kobachajchir/ProyectoRobotica2/AutoFinalRobo2-Atmega/README.md

> **AFR2-20261108-01:** librería [`lib/afr2_usart`](lib/afr2_usart/README.md) (USART0..3 por handle, eventos diferidos) y log de depuración por USART0/D1 a 115200 hacia el USB del Mega (`make AFR2_DEBUG_LOG=0|1|2`, por defecto 1). Registra arranques del AVR y del ESP con causa, el volcado de excepción del ESP, el enlace, la red, la captura OLED, el encoder y la pila mínima. Enlace ESP en USART1 sin cambios. [Ficha](../AutoFinalRobo2-Contracts/changes/2026-11-08-01-usart-library-debug-log.md). Fuente sin compilar ni cargar.

> **AFR2-20261106-04:** SRAM AVR 5614 bytes, libres antes de pila 2578; QR finish 29 bytes. Se conservan ambos buffers OLED. Builds y paridad C/Web 2104/2104 PASS; sin carga ni prueba física. [Evidencia](../AutoFinalRobo2-Contracts/documentation/builds/2026-11-06-04/README.md).

> **AFR2-20261106-02:** regeneración y builds AVR/ESP/Web/Loader comprobados; paridad host OLED 1680/1680. **Carga bloqueada por presupuesto SRAM/pila AVR**; sin COM, flasheo ni prueba física. [Evidencia](../AutoFinalRobo2-Contracts/documentation/builds/2026-11-06-02/README.md).

> **AFR2-20261106-01 / fuente:** correcciones coordinadas EX01v13, IR digital/EEPROMv9 y Wi-Fi persistente/paginado. [Ficha y estado por modulo](../AutoFinalRobo2-Contracts/changes/2026-11-06-01-coordinated-corrections.md). Sin nuevas compilaciones, generadores, pruebas ni cargas; no acredita el firmware instalado.

> **AFR2-20261030-03:** IR1..IR5 ADC10 (0..1023), A4..A0; perfil predeterminado2 y journal6 migrando modos previos en RAM, sin escritura automática. ADC compartido con bateríaA5. [Contrato](../AutoFinalRobo2-Contracts/contracts/EEPROM_IR_ADC_6.md). Fuente sin compilar/probar/cargar; consumidores ESP/Web/OLED ya soportan kind2. Causa física de los ceros no confirmada.

> **AFR2-20261030-02:** cabecera dashboard con SSID e IP STA/AP y scroll independiente de ida/vuelta, recortado entre icono y batería fijos. Solo bandas de texto en redibujo parcial. Fuentes AVR/Web vinculadas, sin compilar ni cargar. Ficha en Contracts/changes/2026-10-30-02-dashboard-network-scroll.md.

> **AFR2-20261030-01:** dashboard010001 adaptado de AutoMicro con iconos Wi-Fi/AP/encoder, batería por bandas de voltaje y accesos corto Menú/largo Rápidas al soltar. AVR y copia raster Web vinculados, sin nuevo wire. Fuente sin compilar, probar ni cargar. Ver ../AutoFinalRobo2-Contracts/changes/2026-10-30-01-dashboard-automicro-icons.md.

> **AFR2-20261029-27 — fuente vigente:** ATmega/ESP0.11.0 y Web0.4.0; carrusel de controles, largo al soltar con retorno contextual, radar4/2/1/0.5m/rastro/editor compartido, IR compactos, PWM manual independiente de odometría/HC y atención prioritaria de sesión WS. EEPROMv5 / EX01v9, preservando batería26. Sin compilar, validadores, flasheos, pruebas físicas ni promoción Web. Recursos OLED copiados solamente; memoria y aceptación pendientes. [Contrato y límites](../AutoFinalRobo2-Contracts/contracts/QUICK_RADAR_ACTUATORS_9.md).

> **AFR2-20261029-26:** batería A5/divisor10k/10k/104, Sistema → Batería y copia Web, puente EX01v9, pill con icono por voltaje y confirmación antes de reiniciar ESP/ATmega desde Web. [Contrato y estados](../AutoFinalRobo2-Contracts/contracts/BATTERY_MEASUREMENT_9.md). Solo fuente: sin compilar, generar catálogo OLED, probar, promover paquete ni cargar. Memoria/calibración/paridad físicas pendientes; ambas placas y Web requieren despliegue conjunto autorizado.

> **AFR2-20261029-19 compilado y ATmega cargado:** pedido humano29/10/2026. ATmega/ESP/Web esp y LittleFS completados; promoción local Web a ESP/data/dist. Carga COM8 final13:32:50,80066bytes escritos/verificados, avrdude exit0. ESP/LittleFS sin cargar. SRAM estática7085bytes; sin prueba física/dinámica. Evidencia en AutoFinalRobo2-Contracts/documentation/builds/2026-10-29-19/README.md. Estados inferiores sin build/carga son históricos.

> **AFR2-20261029-20 compilado SIN cargar:** producto/comunicación/biblioteca Loader exit0 sin errores/advertencias, final29/10/2026 13:00:16. Flash80066bytes; SRAM7085bytes, margen1107bytes, main276 y Ui_Render133bytes según .su individuales; no certifica máximo dinámico de pila/ISR. [Evidencia](../AutoFinalRobo2-Contracts/documentation/builds/2026-10-29-20/README.md). Sin tests/validadores ni ensayo físico, Web fuente vinculada sin build/promoción; placa conserva15 y el pedido de no flashear sigue vigente. Estado pendiente de compilación inferior histórico.

> **Fuente AFR2-20261029-20:** Hall una vuelta con selección de rueda, conteo manual y clic para terminar; largo cancela con aviso. Drafts por4ruedas, estado CPR con asterisco, guardado asíncrono y diálogo genérico Si/No al salir sin guardar. OLED/Web vinculados en fuente; Web sin build/promoción, recursos generados pendientes del build autorizado. [Ficha](../AutoFinalRobo2-Contracts/changes/2026-10-29-20-hall-wizard-save-confirm.md). Compilación AVR pendiente al redactar; no flashear, placa conserva15.

> **AFR2-20261029-18 compilado SIN cargar:** diagnóstico BuildOnly exit0 y producto/comunicación/biblioteca Loader exit0, sin errores/advertencias. Diagnóstico flash13800/SRAM3180bytes; producto flash75600/SRAM6934bytes, margen1258bytes sin certificación dinámica de pila. Producto final12:34:40 del29/10/2026. Placa conserva15; no se abrió COM ni se ejecutó ensayo físico. Web solo fuente. Evidencia en Contracts/documentation/builds/2026-10-29-18/README.md; pendientes inferiores históricos. La prohibición de flashear sigue vigente.

> **Fuente AFR2-20261029-18:** IR1..IR5 OSOYOO digital (A4..A0), perfil predeterminado habilitado y EEPROMv4 migra solo tipos antiguos deshabilitados; calibración/seguimiento siguen pendientes. Diagnóstico servo/encoder agrega lectura RAW directa y cambios por OLED/serie, sin EEPROM. Vistas IR/Web distinguen deshabilitado/pendiente/cero válido. [Ficha](../AutoFinalRobo2-Contracts/changes/2026-10-29-18-ir-input-acquisition.md). Compilaciones pendientes al registrar la fuente; no cargar por instrucción vigente. Placa conserva15; Web sin build/promoción.

> **Diagnóstico17 compilado, sin cargar:** usuario confirma puente S1–D13 instalado además de GND/5V/S1 del servo. BuildOnly exit0, sin errores/advertencias, sin COM/avrdude. Flash13424bytes; SRAM3169bytes, margen5023bytes, sin certificación de pila. HEX afr2-i2c-diagnostic.hex SHA256 03cf3a3760f3b6bc5b9b8a7ce128a56388a5bd51b69209a2ea39e895283ca573. Causa del servo inmóvil aún sin medición/prueba física. Producto16 no cargado; placa conserva15. Las notas de compilación/puente pendientes inferiores son históricas.

> **Diagnóstico AFR2-20261029-17:** encoder controla servo D13/OC1C en pasos5grados; PWM inicialmente OFF, C=centrar, S=apagar PWM. OLED y serie muestran orden/contador/botón; I2C cada10s. S1 ModelY necesita puente adicional aD13 según manual. Script agrega -BuildOnly (sin COM/flash). [Ficha](../AutoFinalRobo2-Contracts/changes/2026-10-29-17-diagnostic-encoder-servo.md). Fuente lista, compilación de prueba pedida; no se autoriza carga. Producto16 sigue sin cargar; placa conserva15.

> **AFR2-20261029-16 compilado, NO cargado por indicación del usuario:** producto/comunicación/biblioteca exit0, sin errores/advertencias, final29/10/2026 12:15:28. Flash75518bytes; SRAM6918bytes, margen1274bytes; main259 y renderer73bytes según .su individuales, sin certificación dinámica de pila. COM8 conserva15 (cargada12:02:57). [Evidencia](../AutoFinalRobo2-Contracts/documentation/builds/2026-10-29-16/README.md). El usuario pidió continuar con otros cambios y posponer la carga; no se solicitará flasheo hasta nueva instrucción.

> **Fuente AFR2-20261029-16:** OLED sin esperas artificiales entre etapas, radar con grilla punteada, cono visual nominal15grados por PWM aplicado y discos rellenos por eco válido. Copia Web vinculada; sin build Web/promoción ESP. [Ficha](../AutoFinalRobo2-Contracts/changes/2026-10-29-16-oled-latency-radar-cone.md). Build/carga AVR COM8 autorizados, pendientes al registrar esta nota. Se conserva corrección del watchdog y migración Hall de15, ya cargada y verificada enCOM8 a12:02:57.

> **Fuente AFR2-20261029-15:** corregido bucle Bresenham del radar que bloqueaba main y podía disparar watchdog al girar desde HC-SR04; productos trigonométricos AVR en32bits y contraparte Web vinculada. Hall conectado por montaje confirmado, migración local EEPROMv3 preserva calibraciones y habilitación de control. [Ficha](../AutoFinalRobo2-Contracts/changes/2026-10-29-15-radar-watchdog-hall-wiring.md). Build/carga AVR COM8 autorizados, pendientes al registrar esta nota; sin prueba física del cambio.

> **AFR2-20261029-14 compilado y cargado:** 29/10/2026 11:37:12, COM8, Loader1.1.2,74516bytes escritos y verificados, exit0. Producto/comunicación/biblioteca compilados sin errores/advertencias. SRAM estática6889bytes, margen1303bytes; main259bytes según .su individual, sin certificación de máximo dinámico. [Evidencia](../AutoFinalRobo2-Contracts/documentation/builds/2026-10-29-14/README.md). La entrega sin compilar indicada debajo es histórica; sin ensayo físico posterior de UI.

> **Fuente AFR2-20261029-14:** recuperación OLED sin apagar ante error aislado, conserva páginas confirmadas y acota la postergación por trabajo pendiente. Reconfiguración sin0xAE tras fallos persistentes. Sin nueva compilación, tests, validadores, carga ni prueba física; COM8 conserva11. SRAM/pila y causa del negro permanente pendientes. [Investigación y cambios](../AutoFinalRobo2-Contracts/changes/2026-10-29-14-oled-fault-recovery.md).

> **Loader AFR2-20261028-05:** servicio de puente integrado en fuente0.9 del Loader, backup opcional antes de instalarlo y menú de firmware/último backup. [Plan A/B](../AutoFinalRobo2-Contracts/hardware/PLAN_PRUEBA_FLASHER_MEGA.md). Sin nuevo firmware AVR ni compilación/carga por05; las notas de integración pendiente inferiores son históricas.

> **Servicio AFR2-20261028-02:** [puente USB↔USART1↔ESP](service/README.md), fuente C/avr-libc aislada y objetivo `esp-bridge-firmware BRIDGE_BAUD=115200`. RESET libre, D18/D19, baud fijo y restauración posterior del producto. Sin compilar/cargar/probar; no integrado al arranque del auto ni al asistente del Loader. [Investigación](../AutoFinalRobo2-Contracts/hardware/MEGA_ESP_PUENTE_SOFTWARE.md).

> **Build AFR2-20261027-10:** Hall habilitado por pedido humano (AFR2_HALL_CONNECTED=1), nuevo mapa agrupado de07. Producto/comunicación/biblioteca compilados; flash73306/SRAM estática5930bytes del producto. [Evidencia](../AutoFinalRobo2-Contracts/documentation/builds/2026-10-27-10/README.md), [carga por USB](../AutoFinalRobo2-Contracts/hardware/CARGA_USB_COM16.md). Preferencia Hall conectado y calibraciones EEPROM conservadas; sin flasheo ni pruebas físicas. Gates0/Hall deshabilitado inferiores históricos.

> **Fuente AFR2-20261027-07:** Hall agrupados A8-A11=A y A12-A15=B, ambos en orden FR/FL/RR/RL; máscara0x0F, contadores lógicos FL/FR/RL/RR conservados. [Pinout completo/PDF](../AutoFinalRobo2-Contracts/hardware/PINOUT.md). AFR2_HALL_CONNECTED=0; sin compilar, probar ni flashear esta modificación. Los builds inferiores no contienen este mapa.

> **Compilación AFR2-20261025-14 autorizada y completada:** firmware ATmega (producto/comunicación/biblioteca), ESP y Web full compilan sin errores ni advertencias finales. Firmware0.10.0/EX01v8, Web0.3.0. [Evidencia](../AutoFinalRobo2-Contracts/documentation/builds/2026-10-25-14/README.md). Sin tests, navegador ni flasheos; paquete Web local full generado, **ESP/data/dist conserva el paquete anterior**. La SRAM estática no certifica pila/ISR ni hardware. Estados previos inferiores históricos.

> **Sensores EX01v8 AFR2-20261025-14:** [radar autónomo, servo/IR, pantallas hermanas y red](../AutoFinalRobo2-Contracts/contracts/SENSORS_RADAR_8.md). Firmware nominal0.10.0/EX01v8 y Web0.3.0: fuente integrada y recursos OLED copiados, **sin compilar, probar, renderizar ni flashear**. Paquete ESP anterior; estados inferiores históricos. Modelo3D conserva pose; otras escenas siguen PWM aplicado.

> **Vigente AFR2-20261025-01:** [control Web directo](../AutoFinalRobo2-Contracts/contracts/DIRECT_CONTROL_7.md), sin permiso previo ni habilitación desde OLED. Firmware0.9.0/EX01v7 y Web0.2.0,30comandos/59ScreenCodes, compilados juntos. STOP/caducidad/watchdog y requisitos físicos conservados; sin flash/tests/placas. Estados inferiores históricos.

> **Vigente AFR2-20261024-15:** [Matriz del maestro](../AutoFinalRobo2-Contracts/docs/ALINEACION_MAESTRO.md):33comandos y59identidades OLED con fuentes complementarias. Calibración Web adquiere control al escribir; ESP/Web informan FS/paquete. Web/ESP compilados15; AVR sin nueva fuente, build12/EX01v6/firmware0.8.0/gates0. Sin brecha software definida identificada tras lectura; aceptación física, memoria dinámica, flash/SPI y planos CAD pendientes. Solo documentación en CAD, sin diseño nuevo. Estados inferiores históricos.

> **Vigente AFR2-20261024-12:** mapa/comando actual juntos y coordenadas laterales; Hardware/Reinicio anidados, editor de pistas reversible y distancia por rueda EX01v6. Firmware0.8.0 y Web compilados; activos promovidos localmente. Build AVR incluye fuente IRQ11 con gates0; sin navegador, Hall habilitado, hardware, flasheo ni CAD. [Ficha12](../AutoFinalRobo2-Contracts/changes/2026-10-24-12-control-hardware-distance.md). Los estados inferiores son históricos.

> **Fuente vigente AFR2-20261024-11:** encoder CLK/DT en D2/D3 por INT4/INT5, SW D42; cola y acciones en main. Hall PCINT2 A8–A15 con preferencia de captura por software, macro0. **Esta adaptación no está compilada ni probada**; build08 corresponde a la fuente anterior. ESP/Web conservan su estado10. [Ficha11](../AutoFinalRobo2-Contracts/changes/2026-10-24-11-encoder-hall-interrupts.md). Los estados previos inferiores son históricos.

> **Vigente AFR2-20261024-08:** IP/AP en OLED,11tipos de aviso de red,14iconos F4 en flash y scroll de opción seleccionada. Sistema → Reinicio → Reiniciar ATMEGA/Reiniciar ESP/Volver. ATmega/ESP/Web compilados con EX01v5; sin placas, tests ni flasheos. Clave AP solo en OLED local; STA oculta. [Estado por módulo](../AutoFinalRobo2-Contracts/docs/ESTADO_IMPLEMENTACION.md) · [Contrato v5](../AutoFinalRobo2-Contracts/contracts/EX01_NETWORK_UI_5.md). Estados inferiores históricos.

> **Vigente AFR2-20261024-07:** firmware/communication/library compilados con EX01v4, pantalla de secuencias0x03002c (barra, icono, nombre PROGMEM y tiempo), info de compilación, BT01 y reinicio diferido por watchdog. Flash53634bytes y SRAM estática4295/8192bytes, sin certificación de pila. Memoria de secuencias y Hall mantienen macro0. [Estado ATmega](../AutoFinalRobo2-Contracts/docs/ESTADO_IMPLEMENTACION.md#atmega) · [Formato v4](../AutoFinalRobo2-Contracts/contracts/EX01_SYSTEM_SEQUENCE_4.md). Sin prueba física ni flasheo. Estados inferiores históricos.

> Estado vigente **AFR2-20261024-02**, 24/10/2026: integración ROBO2/perfil2 + EX01v3 compilada en Atmega/ESP/Web; GOTO completo, configuración por catálogo compartido y jobs Wi-Fi OLED conectados. Paquete Web actualizado en ESP/data/dist. Sin pruebas de navegador/hardware ni flasheo; secuencias físicas mantienen bloqueo de memoria. Ver [matriz vigente](../AutoFinalRobo2-Contracts/contracts/EX01_ALIGNMENT_3.md) y [evidencia](../AutoFinalRobo2-Contracts/changes/2026-10-24-02-project-alignment.md). Los estados previos que siguen son históricos.

> **AFR2-20261028-19:** servicio de diagnóstico I2C D20/D21 por USART0 D0/D1
> a115200 8N1. Fuente preparada, sin compilar/cargar/probar; dirección del
> producto conservada. [Guía](../AutoFinalRobo2-Contracts/hardware/OLED_I2C_DIAGNOSTICO.md).

> **AFR2-20261028-20:** diagnóstico19 ampliado con encoder D2/D3 y pulsador
> D42 por USART0: sentidos opuestos, corto/largo y captura. Solo fuente, sin
> compilar/cargar/probar. [Ficha](../AutoFinalRobo2-Contracts/changes/2026-10-28-20-encoder-uart0-diagnostic.md).

# AutoFinalRobo2-atmega

> **AFR2-20261029-11 compilado y cargado:** producto en COM8,74200bytes de
> flash verificados, exit0, 29/10/2026. SRAM estática6885bytes, margen1307bytes;
> pila máxima/UI física integrada pendientes. [Evidencia](../AutoFinalRobo2-Contracts/documentation/builds/2026-10-29-11/README.md).

> **Fuente AFR2-20261029-11:** OLED diferencial exacto, tramos de hasta16columnas
> y envío cooperativo de baja prioridad; sin refresco completo periódico.
> Sin nueva compilación/carga: HEX10 anterior. Imagen confirmada aumenta SRAM;
> memoria/pila pendientes. [Detalle](../AutoFinalRobo2-Contracts/changes/2026-10-29-11-oled-delta-cooperative.md).

> **Build producto10 autorizado, 29/10/2026:** `make -B firmware` exit0 sin
> errores/advertencias; nuevo `build/afr2.hex`, flash73484/SRAM estática5931bytes.
> Sin COM/flasheo/tests ni prueba física integrada. [Evidencia](../AutoFinalRobo2-Contracts/changes/2026-10-29-10-product-oled-encoder-verified-setup.md).

> **Producto AFR2-20261029-10:** aplica configuración del diagnóstico09 que
> el usuario confirmó funcional: pulls I2C, espera500ms, OLED180, encoder
> invertido y refresco1s. Migra solo UI EEPROMv1→v2 conservando calibraciones.
> Fuente sin compilar/cargar/probar en producto. [Ficha](../AutoFinalRobo2-Contracts/changes/2026-10-29-10-product-oled-encoder-verified-setup.md).

> **Diagnóstico AFR2-20261029-07:** OLED0x3C activo con barras móviles y
> encoder, pulls como Wire en el servicio separado. Solo fuente, sin compilar
> ni cargar. [Ficha](../AutoFinalRobo2-Contracts/changes/2026-10-29-07-diagnostic-active-oled.md).

Estado de producto **AFR2-20261023-19**, continuación24/10/2026: fuente integrada,
sin compilar ni ejecutar. [Guía vigente](docs/PRODUCTO_ATMEGA.md),
[matriz del maestro](../AutoFinalRobo2-Contracts/docs/PLAN_ATMEGA.md) y
[contrato EX01](../AutoFinalRobo2-Contracts/contracts/ROBO2_PRODUCT_EXTENSION.md).
44 nodos/UI, Sistema, Wi-Fi/teclado/avisos, potencia/sensores, Hall/PID/odometría/
línea/GOTO condicionados, EEPROM y watchdog. Hall sin conectar, macro0 y CPR0.
STOP apaga salidas; no mide rueda detenida. Fuente escrita no acredita SRAM,
compilación ni funcionamiento físico. El texto previo queda como historia.

Estado vigente AFR2-20261023-15: ROBO2/perfil 2 y composición AVR UI/TWI escritos, sin compilar/probar. Sustituye menciones anteriores a UNER/perfil 1 y backend TWI pendiente. Ver actualización al final.

Leer [informe de adaptación](INFORME_ADAPTACION.md) y [maestro](../INFORME_MAESTRO.md).

Se copió todo Core propio F4 como referencia autocontenida de librerías y composición; HAL/CMSIS/USB middleware y build STM32 no se migran. MPU, balance, AT y botón menú permanecen solo para localizar acoplamientos históricos. La base src/ contiene una adaptación parcial nueva, no el firmware del vehículo.

Código nuevo: services/afr2_i2c_manager.c, display/afr2_oled.c y font7x10.c, input/afr2_encoder_ui.c y ui/afr2_screens.c. API pública en include/. El Manager está reducido a un OLED, con start/poll/abort y callbacks en main. Wrappers usan snapshots. Fuente 7x10 con PROGMEM. Encoder largo/corto excluyentes y Volver por ítem. AFR2-20261023-11 agrega endpoint ESP, USART1 por IRQ y composición opcional de comunicaciones con reloj de 1 ms. AFR2-20261023-15 agrega backend TWI y composición local UART/OLED/encoder; faltan composición completa de producto, sensores/motores/odometría/GOTO.

Makefile conserva ayuda por defecto y library; firmware integra UART/TWI/OLED/encoder y communication-firmware mantiene opción UART sola, ambas con potencia inactiva. No se ejecutó make ni se generó ELF/HEX/mapa, y no hay upload. [Composición](docs/COMPOSICION.md).

[Contrato compartido](../AutoFinalRobo2-Contracts/README.md). No se han ejecutado compilaciones, tests, validaciones ni flasheos.

Organización AFR2-20261023-04: este módulo pertenece al único Git de D:/ProyectoRobotica2. [CAD/KiCad, pieza nueva y auto completo](../AutoFinalRobo2-CAD/README.md) · [Git e historial](../AutoFinalRobo2-Contracts/docs/ESTRUCTURA_Y_GIT.md). No se modificó código de este módulo al reorganizar el proyecto.

## Comunicación con ESP — AFR2-20261023-11

[Guía de integración](docs/COMUNICACION_ESP.md) y [perfil UART compartido](../AutoFinalRobo2-Contracts/contracts/UART_PROFILE_1.md). Fuente nueva sin compilar ni probar. El endpoint informa unknown/invalid antes de integrar productores y no confirma STOP sin callback autoritativo; la composición opcional anuncia solo UART. No habilita motores ni lease al conectar una Web. El renderer OLED/UI se conserva; su composición física se integra en AFR2-20261023-15. [Registro y procedencia](../AutoFinalRobo2-Contracts/changes/2026-10-23-11-esp-server-and-mega-link.md).

## Integración ROBO2 y UI — AFR2-20261023-15

Estado vigente: `src/main.c` integra USART1, Timer0 1 ms, backend TWI por IRQ,
I2C Manager, OLED y encoder físico. C/avr-libc sin Arduino ni DMA. Cuatro vistas
locales existentes, sin alterar renderers. Sensores inválidos mientras no haya
productores; STOP autoritativo, motores, lease, Hall y GOTO pendientes.

Framing **ROBO2**, dos tokens, versión 1/perfil 2, ruta con emisor alto y receptor
bajo. Comparte parser y constantes con ESP. No compatible con UNER/perfil 1.
[Composición](docs/COMPOSICION.md), [enlace Mega](docs/COMUNICACION_ESP.md) y
[contrato vigente](../AutoFinalRobo2-Contracts/contracts/UART_PROFILE_2.md).
`make firmware` queda preparado, sin ejecutar; no se produjo ELF/HEX/mapa.
OLED 0x3C/SSD1306, tensión, pull-ups, pasos/sentido del encoder y tiempos son
candidatos sin comprobar en hardware. No se ejecutaron tests, compilaciones,
validadores, flasheos ni pruebas físicas. No se habilita movimiento.

## Integración vigente — AFR2-20261024-01

Revisadas fichas19/20/21. La Web21 ya contiene los cambios visuales/editor/simulador;
Wi-Fi20 se conserva. La integración de firmware pendiente se adapta en fuente:
ROBO2/perfil2 + EX01 v2, estado/pose, control supervisado, framebuffer OLED y
secuencias0x40..0x45 sin colisión con comandos de producto19.
Sin nuevo build, validador, tests, flasheo o promoción LittleFS. Secuencias físicas
permanecen bloqueadas por defecto hasta aprobar SRAM/pila y calibración real.
Contrato en AutoFinalRobo2-Contracts/contracts/EX01_WEB_INTEGRATION.md y ficha
AutoFinalRobo2-Contracts/changes/2026-10-24-01-firmware-web-integration.md.

## AFR2-20261029-19 — OLED táctil y visor bajo demanda

Fuente adaptada con Web/ATmega/ESP: overlay scrim+blur en modales, Volver por ítem del menú, ScreenCode0x030035 con aviso/bitmap/chevrones y suscripción explícita a capturas/metadatos. Contrato en AutoFinalRobo2-Contracts/contracts/TOUCH_OLED_19.md; procedencia por archivo en provenance/touch-oled-20261029-19.json de Contracts. El rumbo es solicitado, no medido, y no agrega giro físico. Sin tests, compilación, validadores, navegador, ejecución del generador OLED, promoción ESP ni flasheo de esta entrega. Memoria/paridad/latencia físicas pendientes.
