kobachajchir/ProyectoRobotica2/CADS/README.md

# Insumos CAD trasladados

Los nueve archivos de mecanum-robot-car-chassis-motors-and-wheels están ahora en [AutoFinalRobo2-CAD/reference/supplied/mecanum-robot-car-chassis-motors-and-wheels](../AutoFinalRobo2-CAD/reference/supplied/mecanum-robot-car-chassis-motors-and-wheels).

Se conservó su contenido, sin adaptación. [Inventario por archivo](../AutoFinalRobo2-CAD/reference/insumos-locales.json). El diseño nuevo de piezas, el modelo completo del auto y KiCad se trabajan en [AutoFinalRobo2-CAD](../AutoFinalRobo2-CAD/README.md), dentro del único Git de D:/ProyectoRobotica2.

Esta carpeta queda como puntero a la ubicación nueva. No duplicar aquí las fuentes CAD.
