kobachajchir/ProyectoRobotica2/AutoFinalRobo2-CAD/reference/README.md

# Referencias CAD

supplied/mecanum-robot-car-chassis-motors-and-wheels conserva los nueve archivos existentes que estaban en D:/ProyectoRobotica2/CADS: un FCStd y ocho STEP. Se trasladaron sin cambios de contenido para reunir el trabajo CAD en este módulo.

[Inventario](insumos-locales.json): ruta anterior y actual, tamaño, SHA-256 y estado por archivo. Procedencia inmediata: archivos locales aportados/existentes; autor, licencia, versión y URL remotos no identificados. Sus nombres no demuestran medidas o compatibilidad con el vehículo.

No modificar estos originales al crear adaptaciones; colocar fuentes derivadas en mecanica/ y registrar su procedencia. No se ha abierto el ensamblaje ni deducido dimensiones desde los STEP. Consultar [dependencias](DEPENDENCIAS.md) para futuras descargas reproducibles.

Los documentos originales siguen en ../../Documentacion y la evidencia de hardware en ../../AutoFinalRobo2-Contracts/hardware.
