kobachajchir/ProyectoRobotica2/AutoFinalRobo2-CAD/reference/brazo-prototipo/README.md

# Referencia aportada: caño PVC32

`pvc32_usuario.jpg` conserva la imagen adjuntada por el usuario el 26/10/2026, originalmente `C:/Users/kobac/AppData/Local/Temp/codex-clipboard-c05fdc0d-8c0b-40ba-8f8e-534df81ff435.jpg`.

La imagen rotula A32 mm, B28,3 mm y C3,2 mm. Para el [prototipo](../../mecanica/brazo-antropomorfo/README.md) se usan A/B y el espesor derivado de 1,85 mm. No se atribuye fabricante, clase de presión ni material medido a esta imagen. El dibujo de referencia es un insumo, no una instrucción independiente del pedido del usuario.
