kobachajchir/ProyectoRobotica2/INFORME_MAESTRO.md

> **AFR2-20261109-11 / 1.12.0:** [Armado: Play/Pausa de20s, títulos y secciones](AutoFinalRobo2-Contracts/changes/2026-11-09-11-assembly-playback-intro.md). Web fuente; ATmega/ESP solo versión. Sin tests, compilación, validaciones o flasheos.

> **AFR2-20261109-10 / 1.11.0:** [Nuestros agregados en Armado](AutoFinalRobo2-Contracts/changes/2026-11-09-10-assembly-additions-battery-circuit.md): nueva etapa7, modelos reutilizados del auto, divisor de batería y cables compactos desde Blender (GLB11.692 B / gzip7.969 B), zoom desde mitad de etapa12. CAD/Web en fuente; ATmega/ESP solo versión. Sin tests, compilaciones, validadores, renders ni flasheos.

> **AFR2-20261109-09 / 1.10.5:** [Optimización de RAM ESP](AutoFinalRobo2-Contracts/changes/2026-11-09-09-esp-memory-optimization.md): latidos/estados livianos, cola compacta, textos en flash, liberación Wi-Fi y descargas grandes serializadas. ESP compilado: **51172→46644 B RAM estática (−4528 B)**; Web tipos/protocolo comprobados; ATmega solo versión. Sin carga ni medición dinámica en placa.

> **AFR2-20261109-08 / 1.10.4:** [OOM al conectar WS](AutoFinalRobo2-Contracts/changes/2026-11-09-08-esp-ws-oom.md): ESP serializa directamente a buffers compartidos, evita acumulación de estados y protege por heap/bloque libre. Memoria visible en diagnóstico HTTP. Fuente corregida; ATmega/Web solo versión en esta ficha. Sin tests, compilaciones, validaciones ni cargas; reserva exacta del fallo sin identificar por pila recortada.

> **AFR2-20261109-07 / 1.10.3:** [Banner de producto para Armado](AutoFinalRobo2-Contracts/changes/2026-11-09-07-cinematic-assembly-banner.md): escena transparente sin suelo/cuadrícula, reflejos y fade de piezas por scroll. Fuente Web; ATmega/ESP solo versión. Sin tests, compilaciones, validadores, navegador, renders ni cargas.

> **AFR2-20261109-06 / 1.10.2:** [Wi-Fi: retorno fijo por padre en submenús sin loops por avisos, STA sin AP fallback, teclado directo en clave con autoconexión e ingreso en Web](AutoFinalRobo2-Contracts/changes/2026-11-09-06-wifi-navegacion-fija-sta-sin-fallback-y-credenciales-directas.md). Fuentes ATmega/ESP/Web sincronizadas; sin compilar ni cargar en este paso.

> **AFR2-20261109-05 / 1.10.1:** [Tarjeta de estados del dashboard](AutoFinalRobo2-Contracts/changes/2026-11-09-05-dashboard-status-card-spacing.md) ampliada hacia la izquierda y abajo:72×22px, icono18px y texto centrados. Fuente ATmega/Web; ESP solo versión. Sin tests, compilaciones, validadores, generadores ni cargas.

> **AFR2-20261109-04 / 1.10.0:** [Armado del robot en Explorar](AutoFinalRobo2-Contracts/changes/2026-11-09-04-scroll-robot-assembly.md), `#/armado`: ensamblaje reversible por scroll del auto y brazo V17, textos por etapas, cámara y agarre ilustrativo del cubo. Fuente Web implementada; sin tests, compilaciones, validadores, navegador ni promoción ESP. atmega/esp solo versión; CAD/Loader sin cambios.

> **AFR2-20261108-01:** librería `afr2_usart` y log de depuración del ATmega por USART0 (USB del Mega, 115200): reinicios del ESP con causa y volcado de excepción, enlace, red, captura OLED y pila. [Ficha](AutoFinalRobo2-Contracts/changes/2026-11-08-01-usart-library-debug-log.md). Solo fuente ATmega; sin compilar, cargar ni probar.

> **AFR2-20261106-04:** SRAM AVR 5614 bytes, libres antes de pila 2578; QR finish 29 bytes. Se conservan ambos buffers OLED. Builds y paridad C/Web 2104/2104 PASS; sin carga ni prueba física. [Evidencia](AutoFinalRobo2-Contracts/documentation/builds/2026-11-06-04/README.md).

> **AFR2-20261106-02:** regeneración y builds AVR/ESP/Web/Loader comprobados; paridad host OLED 1680/1680. **Carga bloqueada por presupuesto SRAM/pila AVR**; sin COM, flasheo ni prueba física. [Evidencia](AutoFinalRobo2-Contracts/documentation/builds/2026-11-06-02/README.md).

> **AFR2-20261106-01:** [correccion coordinada en fuente](AutoFinalRobo2-Contracts/changes/2026-11-06-01-coordinated-corrections.md), EX01v13/EEPROMv9/Wi-Fi v2. ATmega/ESP/Web modificados; Loader visual previo conservado y CAD sin cambios. Sin compilar, generar, probar ni cargar esta entrega.

> **AFR2-20261102-14:** dashboard OLED con modo y tarjeta de estados reales, espera3s/ciclo4s, pausa al mantener encoder y fallo prioritario; familia de pantallas vinculada AVR/Web. [Contrato](AutoFinalRobo2-Contracts/contracts/OLED_DASHBOARD_STATUS_20261102.md). Solo fuente, sin tests, build, validaciones, navegador ni carga.

> **AFR2-20261102-11:** dashboard OLED original, cabecera invertida, visor blanco y flecha grande + Volver en submenús. [Ficha](AutoFinalRobo2-Contracts/changes/2026-11-02-11-oled-original-dashboard-white-back.md). Fuente AVR/Web; sin tests, compilaciones, validaciones, navegador ni cargas.

> **AFR2-20261102-05:** UI OLED128-5 en fuentes ATmega/Web y simulación en Ayuda; QR 030045/030046 del AP/Web con estado vigente del ESP. [Alcance y presupuesto](AutoFinalRobo2-Contracts/contracts/OLED_RUNTIME_QR_20261102.md). Fuente y recursos copiados; sin tests, build, validación, navegador ni carga al equipo.

> **AFR2-20261029-03, entrega 3D:** [brazo V7 con codo remoto v17](AutoFinalRobo2-CAD/mecanica/brazo-antropomorfo/revision_v17/README.md). Montajes J1/J4/J5 integrados, PVC25/20, ejes70/60, tensor y pinzaV7 conservados. Ensambles nativos y limites registrados; eje auxiliar J3 sin tope adicional al codo. Por pedido del usuario, nuevos calculos, comprobaciones globales y aligerado diferidos. No aprobacion de resistencia ni fabricacion. atmega/esp/web/Loader sin cambios.

> **AFR2-20261029-02, banco mecanico v15:** [eslabones de aluminio, pinza y transmisiones](AutoFinalRobo2-CAD/mecanica/brazo-antropomorfo/revision_v15/README.md). Fusion independiente del maestro v09; masas desde geometria y revision CAD local muestreada de pinza. J2 modulo0.8 requiere otra iteracion para PLA. Sin brazo completo integrado ni capacidad fisica aprobada; 1.17kg de01 no es peso final actualizado.

> **AFR2-20261029-01, brazo compacto:** [masa, actuadores y eslabones menores](AutoFinalRobo2-CAD/mecanica/brazo-antropomorfo/busqueda_actuadores_v14/README.md). Presupuesto55/50mm:1.17kg sin carga con reserva25%, alcance215mm; margen externo2.65. Solo ruedas, sin pies ni voladizo; estabilidad condicionada a contactos hipoteticos, resistencia y CAD nuevos pendientes. Fusion v09 conservado. Sustituye la direccion con pies de09.

> **AFR2-20261028-09, objetivo activo:** [prediseno liviano con aluminio y PVC menor](AutoFinalRobo2-CAD/mecanica/brazo-antropomorfo/busqueda_actuadores_v13/README.md). Candidato90/75mm:1.63kg sin carga incluyendo pies propuestos, alcance373mm; margen preliminar de par2.36 con200g/30grados/s/50ms. Falla vuelco sobre ejes inferidos; requiere estudiar apoyos desplegables. Sin nuevo CAD ni aprobacion fisica; v09 conservada.

> **AFR2-20261028-08, antecedente:** [30grados/s, inercia y apoyo dinamico](AutoFinalRobo2-CAD/mecanica/brazo-antropomorfo/busqueda_actuadores_v12/README.md). STS3250 no alcanza x2 con este presupuesto; RS01+STS pasa solo el filtro de par pero pesa5.45-5.82kg y aumenta exigencias de cuna/apoyo. Masa y contactos reales del auto pendientes; sin nuevo CAD ni aprobacion fisica.

> **AFR2-20261030-19:** por aclaración del usuario, táctil espera carga/preparación y vista del modelo3D; después usa las condiciones de motores de Mecanum. [Ficha](AutoFinalRobo2-Contracts/changes/2026-10-30-19-touch-model-ready.md). Fuente Web, sin build/pruebas/cargas; conserva reintento tras error.

> **AFR2-20261030-18:** revisadas condiciones de motores; fuentes Web corrigen bloqueo adicional del táctil por error persistente y modelo3D, con mismo permiso PWM que Mecanum. [Detalle](AutoFinalRobo2-Contracts/changes/2026-10-30-18-manual-touch-permissions.md). Firmware sin cambios; sin build/pruebas/cargas.

> **Movimiento AFR2-20261030-13:** avance/retroceso y yaw corregidos en fuente AVR/Web; efectos en diagonales, curvas, línea, GOTO, odometría y secuencias, con controles Girar CW/CCW. [Ficha](AutoFinalRobo2-Contracts/changes/2026-10-30-13-motion-reference.md). ESP/EEPROM/wire sin cambios; sin generación, compilación, validadores, pruebas ni cargas.

> **Wi-Fi AFR2-20261030-09:** fuentes AVR/ESP/Web coordinadas EX01v11; Estado de red, búsqueda/credenciales, seguridad y desconexión observada. [Ficha y límites](AutoFinalRobo2-Contracts/changes/2026-10-30-09-wifi-state-flows.md). Sin generación, compilación, validadores, pruebas, promoción ni cargas.

> **AFR2-20261028-08, objetivo de actuadores activo:** [30grados/s, inercia y apoyo dinamico](AutoFinalRobo2-CAD/mecanica/brazo-antropomorfo/busqueda_actuadores_v12/README.md). STS3250 no alcanza x2 con este presupuesto; RS01+STS pasa solo el filtro de par pero pesa5.45-5.82kg y aumenta exigencias de cuna/apoyo. Masa y contactos reales del auto pendientes; sin nuevo CAD ni aprobacion fisica.

> **AFR2-20261028-07, busqueda de actuadores activa:** [par, masa y esfuerzos del brazo](AutoFinalRobo2-CAD/mecanica/brazo-antropomorfo/busqueda_actuadores_v11/README.md). DS51150 pasa el filtro a30grados/s pero falla desde velocidad de catalogo. STS3215 con reducciones pasa un filtro nominal condicionado (minimo2.11;3919g), con variante, reductores, PLA y estabilidad pendientes. Sin nuevo CAD ni aprobacion fisica.

> **Vigente Loader AFR2-20261028-05 / 0.9.0:** backup de flash opcional antes del flasher, aviso suprimible y preferencias locales; botón de firmware ATmega con desplegable de último backup leído. [Ficha](AutoFinalRobo2-Contracts/changes/2026-10-28-05-loader-mega-backups.md) · [Plan A/B](AutoFinalRobo2-Contracts/hardware/PLAN_PRUEBA_FLASHER_MEGA.md). Solo fuente/documentación. Sin compilación, ejecución GUI/MCP, tests, validaciones, COM o cargas; atmega/esp/web conservan su estado previo. Sustituye recuperación por copia HEX de03 en Loader.

> **Loader AFR2-20261028-03 / 0.8.0:** cargar/restaurar flasher temporal en Mega y desplegable de método ESP con cableado/checklists. [Plan A/B](AutoFinalRobo2-Contracts/hardware/PLAN_PRUEBA_FLASHER_MEGA.md), [ficha](AutoFinalRobo2-Contracts/changes/2026-10-28-03-loader-mega-flasher.md). Solo fuente/documentación; sin compilar/ejecutar/validar, COM ni flasheos. Firmware producto atmega/esp/web sin cambios por esta ficha.

> **Servicio AFR2-20261028-02:** [puente de software Mega→ESP](AutoFinalRobo2-Contracts/hardware/MEGA_ESP_PUENTE_SOFTWARE.md), RESET libre/D18/D19, 115200 candidato, fuente AVR y build de servicio separados. Sin compilar/cargar/probar; producto ESP/Web sin cambios e integración al Loader pendiente en02, incorporada en fuente03. [Ficha](AutoFinalRobo2-Contracts/changes/2026-10-28-02-mega-esp-software-bridge.md).

> **Loader AFR2-20261027-19 / 0.3.0:** [monitor serie, eventos y diagnóstico](AutoFinalRobo2-Loader/MANUAL.html#monitor), baudios, apertura/cierre, texto y bytes RX, modos ESP y fallos detallados. Cierre previo a carga y consulta MCP de captura. [Ficha](AutoFinalRobo2-Contracts/changes/2026-10-27-19-loader-serial-monitor.md). Solo fuente/documentación; sin compilar/ejecutar/probar, abrir COM ni flashear.

> **Loader AFR2-20261027-16 / 0.2.0:** [servidor MCP y guía Codex](AutoFinalRobo2-Loader/MCP.md), revisión de solicitudes en GUI, historial y refuerzos de interfaz/errores. [Ficha](AutoFinalRobo2-Contracts/changes/2026-10-27-16-loader-mcp-ui.md). Solo fuente/documentación, sin compilación, ejecución, registro global, pruebas MCP/COM ni flasheo.

> **Organización AFR2-20261027-14:** [AutoFinalRobo2-Loader](AutoFinalRobo2-Loader/README.md) integrado como sexto módulo en la raíz. Código, lanzadores y manual propios; único Git global y registros compartidos en Contracts. Solo traslado/documentación; sin compilación, ejecución, tests ni flasheo.

> **Herramienta AFR2-20261027-13:** [AFR2 Loader para Windows](AutoFinalRobo2-Loader/README.md), aplicación de compilación/carga con rutas y perfiles portables, diagnóstico UART y verificación posterior. [Manual](AutoFinalRobo2-Loader/MANUAL.html). Fuente/lanzador entregados, sin compilar, ejecutar, validar ni flashear en esta ficha; firmware/Web/CAD sin intervención.

> **Build/carga AFR2-20261027-10:** [ATmega/ESP/Web compilados y LittleFS creado](AutoFinalRobo2-Contracts/documentation/builds/2026-10-27-10/README.md). Hall activo en build por pedido humano, mapa07, hall_wired/EEPROM conservados. Web esp promovida,8activos/1571104bytes gzip; littlefs.bin3121152bytes. [Guía USB-B/COM16](AutoFinalRobo2-Contracts/hardware/CARGA_USB_COM16.md). Sin apertura serie ni flasheo; montaje de jumpers/flash física sin identificar. Estados inferiores históricos.

> **Pinout AFR2-20261027-07:** [hoja completa y PDF](AutoFinalRobo2-Contracts/hardware/PINOUT.md), Hecho por Koba Chajchir. Hall agrupados A8-A11=A y A12-A15=B, orden DEL DER / DEL IZQ / TRAS DER / TRAS IZQ en ambos; fuente ATmega/máscara0x0F actualizadas. Panel OLED/encoder a 5 V reportado; CAD +3V3 sin editar. Hall deshabilitado, sin compilación/flasheo/tests/validaciones de esta revisión. [Ficha](AutoFinalRobo2-Contracts/changes/2026-10-27-07-complete-pinout-grouped-hall.md).

> **Radar Web AFR2-20261026-02:** composición/escena rehechas con manual0.1.9 y VIS-038. [Ficha](AutoFinalRobo2-Contracts/changes/2026-10-26-02-radar-composition.md). Fuente implementada; **sin compilación, tests, validadores, navegador ni promoción ESP**. Firmware/OLED/CAD y Modelo3D sin intervención en esta revisión. Presentación16 sustituida, controles conservados.

> **Modelo3D AFR2-20261026-01:** botón Mostrar/Ocultar referencias, cierre de fichas al ocultar y una única rueda representativa (ocho referencias en total). [Ficha](AutoFinalRobo2-Contracts/changes/2026-10-26-01-model-reference-visibility.md). Solo fuente Web/documentación, sin tests/build/validaciones ni promoción ESP. Sustituye la cantidad de once referencias del hito15.

> **Interfaz Web AFR2-20261025-16:** radar volumétrico con sector de escaneo editable, barras y entradas numéricas vinculadas. [Ficha](AutoFinalRobo2-Contracts/changes/2026-10-25-16-radar-volume-scan-controls.md). Fuente implementada; **sin tests/builds/validadores/navegador/promoción ESP**. Compilación14 anterior a estos cambios; ATmega/ESP/OLED/CAD sin intervención en esta revisión.

> **Fuente Web AFR2-20261025-15:** once puntos interactivos de componentes en Modelo3D, ficha fija local y accesos a las tareas/ruedas. Sin tests, compilación, validaciones, navegador ni promoción ESP; firmware/CAD sin cambios. [Ficha](AutoFinalRobo2-Contracts/changes/2026-10-25-15-model-component-hotspots.md). El build14 inferior no incluye este cambio.

> **Compilación AFR2-20261025-14 autorizada y completada:** firmware ATmega (producto/comunicación/biblioteca), ESP y Web full compilan sin errores ni advertencias finales. Firmware0.10.0/EX01v8, Web0.3.0. [Evidencia](AutoFinalRobo2-Contracts/documentation/builds/2026-10-25-14/README.md). Sin tests, navegador ni flasheos; paquete Web local full generado, **ESP/data/dist conserva el paquete anterior**. La SRAM estática no certifica pila/ISR ni hardware. Estados previos inferiores históricos.

> **Sensores y radar autónomo AFR2-20261025-14:** [radar autónomo, servo/IR, pantallas hermanas y red](AutoFinalRobo2-Contracts/contracts/SENSORS_RADAR_8.md). Firmware nominal0.10.0/EX01v8 y Web0.3.0: fuente integrada y recursos OLED copiados, **sin compilar, probar, renderizar ni flashear**. Paquete ESP anterior; estados inferiores históricos. Modelo3D conserva pose; otras escenas siguen PWM aplicado.

> **Vigente AFR2-20261025-01:** [control directo7](AutoFinalRobo2-Contracts/contracts/DIRECT_CONTROL_7.md), sin permiso ni opciones de adquisición. Los tres módulos compilan con firmware0.9.0/Web0.2.0. Estado anterior inferior histórico.

> **Interfaz AFR2-20261027-05:** ancho util global ampliado; simulaciones en una tarjeta con matematica lateral plegable y controles inferiores. Inputs compactos, modos en pills y Control agrupado en Movimiento / Pruebas y calibracion / GOTO. Funciones fisicas y tactiles conservadas. [Ficha](AutoFinalRobo2-Contracts/changes/2026-10-27-05-wide-workspaces-control-cards.md). Sin tests/build/validaciones/navegador/promocion ESP; modelo final del brazo y burbuja de referencia pendientes.

> **Interfaz AFR2-20261027-06:** calibracion con ayuda contextual derecha e interpretacion del valor; matematica destacada y uniforme en Auto/Brazo/Conjunto; pad de movimiento, boton mantenido y numero/barra compartidos con Control. [Ficha](AutoFinalRobo2-Contracts/changes/2026-10-27-06-calibration-live-math-shared-controls.md). Solo fuente; sin tests/build/validaciones/navegador/promocion ESP. Adaptadores fisico y simulado separados.

# AutoFinalRobo2 — informe maestro vigente

> **Infraestructura AFR2-20261102-04:** nuevo destino Explorar con recorrido visual de React/Vite y Fusion/Blender/Draco hasta gzip, LittleFS, flash, HTTP y navegador; pesos y reporte de archivos con procedencia local/ESP. [Ficha](AutoFinalRobo2-Contracts/changes/2026-11-02-04-infrastructure-explorer.md). atmega sin cambios; esp/web fuente modificada. Sin tests, compilación, validaciones, navegador, promoción de paquete ni flasheos.

> **Fuente AFR2-20261031-01:** [Simulador UI en Desarrollador](AutoFinalRobo2-Contracts/changes/2026-10-31-01-developer-ui-simulator.md).
> Navegacion OLED adaptada del ATmega, tres controles compartidos del visor en
> vivo, guia contextual, edicion/teclado y ejemplos de servicios locales.
> Datos ficticios identificados; sin envio al equipo. Solo fuente Web y
> documentos, sin tests, compilacion, validaciones ni promocion ESP.

> **Brazo AFR2-20261028-01:** [J1 y sus uniones: comprobación resistente](AutoFinalRobo2-CAD/mecanica/brazo-antropomorfo/analisis_J1_uniones/README.md). 35 secciones y 7.075 estados, equilibrio de apoyos, eje, acople D, bastidor y anclajes. J1 no queda aprobado; material/perfil sin definir. Propuesta de eje Ø10, brida y apoyos 16 mm conservando altura, con estudio parcial de espacio temporal. V08 sin editar; sin FEA de sólidos/contactos, builds, flasheo ni ensayo físico. Atmega/ESP/Web/Loader sin cambios.

> **Brazo AFR2-20261027-21:** [v08 con housing GX3270BLS ventilado](AutoFinalRobo2-CAD/mecanica/brazo-antropomorfo/revision_v08/README.md), reservas de montaje corregidas y maestros editables. Revisión autorizada: 3.141 configuraciones CAD sin penetraciones reportables, seis ejes/doce rodamientos completos, pinza 50/60,01 mm y pan libre. Masa recalculada 2,277 kg con carga de 200 g. J1, apoyos, alimentación y aceptación física permanecen abiertos; sin FEA, compilación ni flasheo. Atmega/ESP/Web/Loader sin cambios.

> **Brazo AFR2-20261027-20:** [v07 implementada con GX3270BLS en J3](AutoFinalRobo2-CAD/mecanica/brazo-antropomorfo/revision_v07/README.md), housing integrado, solapes27 mm y nervios locales sin elevar base. [Cargas actualizadas e interpretación](AutoFinalRobo2-CAD/mecanica/brazo-antropomorfo/analisis_cargas_200g/07_implementacion_y_cargas_v07.md): 2,267 kg con200 g, codo15,83 kgf·cm estáticos, frenadas finitas ilustrativas y resultantes completas de base/primer eslabón. J1, apoyos, alimentación y aceptación bajo carga siguen abiertos. Sin tests, compilaciones, barridos CAD, FEA ni ensayos físicos; Atmega/ESP/Web/Loader sin cambios. Sustituye el estado «v07 en planificación» de18.

> **Brazo AFR2-20261027-18:** [informe integrado de esfuerzos e iteración](AutoFinalRobo2-CAD/mecanica/brazo-antropomorfo/analisis_cargas_200g/INFORME_ITERACION_DISENO.md). Historial v01–v06, resultados estáticos con 200 g y plan v07: selección por eje, frenada finita, cargas combinadas y prioridades base/primer eslabón. Solo documentación; nuevos motores, dinámica, refuerzos, FEA y capacidad física siguen pendientes.

> **Fuente Web AFR2-20261027-11:** [puntos y trayectorias independientes del modelo](AutoFinalRobo2-Contracts/contracts/WEB_ARM_POINTS.md).
> Posicion/orientacion respecto del montaje conservadas al cambiar dimensiones;
> biblioteca local compartida, IK en Worker, vista previa y reproduccion cancelable.
> Perfil nominal v03, sin modificar CAD v04. Esta entrega no ejecuta tests/builds,
> validadores, navegador ni promocion ESP; el paquete de10 no acredita la fuente
> final de11. Envolvente definitiva y laminas del pendiente08 sin ejecutar.

**Modelo final AFR2-20261025-13:** [PCB/soporte del usuario y conjunto Web/ESP](AutoFinalRobo2-CAD/docs/MODELO_FINAL_WEB_20261025.md). KiCad, Fusion y Blender guardados; GLB **871.756 bytes**, idéntico al descomprimido de ESP. Web compilada y siete activos promovidos, paquete 1.505.042 bytes gzip. Comprobación CAD/Draco y render Blender; sin ERC/DRC, firmware nuevo ni flasheo. Sustituye el estado CAD pendiente inferior.

**CAD AFR2-20261025-12:** [Panel OLED/encoder](AutoFinalRobo2-CAD/docs/PANEL_UI_20261025.md): fuentes KiCad 20×35 mm ruteadas en B.Cu, modelos STEP de Fusion y soporte con bisel/torretas M3×15 creados. Sin cambio de firmware/ESP/Web, ERC/DRC, interferencias ni montaje físico; JST comercial, niveles I2C y ranura M3 pendientes. Reemplaza únicamente el estado histórico de PCB/soporte pendientes.

24/10/2026, AFR2-20261024-15. Un único Git en D:/ProyectoRobotica2 con cinco
módulos. Proyecto independiente; D:/AutoProyecto es referencia de solo lectura.

La [matriz del plan maestro](AutoFinalRobo2-Contracts/docs/ALINEACION_MAESTRO.md)
concentra implementación, productores/consumidores y pendientes reales. Se
revisaron los33comandos Web/ESP/AVR y las59identidades OLED. Se completaron
diagnóstico de LittleFS/paquete en Web y adquisición de control en Calibración.
Código presente y compilación no acreditan funcionamiento físico.

| Módulo | Alcance vigente |
| --- | --- |
| [Atmega](AutoFinalRobo2-Atmega/README.md) | C/avr-libc sin Arduino/DMA; servicios de robot y autoridad de salidas. Fuente12/build12, firmware0.8.0; Hall/memoria0 |
| [ESP](AutoFinalRobo2-ESP/README.md) | Arduino ESP8266 propio, sin AT; Wi-Fi/HTTP/WS/LittleFS y broker; diagnóstico ampliado15 |
| [Web](AutoFinalRobo2-Web/README.md) | React/Vite; control, simuladores, sensores/red, OLED, desarrollador y guía; calibración alineada15 |
| [Contracts](AutoFinalRobo2-Contracts/README.md) | Contratos, hardware, evidencias, planes y cambios compartidos |
| [CAD](AutoFinalRobo2-CAD/README.md) | Auto base Fusionv16/Blender y GLB final; PCB/pieza nueva diferidas |

Navegador → JSON afr2-ws-1 /ws del mismo origen → ESP → UART ROBO2/perfil2,
EX01v6 → USART1 Mega D18/D19. ESP UART directo y selector E_RX/E_TX son
conexiones distintas. La programación temporal por puente USB usa D0/D1 según
[FLASHING](AutoFinalRobo2-Contracts/hardware/FLASHING.md), sin trasladar mapa UNO.

OLED único dispositivo I2C por Manager. Encoder UI CLK D2/DT D3 por IRQ, SW D42
según cambio11; largo800ms abre principal, corto confirma, atrás solo Volver.
Hall de ruedas separado, A8–A15, pendiente de montaje/calibración.

No quedan brechas de implementación identificadas en el alcance software
definido tras esta revisión por fuente. **El proyecto global no está cerrado:**
Hall/CPR/signos/geometría, pila/tiempos, flash/SPI y puesta en marcha requieren
datos/pruebas; no se habilitan macros por compilar. PCB/soporte/cubierta esperan
planos y componentes. J1 cinco señales y J2 VCC/GND común,2,54mm, conservados.

[Roadmap](AutoFinalRobo2-Contracts/docs/ROADMAP.md),
[cambio15](AutoFinalRobo2-Contracts/changes/2026-10-24-15-master-alignment.md),
[evidencia15](AutoFinalRobo2-Contracts/documentation/builds/2026-10-24-15/README.md).
Pruebas, validadores independientes, navegador, flasheo y CAD no se ejecutan
por esta revisión. [Informe anterior conservado](AutoFinalRobo2-Contracts/docs/history/alignment15/INFORME_MAESTRO.md).
