kobachajchir/ProyectoRobotica2/AutoFinalRobo2-Contracts/hardware/INFORME_PINOUT_ROBOT_20261107.html

# Pinout AutoFinalRobo2

OSOYOO Mecanum 4WD con Arduino Mega 2560 y shield Wi-Fi ESP-12S. Conexiones del kit, agregados del proyecto (sensor de batería, AutoKEY y AutoRESET) y conexiones de servicio, cotejados con board_pinmap.h y las fuentes vigentes.

07/11/2026AFR2-20261107-44Actualiza AFR2-20261106-15Lado y sentido: mirando el auto desde atrás, en el sentido de avance

Base · kit OSOYOO Agregado propio Servicio · carga y diagnóstico

## Cabeceras del Mega

Tocá o pasá sobre un pin para ver su función

Pines en gris: sin uso identificado en este mapa. Eso no certifica que estén libres bajo el shield.

## Sensor de batería

Agregado propio · A5

### Divisor 10 k / 10 k con filtro

A5 recibe la mitad de la tensión de batería. El capacitor va del nodo A5 a masa, en paralelo con R2, nunca en serie. La batería no se conecta directo a A5.

### Lecturas esperadas

Batería | En A5 | Raw ADC
6,0 V | 3,00 V | 614
7,4 V | 3,70 V | 758
8,0 V | 4,00 V | 819
8,4 V | 4,20 V | 860
≈ 10 V | 5,00 V | 1023 · fuera de rango

Firmware: mV = (raw × 10000 + 512) / 1024, referencia AVCC nominal de 5 V y promedio de 8 muestras. La medición se activa a pedido y no está calibrada. Consumo del divisor: unos 0,4 mA a 8 V.

## AutoKEY y AutoRESET del ESP

Agregado propio · servicio · D32 / D33

### Una etapa NPN por línea

El 10 kΩ va de base a masa del lado del transistor: si se sacan los cables de D32/D33 o el Mega no tiene firmware, el transistor queda apagado. El pulsador del shield se conserva y sigue andando a mano.

### Funcionamiento

Función | Pin Mega | Cable | Destino
AutoKEY | D32 · PC5 | sin anotar | Colector a KEY / GPIO0 del ESP
AutoRESET | D33 · PC4 | naranja | Colector a RST del ESP

- D32 o D33 en alto hacen conducir el NPN, como si se apretara el pulsador.
- En reposo el flasher deja ambos pines como entradas sin pull-up. El firmware de producto nunca los acciona.
- Solo se usan en una carga del ESP en modo automático, que el Loader activa por perfil. El modo manual es el predeterminado.
- Abrir el puerto o reiniciar el Mega no reinicia el ESP.

Con el circuito armado, no reutilizar D32 ni D33. Para usarlos en otra cosa, desconectar los dos cables de control.

## Sensores del kit

Base

### Barra de línea IR, 5 canales ACTUALIZADO

← izquierdaderecha →

IR1A4

IR2A3

IR3A2

IR4A1

IR5A0

Salidas digitales TTL del OSOYOO (inversor Schmitt 74HC14): LOW sobre negro, HIGH sobre blanco. Se lee PF4…PF0 cada 5 ms, sin pull-ups. Alimentación de 3,3 a 5 V. Alcance de 0 a 3 cm, que se ajusta con el potenciómetro.

IR1 (A4) queda a la izquierda, confirmado por el usuario. Desde AFR2-20261107-43 la línea es válida sin calibrar, y el seguimiento gira hacia el lado del sensor activo.

### Ultrasonido y servo de radar

Señal | Pin | Uso
HC-SR04 TRIG | D30 · PC7 | Salida
HC-SR04 ECHO | D31 · PC6 | Entrada, medida con Timer3
Servo S | D13 · PB7 | Pulsos de 1000 a 2000 µs por Timer5

D13 está ocupado por el servo: no usarlo como LED. El HC-SR04 se conserva para el radar, pero no detiene el movimiento (AFR2-20261106-13).

## Tracción y encoders Hall

Base

### Motores · dos drivers Model Y

Rueda | IN1 | IN2 | PWM
FR delantera der. | D22 · PA0 | D24 · PA2 | D9 · PH6
FL delantera izq. | D26 · PA4 | D28 · PA6 | D10 · PB4
RR trasera der. | D5 · PE3 | D6 · PH3 | D11 · PB5
RL trasera izq. | D7 · PH4 | D8 · PH5 | D12 · PB6

FR y FL van a M_B (BK1…BK4); RR y RL a M_A (AK1…AK4). M+ y M− son potencia: no van a GPIO ni son masa lógica. El sentido del chasis se corrige en la mezcla (signos de avance, giro y lateral −1), no en el cableado.

### Hall por rueda · puerto K

Rueda | A · S1 naranja | B · S2 verde
FR | A8 · PK0 | A12 · PK4
FL | A9 · PK1 | A13 · PK5
RR | A10 · PK2 | A14 · PK6
RL | A11 · PK3 | A15 · PK7

Pull-ups internos y captura por PCINT2: cuenta x1, flanco de subida de A y sentido leído en B. El CPR se calibra por rueda y se guarda en EEPROM. VCC del Hall a +5 V regulados, nunca directo de la batería.

## Panel OLED y encoder de menú

Agregado propio

### Conector J1 · señales 1×5

Pin J1 | Señal | Mega
1 | Encoder CLK | D2 · PE4 · INT4
2 | Encoder DT | D3 · PE5 · INT5
3 | Encoder SW | D42 · PL7
4 | OLED SDA | D20 · PD1
5 | OLED SCL | D21 · PD0

J2 alimentación 1×2: VCC (5 V comunicados) y GND común. Identificar el pin 1 en la placa antes de cablear.

### Detalles

OLED de 0,96" por I2C, único dispositivo del bus y manejado por I2C Manager. SDA y SCL se toman de la cabecera del shield. El encoder KY-040 sin breakout usa pull-ups internos y lleva los comunes a GND. SW es activo bajo.

Navegación: pulsación corta desde el dashboard abre el menú completo. La larga (desde 800 ms, al soltar) abre los controles rápidos; en el resto de las pantallas vuelve atrás.

El CAD del panel conserva la red +3V3 y el informe anterior menciona un JST de 2,00 mm para J2. Confirmar en la placa real antes de usar el CAD como plano de cableado.

## Wi-Fi y alimentación

Base · enlace adaptado

### UART del shield ESP-12S

Conexión | Pin
Mega transmite → E_RX del selector | D18 · PD3 · TX1
E_TX del selector → Mega recibe | D19 · PD2 · RX1
USB del Mega · servicio y puente de carga del ESP | D0 / D1 · USART0

La carga del ESP usa el puente por software USART0↔USART1 con el RESET del Mega libre. El método D0/D1 con RESET a GND está retirado. La cabecera ESP UART del shield es de lógica 3,3 V y es otra conexión.

### Alimentación

Origen | Destino
Portabaterías + / − | VIN+ / VIN− de Model Y (con llave)
VOUT+ / VOUT− de Model Y | POWER del shield
Voltímetro VCC / VT / GND | Cabecera homónima del Model Y
BAT+ tras la llave | Divisor de batería → A5 propio
+5 V regulados / GND | Hall, IR, HC-SR04, servo y panel

## Índice por pin

A0–A15 y D54–D69 son el mismo pin

Pin | Puerto | Función | Origen

Estado. Cotejo documental y de fuentes. No identifica el firmware instalado ni comprueba continuidad, niveles ni funcionamiento físico. AutoKEY/AutoRESET y el divisor de batería están implementados en fuente, con montaje y medición pendientes. No hay MPU ni balance de dos ruedas en el producto, y no se asignan pines al brazo futuro.

Fuentes:

- AutoFinalRobo2-Atmega/include/board_pinmap.h: motores, Hall, IR, panel, UART y reserva D32/D33.
- src/platform/afr2_sensors.c: IR digitales, ADC5 de batería, HC-SR04 y servo.
- service/esp_uart_bridge.c: control de AutoKEY (PC5) y AutoRESET (PC4).
- Contracts/hardware/INFORME_PINOUT_ROBOT_20261106.md, MEDICION_BATERIA.md, PLAN_KEY_RST_AUTOMATICO.md y contracts/BATTERY_MEASUREMENT_9.md.
- Hoja OSOYOO 5-Channel IR Tracker Sensor: polaridad y alimentación de la barra de línea.

Proyecto de Koba Chajchir. Las atribuciones del manual OSOYOO y de la referencia BioLog se conservan en sus documentos.
