kobachajchir/ProyectoRobotica2/AutoFinalRobo2-CAD/mecanica/brazo-antropomorfo/revision_v17/laminas_20261102/AFR2_Fichas_Brazo_y_Robot_A3.pdf

## AFR2-A000 / BRAZO COMPLETO Y SUS SUBCONJUNTOS

Brazo v17 / captura nativa 02-11-2026 | Cotas de geometria; no de imagen.

SUBCONJUNTOS DEL BRAZO

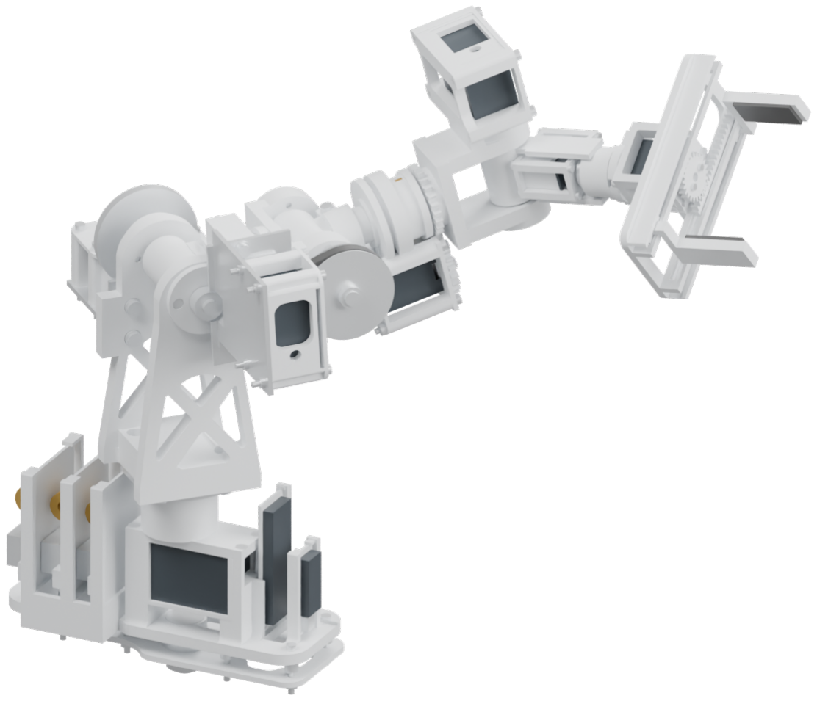
[picture p85: figure]

AFR2-A100

Montura y control fijo

AFR2-A200

Giro J1, torre y entrada J2

AFR2-A300

Eslabon y accionamiento remoto J3

AFR2-A400

Antebrazo y giro de muneca J4

AFR2-A500

Inclinacion J5 y soporte J6

AFR2-A600

Herramienta y pinza V7

VISTA 3D / BRAZO COMPLETO

NOTAS / ALCANCE

Ficha visual del brazo con sus seis subconjuntos funcionales.
Los grupos incluyen todas las425 instancias de solidos de la captura; no son piezas comerciales contadas. Esta ficha no sustituye los planos individuales; solo seis piezas tienen hoja preliminar en esta tanda.
AutoFinalRobo2 - Robotica II | Koba Chajchir

## Brazo completo y sus subconjuntos

AFR2-A000 | REV C | 02/11/2026

MATERIAL / PROCESO

Conjunto mixto

ESTADO: DOCUMENTACION PRELIMINAR

Unidades: mm | Proyeccion: primer diedro

Escala vistas: --

Isometrica: sin escala

Formato A3 | Hoja 1 / 2
AutoFinalRobo2 | Sin firma de aprobacion

## AFR2-R000 / ROBOT INTEGRADO Y CONJUNTOS DEL AUTO

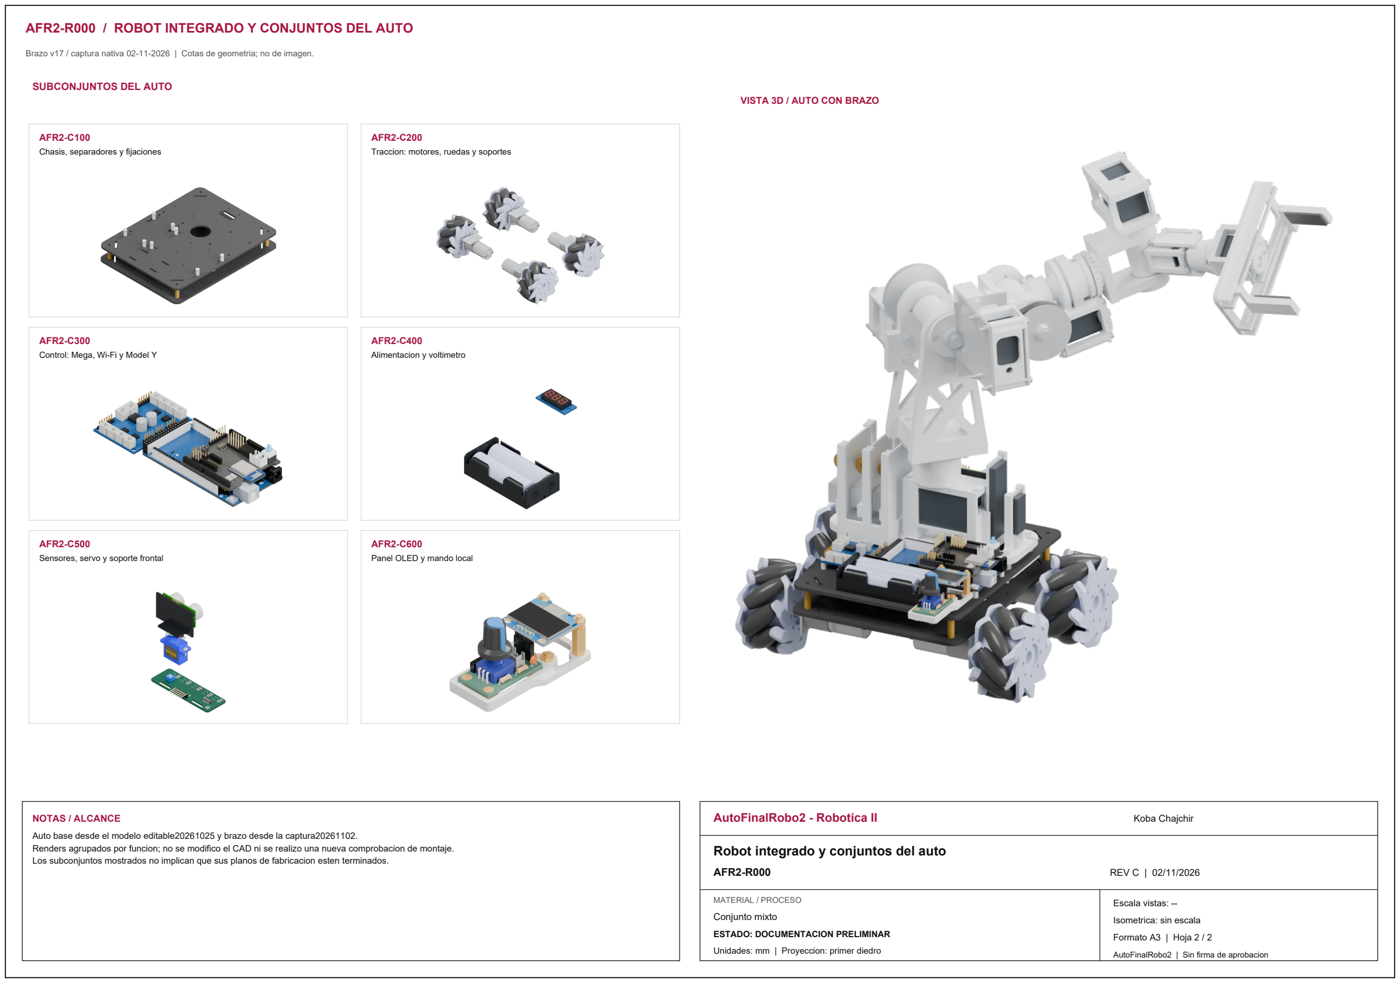
[picture p86: page 2]

Brazo v17 / captura nativa 02-11-2026 | Cotas de geometria; no de imagen.

SUBCONJUNTOS DEL AUTO

AFR2-C100

Chasis, separadores y fijaciones

AFR2-C200

Traccion: motores, ruedas y soportes

AFR2-C300

Control: Mega, Wi-Fi y Model Y

AFR2-C400

Alimentacion y voltimetro

AFR2-C500

Sensores, servo y soporte frontal

AFR2-C600

Panel OLED y mando local

VISTA 3D / AUTO CON BRAZO

NOTAS / ALCANCE

Auto base desde el modelo editable20261025 y brazo desde la captura20261102.
Renders agrupados por funcion; no se modifico el CAD ni se realizo una nueva comprobacion de montaje. Los subconjuntos mostrados no implican que sus planos de fabricacion esten terminados.
AutoFinalRobo2 - Robotica II | Koba Chajchir

## Robot integrado y conjuntos del auto

AFR2-R000 | REV C | 02/11/2026

MATERIAL / PROCESO

Conjunto mixto

ESTADO: DOCUMENTACION PRELIMINAR

Unidades: mm | Proyeccion: primer diedro

Escala vistas: --

Isometrica: sin escala

Formato A3 | Hoja 2 / 2
AutoFinalRobo2 | Sin firma de aprobacion
