kobachajchir/ProyectoRobotica2/Documentacion/Pinout_OSOYOO_Mecanum.csv

Subsistema | Señal origen | Destino | Función | Fuente PDF | Estado
Model Y M_A | ENA | D11 | PWM | p15 | Documentado
Model Y M_A | IN1 | D5 | digital | p15 | Documentado
Model Y M_A | IN2 | D6 | digital | p15 | Documentado
Model Y M_A | IN3 | D7 | digital | p15 | Documentado
Model Y M_A | IN4 | D8 | digital | p15 | Documentado
Model Y M_A | ENB | D12 | PWM | p15 | Documentado
Model Y M_B | ENA | D9 | PWM | p15 | Documentado
Model Y M_B | IN1 | D22 | digital | p15 | Documentado
Model Y M_B | IN2 | D24 | digital | p15 | Documentado
Model Y M_B | IN3 | D26 | digital | p15 | Documentado
Model Y M_B | IN4 | D28 | digital | p15 | Documentado
Model Y M_B | ENB | D10 | PWM | p15 | Documentado
Servo | S | D13 | servo signal | p26 | Documentado
Ultrasonido | TRIG | D30 | digital | p27 | Documentado
Ultrasonido | ECHO | D31 | digital | p27 | Documentado
Sensor IR | IR1 | A4 | signal | p33-34 | Documentado
Sensor IR | IR2 | A3 | signal | p33-34 | Documentado
Sensor IR | IR3 | A2 | signal | p33-34 | Documentado
Sensor IR | IR4 | A1 | signal | p33-34 | Documentado
Sensor IR | IR5 | A0 | signal | p33-34 | Documentado
Bluetooth | B_TX | D19/RX1 | serial input | p38 | Documentado
Bluetooth | B_RX | D18/TX1 | serial output | p38 | Documentado
ESP8266 | E_TX | D19/RX1 | serial input | p43 | Documentado
ESP8266 | E_RX | D18/TX1 | serial output | p43 | Documentado
Motor FR | M+/M- | BK1/BK2 | motor power | p14 | Polaridad individual por verificar
Motor FL | M+/M- | BK3/BK4 | motor power | p14 | Polaridad individual por verificar
Motor RR | M+/M- | AK1/AK2 | motor power | p14 | Polaridad individual por verificar
Motor RL | M+/M- | AK3/AK4 | motor power | p14 | Polaridad individual por verificar
Motor Hall | S1/S2 | Sin conexion en manual | encoder | p5, p14 | Pendiente
Potencia | VIN+/- | Portabaterias 18650 | power | p17 | Polaridad verificar
Potencia | VOUT+/- | WiFi Shield 2p XH2.54 | power | p17 | Tension verificar
