kobachajchir/ProyectoRobotica2/Revision/README.md

# Revisión del informe y documentación del robot

Carpeta común para revisar juntos el informe, los planos y el pinout hasta preparar el informe final.

**Revisión activa: [R01 · 10/11/2026](R01_20261110/README.md).**

| Revisión | Fecha | Estado | Entrega |
|---|---|---|---|
| R01 | 10/11/2026 | En revisión | [Informe D1, planos v17 y pinout](R01_20261110/README.md) |

## Cómo continuar

1. Anotar lo que se quiere corregir en `OBSERVACIONES.md` de la revisión activa, indicando documento, página/hoja y cambio esperado.
2. Al preparar una entrega nueva, crear `R02_AAAAMMDD`, luego `R03_AAAAMMDD`, etc., conservando las anteriores. Cada entrega reúne informe, planos y pinout aunque solo haya cambiado uno.
3. Registrar qué cambió y qué observaciones quedaron resueltas en el historial de la nueva revisión. Actualizar aquí el enlace activo.
4. Mantener el estado «borrador/en revisión» hasta que el usuario indique el cierre del informe final. La numeración del paquete R01/R02 es independiente de la versión del documento y de la versión del software.

Esta carpeta contiene copias de entrega. Los originales y generadores permanecen en Contracts y CAD; `ORIGENES.json` identifica cada archivo de R01. Las regeneraciones se hacen desde las fuentes de sus módulos, no ejecutando metadatos o rutas de captura como scripts dentro del paquete.

No se han modificado contenidos técnicos, rehecho cálculos, renderizado documentos ni ejecutado tests, compilaciones, validaciones o flasheos para esta organización. `Documentacion/` se conserva.
