kobachajchir/ProyectoRobotica2/AutoFinalRobo2-ESP/README.md

> **AFR2-20261029-27 — fuente vigente:** ATmega/ESP0.11.0 y Web0.4.0; carrusel de controles, largo al soltar con retorno contextual, radar4/2/1/0.5m/rastro/editor compartido, IR compactos, PWM manual independiente de odometría/HC y atención prioritaria de sesión WS. EEPROMv5 / EX01v9, preservando batería26. Sin compilar, validadores, flasheos, pruebas físicas ni promoción Web. Recursos OLED copiados solamente; memoria y
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
