kobachajchir/ProyectoRobotica2/AutoFinalRobo2-CAD/mecanica/brazo-antropomorfo/analisis_cargas_200g/pose_horizontal_cad.png

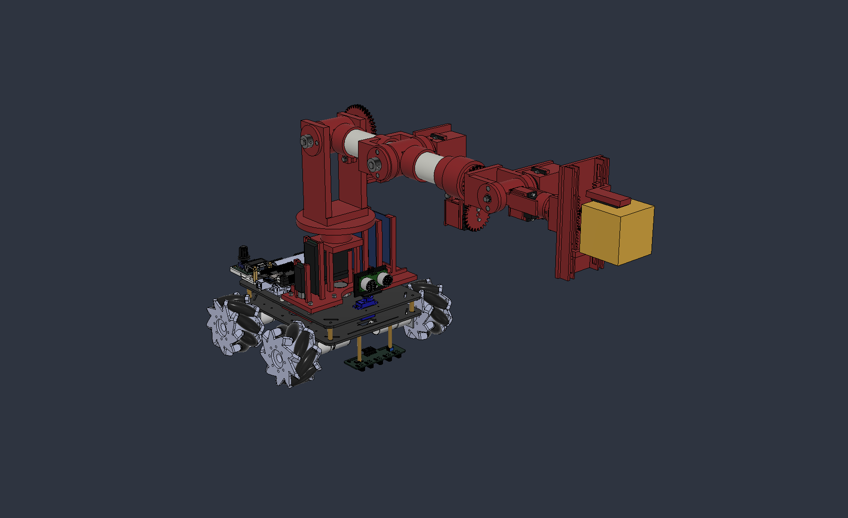
AutoFinalRobo2-CAD/mecanica/brazo-antropomorfo/analisis_cargas_200g/pose_horizontal_cad.png
