kobachajchir/ProyectoRobotica2/AutoFinalRobo2-CAD/mecanica/brazo-antropomorfo/revision_v17/analisis_conjunto_20261101/estabilidad_planta.png

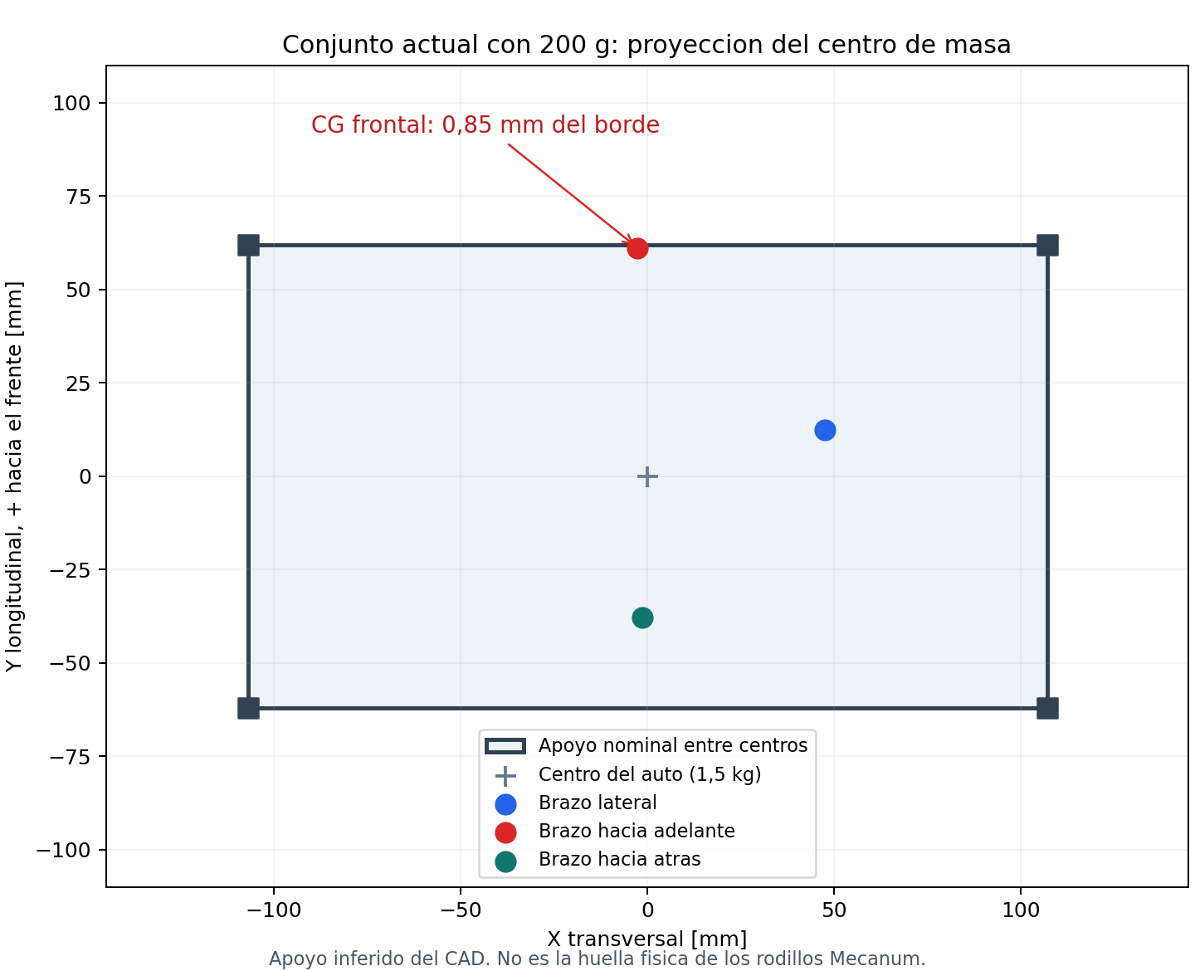
AutoFinalRobo2-CAD/mecanica/brazo-antropomorfo/revision_v17/analisis_conjunto_20261101/estabilidad_planta.png
