kobachajchir/ProyectoRobotica2/AutoFinalRobo2-CAD/mecanica/brazo-antropomorfo/revision_v17/laminas_20261102/previews/DespieceLocal-07.png

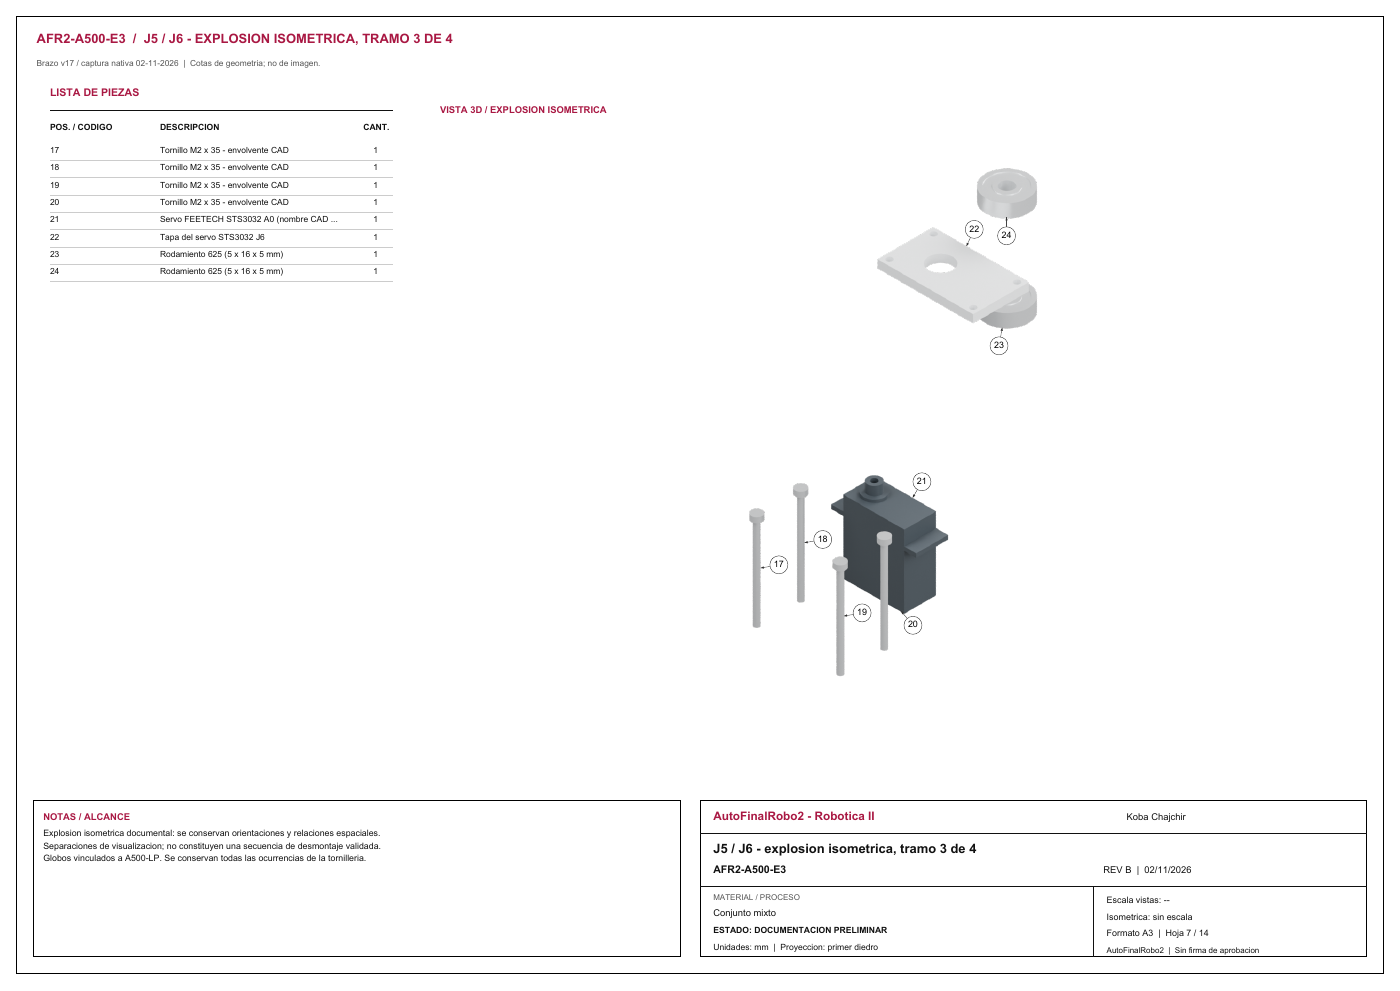
AutoFinalRobo2-CAD/mecanica/brazo-antropomorfo/revision_v17/laminas_20261102/previews/DespieceLocal-07.png
