kobachajchir/ProyectoRobotica2/AutoFinalRobo2-CAD/mecanica/brazo-antropomorfo/revision_v17/laminas_20261102/previews/Explodido2.png

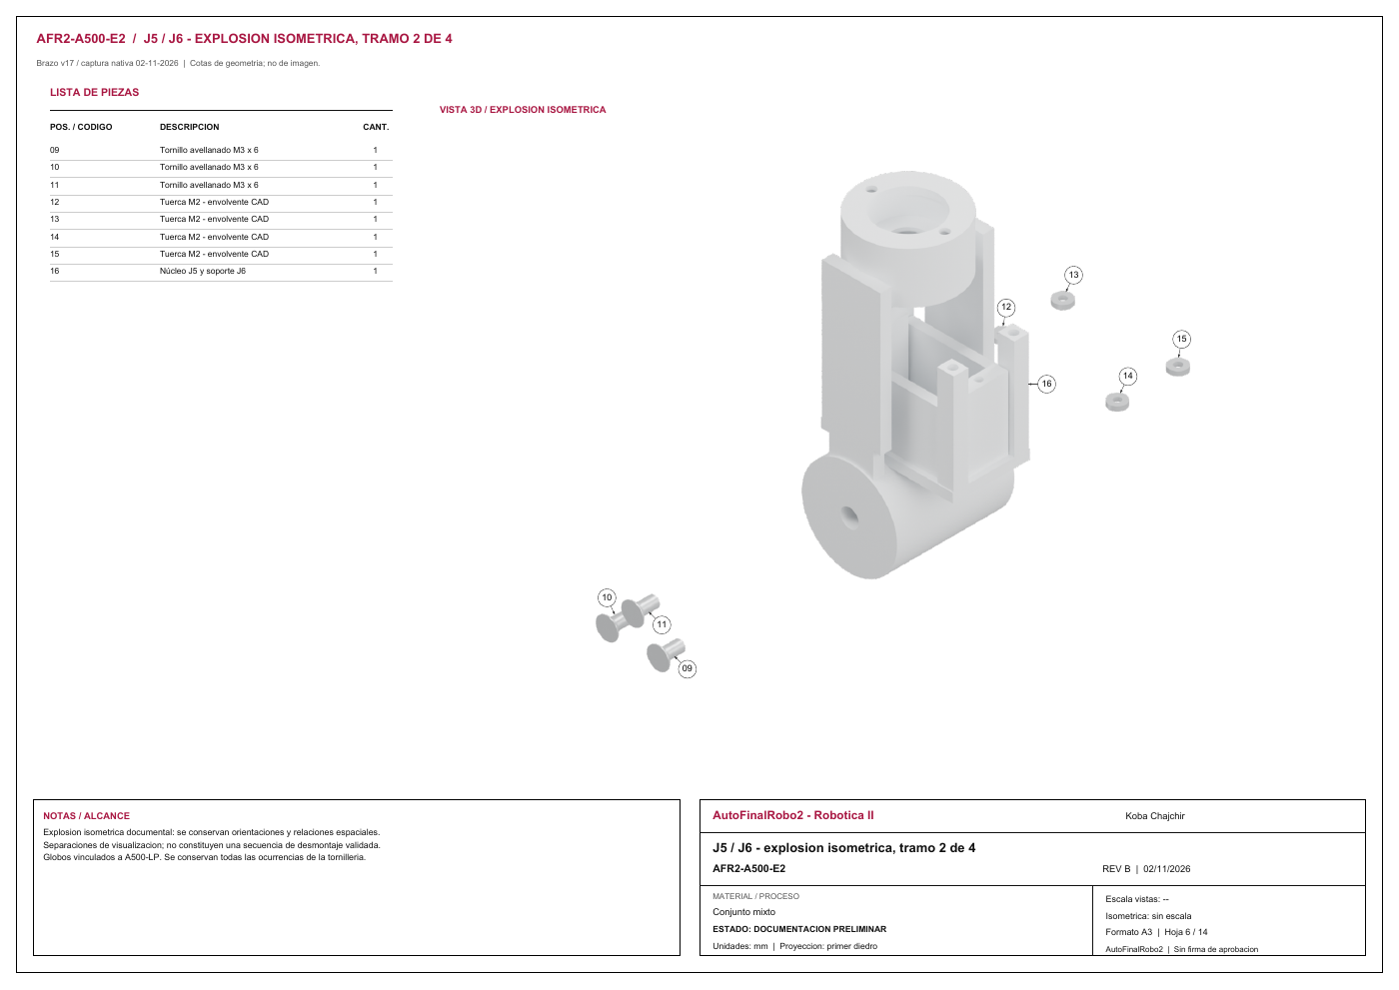
AutoFinalRobo2-CAD/mecanica/brazo-antropomorfo/revision_v17/laminas_20261102/previews/Explodido2.png
