kobachajchir/ProyectoRobotica2/AutoFinalRobo2-CAD/mecanica/sensor-bateria/referencias/esquema_divisor.png

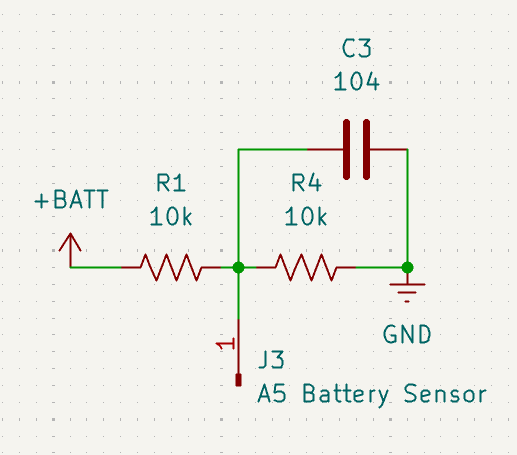
AutoFinalRobo2-CAD/mecanica/sensor-bateria/referencias/esquema_divisor.png
