kobachajchir/ProyectoRobotica2/AutoFinalRobo2-CAD/reference/brazo-prototipo/auto_superior_usuario_20261027.png

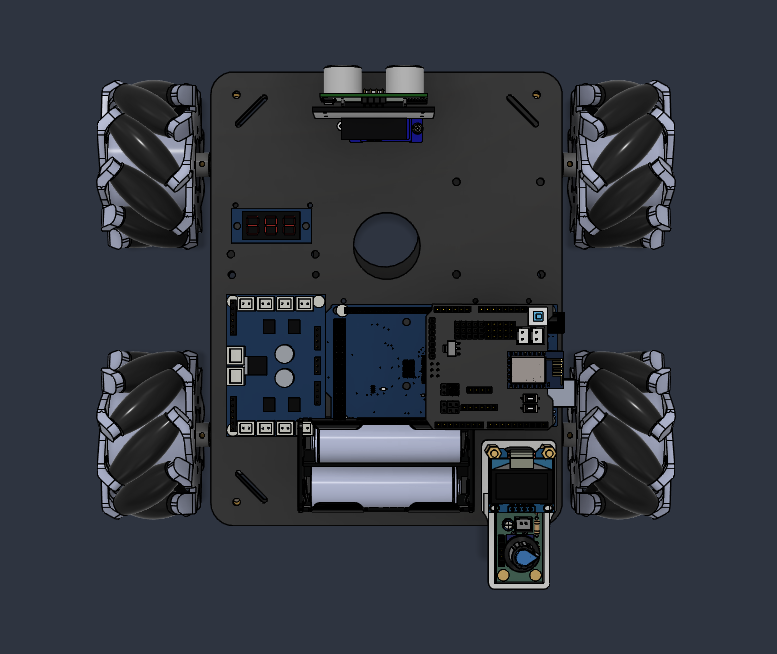
AutoFinalRobo2-CAD/reference/brazo-prototipo/auto_superior_usuario_20261027.png
