kobachajchir/ProyectoRobotica2/AutoFinalRobo2-CAD/reference/brazo-prototipo/pvc32_usuario.jpg

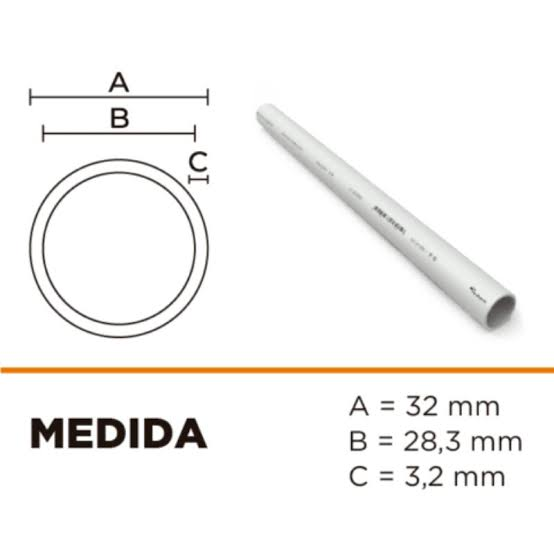
AutoFinalRobo2-CAD/reference/brazo-prototipo/pvc32_usuario.jpg
