kobachajchir/ProyectoRobotica2/AutoFinalRobo2-CAD/reference/supplied/oled-encoder-20261025/oled-dimensiones.png

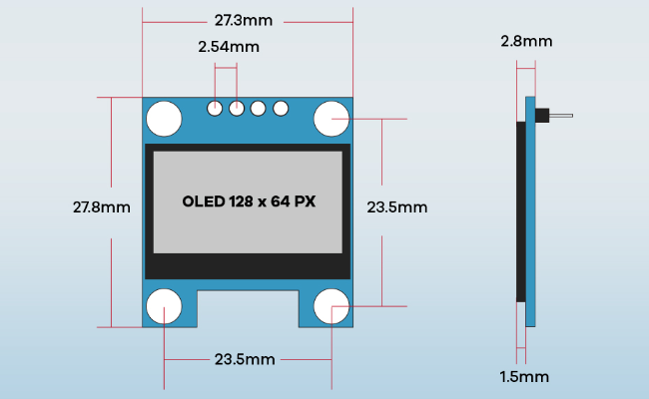
AutoFinalRobo2-CAD/reference/supplied/oled-encoder-20261025/oled-dimensiones.png
