kobachajchir/ProyectoRobotica2/AutoFinalRobo2-CAD/renders/2026-10-24/blender-final-atras.png

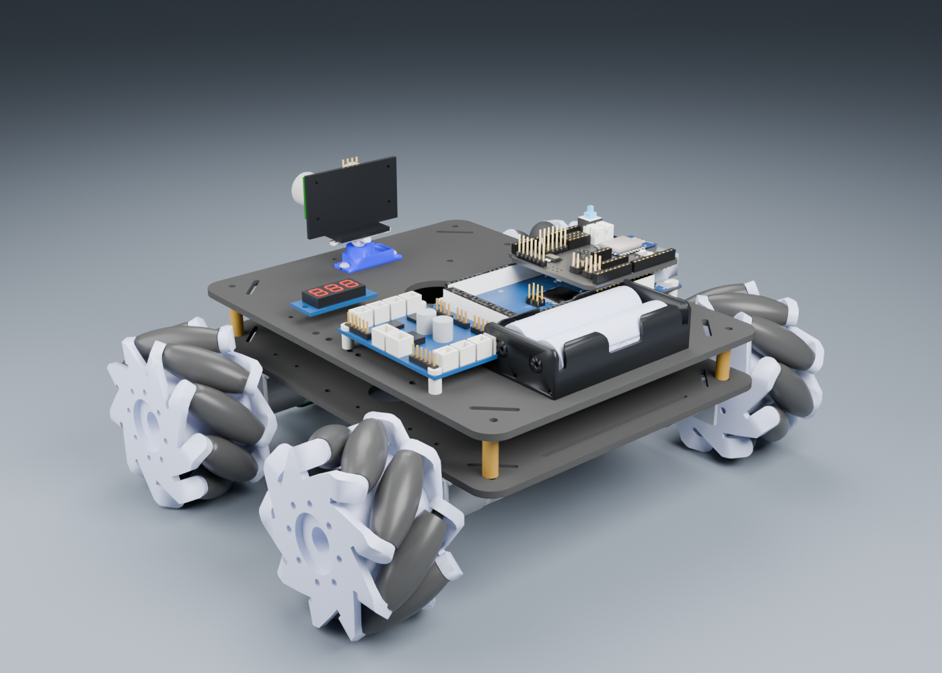
AutoFinalRobo2-CAD/renders/2026-10-24/blender-final-atras.png
