kobachajchir/ProyectoRobotica2/AutoFinalRobo2-CAD/renders/2026-10-24/fusion-lado-izquierdo.png

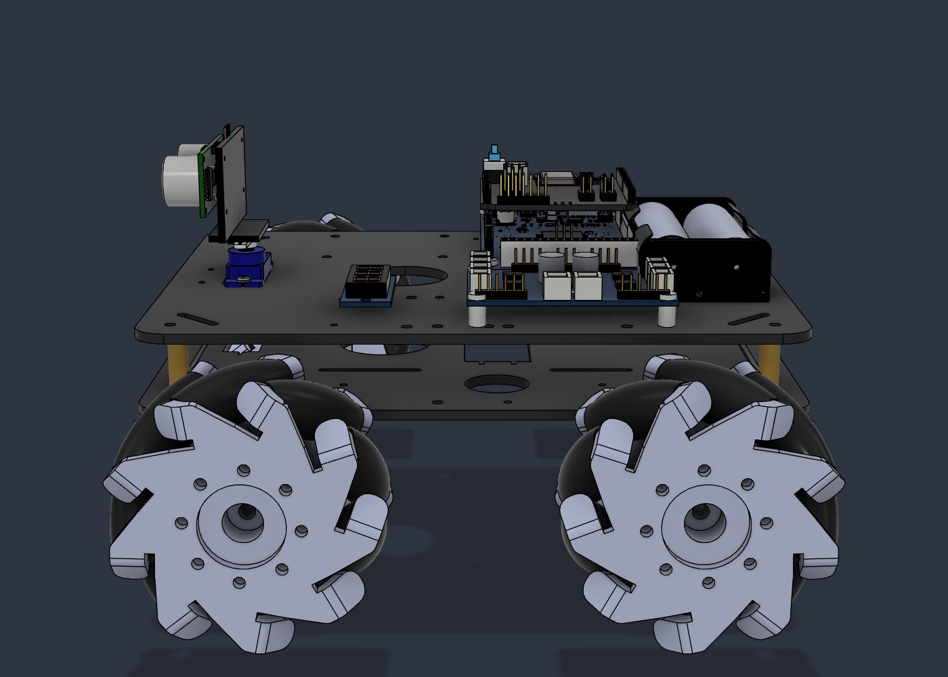
AutoFinalRobo2-CAD/renders/2026-10-24/fusion-lado-izquierdo.png
