kobachajchir/ProyectoRobotica2/AutoFinalRobo2-Contracts/.agents/skills/oled128-ui-design/assets/dashboard-proposal.png

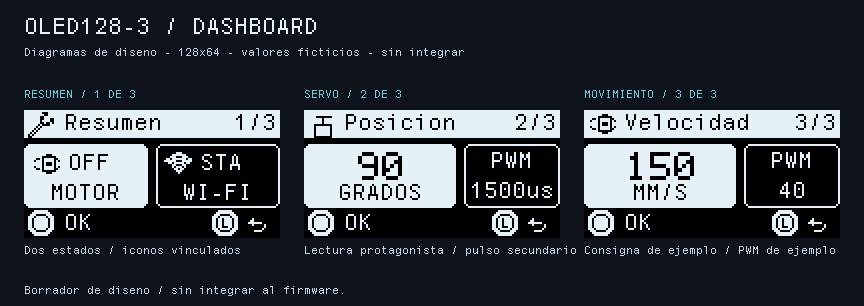
AutoFinalRobo2-Contracts/.agents/skills/oled128-ui-design/assets/dashboard-proposal.png
