kobachajchir/ProyectoRobotica2/AutoFinalRobo2-Contracts/.agents/skills/oled128-ui-design/assets/encoder-gestures-proposal.png

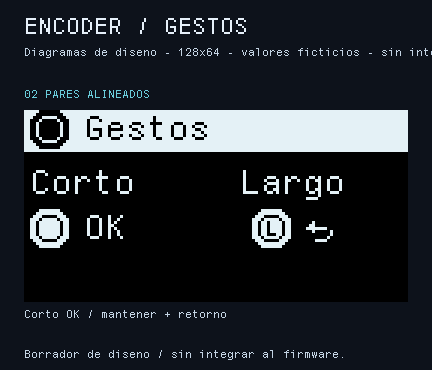
AutoFinalRobo2-Contracts/.agents/skills/oled128-ui-design/assets/encoder-gestures-proposal.png
