kobachajchir/ProyectoRobotica2/AutoFinalRobo2-Contracts/.agents/skills/oled128-ui-design/assets/inspiration/dashboard-monitor.png

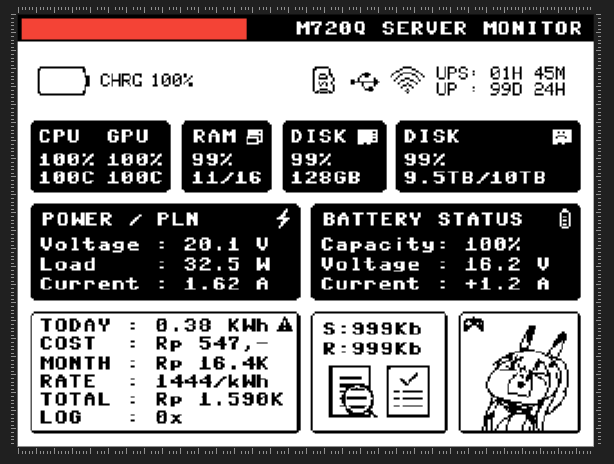
AutoFinalRobo2-Contracts/.agents/skills/oled128-ui-design/assets/inspiration/dashboard-monitor.png
