kobachajchir/ProyectoRobotica2/AutoFinalRobo2-Contracts/.agents/skills/oled128-ui-design/assets/inspiration/quick-actions-list.png

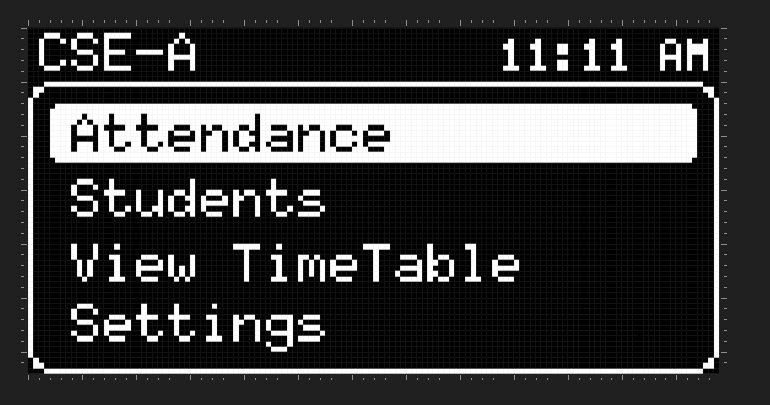
AutoFinalRobo2-Contracts/.agents/skills/oled128-ui-design/assets/inspiration/quick-actions-list.png
