kobachajchir/ProyectoRobotica2/AutoFinalRobo2-Contracts/.agents/skills/oled128-ui-design/assets/qr-examples/demo/screen-preview.png

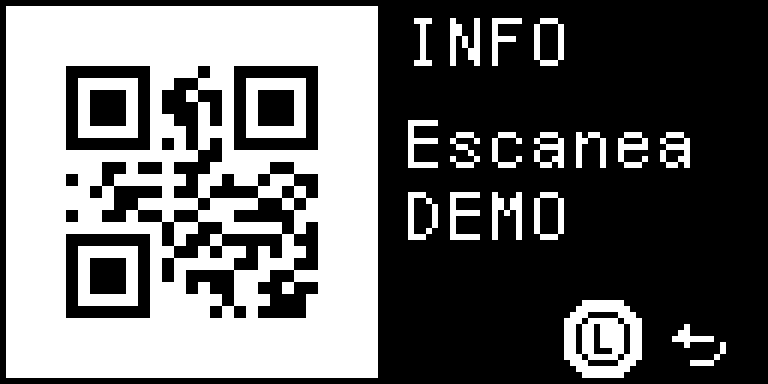
AutoFinalRobo2-Contracts/.agents/skills/oled128-ui-design/assets/qr-examples/demo/screen-preview.png
