kobachajchir/ProyectoRobotica2/AutoFinalRobo2-Contracts/.agents/skills/oled128-ui-design/assets/quick-actions-proposal.png

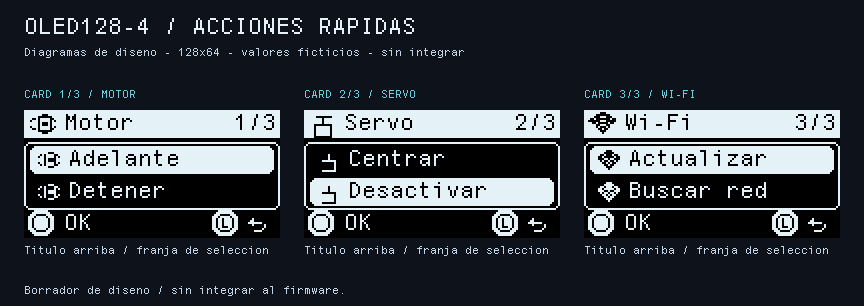
AutoFinalRobo2-Contracts/.agents/skills/oled128-ui-design/assets/quick-actions-proposal.png
