kobachajchir/ProyectoRobotica2/AutoFinalRobo2-Contracts/.codex-attachments/0dedfd2b-6900-47f5-a162-16e60b245802/67d147fc-4b1e-4e37-8735-2bfbe849fd55/1000917116.png

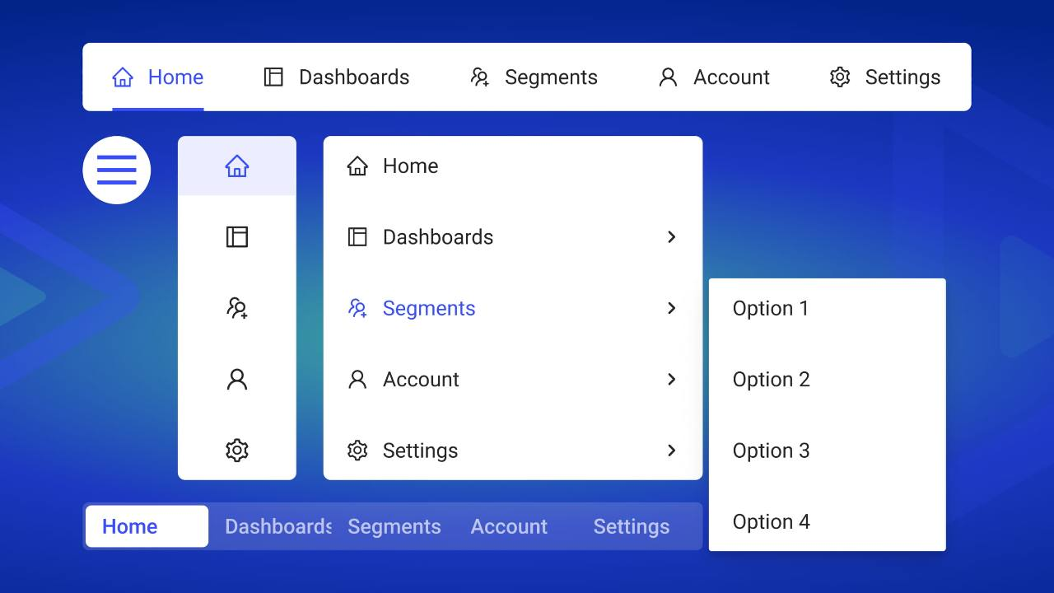
AutoFinalRobo2-Contracts/.codex-attachments/0dedfd2b-6900-47f5-a162-16e60b245802/67d147fc-4b1e-4e37-8735-2bfbe849fd55/1000917116.png
