kobachajchir/ProyectoRobotica2/AutoFinalRobo2-Contracts/.codex-attachments/0dedfd2b-6900-47f5-a162-16e60b245802/269d2f03-7140-43ae-a546-120ada1c6807/1000917115.jpg

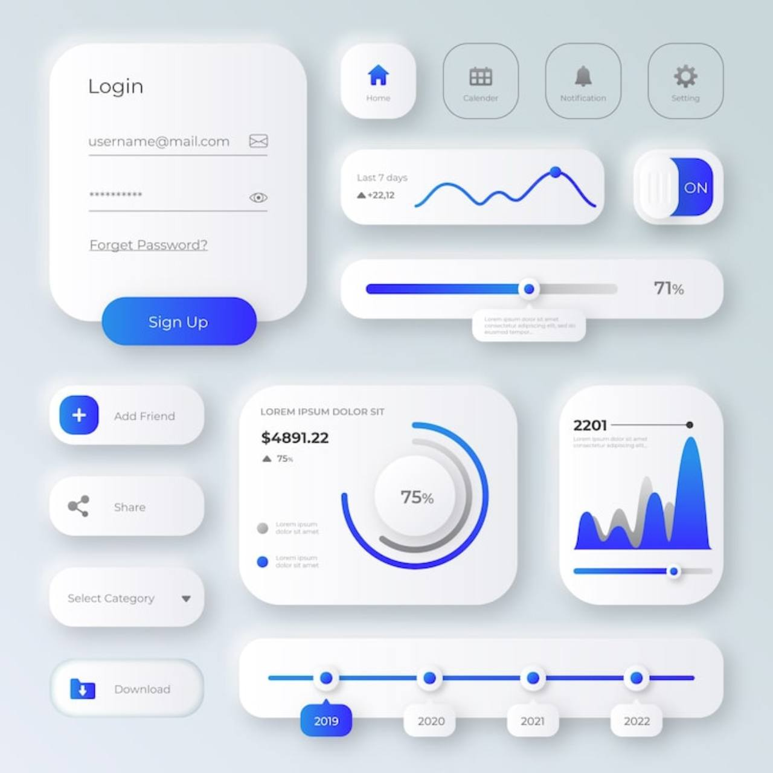
AutoFinalRobo2-Contracts/.codex-attachments/0dedfd2b-6900-47f5-a162-16e60b245802/269d2f03-7140-43ae-a546-120ada1c6807/1000917115.jpg
