kobachajchir/ProyectoRobotica2/AutoFinalRobo2-Contracts/docs/pendientes/espacio-trabajo-brazo/referencia-01-envolvente-lateral-superior.png

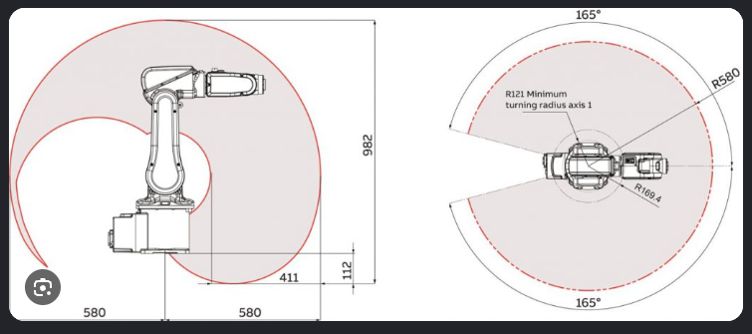
AutoFinalRobo2-Contracts/docs/pendientes/espacio-trabajo-brazo/referencia-01-envolvente-lateral-superior.png
