kobachajchir/ProyectoRobotica2/AutoFinalRobo2-Contracts/docs/pendientes/espacio-trabajo-brazo/referencia-02-envolvente-lateral-cotada.png

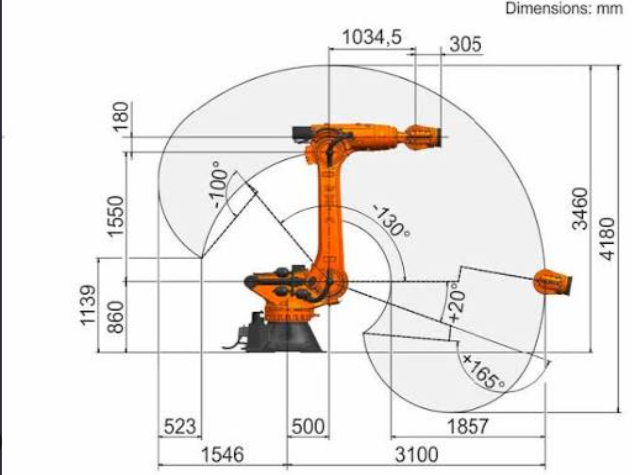
AutoFinalRobo2-Contracts/docs/pendientes/espacio-trabajo-brazo/referencia-02-envolvente-lateral-cotada.png
