kobachajchir/ProyectoRobotica2/AutoFinalRobo2-Contracts/reference/supplied/uno-esp01-programacion-referencia.jpg

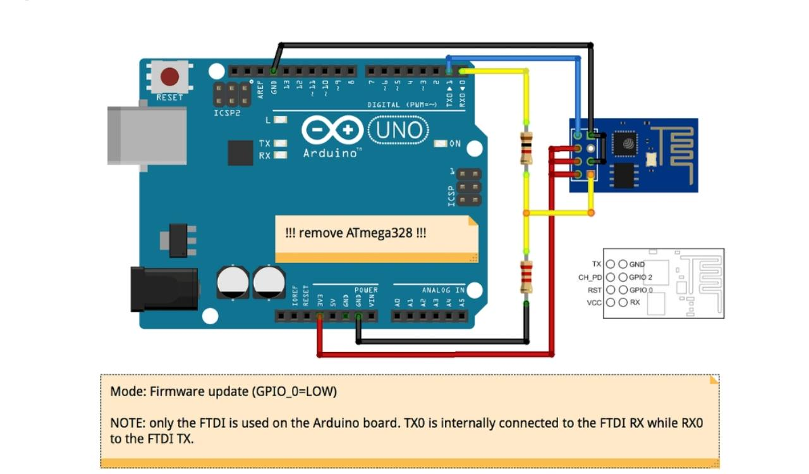
AutoFinalRobo2-Contracts/reference/supplied/uno-esp01-programacion-referencia.jpg
