kobachajchir/ProyectoRobotica2/AutoFinalRobo2-Loader/ux-audit-2026-11-06-loader/assets/despues-mcp.png

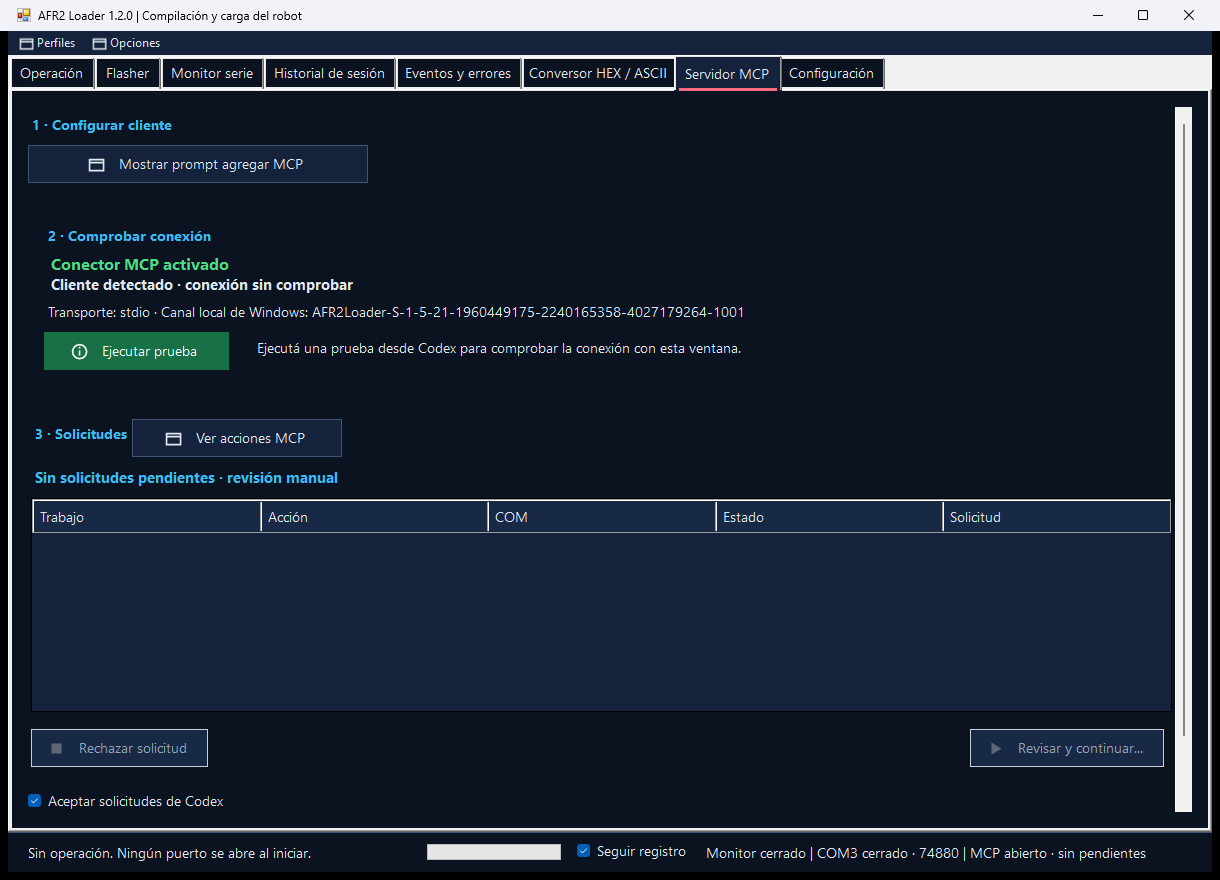
AutoFinalRobo2-Loader/ux-audit-2026-11-06-loader/assets/despues-mcp.png
