kobachajchir/ProyectoRobotica2/AutoFinalRobo2-Web/docs/plan-visual-20261101/assets/home-hero-mobile-720.webp

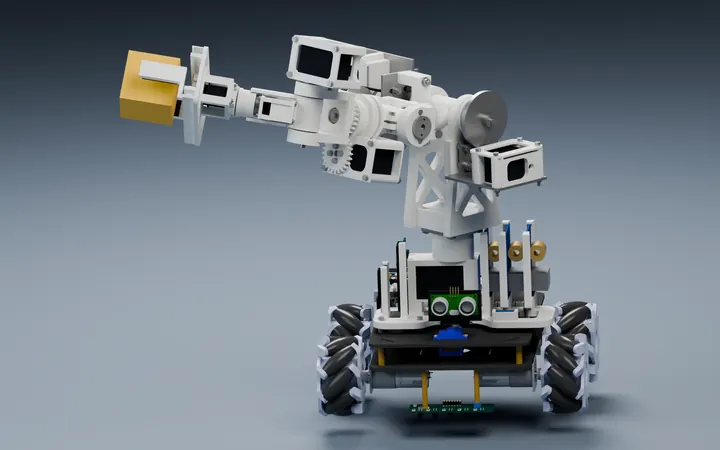
AutoFinalRobo2-Web/docs/plan-visual-20261101/assets/home-hero-mobile-720.webp
