kobachajchir/ProyectoRobotica2/AutoFinalRobo2-Web/docs/plan-visual-20261101/mockup/estructura-navegacion.png

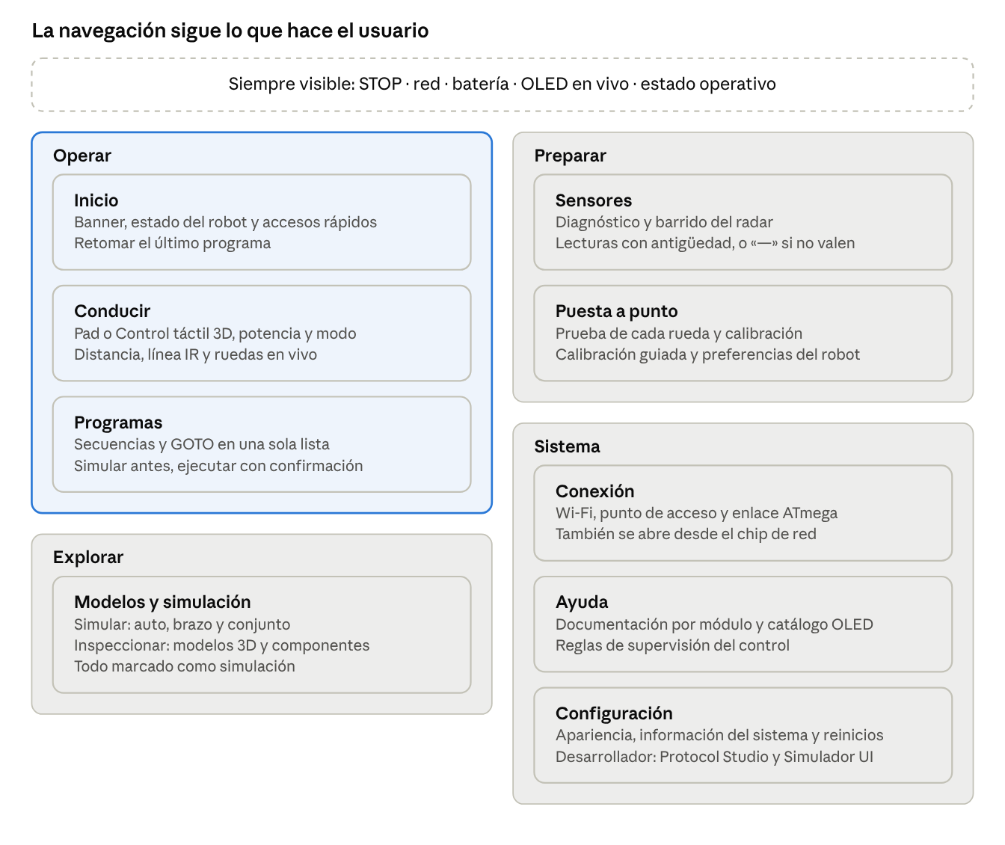
AutoFinalRobo2-Web/docs/plan-visual-20261101/mockup/estructura-navegacion.png
