kobachajchir/ProyectoRobotica2/CADS/5IRTracker/5 Channel IR Tracker.jpg

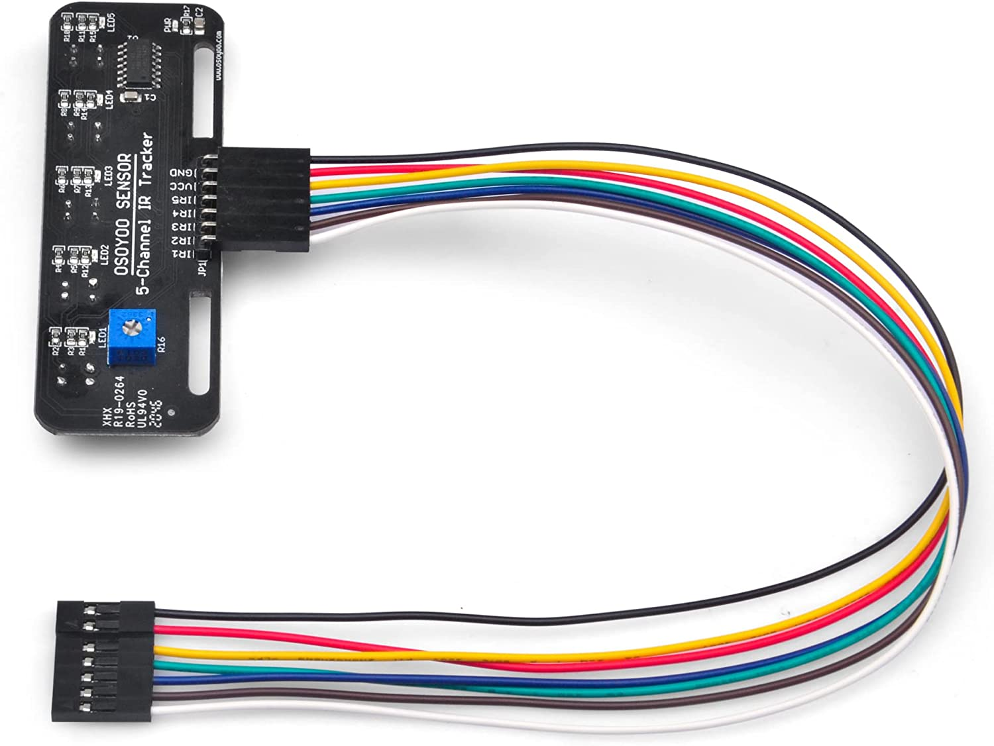
CADS/5IRTracker/5 Channel IR Tracker.jpg
