kobachajchir/ProyectoRobotica2/CADS/5IRTracker/5 Channel IR Tracker.png

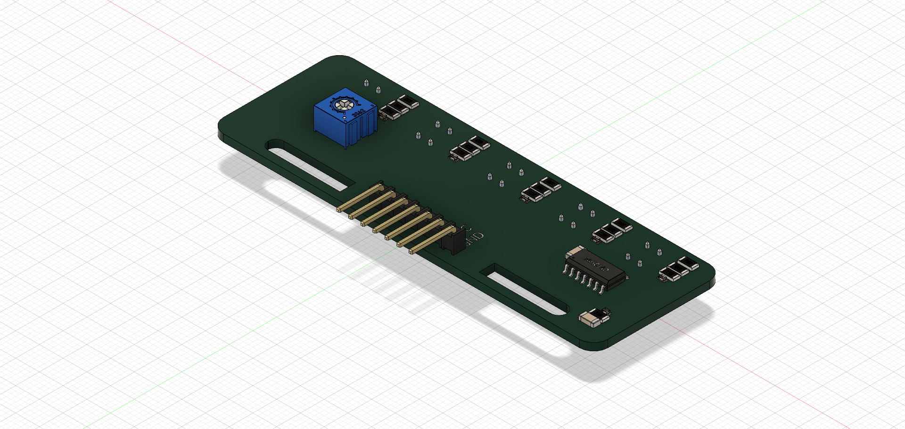
CADS/5IRTracker/5 Channel IR Tracker.png
