kobachajchir/ProyectoRobotica2/CADS/Chassis/mecanum wheel.26.jpg

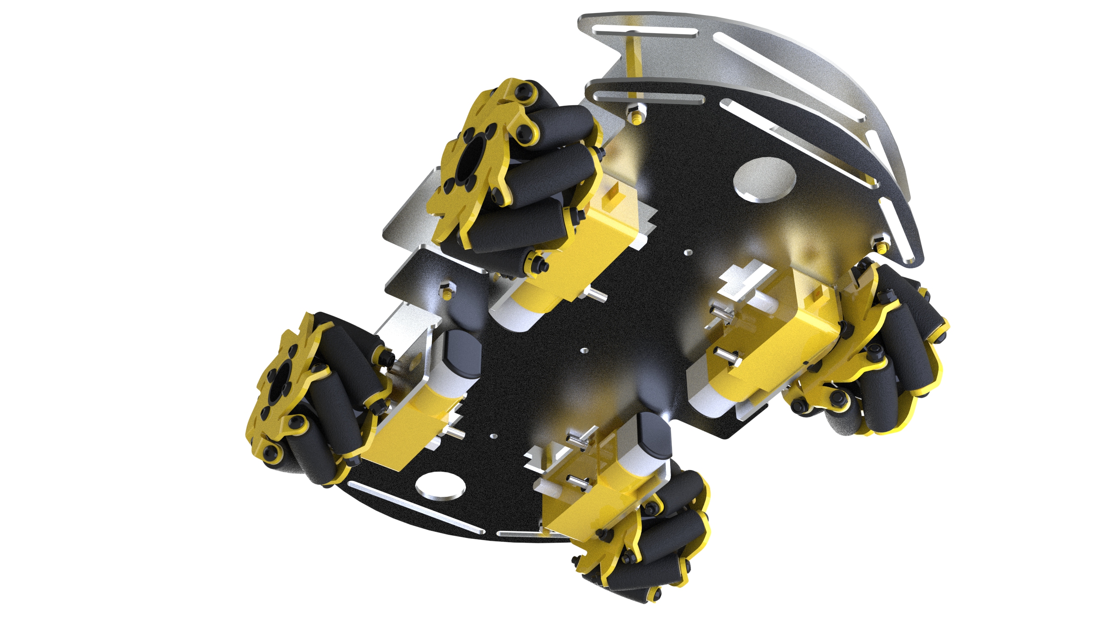
CADS/Chassis/mecanum wheel.26.jpg
