kobachajchir/ProyectoRobotica2/CADS/Chassis/mecanum wheel.30.jpg

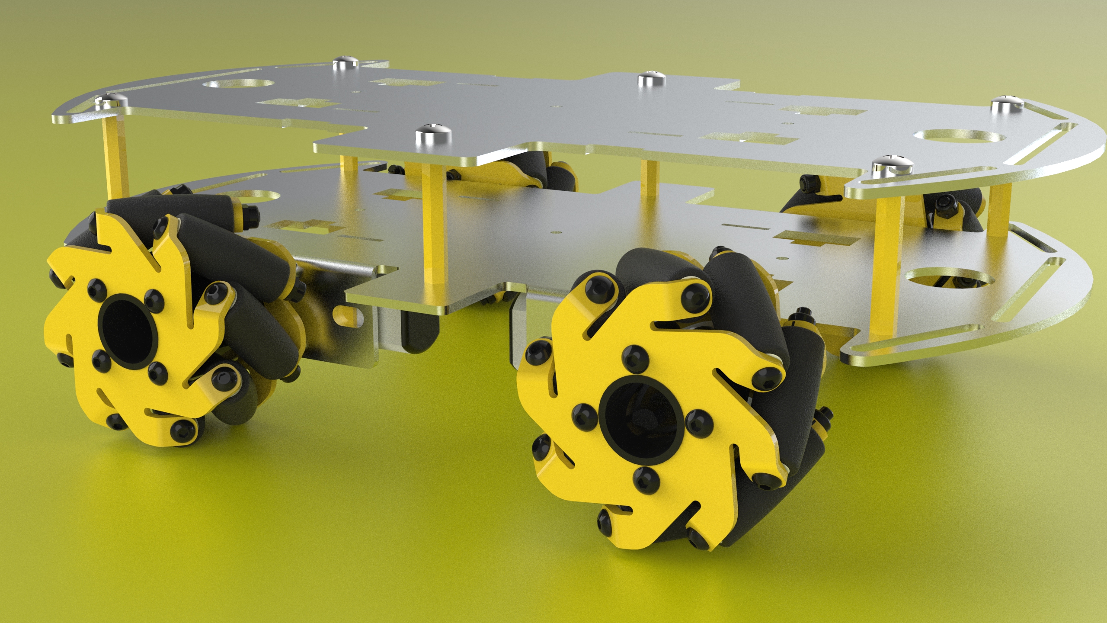
CADS/Chassis/mecanum wheel.30.jpg
