kobachajchir/ProyectoRobotica2/CADS/Chassis/mecanum wheel.32.jpg

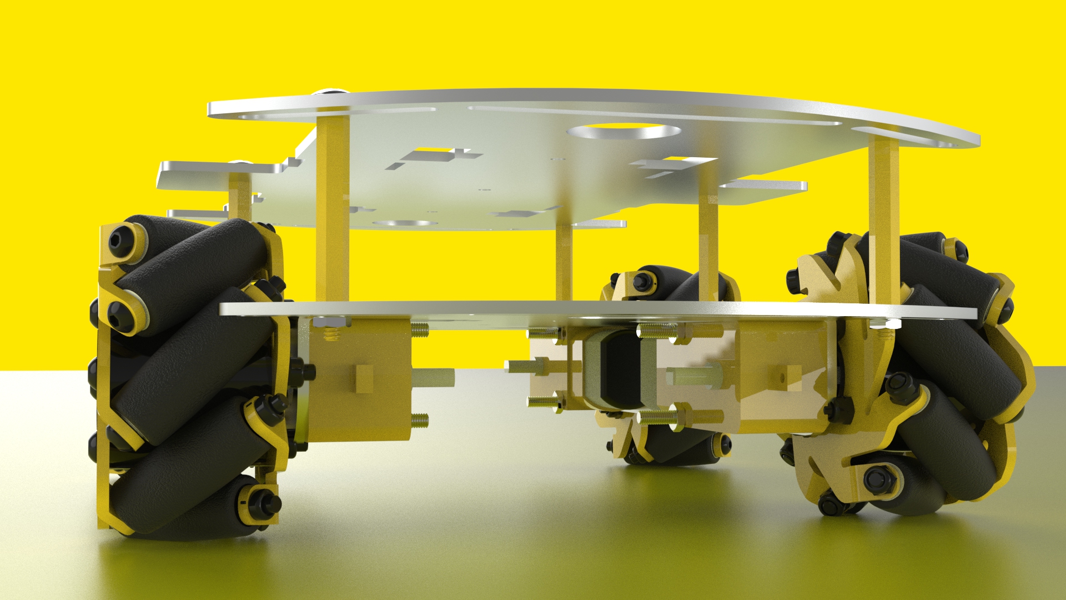
CADS/Chassis/mecanum wheel.32.jpg
