kobachajchir/ProyectoRobotica2/CADS/Chassis/mecanum wheel.34.jpg

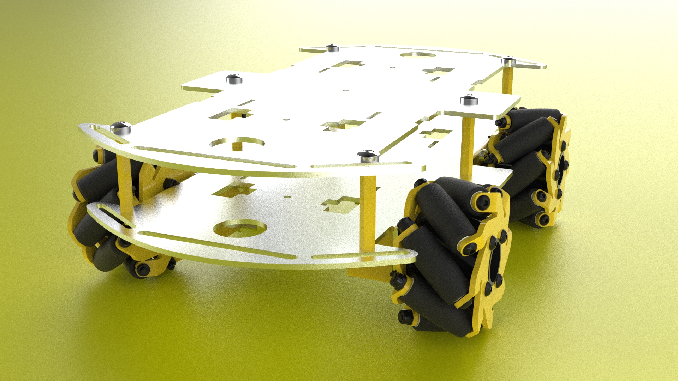
CADS/Chassis/mecanum wheel.34.jpg
