kobachajchir/ProyectoRobotica2/CADS/MEGA2560/renders/arduinoMegaGif.gif

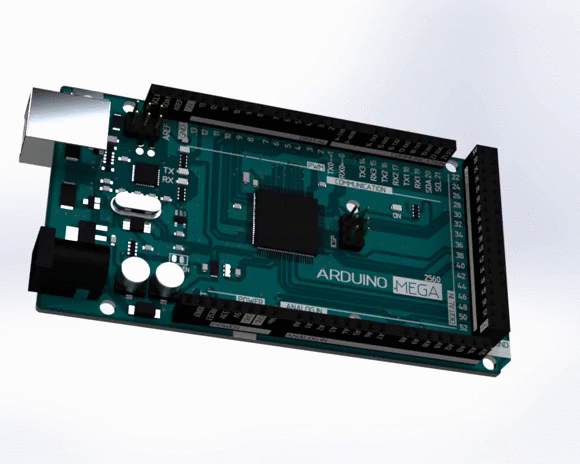
CADS/MEGA2560/renders/arduinoMegaGif.gif
