kobachajchir/ProyectoRobotica2/CADS/MotorDriver/Driver.png

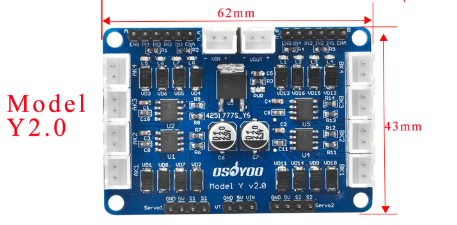
CADS/MotorDriver/Driver.png
