kobachajchir/ProyectoRobotica2/CADS/MotorDriver/DriverDimensions.png

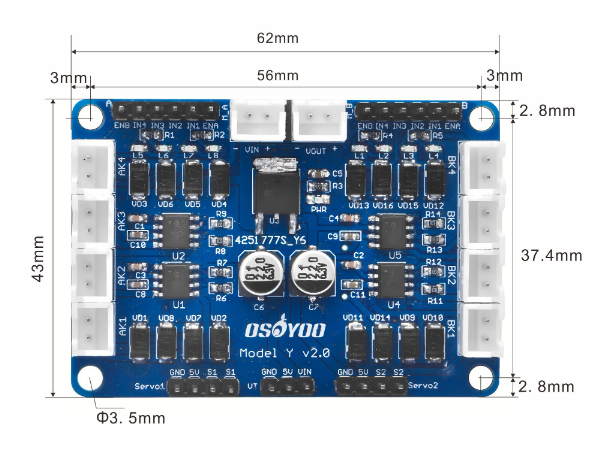
CADS/MotorDriver/DriverDimensions.png
