kobachajchir/ProyectoRobotica2/CADS/Wheels/Image20.png

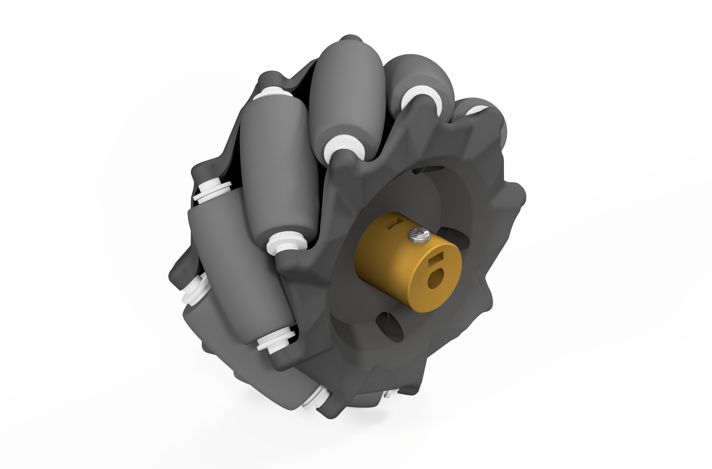
CADS/Wheels/Image20.png
