kobachajchir/ProyectoRobotica2/CADS/Wheels/Image21.png

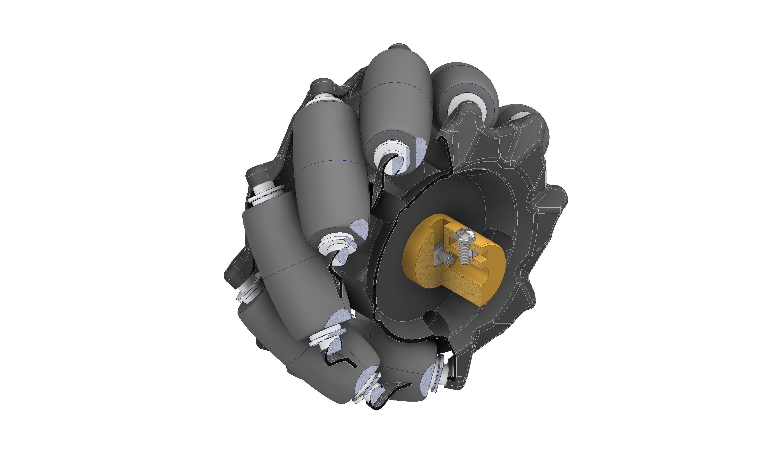
CADS/Wheels/Image21.png
