kobachajchir/ProyectoRobotica2/CADS/Wheels/Image24.png

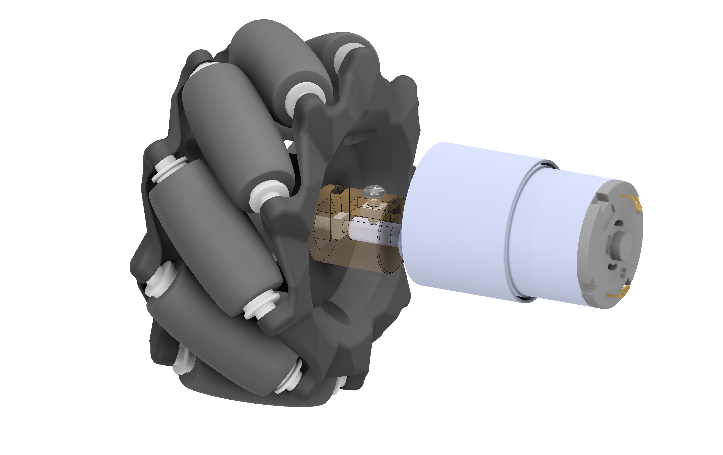
CADS/Wheels/Image24.png
