kobachajchir/ProyectoRobotica2/Documentacion/ATMEGA2560.png

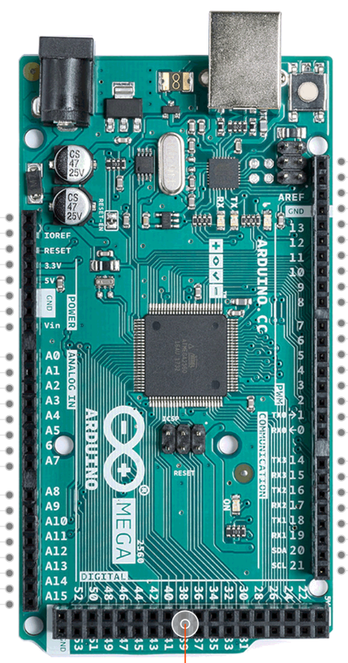
Documentacion/ATMEGA2560.png
