kobachajchir/ProyectoRobotica2/Documentacion/Dimensiones.png

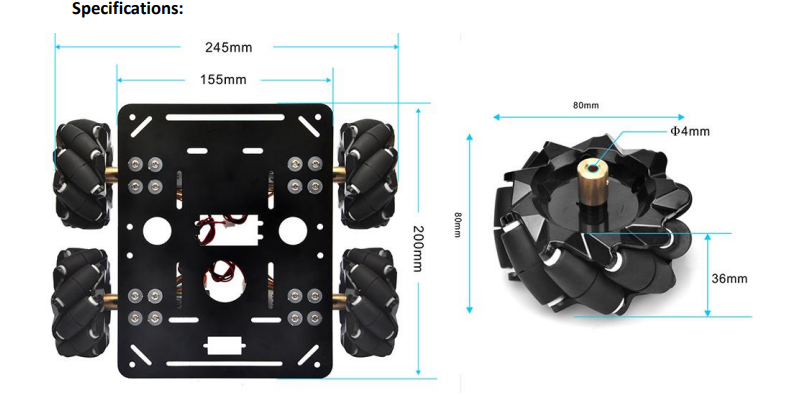
Documentacion/Dimensiones.png
