kobachajchir/ProyectoRobotica2/Documentacion/DimensionesATMega2560.png

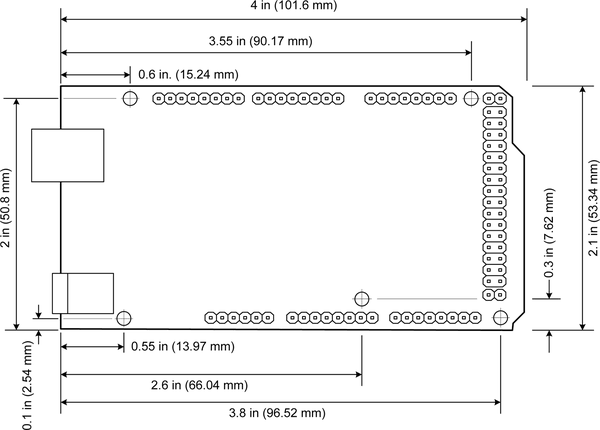
Documentacion/DimensionesATMega2560.png
