kobachajchir/ProyectoRobotica2/Documentacion/WifiShieldDocs/OSOYOO-Wifi-V1.3-pinout.jpg

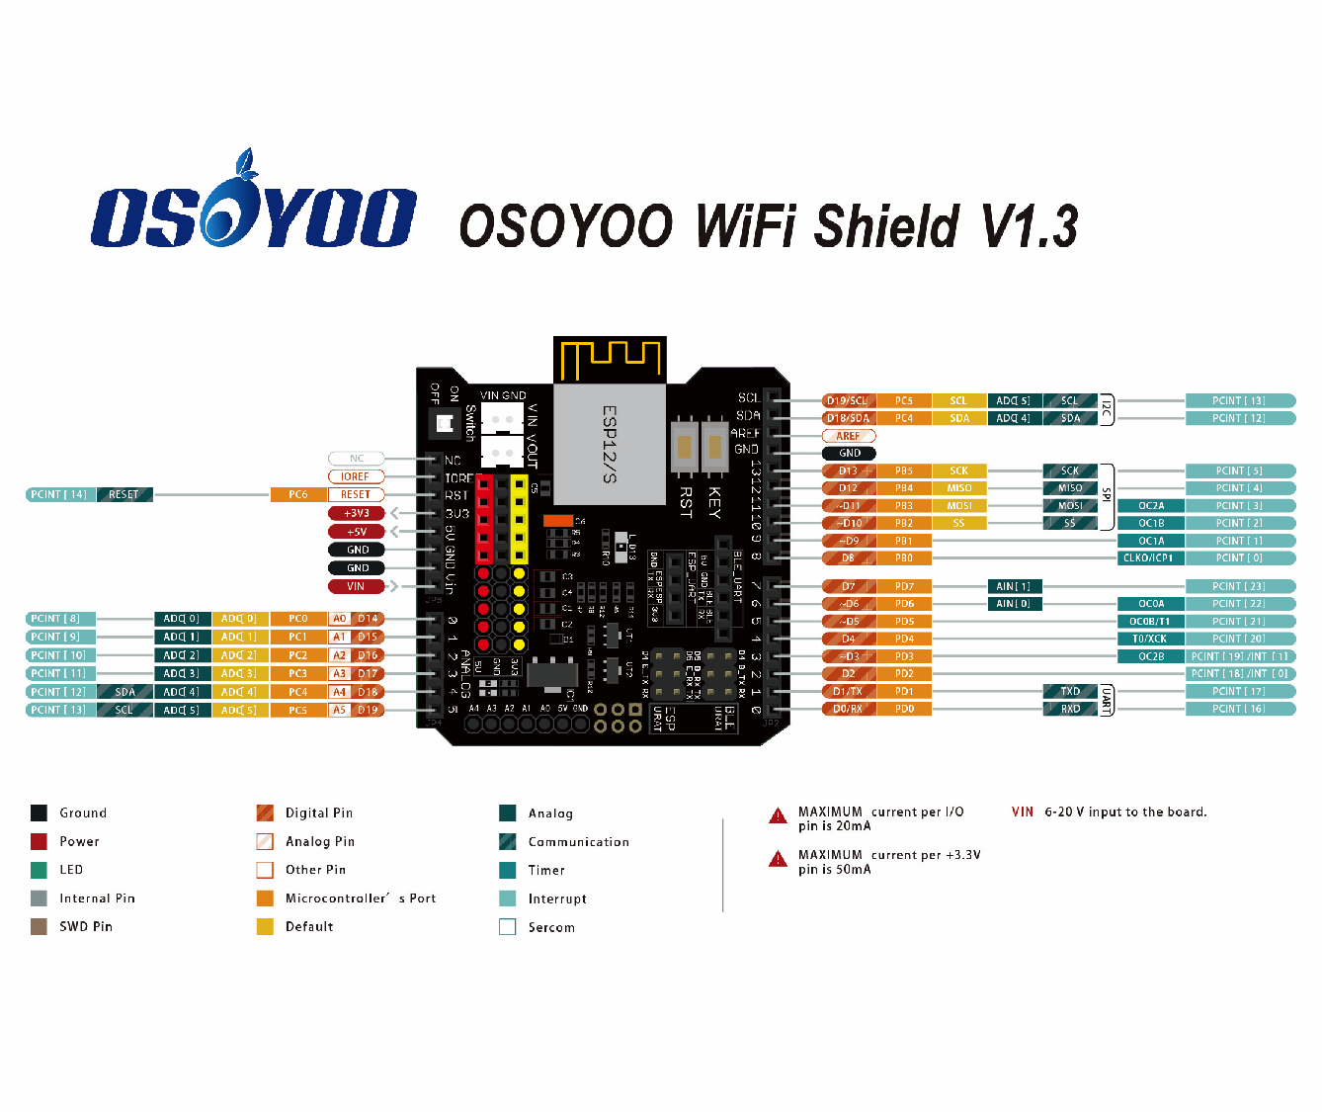
Documentacion/WifiShieldDocs/OSOYOO-Wifi-V1.3-pinout.jpg
