kobachajchir/ProyectoRobotica2/Documentacion/WifiShieldDocs/wifi-pin-map.png

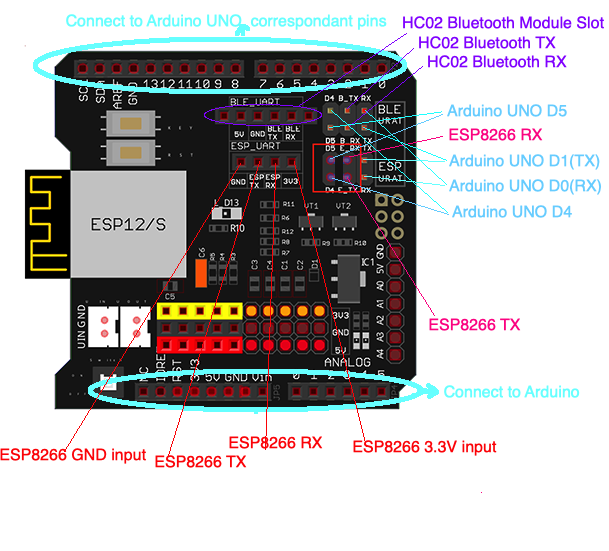
Documentacion/WifiShieldDocs/wifi-pin-map.png
