kobachajchir/ProyectoRobotica2/hardware/evidence/motor-p1.png

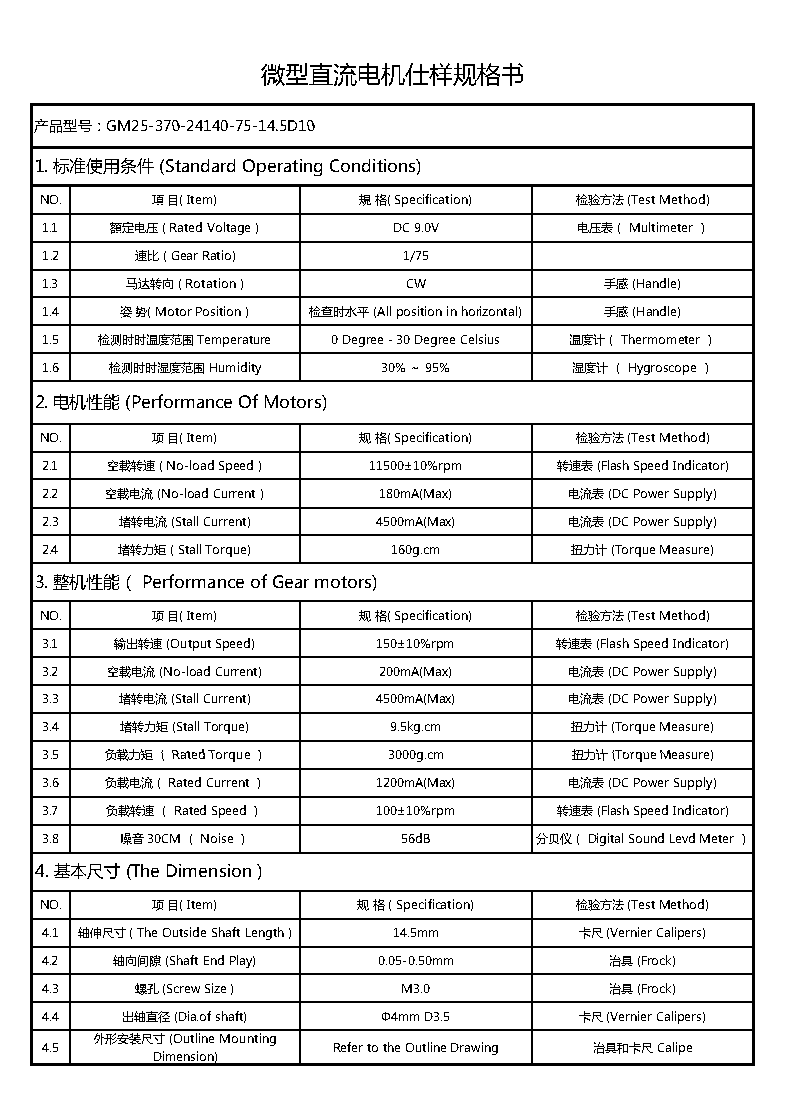
hardware/evidence/motor-p1.png
