kobachajchir/ProyectoRobotica2/AutoFinalRobo2-CAD/mecanica/brazo-antropomorfo/revision_v17/laminas_20261102/BOM_A500.csv

posicion | codigo_pieza | descripcion | cantidad | componente_CAD | ruta_CAD
1 | COMERCIAL/REFERENCIA | Tornillo avellanado M3 x 6 | 1 | V17_M3x6_ISO10642_horn_J5_3 | 05_Inclinacion_muneca:1+V17_M3x6_ISO10642_horn_J5_3:1
2 | COMERCIAL/REFERENCIA | Horn de salida STS3250 | 1 | V17_Horn_STS3250_J3 | 05_Inclinacion_muneca:1+V17_Horn_STS3250_J3:3
3 | COMERCIAL/REFERENCIA | Arandela trasera J5 | 1 | V03_Arandela_trasera_J5 | 05_Inclinacion_muneca:1+V03_Arandela_trasera_J5:1
4 | AFR2-P506 | Separador trasero de J5 | 1 | V03_Separador_trasero_J5 | 05_Inclinacion_muneca:1+V03_Separador_trasero_J5:1
5 | COMERCIAL/REFERENCIA | Tornillo axial trasero J5 | 1 | V03_Tornillo_axial_trasero_J5 | 05_Inclinacion_muneca:1+V03_Tornillo_axial_trasero_J5:1
6 | AFR2-P504 | Eje y brida de J5 | 1 | V02_E04_Eje_y_brida_J5 | 05_Inclinacion_muneca:1+V02_E04_Eje_y_brida_J5:1
7 | AFR2-P505 | Separador axial de J5 | 1 | V03_Separador_axial_J5 | 05_Inclinacion_muneca:1+V03_Separador_axial_J5:1
8 | COMERCIAL/REFERENCIA | Tornillo original horn V02 M05 MG946 J5 | 1 | V03_Tornillo_original_horn_V02_M05_MG946_J5 | 05_Inclinacion_muneca:1+V03_Tornillo_original_horn_V02_M05_MG946_J5:1
9 | COMERCIAL/REFERENCIA | Tornillo avellanado M3 x 6 | 1 | V17_M3x6_ISO10642_horn_J5_0 | 05_Inclinacion_muneca:1+V17_M3x6_ISO10642_horn_J5_0:1
10 | COMERCIAL/REFERENCIA | Tornillo avellanado M3 x 6 | 1 | V17_M3x6_ISO10642_horn_J5_1 | 05_Inclinacion_muneca:1+V17_M3x6_ISO10642_horn_J5_1:1
11 | COMERCIAL/REFERENCIA | Tornillo avellanado M3 x 6 | 1 | V17_M3x6_ISO10642_horn_J5_2 | 05_Inclinacion_muneca:1+V17_M3x6_ISO10642_horn_J5_2:1
12 | COMERCIAL/REFERENCIA | Tuerca M2 - envolvente CAD | 1 | V17_Tuerca_M2_J6_0 | 05_Inclinacion_muneca:1+V17_Tuerca_M2_J6_0:1
13 | COMERCIAL/REFERENCIA | Tuerca M2 - envolvente CAD | 1 | V17_Tuerca_M2_J6_1 | 05_Inclinacion_muneca:1+V17_Tuerca_M2_J6_1:1
14 | COMERCIAL/REFERENCIA | Tuerca M2 - envolvente CAD | 1 | V17_Tuerca_M2_J6_2 | 05_Inclinacion_muneca:1+V17_Tuerca_M2_J6_2:1
15 | COMERCIAL/REFERENCIA | Tuerca M2 - envolvente CAD | 1 | V17_Tuerca_M2_J6_3 | 05_Inclinacion_muneca:1+V17_Tuerca_M2_J6_3:1
16 | AFR2-P501 | Núcleo J5 y soporte J6 | 1 | V02_A18_Nucleo_J5_y_columna_J6 | 05_Inclinacion_muneca:1+V02_A18_Nucleo_J5_y_columna_J6:1
17 | COMERCIAL/REFERENCIA | Tornillo M2 x 35 - envolvente CAD | 1 | V17_M2x35_cilindrico_J6_0 | 05_Inclinacion_muneca:1+V17_M2x35_cilindrico_J6_0:1
18 | COMERCIAL/REFERENCIA | Tornillo M2 x 35 - envolvente CAD | 1 | V17_M2x35_cilindrico_J6_1 | 05_Inclinacion_muneca:1+V17_M2x35_cilindrico_J6_1:1
19 | COMERCIAL/REFERENCIA | Tornillo M2 x 35 - envolvente CAD | 1 | V17_M2x35_cilindrico_J6_2 | 05_Inclinacion_muneca:1+V17_M2x35_cilindrico_J6_2:1
20 | COMERCIAL/REFERENCIA | Tornillo M2 x 35 - envolvente CAD | 1 | V17_M2x35_cilindrico_J6_3 | 05_Inclinacion_muneca:1+V17_M2x35_cilindrico_J6_3:1
21 | COMERCIAL/REFERENCIA | Servo FEETECH STS3032 A0 (nombre CAD heredado) | 1 | V02_M06_MG90S_J6 | 05_Inclinacion_muneca:1+V02_M06_MG90S_J6:1
22 | AFR2-P503 | Tapa del servo STS3032 J6 | 1 | V17_Tapa_STS3032_J6 | 05_Inclinacion_muneca:1+V17_Tapa_STS3032_J6:1
23 | COMERCIAL/REFERENCIA | Rodamiento 625 (5 x 16 x 5 mm) | 1 | V03_R06_625_J6_inferior | 05_Inclinacion_muneca:1+V03_R06_625_J6_inferior:1
24 | COMERCIAL/REFERENCIA | Rodamiento 625 (5 x 16 x 5 mm) | 1 | V02_R06_625_J6 | 05_Inclinacion_muneca:1+V02_R06_625_J6:1
25 | COMERCIAL/REFERENCIA | Inserto M2 - referencia | 1 | V03_Inserto_M2_J6_-1 | 05_Inclinacion_muneca:1+V03_Inserto_M2_J6_-1:1
26 | COMERCIAL/REFERENCIA | Inserto M2 - referencia | 1 | V03_Inserto_M2_J6_1 | 05_Inclinacion_muneca:1+V03_Inserto_M2_J6_1:1
27 | COMERCIAL/REFERENCIA | Tornillo de tapa J6 | 1 | V03_Tornillo_tapa_J6_-1 | 05_Inclinacion_muneca:1+V03_Tornillo_tapa_J6_-1:1
28 | COMERCIAL/REFERENCIA | Tornillo de tapa J6 | 1 | V03_Tornillo_tapa_J6_1 | 05_Inclinacion_muneca:1+V03_Tornillo_tapa_J6_1:1
29 | AFR2-P502 | Tapa de retención 625 de J6 | 1 | V03_Tapa_625_J6 | 05_Inclinacion_muneca:1+V03_Tapa_625_J6:1
