kobachajchir/ProyectoRobotica2/AutoFinalRobo2-CAD/docs/DESCARGAS_CANDIDATAS_3D.csv

name | path | source_url | download_url | revision | license | author | bytes | sha256 | state | adaptation
Mega2560 | vendor/revision-2026-10-23/arduino-mega.step |  | https://raw.githubusercontent.com/FreeCAD/FreeCAD-library/f5ca01cdcaa2f69b9295a6382719c2d90628780c/Computing/SingleBoardComputers/Arduino/arduino-mega.step | f5ca01cdcaa2f69b9295a6382719c2d90628780c | CC-BY-3.0 | Autores de cada pieza en historial upstream; ver REVISION_CANDIDATOS_3D.md | 7106676 | c25241c77c9d102d3ea482e04c910c9a645426979af843b0375261e1ebd70053 | pendiente de aprobacion | ninguna
Mega2560 | vendor/revision-2026-10-23/arduino-mega.fcstd |  | https://raw.githubusercontent.com/FreeCAD/FreeCAD-library/f5ca01cdcaa2f69b9295a6382719c2d90628780c/Computing/SingleBoardComputers/Arduino/arduino-mega.fcstd | f5ca01cdcaa2f69b9295a6382719c2d90628780c | CC-BY-3.0 | Autores de cada pieza en historial upstream; ver REVISION_CANDIDATOS_3D.md | 742985 | 555c1f58ec7c12b63b709999d13b302b4a81964d661967278a68e9c85a00b289 | pendiente de aprobacion | ninguna
SG90 | vendor/revision-2026-10-23/Servo-sg90.step |  | https://raw.githubusercontent.com/FreeCAD/FreeCAD-library/f5ca01cdcaa2f69b9295a6382719c2d90628780c/Electrical%20Parts/Servos/SG-90/Servo-sg90.step | f5ca01cdcaa2f69b9295a6382719c2d90628780c | CC-BY-3.0 | Autores de cada pieza en historial upstream; ver REVISION_CANDIDATOS_3D.md | 1503392 | 9ad7b12887580bf68135e7bf544f0fc231ab9af988508184c097b1d1c3e7d734 | pendiente de aprobacion | ninguna
Brazo SG90 | vendor/revision-2026-10-23/SG90-1-arm-horn.step |  | https://raw.githubusercontent.com/FreeCAD/FreeCAD-library/f5ca01cdcaa2f69b9295a6382719c2d90628780c/Electrical%20Parts/Servos/SG-90/SG90-1-arm-horn.step | f5ca01cdcaa2f69b9295a6382719c2d90628780c | CC-BY-3.0 | Autores de cada pieza en historial upstream; ver REVISION_CANDIDATOS_3D.md | 85272 | d74e1e0e056ecc071f24daba43380b887b819eb55c300a41f2429d455180b0df | pendiente de aprobacion | ninguna
HC-SR04 | vendor/revision-2026-10-23/HC-SR04.step |  | https://raw.githubusercontent.com/FreeCAD/FreeCAD-library/f5ca01cdcaa2f69b9295a6382719c2d90628780c/Sensors/Ultrasonic%20Sensors/HC-SR04.step | f5ca01cdcaa2f69b9295a6382719c2d90628780c | CC-BY-3.0 | Autores de cada pieza en historial upstream; ver REVISION_CANDIDATOS_3D.md | 3130919 | 707e770fe1b10bee6b6e58e62a47ae2f4dee7e28580ab0d0e20f815473aa0ef5 | pendiente de aprobacion | ninguna
18650-cell | vendor/revision-2026-10-23/18650-cell.step | https://www.innerscene.com/tools/library/3d-parts/18650-cell-maximum-envelope-a6729085 | https://www.innerscene.com/api/library/18650-cell-maximum-envelope-a6729085/download | descarga 2026-10-23; sin version inmutable publicada | CC0 | Innerscene | 30393 | 483b0052ea70e6304c75eb378a96eca6e821f2e225e5144958691107daca6c19 | alternativa generica pendiente de aprobacion | ninguna
holder-2x18650 | vendor/revision-2026-10-23/holder-2x18650.step | https://www.innerscene.com/tools/library/3d-parts/2-cell-18650-holder-97a0080c | https://www.innerscene.com/api/library/2-cell-18650-holder-97a0080c/download | descarga 2026-10-23; sin version inmutable publicada | CC0 | Innerscene | 384799 | 04a94dc082fd057ca356628a6d49a316cca16ed3e684dae701f5f412b2a7067b | alternativa generica pendiente de aprobacion | ninguna
