kobachajchir/ProyectoRobotica2/AutoFinalRobo2-CAD/mecanica/componentes/README.md

# Componentes editables

Fuentes de componentes propios o adaptados que utilizará el ensamblaje. Registrar por archivo origen, autoría/licencia conocida, cambios, parámetros y estado. Mantener intactos los insumos de ../../reference/supplied y crear aquí los derivados cuando se autorice.

Estado: todavía no se adaptaron componentes ni se comprobaron dimensiones.
