kobachajchir/ProyectoRobotica2/AutoFinalRobo2-CAD/mecanica/brazo-antropomorfo/revision_v17/laminas_20261109/BOM_CONJUNTOS.csv

conjunto | posicion | codigo | componente | ruta_CAD | cantidad
AFR2-A100 | 1 | COMERCIAL/REFERENCIA | V03_Bornera_y_alimentacion_REF | 00_Base_control:1+V03_Bornera_y_alimentacion_REF:1 | 1
AFR2-A100 | 2 | COMERCIAL/REFERENCIA | V03_Casquillo_central_compresion | 00_Base_control:1+V03_Casquillo_central_compresion:1 | 1
AFR2-A100 | 3 | COMERCIAL/REFERENCIA | V03_Nano_vertical | 00_Base_control:1+V03_Nano_vertical:1 | 1
AFR2-A100 | 4 | COMERCIAL/REFERENCIA | V03_PCA9685_vertical | 00_Base_control:1+V03_PCA9685_vertical:1 | 1
AFR2-A100 | 5 | AFR2-P101 | V03_Separador_M3_A | 00_Base_control:1+V03_Separador_M3_A:1 | 1
AFR2-A100 | 6 | AFR2-P102 | V03_Separador_M3_B | 00_Base_control:1+V03_Separador_M3_B:1 | 1
AFR2-A100 | 7 | AFR2-P103 | V03_Separador_M3_C | 00_Base_control:1+V03_Separador_M3_C:1 | 1
AFR2-A100 | 8 | AFR2-P104 | V03_Separador_M3_D | 00_Base_control:1+V03_Separador_M3_D:1 | 1
AFR2-A100 | 9 | AFR2-P105 | V03_Tapa_rodamientos_J1 | 00_Base_control:1+V03_Tapa_rodamientos_J1:1 | 1
AFR2-A100 | 10 | COMERCIAL/REFERENCIA | V03_Tuerca_arandela_M10 | 00_Base_control:1+V03_Tuerca_arandela_M10:1 | 1
AFR2-A100 | 11 | COMERCIAL/REFERENCIA | V03_Tuerca_arandela_M3_A | 00_Base_control:1+V03_Tuerca_arandela_M3_A:1 | 1
AFR2-A100 | 12 | COMERCIAL/REFERENCIA | V03_Tuerca_arandela_M3_B | 00_Base_control:1+V03_Tuerca_arandela_M3_B:1 | 1
AFR2-A100 | 13 | COMERCIAL/REFERENCIA | V03_Tuerca_arandela_M3_C | 00_Base_control:1+V03_Tuerca_arandela_M3_C:1 | 1
AFR2-A100 | 14 | COMERCIAL/REFERENCIA | V03_Tuerca_arandela_M3_D | 00_Base_control:1+V03_Tuerca_arandela_M3_D:1 | 1
AFR2-A100 | 15 | COMERCIAL/REFERENCIA | V03_XL4016_vertical_1 | 00_Base_control:1+V03_XL4016_vertical_1:1 | 1
AFR2-A100 | 16 | COMERCIAL/REFERENCIA | V03_XL4016_vertical_2 | 00_Base_control:1+V03_XL4016_vertical_2:1 | 1
AFR2-A100 | 17 | COMERCIAL/REFERENCIA | V03_XL4016_vertical_3 | 00_Base_control:1+V03_XL4016_vertical_3:1 | 1
AFR2-A100 | 18 | AFR2-P106 | V04_Separador_M3_E | 00_Base_control:1+V04_Separador_M3_E:1 | 1
AFR2-A100 | 19 | AFR2-P107 | V04_Separador_M3_F | 00_Base_control:1+V04_Separador_M3_F:1 | 1
AFR2-A100 | 20 | COMERCIAL/REFERENCIA | V04_Tuerca_arandela_M3_E | 00_Base_control:1+V04_Tuerca_arandela_M3_E:1 | 1
AFR2-A100 | 21 | COMERCIAL/REFERENCIA | V04_Tuerca_arandela_M3_F | 00_Base_control:1+V04_Tuerca_arandela_M3_F:1 | 1
AFR2-A100 | 22 | COMERCIAL/REFERENCIA | V05_Anclaje_M3x25_A | 00_Base_control:1+V05_Anclaje_M3x25_A:1 | 1
AFR2-A100 | 23 | COMERCIAL/REFERENCIA | V05_Anclaje_M3x25_B | 00_Base_control:1+V05_Anclaje_M3x25_B:1 | 1
AFR2-A100 | 24 | COMERCIAL/REFERENCIA | V05_Anclaje_M3x25_C | 00_Base_control:1+V05_Anclaje_M3x25_C:1 | 1
AFR2-A100 | 25 | COMERCIAL/REFERENCIA | V05_Anclaje_M3x25_D | 00_Base_control:1+V05_Anclaje_M3x25_D:1 | 1
AFR2-A100 | 26 | COMERCIAL/REFERENCIA | V05_Anclaje_M3x25_E | 00_Base_control:1+V05_Anclaje_M3x25_E:1 | 1
AFR2-A100 | 27 | COMERCIAL/REFERENCIA | V05_Anclaje_M3x25_F | 00_Base_control:1+V05_Anclaje_M3x25_F:1 | 1
AFR2-A100 | 28 | COMERCIAL/REFERENCIA | V05_M10x30_DIN7991_REF | 00_Base_control:1+V05_M10x30_DIN7991_REF:1 | 1
AFR2-A100 | 29 | AFR2-P108 | V05_Montura_baja_PETG | 00_Base_control:1+V05_Montura_baja_PETG:1 | 1
AFR2-A100 | 30 | AFR2-P109 | V06_Contraplaca_inferior_unica_PETG | 00_Base_control:1+V06_Contraplaca_inferior_unica_PETG:1 | 1
AFR2-A100 | 31 | COMERCIAL/REFERENCIA | V09_Arandela_tirante_0 | 00_Base_control:1+V09_Arandela_tirante_0:1 | 1
AFR2-A100 | 32 | COMERCIAL/REFERENCIA | V09_Arandela_tirante_1 | 00_Base_control:1+V09_Arandela_tirante_1:1 | 1
AFR2-A100 | 33 | COMERCIAL/REFERENCIA | V09_Arandela_tirante_2 | 00_Base_control:1+V09_Arandela_tirante_2:1 | 1
AFR2-A100 | 34 | COMERCIAL/REFERENCIA | V09_Arandela_tirante_3 | 00_Base_control:1+V09_Arandela_tirante_3:1 | 1
AFR2-A100 | 35 | AFR2-P110 | V09_Cartucho6000_desmontable_PETG | 00_Base_control:1+V09_Cartucho6000_desmontable_PETG:1 | 1
AFR2-A100 | 36 | COMERCIAL/REFERENCIA | V09_Inserto_tapa_-1 | 00_Base_control:1+V09_Inserto_tapa_-1:1 | 1
AFR2-A100 | 37 | COMERCIAL/REFERENCIA | V09_Inserto_tapa_1 | 00_Base_control:1+V09_Inserto_tapa_1:1 | 1
AFR2-A100 | 38 | COMERCIAL/REFERENCIA | V09_Perno_tapa_-1 | 00_Base_control:1+V09_Perno_tapa_-1:1 | 1
AFR2-A100 | 39 | COMERCIAL/REFERENCIA | V09_Perno_tapa_1 | 00_Base_control:1+V09_Perno_tapa_1:1 | 1
AFR2-A100 | 40 | COMERCIAL/REFERENCIA | V09_R01_6000_J1_inferior | 00_Base_control:1+V09_R01_6000_J1_inferior:1 | 1
AFR2-A100 | 41 | COMERCIAL/REFERENCIA | V09_R01_6000_J1_superior | 00_Base_control:1+V09_R01_6000_J1_superior:1 | 1
AFR2-A100 | 42 | COMERCIAL/REFERENCIA | V09_Tirante_M3x60_0 | 00_Base_control:1+V09_Tirante_M3x60_0:1 | 1
AFR2-A100 | 43 | COMERCIAL/REFERENCIA | V09_Tirante_M3x60_1 | 00_Base_control:1+V09_Tirante_M3x60_1:1 | 1
AFR2-A100 | 44 | COMERCIAL/REFERENCIA | V09_Tirante_M3x60_2 | 00_Base_control:1+V09_Tirante_M3x60_2:1 | 1
AFR2-A100 | 45 | COMERCIAL/REFERENCIA | V09_Tirante_M3x60_3 | 00_Base_control:1+V09_Tirante_M3x60_3:1 | 1
AFR2-A100 | 46 | COMERCIAL/REFERENCIA | V09_Tuerca_tirante_0 | 00_Base_control:1+V09_Tuerca_tirante_0:1 | 1
AFR2-A100 | 47 | COMERCIAL/REFERENCIA | V09_Tuerca_tirante_1 | 00_Base_control:1+V09_Tuerca_tirante_1:1 | 1
AFR2-A100 | 48 | COMERCIAL/REFERENCIA | V09_Tuerca_tirante_2 | 00_Base_control:1+V09_Tuerca_tirante_2:1 | 1
AFR2-A100 | 49 | COMERCIAL/REFERENCIA | V09_Tuerca_tirante_3 | 00_Base_control:1+V09_Tuerca_tirante_3:1 | 1
AFR2-A100 | 50 | COMERCIAL/REFERENCIA | V17_M03_STS3250_remoto | 00_Base_control:1+V17_M03_STS3250_remoto:5 | 1
AFR2-A200 | 1 | AFR2-P201 | A01_Plataforma_giratoria_PETG | 01_Giro_base:1+A01_Plataforma_giratoria_PETG:1 | 1
AFR2-A200 | 2 | COMERCIAL/REFERENCIA | R02_608ZZ_Hombro_-1 | 01_Giro_base:1+R02_608ZZ_Hombro_-1:1 | 1
AFR2-A200 | 3 | COMERCIAL/REFERENCIA | R02_608ZZ_Hombro_1 | 01_Giro_base:1+R02_608ZZ_Hombro_1:1 | 1
AFR2-A200 | 4 | COMERCIAL/REFERENCIA | V03_E00_Husillo_base_completo | 01_Giro_base:1+V03_E00_Husillo_base_completo:1 | 1
AFR2-A200 | 5 | COMERCIAL/REFERENCIA | V03_Inserto_M3_A01_Plataforma_giratoria_PETG-1-1 | 01_Giro_base:1+V03_Inserto_M3_A01_Plataforma_giratoria_PETG-1-1:1 | 1
AFR2-A200 | 6 | COMERCIAL/REFERENCIA | V03_Inserto_M3_A01_Plataforma_giratoria_PETG-11 | 01_Giro_base:1+V03_Inserto_M3_A01_Plataforma_giratoria_PETG-11:1 | 1
AFR2-A200 | 7 | COMERCIAL/REFERENCIA | V03_Inserto_M3_A01_Plataforma_giratoria_PETG1-1 | 01_Giro_base:1+V03_Inserto_M3_A01_Plataforma_giratoria_PETG1-1:1 | 1
AFR2-A200 | 8 | COMERCIAL/REFERENCIA | V03_Inserto_M3_A01_Plataforma_giratoria_PETG11 | 01_Giro_base:1+V03_Inserto_M3_A01_Plataforma_giratoria_PETG11:1 | 1
AFR2-A200 | 9 | AFR2-P202 | V03_Tapa_608_A01_Plataforma_giratoria_PETG_-1 | 01_Giro_base:1+V03_Tapa_608_A01_Plataforma_giratoria_PETG_-1:1 | 1
AFR2-A200 | 10 | AFR2-P203 | V03_Tapa_608_A01_Plataforma_giratoria_PETG_1 | 01_Giro_base:1+V03_Tapa_608_A01_Plataforma_giratoria_PETG_1:1 | 1
AFR2-A200 | 11 | COMERCIAL/REFERENCIA | V03_Tornillo_tapa_A01_Plataforma_giratoria_PETG-1-1 | 01_Giro_base:1+V03_Tornillo_tapa_A01_Plataforma_giratoria_PETG-1-1:1 | 1
AFR2-A200 | 12 | COMERCIAL/REFERENCIA | V03_Tornillo_tapa_A01_Plataforma_giratoria_PETG-11 | 01_Giro_base:1+V03_Tornillo_tapa_A01_Plataforma_giratoria_PETG-11:1 | 1
AFR2-A200 | 13 | COMERCIAL/REFERENCIA | V03_Tornillo_tapa_A01_Plataforma_giratoria_PETG1-1 | 01_Giro_base:1+V03_Tornillo_tapa_A01_Plataforma_giratoria_PETG1-1:1 | 1
AFR2-A200 | 14 | COMERCIAL/REFERENCIA | V03_Tornillo_tapa_A01_Plataforma_giratoria_PETG11 | 01_Giro_base:1+V03_Tornillo_tapa_A01_Plataforma_giratoria_PETG11:1 | 1
AFR2-A200 | 15 | COMERCIAL/REFERENCIA | V09_Adaptador_dobleD_acero | 01_Giro_base:1+V09_Adaptador_dobleD_acero:1 | 1
AFR2-A200 | 16 | COMERCIAL/REFERENCIA | V09_Arandela_axial10_REF | 01_Giro_base:1+V09_Arandela_axial10_REF:1 | 1
AFR2-A200 | 17 | COMERCIAL/REFERENCIA | V09_Arandela_brida_0 | 01_Giro_base:1+V09_Arandela_brida_0:1 | 1
AFR2-A200 | 18 | COMERCIAL/REFERENCIA | V09_Arandela_brida_1 | 01_Giro_base:1+V09_Arandela_brida_1:1 | 1
AFR2-A200 | 19 | COMERCIAL/REFERENCIA | V09_Arandela_brida_2 | 01_Giro_base:1+V09_Arandela_brida_2:1 | 1
AFR2-A200 | 20 | COMERCIAL/REFERENCIA | V09_Arandela_brida_3 | 01_Giro_base:1+V09_Arandela_brida_3:1 | 1
AFR2-A200 | 21 | COMERCIAL/REFERENCIA | V09_Casquillo_compresion_M4_0 | 01_Giro_base:1+V09_Casquillo_compresion_M4_0:1 | 1
AFR2-A200 | 22 | COMERCIAL/REFERENCIA | V09_Casquillo_compresion_M4_1 | 01_Giro_base:1+V09_Casquillo_compresion_M4_1:1 | 1
AFR2-A200 | 23 | COMERCIAL/REFERENCIA | V09_Casquillo_compresion_M4_2 | 01_Giro_base:1+V09_Casquillo_compresion_M4_2:1 | 1
AFR2-A200 | 24 | COMERCIAL/REFERENCIA | V09_Casquillo_compresion_M4_3 | 01_Giro_base:1+V09_Casquillo_compresion_M4_3:1 | 1
AFR2-A200 | 25 | COMERCIAL/REFERENCIA | V09_Circlip_DIN471_10_REF | 01_Giro_base:1+V09_Circlip_DIN471_10_REF:1 | 1
AFR2-A200 | 26 | COMERCIAL/REFERENCIA | V09_M4_brida_0 | 01_Giro_base:1+V09_M4_brida_0:1 | 1
AFR2-A200 | 27 | COMERCIAL/REFERENCIA | V09_M4_brida_1 | 01_Giro_base:1+V09_M4_brida_1:1 | 1
AFR2-A200 | 28 | COMERCIAL/REFERENCIA | V09_M4_brida_2 | 01_Giro_base:1+V09_M4_brida_2:1 | 1
AFR2-A200 | 29 | COMERCIAL/REFERENCIA | V09_M4_brida_3 | 01_Giro_base:1+V09_M4_brida_3:1 | 1
AFR2-A200 | 30 | COMERCIAL/REFERENCIA | V09_Tuerca_brida_0 | 01_Giro_base:1+V09_Tuerca_brida_0:1 | 1
AFR2-A200 | 31 | COMERCIAL/REFERENCIA | V09_Tuerca_brida_1 | 01_Giro_base:1+V09_Tuerca_brida_1:1 | 1
AFR2-A200 | 32 | COMERCIAL/REFERENCIA | V09_Tuerca_brida_2 | 01_Giro_base:1+V09_Tuerca_brida_2:1 | 1
AFR2-A200 | 33 | COMERCIAL/REFERENCIA | V09_Tuerca_brida_3 | 01_Giro_base:1+V09_Tuerca_brida_3:1 | 1
AFR2-A200 | 34 | COMERCIAL/REFERENCIA | V17_625_entrada_J3_delantero | 01_Giro_base:1+V17_625_entrada_J3_delantero:2 | 1
AFR2-A200 | 35 | COMERCIAL/REFERENCIA | V17_625_entrada_J3_trasero | 01_Giro_base:1+V17_625_entrada_J3_trasero:2 | 1
AFR2-A200 | 36 | COMERCIAL/REFERENCIA | V17_Arandela_M4_J2_dorso_0 | 01_Giro_base:1+V17_Arandela_M4_J2_dorso_0:1 | 1
AFR2-A200 | 37 | COMERCIAL/REFERENCIA | V17_Arandela_M4_J2_dorso_0 | 01_Giro_base:1+V17_Arandela_M4_J2_dorso_0:5 | 1
AFR2-A200 | 38 | COMERCIAL/REFERENCIA | V17_Arandela_M4_J2_dorso_0 | 01_Giro_base:1+V17_Arandela_M4_J2_dorso_0:6 | 1
AFR2-A200 | 39 | COMERCIAL/REFERENCIA | V17_Arandela_M4_J2_dorso_0 | 01_Giro_base:1+V17_Arandela_M4_J2_dorso_0:7 | 1
AFR2-A200 | 40 | COMERCIAL/REFERENCIA | V17_Arandela_M4_J2_dorso_1 | 01_Giro_base:1+V17_Arandela_M4_J2_dorso_1:1 | 1
AFR2-A200 | 41 | COMERCIAL/REFERENCIA | V17_Arandela_M4_J2_dorso_1 | 01_Giro_base:1+V17_Arandela_M4_J2_dorso_1:5 | 1
AFR2-A200 | 42 | COMERCIAL/REFERENCIA | V17_Arandela_M4_J2_dorso_1 | 01_Giro_base:1+V17_Arandela_M4_J2_dorso_1:6 | 1
AFR2-A200 | 43 | COMERCIAL/REFERENCIA | V17_Arandela_M4_J2_dorso_1 | 01_Giro_base:1+V17_Arandela_M4_J2_dorso_1:7 | 1
AFR2-A200 | 44 | COMERCIAL/REFERENCIA | V17_Arandela_M4_J2_dorso_2 | 01_Giro_base:1+V17_Arandela_M4_J2_dorso_2:1 | 1
AFR2-A200 | 45 | COMERCIAL/REFERENCIA | V17_Arandela_M4_J2_dorso_2 | 01_Giro_base:1+V17_Arandela_M4_J2_dorso_2:5 | 1
AFR2-A200 | 46 | COMERCIAL/REFERENCIA | V17_Arandela_M4_J2_dorso_2 | 01_Giro_base:1+V17_Arandela_M4_J2_dorso_2:6 | 1
AFR2-A200 | 47 | COMERCIAL/REFERENCIA | V17_Arandela_M4_J2_dorso_2 | 01_Giro_base:1+V17_Arandela_M4_J2_dorso_2:7 | 1
AFR2-A200 | 48 | COMERCIAL/REFERENCIA | V17_Arandela_M4_J2_frente | 01_Giro_base:1+V17_Arandela_M4_J2_frente:1 | 1
AFR2-A200 | 49 | COMERCIAL/REFERENCIA | V17_Arandela_M4_J2_frente | 01_Giro_base:1+V17_Arandela_M4_J2_frente:5 | 1
AFR2-A200 | 50 | COMERCIAL/REFERENCIA | V17_Arandela_M4_J2_frente | 01_Giro_base:1+V17_Arandela_M4_J2_frente:6 | 1
AFR2-A200 | 51 | COMERCIAL/REFERENCIA | V17_Arandela_M4_J2_frente | 01_Giro_base:1+V17_Arandela_M4_J2_frente:7 | 1
AFR2-A200 | 52 | AFR2-P205 | V17_Carro_motor_apoyo_Al | 01_Giro_base:1+V17_Carro_motor_apoyo_Al:2 | 1
AFR2-A200 | 53 | AFR2-P225 | V17_Horn_STS3250_J1_adaptado | 01_Giro_base:1+V17_Horn_STS3250_J1_adaptado:1 | 1
AFR2-A200 | 54 | AFR2-P204 | V17_Housing_STS3250_y_apoyo625 | 01_Giro_base:1+V17_Housing_STS3250_y_apoyo625:2 | 1
AFR2-A200 | 55 | COMERCIAL/REFERENCIA | V17_M03_STS3250_remoto | 01_Giro_base:1+V17_M03_STS3250_remoto:2 | 1
AFR2-A200 | 56 | COMERCIAL/REFERENCIA | V17_M2_tapa625_-14 | 01_Giro_base:1+V17_M2_tapa625_-14:2 | 1
AFR2-A200 | 57 | COMERCIAL/REFERENCIA | V17_M2_tapa625_14 | 01_Giro_base:1+V17_M2_tapa625_14:2 | 1
AFR2-A200 | 58 | COMERCIAL/REFERENCIA | V17_M3_tapa_-37 mm_-105 mm | 01_Giro_base:1+V17_M3_tapa_-37 mm_-105 mm:2 | 1
AFR2-A200 | 59 | COMERCIAL/REFERENCIA | V17_M3_tapa_-37 mm_-80 mm | 01_Giro_base:1+V17_M3_tapa_-37 mm_-80 mm:2 | 1
AFR2-A200 | 60 | COMERCIAL/REFERENCIA | V17_M3_tapa_17 mm_-105 mm | 01_Giro_base:1+V17_M3_tapa_17 mm_-105 mm:2 | 1
AFR2-A200 | 61 | COMERCIAL/REFERENCIA | V17_M3_tapa_17 mm_-80 mm | 01_Giro_base:1+V17_M3_tapa_17 mm_-80 mm:2 | 1
AFR2-A200 | 62 | COMERCIAL/REFERENCIA | V17_M3x5_horn_J1_-1 | 01_Giro_base:1+V17_M3x5_horn_J1_-1:1 | 1
AFR2-A200 | 63 | COMERCIAL/REFERENCIA | V17_M3x5_horn_J1_-1 | 01_Giro_base:1+V17_M3x5_horn_J1_-1:2 | 1
AFR2-A200 | 64 | COMERCIAL/REFERENCIA | V17_M3x6_central_J1 | 01_Giro_base:1+V17_M3x6_central_J1:1 | 1
AFR2-A200 | 65 | COMERCIAL/REFERENCIA | V17_M4x25_J2_ISO7380 | 01_Giro_base:1+V17_M4x25_J2_ISO7380:1 | 1
AFR2-A200 | 66 | COMERCIAL/REFERENCIA | V17_M4x25_J2_ISO7380 | 01_Giro_base:1+V17_M4x25_J2_ISO7380:5 | 1
AFR2-A200 | 67 | COMERCIAL/REFERENCIA | V17_M4x25_J2_ISO7380 | 01_Giro_base:1+V17_M4x25_J2_ISO7380:6 | 1
AFR2-A200 | 68 | COMERCIAL/REFERENCIA | V17_M4x25_J2_ISO7380 | 01_Giro_base:1+V17_M4x25_J2_ISO7380:7 | 1
AFR2-A200 | 69 | AFR2-P218 | V17_Separador7_J2_Al | 01_Giro_base:1+V17_Separador7_J2_Al:1 | 1
AFR2-A200 | 70 | AFR2-P218 | V17_Separador7_J2_Al | 01_Giro_base:1+V17_Separador7_J2_Al:5 | 1
AFR2-A200 | 71 | AFR2-P218 | V17_Separador7_J2_Al | 01_Giro_base:1+V17_Separador7_J2_Al:6 | 1
AFR2-A200 | 72 | AFR2-P218 | V17_Separador7_J2_Al | 01_Giro_base:1+V17_Separador7_J2_Al:7 | 1
AFR2-A200 | 73 | AFR2-P207 | V17_Tapa625_entrada_trasera | 01_Giro_base:1+V17_Tapa625_entrada_trasera:2 | 1
AFR2-A200 | 74 | AFR2-P206 | V17_Tapa_housing_STS3250 | 01_Giro_base:1+V17_Tapa_housing_STS3250:2 | 1
AFR2-A200 | 75 | COMERCIAL/REFERENCIA | V17_Tuerca_M4_J2 | 01_Giro_base:1+V17_Tuerca_M4_J2:1 | 1
AFR2-A200 | 76 | COMERCIAL/REFERENCIA | V17_Tuerca_M4_J2 | 01_Giro_base:1+V17_Tuerca_M4_J2:5 | 1
AFR2-A200 | 77 | COMERCIAL/REFERENCIA | V17_Tuerca_M4_J2 | 01_Giro_base:1+V17_Tuerca_M4_J2:6 | 1
AFR2-A200 | 78 | COMERCIAL/REFERENCIA | V17_Tuerca_M4_J2 | 01_Giro_base:1+V17_Tuerca_M4_J2:7 | 1
AFR2-A200 | 79 | COMERCIAL/REFERENCIA | V17_Tuerca_tapa_-37 mm_-105 mm | 01_Giro_base:1+V17_Tuerca_tapa_-37 mm_-105 mm:2 | 1
AFR2-A200 | 80 | COMERCIAL/REFERENCIA | V17_Tuerca_tapa_-37 mm_-80 mm | 01_Giro_base:1+V17_Tuerca_tapa_-37 mm_-80 mm:2 | 1
AFR2-A200 | 81 | COMERCIAL/REFERENCIA | V17_Tuerca_tapa_17 mm_-105 mm | 01_Giro_base:1+V17_Tuerca_tapa_17 mm_-105 mm:2 | 1
AFR2-A200 | 82 | COMERCIAL/REFERENCIA | V17_Tuerca_tapa_17 mm_-80 mm | 01_Giro_base:1+V17_Tuerca_tapa_17 mm_-80 mm:2 | 1
AFR2-A200 | 83 | COMERCIAL/REFERENCIA | V17_Chaveta_entrada_2x2x9 | 09_Pinion_hombro:1+V17_Chaveta_entrada_2x2x9:2 | 1
AFR2-A200 | 84 | COMERCIAL/REFERENCIA | V17_Collar_entrada5 | 09_Pinion_hombro:1+V17_Collar_entrada5:2 | 1
AFR2-A200 | 85 | AFR2-P339 | V17_Eje_entrada_5mm | 09_Pinion_hombro:1+V17_Eje_entrada_5mm:2 | 1
AFR2-A200 | 86 | AFR2-P340 | V17_Horn_STS3250_J3 | 09_Pinion_hombro:1+V17_Horn_STS3250_J3:2 | 1
AFR2-A200 | 87 | COMERCIAL/REFERENCIA | V17_M3x6_horn_J3_0 | 09_Pinion_hombro:1+V17_M3x6_horn_J3_0:2 | 1
AFR2-A200 | 88 | COMERCIAL/REFERENCIA | V17_M3x6_horn_J3_1 | 09_Pinion_hombro:1+V17_M3x6_horn_J3_1:2 | 1
AFR2-A200 | 89 | COMERCIAL/REFERENCIA | V17_M3x6_horn_J3_2 | 09_Pinion_hombro:1+V17_M3x6_horn_J3_2:2 | 1
AFR2-A200 | 90 | COMERCIAL/REFERENCIA | V17_M3x6_horn_J3_3 | 09_Pinion_hombro:1+V17_M3x6_horn_J3_3:2 | 1
AFR2-A200 | 91 | COMERCIAL/REFERENCIA | V17_Pinon18_J2_Al2024 | 09_Pinion_hombro:1+V17_Pinon18_J2_Al2024:1 | 1
AFR2-A200 | 92 | COMERCIAL/REFERENCIA | V17_Prisionero_M2_J2 | 09_Pinion_hombro:1+V17_Prisionero_M2_J2:1 | 1
AFR2-A200 | 93 | COMERCIAL/REFERENCIA | V17_Prisionero_collar_entrada5 | 09_Pinion_hombro:1+V17_Prisionero_collar_entrada5:2 | 1
AFR2-A200 | 94 | AFR2-P350 | V17_Separador_J2_entrada_dorso | 09_Pinion_hombro:1+V17_Separador_J2_entrada_dorso:1 | 1
AFR2-A200 | 95 | AFR2-P349 | V17_Separador_J2_entrada_frente | 09_Pinion_hombro:1+V17_Separador_J2_entrada_frente:1 | 1
AFR2-A200 | 96 | COMERCIAL/REFERENCIA | V17_Tornillo_central_servo_J3 | 09_Pinion_hombro:1+V17_Tornillo_central_servo_J3:2 | 1
AFR2-A300 | 1 | AFR2-P333 | A05_Encastre_proximal_brazo_PETG | 02_Brazo_PVC:1+A05_Encastre_proximal_brazo_PETG:1 | 1
AFR2-A300 | 2 | COMERCIAL/REFERENCIA | A05_Encastre_proximal_brazo_PETG_Perno_M3_REF | 02_Brazo_PVC:1+A05_Encastre_proximal_brazo_PETG_Perno_M3_REF:1 | 1
AFR2-A300 | 3 | AFR2-P334 | A06_Encastre_distal_brazo_PETG | 02_Brazo_PVC:1+A06_Encastre_distal_brazo_PETG:1 | 1
AFR2-A300 | 4 | COMERCIAL/REFERENCIA | A06_Encastre_distal_brazo_PETG_Perno_M3_REF | 02_Brazo_PVC:1+A06_Encastre_distal_brazo_PETG_Perno_M3_REF:1 | 1
AFR2-A300 | 5 | AFR2-P301 | E01_Eje_hombro_8mm | 02_Brazo_PVC:1+E01_Eje_hombro_8mm:1 | 1
AFR2-A300 | 6 | AFR2-P302 | L01_PVC32_Corte_1 | 02_Brazo_PVC:1+L01_PVC32_Corte_1:1 | 1
AFR2-A300 | 7 | COMERCIAL/REFERENCIA | R03_608ZZ_Codo_-1 | 02_Brazo_PVC:1+R03_608ZZ_Codo_-1:1 | 1
AFR2-A300 | 8 | COMERCIAL/REFERENCIA | R03_608ZZ_Codo_1 | 02_Brazo_PVC:1+R03_608ZZ_Codo_1:1 | 1
AFR2-A300 | 9 | COMERCIAL/REFERENCIA | V03_Arandelas_y_tuerca_A05_Encastre_proximal_brazo_PETG | 02_Brazo_PVC:1+V03_Arandelas_y_tuerca_A05_Encastre_proximal_brazo_PETG:1 | 1
AFR2-A300 | 10 | COMERCIAL/REFERENCIA | V03_Arandelas_y_tuerca_A06_Encastre_distal_brazo_PETG | 02_Brazo_PVC:1+V03_Arandelas_y_tuerca_A06_Encastre_distal_brazo_PETG:1 | 1
AFR2-A300 | 11 | COMERCIAL/REFERENCIA | V03_Collar_8mm_retencion | 02_Brazo_PVC:1+V03_Collar_8mm_retencion:1 | 1
AFR2-A300 | 12 | COMERCIAL/REFERENCIA | V03_Inserto_M3_A06_Encastre_distal_brazo_PETG-1-1 | 02_Brazo_PVC:1+V03_Inserto_M3_A06_Encastre_distal_brazo_PETG-1-1:1 | 1
AFR2-A300 | 13 | COMERCIAL/REFERENCIA | V03_Inserto_M3_A06_Encastre_distal_brazo_PETG-11 | 02_Brazo_PVC:1+V03_Inserto_M3_A06_Encastre_distal_brazo_PETG-11:1 | 1
AFR2-A300 | 14 | COMERCIAL/REFERENCIA | V03_Inserto_M3_A06_Encastre_distal_brazo_PETG1-1 | 02_Brazo_PVC:1+V03_Inserto_M3_A06_Encastre_distal_brazo_PETG1-1:1 | 1
AFR2-A300 | 15 | COMERCIAL/REFERENCIA | V03_Inserto_M3_A06_Encastre_distal_brazo_PETG11 | 02_Brazo_PVC:1+V03_Inserto_M3_A06_Encastre_distal_brazo_PETG11:1 | 1
AFR2-A300 | 16 | COMERCIAL/REFERENCIA | V03_Prisionero_M3x5_collar | 02_Brazo_PVC:1+V03_Prisionero_M3x5_collar:1 | 1
AFR2-A300 | 17 | AFR2-P305 | V03_Separador_8mm_trasero | 02_Brazo_PVC:1+V03_Separador_8mm_trasero:1 | 1
AFR2-A300 | 18 | AFR2-P303 | V03_Tapa_608_A06_Encastre_distal_brazo_PETG_-1 | 02_Brazo_PVC:1+V03_Tapa_608_A06_Encastre_distal_brazo_PETG_-1:1 | 1
AFR2-A300 | 19 | AFR2-P304 | V03_Tapa_608_A06_Encastre_distal_brazo_PETG_1 | 02_Brazo_PVC:1+V03_Tapa_608_A06_Encastre_distal_brazo_PETG_1:1 | 1
AFR2-A300 | 20 | COMERCIAL/REFERENCIA | V03_Tornillo_tapa_A06_Encastre_distal_brazo_PETG-1-1 | 02_Brazo_PVC:1+V03_Tornillo_tapa_A06_Encastre_distal_brazo_PETG-1-1:1 | 1
AFR2-A300 | 21 | COMERCIAL/REFERENCIA | V03_Tornillo_tapa_A06_Encastre_distal_brazo_PETG-11 | 02_Brazo_PVC:1+V03_Tornillo_tapa_A06_Encastre_distal_brazo_PETG-11:1 | 1
AFR2-A300 | 22 | COMERCIAL/REFERENCIA | V03_Tornillo_tapa_A06_Encastre_distal_brazo_PETG1-1 | 02_Brazo_PVC:1+V03_Tornillo_tapa_A06_Encastre_distal_brazo_PETG1-1:1 | 1
AFR2-A300 | 23 | COMERCIAL/REFERENCIA | V03_Tornillo_tapa_A06_Encastre_distal_brazo_PETG11 | 02_Brazo_PVC:1+V03_Tornillo_tapa_A06_Encastre_distal_brazo_PETG11:1 | 1
AFR2-A300 | 24 | COMERCIAL/REFERENCIA | V17_625_entrada_J3_delantero | 02_Brazo_PVC:1+V17_625_entrada_J3_delantero:1 | 1
AFR2-A300 | 25 | COMERCIAL/REFERENCIA | V17_625_entrada_J3_trasero | 02_Brazo_PVC:1+V17_625_entrada_J3_trasero:1 | 1
AFR2-A300 | 26 | COMERCIAL/REFERENCIA | V17_Arandela_M3_J2_salida | 02_Brazo_PVC:1+V17_Arandela_M3_J2_salida:1 | 1
AFR2-A300 | 27 | COMERCIAL/REFERENCIA | V17_Arandela_anclaje_fijo_-29_externa | 02_Brazo_PVC:1+V17_Arandela_anclaje_fijo_-29_externa:1 | 1
AFR2-A300 | 28 | COMERCIAL/REFERENCIA | V17_Arandela_anclaje_fijo_-29_interna | 02_Brazo_PVC:1+V17_Arandela_anclaje_fijo_-29_interna:1 | 1
AFR2-A300 | 29 | COMERCIAL/REFERENCIA | V17_Arandela_anclaje_fijo_29_externa | 02_Brazo_PVC:1+V17_Arandela_anclaje_fijo_29_externa:1 | 1
AFR2-A300 | 30 | COMERCIAL/REFERENCIA | V17_Arandela_anclaje_fijo_29_interna | 02_Brazo_PVC:1+V17_Arandela_anclaje_fijo_29_interna:1 | 1
AFR2-A300 | 31 | COMERCIAL/REFERENCIA | V17_Arandela_carro_-17_-10_Exterior | 02_Brazo_PVC:1+V17_Arandela_carro_-17_-10_Exterior:1 | 1
AFR2-A300 | 32 | COMERCIAL/REFERENCIA | V17_Arandela_carro_-17_-10_Interior | 02_Brazo_PVC:1+V17_Arandela_carro_-17_-10_Interior:1 | 1
AFR2-A300 | 33 | COMERCIAL/REFERENCIA | V17_Arandela_carro_-17_10_Exterior | 02_Brazo_PVC:1+V17_Arandela_carro_-17_10_Exterior:1 | 1
AFR2-A300 | 34 | COMERCIAL/REFERENCIA | V17_Arandela_carro_-17_10_Interior | 02_Brazo_PVC:1+V17_Arandela_carro_-17_10_Interior:1 | 1
AFR2-A300 | 35 | COMERCIAL/REFERENCIA | V17_Arandela_carro_17_-10_Exterior | 02_Brazo_PVC:1+V17_Arandela_carro_17_-10_Exterior:1 | 1
AFR2-A300 | 36 | COMERCIAL/REFERENCIA | V17_Arandela_carro_17_-10_Interior | 02_Brazo_PVC:1+V17_Arandela_carro_17_-10_Interior:1 | 1
AFR2-A300 | 37 | COMERCIAL/REFERENCIA | V17_Arandela_carro_17_10_Exterior | 02_Brazo_PVC:1+V17_Arandela_carro_17_10_Exterior:1 | 1
AFR2-A300 | 38 | COMERCIAL/REFERENCIA | V17_Arandela_carro_17_10_Interior | 02_Brazo_PVC:1+V17_Arandela_carro_17_10_Interior:1 | 1
AFR2-A300 | 39 | AFR2-P205 | V17_Carro_motor_apoyo_Al | 02_Brazo_PVC:1+V17_Carro_motor_apoyo_Al:1 | 1
AFR2-A300 | 40 | COMERCIAL/REFERENCIA | V17_Chaveta_hombro_2x2x12 | 02_Brazo_PVC:1+V17_Chaveta_hombro_2x2x12:1 | 1
AFR2-A300 | 41 | COMERCIAL/REFERENCIA | V17_Correa_OMEGA_HP_3M_6 | 02_Brazo_PVC:1+V17_Correa_OMEGA_HP_3M_6:1 | 1
AFR2-A300 | 42 | AFR2-P204 | V17_Housing_STS3250_y_apoyo625 | 02_Brazo_PVC:1+V17_Housing_STS3250_y_apoyo625:1 | 1
AFR2-A300 | 43 | COMERCIAL/REFERENCIA | V17_M03_STS3250_remoto | 02_Brazo_PVC:1+V17_M03_STS3250_remoto:1 | 1
AFR2-A300 | 44 | COMERCIAL/REFERENCIA | V17_M2_tapa625_-14 | 02_Brazo_PVC:1+V17_M2_tapa625_-14:1 | 1
AFR2-A300 | 45 | COMERCIAL/REFERENCIA | V17_M2_tapa625_14 | 02_Brazo_PVC:1+V17_M2_tapa625_14:1 | 1
AFR2-A300 | 46 | COMERCIAL/REFERENCIA | V17_M3_tapa_-37 mm_-105 mm | 02_Brazo_PVC:1+V17_M3_tapa_-37 mm_-105 mm:1 | 1
AFR2-A300 | 47 | COMERCIAL/REFERENCIA | V17_M3_tapa_-37 mm_-80 mm | 02_Brazo_PVC:1+V17_M3_tapa_-37 mm_-80 mm:1 | 1
AFR2-A300 | 48 | COMERCIAL/REFERENCIA | V17_M3_tapa_17 mm_-105 mm | 02_Brazo_PVC:1+V17_M3_tapa_17 mm_-105 mm:1 | 1
AFR2-A300 | 49 | COMERCIAL/REFERENCIA | V17_M3_tapa_17 mm_-80 mm | 02_Brazo_PVC:1+V17_M3_tapa_17 mm_-80 mm:1 | 1
AFR2-A300 | 50 | COMERCIAL/REFERENCIA | V17_M3x6_J2_salida | 02_Brazo_PVC:1+V17_M3x6_J2_salida:1 | 1
AFR2-A300 | 51 | COMERCIAL/REFERENCIA | V17_M4_anclaje_fijo_-29 | 02_Brazo_PVC:1+V17_M4_anclaje_fijo_-29:1 | 1
AFR2-A300 | 52 | COMERCIAL/REFERENCIA | V17_M4_anclaje_fijo_29 | 02_Brazo_PVC:1+V17_M4_anclaje_fijo_29:1 | 1
AFR2-A300 | 53 | COMERCIAL/REFERENCIA | V17_M4_carro_-17_-10 | 02_Brazo_PVC:1+V17_M4_carro_-17_-10:1 | 1
AFR2-A300 | 54 | COMERCIAL/REFERENCIA | V17_M4_carro_-17_10 | 02_Brazo_PVC:1+V17_M4_carro_-17_10:1 | 1
AFR2-A300 | 55 | COMERCIAL/REFERENCIA | V17_M4_carro_17_-10 | 02_Brazo_PVC:1+V17_M4_carro_17_-10:1 | 1
AFR2-A300 | 56 | COMERCIAL/REFERENCIA | V17_M4_carro_17_10 | 02_Brazo_PVC:1+V17_M4_carro_17_10:1 | 1
AFR2-A300 | 57 | AFR2-P306 | V17_Placa_fija_tensor_Al | 02_Brazo_PVC:1+V17_Placa_fija_tensor_Al:1 | 1
AFR2-A300 | 58 | COMERCIAL/REFERENCIA | V17_Rueda72_J2_Al2024 | 02_Brazo_PVC:1+V17_Rueda72_J2_Al2024:1 | 1
AFR2-A300 | 59 | AFR2-P336 | V17_Separador8_J2_salida | 02_Brazo_PVC:1+V17_Separador8_J2_salida:1 | 1
AFR2-A300 | 60 | AFR2-P207 | V17_Tapa625_entrada_trasera | 02_Brazo_PVC:1+V17_Tapa625_entrada_trasera:1 | 1
AFR2-A300 | 61 | AFR2-P206 | V17_Tapa_housing_STS3250 | 02_Brazo_PVC:1+V17_Tapa_housing_STS3250:1 | 1
AFR2-A300 | 62 | COMERCIAL/REFERENCIA | V17_Tornillo_ajuste_M3x20 | 02_Brazo_PVC:1+V17_Tornillo_ajuste_M3x20:1 | 1
AFR2-A300 | 63 | COMERCIAL/REFERENCIA | V17_Tuerca_anclaje_fijo_-29 | 02_Brazo_PVC:1+V17_Tuerca_anclaje_fijo_-29:1 | 1
AFR2-A300 | 64 | COMERCIAL/REFERENCIA | V17_Tuerca_anclaje_fijo_29 | 02_Brazo_PVC:1+V17_Tuerca_anclaje_fijo_29:1 | 1
AFR2-A300 | 65 | COMERCIAL/REFERENCIA | V17_Tuerca_carro_-17_-10 | 02_Brazo_PVC:1+V17_Tuerca_carro_-17_-10:1 | 1
AFR2-A300 | 66 | COMERCIAL/REFERENCIA | V17_Tuerca_carro_-17_10 | 02_Brazo_PVC:1+V17_Tuerca_carro_-17_10:1 | 1
AFR2-A300 | 67 | COMERCIAL/REFERENCIA | V17_Tuerca_carro_17_-10 | 02_Brazo_PVC:1+V17_Tuerca_carro_17_-10:1 | 1
AFR2-A300 | 68 | COMERCIAL/REFERENCIA | V17_Tuerca_carro_17_10 | 02_Brazo_PVC:1+V17_Tuerca_carro_17_10:1 | 1
AFR2-A300 | 69 | COMERCIAL/REFERENCIA | V17_Tuerca_tapa_-37 mm_-105 mm | 02_Brazo_PVC:1+V17_Tuerca_tapa_-37 mm_-105 mm:1 | 1
AFR2-A300 | 70 | COMERCIAL/REFERENCIA | V17_Tuerca_tapa_-37 mm_-80 mm | 02_Brazo_PVC:1+V17_Tuerca_tapa_-37 mm_-80 mm:1 | 1
AFR2-A300 | 71 | COMERCIAL/REFERENCIA | V17_Tuerca_tapa_17 mm_-105 mm | 02_Brazo_PVC:1+V17_Tuerca_tapa_17 mm_-105 mm:1 | 1
AFR2-A300 | 72 | COMERCIAL/REFERENCIA | V17_Tuerca_tapa_17 mm_-80 mm | 02_Brazo_PVC:1+V17_Tuerca_tapa_17 mm_-80 mm:1 | 1
AFR2-A300 | 73 | COMERCIAL/REFERENCIA | V17_Tuerca_tensor_M3 | 02_Brazo_PVC:1+V17_Tuerca_tensor_M3:1 | 1
AFR2-A300 | 74 | COMERCIAL/REFERENCIA | V17_Chaveta_entrada_2x2x9 | 12_Polea_entrada_J3:1+V17_Chaveta_entrada_2x2x9:1 | 1
AFR2-A300 | 75 | COMERCIAL/REFERENCIA | V17_Collar_entrada5 | 12_Polea_entrada_J3:1+V17_Collar_entrada5:1 | 1
AFR2-A300 | 76 | AFR2-P339 | V17_Eje_entrada_5mm | 12_Polea_entrada_J3:1+V17_Eje_entrada_5mm:1 | 1
AFR2-A300 | 77 | AFR2-P340 | V17_Horn_STS3250_J3 | 12_Polea_entrada_J3:1+V17_Horn_STS3250_J3:1 | 1
AFR2-A300 | 78 | COMERCIAL/REFERENCIA | V17_M3x6_horn_J3_0 | 12_Polea_entrada_J3:1+V17_M3x6_horn_J3_0:1 | 1
AFR2-A300 | 79 | COMERCIAL/REFERENCIA | V17_M3x6_horn_J3_1 | 12_Polea_entrada_J3:1+V17_M3x6_horn_J3_1:1 | 1
AFR2-A300 | 80 | COMERCIAL/REFERENCIA | V17_M3x6_horn_J3_2 | 12_Polea_entrada_J3:1+V17_M3x6_horn_J3_2:1 | 1
AFR2-A300 | 81 | COMERCIAL/REFERENCIA | V17_M3x6_horn_J3_3 | 12_Polea_entrada_J3:1+V17_M3x6_horn_J3_3:1 | 1
AFR2-A300 | 82 | COMERCIAL/REFERENCIA | V17_Polea_20T_J3 | 12_Polea_entrada_J3:1+V17_Polea_20T_J3:1 | 1
AFR2-A300 | 83 | COMERCIAL/REFERENCIA | V17_Prisionero_collar_entrada5 | 12_Polea_entrada_J3:1+V17_Prisionero_collar_entrada5:1 | 1
AFR2-A300 | 84 | AFR2-P353 | V17_Separador_entrada_delantero | 12_Polea_entrada_J3:1+V17_Separador_entrada_delantero:1 | 1
AFR2-A300 | 85 | AFR2-P352 | V17_Separador_entrada_trasero | 12_Polea_entrada_J3:1+V17_Separador_entrada_trasero:1 | 1
AFR2-A300 | 86 | COMERCIAL/REFERENCIA | V17_Tornillo_central_servo_J3 | 12_Polea_entrada_J3:1+V17_Tornillo_central_servo_J3:1 | 1
AFR2-A400 | 1 | AFR2-P430 | A11_Encastre_proximal_antebrazo_PETG | 03_Antebrazo_PVC:1+A11_Encastre_proximal_antebrazo_PETG:1 | 1
AFR2-A400 | 2 | COMERCIAL/REFERENCIA | A11_Encastre_proximal_antebrazo_PETG_Perno_M3_REF | 03_Antebrazo_PVC:1+A11_Encastre_proximal_antebrazo_PETG_Perno_M3_REF:1 | 1
AFR2-A400 | 3 | AFR2-P422 | A12_Encastre_distal_antebrazo_PETG | 03_Antebrazo_PVC:1+A12_Encastre_distal_antebrazo_PETG:1 | 1
AFR2-A400 | 4 | COMERCIAL/REFERENCIA | A12_Encastre_distal_antebrazo_PETG_Perno_M3_REF | 03_Antebrazo_PVC:1+A12_Encastre_distal_antebrazo_PETG_Perno_M3_REF:1 | 1
AFR2-A400 | 5 | AFR2-P421 | L02_PVC32_Corte_2 | 03_Antebrazo_PVC:1+L02_PVC32_Corte_2:1 | 1
AFR2-A400 | 6 | AFR2-P423 | V02_E02_Eje_y_brida_codo | 03_Antebrazo_PVC:1+V02_E02_Eje_y_brida_codo:1 | 1
AFR2-A400 | 7 | COMERCIAL/REFERENCIA | V02_R04_608_J4 | 03_Antebrazo_PVC:1+V02_R04_608_J4:1 | 1
AFR2-A400 | 8 | COMERCIAL/REFERENCIA | V03_Arandelas_y_tuerca_A11_Encastre_proximal_antebrazo_PETG | 03_Antebrazo_PVC:1+V03_Arandelas_y_tuerca_A11_Encastre_proximal_antebrazo_PETG:1 | 1
AFR2-A400 | 9 | COMERCIAL/REFERENCIA | V03_Arandelas_y_tuerca_A12_Encastre_distal_antebrazo_PETG | 03_Antebrazo_PVC:1+V03_Arandelas_y_tuerca_A12_Encastre_distal_antebrazo_PETG:1 | 1
AFR2-A400 | 10 | COMERCIAL/REFERENCIA | V03_Inserto_M3_J4_-1 | 03_Antebrazo_PVC:1+V03_Inserto_M3_J4_-1:1 | 1
AFR2-A400 | 11 | COMERCIAL/REFERENCIA | V03_Inserto_M3_J4_1 | 03_Antebrazo_PVC:1+V03_Inserto_M3_J4_1:1 | 1
AFR2-A400 | 12 | COMERCIAL/REFERENCIA | V03_R04_608_J4_inferior | 03_Antebrazo_PVC:1+V03_R04_608_J4_inferior:1 | 1
AFR2-A400 | 13 | AFR2-P425 | V03_Separador_8mm_delantero (1) | 03_Antebrazo_PVC:1+V03_Separador_8mm_delantero (1):1 | 1
AFR2-A400 | 14 | AFR2-P424 | V03_Tapa_608_J4 | 03_Antebrazo_PVC:1+V03_Tapa_608_J4:1 | 1
AFR2-A400 | 15 | COMERCIAL/REFERENCIA | V03_Tornillo_tapa_J4_-1 | 03_Antebrazo_PVC:1+V03_Tornillo_tapa_J4_-1:1 | 1
AFR2-A400 | 16 | COMERCIAL/REFERENCIA | V03_Tornillo_tapa_J4_1 | 03_Antebrazo_PVC:1+V03_Tornillo_tapa_J4_1:1 | 1
AFR2-A400 | 17 | COMERCIAL/REFERENCIA | V17_Arandela_M3_J4_0 | 03_Antebrazo_PVC:1+V17_Arandela_M3_J4_0:1 | 1
AFR2-A400 | 18 | COMERCIAL/REFERENCIA | V17_Arandela_M3_J4_0 | 03_Antebrazo_PVC:1+V17_Arandela_M3_J4_0:2 | 1
AFR2-A400 | 19 | COMERCIAL/REFERENCIA | V17_Arandela_M3_J4_0 | 03_Antebrazo_PVC:1+V17_Arandela_M3_J4_0:3 | 1
AFR2-A400 | 20 | COMERCIAL/REFERENCIA | V17_Arandela_M3_J4_0 | 03_Antebrazo_PVC:1+V17_Arandela_M3_J4_0:4 | 1
AFR2-A400 | 21 | COMERCIAL/REFERENCIA | V17_Chaveta_2x2x15 | 03_Antebrazo_PVC:1+V17_Chaveta_2x2x15:1 | 1
AFR2-A400 | 22 | COMERCIAL/REFERENCIA | V17_Collar_retencion_codo | 03_Antebrazo_PVC:1+V17_Collar_retencion_codo:1 | 1
AFR2-A400 | 23 | COMERCIAL/REFERENCIA | V17_M03_STS3250_remoto | 03_Antebrazo_PVC:1+V17_M03_STS3250_remoto:4 | 1
AFR2-A400 | 24 | COMERCIAL/REFERENCIA | V17_M3x45_tapa_J4_0 | 03_Antebrazo_PVC:1+V17_M3x45_tapa_J4_0:1 | 1
AFR2-A400 | 25 | COMERCIAL/REFERENCIA | V17_M3x45_tapa_J4_0 | 03_Antebrazo_PVC:1+V17_M3x45_tapa_J4_0:2 | 1
AFR2-A400 | 26 | COMERCIAL/REFERENCIA | V17_M3x45_tapa_J4_0 | 03_Antebrazo_PVC:1+V17_M3x45_tapa_J4_0:3 | 1
AFR2-A400 | 27 | COMERCIAL/REFERENCIA | V17_M3x45_tapa_J4_0 | 03_Antebrazo_PVC:1+V17_M3x45_tapa_J4_0:4 | 1
AFR2-A400 | 28 | COMERCIAL/REFERENCIA | V17_Polea_50T_J3 | 03_Antebrazo_PVC:1+V17_Polea_50T_J3:1 | 1
AFR2-A400 | 29 | COMERCIAL/REFERENCIA | V17_Prisionero_collar_codo | 03_Antebrazo_PVC:1+V17_Prisionero_collar_codo:1 | 1
AFR2-A400 | 30 | AFR2-P427 | V17_Separador_codo_trasero | 03_Antebrazo_PVC:1+V17_Separador_codo_trasero:1 | 1
AFR2-A400 | 31 | AFR2-P431 | V17_Tapa_STS3250_J4 | 03_Antebrazo_PVC:1+V17_Tapa_STS3250_J4:1 | 1
AFR2-A400 | 32 | COMERCIAL/REFERENCIA | V17_Tuerca_M3_J4_0 | 03_Antebrazo_PVC:1+V17_Tuerca_M3_J4_0:1 | 1
AFR2-A400 | 33 | COMERCIAL/REFERENCIA | V17_Tuerca_M3_J4_0 | 03_Antebrazo_PVC:1+V17_Tuerca_M3_J4_0:2 | 1
AFR2-A400 | 34 | COMERCIAL/REFERENCIA | V17_Tuerca_M3_J4_0 | 03_Antebrazo_PVC:1+V17_Tuerca_M3_J4_0:3 | 1
AFR2-A400 | 35 | COMERCIAL/REFERENCIA | V17_Tuerca_M3_J4_0 | 03_Antebrazo_PVC:1+V17_Tuerca_M3_J4_0:4 | 1
AFR2-A400 | 36 | AFR2-P435 | V02_A15_Horquilla_J5_PETG | 04_Giro_muneca:1+V02_A15_Horquilla_J5_PETG:1 | 1
AFR2-A400 | 37 | AFR2-P436 | V02_E03_Eje_J4 | 04_Giro_muneca:1+V02_E03_Eje_J4:1 | 1
AFR2-A400 | 38 | COMERCIAL/REFERENCIA | V02_R05_625_-1 | 04_Giro_muneca:1+V02_R05_625_-1:1 | 1
AFR2-A400 | 39 | COMERCIAL/REFERENCIA | V02_R05_625_1 | 04_Giro_muneca:1+V02_R05_625_1:1 | 1
AFR2-A400 | 40 | COMERCIAL/REFERENCIA | V03_E03_Retencion_superior_J4 | 04_Giro_muneca:1+V03_E03_Retencion_superior_J4:1 | 1
AFR2-A400 | 41 | COMERCIAL/REFERENCIA | V03_Inserto_M3_V02_A15_Horquilla_J5_PETG-1-1 | 04_Giro_muneca:1+V03_Inserto_M3_V02_A15_Horquilla_J5_PETG-1-1:1 | 1
AFR2-A400 | 42 | COMERCIAL/REFERENCIA | V03_Inserto_M3_V02_A15_Horquilla_J5_PETG-11 | 04_Giro_muneca:1+V03_Inserto_M3_V02_A15_Horquilla_J5_PETG-11:1 | 1
AFR2-A400 | 43 | COMERCIAL/REFERENCIA | V03_Inserto_M3_V02_A15_Horquilla_J5_PETG1-1 | 04_Giro_muneca:1+V03_Inserto_M3_V02_A15_Horquilla_J5_PETG1-1:1 | 1
AFR2-A400 | 44 | COMERCIAL/REFERENCIA | V03_Inserto_M3_V02_A15_Horquilla_J5_PETG11 | 04_Giro_muneca:1+V03_Inserto_M3_V02_A15_Horquilla_J5_PETG11:1 | 1
AFR2-A400 | 45 | AFR2-P439 | V03_Separador_axial_J4 | 04_Giro_muneca:1+V03_Separador_axial_J4:1 | 1
AFR2-A400 | 46 | AFR2-P437 | V03_Tapa_625_V02_A15_Horquilla_J5_PETG_-1 | 04_Giro_muneca:1+V03_Tapa_625_V02_A15_Horquilla_J5_PETG_-1:1 | 1
AFR2-A400 | 47 | AFR2-P438 | V03_Tapa_625_V02_A15_Horquilla_J5_PETG_1 | 04_Giro_muneca:1+V03_Tapa_625_V02_A15_Horquilla_J5_PETG_1:1 | 1
AFR2-A400 | 48 | COMERCIAL/REFERENCIA | V03_Tornillo_axial_J4 | 04_Giro_muneca:1+V03_Tornillo_axial_J4:1 | 1
AFR2-A400 | 49 | COMERCIAL/REFERENCIA | V03_Tornillo_tapa_V02_A15_Horquilla_J5_PETG-1-1 | 04_Giro_muneca:1+V03_Tornillo_tapa_V02_A15_Horquilla_J5_PETG-1-1:1 | 1
AFR2-A400 | 50 | COMERCIAL/REFERENCIA | V03_Tornillo_tapa_V02_A15_Horquilla_J5_PETG-11 | 04_Giro_muneca:1+V03_Tornillo_tapa_V02_A15_Horquilla_J5_PETG-11:1 | 1
AFR2-A400 | 51 | COMERCIAL/REFERENCIA | V03_Tornillo_tapa_V02_A15_Horquilla_J5_PETG1-1 | 04_Giro_muneca:1+V03_Tornillo_tapa_V02_A15_Horquilla_J5_PETG1-1:1 | 1
AFR2-A400 | 52 | COMERCIAL/REFERENCIA | V03_Tornillo_tapa_V02_A15_Horquilla_J5_PETG11 | 04_Giro_muneca:1+V03_Tornillo_tapa_V02_A15_Horquilla_J5_PETG11:1 | 1
AFR2-A400 | 53 | COMERCIAL/REFERENCIA | V17_Arandela_M3_J5_0 | 04_Giro_muneca:1+V17_Arandela_M3_J5_0:1 | 1
AFR2-A400 | 54 | COMERCIAL/REFERENCIA | V17_Arandela_M3_J5_1 | 04_Giro_muneca:1+V17_Arandela_M3_J5_1:1 | 1
AFR2-A400 | 55 | COMERCIAL/REFERENCIA | V17_Arandela_M3_J5_2 | 04_Giro_muneca:1+V17_Arandela_M3_J5_2:1 | 1
AFR2-A400 | 56 | COMERCIAL/REFERENCIA | V17_Arandela_M3_J5_3 | 04_Giro_muneca:1+V17_Arandela_M3_J5_3:1 | 1
AFR2-A400 | 57 | COMERCIAL/REFERENCIA | V17_M03_STS3250_remoto | 04_Giro_muneca:1+V17_M03_STS3250_remoto:3 | 1
AFR2-A400 | 58 | COMERCIAL/REFERENCIA | V17_M3x35_tapa_J5_0 | 04_Giro_muneca:1+V17_M3x35_tapa_J5_0:1 | 1
AFR2-A400 | 59 | COMERCIAL/REFERENCIA | V17_M3x35_tapa_J5_1 | 04_Giro_muneca:1+V17_M3x35_tapa_J5_1:1 | 1
AFR2-A400 | 60 | COMERCIAL/REFERENCIA | V17_M3x35_tapa_J5_2 | 04_Giro_muneca:1+V17_M3x35_tapa_J5_2:1 | 1
AFR2-A400 | 61 | COMERCIAL/REFERENCIA | V17_M3x35_tapa_J5_3 | 04_Giro_muneca:1+V17_M3x35_tapa_J5_3:1 | 1
AFR2-A400 | 62 | AFR2-P440 | V17_Tapa_STS3250_J5 | 04_Giro_muneca:1+V17_Tapa_STS3250_J5:1 | 1
AFR2-A400 | 63 | COMERCIAL/REFERENCIA | V17_Tuerca_M3_J5_0 | 04_Giro_muneca:1+V17_Tuerca_M3_J5_0:1 | 1
AFR2-A400 | 64 | COMERCIAL/REFERENCIA | V17_Tuerca_M3_J5_1 | 04_Giro_muneca:1+V17_Tuerca_M3_J5_1:1 | 1
AFR2-A400 | 65 | COMERCIAL/REFERENCIA | V17_Tuerca_M3_J5_2 | 04_Giro_muneca:1+V17_Tuerca_M3_J5_2:1 | 1
AFR2-A400 | 66 | COMERCIAL/REFERENCIA | V17_Tuerca_M3_J5_3 | 04_Giro_muneca:1+V17_Tuerca_M3_J5_3:1 | 1
AFR2-A400 | 67 | AFR2-P453 | V02_Pinon24_J4 | 11_Pinion_J4:1+V02_Pinon24_J4:1 | 1
AFR2-A400 | 68 | AFR2-P340 | V17_Horn_STS3250_J3 | 11_Pinion_J4:1+V17_Horn_STS3250_J3:4 | 1
AFR2-A400 | 69 | COMERCIAL/REFERENCIA | V17_M3x6_central_J4 | 11_Pinion_J4:1+V17_M3x6_central_J4:1 | 1
AFR2-A400 | 70 | COMERCIAL/REFERENCIA | V17_M3x8_horn_J4_0 | 11_Pinion_J4:1+V17_M3x8_horn_J4_0:1 | 1
AFR2-A400 | 71 | COMERCIAL/REFERENCIA | V17_M3x8_horn_J4_0 | 11_Pinion_J4:1+V17_M3x8_horn_J4_0:2 | 1
AFR2-A400 | 72 | COMERCIAL/REFERENCIA | V17_M3x8_horn_J4_0 | 11_Pinion_J4:1+V17_M3x8_horn_J4_0:3 | 1
AFR2-A400 | 73 | COMERCIAL/REFERENCIA | V17_M3x8_horn_J4_0 | 11_Pinion_J4:1+V17_M3x8_horn_J4_0:4 | 1
AFR2-A400 | 74 | AFR2-P454 | V17_Separador_horn_J4 | 11_Pinion_J4:1+V17_Separador_horn_J4:1 | 1
AFR2-A500 | 1 | AFR2-P501 | V02_A18_Nucleo_J5_y_columna_J6 | 05_Inclinacion_muneca:1+V02_A18_Nucleo_J5_y_columna_J6:1 | 1
AFR2-A500 | 2 | AFR2-P504 | V02_E04_Eje_y_brida_J5 | 05_Inclinacion_muneca:1+V02_E04_Eje_y_brida_J5:1 | 1
AFR2-A500 | 3 | COMERCIAL/REFERENCIA | V02_M06_MG90S_J6 | 05_Inclinacion_muneca:1+V02_M06_MG90S_J6:1 | 1
AFR2-A500 | 4 | COMERCIAL/REFERENCIA | V02_R06_625_J6 | 05_Inclinacion_muneca:1+V02_R06_625_J6:1 | 1
AFR2-A500 | 5 | COMERCIAL/REFERENCIA | V03_Arandela_trasera_J5 | 05_Inclinacion_muneca:1+V03_Arandela_trasera_J5:1 | 1
AFR2-A500 | 6 | COMERCIAL/REFERENCIA | V03_Inserto_M2_J6_-1 | 05_Inclinacion_muneca:1+V03_Inserto_M2_J6_-1:1 | 1
AFR2-A500 | 7 | COMERCIAL/REFERENCIA | V03_Inserto_M2_J6_1 | 05_Inclinacion_muneca:1+V03_Inserto_M2_J6_1:1 | 1
AFR2-A500 | 8 | COMERCIAL/REFERENCIA | V03_R06_625_J6_inferior | 05_Inclinacion_muneca:1+V03_R06_625_J6_inferior:1 | 1
AFR2-A500 | 9 | AFR2-P505 | V03_Separador_axial_J5 | 05_Inclinacion_muneca:1+V03_Separador_axial_J5:1 | 1
AFR2-A500 | 10 | AFR2-P506 | V03_Separador_trasero_J5 | 05_Inclinacion_muneca:1+V03_Separador_trasero_J5:1 | 1
AFR2-A500 | 11 | AFR2-P502 | V03_Tapa_625_J6 | 05_Inclinacion_muneca:1+V03_Tapa_625_J6:1 | 1
AFR2-A500 | 12 | COMERCIAL/REFERENCIA | V03_Tornillo_axial_trasero_J5 | 05_Inclinacion_muneca:1+V03_Tornillo_axial_trasero_J5:1 | 1
AFR2-A500 | 13 | COMERCIAL/REFERENCIA | V03_Tornillo_original_horn_V02_M05_MG946_J5 | 05_Inclinacion_muneca:1+V03_Tornillo_original_horn_V02_M05_MG946_J5:1 | 1
AFR2-A500 | 14 | COMERCIAL/REFERENCIA | V03_Tornillo_tapa_J6_-1 | 05_Inclinacion_muneca:1+V03_Tornillo_tapa_J6_-1:1 | 1
AFR2-A500 | 15 | COMERCIAL/REFERENCIA | V03_Tornillo_tapa_J6_1 | 05_Inclinacion_muneca:1+V03_Tornillo_tapa_J6_1:1 | 1
AFR2-A500 | 16 | AFR2-P340 | V17_Horn_STS3250_J3 | 05_Inclinacion_muneca:1+V17_Horn_STS3250_J3:3 | 1
AFR2-A500 | 17 | COMERCIAL/REFERENCIA | V17_M2x35_cilindrico_J6_0 | 05_Inclinacion_muneca:1+V17_M2x35_cilindrico_J6_0:1 | 1
AFR2-A500 | 18 | COMERCIAL/REFERENCIA | V17_M2x35_cilindrico_J6_1 | 05_Inclinacion_muneca:1+V17_M2x35_cilindrico_J6_1:1 | 1
AFR2-A500 | 19 | COMERCIAL/REFERENCIA | V17_M2x35_cilindrico_J6_2 | 05_Inclinacion_muneca:1+V17_M2x35_cilindrico_J6_2:1 | 1
AFR2-A500 | 20 | COMERCIAL/REFERENCIA | V17_M2x35_cilindrico_J6_3 | 05_Inclinacion_muneca:1+V17_M2x35_cilindrico_J6_3:1 | 1
AFR2-A500 | 21 | COMERCIAL/REFERENCIA | V17_M3x6_ISO10642_horn_J5_0 | 05_Inclinacion_muneca:1+V17_M3x6_ISO10642_horn_J5_0:1 | 1
AFR2-A500 | 22 | COMERCIAL/REFERENCIA | V17_M3x6_ISO10642_horn_J5_1 | 05_Inclinacion_muneca:1+V17_M3x6_ISO10642_horn_J5_1:1 | 1
AFR2-A500 | 23 | COMERCIAL/REFERENCIA | V17_M3x6_ISO10642_horn_J5_2 | 05_Inclinacion_muneca:1+V17_M3x6_ISO10642_horn_J5_2:1 | 1
AFR2-A500 | 24 | COMERCIAL/REFERENCIA | V17_M3x6_ISO10642_horn_J5_3 | 05_Inclinacion_muneca:1+V17_M3x6_ISO10642_horn_J5_3:1 | 1
AFR2-A500 | 25 | AFR2-P503 | V17_Tapa_STS3032_J6 | 05_Inclinacion_muneca:1+V17_Tapa_STS3032_J6:1 | 1
AFR2-A500 | 26 | COMERCIAL/REFERENCIA | V17_Tuerca_M2_J6_0 | 05_Inclinacion_muneca:1+V17_Tuerca_M2_J6_0:1 | 1
AFR2-A500 | 27 | COMERCIAL/REFERENCIA | V17_Tuerca_M2_J6_1 | 05_Inclinacion_muneca:1+V17_Tuerca_M2_J6_1:1 | 1
AFR2-A500 | 28 | COMERCIAL/REFERENCIA | V17_Tuerca_M2_J6_2 | 05_Inclinacion_muneca:1+V17_Tuerca_M2_J6_2:1 | 1
AFR2-A500 | 29 | COMERCIAL/REFERENCIA | V17_Tuerca_M2_J6_3 | 05_Inclinacion_muneca:1+V17_Tuerca_M2_J6_3:1 | 1
AFR2-A600 | 1 | AFR2-P602 | V02_A20_Bastidor_pinza | 06_Herramienta:1+V02_A20_Bastidor_pinza:1 | 1
AFR2-A600 | 2 | AFR2-P601 | V02_E05_Acople_J6 | 06_Herramienta:1+V02_E05_Acople_J6:1 | 1
AFR2-A600 | 3 | COMERCIAL/REFERENCIA | V02_M07_MG90S_Pinza | 06_Herramienta:1+V02_M07_MG90S_Pinza:1 | 1
AFR2-A600 | 4 | COMERCIAL/REFERENCIA | V03_Prisionero_J6_M2_5x12_REF | 06_Herramienta:1+V03_Prisionero_J6_M2_5x12_REF:1 | 1
AFR2-A600 | 5 | AFR2-P604 | V03_Separador_axial_J6 | 06_Herramienta:1+V03_Separador_axial_J6:1 | 1
AFR2-A600 | 6 | AFR2-P603 | V03_Separador_medio_J6 | 06_Herramienta:1+V03_Separador_medio_J6:1 | 1
AFR2-A600 | 7 | AFR2-P606 | V17_Horn_STS3032_J6 | 06_Herramienta:1+V17_Horn_STS3032_J6:1 | 1
AFR2-A600 | 8 | COMERCIAL/REFERENCIA | V17_M2x35_cilindrico_J7_0 | 06_Herramienta:1+V17_M2x35_cilindrico_J7_0:1 | 1
AFR2-A600 | 9 | COMERCIAL/REFERENCIA | V17_M2x35_cilindrico_J7_1 | 06_Herramienta:1+V17_M2x35_cilindrico_J7_1:1 | 1
AFR2-A600 | 10 | COMERCIAL/REFERENCIA | V17_M2x35_cilindrico_J7_2 | 06_Herramienta:1+V17_M2x35_cilindrico_J7_2:1 | 1
AFR2-A600 | 11 | COMERCIAL/REFERENCIA | V17_M2x35_cilindrico_J7_3 | 06_Herramienta:1+V17_M2x35_cilindrico_J7_3:1 | 1
AFR2-A600 | 12 | COMERCIAL/REFERENCIA | V17_M2x4_avellanado_horn_J6_0 | 06_Herramienta:1+V17_M2x4_avellanado_horn_J6_0:1 | 1
AFR2-A600 | 13 | COMERCIAL/REFERENCIA | V17_M2x4_avellanado_horn_J6_1 | 06_Herramienta:1+V17_M2x4_avellanado_horn_J6_1:1 | 1
AFR2-A600 | 14 | AFR2-P605 | V17_Tapa_STS3032_J7 | 06_Herramienta:1+V17_Tapa_STS3032_J7:1 | 1
AFR2-A600 | 15 | COMERCIAL/REFERENCIA | V17_Tornillo_original_M2_3_J6 | 06_Herramienta:1+V17_Tornillo_original_M2_3_J6:1 | 1
AFR2-A600 | 16 | COMERCIAL/REFERENCIA | V17_Tuerca_M2_J7_0 | 06_Herramienta:1+V17_Tuerca_M2_J7_0:1 | 1
AFR2-A600 | 17 | COMERCIAL/REFERENCIA | V17_Tuerca_M2_J7_1 | 06_Herramienta:1+V17_Tuerca_M2_J7_1:1 | 1
AFR2-A600 | 18 | COMERCIAL/REFERENCIA | V17_Tuerca_M2_J7_2 | 06_Herramienta:1+V17_Tuerca_M2_J7_2:1 | 1
AFR2-A600 | 19 | COMERCIAL/REFERENCIA | V17_Tuerca_M2_J7_3 | 06_Herramienta:1+V17_Tuerca_M2_J7_3:1 | 1
AFR2-A600 | 20 | COMERCIAL/REFERENCIA | V02_Almohadilla_-1 | 07_Mandibula_izquierda:1+V02_Almohadilla_-1:1 | 1
AFR2-A600 | 21 | AFR2-P618 | V02_Mandibula_-1 | 07_Mandibula_izquierda:1+V02_Mandibula_-1:1 | 1
AFR2-A600 | 22 | COMERCIAL/REFERENCIA | V02_Almohadilla_1 | 08_Mandibula_derecha:1+V02_Almohadilla_1:1 | 1
AFR2-A600 | 23 | AFR2-P619 | V02_Mandibula_1 | 08_Mandibula_derecha:1+V02_Mandibula_1:1 | 1
AFR2-A600 | 24 | AFR2-P620 | V02_Pinon24_Pinza | 10_Pinion_pinza:1+V02_Pinon24_Pinza:1 | 1
AFR2-A600 | 25 | AFR2-P621 | V17_Horn_STS3032_J7 | 10_Pinion_pinza:1+V17_Horn_STS3032_J7:1 | 1
AFR2-A600 | 26 | COMERCIAL/REFERENCIA | V17_Tornillo_M2x6_union_horn_J7-1 | 10_Pinion_pinza:1+V17_Tornillo_M2x6_union_horn_J7-1:1 | 1
AFR2-A600 | 27 | COMERCIAL/REFERENCIA | V17_Tornillo_M2x6_union_horn_J71 | 10_Pinion_pinza:1+V17_Tornillo_M2x6_union_horn_J71:1 | 1
AFR2-A600 | 28 | COMERCIAL/REFERENCIA | V17_Tornillo_original_M2_3_J7 | 10_Pinion_pinza:1+V17_Tornillo_original_M2_3_J7:1 | 1
