kobachajchir/ProyectoRobotica2/AutoFinalRobo2-CAD/mecanica/sensor-bateria/referencias/referencia_componentes.png

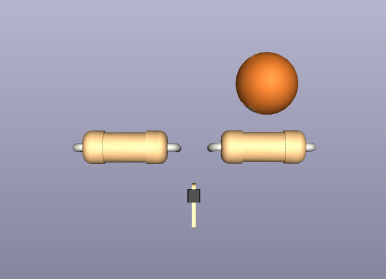
AutoFinalRobo2-CAD/mecanica/sensor-bateria/referencias/referencia_componentes.png
