kobachajchir/ProyectoRobotica2/AutoFinalRobo2-Contracts/.agents/skills/oled128-ui-design/assets/component-atlas.png

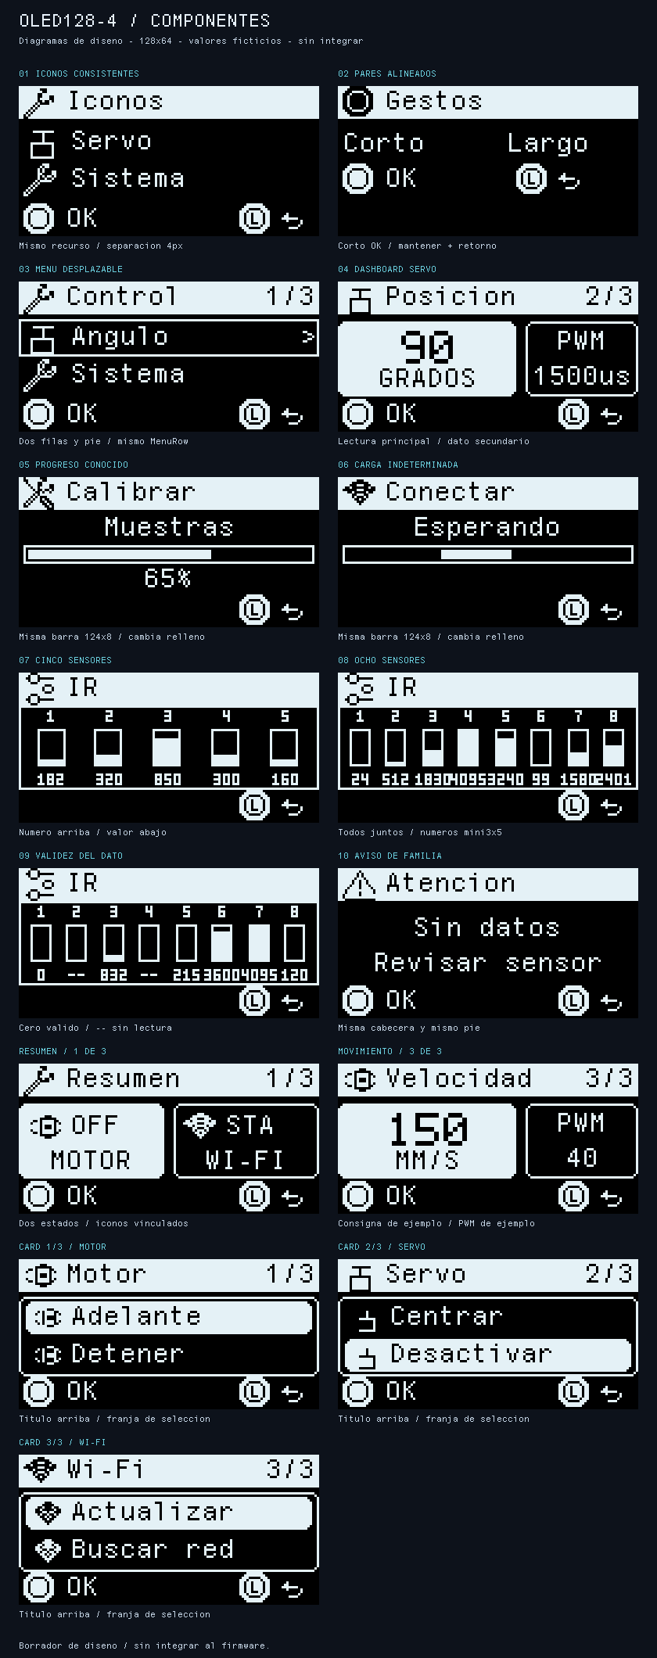
AutoFinalRobo2-Contracts/.agents/skills/oled128-ui-design/assets/component-atlas.png
