kobachajchir/ProyectoRobotica2/CADS/Chassis/right mecanum wheel.SLDASM

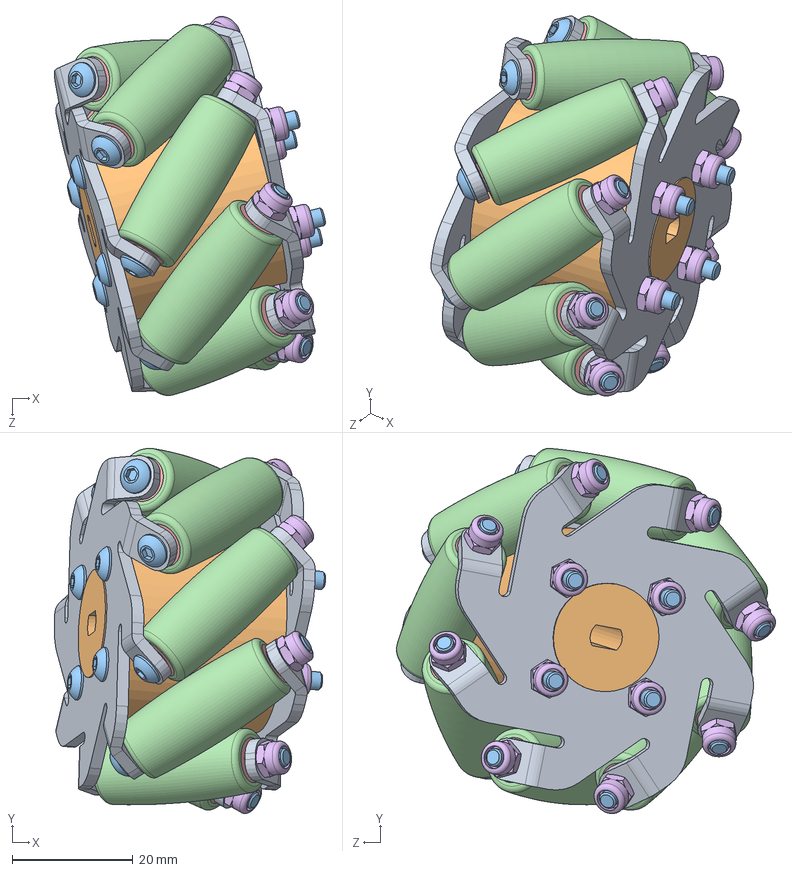
[picture p169: CAD file, 2026-10-26]
CADS/Chassis/right mecanum wheel.SLDASM
44.9 x 60.5 x 62.8 mm
mecanum wheels - Copy x 2
shaft
bolt x 12
Roller x 8
roller bracket x 16
torque nut 08_iso x 12
