kobachajchir/ProyectoRobotica2/CADS/Chassis/assembly of robot.SLDASM

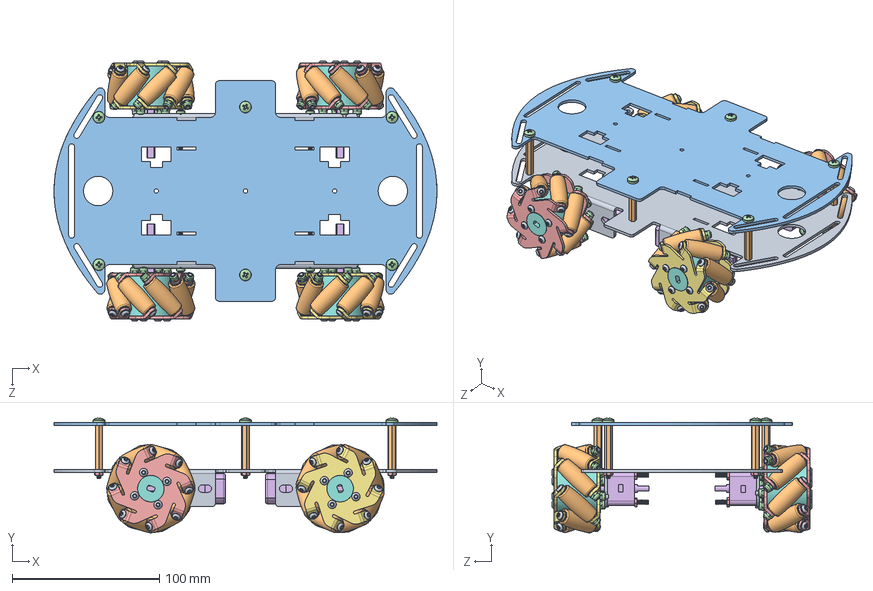
[picture p170: CAD file, 2026-10-26]
CADS/Chassis/assembly of robot.SLDASM
260.0 x 77.9 x 176.8 mm
bottom chassis
supporting hexagon pillar x 6
top chasis
pan head cross recess screw_iso x 14
hexagon thin nut (ch)_is x 14
Motor x 4
mecanum wheels x 4
shaft x 4
bolt x 48
Roller x 32
roller bracket x 50
torque nut 08_iso x 48
mecanum wheels - Copy x 4
