kobachajchir/ProyectoRobotica2/CADS/Chassis/left mecanum wheel.SLDASM

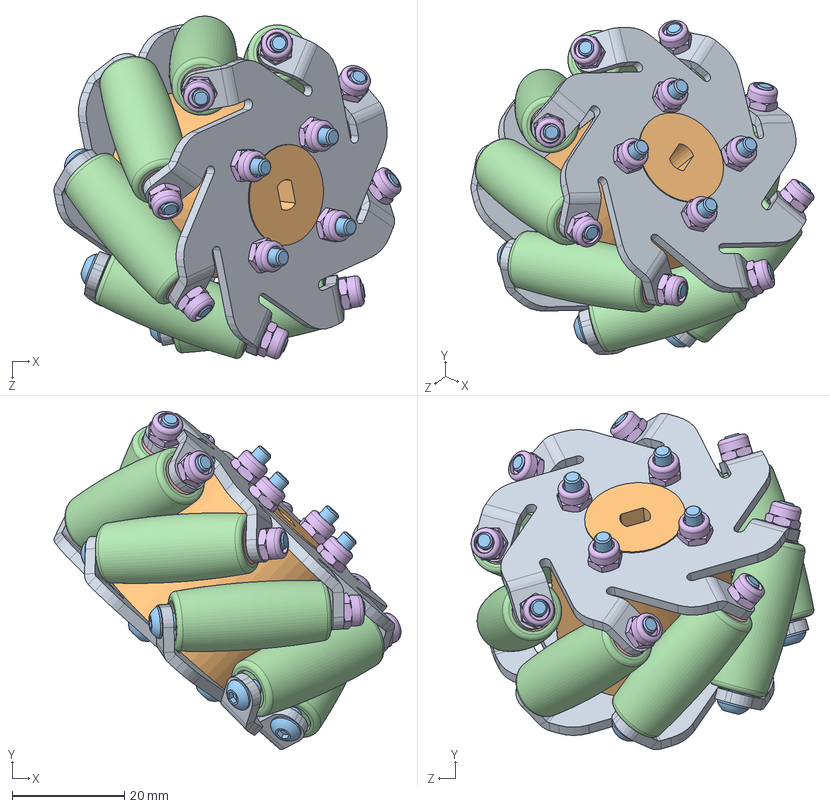
[picture p171: CAD file, 2026-10-26]
CADS/Chassis/left mecanum wheel.SLDASM
61.7 x 60.2 x 61.0 mm
mecanum wheels x 2
shaft
bolt x 12
Roller x 8
roller bracket x 9
torque nut 08_iso x 12
