kobachajchir/ProyectoRobotica2/AutoFinalRobo2-CAD/exports/2026-10-24/parts/CapaInferior.obj

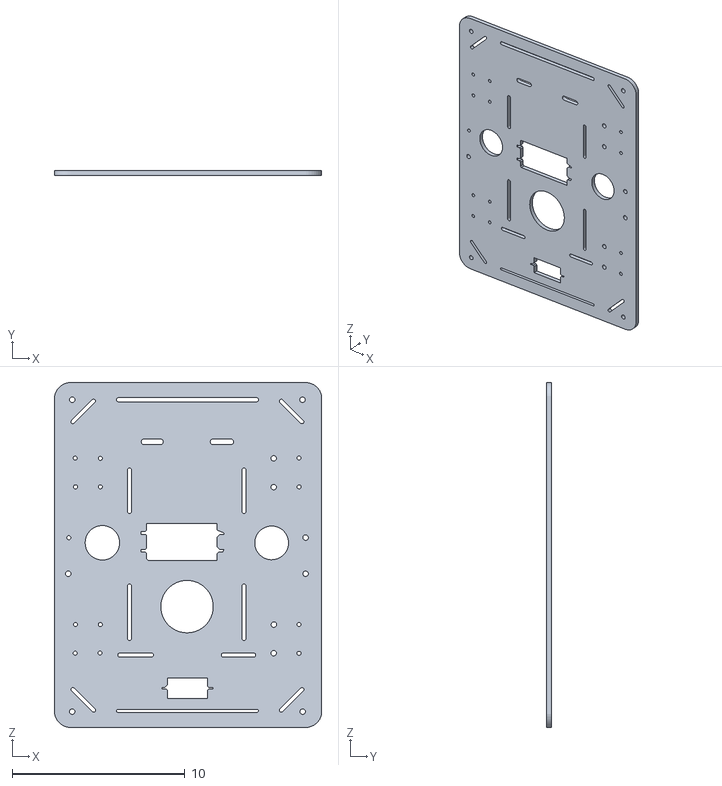
[picture p172: CAD file, 2026-10-24]
AutoFinalRobo2-CAD/exports/2026-10-24/parts/CapaInferior.obj
15.5 x 0.3 x 20.0
