kobachajchir/ProyectoRobotica2/AutoFinalRobo2-CAD/reference/supplied/mecanum-robot-car-chassis-motors-and-wheels/Mecanum Car Chassis.step

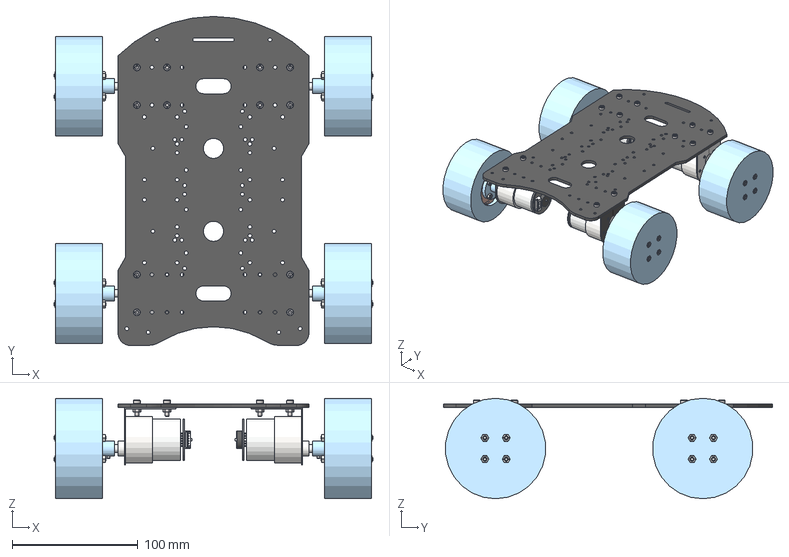
[picture p173: CAD file, 2026-10-23]
AutoFinalRobo2-CAD/reference/supplied/mecanum-robot-car-chassis-motors-and-wheels/Mecanum Car Chassis.step
254.0 x 262.1 x 80.0 mm
Motor Bracket_001
Motor Bracket_002
Motor Bracket_003
Motor Bracket_004
DC Gear Motor 37mm_001
DC Gear Motor 37mm_002
DC Gear Motor 37mm_003
DC Gear Motor 37mm_004
Rad Adapter_001
mecanum wheel_001
M3x41.5-ThreadedRod006
M3x41.5-ThreadedRod005
M3x41.5-ThreadedRod004
M3-Nut008
M3-Nut007
M3-Nut006
M3-Nut005
M3-Nut
M3-Nut003
M3-Nut002
M3-Nut001
M3x41.5-ThreadedRod
M2.5x6-Screw
Rad Beispiel 80mm_001
Rad Adapter_002
M3x41.5-ThreadedRod009
M3x41.5-ThreadedRod010
M3x41.5-ThreadedRod007
M3-Nut009
M3-Nut013
M3-Nut010
M3-Nut012
M3-Nut016
M3-Nut015
M3-Nut011
M3-Nut014
M3x41.5-ThreadedRod008
M2.5x6-Screw001
mecanum wheel_002 (Mirror #1)
Rad Beispiel 80mm_002
Rad Adapter_003
mecanum wheel_003
M3x41.5-ThreadedRod016
M3x41.5-ThreadedRod018
M3x41.5-ThreadedRod014
M3-Nut028
M3-Nut029
M3-Nut027
M3-Nut032
M3-Nut024
M3-Nut025
M3-Nut026
M3-Nut030
M3x41.5-ThreadedRod015
M2.5x6-Screw003
Rad Beispiel 80mm_003
Rad Adapter_004
M3x41.5-ThreadedRod012
M3x41.5-ThreadedRod013
M3x41.5-ThreadedRod017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
