kobachajchir/ProyectoRobotica2/AutoFinalRobo2-CAD/reference/supplied/mecanum-robot-car-chassis-motors-and-wheels/Step/DC Gearmotor 37mm.step

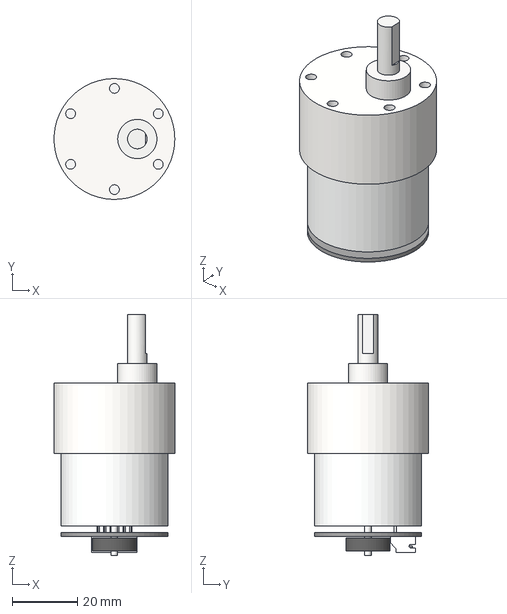
[picture p174: CAD file, 2026-10-23]
AutoFinalRobo2-CAD/reference/supplied/mecanum-robot-car-chassis-motors-and-wheels/Step/DC Gearmotor 37mm.step
37.0 x 37.0 x 73.8 mm
