kobachajchir/ProyectoRobotica2/CADS/5IRTracker/5 Channel IR Tracker.step

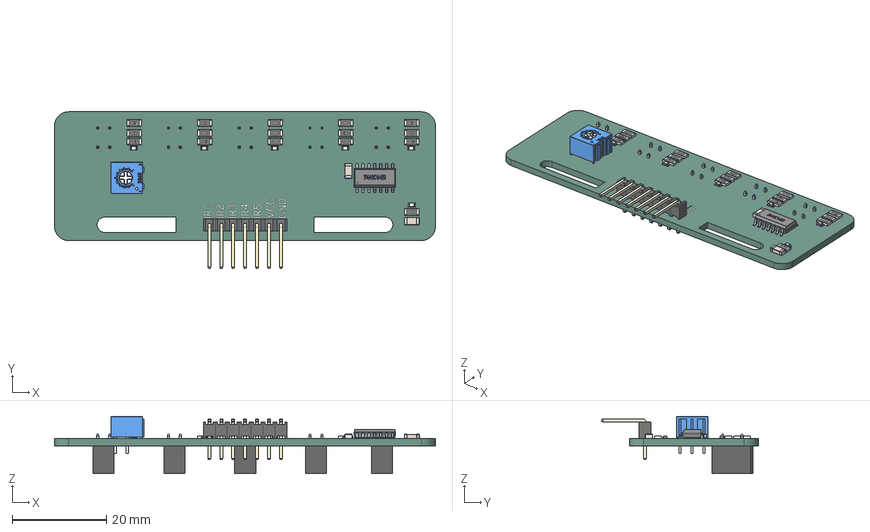
[picture p175: CAD file, 2026-10-26]
CADS/5IRTracker/5 Channel IR Tracker.step
81.0 x 33.3 x 12.2 mm
PCB
Plastic Base x 7
Metal Pin x 7
Phototransistor x 5
Infrared LED x 5
10K, BOURNS 3362P-103LF
74HC14D SMD
Pin1 x 2
Pin2 x 2
CeramicBody x 2
Light x 6
Anode Bottom x 6
Cathode Bottom x 6
Anode x 6
Cathode x 6
Base x 6
