kobachajchir/ProyectoRobotica2/CADS/Chassis/supporting hexagon pillar.SLDPRT

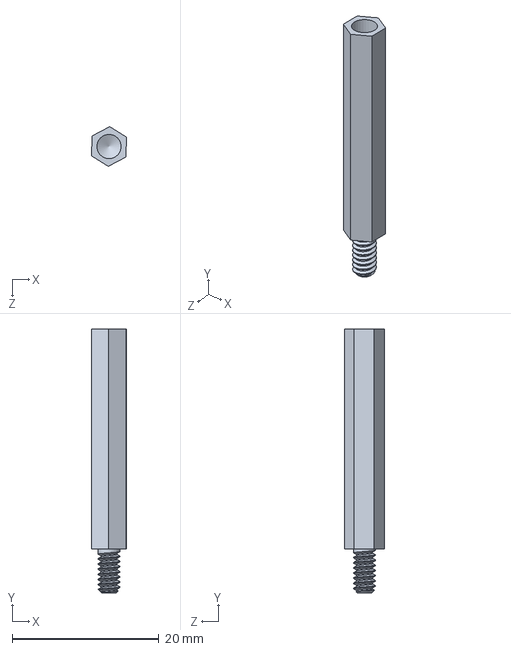
[picture p176: CAD file, 2026-10-26]
CADS/Chassis/supporting hexagon pillar.SLDPRT
4.80 x 36.0 x 5.42 mm
