kobachajchir/ProyectoRobotica2/CADS/MEGA2560/arduinoMegaDetailed.STEP

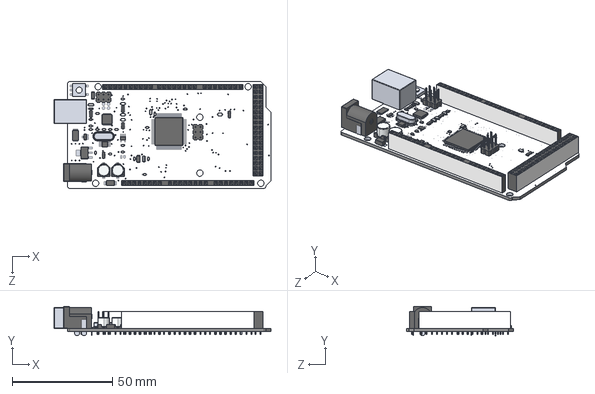
[picture p177: CAD file, 2026-10-26]
CADS/MEGA2560/arduinoMegaDetailed.STEP
108.3 x 14.5 x 53.3 mm
