kobachajchir/ProyectoRobotica2/CADS/Wheels/Assieme_ruota_mozzo.stp

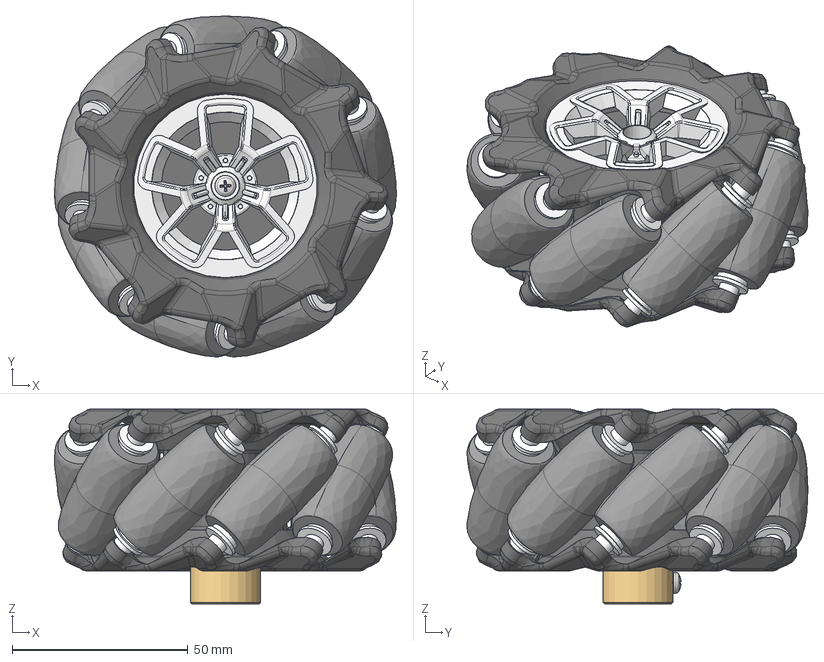
[picture p178: CAD file, 2026-10-26]
CADS/Wheels/Assieme_ruota_mozzo.stp
97.3 x 97.0 x 55.4 mm
Mecanum wheel - left
albero_ottonre_12x6
dado_quadro_M3 x 2
AS 1427 - M3 x 8
AS 1427 - M3 x 30
