kobachajchir/ProyectoRobotica2/CADS/WifiShield/ESP_12_E.STEP

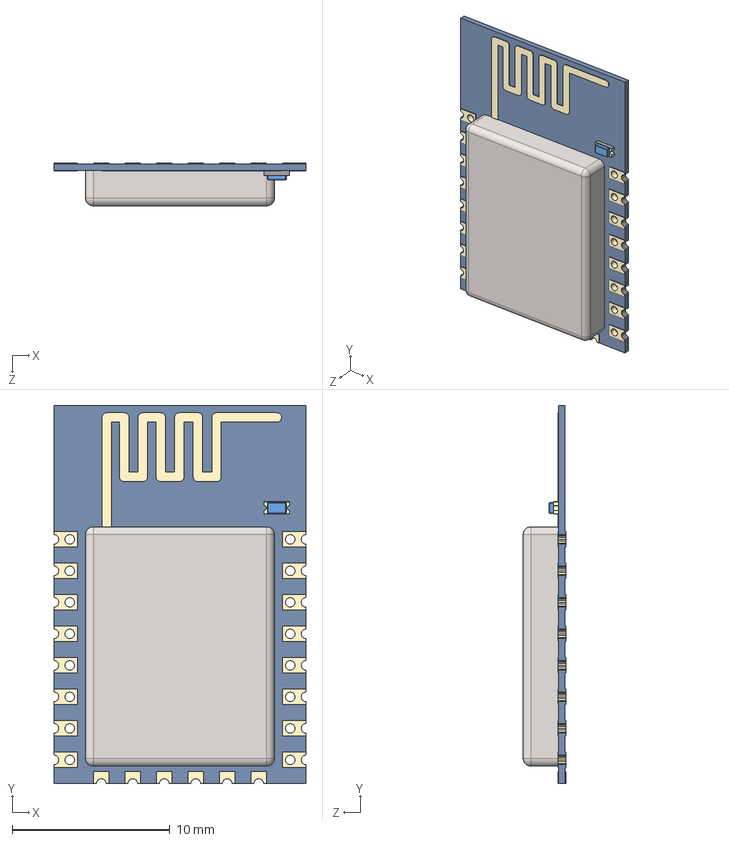
[picture p179: CAD file, 2026-10-26]
CADS/WifiShield/ESP_12_E.STEP
16.0 x 24.0 x 2.71 mm
Board
User_Library-0402(1005M)_Res x 4
User_Library-0603(1608M)_LED
User_Library-0402(1005M)_Cap x 7
User_Library-Osc_KC2520_Imported_4
User_Library-Osc_KC2520_Imported_5
User_Library-SO8-Wide-5mmx5mm
User_Library-QFN-32-5x5mm-WithPad
錨璃4^ESP_12_CORE
錨璃5^ESP_12_CORE
