kobachajchir/ProyectoRobotica2/AutoFinalRobo2-CAD/exports/2026-10-24/parts/CapaSuperior.obj

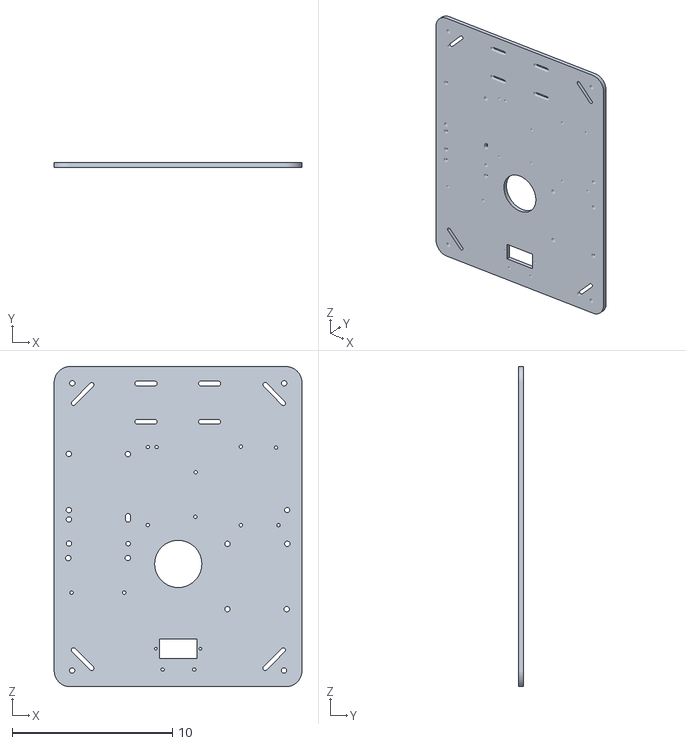
[picture p180: CAD file, 2026-10-24]
AutoFinalRobo2-CAD/exports/2026-10-24/parts/CapaSuperior.obj
15.5 x 0.3 x 20.0
