kobachajchir/ProyectoRobotica2/AutoFinalRobo2-CAD/reference/supplied/mecanum-robot-car-chassis-motors-and-wheels/Step/Mecanum Wheel example 80mm.step

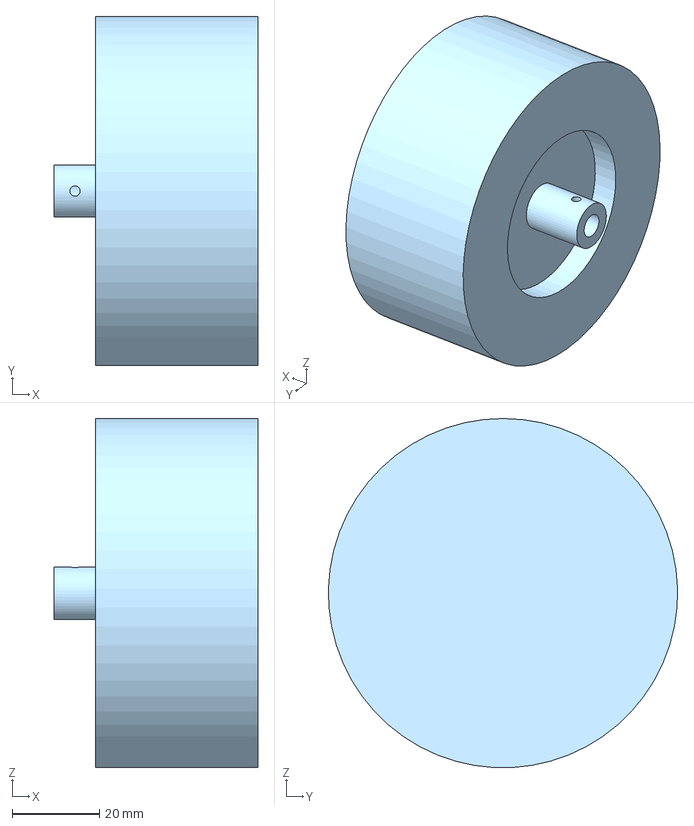
[picture p181: CAD file, 2026-10-23]
AutoFinalRobo2-CAD/reference/supplied/mecanum-robot-car-chassis-motors-and-wheels/Step/Mecanum Wheel example 80mm.step
46.7 x 80.0 x 79.9 mm
