kobachajchir/ProyectoRobotica2/CADS/MEGA2560/arduinoMega.SLDPRT

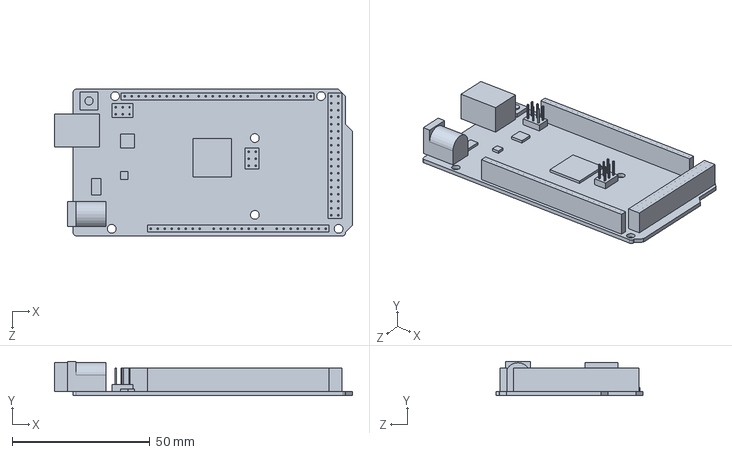
[picture p182: CAD file, 2026-10-26]
CADS/MEGA2560/arduinoMega.SLDPRT
108.3 x 12.5 x 53.3 mm
