kobachajchir/ProyectoRobotica2/CADS/Wheels/albero_ottonre_12x6.stp

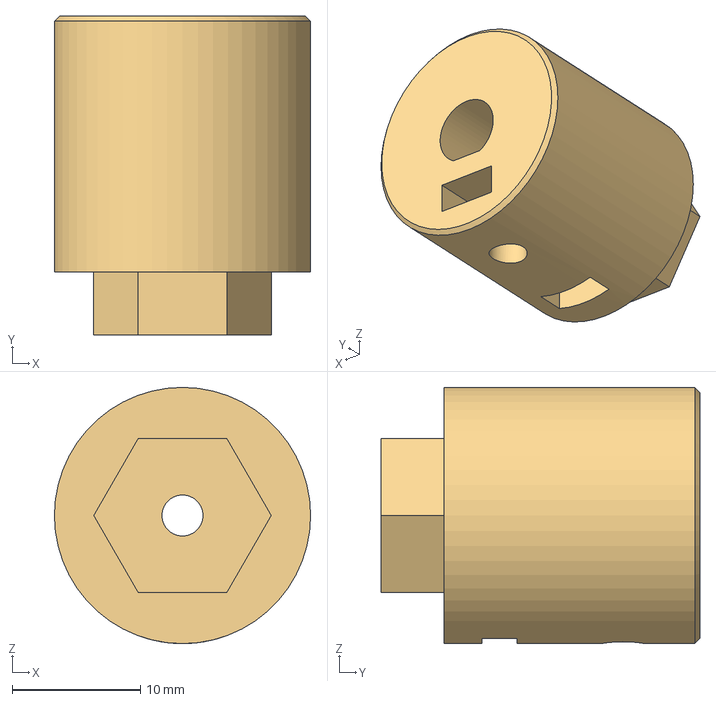
[picture p183: CAD file, 2026-10-26]
CADS/Wheels/albero_ottonre_12x6.stp
20.0 x 24.9 x 20.0 mm
