kobachajchir/ProyectoRobotica2/AutoFinalRobo2-CAD/reference/supplied/mecanum-robot-car-chassis-motors-and-wheels/Step/Mecanum Wheel_right 60mm.step

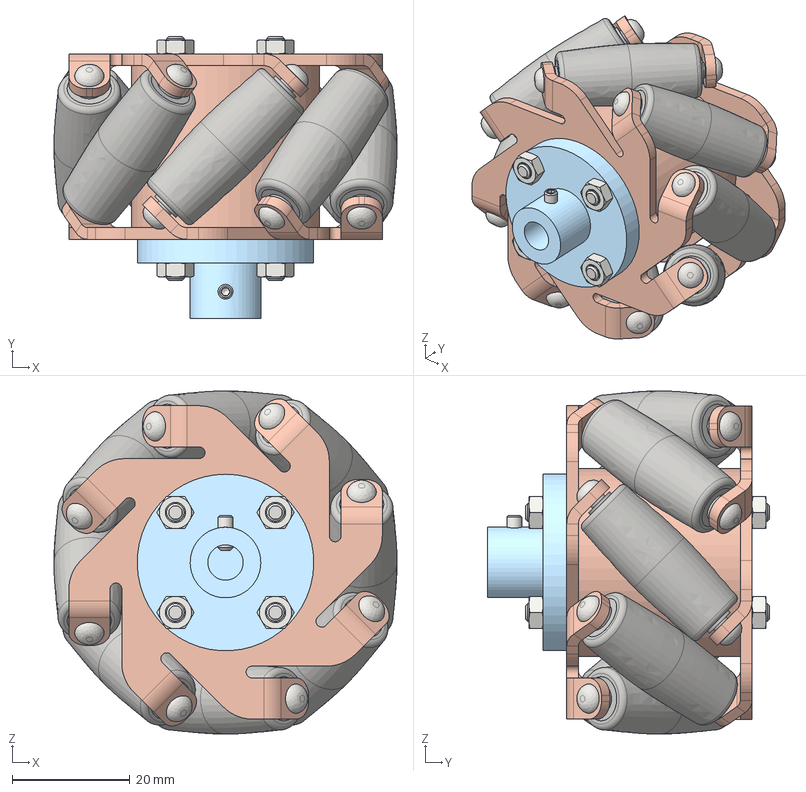
[picture p184: CAD file, 2026-10-23]
AutoFinalRobo2-CAD/reference/supplied/mecanum-robot-car-chassis-motors-and-wheels/Step/Mecanum Wheel_right 60mm.step
58.3 x 48.0 x 58.3 mm
Rad Adapter_001
mecanum wheel_001
M3x41.5-ThreadedRod006
M3x41.5-ThreadedRod005
M3x41.5-ThreadedRod004
M3-Nut008
M3-Nut007
M3-Nut006
M3-Nut005
M3-Nut
M3-Nut003
M3-Nut002
M3-Nut001
M3x41.5-ThreadedRod
M2.5x6-Screw
