kobachajchir/ProyectoRobotica2/AutoFinalRobo2-CAD/reference/supplied/mecanum-robot-car-chassis-motors-and-wheels/Step/Motor Bracket.step

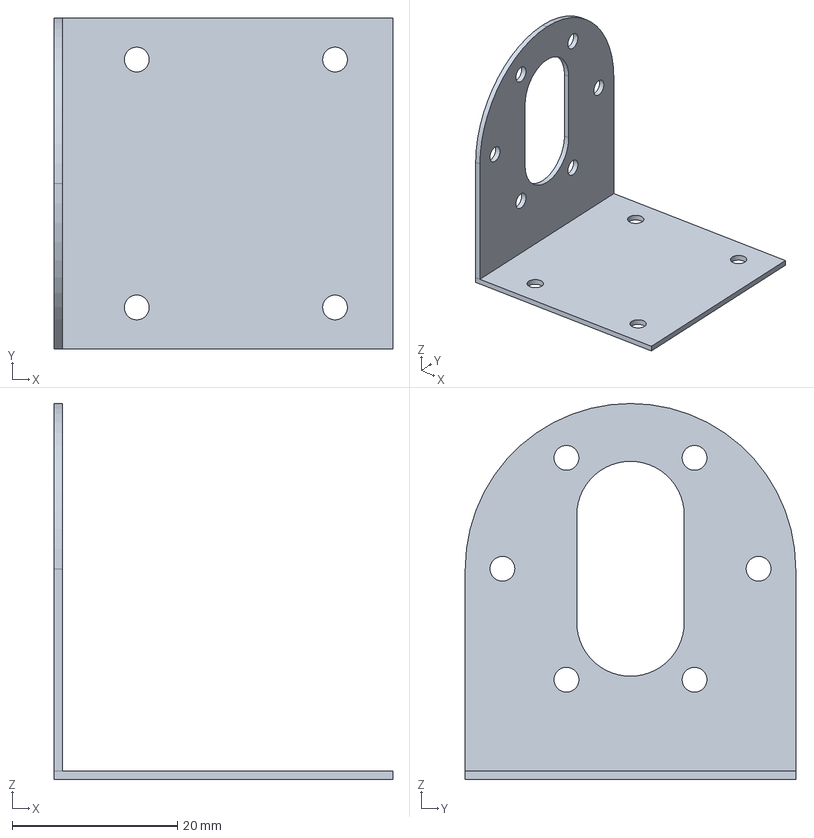
[picture p185: CAD file, 2026-10-23]
AutoFinalRobo2-CAD/reference/supplied/mecanum-robot-car-chassis-motors-and-wheels/Step/Motor Bracket.step
41.0 x 40.0 x 45.5 mm
