kobachajchir/ProyectoRobotica2/(list of files, cad)

Other CAD files:
AutoFinalRobo2-CAD/reference/supplied/mecanum-robot-car-chassis-motors-and-wheels/Step/Mecanum Wheel_left 60mm.step
AutoFinalRobo2-CAD/mecanica/auto-completo/AutoFinalRobo2-20261024-ruedas.f3d
AutoFinalRobo2-CAD/mecanica/auto-completo/AutoFinalRobo2-20261024.blend
AutoFinalRobo2-CAD/mecanica/auto-completo/AutoFinalRobo2-Final-20261025.blend
AutoFinalRobo2-CAD/mecanica/auto-completo/AutoFinalRobo2-Final-20261025.f3d
AutoFinalRobo2-CAD/mecanica/auto-completo/AutoFinalRobo2-UI-A.f3d
AutoFinalRobo2-CAD/mecanica/auto-completo/AutoFinalRobo2-UI-B.f3d
AutoFinalRobo2-CAD/mecanica/auto-completo/AutoFinalRobo2-Usuario-20261025.f3d
AutoFinalRobo2-CAD/mecanica/auto-completo/AutoFinalRobo2.f3d
AutoFinalRobo2-CAD/mecanica/brazo-antropomorfo/AFR2_Brazo_PVC32_AGV_v03.f3d
AutoFinalRobo2-CAD/mecanica/brazo-antropomorfo/AFR2_Brazo_PVC32_AGV_v04.f3d
AutoFinalRobo2-CAD/mecanica/brazo-antropomorfo/AFR2_Brazo_PVC32_AGV_v05.f3d
AutoFinalRobo2-CAD/mecanica/brazo-antropomorfo/AFR2_Brazo_PVC32_AGV_v06.f3d
AutoFinalRobo2-CAD/mecanica/brazo-antropomorfo/AFR2_Brazo_PVC32_AGV_v07_GX3270BLS.f3d
AutoFinalRobo2-CAD/mecanica/brazo-antropomorfo/AFR2_Brazo_PVC32_AGV_v08_Housing.f3d
AutoFinalRobo2-CAD/mecanica/brazo-antropomorfo/AFR2_Brazo_PVC32_AGV_v09_J1_GX3270BLS.f3d
AutoFinalRobo2-CAD/mecanica/brazo-antropomorfo/AFR2_Brazo_PVC32_Prototipo_v01.f3d
AutoFinalRobo2-CAD/mecanica/brazo-antropomorfo/AFR2_Brazo_PVC32_Prototipo_v02.f3d
AutoFinalRobo2-CAD/mecanica/brazo-antropomorfo/analisis_cargas_200g/AFR2_Brazo_PVC32_Estatica_200g_v06.f3d
AutoFinalRobo2-CAD/mecanica/brazo-antropomorfo/revision_v07/GX3270BLS_Referencia_Parametrica.f3d
AutoFinalRobo2-CAD/mecanica/brazo-antropomorfo/revision_v08/GX3270BLS_Referencia_v08.f3d
AutoFinalRobo2-CAD/mecanica/brazo-antropomorfo/revision_v08/Housing_GX3270BLS_Parametrico.f3d
AutoFinalRobo2-CAD/mecanica/brazo-antropomorfo/revision_v09/Adaptador_dobleD_J1_v09.f3d
AutoFinalRobo2-CAD/mecanica/brazo-antropomorfo/revision_v09/Cartucho6000_J1_v09.f3d
AutoFinalRobo2-CAD/mecanica/brazo-antropomorfo/revision_v09/Eje_brida_J1_v09.f3d
AutoFinalRobo2-CAD/mecanica/brazo-antropomorfo/revision_v09/GX3270BLS_Base_REF_v09.f3d
AutoFinalRobo2-CAD/mecanica/brazo-antropomorfo/revision_v09/Housing_J1_GX3270BLS_v09.f3d
AutoFinalRobo2-CAD/mecanica/brazo-antropomorfo/revision_v15/AFR2_Compacto_v15_Modulos_mecanicos.f3d
AutoFinalRobo2-CAD/mecanica/brazo-antropomorfo/revision_v16/AFR2_Brazo_Compacto_v16_Correas.f3d
AutoFinalRobo2-CAD/mecanica/brazo-antropomorfo/revision_v17/AFR2_Brazo_v17_Base_V7_J3_Remoto.f3d
AutoFinalRobo2-CAD/mecanica/brazo-antropomorfo/revision_v17/laminas_20261102/AFR2_Fuente_Laminas_20261102.f3d
AutoFinalRobo2-CAD/mecanica/brazo-antropomorfo/revision_v17/web_blanco/AFR2_Brazo_v17_Piezas_y_Web.blend
AutoFinalRobo2-CAD/mecanica/componentes/OSOYOOMotorDriver_ModelY_V2.f3d
AutoFinalRobo2-CAD/mecanica/componentes/OSOYOOWifiShield.f3d
AutoFinalRobo2-CAD/mecanica/modelos-auxiliares/cubo-50mm/AFR2_Cubo_50mm.blend
AutoFinalRobo2-CAD/mecanica/pieza-nueva/Soporte_UI_A.f3d
AutoFinalRobo2-CAD/mecanica/pieza-nueva/Soporte_UI_B_Fondo.f3d
AutoFinalRobo2-CAD/mecanica/pieza-nueva/Soporte_UI_Final_20261025.f3d
AutoFinalRobo2-CAD/mecanica/sensor-bateria/AFR2_Sensor_Bateria_Cableado_20261109_v2.blend
AutoFinalRobo2-CAD/reference/supplied/mecanum-robot-car-chassis-motors-and-wheels/Mecanum Car Chassis.FCStd
AutoFinalRobo2-CAD/reference/supplied/mecanum-robot-car-chassis-motors-and-wheels/Step/Screw and Nut M3x10.step
CADS/18650/18650 Battery.STEP
CADS/18650BatteryHolder/18650 Battery Holder 2x.stl
CADS/5IRTracker/5 Channel IR Tracker.f3d
