kobachajchir/ProyectoRobotica2/AutoFinalRobo2-Web/reference/supplied/assembly-audio/README.md

# Grabaciones históricas de Armado

10/11/2026 · AFR2-20261110-09.

`armado-narracion.opus` y `armado-narracion.m4a` eran insumos de `AutoFinalRobo2-Web/public/audio/`. Se trasladaron aquí para conservar los originales únicos sin exponerlos como recursos públicos ni enviarlos en paquetes Web/LittleFS. No se convierten ni se regeneran.

El recorrido vigente usa `assemblyPlaybackTimeline.ts` y el reloj de cuadro del navegador. No depende de estas grabaciones ni de un reproductor de audio. Los tiempos históricos de las etapas se conservan para mantener la coreografía.
