kobachajchir/ProyectoRobotica2/AutoFinalRobo2-Contracts/documentation/builds/2026-10-29-19/README.md

# AFR2-20261029-19 — Compilación conjunta y carga ATmega

Pedido humano expreso: «Compila todo, y subi a atmega». Loader1.1.2, misma sesión con autoaceptación y confirmaciones manuales ya autorizadas por el usuario. No se alteraron esas opciones.

## Resultado

- build_all `08e8d3e16fb34719b001a102814b9e0f`, completado29/10/2026 13:31:50 (Buenos Aires). ATmega producto/comunicación/biblioteca, ESP esp12s_candidate, Web TypeScript/Vite perfil esp, promoción local a ESP/data/dist e imagen LittleFS: salidas0, sin errores/advertencias de compilador en el registro final.
- flash_mega `9a88a537e6d447bab70704cc85054981`, COM8, final13:32:50. Firma esperada ATmega2560,80066bytes escritos y verificados por avrdude, exit0. HEX SHA256 d5780d1d3989e939614530c62c7a97adb4b612d08c3ea444fee9c37844c0e494. EEPROM/fuses sin escrituras solicitadas.
- ATmega ELF text78806,data1260,bss5825: flash80066, SRAM estática7085/8192, margen1107bytes; no certifica pila/ISR ni funcionamiento físico.
- ESP firmware:436643bytes de flash de programa,47224bytes de RAM según PlatformIO; BIN440800bytes. Firmware ESP compilado, sin carga al ESP.
- Web:56nodos AVR,16iconos; TypeScript y Vite esp correctos,193módulos. Paquete7activos/1594894bytes gzip, estimaciónFS1687552bytes. Promoción local a ESP/data/dist completada. LittleFS3121152bytes generado; sin carga a ESP.

## Incidencias resueltas

Primer build_all compiló AVR/ESP pero el script FileSystem del perfil apuntaba a una carpeta instalada inexistente. Se corrigió FsScript en el perfil visible a D:/ProyectoRobotica2/AutoFinalRobo2-Loader/scripts/Prepare-Web.ps1 mediante solicitud autoaceptada. Primer build_web_fs compiló/promovió Web y creó LittleFS, pero la regeneración de biblioteca OLED cambió el fingerprint fuente: preparación rechazada. Se repitió build_all con fuentes estabilizadas, completado antes de cargar. No se omitieron gates de preparación ni verificación.

## Límites

La carga acreditada es únicamente ATmega; ESP y LittleFS requieren una carga posterior para desplegar el broker/Web actualizados. El firmware nuevo anuncia feature0x20000, y los extremos ESP antiguos con máscara estricta pueden rechazar esa extensión hasta actualizarse. No se ejecutaron tests, navegador ni ensayos físicos de OLED, motores, sensores, Hall o persistencia. Incluye cambios conjuntos19/20; los informes anteriores sin compilación/carga se conservan como historia.

[Build conjunto](build-all.txt) · [Carga y verificación](flash-atmega-COM8.txt) · [Artefactos](artifacts.json).

## Carga posterior del flasher por pedido humano

29/10/2026 13:36:03: install_mega_flasher a1781679bfe04d5fa01e62f9bb24bbe2 completado en COM8, puente115200 escrito y verificado. Backup previo de flash/hfuse por dos lecturas coincidentes conservado en Loader/backups/mega-20261029-133454-2f402619. El ATmega ahora ejecuta el flasher temporal, sustituyendo al producto cargado13:32:50. ESP sin cargar/detectar por esta operación. [Registro](install-flasher-COM8.txt).
