kobachajchir/ProyectoRobotica2/AutoFinalRobo2-Contracts/documentation/builds/2026-10-30-14/README.md

# AFR2-20261030-14 — compilación completa con Loader1.1.4

Pedido expreso: compilar todo mediante Loader y corregir fallos. Trabajo final753781ad0c6f4d3381bf90e8f676618e, build_all, automático habilitado por usuario; completado30/10/2026 a13:06:02 -03:00. Logs01..04 conservados. Ninguno de estos trabajos abrió COM ni escribió firmware (writingStarted=false). Las operaciones que el usuario haya realizado después son independientes.

Resultado final: ATmega producto/comunicación/biblioteca exit0; ESP esp12s_candidate exit0; Web perfil esp (generador OLED, TypeScript y Vite) exit0; paquete local promovido a ESP/data/dist; imagen LittleFS3121152bytes exit0. Sin errores ni advertencias de compilador en la pasada final. Los avisos NOTE de vite:singlefile sobre activos externos no son errores; esos activos se incluyen en el paquete.

Fallos corregidos: import QUICK_MODES_NODE sin uso y acceso a current posiblemente undefined en FirmwareLibraryPreview; tres advertencias misleading-indentation por if sin llaves en pantallas/servicio; inicializador step omitido en Volver de rápidas. Se preservó comportamiento y se actualizaron hashes de renderer tras revisión. No se omitieron verificadores ni guardas. Primer intento y pasada03 se detuvieron en el control de fuentes cambiadas; tras estabilizar los recursos generados, pasada04 cerró completa. BuildPreparation incluye salidas como .su/recursos generados entre entradas: puede exigir repetir tras una regeneración. Esa implementación del Loader no fue modificada.

Medidas observadas: AVR .text103592 + .data1502 =105094bytes de flash; .data1502 + .bss5908 + .noinit9 =7419bytes de RAM estática,773bytes restantes de8192 antes de pila. avr-size -A fue consultado sobre el ELF de la pasada corregida. .su individual main288 y Afr2Ui_Render145bytes, sin análisis de máximo simultáneo/ISR; no acredita margen dinámico suficiente. ESP RAM48804/81920, flash445895/1044464. Paquete7activos,1607542bytes gzip, estimación FS1695744bytes (no ocupación física medida).

SHA256 LittleFS registrado por el trabajo final:3b55c5832eeb13f83c36d99840a2e44759d6e95bce5df9096c81216c70f95ee7. Los artefactos de build son regenerables y pudieron sobrescribirse por trabajos posteriores: los hashes y horas atribuibles a esta entrega son los del log04. No se copia ni documenta ninguna credencial Wi-Fi en estos informes.

Sin tests, navegador, comprobación física de movimientos/red, ni aceptación de pila. No confirma el contenido actualmente cargado en ESP o ATmega. Ficha:../../../changes/2026-10-30-14-loader-build-all.md.
