kobachajchir/ProyectoRobotica2/AutoFinalRobo2-Contracts/documentation/builds/2026-10-24-06/README.md

# Modelo a escala y suelo — AFR2-20261024-06

`npm run build:esp`: TypeScript + Vite + paquete + promoción, exit0.
**1.450.617 bytes gzip / 7 activos**; estimación FS1.540.096 bytes.

- [Log](web-build.log), [manifiesto](manifest.json), [resumen y hashes](summary.json).
- Modelo fuente idéntico: no se editó el GLB ni se publicó una segunda copia.
- Estado fuente: escala1, cuadrícula0,5m, base del modelo en Y=0,
  pose mm→m por1000, Superior ortográfica / Perspectiva / Seguir auto con GLB.

Solo compilación e inspección de fuente/artefactos. Sin navegador, suite de
tests, validador independiente, imagen FS, flasheo ni hardware.
