kobachajchir/ProyectoRobotica2/AutoFinalRobo2-Contracts/documentation/builds/2026-10-25-08/README.md

# Compilación — cintas suaves y punta aguda

25/10/2026, AFR2-20261025-08. Web build:esp exit0: TypeScript/Vite,
minificación, gzip y copia local. Pedido previo de compilar/corregir vigente.
[Log](web-build.txt) de fuente final, sin errores.

| Resultado | Valor |
| --- | --- |
| Web / firmware conservado / EX01 |0.2.0 /0.9.0 /7 |
| Activos / gzip |7 /1482334 bytes |
| Diferencia gzip respecto07 |+256bytes |
| Raw |3043896 bytes |
| LittleFS estimado / presupuesto |1572864 /2867200 bytes |
| GLB final conservado |827232bytes |

[Manifest](manifest.json)/[resumen](summary.json): hashes coincidentes de los
siete activos y manifest entre paquete/ESP data. Firmware ESP/AVR conserva
[build01](../2026-10-25-01/README.md), sin recompilar ni cambiar gates0.

Nuevo componente visual y adaptación de Overlay/CSS: gradientes por brazo,
color suave, unión aguda y proporción conservada. Sin filtros, dependencia,
recurso externo, cambios de input/cámara07/modo local04 o físico.
Ángulo y campos leídos en fuente; no comparación raster o visual. Sin tests,
validadores independientes, navegador/teléfono, serie, imagen FS, flasheos
o pruebas físicas. Build no acredita aceptación estética. Layout3MiB físico
y flash/SPI pendientes de identificar.
