kobachajchir/ProyectoRobotica2/AutoFinalRobo2-Contracts/documentation/builds/2026-10-25-09/README.md

# Compilación — diseño anterior con color suave

25/10/2026, AFR2-20261025-09. Web build:esp exit0, sin errores en
[log](web-build.txt). Compilación/corrección autorizada por pedido previo.

| Resultado | Valor |
| --- | --- |
| Web / firmware conservado / EX01 |0.2.0 /0.9.0 /7 |
| Activos / gzip |7 /1482081 bytes |
| Diferencia gzip respecto07 |+3bytes |
| Raw |3043190 bytes |
| LittleFS estimado / presupuesto |1572864 /2867200 bytes |

[Manifest](manifest.json)/[resumen](summary.json): siete activos y manifest
coinciden en paquete y ESP/data. Firmware ESP/AVR conserva build01/gates0.
Overlay idéntico al hash de07; CSS idéntico salvo opacidadSVG0,58 y comentario.
Componente08 retirado tras comprobar su fuente propia intacta, copia local
.tmp/revert09. Fuente07/cámara/layout/animación y controles conservados.
Sin nuevas dependencias/activos, navegador/teléfono, tests/validadores
independientes, flasheos, pruebas físicas o CAD. No aceptación visual nueva.
