kobachajchir/ProyectoRobotica2/AutoFinalRobo2-CAD/reference/supplied/oled-encoder-20261025/ranura-montaje-auto.png

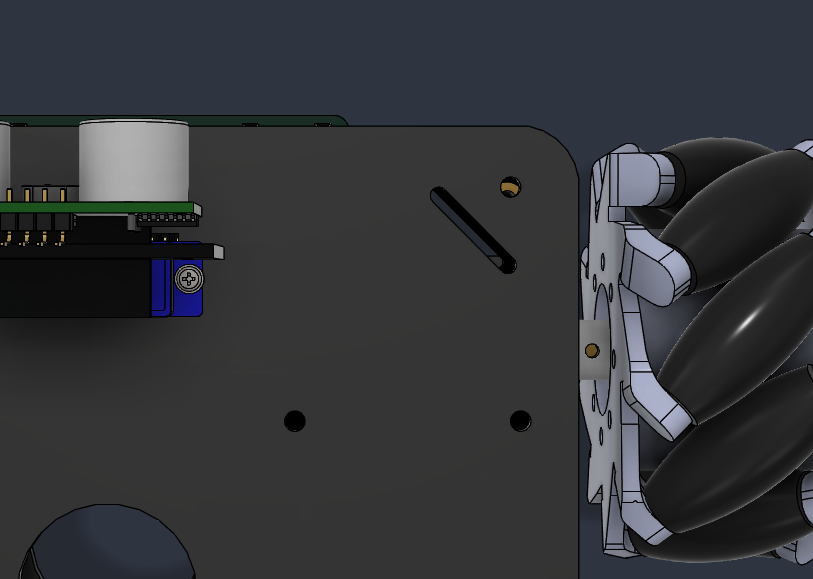
AutoFinalRobo2-CAD/reference/supplied/oled-encoder-20261025/ranura-montaje-auto.png
