kobachajchir/ProyectoRobotica2/AutoFinalRobo2-Contracts/hardware/evidence/manual-p43.png

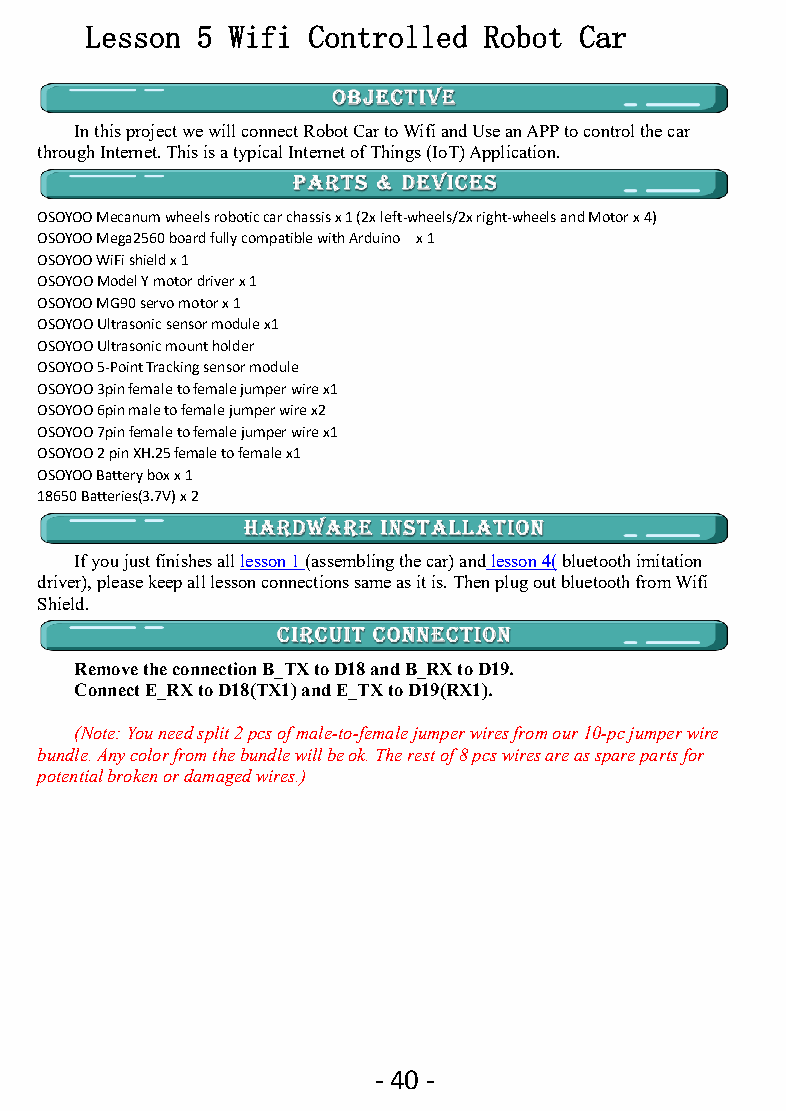
AutoFinalRobo2-Contracts/hardware/evidence/manual-p43.png
