kobachajchir/ProyectoRobotica2/hardware/evidence/manual-p15.png

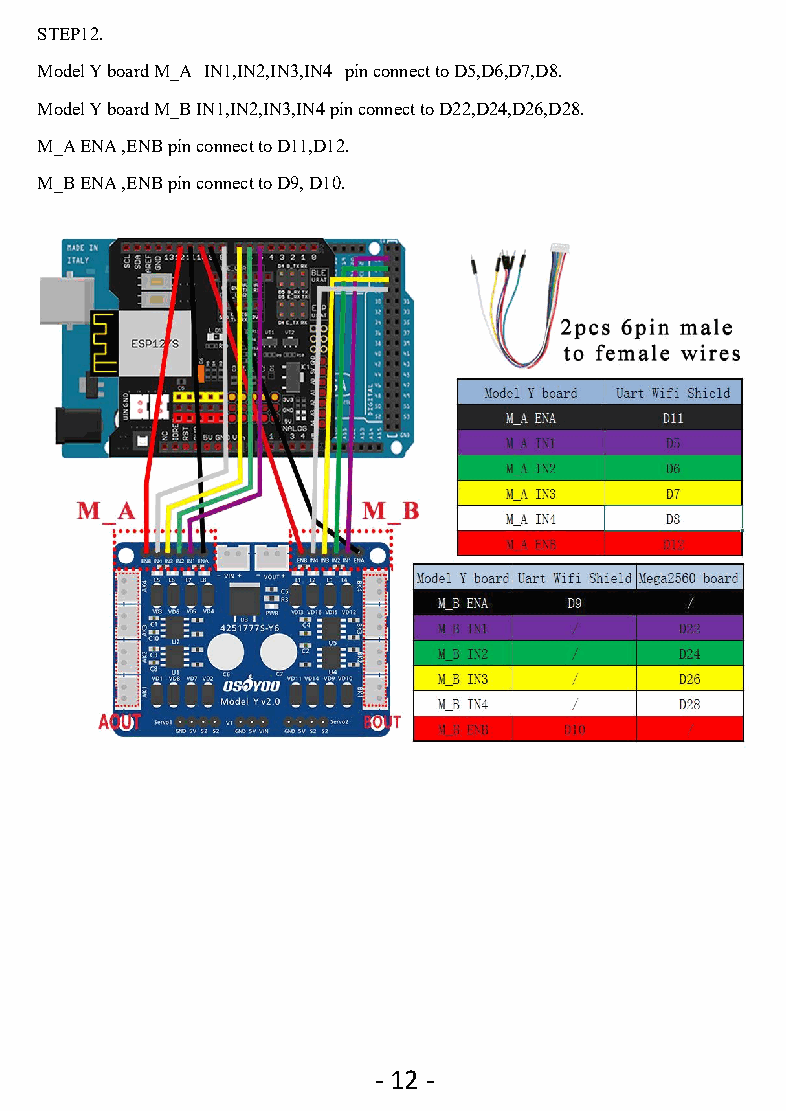
hardware/evidence/manual-p15.png
