kobachajchir/ProyectoRobotica2/hardware/evidence/manual-p27.png

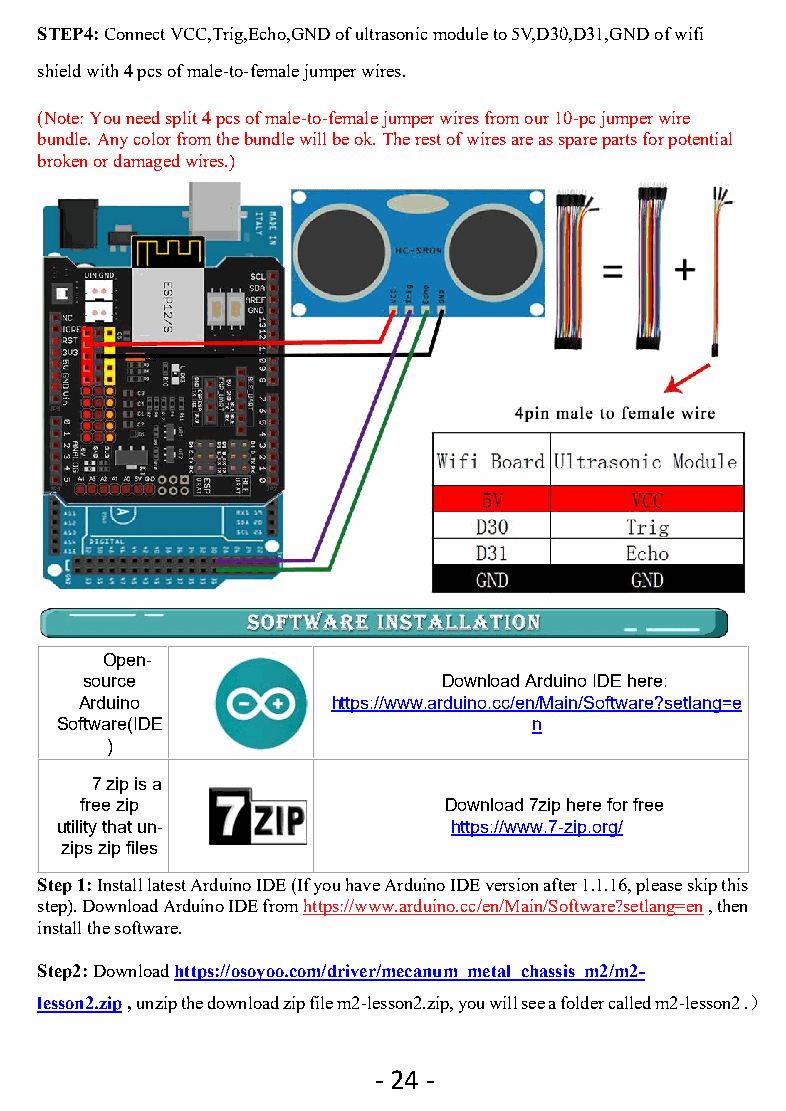
hardware/evidence/manual-p27.png
