kobachajchir/ProyectoRobotica2/hardware/evidence/manual-p34.png

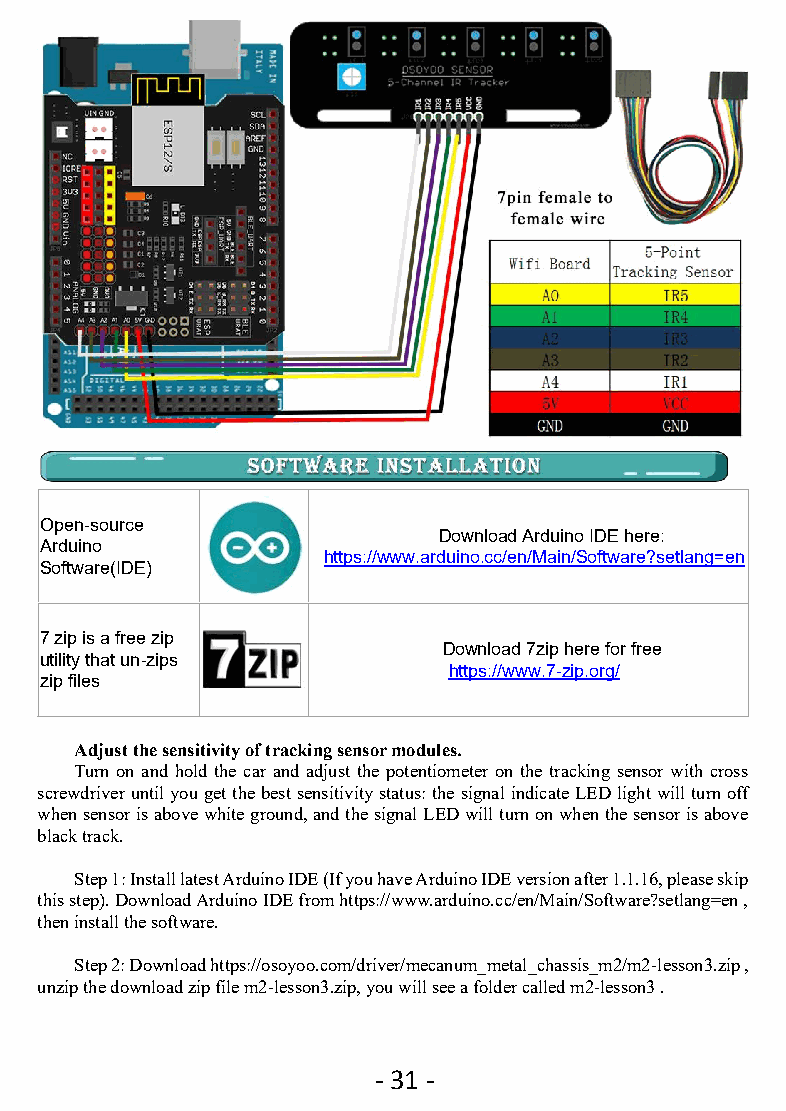
hardware/evidence/manual-p34.png
