kobachajchir/ProyectoRobotica2/CHANGELOG.md

# Registro AutoFinalRobo2

Independiente del AMI AutoMicro.

| Fecha | ID | Cambio | Atmega | ESP | Web | Detalle |
| --- | --- | --- | --- | --- | --- | --- |
| 2026-10-23 | AFR2-20261023-03 | Shield UART V1.3: evidencia, niveles, cruce USB, I2C Mega y prompt | pendiente; código sin cambio | pendiente; código sin cambio | pendiente; código sin cambio | [Ficha](changes/2026-10-23-03-wifi-shield-evidence.md) |
| 2026-10-23 | AFR2-20261023-02 | Cabeceras I2C, conectores PCB y árbol de menús objetivo | pendiente; fuente sin cambio | pendiente; sin cambio | pendiente; sin cambio | [Ficha](changes/2026-10-23-02-navigation-and-interface-board.md) |
| 2026-10-23 | AFR2-20261023-01 | Base, hardware/UI y contrato candidato | OLED/UI fuente parcial; resto pendiente | port pendiente | port pendiente | [Ficha](changes/2026-10-23-01-bootstrap.md) |
