kobachajchir/ProyectoRobotica2/AutoFinalRobo2-Contracts/changes/2026-11-01-03-oled128-dashboard.md

# AFR2-20261101-03 - Dashboard OLED128-3

01/11/2026. Pedido humano: quitar el texto innecesario `Sin porcentaje` y
mejorar el dashboard con inspiración en la imagen de monitor adjunta. Se
adapta jerarquía de bloques, iconos y contraste; no su densidad ni funciones.

## Cambio concreto

PerfilOLED128-3 de skill con cabecera invertida común y dos componentes nuevos:
panel de estado y panel de métrica. Contorno1px con esquinas recortadas2px;
variante paired-status con dos paneles62px y variante hero-metric76+48px,
separados4px. Conserva pie/gestos y sensores simultáneos del perfil2.
El énfasis invertido indica jerarquía, no selección ni salida activa.

Numerales5×7 registrados, escalados2× para lectura principal10×14; fuente de
texto7×10 y mini3×5 conservadas. Nuevo recurso de diseño en JSON, no una fuente
implementada en el firmware. No se extrajeron glifos de la foto.

Tres páginas con datos ficticios: resumen motorOFF/Wi-FiSTA, servo90grados con
PWM1500us, movimiento con consigna150mm/s yPWM40. No representan sensores del
equipo. Ángulo de servo por pulso no implica realimentación física; consigna
no equivale a velocidad medida.

La carga indeterminada omite la cifra y deja el área libre; no imprime una
explicación de que falta el porcentaje. Barra124×8 compartida con progreso
conocido. Se registra esta regla para posteriores diseños.

## Recursos y evidencia real

Imagen del usuario preservada como inspiración en
`.agents/skills/oled128-ui-design/assets/inspiration/dashboard-monitor.png`;
autoría original no identificada. Se usa como referencia visual, no instrucciones.

Se generaron atlas completo y lámina de tres dashboards mediante el generador
documental actualizado. Esto genera entregables de diseño; no valida código,
layout en navegador, legibilidad física, paridad o hardware. No se ejecutaron
tests, compilaciones, validadores, navegador, puertos o flasheos. Sin commit/push.

- shared/Contracts: skill, tokens/recursos, guía de dashboard y artefactos.
- atmega/esp/web: sin cambios de código ni recursos activos por esta ficha.
- CAD/Loader: sin cambios.
- Skill personal sincronizada; fuente versionable en Contracts.

[Composición](../.agents/skills/oled128-ui-design/references/dashboard.md) ·
[Propuesta](../.agents/skills/oled128-ui-design/assets/dashboard-proposal.png) ·
[Atlas](../.agents/skills/oled128-ui-design/assets/component-atlas.png).
