kobachajchir/ProyectoRobotica2/AutoFinalRobo2-Contracts/changes/2026-10-30-04-pwm-limit-255.md

# AFR2-20261030-04 — Límite PWM predeterminado255

30/10/2026. Pedido explícito del usuario tras diagnóstico de rechazo en Motor individual. El default80 limitaba la magnitud aceptada aunque el editor admitiese hasta255. Se cambia el default a255 y el journal a v7 para migrar en RAM el80 de registros anteriores. Otros límites y calibraciones se conservan; guardar EEPROM sigue siendo explícito.

Contrato: [EEPROM_PWM_LIMIT_7.md](../contracts/EEPROM_PWM_LIMIT_7.md). PWM330 continúa siendo inválido;550ms es válido. El límite compartido también afecta el techo PWM manual/PID. Sin cambios de wire, pantallas ni navegación. ESP/Web ya consumen el límite publicado y conservan sus restricciones propias.

ATmega: cambios en defaults, versión y migración, sin compilar ni cargar. ESP/Web: sin cambios, build ni promoción. Solo edición y lectura manual; sin tests, validadores, generadores, COM ni ensayo físico. No se cambió el auto conectado. Autorías previas preservadas; adaptaciones por archivo en provenance/pwm-limit-20261030-04.json.
