kobachajchir/ProyectoRobotica2/AutoFinalRobo2-Contracts/changes/2026-10-30-07-ui-integral.md

# AFR2-20261030-07 — reforma integral OLED, Web y diagnóstico ESP

## Resultado y alcance

Implementación en fuentes dentro de D:/ProyectoRobotica2, sobre05/06 y cambios existentes. AVR C/avr-libc, ESP Arduino8266 y copia raster Web coordinados. EX01v10 / EEPROMv8. Sin compilar, validar, probar, generar recursos, abrir navegador/puertos, promover ESP, cargar ni ensayar hardware. No se afirma paridad visual o memoria suficiente.

## Matriz del pedido

| Sección | Implementación fuente |
|---|---|
|1 Navegación|Principal reiniciado desde dashboard; orden y retorno preservados; L centrada; Volver sin chevron redundante; Sí/No con rectángulo; páginas acotadas; filas de Inicio/Detener dinámicas; Descartar solo dirty; recuento dinámico capturado para Web|
|2 Dashboard|Reposo sin motores bloqueados, fallos conservados, margen y scroll de red; RSSI preparado con validez. Evaluación de iconos de señal registrada; icono fijo por falta de presupuesto enlazado|
|3 Modos|Tarjeta7 ->03003d Reposo/Manual; confirmación de servicio y notificación, rechazo real, físico únicamente, sin crear operaciones equivalentes|
|4 Sistema|Versiones/Preferencias/Batería/Reinicio/Diagnóstico/Capacidades/Pantalla/Volver; encoder e inversión servo en Preferencias; largo800..3000/100; seis páginas de capacidades con datos preparados|
|5 Estado y pruebas|OLED, encoder y enlace en Estado; prueba física encoder03003e independiente; diagnóstico ESP03003f correlacionado, timeout configurable, sin Internet o cliente Web|
|6 Servo/radar|Servo conserva Angulo/Centrar/Desactivar/Volver; opciones radar sin acceso servo duplicado; inversión trasladada; Inicio/Detener único; reemplazo por casilla angular aun con error; no doble punto latest/rastro; selección radar restaurada|
|7 Calibración/odometría|Editores geométricos y Hall conectado retirados, nominal CAD fijo80/170, EEPROM anterior no lo sobrescribe; conserva CPR/signos/requisitos reales y Ver odometría; Guardar EEPROM solo Preferencias; dirty por campos|
|8 Wi-Fi|Ver estado, mismo servicio y retorno|
|9 Potencia|Componente compartido030040: porcentaje, representación round(255*p/100), barra y porcentaje; edición porcentual local, táctil solo presentación confirmada1200ms sin cola; mm/s y límite PWM conservan unidades|
|10 Giro encoder|Bitmap propio32bytes PROGMEM y contraparte Web, usado en potencia, páginas y prueba; atribución previa conservada|
|11 Trabajo previo|Compensaciones Web explícitas para catálogo/recursos no regenerados; sincronizador preparado para reform[]; contratos, pantallas, conexiones, módulos y procedencia actualizados|

## Archivos principales

ATmega: include/afr2_{product,app,screens,encoder_ui,icons,menu_catalog}.h; src/ui/afr2_{menu_catalog,screens,sensor_screens,icons}.c; src/services/afr2_{app,app_wire,product,sensor_commands}.c; src/platform/afr2_{preferences,sensors}.c; src/input/afr2_encoder_ui.c y main.c.
ESP: broker.h, broker.cpp, broker_product.cpp, mega_link.cpp. Conserva un único productor de solicitudes UART, prioridad STOP y supervisión.
Web: firmwareRenderer.ts, firmwareSensorRenderer.ts, FirmwareLibraryPreview.tsx, EncoderControl.tsx, LiveOledViewer.tsx, remoteSnapshot.ts; reformCatalogue.ts/reformResources.ts; ManualDriveOverlay.tsx, ControlPage.tsx, CalibrationPanel.tsx, calibrationGuide.ts, SystemPanel.tsx, SensorsPage.tsx, sequenceTypes.ts, robotState.ts y estilos manuales. sync-oled-library.mjs preparado, sin ejecutar. Recursos generated/ conservan entrega anterior.
Contracts: UI_REFORM_10.md, afr2_geometry.h, geometry.json, ATMEGA_CONFIG_ACTIONS.json, commands.json, screens.json, conexiones, navegación, sistema de pantallas, estado e informes.

## Límites concretos

- Icono Wi-Fi por intensidad evaluado y no activado: faltan mapa enlazado y aceptación de memoria/pila. Se conserva distinción STA/AP/desconectado/desconocido. Ver presupuesto en contrato.
- Geometría nominal derivada de envolventes de rodillos del CAD exportado, documentada como inferencia. No acredita dimensiones exactas de eje, radio de rodadura o precisión física. No se habilita Hall por compilación ni se fabrican CPR.
- Catálogo/recursos generados, compilaciones y paquete ESP pendientes de autorización. Fuentes Web contienen sus contrapartes explícitas; no se presenta el paquete anterior como actualizado.
- Encoder/diagnóstico/movimientos no fueron ejecutados. Raster, cambios de ángulo, tiempos, compatibilidad y memoria requieren comprobaciones posteriores.

## Revisión realizada y comprobaciones futuras

Solo lectura de instrucciones, referencias y fuentes, inspección de diffs, extracción de metadatos CAD/GLB y edición de fuentes/documentación. Revisión manual de productor/consumidor y longitudes: STATE19bytes, UI_META14bytes, TOUCH_UI4bytes request/1response, DIAG poll0/9 y result8/0, fuera del envelope9bytes. No se ejecutó ninguna comprobación automatizada o validador.

Cuando se autorice: regenerar biblioteca; compilar juntos AVR/ESP/Web; revisar flash/SRAM/pila; comprobar migración1..7->8, gestos800/3000 y límite exacto, Sí/No, dirty y recuento dinámico, pruebas de encoder, correlación/timeout/late replies, radar por casilla válida/inválida, potencia0/50/100 y ACK distinto, STOP durante presentación y fidelidad AVR/Web con mismo snapshot/reloj. Promoción, carga y hardware son etapas distintas con autorización y evidencia propias.

Contrato: ../contracts/UI_REFORM_10.md. Geometría: ../hardware/GEOMETRIA_FIJA_CAD.md. Procedencia por archivo: ../provenance/ui-integral-20261030-07.json.
