kobachajchir/ProyectoRobotica2/AutoFinalRobo2-Contracts/changes/2026-10-28-04-brazo-j1-v09-pla.md

# AFR2-20261028-04 — J1 GX3270BLS, housing bajo y PLA PrintaLot

28/10/2026. Iteración CAD y cálculos expresamente solicitados. El usuario selecciona PLA PrintaLot; perfil de impresión y resistencia por orientación todavía pendientes.

## Implementación

Se conserva v08 y se entrega el [maestro editable v09](../../AutoFinalRobo2-CAD/mecanica/brazo-antropomorfo/AFR2_Brazo_PVC32_AGV_v09_J1_GX3270BLS.f3d), con177 parámetros,377 componentes,14 articulaciones y cuatro vínculos de movimiento. Componentes F3D independientes, parámetros y fuentes en el [índice de revisión](../../AutoFinalRobo2-CAD/mecanica/brazo-antropomorfo/revision_v09/README.md).

- Sustitución J1 MG946R por GX3270BLS270°, referencia comercial local≥63 kgf·cm a7,4 V y90 g. Interfaces comerciales parcialmente inferidas; unidad no comprada/relevada.
- Cuna reforzada, cartucho desmontable para dos6000-2Z10×26×8 separados13 mm, ejeØ10/bridaØ60 metálicos y adaptador inferior dobleD. El objetivo anterior16 mm se ajustó a13 por espacio de montaje. Se proponen SAE4140 bonificado y certificado Rp0,2≥600 MPa.
- CuatroM4 en PCD50, casquillos metálicos y arandelas; cuatro tirantesM3 del cartucho con tuercas inferiores. Se conserva montura6 mm/plato96 mm, sin elevación general.
- Se corrigen bornera contra montura/tirante, membrana residual en el paso del horn y giro de tuercas de brida contra un regulador. Se adapta el rack lateral sin elevar el brazo.
-26 cuerpos impresos con PLA PrintaLot nativo, densidad1240 kg/m³. E1500 MPa/ν0,38 son hipótesis; no resistencia FDM asignada. La TDS enlazada oficialmente no se interpreta como caracterización entre capas.

## Evidencia y límites

La [revisión geométrica](../../AutoFinalRobo2-CAD/mecanica/brazo-antropomorfo/revision_v09/informe_movimiento_v09.json) termina con3.087 configuraciones sin penetraciones reportables sobre0,001 mm³. Montajes internos y postura nativa sin penetraciones reportables;26 impresos, seis ejes y12 rodamientos auditados, sin pendientes de su alcance. Los18 extremos nativos tienen error máximo≈2,85e-14°; pinza50 mm en109,8°. Sin errores/advertencias de línea de tiempo. Es muestreo CAD, sin cobertura continua ni demostración física.

El [informe de cargas](../../AutoFinalRobo2-CAD/mecanica/brazo-antropomorfo/revision_v09/RESISTENCIA_Y_CARGAS.md) integra49 secciones y79.651 estados,211 casos con64 combinaciones de sentido de seis ejes. Hipótesis30°/s, paradas200/100/50 ms,200 g y final horizontal. Masa estimada2.400,43 g sin auto; PLA macizo1.014,88 g. J1 máximo16,30 kgf·cm; eje62,45 MPa equivalentes de referencia, cuna3,15 MPa normales nominales; exigencia efectiva FDM12,58 MPa con n2/Kt2 supuestos. Los modelos no resuelven FEA/contactos/ortotropía, fatiga, creep, apriete ni montaje real.

**No queda aprobado el brazo completo a200 g:** J2/J3/J5 pierden el objetivo preliminar de margen×2 en frenada conjunta50 ms, con demandas34,47/34,13/10,58 kgf·cm frente a anuncios40/63/13. Faltan curvas de actuadores, estabilidad/masa real del auto, frenada del AGV, caracterización FDM y alimentación. La sensibilidad a velocidad de catálogo sin carga no se adopta como prestación nominal bajo carga. No existe una frenada instantánea finita certificable con este modelo.

## Estados de módulos

| Módulo | Estado de esta ficha |
| --- | --- |
| atmega | Sin cambios de producto por esta revisión |
| esp | Sin cambios |
| web | Sin cambios ni promoción de assets |
| CAD | Modelado/exportado y comprobaciones geométricas/cálculos solicitados; sin FEA ni fabricación/ensayo físico |
| Loader | Sin cambios por esta revisión |
| Contracts | Registro y enlaces de evidencia |

Los cambios concurrentes de Loader/servicio AVR de las fichas02/03 son independientes. No se ejecutaron compilaciones, tests de software, COM, flasheos o ensayos físicos en esta iteración. Despieces/planos siguen pendientes de la indicación del usuario.
