kobachajchir/ProyectoRobotica2/AutoFinalRobo2-Contracts/changes/2026-10-27-08-workspace-envelope-pending-prompts.md

# AFR2-20261027-08 — Prompts y referencias de envolventes pendientes

27/10/2026. Pedido humano: guardar cinco prompts y dos imágenes para después del aviso de diseño listo. Alcance documental, no ejecución de las instrucciones del adjunto.

## Antes/después

Los prompts estaban en un adjunto de conversación y las imágenes en archivos temporales. Se conservan copias en [pendientes/espacio-trabajo-brazo](../docs/pendientes/espacio-trabajo-brazo/README.md), con los cinco pasos sin iniciar y condición de reanudación explícita. Las imágenes ya fueron recibidas; el trabajo definitivo espera diseño listo y aviso del usuario.

## Productores/consumidores/wire

Material de referencia para futuro trabajo CAD, cálculo, Web y documentación. Sin cambios en contratos operativos, comandos, versiones wire, firmware o capacidades.

## Secuencia

Pendiente: 1 datos geométricos → 2 vistas técnicas → 3 cálculo de envolvente → 4 representación Web → 5 láminas. No iniciar automáticamente. Las autorizaciones incluidas en el texto guardado solo se consideran al recibir el pedido futuro de ejecución.

## Estado por módulo

| Módulo | Estado de esta ficha |
|---|---|
| atmega | Sin cambios |
| esp | Sin cambios |
| web | Sin cambios; integración futura pendiente |
| cad | Sin cambios; diseño final y ejecución futura pendientes |
| shared | Prompts originales y dos imágenes preservados; checklist de cinco etapas y enlace en roadmap |

Sin tests, builds, validadores, cálculos cinemáticos, renderizado de vistas nuevas, flasheos ni hardware. Informe y Documentacion/ sin cambios. Sin commit ni publicación Git.
