kobachajchir/ProyectoRobotica2/AutoFinalRobo2-Contracts/changes/2026-10-23-06-cad-candidates.md

# AFR2-20261023-06 — Adquisición de candidatos CAD

Fecha: 23/10/2026.

Solicitud: listar componentes, buscar modelos correspondientes en Internet y guardarlos para revisión del usuario antes de modelar. Corrección posterior: el chasis se modelará a mano y deja de buscarse.

CAD: primer lote de candidatos externos guardado en vendor/, con procedencia, recuperación y hashes versionados. [Lista y diferencias](../../AutoFinalRobo2-CAD/docs/REVISION_CANDIDATOS_3D.md). No hay aprobación de modelos, geometría creada, adaptaciones ni ensamble. Sensor OSOYOO localizado pero descarga requiere inicio de sesión; otros faltantes documentados.

Atmega: fuente parcial, sin cambio. ESP: esqueleto, sin cambio. Web: esqueleto, sin cambio. CAD: candidatos descargados, pendientes de revisión. No se modifica el contrato eléctrico ni el protocolo.

Sin tests, builds, validadores, flasheos ni pruebas físicas. Sin commit/push solicitado en esta etapa.
