kobachajchir/ProyectoRobotica2/AutoFinalRobo2-Contracts/changes/2026-10-24-01-wheels-blender.md

# AFR2-20261024-01 — Ruedas y Blender

Pedido: colocar/clonar rueda importada con apriete en la muesca, guardar fotos y llevar el ensamble a Blender para render y archivo menor de 900 KB. Usuario autorizó casquillos de referencia Ø6→Ø4.

CAD: Fusion AutoFinalRobo2 v16 guardado con descripción, manos opuestas en diagonales, prisioneros y cuatro casquillos de referencia. Capas conservadas. F3D/Blender editables, piezas exportadas y vistas guardadas. GLB **827.232 bytes**, materiales PBR, Draco; detallado conservado. Sin mapas de imagen independientes en CAD exportado.

Atmega: fuente parcial sin cambios. ESP: esqueleto sin cambios. Web: esqueleto sin cambios, sin integración del GLB. Sin tests/builds ni compatibilidad física comprobada. Inferencias/casquillos sin tolerancias de fabricación. Sin commit/push solicitado.

[Proceso, archivos y límites](../../AutoFinalRobo2-CAD/docs/RUEDAS_Y_BLENDER_20261024.md).
