kobachajchir/ProyectoRobotica2/AutoFinalRobo2-Contracts/changes/2026-10-23-05-fusion-plan-and-origin.md

# AFR2-20261023-05 - Plan Fusion y origin privado

Fecha: 2026-10-23. Pedido explícito del usuario: guardar el plan acordado, crear el repositorio privado kobachajchir/ProyectoRobotica2, commit y push para continuar desde otra PC.

[Plan completo](../../AutoFinalRobo2-CAD/docs/PLAN_MODELO_3D_FUSION.md). Ensamble futuro del auto base mediante el MCP de Fusion existente; inventario del manual/informe, CAD de mejor correspondencia y calidad, descargas Web e inferencias justificadas/editables. Sin cables/mazos/jumpers; conectores físicos sí.

Pieza nueva, soporte, PCB y modificación de cubierta siguen pendientes. Reservar espacio y preparar modelos del OLED 0,96 pulgadas, encoder mecánico KY-040 sin su placa breakout y perilla. Las búsquedas de la planificación solo identifican candidatos; no se descargaron ni adaptaron modelos.

Se enlaza el plan desde la raíz, CAD y Contracts y se aclaran las reglas/contexto para distinguir ensamble base de la pieza pendiente. Ningún código de consumidor, wire, capability, manifest histórico o insumo CAD cambia.

| Área | Estado |
| --- | --- |
| atmega | Fuente parcial; código sin cambio; backend/control pendientes |
| esp | Esqueleto; código sin cambio; bridge/configuración pendientes |
| web | Esqueleto; código sin cambio; port funcional pendiente |
| cad | Plan registrado; búsqueda/descarga y ensamble pendientes de ejecución en otra PC |
| shared | Documentación/contexto; origin privado creado/vinculado para el Git global |

Git: conservar historiales y cuatro etiquetas archive/pre-monorepo/*. Publicar main sin reescribir historial, sin subir .git/legacy-repositories, dependencias instaladas ni exportaciones regenerables. Estado de entrega/remoto en docs/ESTRUCTURA_Y_GIT.md y provenance/ENTREGA.md.

No se ejecutaron tests, compilaciones, validadores, ERC/DRC, simulaciones, flasheos ni pruebas físicas. No se abrió Fusion ni se creó geometría.
