kobachajchir/ProyectoRobotica2/AutoFinalRobo2-Contracts/changes/2026-10-23-01-bootstrap.md

# AFR2-20261023-01 - base independiente

Fecha 2026-10-23; origen pedido del usuario; diseño/fuente parcial, sin despliegue.

Antes: referencias AutoMicro F4/ESP/Web. Después: cuatro repos AutoFinalRobo2; AVR C, ESP12S Arduino/LittleFS, React/Vite. Sin MPU/AT/DMA. Propuesta UI CLK D40, DT D41, SW D42, SDA D20/SCL D21.

Navegación acordada: giro, corto confirma, largo abre menú, atrás por opción de submenú; sin botón menú. Debounce20/largo800 ms son ajustes iniciales, no valores pedidos por el usuario. IDs locales UI no son IDs wire.

UNER v2 candidato, IDs/payloads propios pendientes; no compatibilidad declarada. Ver contracts/PROTOCOL.md. Atmega tiene biblioteca OLED/Manager/UI parcial; falta TWI/UART/sensores/control/GOTO. ESP/Web tienen referencia y esqueletos. Contracts queda preparado.

Sin tests/build/validadores/flash/hardware. Estado Git en provenance/ENTREGA.md. Sin cambios ni fichas en AutoMicro.
