kobachajchir/ProyectoRobotica2/AutoFinalRobo2-Contracts/docs/history/alignment15/README.md

# Planes anteriores a AFR2-20261024-15

Copias íntegras anteriores a la reconciliación del maestro. Se preservan como
evidencia histórica, no como instrucciones ni lista actual de pendientes.
Los enlaces relativos de cada copia conservan el contexto de su ubicación
original y pueden no resolver desde este archivo. Origen/hash en manifest.json.

Estado actual: [alineación del maestro](../../ALINEACION_MAESTRO.md).
