kobachajchir/ProyectoRobotica2/AutoFinalRobo2-Contracts/changes/2026-11-09-08-esp-ws-oom.md

# AFR2-20261109-08 — OOM del ESP al conectar WebSocket

Fecha: 09/11/2026. Origen: log aportado por el usuario con firmware 1.10.2.

Versión: 1.10.4 (subversión mínima).

## Evidencia y alcance del diagnóstico

A las 16:27:05.616 el log registra `Unhandled C++ exception: OOM`, seguido de
`ctx: cont` y un nuevo arranque ESP con `rst=4 soft-restart`. La excepción por
falta de memoria es evidencia directa; el reinicio es su consecuencia. El ruido
de ROM detectado por el ATmega es un indicio del arranque posterior.
`stack>=453B` pertenece al ATmega, no al heap del ESP.

La inspección de fuente identifica un pico evitable: `system.hello`,
`system.alive` y `system.status` construían el estado completo con capacidades,
lo serializaban en un `String` y llamaban a `text(String)`. En la dependencia
instalada ESPAsyncWebServer 3.10.3, esa sobrecarga crea otro vector con copia del
mensaje mediante `std::make_shared`. El árbol JSON y el String seguían vivos.
Además, se construían estados opcionales antes de comprobar la cola y podían
acumularse hasta dos en esa ruta, además de las respuestas.

El core ESP8266 instalado (`cores/esp8266/abi.cpp`) aborta con `OOM` cuando falla
un `new` ordinario sin excepciones habilitadas. La ruta encontrada es compatible
con el síntoma, pero el log recorta diez filas de pila: no se identificó la
reserva exacta que falló ni se reprodujo el fallo.

## Cambio por archivo

- `ESP/src/broker.h`: respuestas diferidas y resultado de búsqueda conservan
  `AsyncWebSocketSharedBuffer`; salida opcional solo con cola de datos vacía.
- `ESP/src/broker.cpp`: `makeFrame` mide el JSON y serializa directamente al
  vector compartido que consume WS. Libera el documento antes de iniciar TCP;
  elimina el String y la copia posterior del mensaje. Rechaza documentos con
  `overflowed()` y escrituras incompletas. Conserva el máximo de 8192 bytes.
  Antes de reservar exige heap libre de longitud+4096 y bloque contiguo de
  longitud+256. Respuesta obligatoria sin memoria cierra WS con 1013; eventos
  opcionales sin memoria se omiten. Los umbrales son conservadores, no medidos
  ni garantía de ausencia de OOM bajo toda carga HTTP/Wi-Fi.
- `ESP/src/broker.cpp`: una respuesta puede quedar diferida mientras sale la
  anterior; espera cola vacía sin volver a copiar. Desconectar libera los
  buffers pendientes de esa sesión. Broadcast omite eventos sin receptor y
  libera su payload temporal tras copiarlo al sobre.
- `ESP/src/broker_product.cpp`: comprueba contrapresión antes de construir el
  catálogo de estado y usa el mismo buffer compartido.
- `ESP/src/broker_sensors.cpp`: evento `robot.screen.changed` sin String y sin
  documento intermedio adicional; comprueba contrapresión antes de construirlo.
- `ESP/src/main.cpp`: `/diagnostico` y `/api/health` agregan `freeHeapBytes` y
  `maxFreeBlockBytes`, accesibles sin conectar WS. `connectionDiagnostics` del
  estado WS agrega ambos valores y `wsMemoryDrops` (contador de descartes o
  respuestas no construidas por límite de memoria/tamaño/integridad JSON).
- `Contracts/contracts/afr2_build_info.h`, `Web/package.json` y las dos versiones
  raíz de `Web/package-lock.json`: versión de producto compartida 1.10.4.

## Productores, consumidores y secuencia

Se conservan `afr2-ws-1`, comandos, payloads de capacidades, requestId,
correlación, STOP prioritario y límite de una sesión. Los diagnósticos nuevos
son campos adicionales. No cambia ningún CMD ESP↔ATmega, EEPROM ni EX01.

La pérdida de sesión conserva la revocación de operaciones Web. Los estados
periódicos son descartables bajo contrapresión; las respuestas se difieren
hasta 2 s y luego cierran con 1013. No se envía un JSON parcial como éxito.

## Estado real

- esp: fuente corregida; sin compilar, cargar ni comprobar en hardware.
- atmega/web: solo versión compartida en esta ficha; cambios ajenos conservados.
- CAD/Loader: sin intervención en esta ficha.
- Tests, builds, validadores, navegador, puertos y flasheos: no ejecutados.
- Sin commit ni publicación realizados por esta tarea.

Pendiente de pedido expreso: compilar/cargar y comprobar conexión, reconexión y
concurrencia con descargas HTTP. Si reaparece el OOM, conservar la pila completa
y los valores de heap/bloque libre para ubicar la reserva concreta.

Referencia de memoria JSON: [ArduinoJson 7 / JsonDocument](https://arduinojson.org/v7/api/jsondocument/).
