kobachajchir/ProyectoRobotica2/AutoFinalRobo2-Contracts/changes/2026-11-04-32-esp-24-assets.md

# AFR2-20261104-32 — El ESP admite 24 activos Web y 12 KiB de manifiesto

04/11/2026. Pedido humano: ampliar a 24 la tabla de activos Web, porque el paquete tiene 17 archivos y el firmware admitía 16.

Continúa AFR2-20261103-31.

## Cambios
| Módulo | Archivo | Antes | Ahora |
| --- | --- | --- | --- |
| esp | `src/storage.h` | `assets_[16]` | `kMaxAssets = 24` y `assets_[kMaxAssets]` |
| esp | `src/storage.cpp` | manifiesto ≤ 8192 B y `list.size() > 16` | manifiesto ≤ 12288 B y `list.size() > kMaxAssets` |
| web | `tools/package-web.mjs` | error si hay más de 16 archivos | error si hay más de 24, y si el manifiesto supera 12288 B |
| contracts | `contracts/PROTOCOL.md` | hasta 16 activos / 8192 B | hasta 24 activos / 12288 B |

## Costo estimado en RAM (no medido)
- 8 entradas más de `WebAsset` (cuatro `String` y un tamaño): unos 400 B fijos.
- Cada archivo usado agrega unos 300 B de heap por sus textos.
- El manifiesto se lee entero con ArduinoJson al arrancar: el pico temporal sube con el límite de 12288 B.
- Flash y LittleFS no cambian.

## Paquete generado (`npm run build:esp`, Web 0.4.0, perfil esp)
- 17 archivos; 4.656.048 B → 2.484.938 B con gzip.
- Estimación LittleFS: 2.629.632 B de 2.867.200 B (91,7 %). Es contabilidad conservadora, no una medición de la placa.
- `manifest.json`: 5.953 B, dentro del límite anterior de 8 KiB y del nuevo de 12 KiB.
- Promovido a `AutoFinalRobo2-ESP/data/dist` (ignorado por Git). Infraestructura lee este manifiesto.
- El firmware con la tabla de 24 aún no está compilado ni cargado: hasta entonces la placa rechaza el paquete de 17 archivos.

## Estado por repo
- **esp:** fuente modificada. Sin compilar ni flashear; hay que medir el heap libre en la placa antes de darlo por bueno.
- **web:** empaquetador modificado. Paquete ESP regenerado (17 archivos); Infraestructura lee el manifiesto nuevo.
- **atmega / loader:** sin cambios.
- Sin commit.
