kobachajchir/ProyectoRobotica2/AutoFinalRobo2-Contracts/changes/2026-11-03-28-wifi-no-data.md

# AFR2-20261103-28 — Estado de red sin datos

03/11/2026. Pedido humano: en Conexión → Estado de red, cuando no hay datos el panel entero debe decir «Sin datos» con un ícono abajo.

## Cambio en Web/src
- `features/wifi/WifiPage.tsx`: sin datos vigentes (sin enlace o sin lectura de menos de 5 s), el panel muestra «Sin datos», un ícono de Wi-Fi y el botón «Actualizar estado»; ya no aparecen las listas de guiones. Con datos, el panel no cambia y el título solo dice Conectado o Desconectado.
- `styles/workspace.css`: bloque `.afr2-wifi-empty`.

## Estado por repo
- **atmega / esp / loader:** sin cambios.
- **web:** fuente modificada. Verificado en el navegador local sin robot (estado vacío). No verificado: el panel con datos reales ni compilación TypeScript.
- Sin commit.

## Ajuste posterior (mismo ID)
- Sin datos: el ícono de Wi-Fi va arriba, sin círculo ni fondo, con «Sin datos» debajo; el botón «Actualizar estado» queda más separado hacia abajo.
- `features/oled/EncoderControl.tsx`: `console.log` temporal por cada tecla que reconoce el captor de Pantalla en vivo (Espacio abajo/arriba/mantenido, ← y → abajo/arriba/repetida, Enter). Era solo para probar: se quitó en AFR2-20261103-27 (ajuste «todo al soltar»).

## Escape con animación (mismo ID)
- `components/ui/FloatingModal.tsx`: Escape (evento `cancel` del diálogo) cierra con la animación de reducción del botón de cierre (`close(false)`), en lugar del cierre instantáneo. Vale para todos los diálogos flotantes. Con movimiento reducido sigue siendo el cierre corto. Verificado en el navegador local con un evento `cancel`: pasa por `closing/animated` y cierra; no probado con la tecla real.
