kobachajchir/ProyectoRobotica2/AutoFinalRobo2-Contracts/changes/2026-11-02-24-help-descriptors-loader-page.md

# AFR2-20261102-24 — Descriptores técnicos en Ayuda y página del Loader en Explorar

02/11/2026. Pedido humano:
- hacer más lindo y más técnico el texto descriptor de cada sección de Ayuda;
- agregar en Explorar información sobre el Loader (función, qué hace, por qué es útil), técnica y con el mismo estilo visual que las demás secciones.

Continúa AFR2-20261102-23.

## Ayuda: tarjeta de cada módulo

El párrafo suelto se reemplaza por una tarjeta con la familia clara/oscura `--infra-hero-*` de las cabeceras. Tiene:
- ícono de zona;
- rol: Controlador de tiempo real, Pasarela Wi-Fi y servidor, Consola en el navegador o Interfaz local del auto;
- nombre del componente;
- descripción técnica reescrita;
- cuatro celdas de especificaciones.

| Módulo | Especificaciones |
| --- | --- |
| ATmega2560 | AVR 8 bits a 16 MHz · 256 KiB flash, 8 KiB SRAM, 4 KiB EEPROM · C gnu11 + avr-libc · ROBO2 por USART1 a 115200 |
| ESP8266 · ESP-12S | Xtensa L106 a 80 MHz · 4 MiB de flash con 3 MiB de LittleFS · C++17 con PlatformIO · HTTP y WebSocket /ws |
| Web | 0.4.0 · React 19, TypeScript 5.9 y Vite 7 · Three 0.180, R3F 9 y Draco · afr2-ws-1 |
| OLED + encoder | SSD1306 128×64 por I2C · TWI 100 kHz · KY-040 en INT4/INT5 + D42 · largo ≥ 800 ms al soltar |

En celular el ícono pasa arriba y las celdas quedan en dos columnas. Con transparencia reducida o contraste alto se quitan la grilla y el desenfoque.

## Explorar → Loader (`/loader`)

Nuevo destino en el grupo Explorar, con ícono `arrow-down`; aparece en la barra lateral, en la hoja «Más» y en Inicio.

La página reutiliza el lenguaje de Infraestructura. Las primitivas Reveal, Wire, FlowNode y Stat se movieron sin cambios a `features/infrastructure/infraPrimitives.tsx`.
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
