kobachajchir/ProyectoRobotica2/AutoFinalRobo2-Contracts/changes/2026-11-02-08-fichas-brazo-robot-conjuntos.md

# AFR2-20261102-08 — Fichas del brazo y robot con renders de subconjuntos

Pedido humano: informar si estan todos los planos y producir ficha del brazo completo con renders de los conjuntos al costado, en la zona que ocupaban las vistas acotadas.

Respuesta de alcance: no estan completos. La tanda tiene seis hojas individuales preliminares, de las cuales tres son impresos de los30 identificados; faltan27 impresos y otros fabricados, ademas del acotado funcional.
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
