kobachajchir/ProyectoRobotica2/AutoFinalRobo2-Contracts/changes/2026-11-02-09-despieces-llamadas-locales.md

# AFR2-20261102-09 — Referencias locales en las hojas de despiece

Pedido humano: modificar solo el despiece para que las flechas no atraviesen el dibujo; numeros junto a las piezas y lista lateral de referencias.

Se reemplazaron exclusivamente las paginas5-8 del [PDF de14 laminas](../../AutoFinalRobo2-CAD/mecanica/brazo-antropomorfo/revision_v17/laminas_20261102/AFR2_Laminas_Iniciales_A3.pdf). Las29 referencias se colocan cerca del contorno, con
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
