kobachajchir/ProyectoRobotica2/Revision/R01_20261110/02_Planos/tomos/AFR2_Tomo_1_Montura_y_control_A3.pdf

AFR2-A100 | Montura y control fijo
Fuente F3D 02/11/2026 | Revision V17 | Extraccion BRep 09/11/2026 | No Drawing asociativo

NOTAS Y ALCANCE

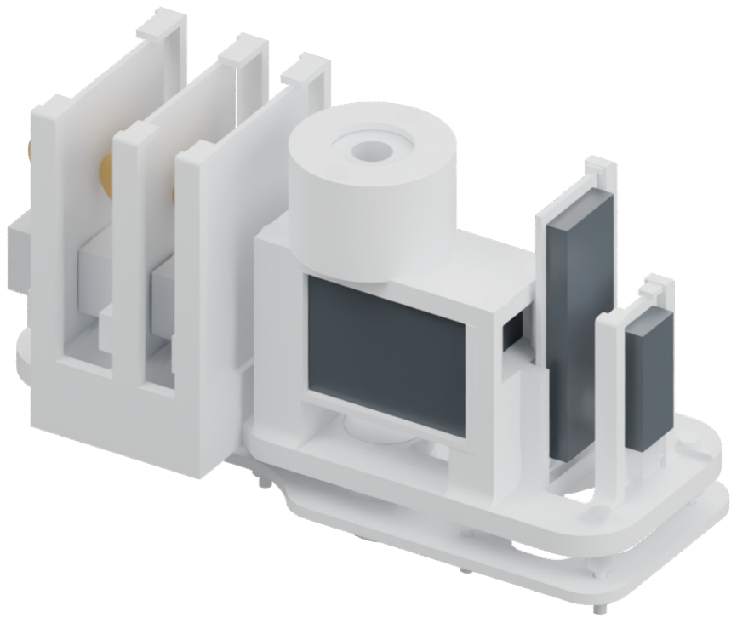
[picture p242: figure]

Conjunto armado desde la captura nativa, con sus orientaciones y ubicaciones guardadas. Lista de ocurrencias en hojas -LP y despieces por tramos -E.
No se modifica la geometria ni se afirma secuencia de montaje/desmontaje comprobada.

### AutoFinalRobo2 | Documentacion mecanica

### Montura y control fijo

AFR2-A100 | REV D | 09/11/2026
Conjunto mixto Koba Chajchir | Cotas nominales CAD Ajustes / proceso pendientes de cierre; sin aprobacion | A3 | mm | Hoja 1/224
| Vistas -- | 3D sin escala
| Proyeccion: primer diedro

AFR2-A100-LP01 | Lista de ocurrencias | Montura y control fijo
001 COMERCIAL/REFERENCIA | V03 Bornera y alimentacion REF
002 COMERCIAL/REFERENCIA | V03 Casquillo central compresion
003 COMERCIAL/REFERENCIA | V03 Nano vertical
004 COMERCIAL/REFERENCIA | V03 PCA9685 vertical
005 AFR2-P101 | V03 Separador M3 A
006 AFR2-P102 | V03 Separador M3 B
007 AFR2-P103 | V03 Separador M3 C
008 AFR2-P104 | V03 Separador M3 D
009 AFR2-P105 | V03 Tapa rodamientos J1
010 COMERCIAL/REFERENCIA | V03 Tuerca arandela M10
011 COMERCIAL/REFERENCIA | V03 Tuerca arandela M3 A
012 COMERCIAL/REFERENCIA | V03 Tuerca arandela M3 B
013 COMERCIAL/REFERENCIA | V03 Tuerca arandela M3 C
014 COMERCIAL/REFERENCIA | V03 Tuerca arandela M3 D
015 COMERCIAL/REFERENCIA | V03 XL4016 vertical 1
016 COMERCIAL/REFERENCIA | V03 XL4016 vertical 2
017 COMERCIAL/REFERENCIA | V03 XL4016 vertical 3
018 AFR2-P106 | V04 Separador M3 E

NOTAS Y ALCANCE

Cada posicion identifica una ocurrencia; los solidos de un mismo comercial se mantienen agrupados. Las placas con hijos Nano/PCA9685/XL4016 se agrupan como unidades comerciales.
Codigo COMERCIAL/REFERENCIA no implica plano de fabricacion propio. Rutas completas en CSV.

### AutoFinalRobo2 | Documentacion mecanica

### Lista de ocurrencias | Montura y control fijo

AFR2-A100-LP01 | REV D | 09/11/2026

Conjunto mixto

| Vistas -- | 3D sin escala

AFR2-A100-LP02 | Lista de ocurrencias | Montura y control fijo
019 AFR2-P107 | V04 Separador M3 F
020 COMERCIAL/REFERENCIA | V04 Tuerca arandela M3 E
021 COMERCIAL/REFERENCIA | V04 Tuerca arandela M3 F
022 COMERCIAL/REFERENCIA | V05 Anclaje M3x25 A
023 COMERCIAL/REFERENCIA | V05 Anclaje M3x25 B
024 COMERCIAL/REFERENCIA | V05 Anclaje M3x25 C
025 COMERCIAL/REFERENCIA | V05 Anclaje M3x25 D
026 COMERCIAL/REFERENCIA | V05 Anclaje M3x25 E
027 COMERCIAL/REFERENCIA | V05 Anclaje M3x25 F
028 COMERCIAL/REFERENCIA | V05 M10x30 DIN7991 REF
029 AFR2-P108 | V05 Montura baja PETG
030 AFR2-P109 | V06 Contraplaca inferior unica PETG
031 COMERCIAL/REFERENCIA | V09 Arandela tirante 0
032 COMERCIAL/REFERENCIA | V09 Arandela tirante 1
033 COMERCIAL/REFERENCIA | V09 Arandela tirante 2
034 COMERCIAL/REFERENCIA | V09 Arandela tirante 3
035 AFR2-P110 | V09 Cartucho6000 desmontable PETG
036 COMERCIAL/REFERENCIA | V09 Inserto tapa -1

NOTAS Y ALCANCE

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

### AutoFinalRobo2 | Documentacion mecanica

### Lista de ocurrencias | Montura y control fijo

AFR2-A100-LP02 | REV D | 09/11/2026

Conjunto mixto

| Vistas -- | 3D sin escala

AFR2-A100-LP03 | Lista de ocurrencias | Montura y control fijo

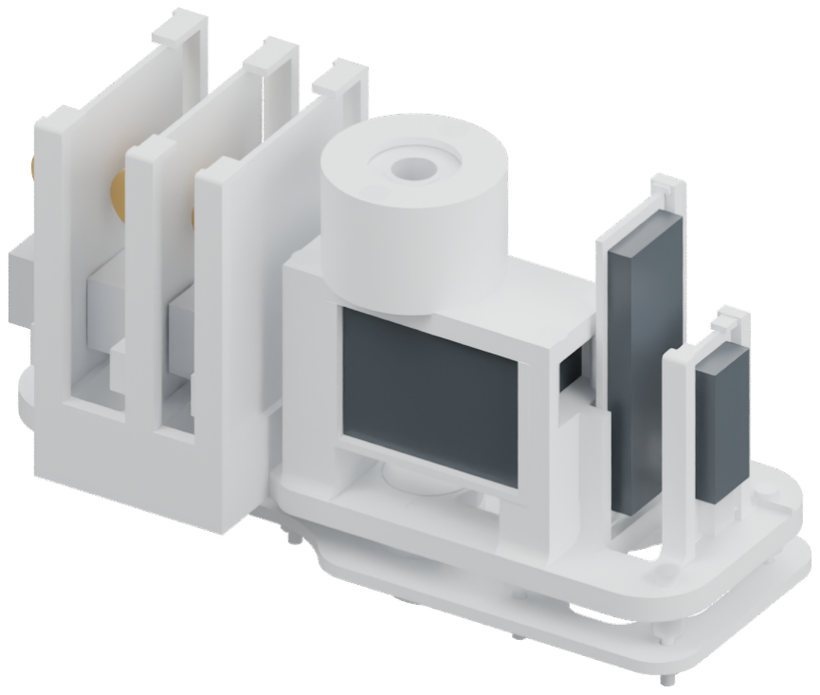
[picture p243: figure]

037 COMERCIAL/REFERENCIA | V09 Inserto tapa 1
038 COMERCIAL/REFERENCIA | V09 Perno tapa -1
039 COMERCIAL/REFERENCIA | V09 Perno tapa 1
040 COMERCIAL/REFERENCIA | V09 R01 6000 J1 inferior
041 COMERCIAL/REFERENCIA | V09 R01 6000 J1 superior
042 COMERCIAL/REFERENCIA | V09 Tirante M3x60 0
043 COMERCIAL/REFERENCIA | V09 Tirante M3x60 1
044 COMERCIAL/REFERENCIA | V09 Tirante M3x60 2
045 COMERCIAL/REFERENCIA | V09 Tirante M3x60 3
046 COMERCIAL/REFERENCIA | V09 Tuerca tirante 0
047 COMERCIAL/REFERENCIA | V09 Tuerca tirante 1
048 COMERCIAL/REFERENCIA | V09 Tuerca tirante 2
049 COMERCIAL/REFERENCIA | V09 Tuerca tirante 3
050 COMERCIAL/REFERENCIA | V17 M03 STS3250 remoto

NOTAS Y ALCANCE

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

### AutoFinalRobo2 | Documentacion mecanica

### Lista de ocurrencias | Montura y control fijo

AFR2-A100-LP03 | REV D | 09/11/2026

Conjunto mixto

| Vistas -- | 3D sin escala

AFR2-A100-E1 | Despiece isometrico | Montura y control fijo

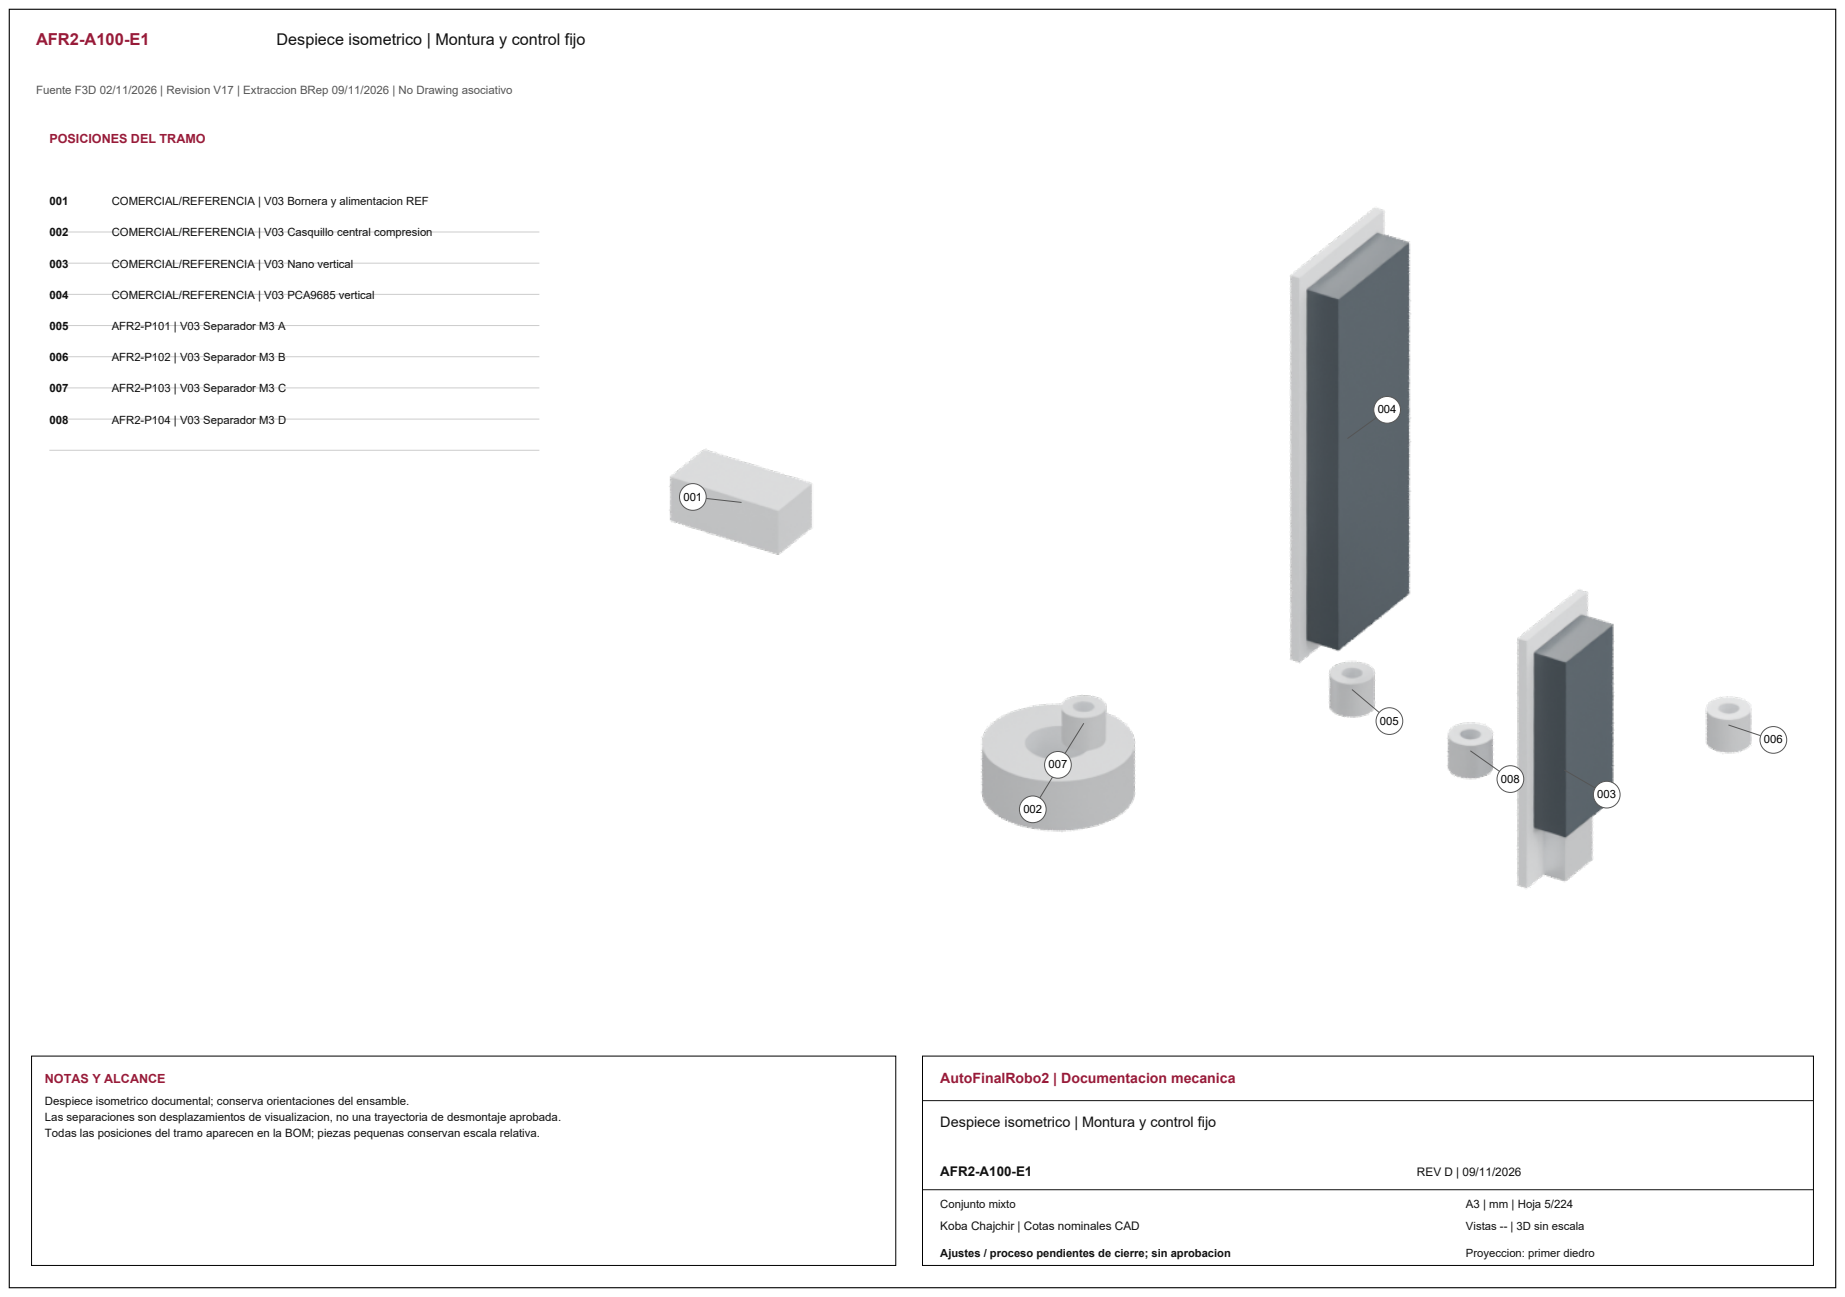
[picture p244: page 5]
005 AFR2-P101 | V03 Separador M3 A; 006 AFR2-P102 | V03 Separador M3 B; 007 AFR2-P103 | V03 Separador M3 C; 008 AFR2-P104 | V03 Separador M3 D; NOTAS Y ALCANCE; AutoFinalRobo2 | Documentacion mecanica; AFR2-A100-E1; REV D | 09/11/2026; Conjunto mixto

POSICIONES DEL TRAMO

001 COMERCIAL/REFERENCIA | V03 Bornera y alimentacion REF

002 COMERCIAL/REFERENCIA | V03 Casquillo central compresion

003 COMERCIAL/REFERENCIA | V03 Nano vertical

004 COMERCIAL/REFERENCIA | V03 PCA9685 vertical

Despiece isometrico documental; conserva orientaciones del ensamble.
Las separaciones son desplazamientos de visualizacion, no una trayectoria de desmontaje aprobada.
Todas las posiciones del tramo aparecen en la BOM; piezas pequenas conservan escala relativa.

Despiece isometrico | Montura y control fijo

Vistas -- | 3D sin escala

AFR2-A100-E2 | Despiece isometrico | Montura y control fijo

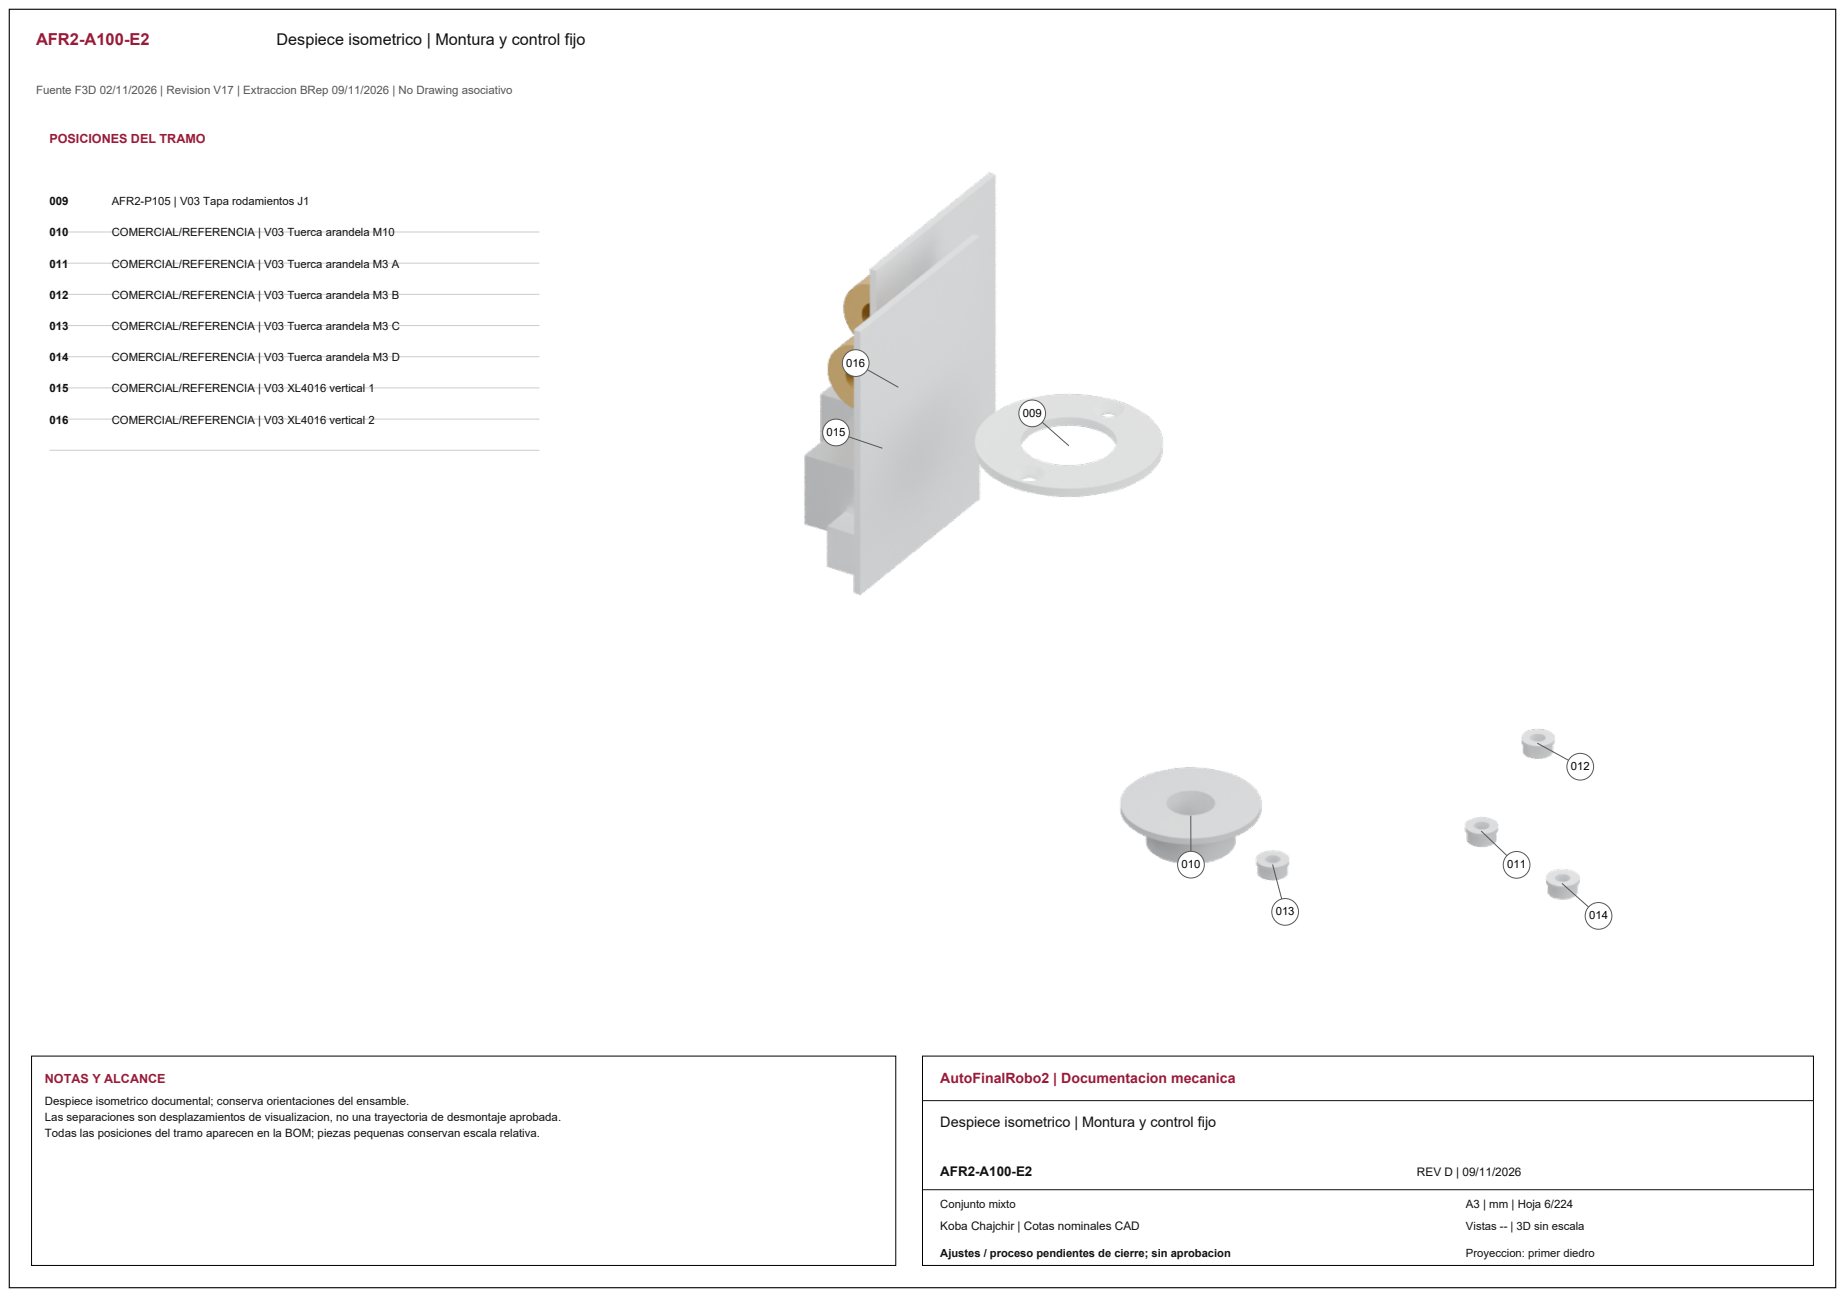
[picture p245: page 6]
009 AFR2-P105 | V03 Tapa rodamientos J1; COMERCIAL/REFERENCIA | V03 XL4016 vertical 2; NOTAS Y ALCANCE; AutoFinalRobo2 | Documentacion mecanica; AFR2-A100-E2; REV D | 09/11/2026; Conjunto mixto

POSICIONES DEL TRAMO

010 COMERCIAL/REFERENCIA | V03 Tuerca arandela M10

011 COMERCIAL/REFERENCIA | V03 Tuerca arandela M3 A

012 COMERCIAL/REFERENCIA | V03 Tuerca arandela M3 B

013 COMERCIAL/REFERENCIA | V03 Tuerca arandela M3 C

014 COMERCIAL/REFERENCIA | V03 Tuerca arandela M3 D

015 COMERCIAL/REFERENCIA | V03 XL4016 vertical 1

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

Despiece isometrico | Montura y control fijo

Vistas -- | 3D sin escala

AFR2-A100-E3 | Despiece isometrico | Montura y control fijo

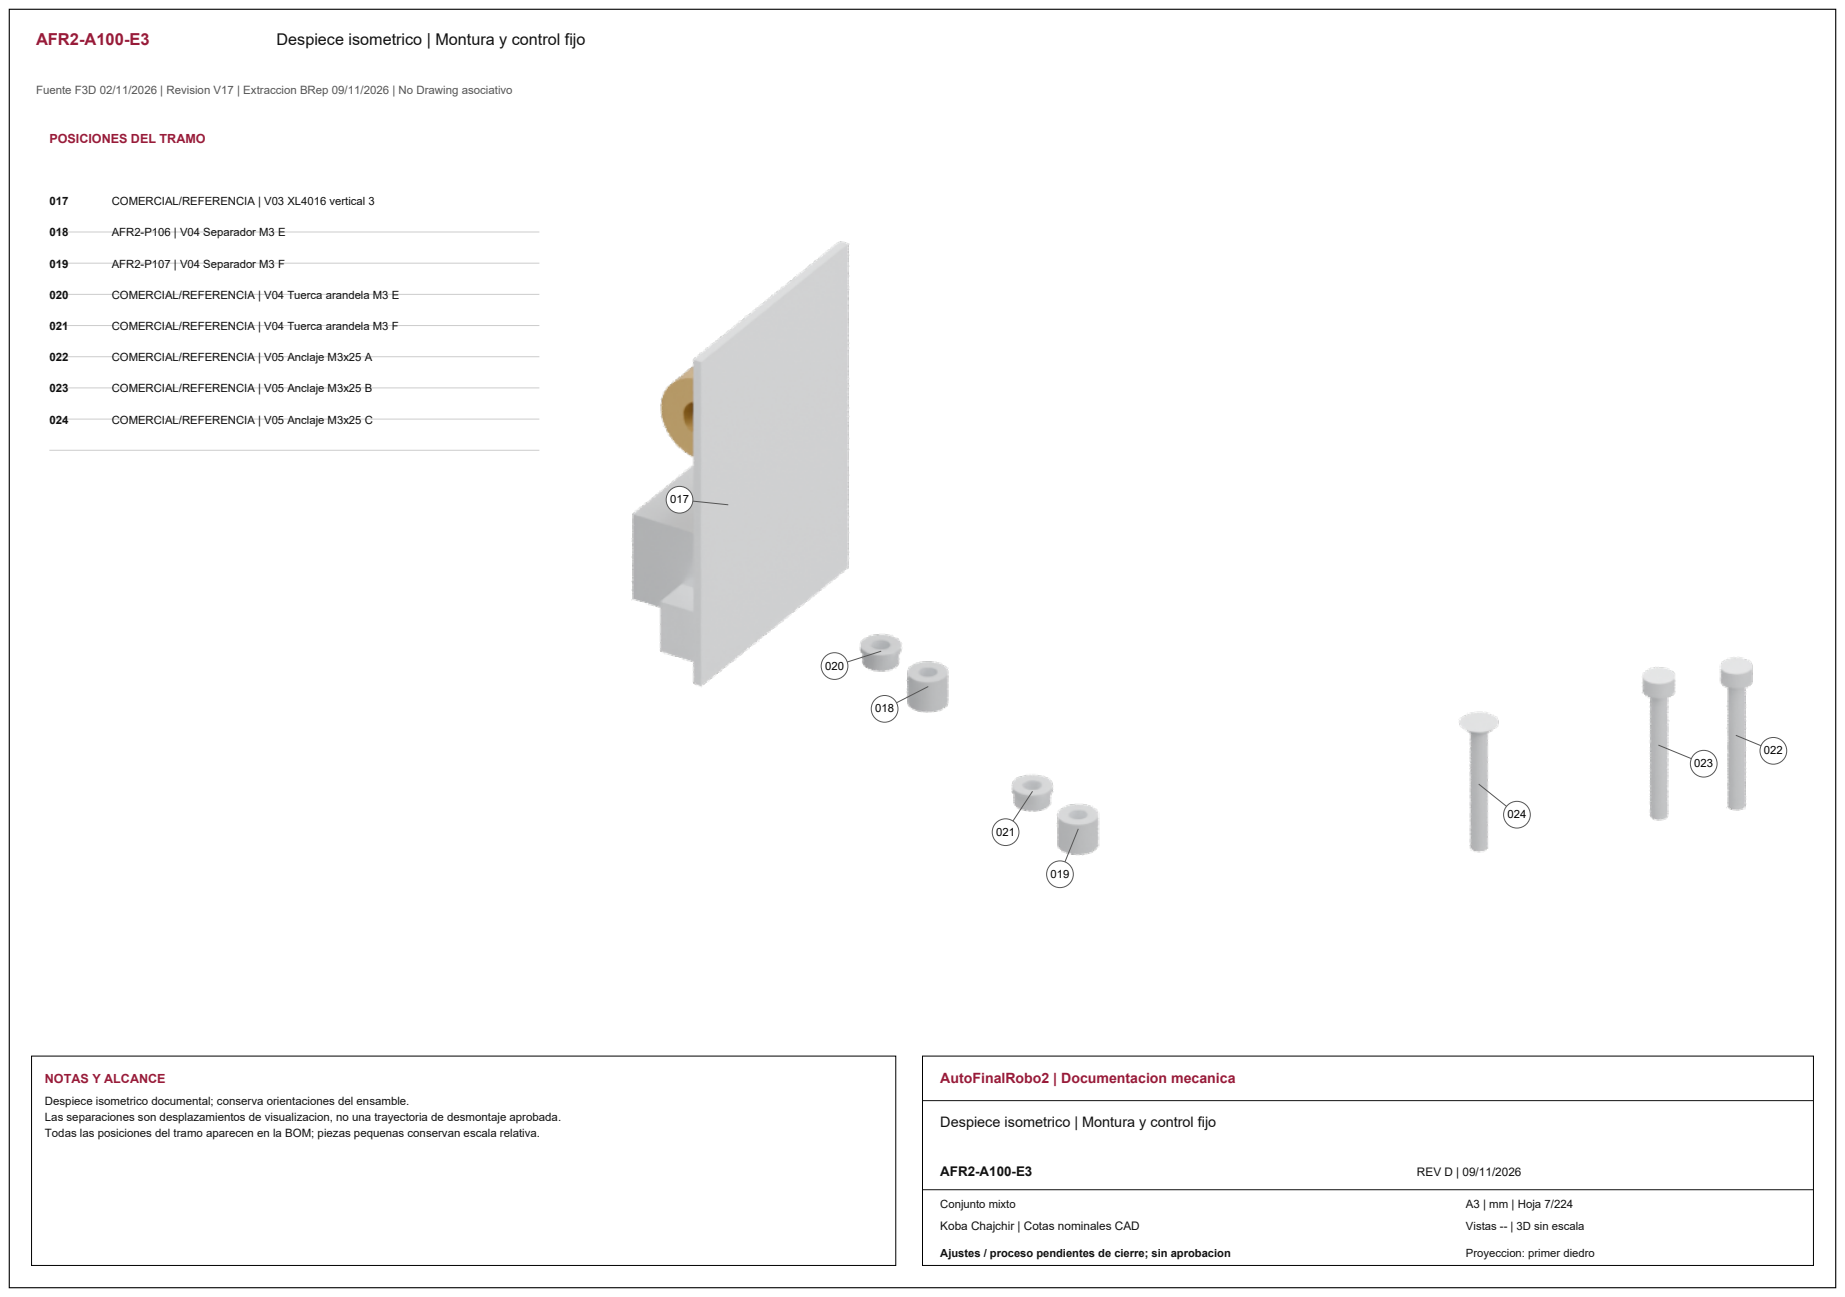
[picture p246: page 7]
018 AFR2-P106 | V04 Separador M3 E; 019 AFR2-P107 | V04 Separador M3 F; NOTAS Y ALCANCE; AutoFinalRobo2 | Documentacion mecanica; AFR2-A100-E3; REV D | 09/11/2026; Conjunto mixto

POSICIONES DEL TRAMO

017 COMERCIAL/REFERENCIA | V03 XL4016 vertical 3

020 COMERCIAL/REFERENCIA | V04 Tuerca arandela M3 E

021 COMERCIAL/REFERENCIA | V04 Tuerca arandela M3 F

022 COMERCIAL/REFERENCIA | V05 Anclaje M3x25 A

023 COMERCIAL/REFERENCIA | V05 Anclaje M3x25 B

024 COMERCIAL/REFERENCIA | V05 Anclaje M3x25 C

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

Despiece isometrico | Montura y control fijo

Vistas -- | 3D sin escala

AFR2-A100-E4 | Despiece isometrico | Montura y control fijo

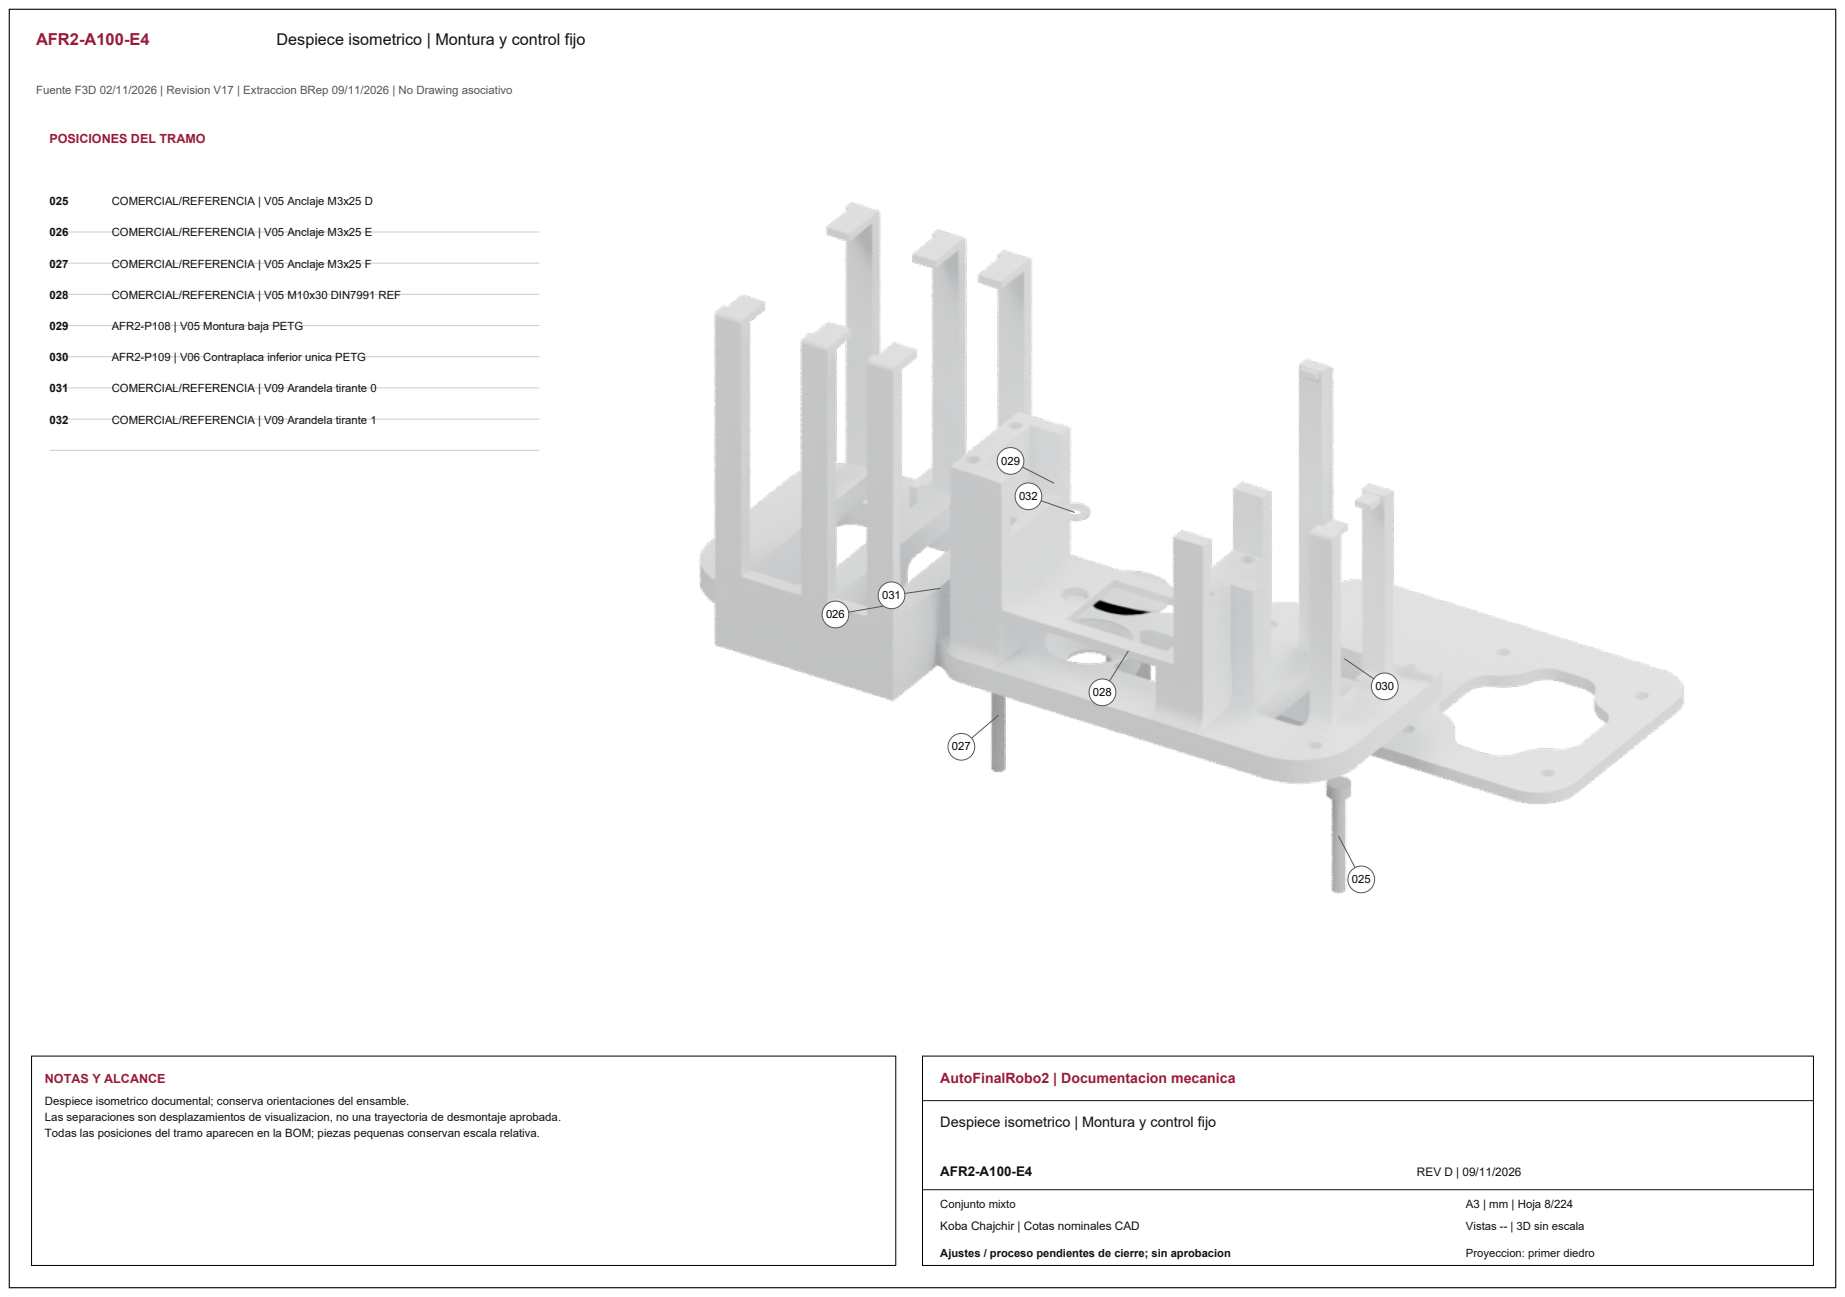
[picture p247: page 8]
NOTAS Y ALCANCE; AutoFinalRobo2 | Documentacion mecanica; AFR2-A100-E4; REV D | 09/11/2026; Conjunto mixto

POSICIONES DEL TRAMO

025 COMERCIAL/REFERENCIA | V05 Anclaje M3x25 D

026 COMERCIAL/REFERENCIA | V05 Anclaje M3x25 E

027 COMERCIAL/REFERENCIA | V05 Anclaje M3x25 F

028 COMERCIAL/REFERENCIA | V05 M10x30 DIN7991 REF

029 AFR2-P108 | V05 Montura baja PETG

030 AFR2-P109 | V06 Contraplaca inferior unica PETG

031 COMERCIAL/REFERENCIA | V09 Arandela tirante 0

032 COMERCIAL/REFERENCIA | V09 Arandela tirante 1

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

Despiece isometrico | Montura y control fijo

Vistas -- | 3D sin escala

AFR2-A100-E5 | Despiece isometrico | Montura y control fijo

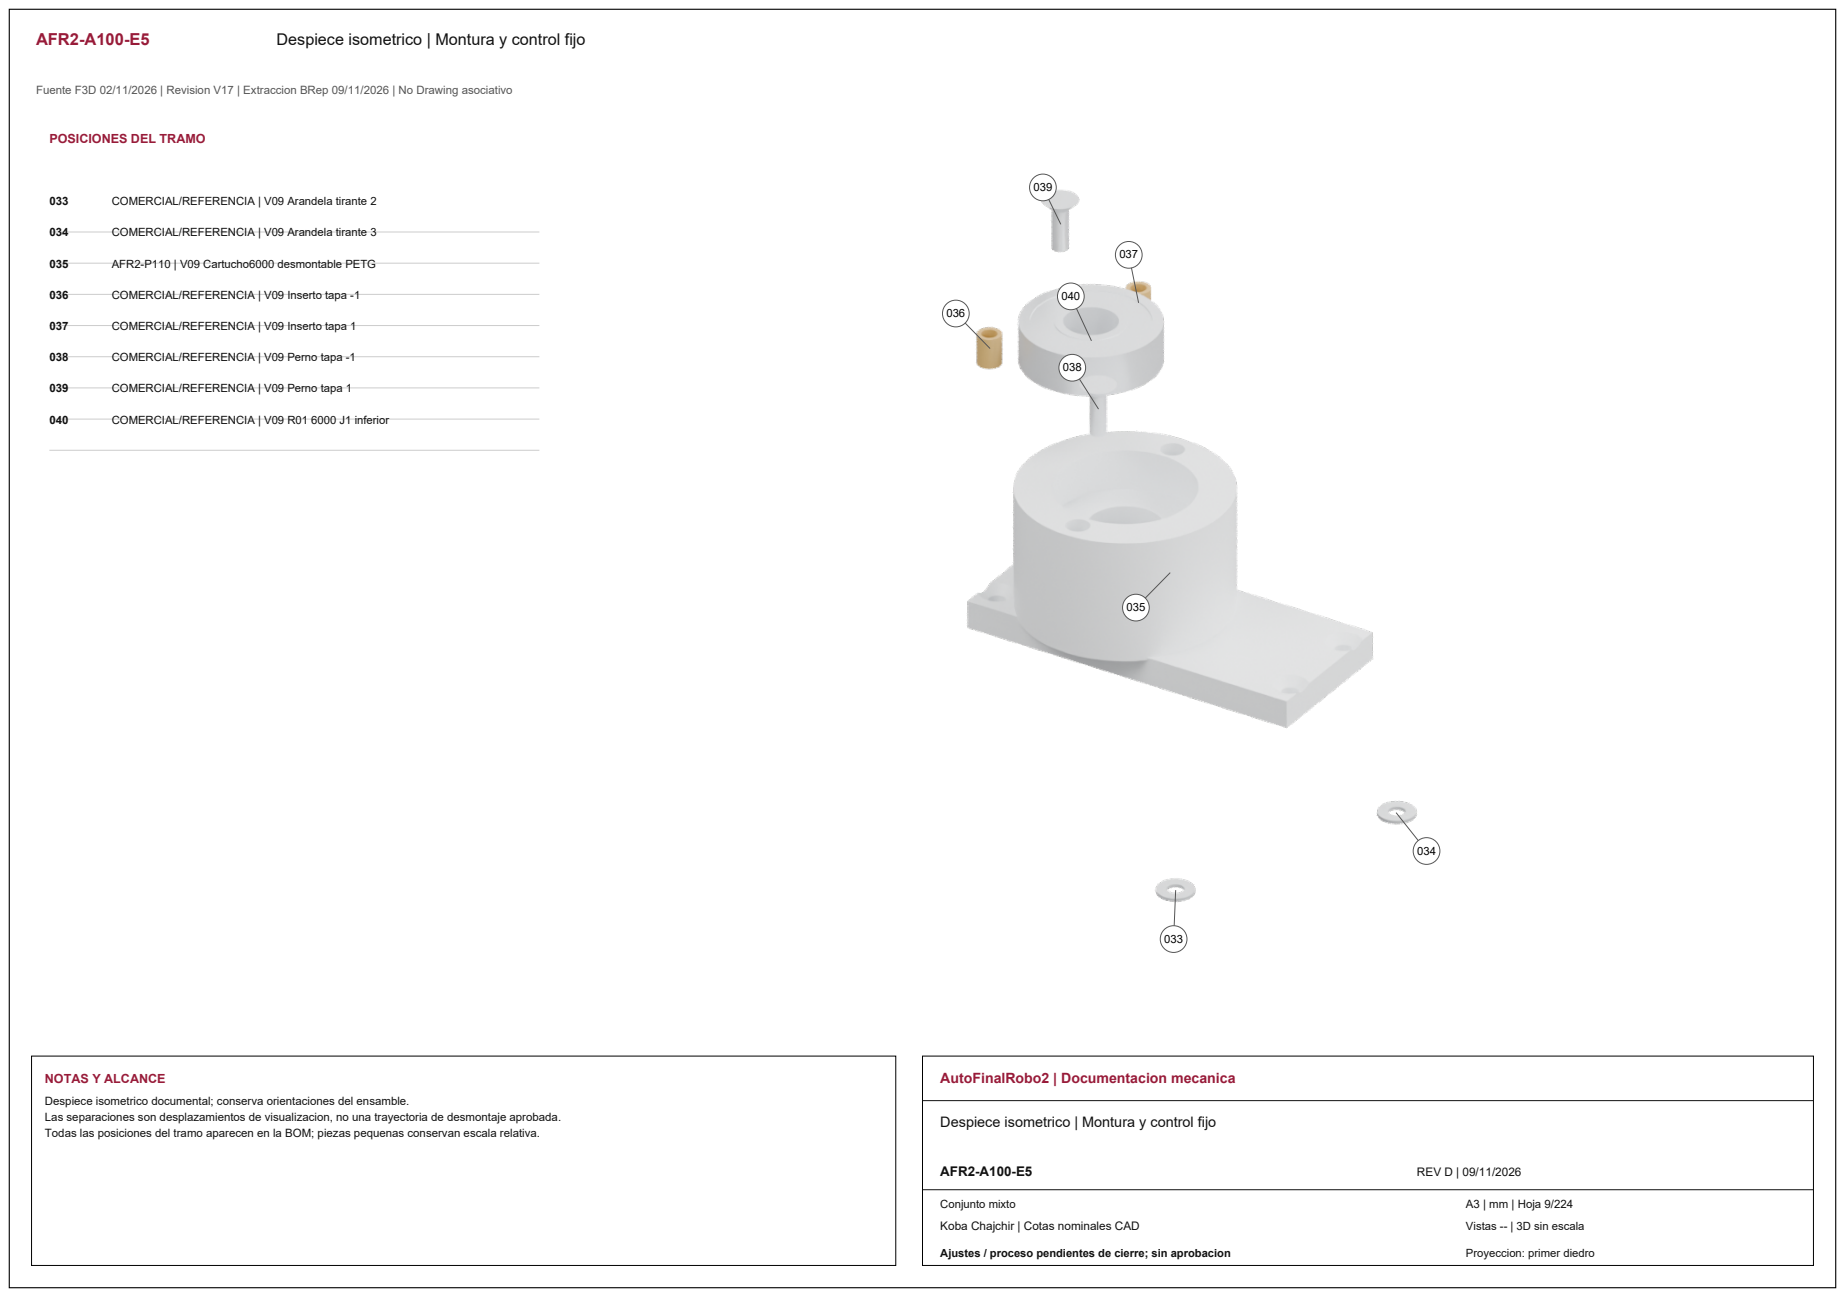
[picture p248: page 9]
035 AFR2-P110 | V09 Cartucho6000 desmontable PETG; NOTAS Y ALCANCE; AutoFinalRobo2 | Documentacion mecanica; AFR2-A100-E5; REV D | 09/11/2026; Conjunto mixto

POSICIONES DEL TRAMO

033 COMERCIAL/REFERENCIA | V09 Arandela tirante 2

034 COMERCIAL/REFERENCIA | V09 Arandela tirante 3

036 COMERCIAL/REFERENCIA | V09 Inserto tapa -1

037 COMERCIAL/REFERENCIA | V09 Inserto tapa 1

038 COMERCIAL/REFERENCIA | V09 Perno tapa -1

039 COMERCIAL/REFERENCIA | V09 Perno tapa 1

040 COMERCIAL/REFERENCIA | V09 R01 6000 J1 inferior

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

Despiece isometrico | Montura y control fijo

Vistas -- | 3D sin escala

AFR2-A100-E6 | Despiece isometrico | Montura y control fijo

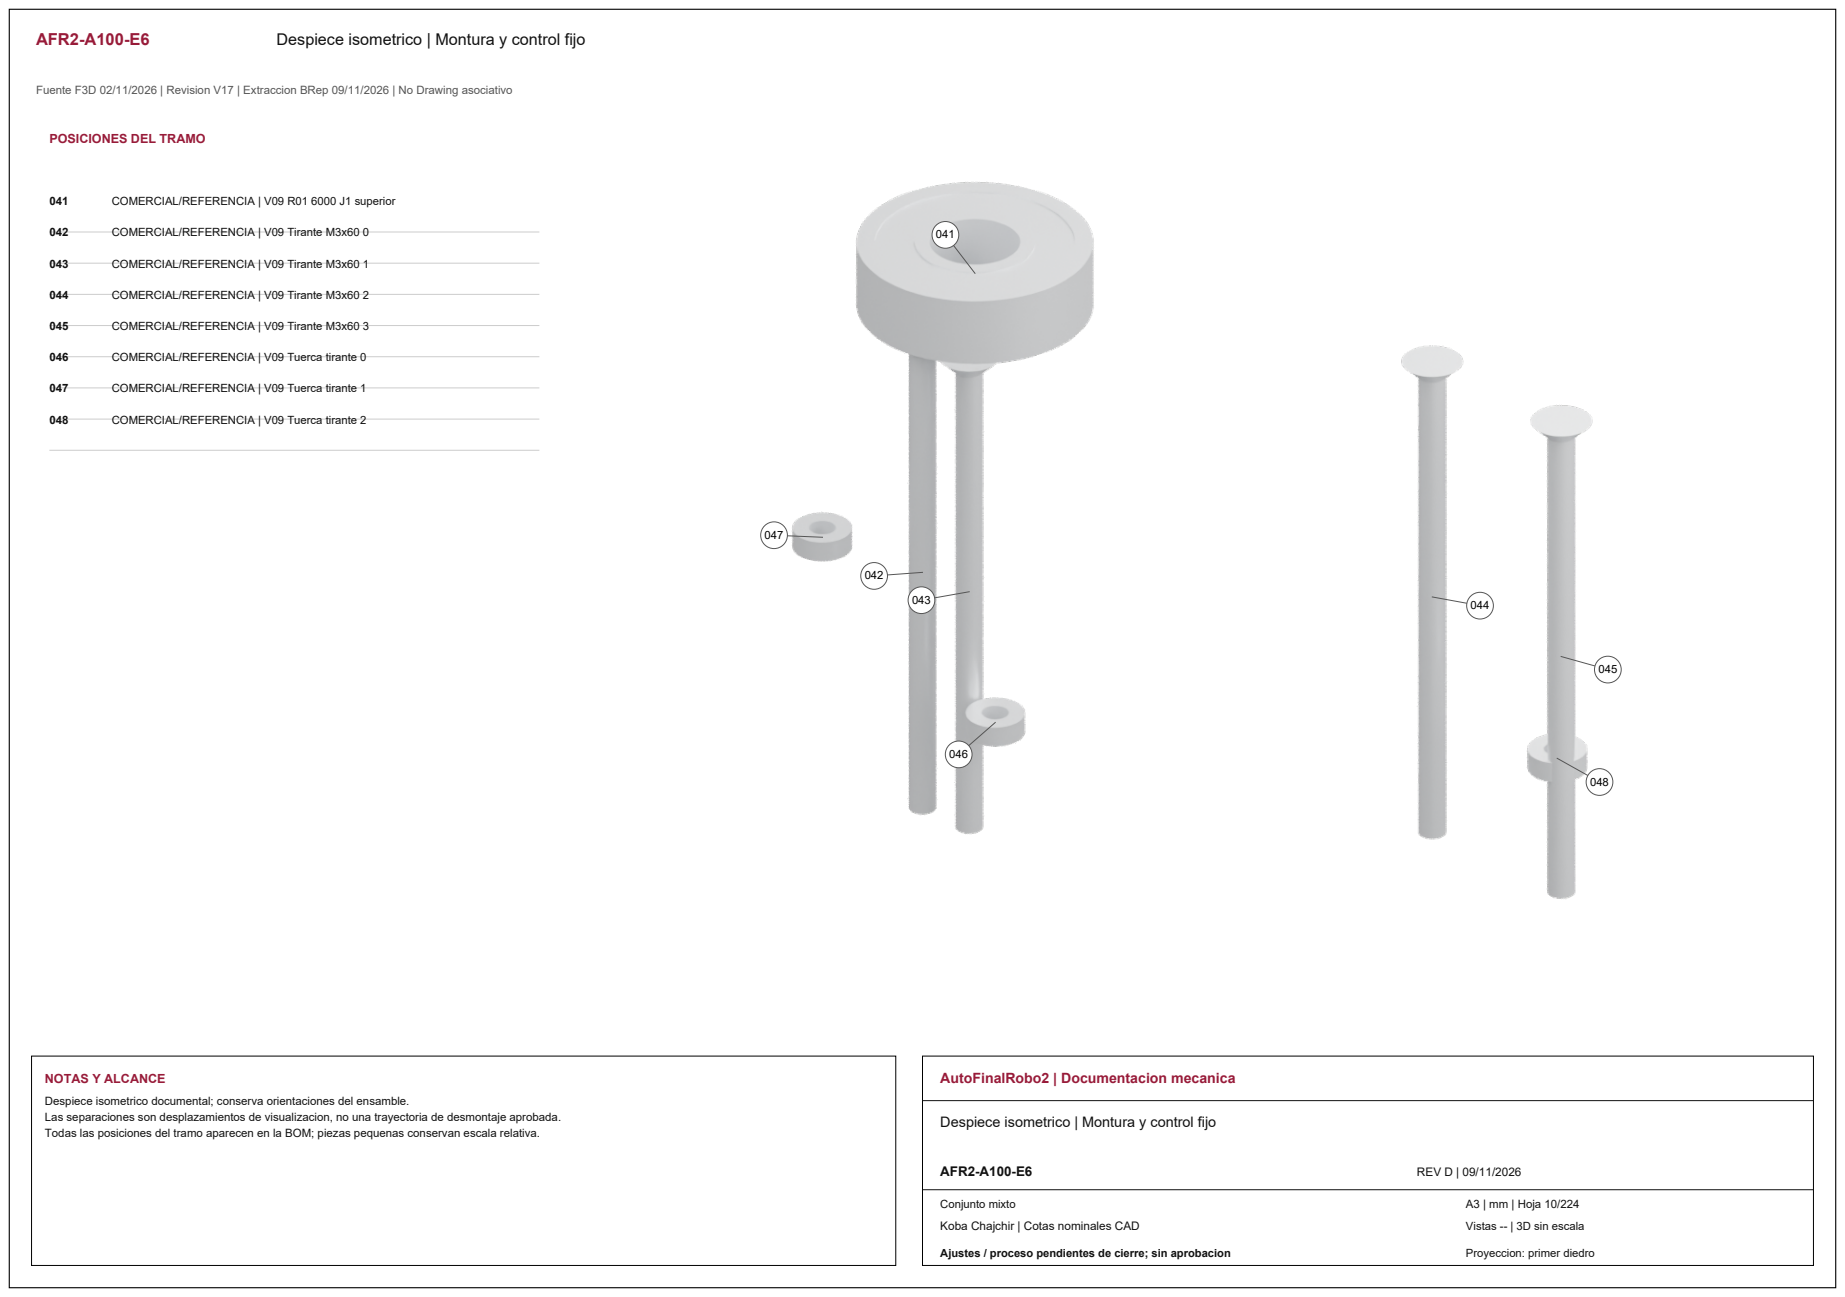
[picture p249: page 10]
NOTAS Y ALCANCE; AutoFinalRobo2 | Documentacion mecanica; AFR2-A100-E6; REV D | 09/11/2026; Conjunto mixto

POSICIONES DEL TRAMO

041 COMERCIAL/REFERENCIA | V09 R01 6000 J1 superior

042 COMERCIAL/REFERENCIA | V09 Tirante M3x60 0

043 COMERCIAL/REFERENCIA | V09 Tirante M3x60 1

044 COMERCIAL/REFERENCIA | V09 Tirante M3x60 2

045 COMERCIAL/REFERENCIA | V09 Tirante M3x60 3

046 COMERCIAL/REFERENCIA | V09 Tuerca tirante 0

047 COMERCIAL/REFERENCIA | V09 Tuerca tirante 1

048 COMERCIAL/REFERENCIA | V09 Tuerca tirante 2

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

Despiece isometrico | Montura y control fijo

Vistas -- | 3D sin escala

AFR2-A100-E7 | Despiece isometrico | Montura y control fijo

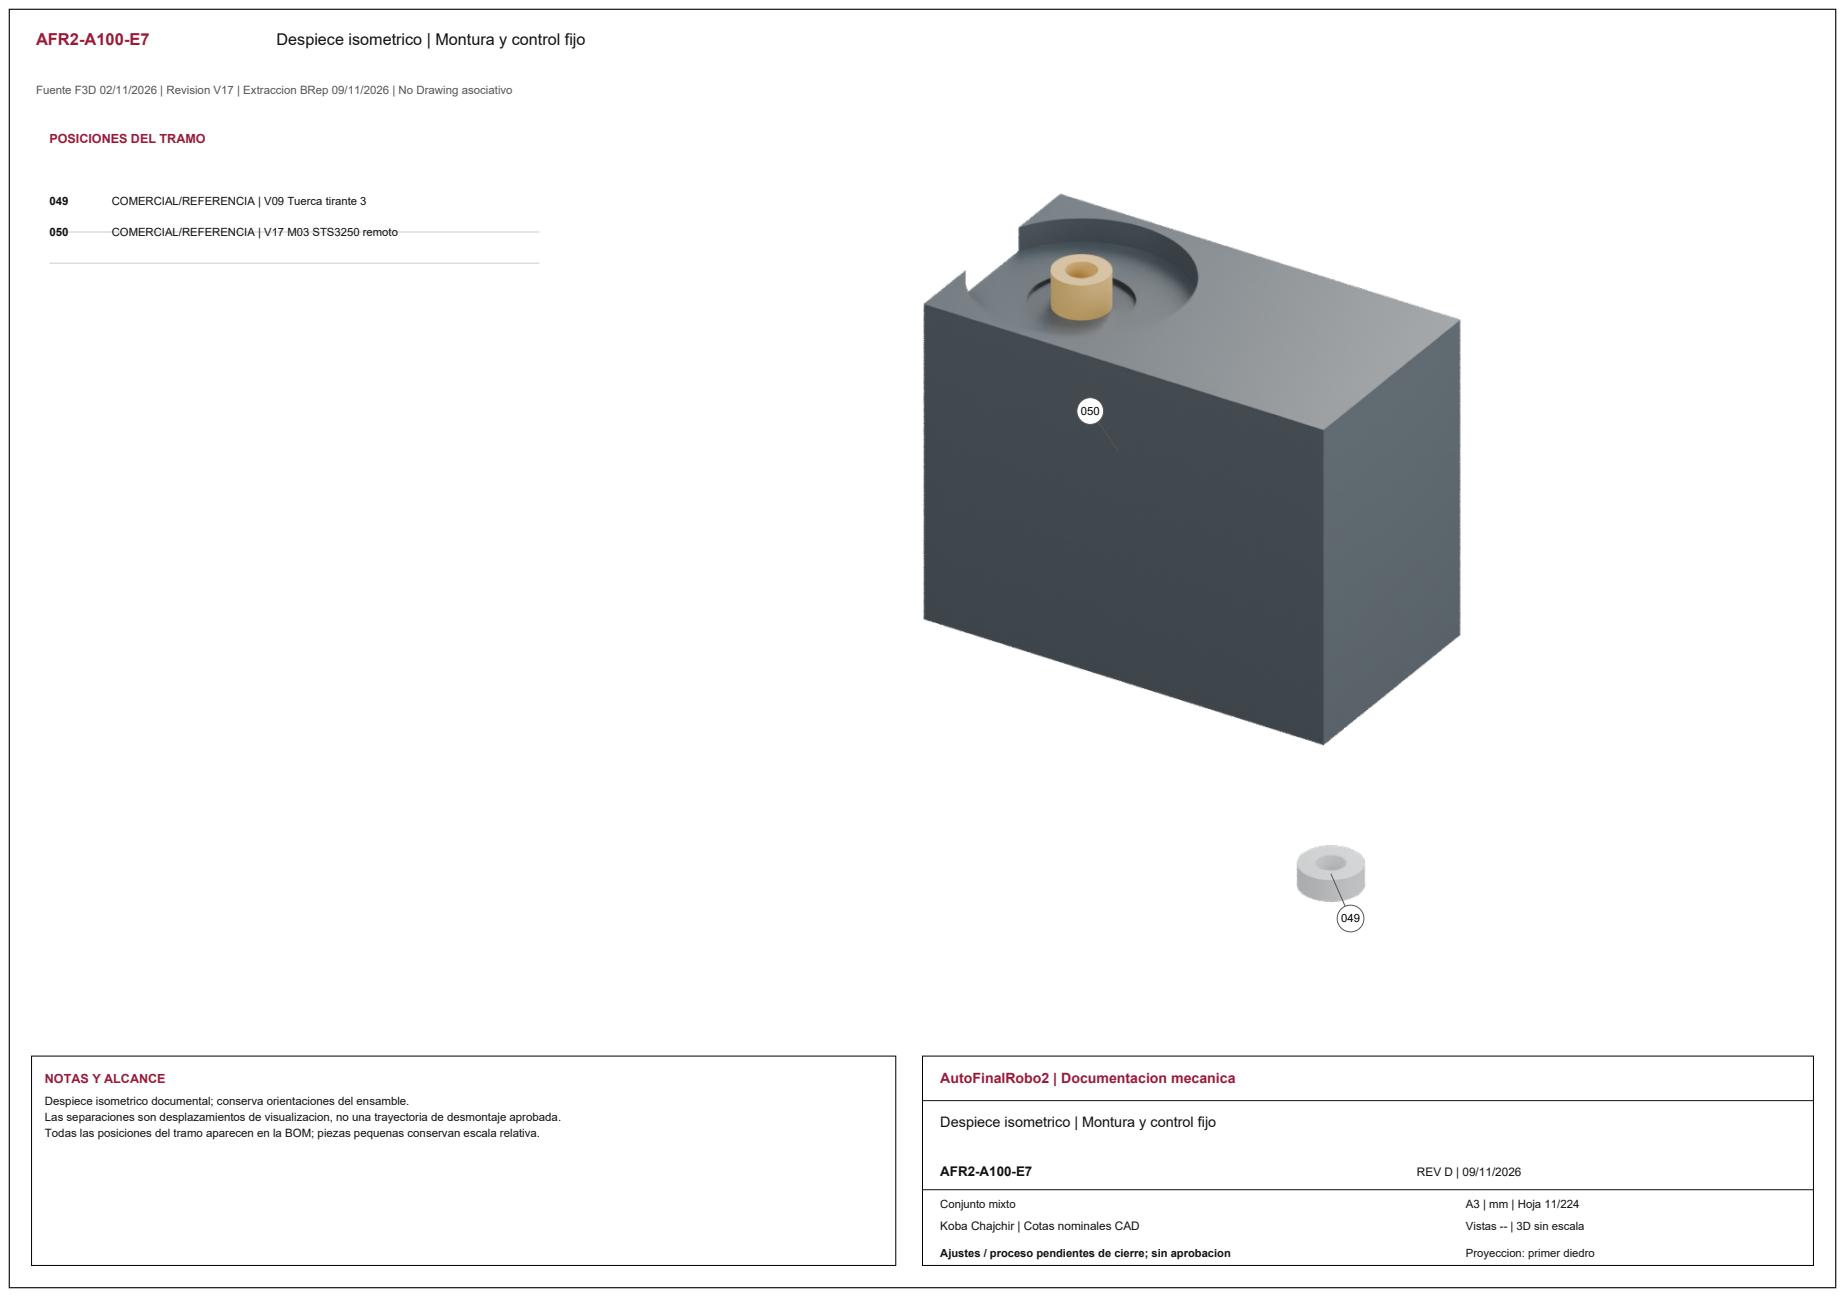
[picture p250: page 11]
NOTAS Y ALCANCE; AutoFinalRobo2 | Documentacion mecanica; AFR2-A100-E7; REV D | 09/11/2026; Conjunto mixto

POSICIONES DEL TRAMO

049 COMERCIAL/REFERENCIA | V09 Tuerca tirante 3

050 COMERCIAL/REFERENCIA | V17 M03 STS3250 remoto

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

Despiece isometrico | Montura y control fijo

Vistas -- | 3D sin escala

AFR2-P101 | Separador M3 A

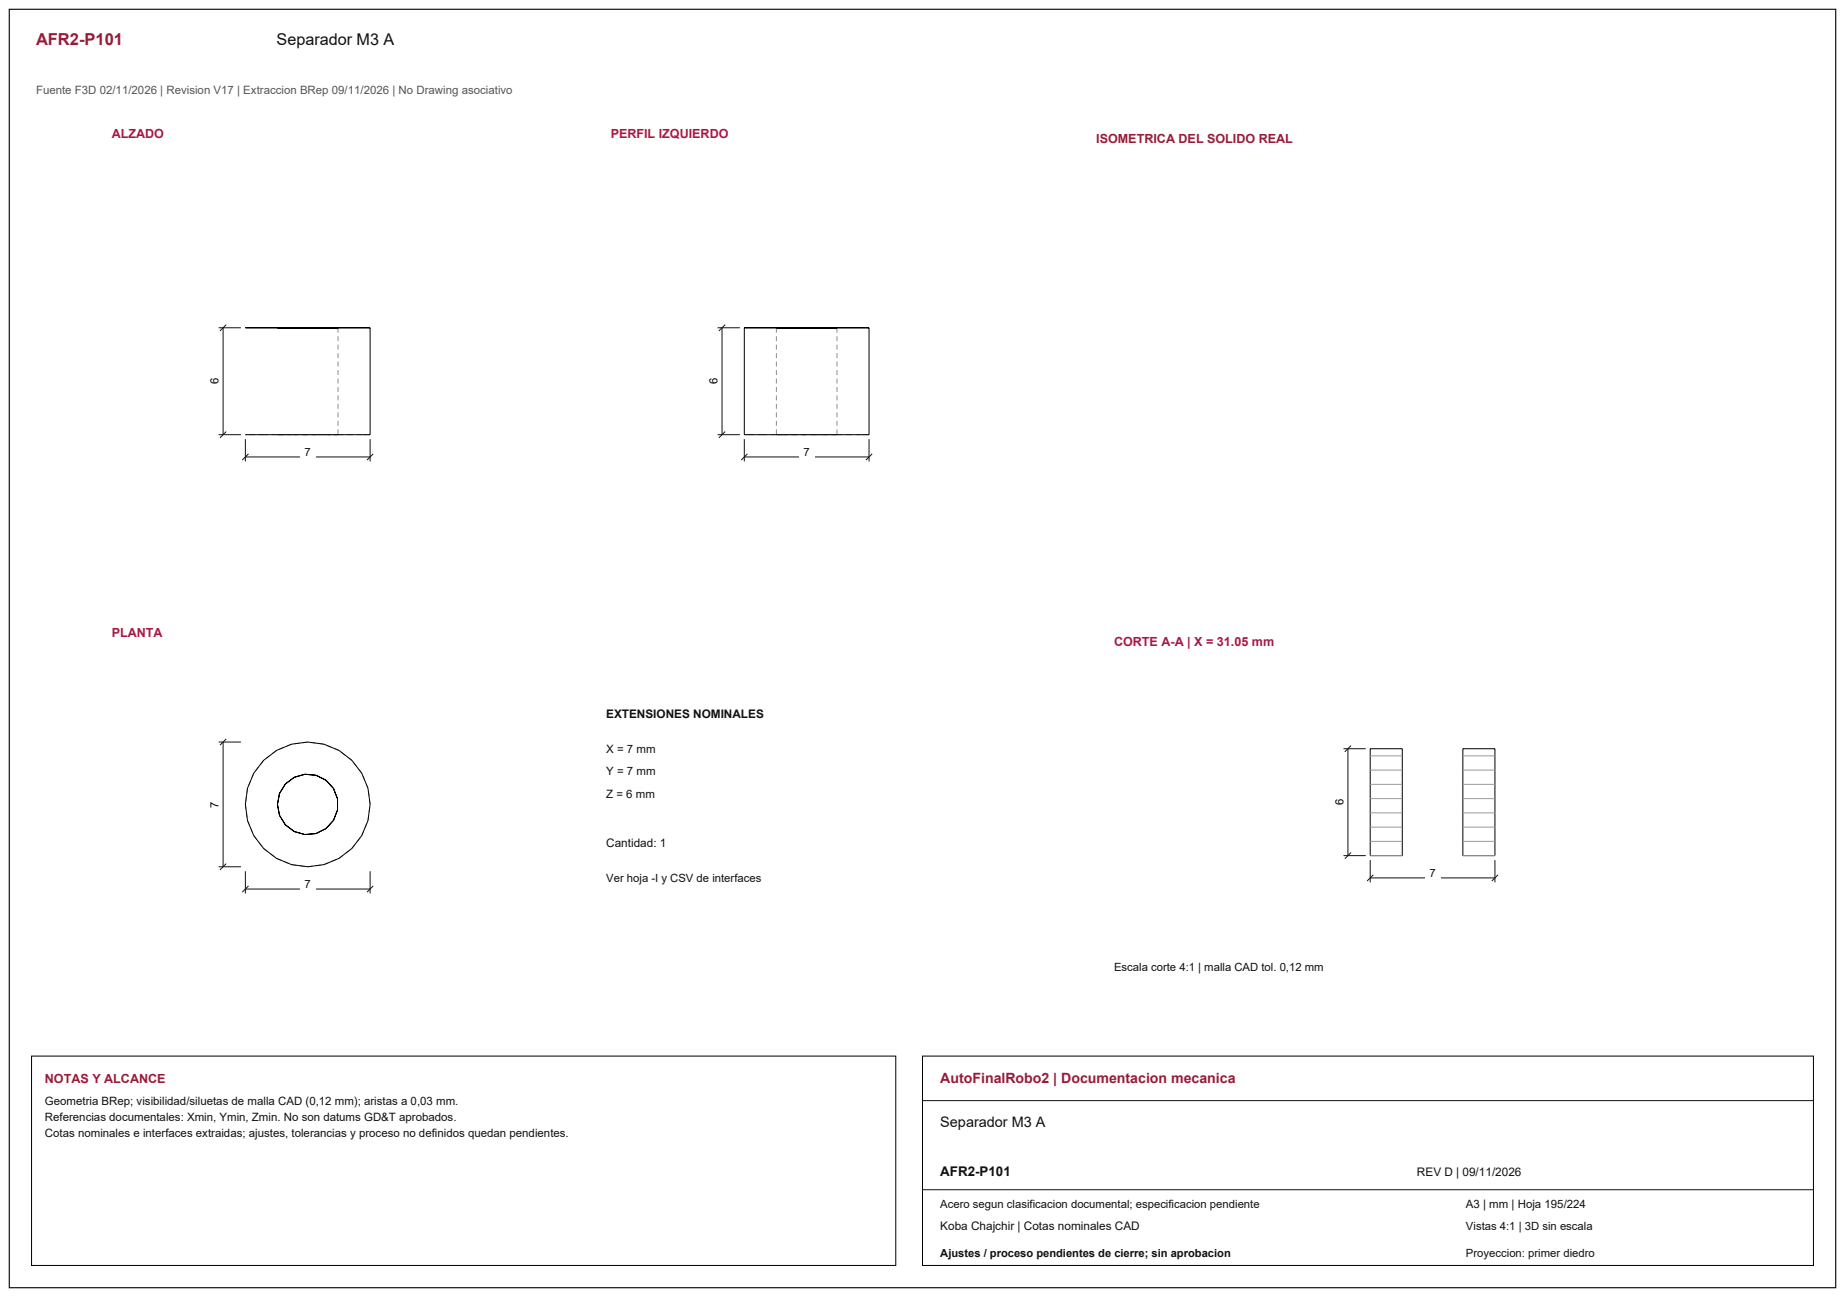
[picture p251: page 12]
ALZADO; PERFIL IZQUIERDO; PLANTA; CORTE A-A | X = 31.05 mm; EXTENSIONES NOMINALES; Cantidad: 1; NOTAS Y ALCANCE; AutoFinalRobo2 | Documentacion mecanica; Separador M3 A; AFR2-P101; REV D | 09/11/2026

ISOMETRICA DEL SOLIDO REAL

Ver hoja -I y CSV de interfaces

Escala corte 4:1 | malla CAD tol. 0,12 mm

Geometria BRep; visibilidad/siluetas de malla CAD (0,12 mm); aristas a 0,03 mm.
Referencias documentales: Xmin, Ymin, Zmin. No son datums GD&T aprobados.
Cotas nominales e interfaces extraidas; ajustes, tolerancias y proceso no definidos quedan pendientes.

Acero segun clasificacion documental; especificacion pendiente

Vistas 4:1 | 3D sin escala

AFR2-P101-I01 | Interfaces y corte | Separador M3 A

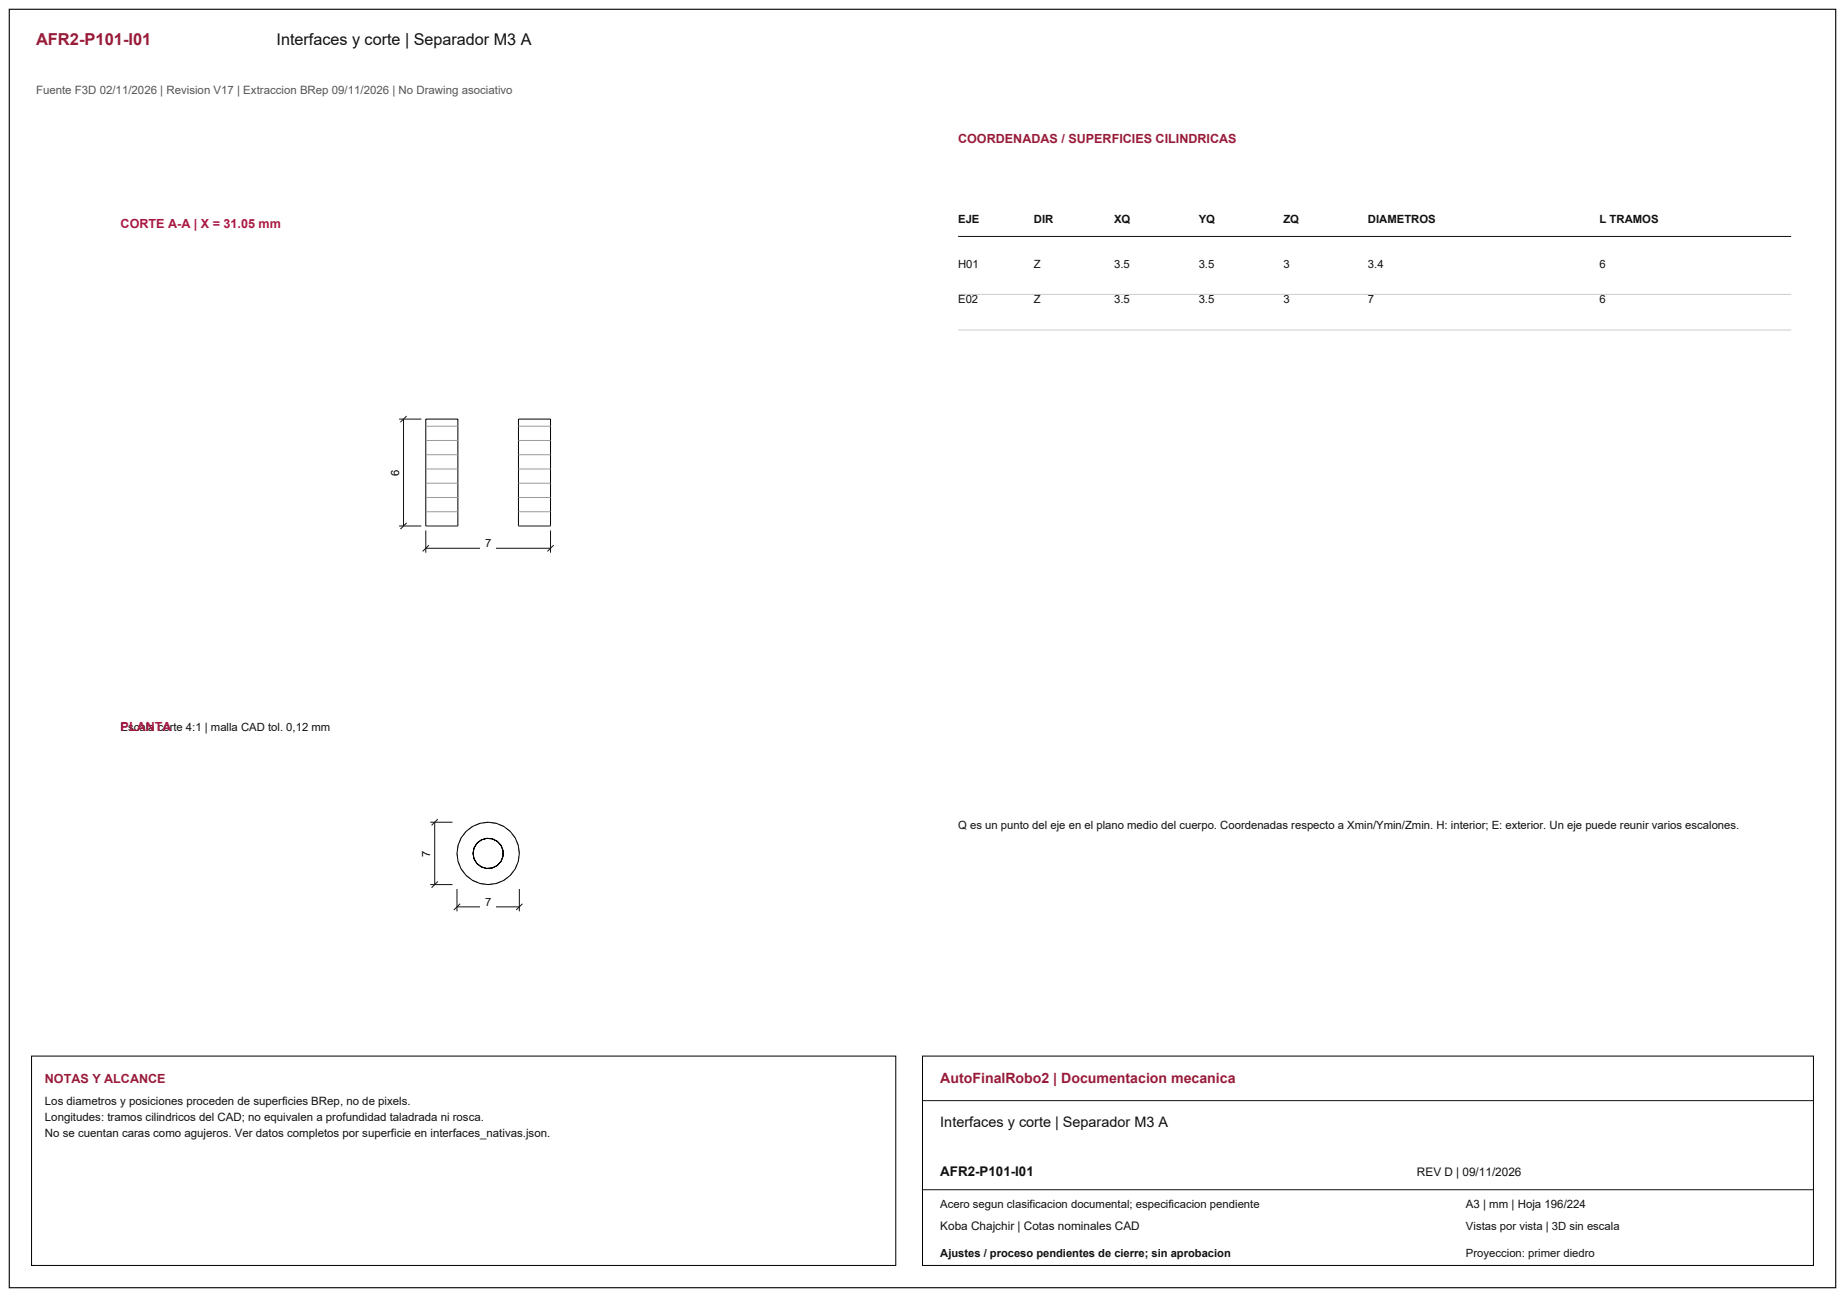
[picture p252: page 13]
CORTE A-A | X = 31.05 mm; EJE; DIR; DIAMETROS; L TRAMOS; NOTAS Y ALCANCE; AutoFinalRobo2 | Documentacion mecanica; AFR2-P101-I01; REV D | 09/11/2026

COORDENADAS / SUPERFICIES CILINDRICAS

Escala corte 4:1 | malla CAD tol. 0,12 mm PLANTA

Q es un punto del eje en el plano medio del cuerpo. Coordenadas respecto a Xmin/Ymin/Zmin. H: interior; E: exterior. Un eje puede reunir varios escalones.

Los diametros y posiciones proceden de superficies BRep, no de pixels.
Longitudes: tramos cilindricos del CAD; no equivalen a profundidad taladrada ni rosca.
No se cuentan caras como agujeros. Ver datos completos por superficie en interfaces_nativas.json.

Interfaces y corte | Separador M3 A

Acero segun clasificacion documental; especificacion pendiente

Vistas por vista | 3D sin escala

AFR2-P102 | Separador M3 B

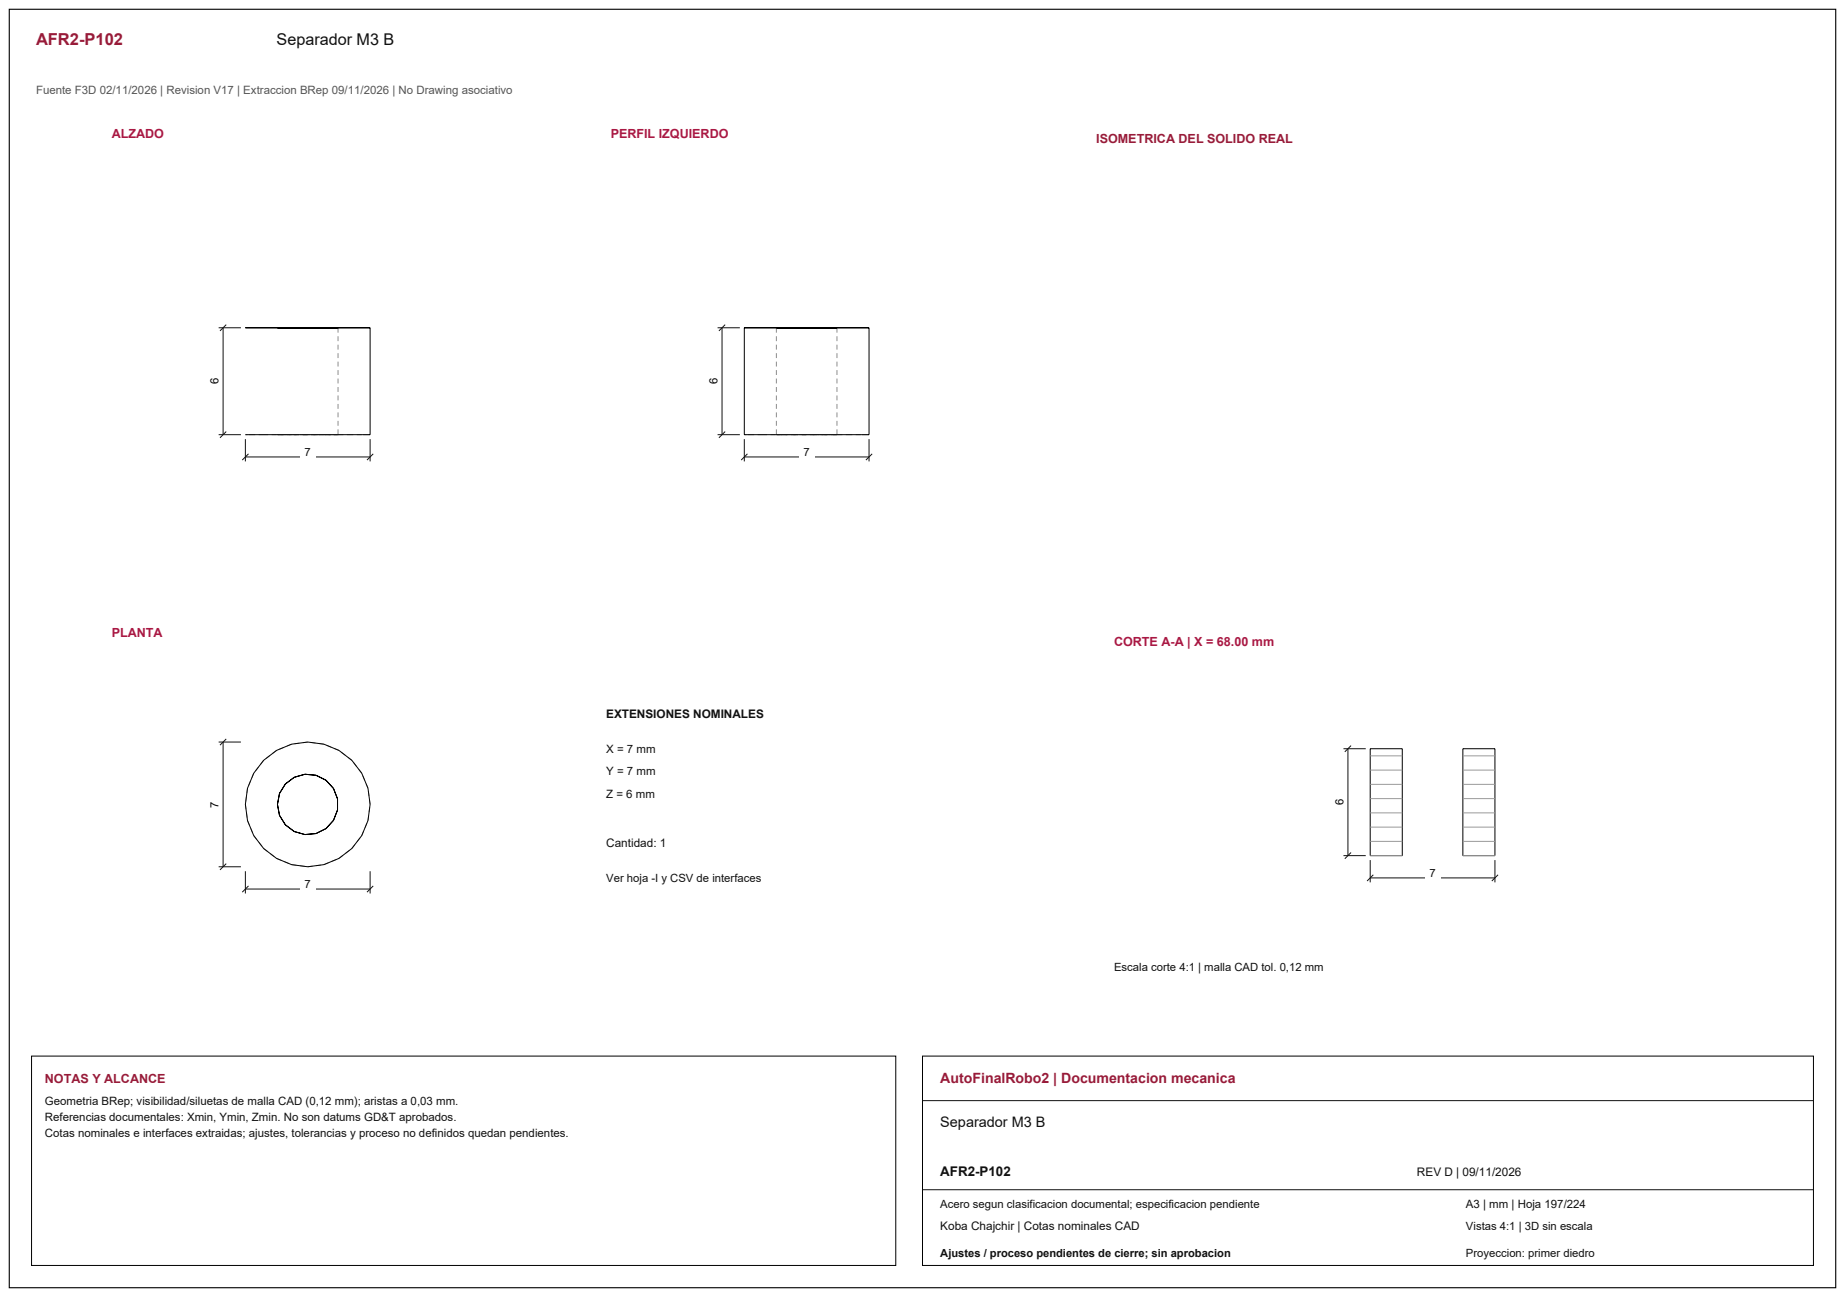
[picture p253: page 14]
ALZADO; PERFIL IZQUIERDO; PLANTA; CORTE A-A | X = 68.00 mm; EXTENSIONES NOMINALES; Cantidad: 1; NOTAS Y ALCANCE; AutoFinalRobo2 | Documentacion mecanica; Separador M3 B; AFR2-P102; REV D | 09/11/2026

ISOMETRICA DEL SOLIDO REAL

Ver hoja -I y CSV de interfaces

Escala corte 4:1 | malla CAD tol. 0,12 mm

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

Acero segun clasificacion documental; especificacion pendiente

Vistas 4:1 | 3D sin escala

AFR2-P102-I01 | Interfaces y corte | Separador M3 B

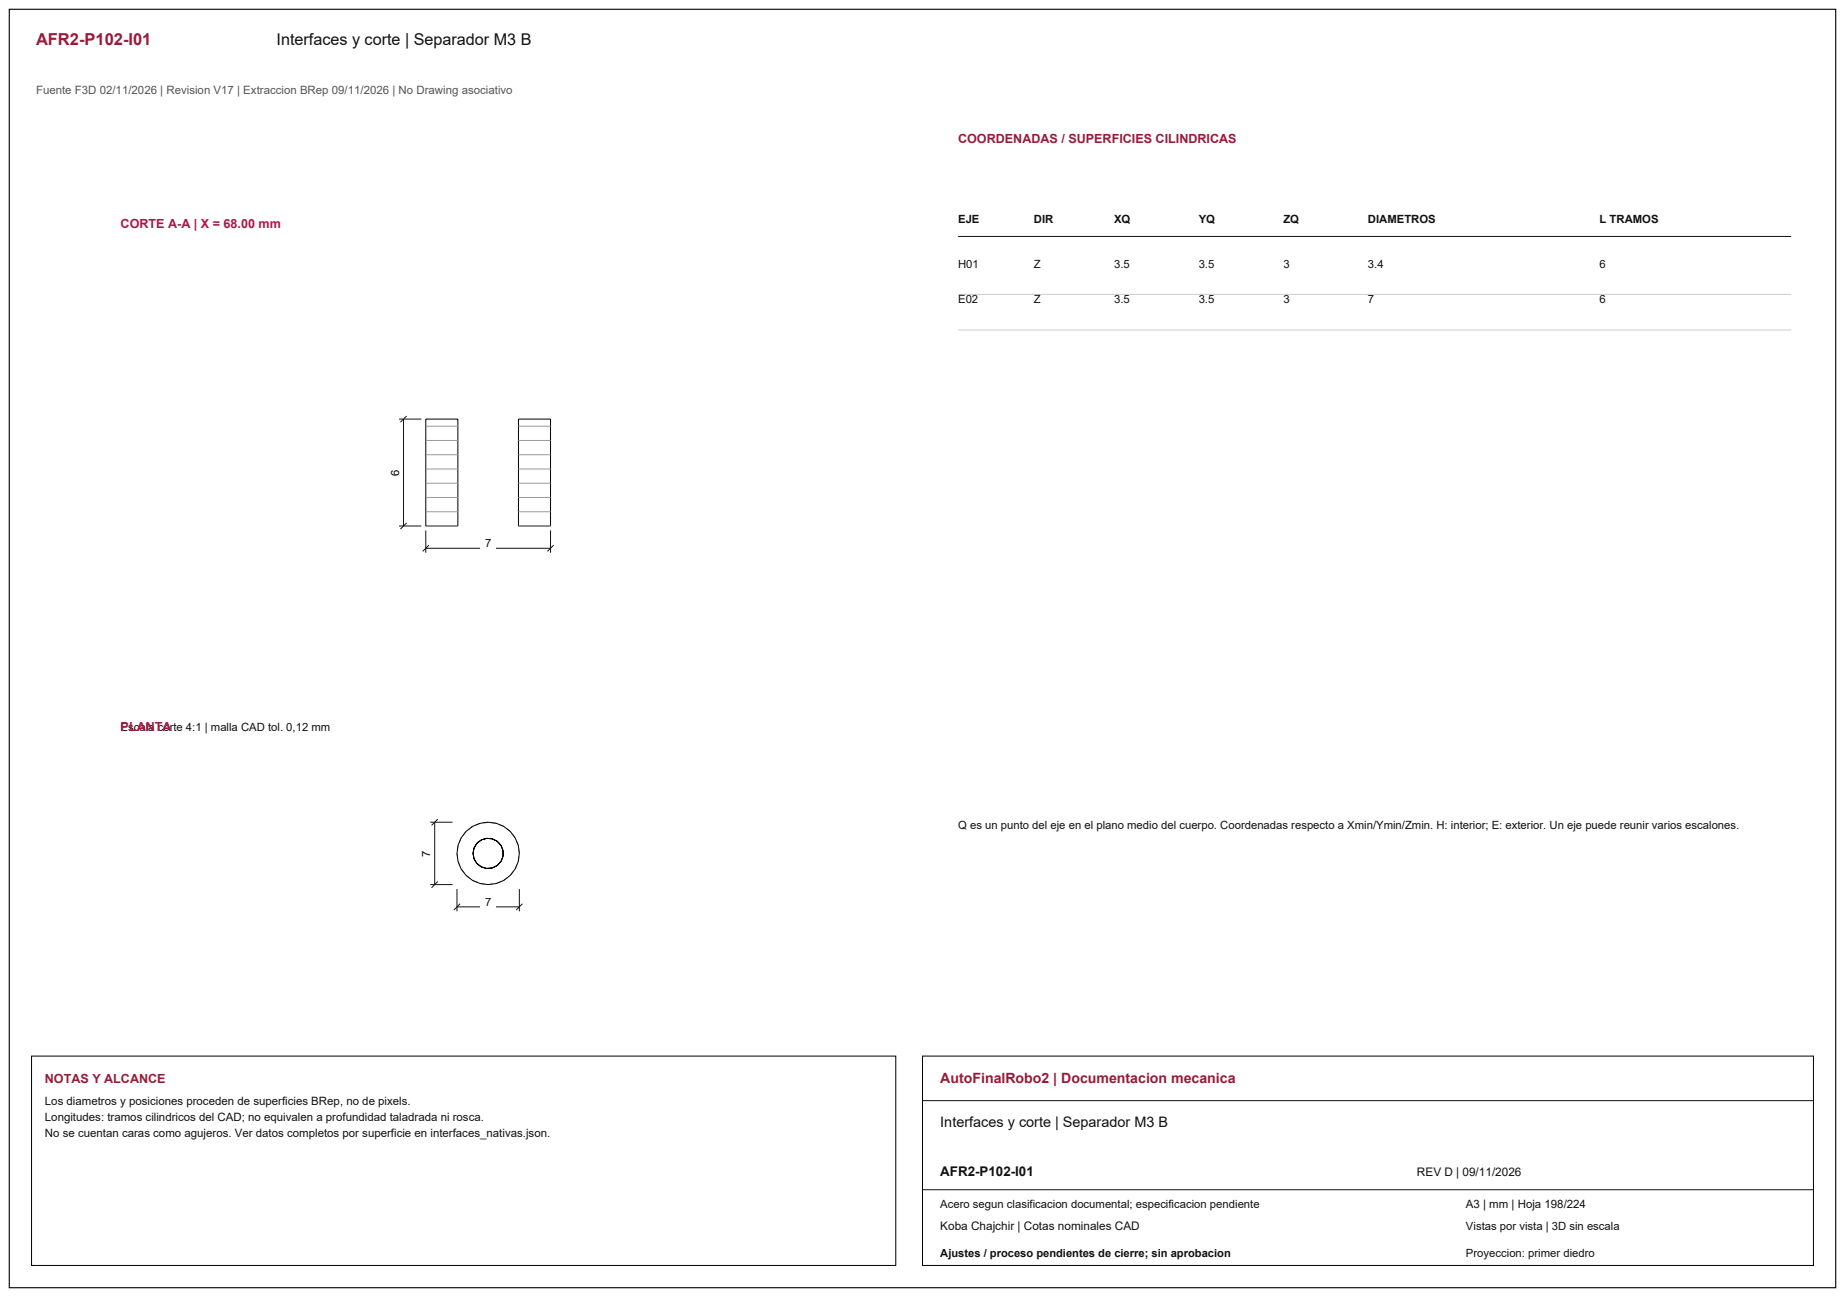
[picture p254: page 15]
CORTE A-A | X = 68.00 mm; EJE; DIR; DIAMETROS; L TRAMOS; NOTAS Y ALCANCE; AutoFinalRobo2 | Documentacion mecanica; AFR2-P102-I01; REV D | 09/11/2026

COORDENADAS / SUPERFICIES CILINDRICAS

Escala corte 4:1 | malla CAD tol. 0,12 mm PLANTA

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

Interfaces y corte | Separador M3 B

Acero segun clasificacion documental; especificacion pendiente

AFR2-P103 | Separador M3 C

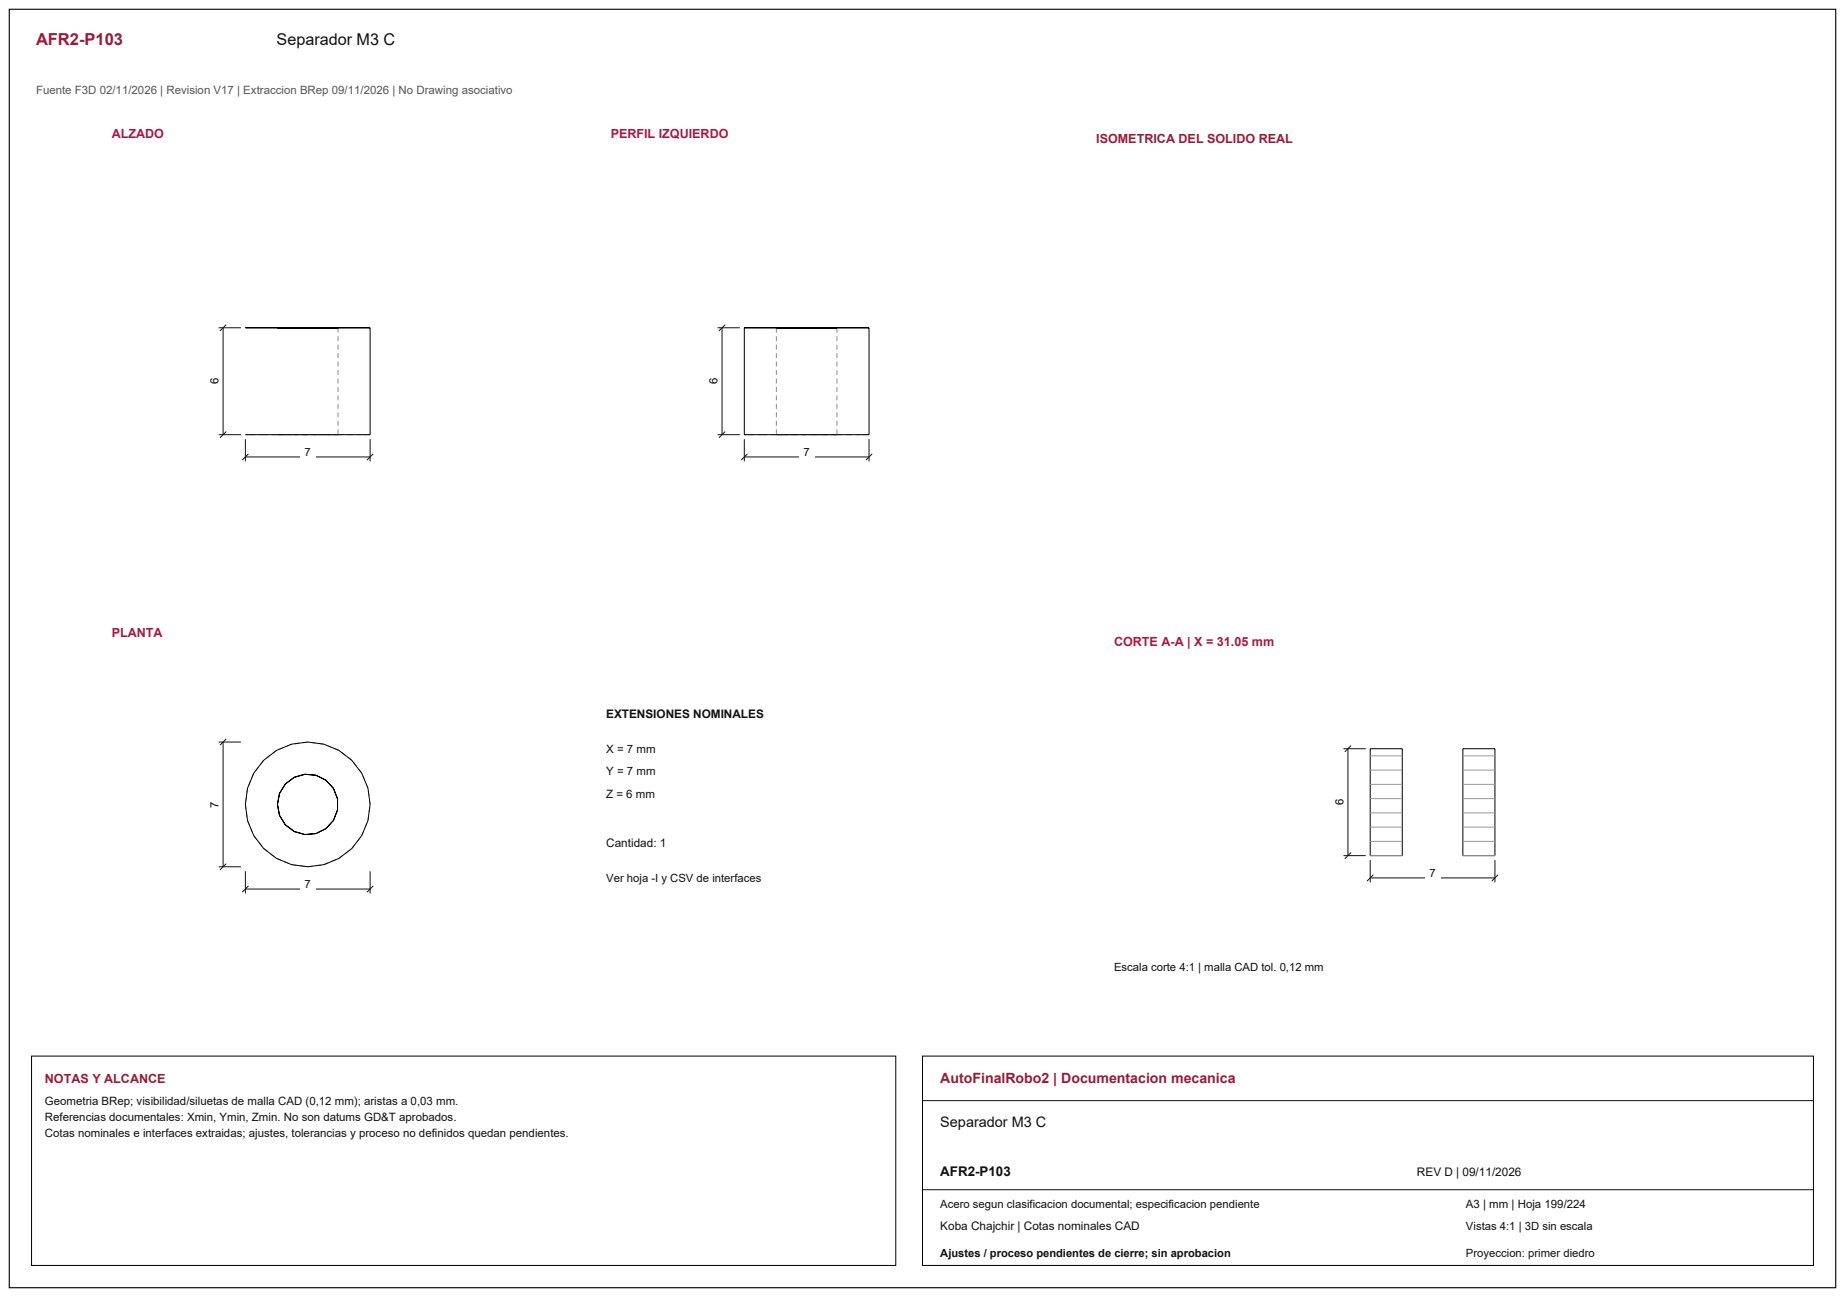
[picture p255: page 16]
ALZADO; PERFIL IZQUIERDO; PLANTA; CORTE A-A | X = 31.05 mm; EXTENSIONES NOMINALES; Cantidad: 1; NOTAS Y ALCANCE; AutoFinalRobo2 | Documentacion mecanica; Separador M3 C; AFR2-P103; REV D | 09/11/2026

ISOMETRICA DEL SOLIDO REAL

Ver hoja -I y CSV de interfaces

Escala corte 4:1 | malla CAD tol. 0,12 mm

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

Acero segun clasificacion documental; especificacion pendiente

Vistas 4:1 | 3D sin escala

AFR2-P103-I01 | Interfaces y corte | Separador M3 C

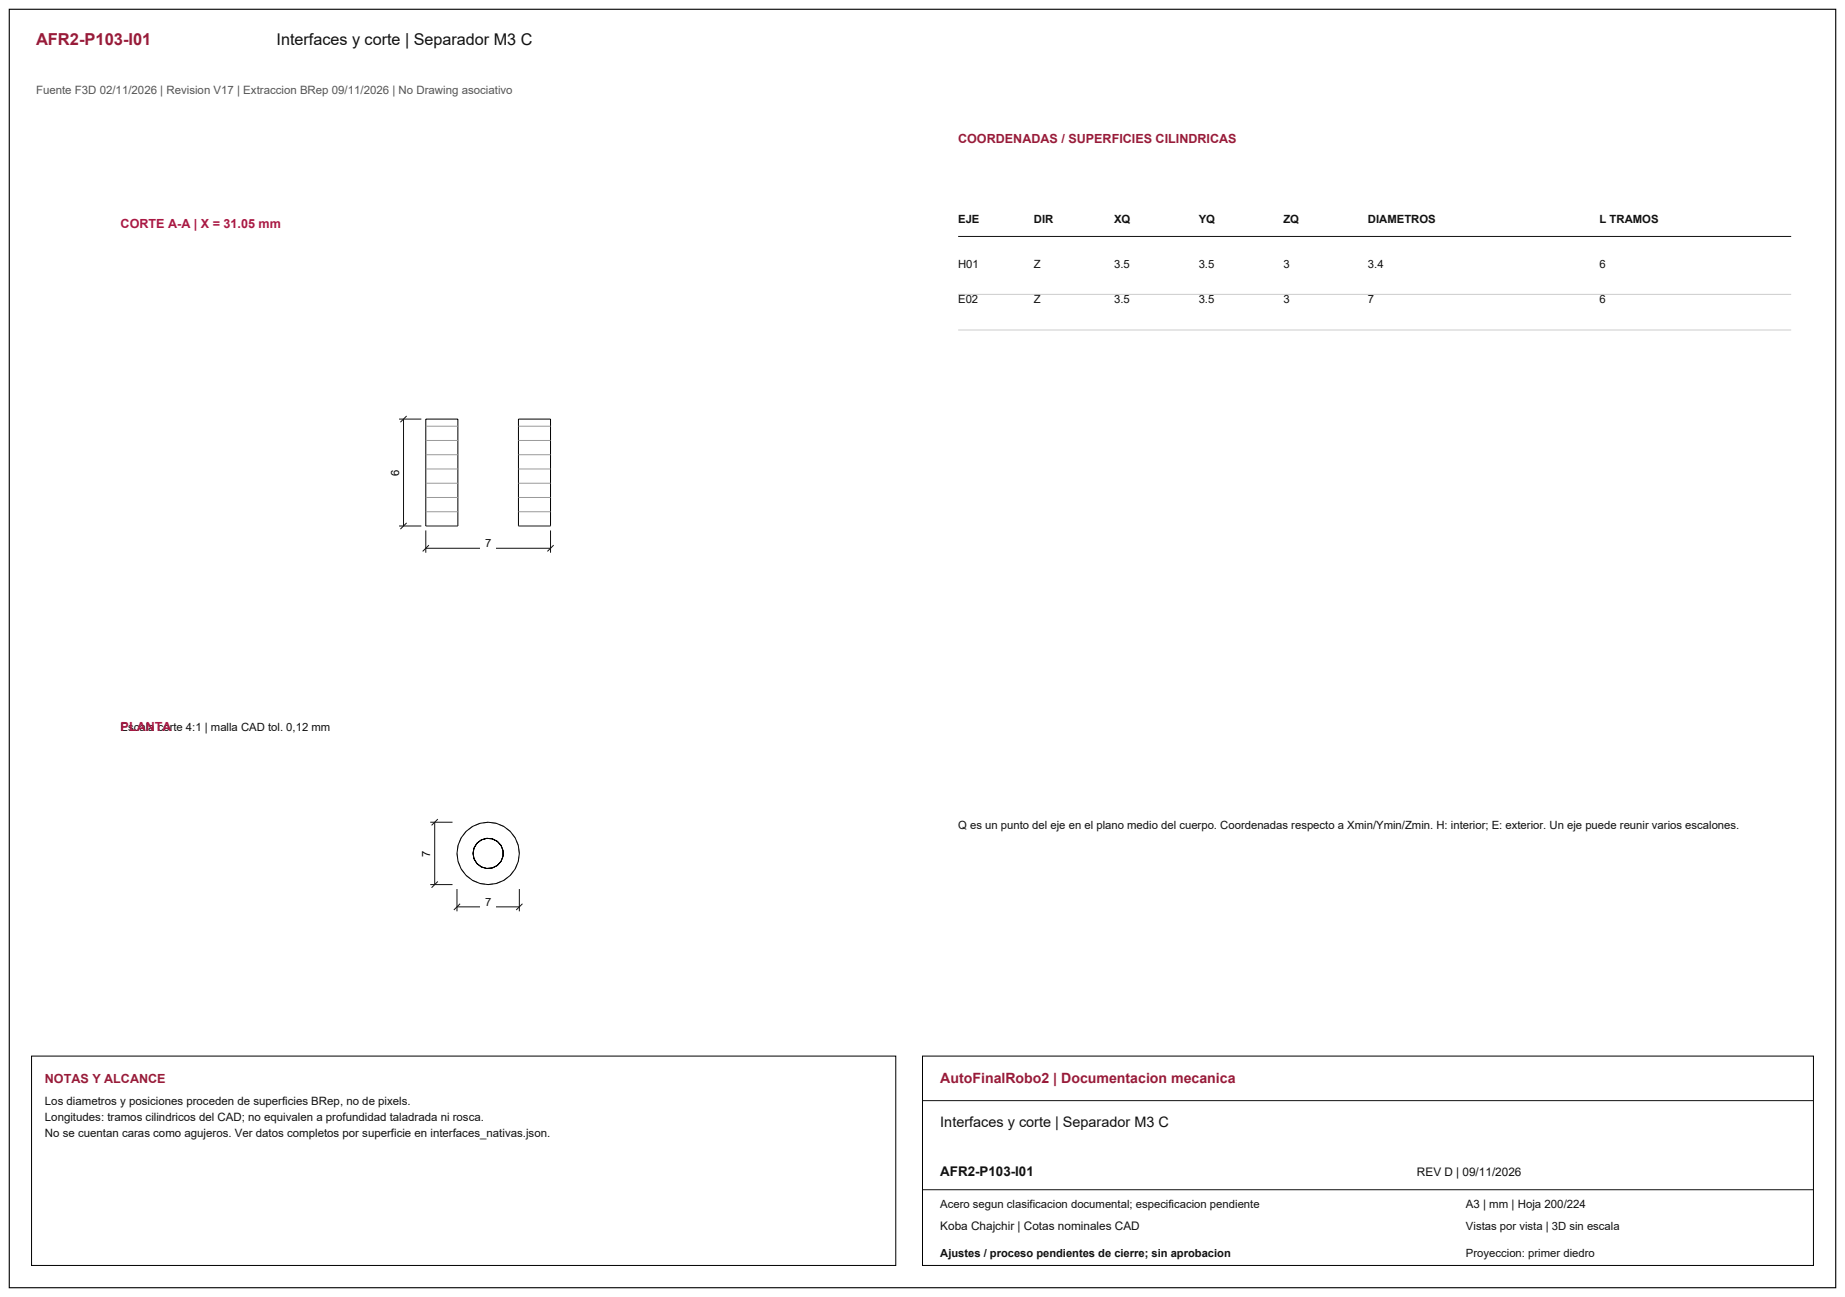
[picture p256: page 17]
CORTE A-A | X = 31.05 mm; EJE; DIR; DIAMETROS; L TRAMOS; NOTAS Y ALCANCE; AutoFinalRobo2 | Documentacion mecanica; AFR2-P103-I01; REV D | 09/11/2026

COORDENADAS / SUPERFICIES CILINDRICAS

Escala corte 4:1 | malla CAD tol. 0,12 mm PLANTA

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

Interfaces y corte | Separador M3 C

Acero segun clasificacion documental; especificacion pendiente

AFR2-P104 | Separador M3 D

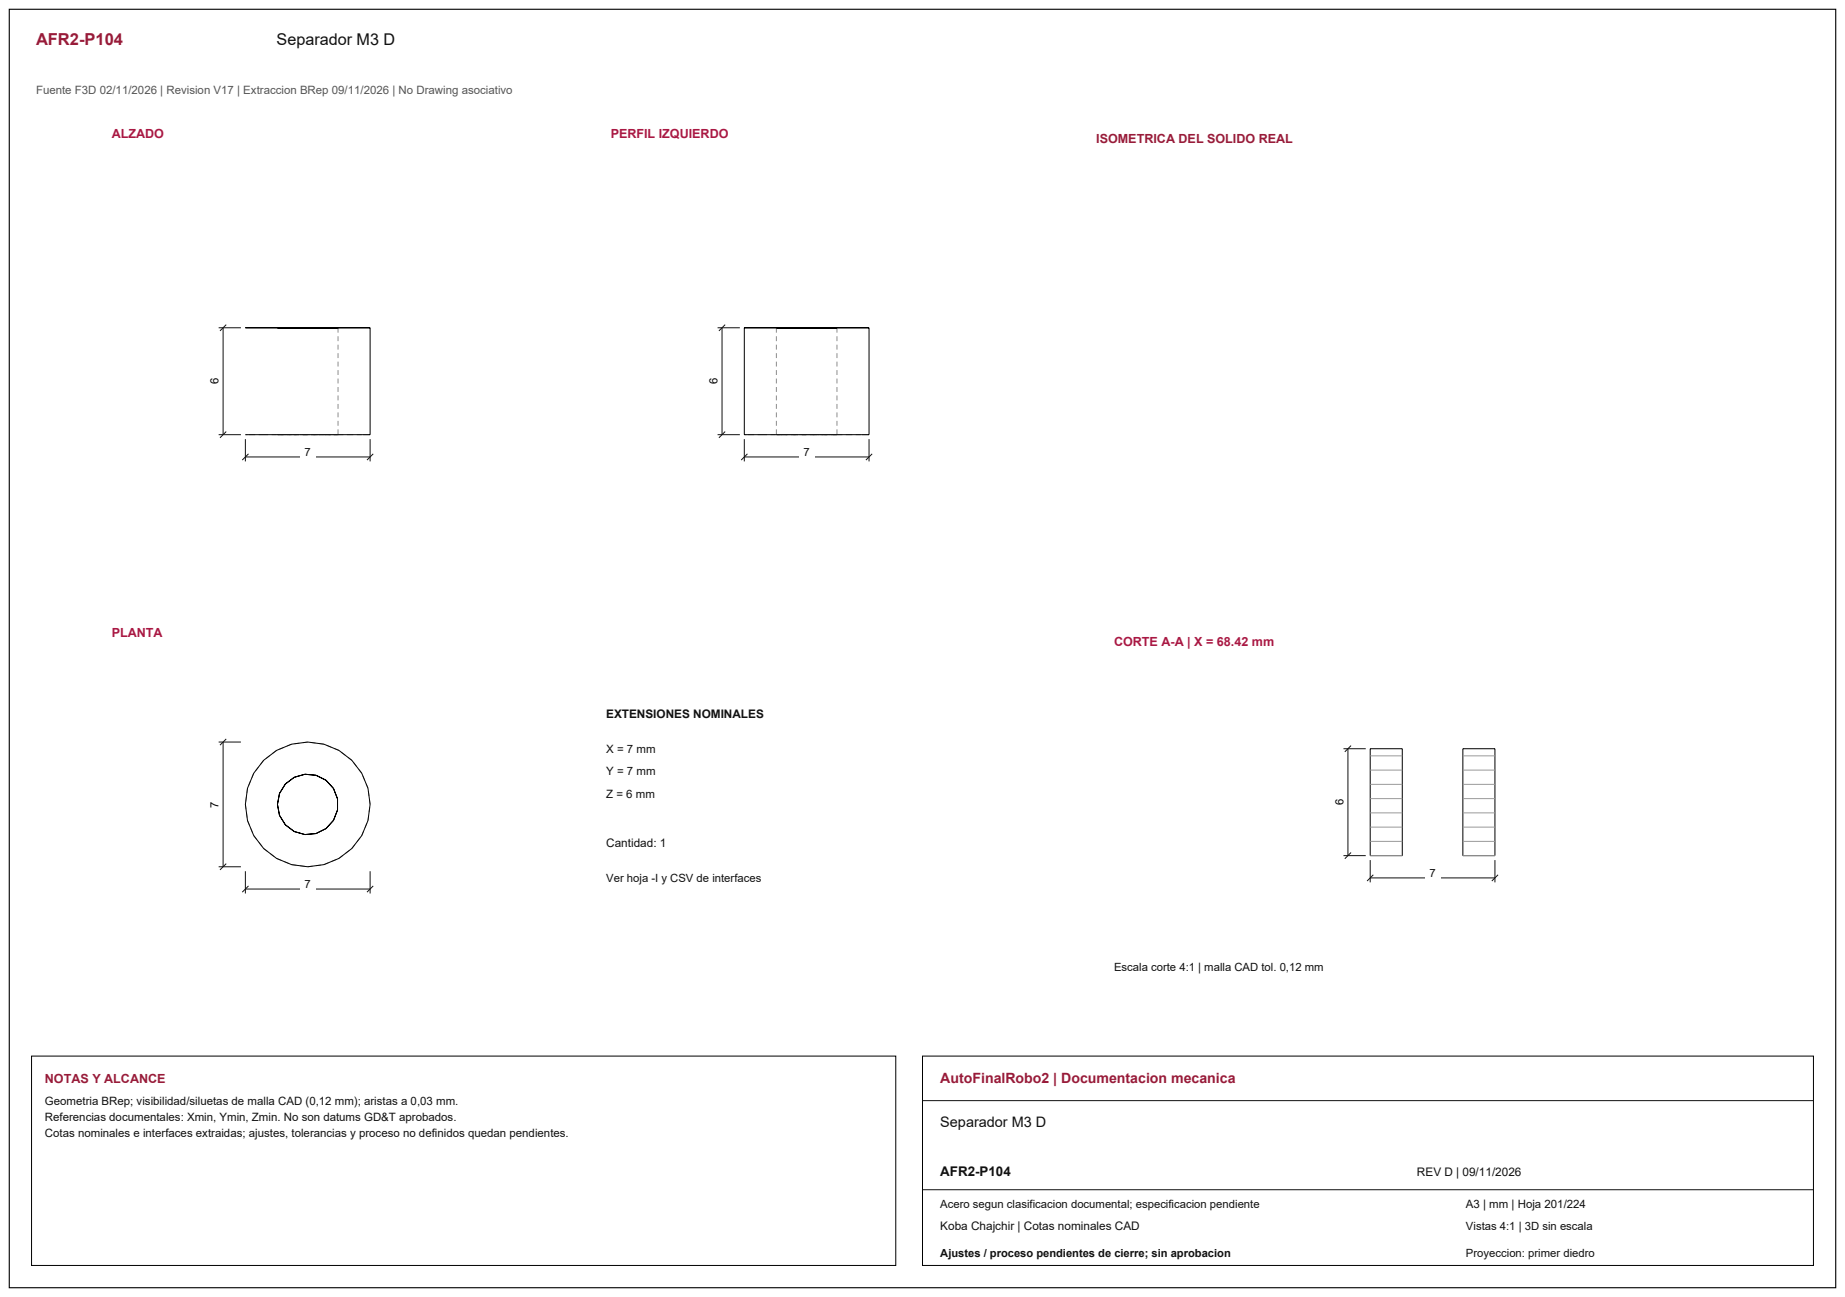
[picture p257: page 18]
ALZADO; PERFIL IZQUIERDO; PLANTA; CORTE A-A | X = 68.42 mm; EXTENSIONES NOMINALES; Cantidad: 1; NOTAS Y ALCANCE; AutoFinalRobo2 | Documentacion mecanica; Separador M3 D; AFR2-P104; REV D | 09/11/2026

ISOMETRICA DEL SOLIDO REAL

Ver hoja -I y CSV de interfaces

Escala corte 4:1 | malla CAD tol. 0,12 mm

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

Acero segun clasificacion documental; especificacion pendiente

Vistas 4:1 | 3D sin escala

AFR2-P104-I01 | Interfaces y corte | Separador M3 D

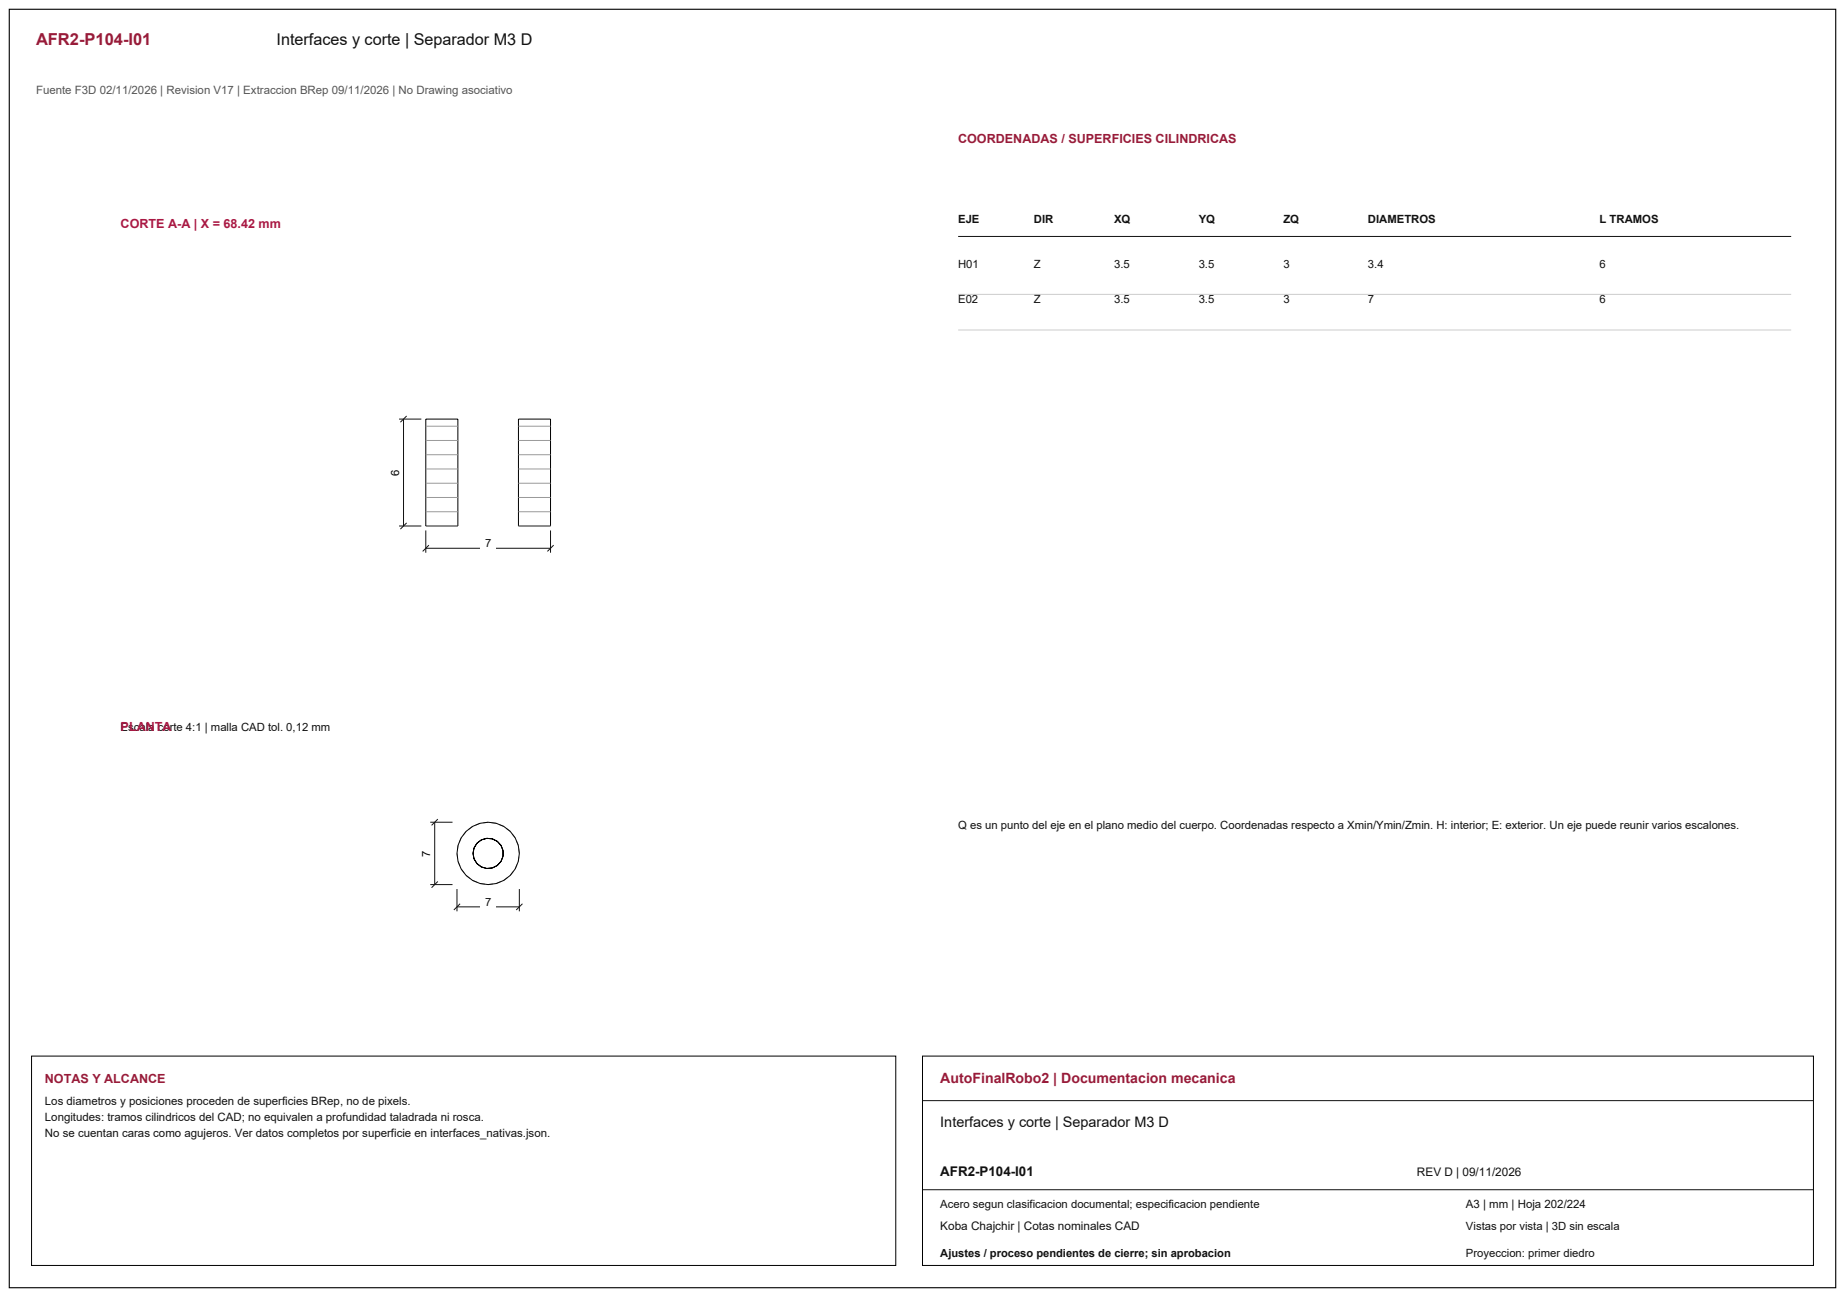
[picture p258: page 19]
CORTE A-A | X = 68.42 mm; EJE; DIR; DIAMETROS; L TRAMOS; NOTAS Y ALCANCE; AutoFinalRobo2 | Documentacion mecanica; AFR2-P104-I01; REV D | 09/11/2026

COORDENADAS / SUPERFICIES CILINDRICAS

Escala corte 4:1 | malla CAD tol. 0,12 mm PLANTA

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

Interfaces y corte | Separador M3 D

Acero segun clasificacion documental; especificacion pendiente

AFR2-P105 | Tapa rodamientos J1

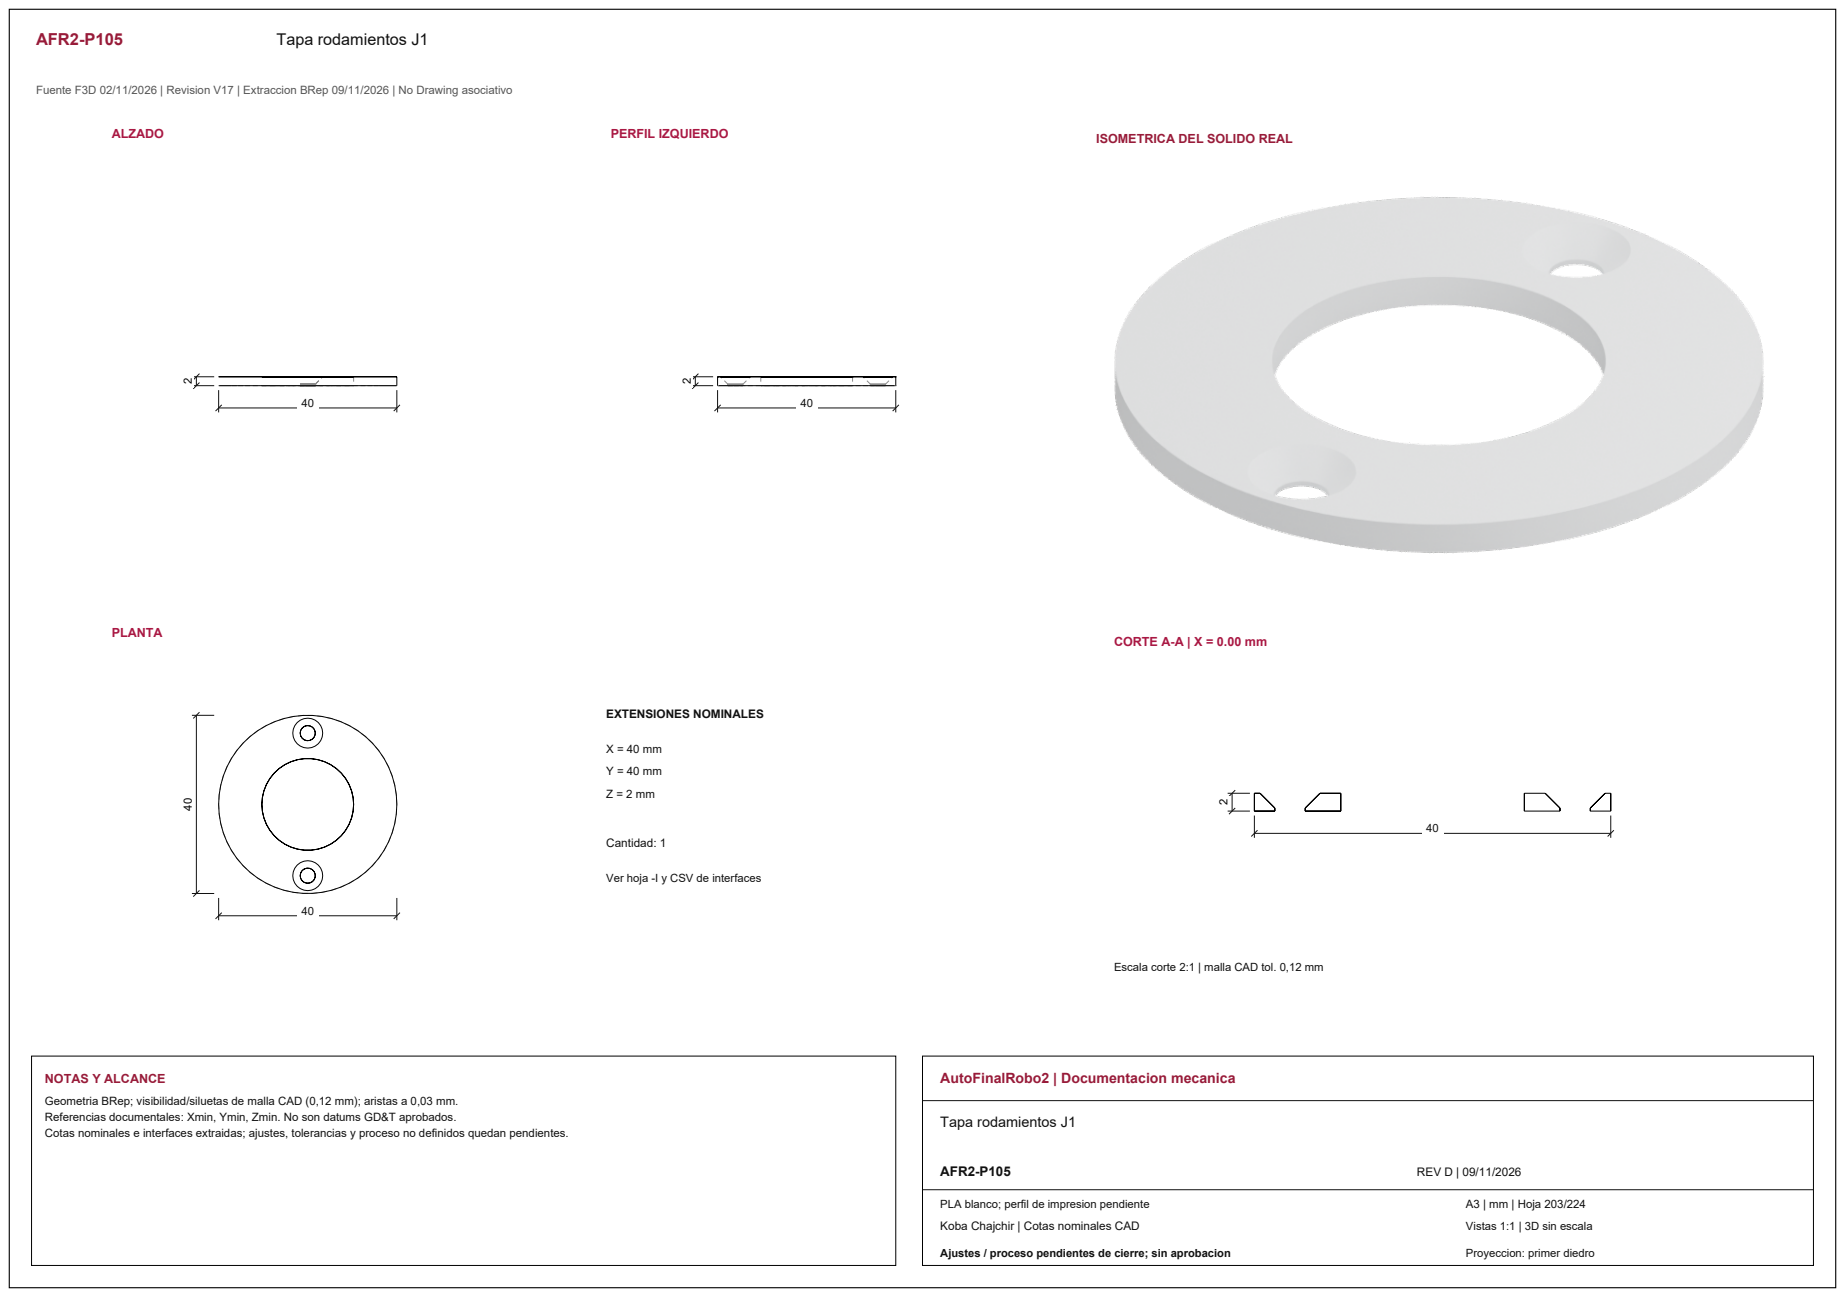
[picture p259: page 20]
ALZADO; PERFIL IZQUIERDO; PLANTA; CORTE A-A | X = 0.00 mm; EXTENSIONES NOMINALES; Cantidad: 1; NOTAS Y ALCANCE; AutoFinalRobo2 | Documentacion mecanica; Tapa rodamientos J1; AFR2-P105; REV D | 09/11/2026

ISOMETRICA DEL SOLIDO REAL

Ver hoja -I y CSV de interfaces

Escala corte 2:1 | malla CAD tol. 0,12 mm

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

PLA blanco; perfil de impresion pendiente

Vistas 1:1 | 3D sin escala

AFR2-P105-I01 | Interfaces y corte | Tapa rodamientos J1

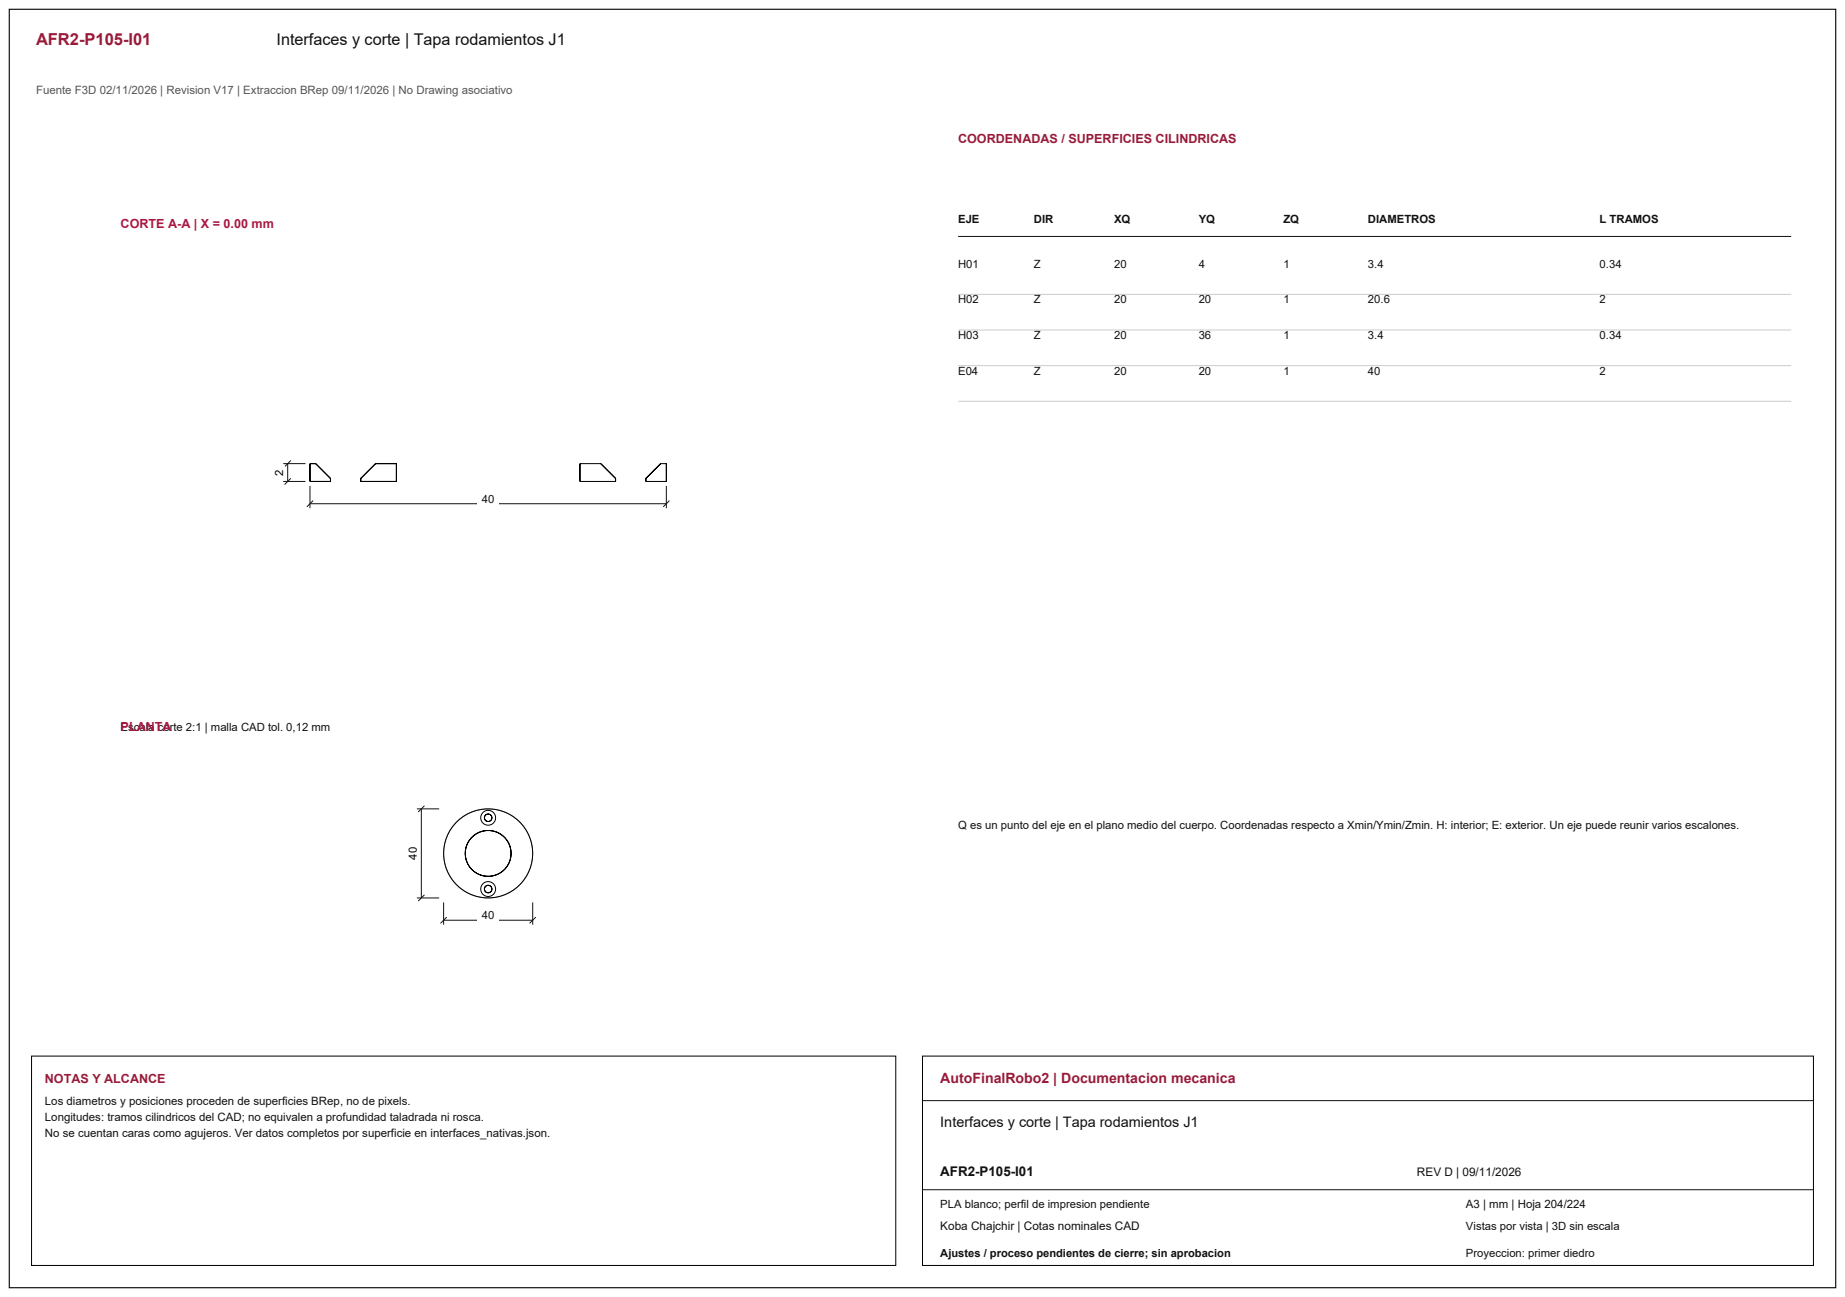
[picture p260: page 21]
CORTE A-A | X = 0.00 mm; EJE; DIR; DIAMETROS; L TRAMOS; NOTAS Y ALCANCE; AutoFinalRobo2 | Documentacion mecanica; AFR2-P105-I01; REV D | 09/11/2026

COORDENADAS / SUPERFICIES CILINDRICAS

Escala corte 2:1 | malla CAD tol. 0,12 mm PLANTA

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

Interfaces y corte | Tapa rodamientos J1

PLA blanco; perfil de impresion pendiente

AFR2-P106 | Separador M3 E

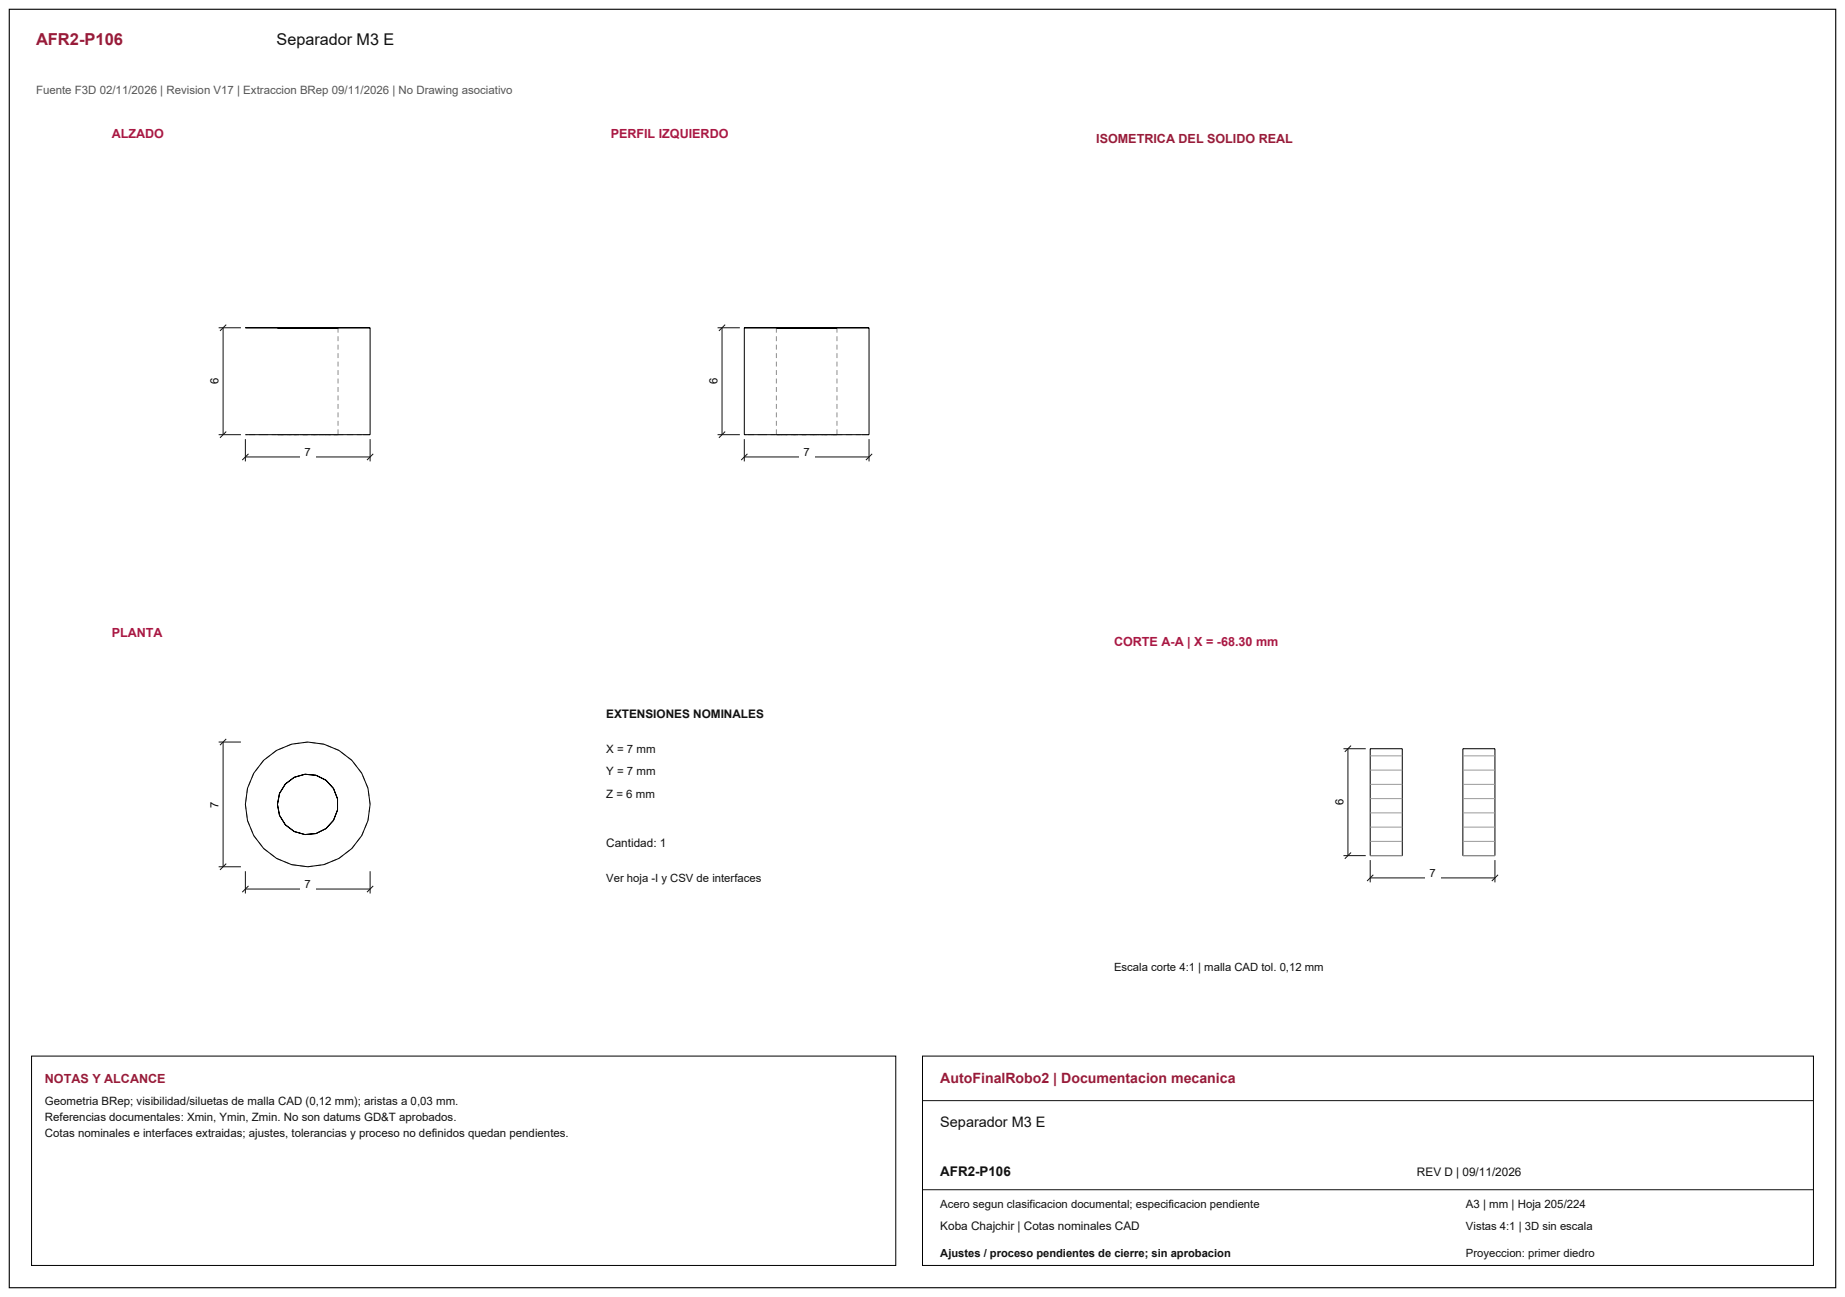
[picture p261: page 22]
ALZADO; PERFIL IZQUIERDO; PLANTA; CORTE A-A | X = -68.30 mm; EXTENSIONES NOMINALES; Cantidad: 1; NOTAS Y ALCANCE; AutoFinalRobo2 | Documentacion mecanica; Separador M3 E; AFR2-P106; REV D | 09/11/2026

ISOMETRICA DEL SOLIDO REAL

Ver hoja -I y CSV de interfaces

Escala corte 4:1 | malla CAD tol. 0,12 mm

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

Acero segun clasificacion documental; especificacion pendiente

Vistas 4:1 | 3D sin escala

AFR2-P106-I01 | Interfaces y corte | Separador M3 E

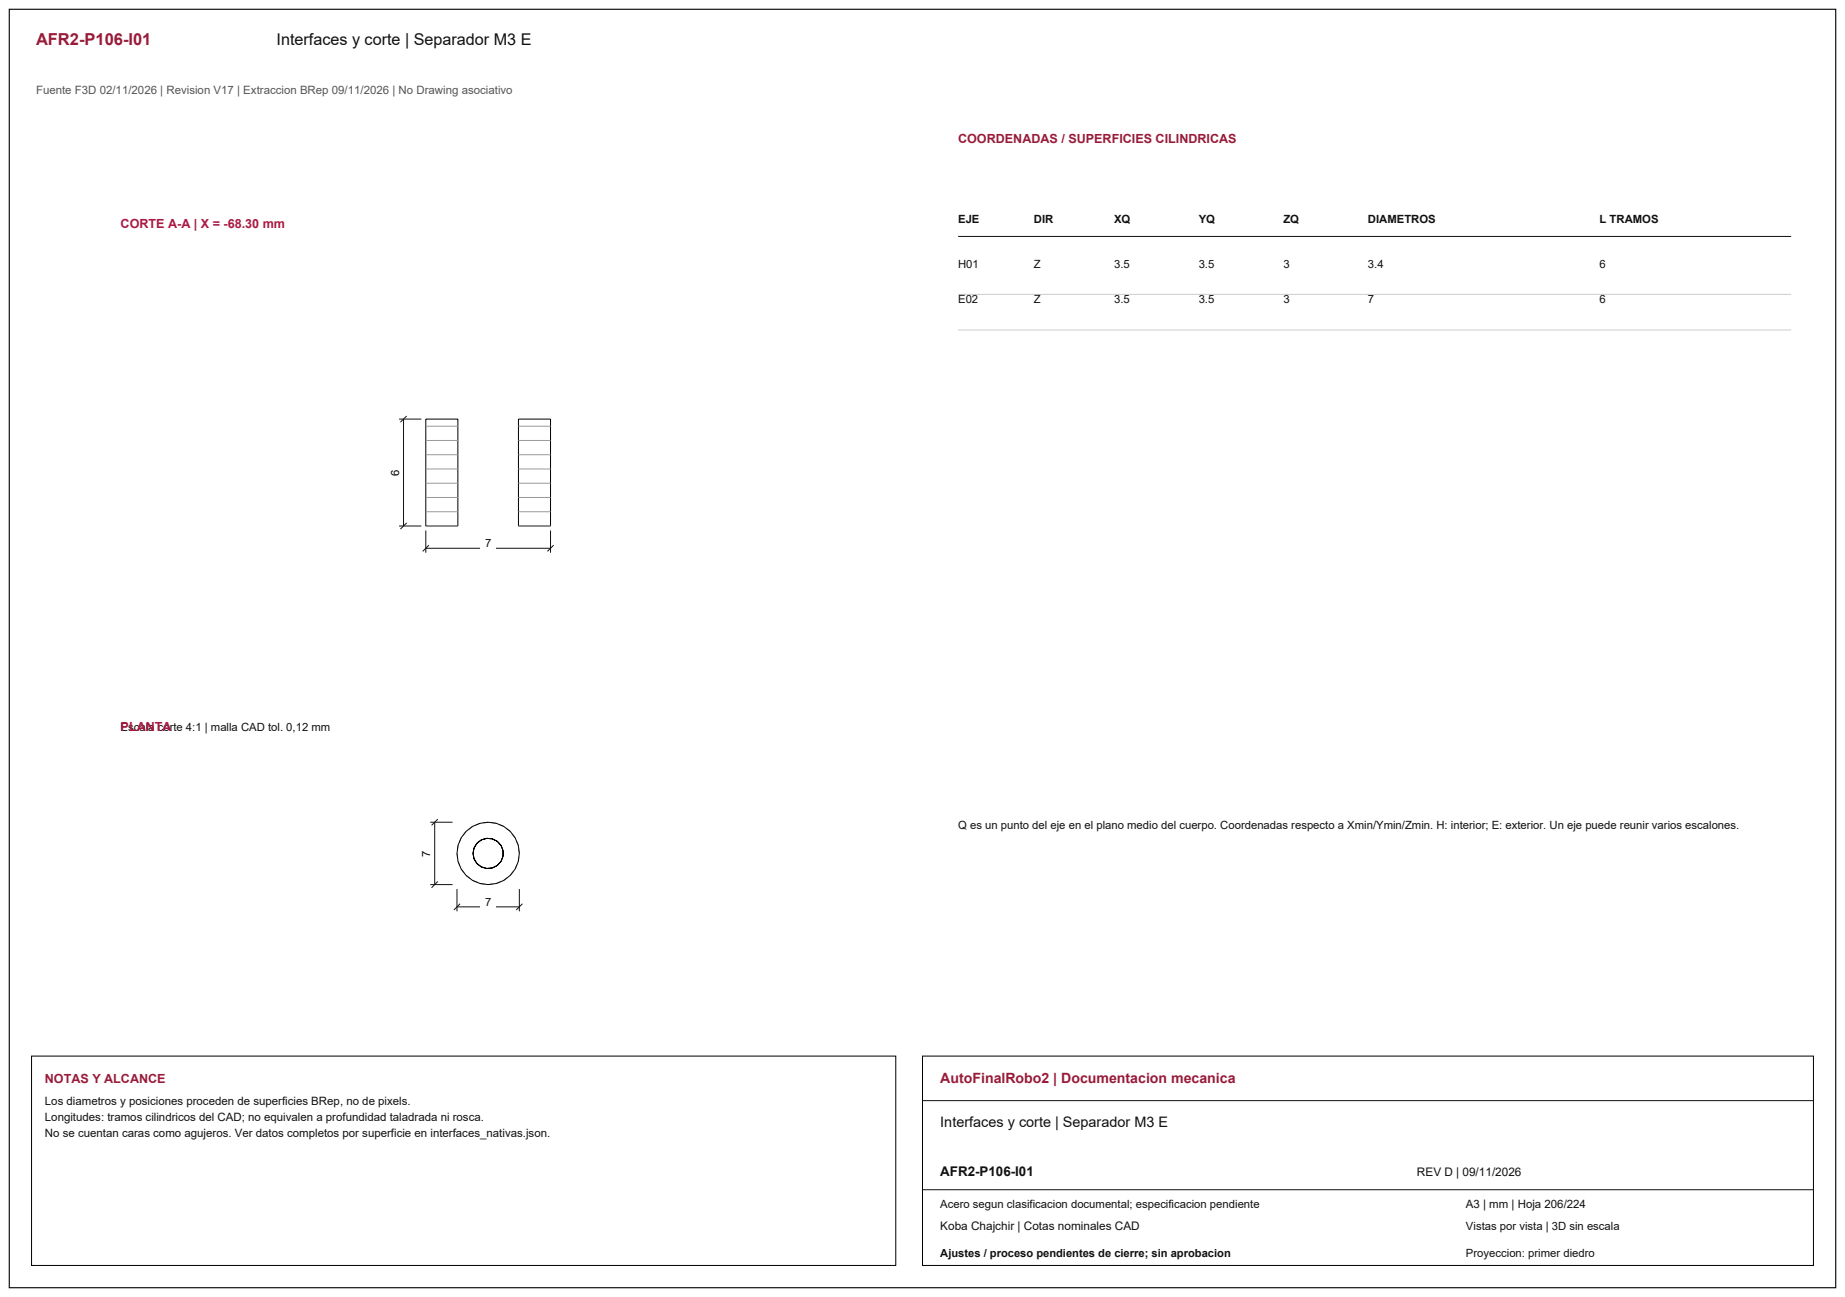
[picture p262: page 23]
CORTE A-A | X = -68.30 mm; EJE; DIR; DIAMETROS; L TRAMOS; NOTAS Y ALCANCE; AutoFinalRobo2 | Documentacion mecanica; AFR2-P106-I01; REV D | 09/11/2026

COORDENADAS / SUPERFICIES CILINDRICAS

Escala corte 4:1 | malla CAD tol. 0,12 mm PLANTA

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

Interfaces y corte | Separador M3 E

Acero segun clasificacion documental; especificacion pendiente

AFR2-P107 | Separador M3 F

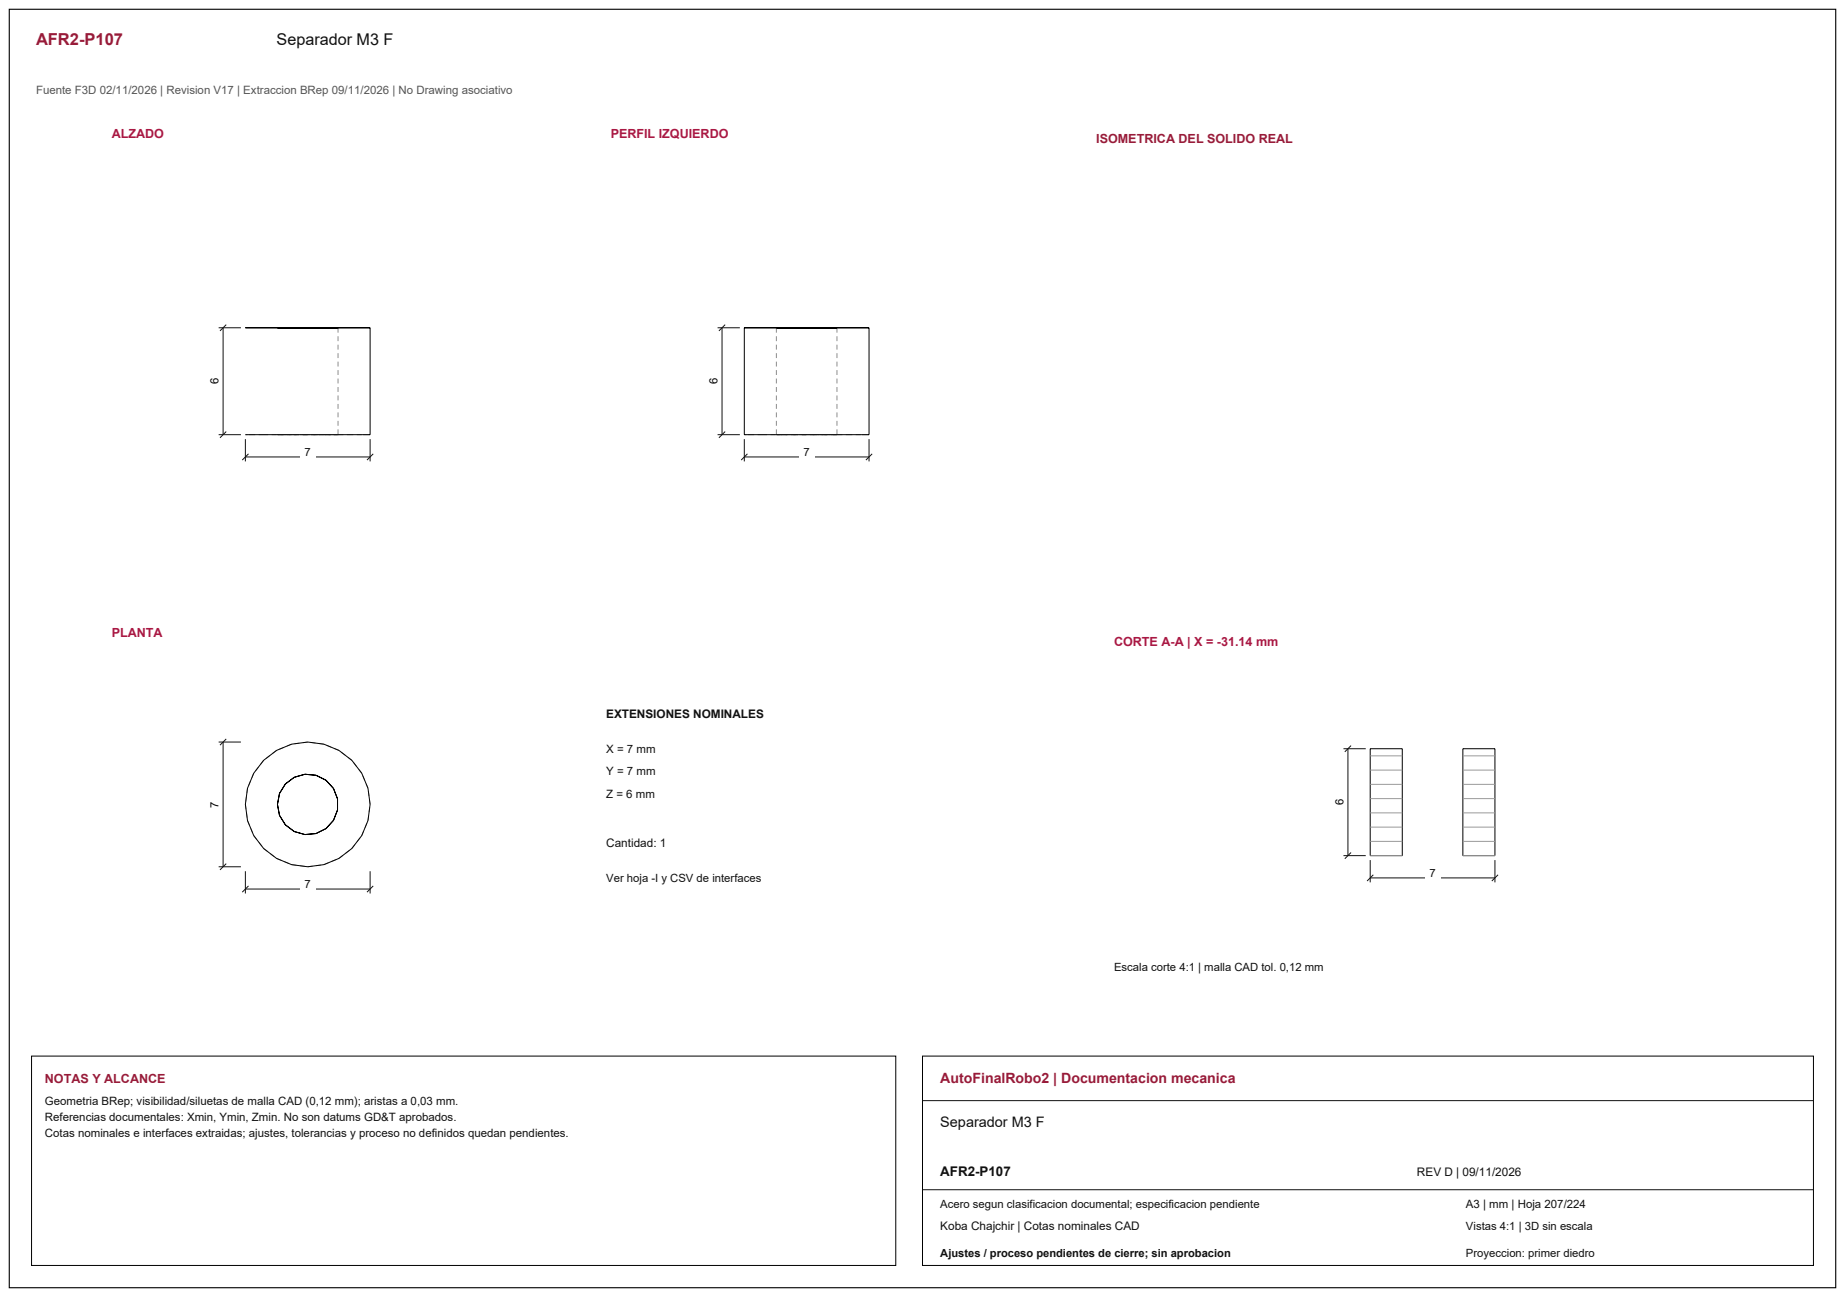
[picture p263: page 24]
ALZADO; PERFIL IZQUIERDO; PLANTA; CORTE A-A | X = -31.14 mm; EXTENSIONES NOMINALES; Cantidad: 1; NOTAS Y ALCANCE; AutoFinalRobo2 | Documentacion mecanica; Separador M3 F; AFR2-P107; REV D | 09/11/2026

ISOMETRICA DEL SOLIDO REAL

Ver hoja -I y CSV de interfaces

Escala corte 4:1 | malla CAD tol. 0,12 mm

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

Acero segun clasificacion documental; especificacion pendiente

Vistas 4:1 | 3D sin escala

AFR2-P107-I01 | Interfaces y corte | Separador M3 F

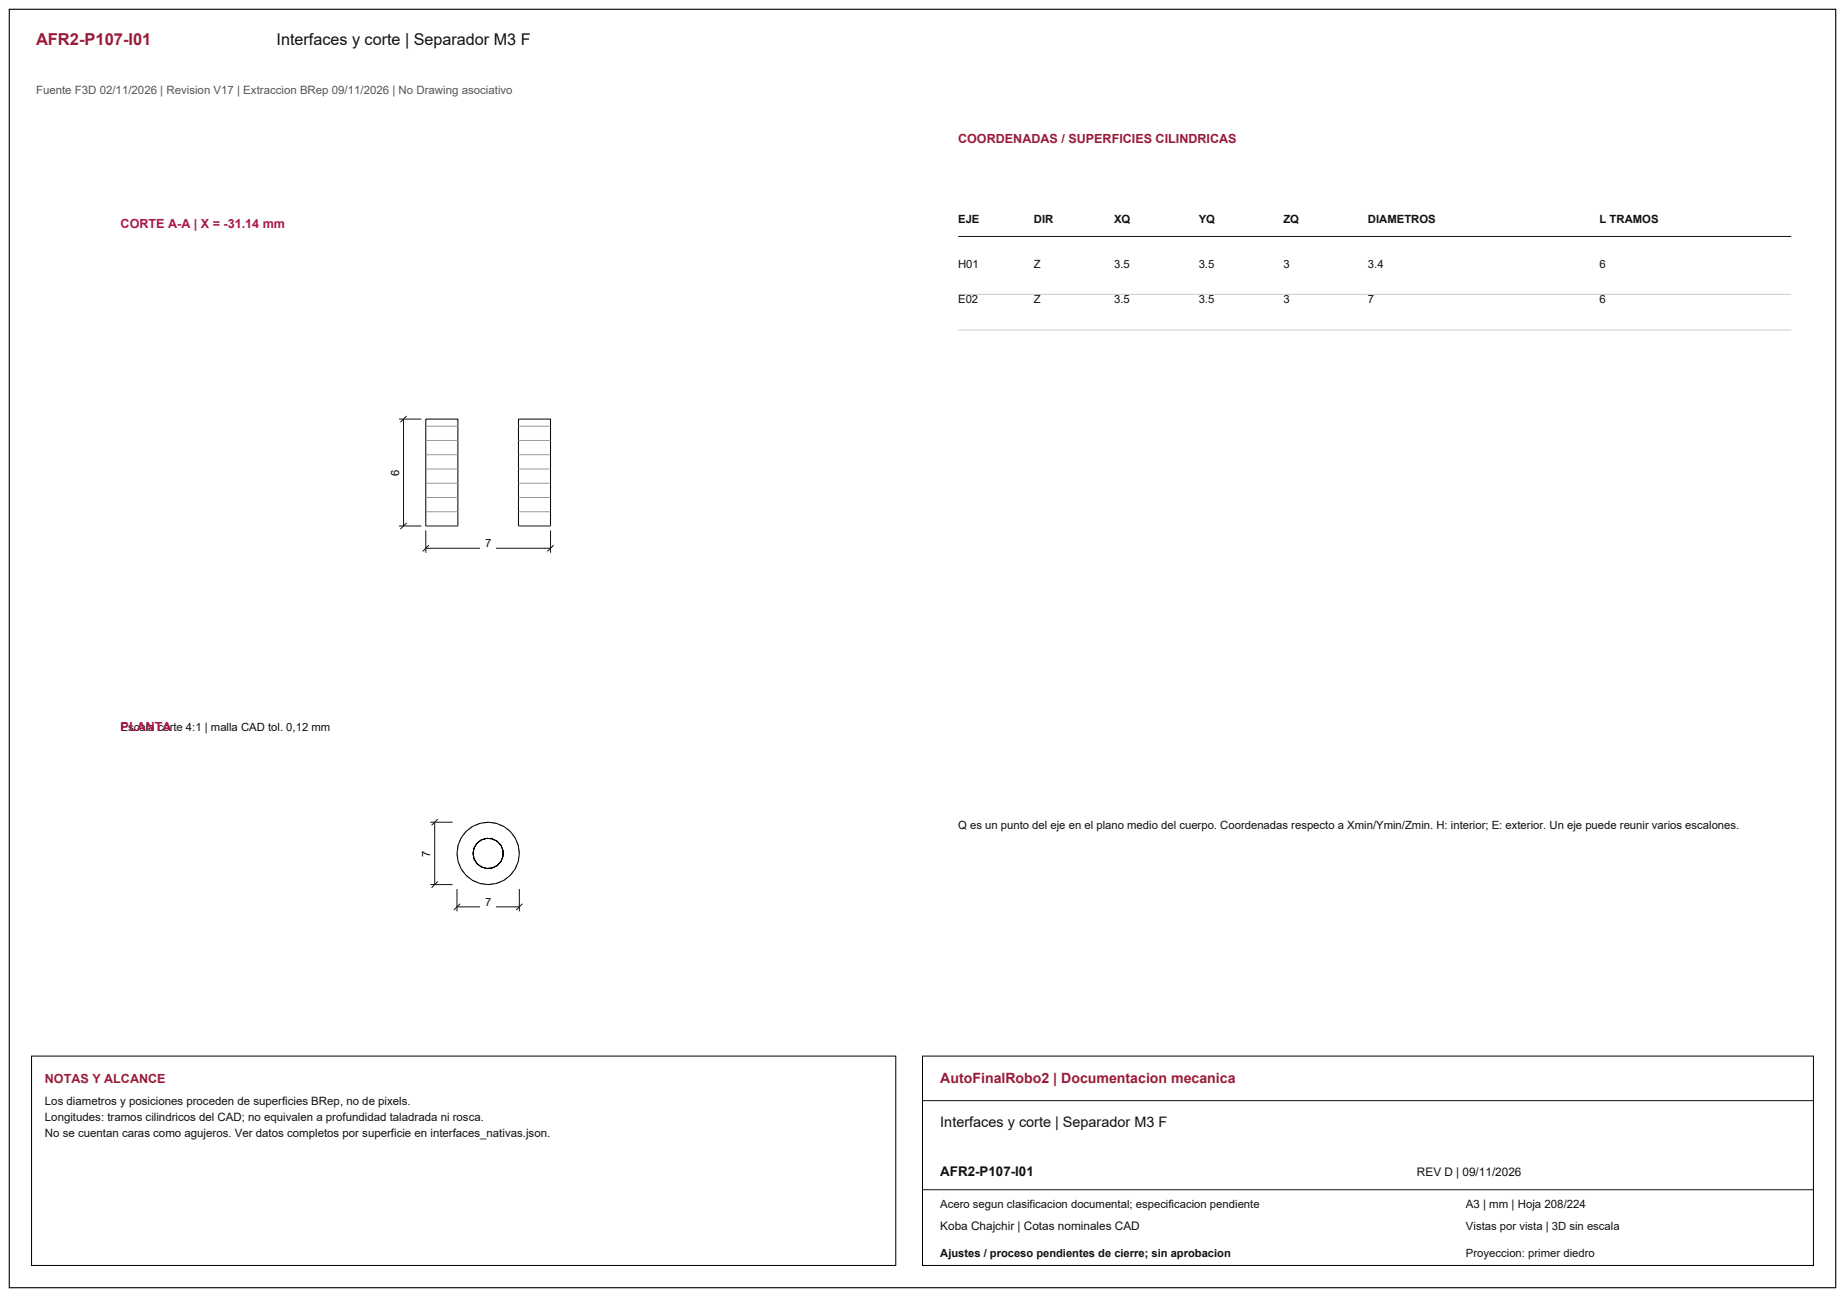
[picture p264: page 25]
CORTE A-A | X = -31.14 mm; EJE; DIR; DIAMETROS; L TRAMOS; NOTAS Y ALCANCE; AutoFinalRobo2 | Documentacion mecanica; AFR2-P107-I01; REV D | 09/11/2026

COORDENADAS / SUPERFICIES CILINDRICAS

Escala corte 4:1 | malla CAD tol. 0,12 mm PLANTA

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

Interfaces y corte | Separador M3 F

Acero segun clasificacion documental; especificacion pendiente

AFR2-P108 | Montura baja PLA

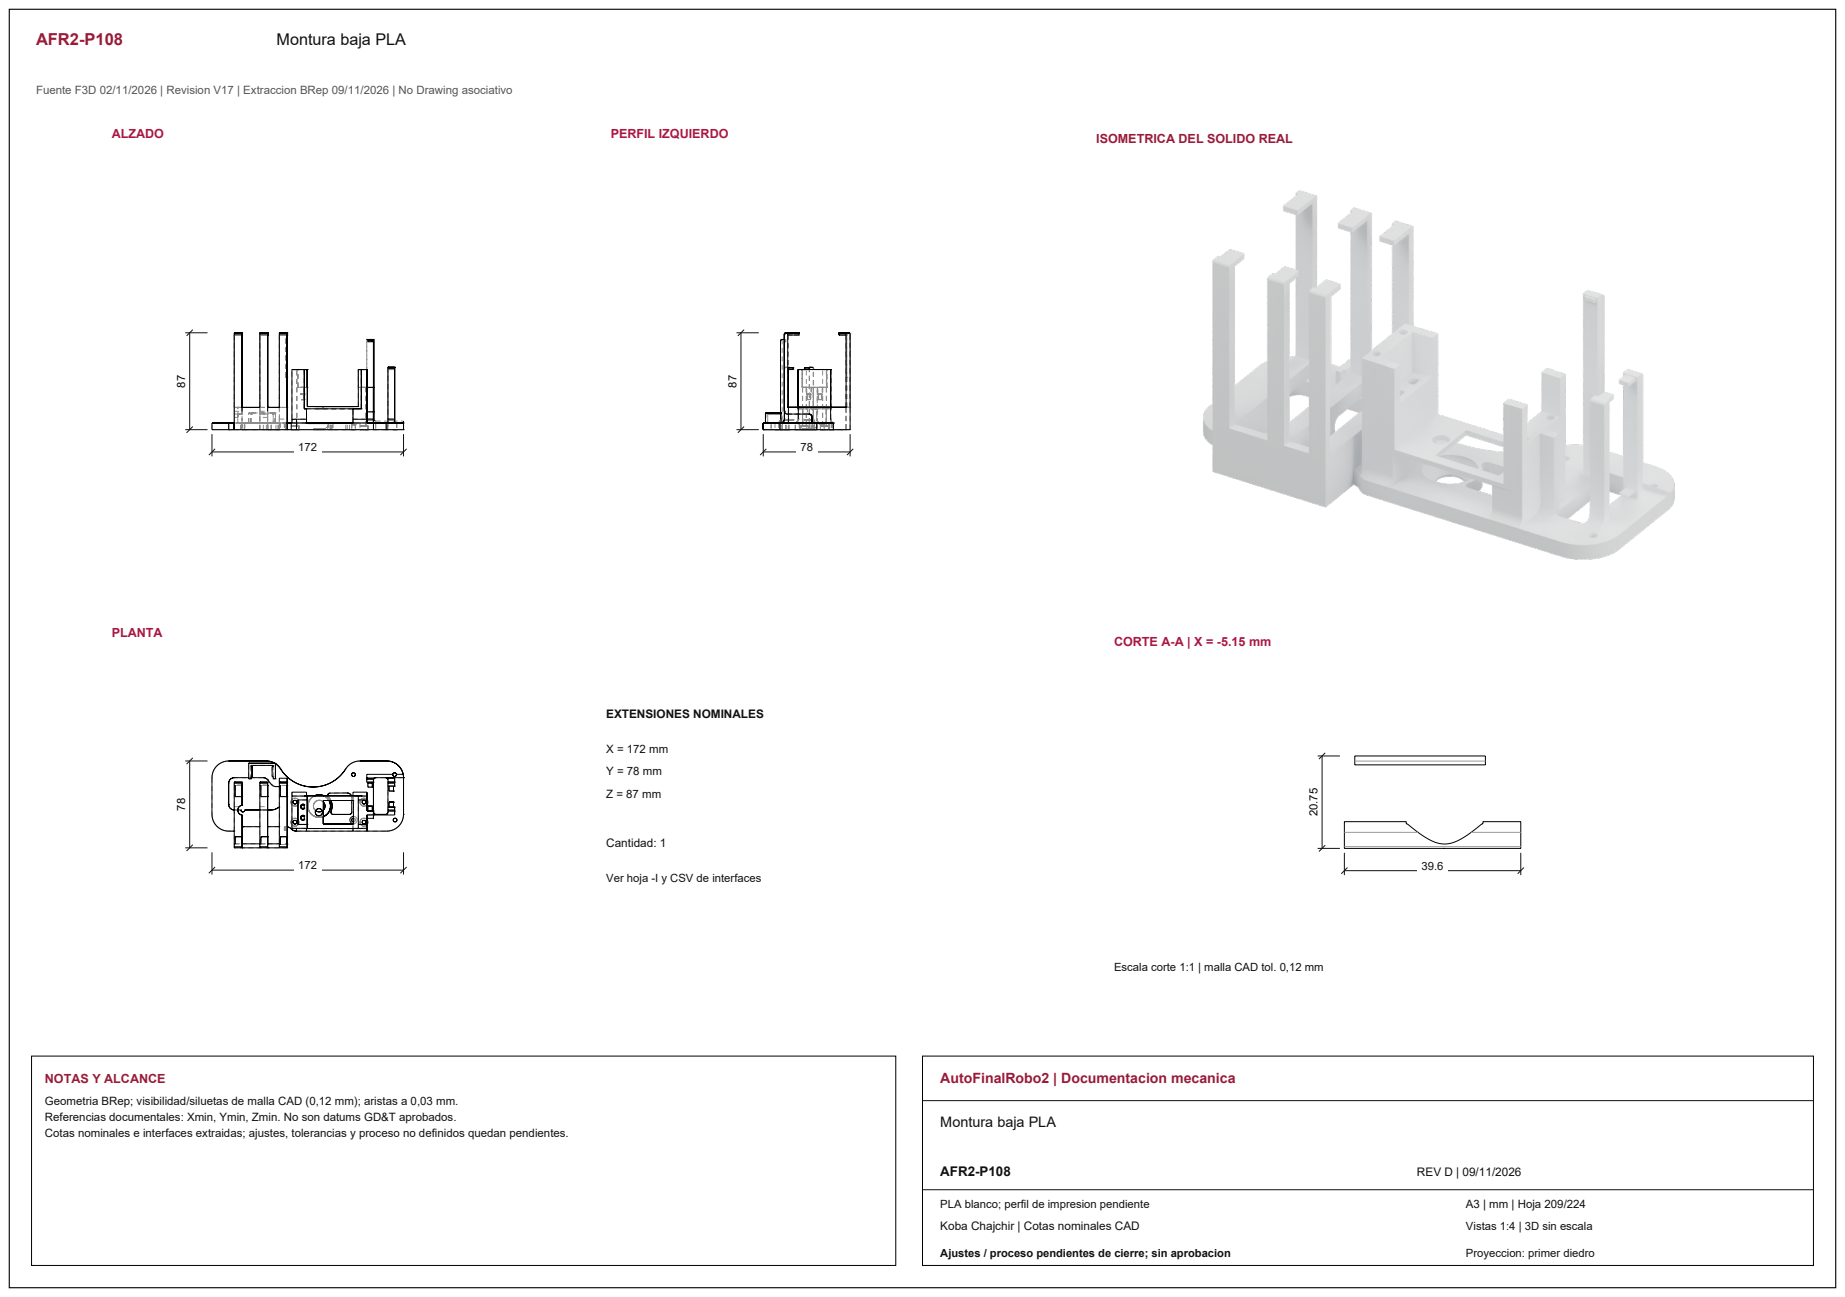
[picture p265: page 26]
ALZADO; PERFIL IZQUIERDO; PLANTA; CORTE A-A | X = -5.15 mm; EXTENSIONES NOMINALES; Cantidad: 1; NOTAS Y ALCANCE; AutoFinalRobo2 | Documentacion mecanica; AFR2-P108; REV D | 09/11/2026

ISOMETRICA DEL SOLIDO REAL

Ver hoja -I y CSV de interfaces

Escala corte 1:1 | malla CAD tol. 0,12 mm

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

Montura baja PLA

PLA blanco; perfil de impresion pendiente

Vistas 1:4 | 3D sin escala

AFR2-P108-I01 | Interfaces y corte | Montura baja PLA

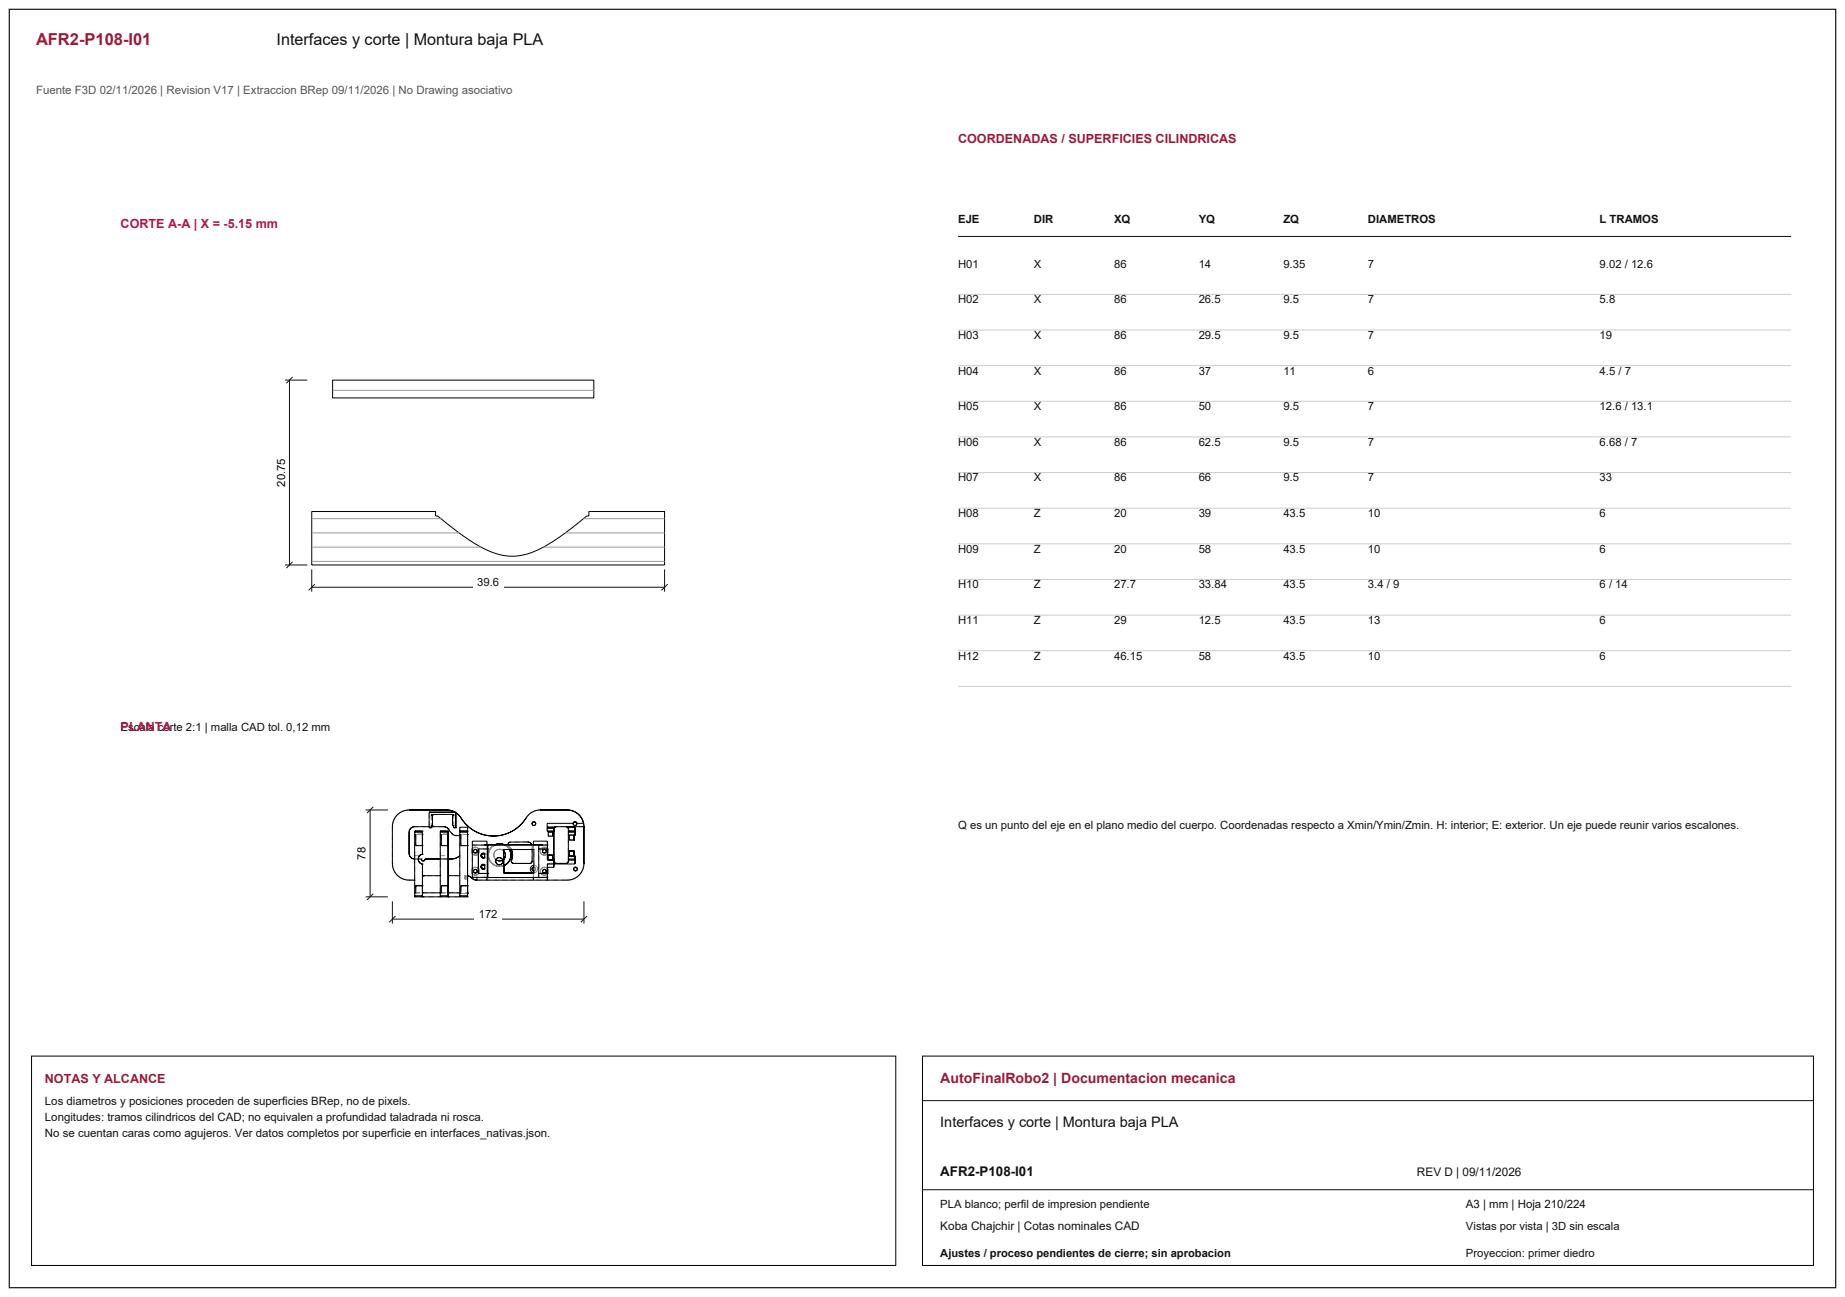
[picture p266: page 27]
CORTE A-A | X = -5.15 mm; EJE; DIR; DIAMETROS; L TRAMOS; NOTAS Y ALCANCE; AutoFinalRobo2 | Documentacion mecanica; AFR2-P108-I01; REV D | 09/11/2026

COORDENADAS / SUPERFICIES CILINDRICAS

Escala corte 2:1 | malla CAD tol. 0,12 mm PLANTA

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

Interfaces y corte | Montura baja PLA

PLA blanco; perfil de impresion pendiente

AFR2-P108-I02 | Interfaces y corte | Montura baja PLA

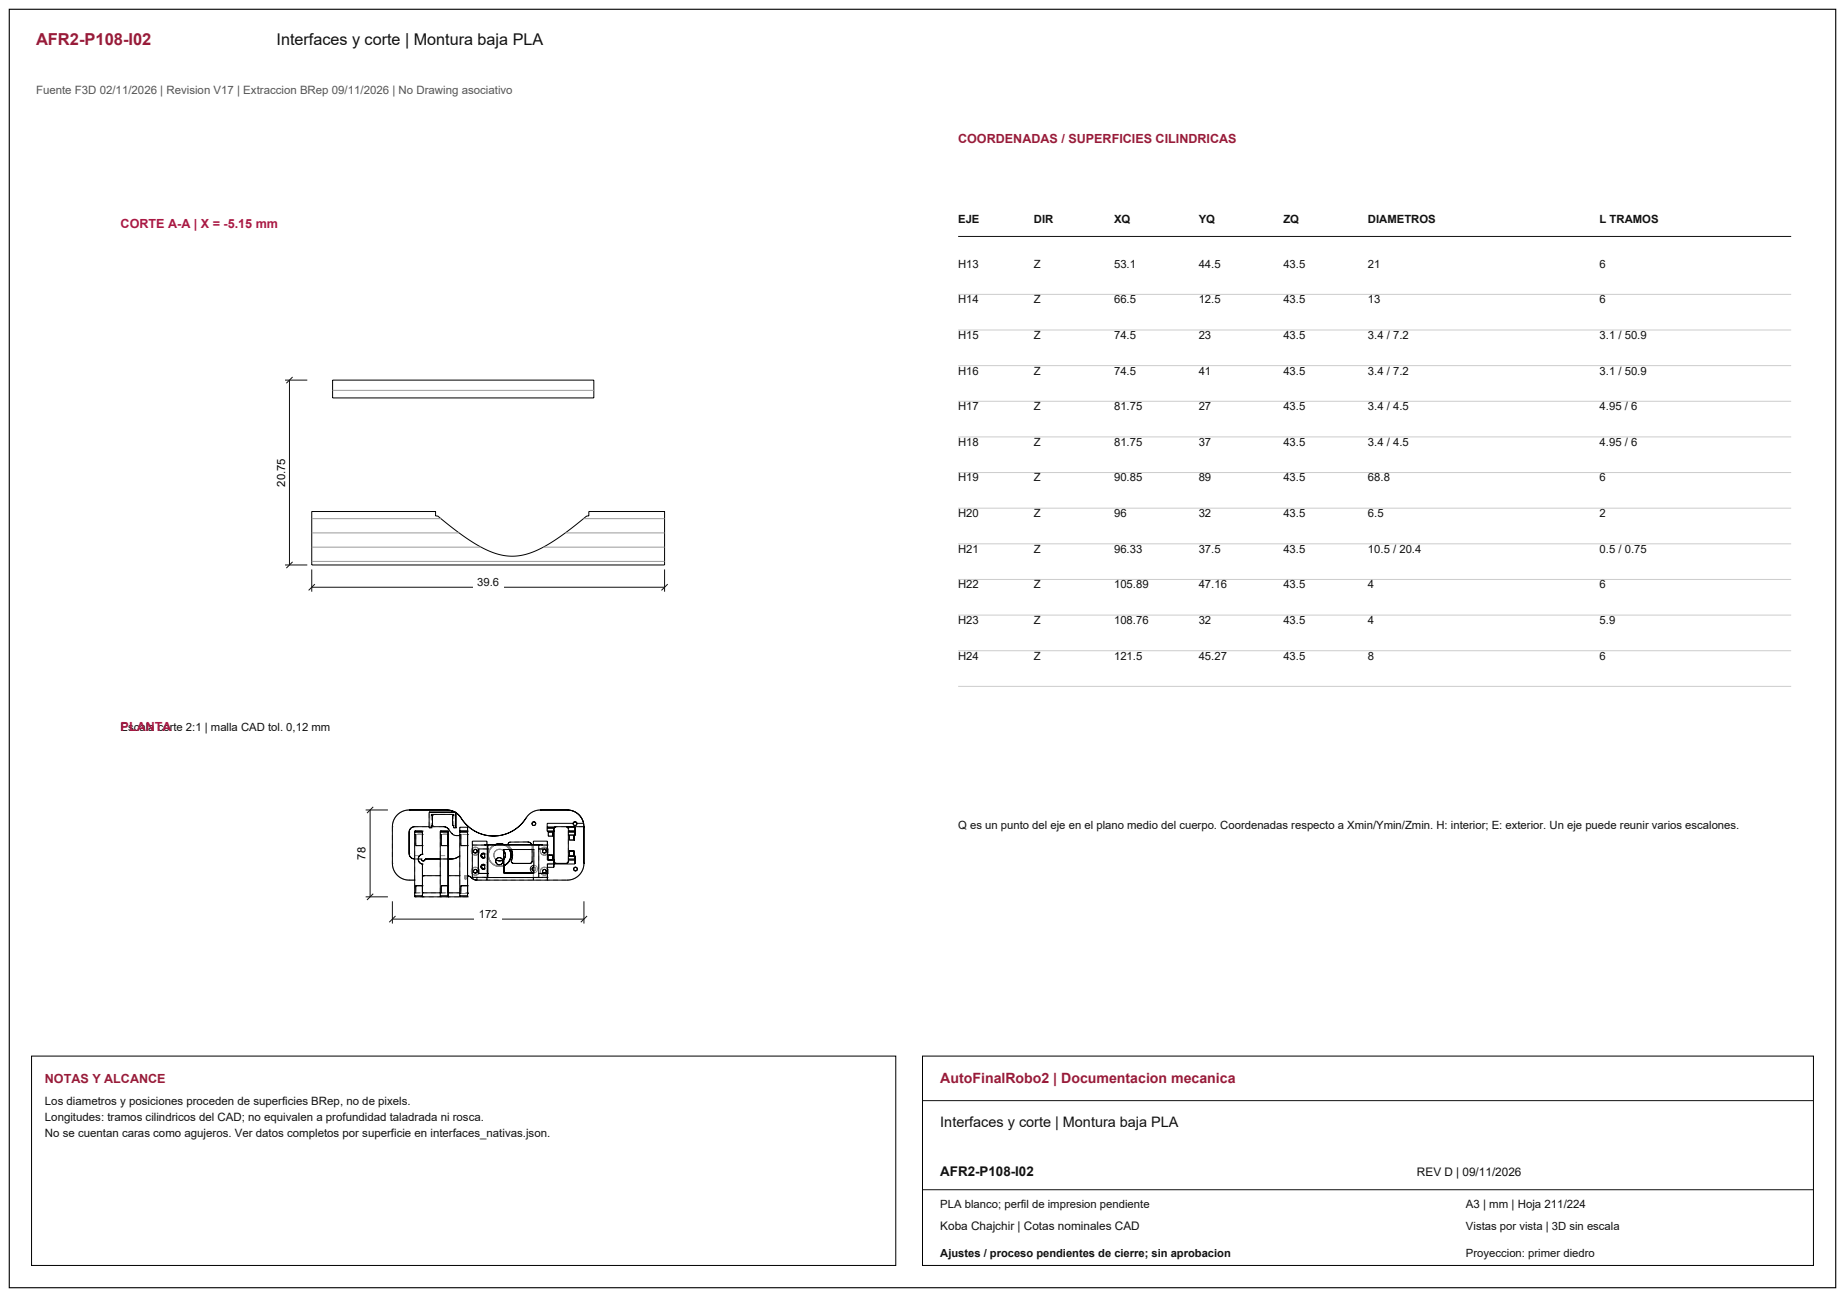
[picture p267: page 28]
CORTE A-A | X = -5.15 mm; EJE; DIR; DIAMETROS; L TRAMOS; NOTAS Y ALCANCE; AutoFinalRobo2 | Documentacion mecanica; AFR2-P108-I02; REV D | 09/11/2026

COORDENADAS / SUPERFICIES CILINDRICAS

Escala corte 2:1 | malla CAD tol. 0,12 mm PLANTA

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

Interfaces y corte | Montura baja PLA

PLA blanco; perfil de impresion pendiente

AFR2-P108-I03 | Interfaces y corte | Montura baja PLA

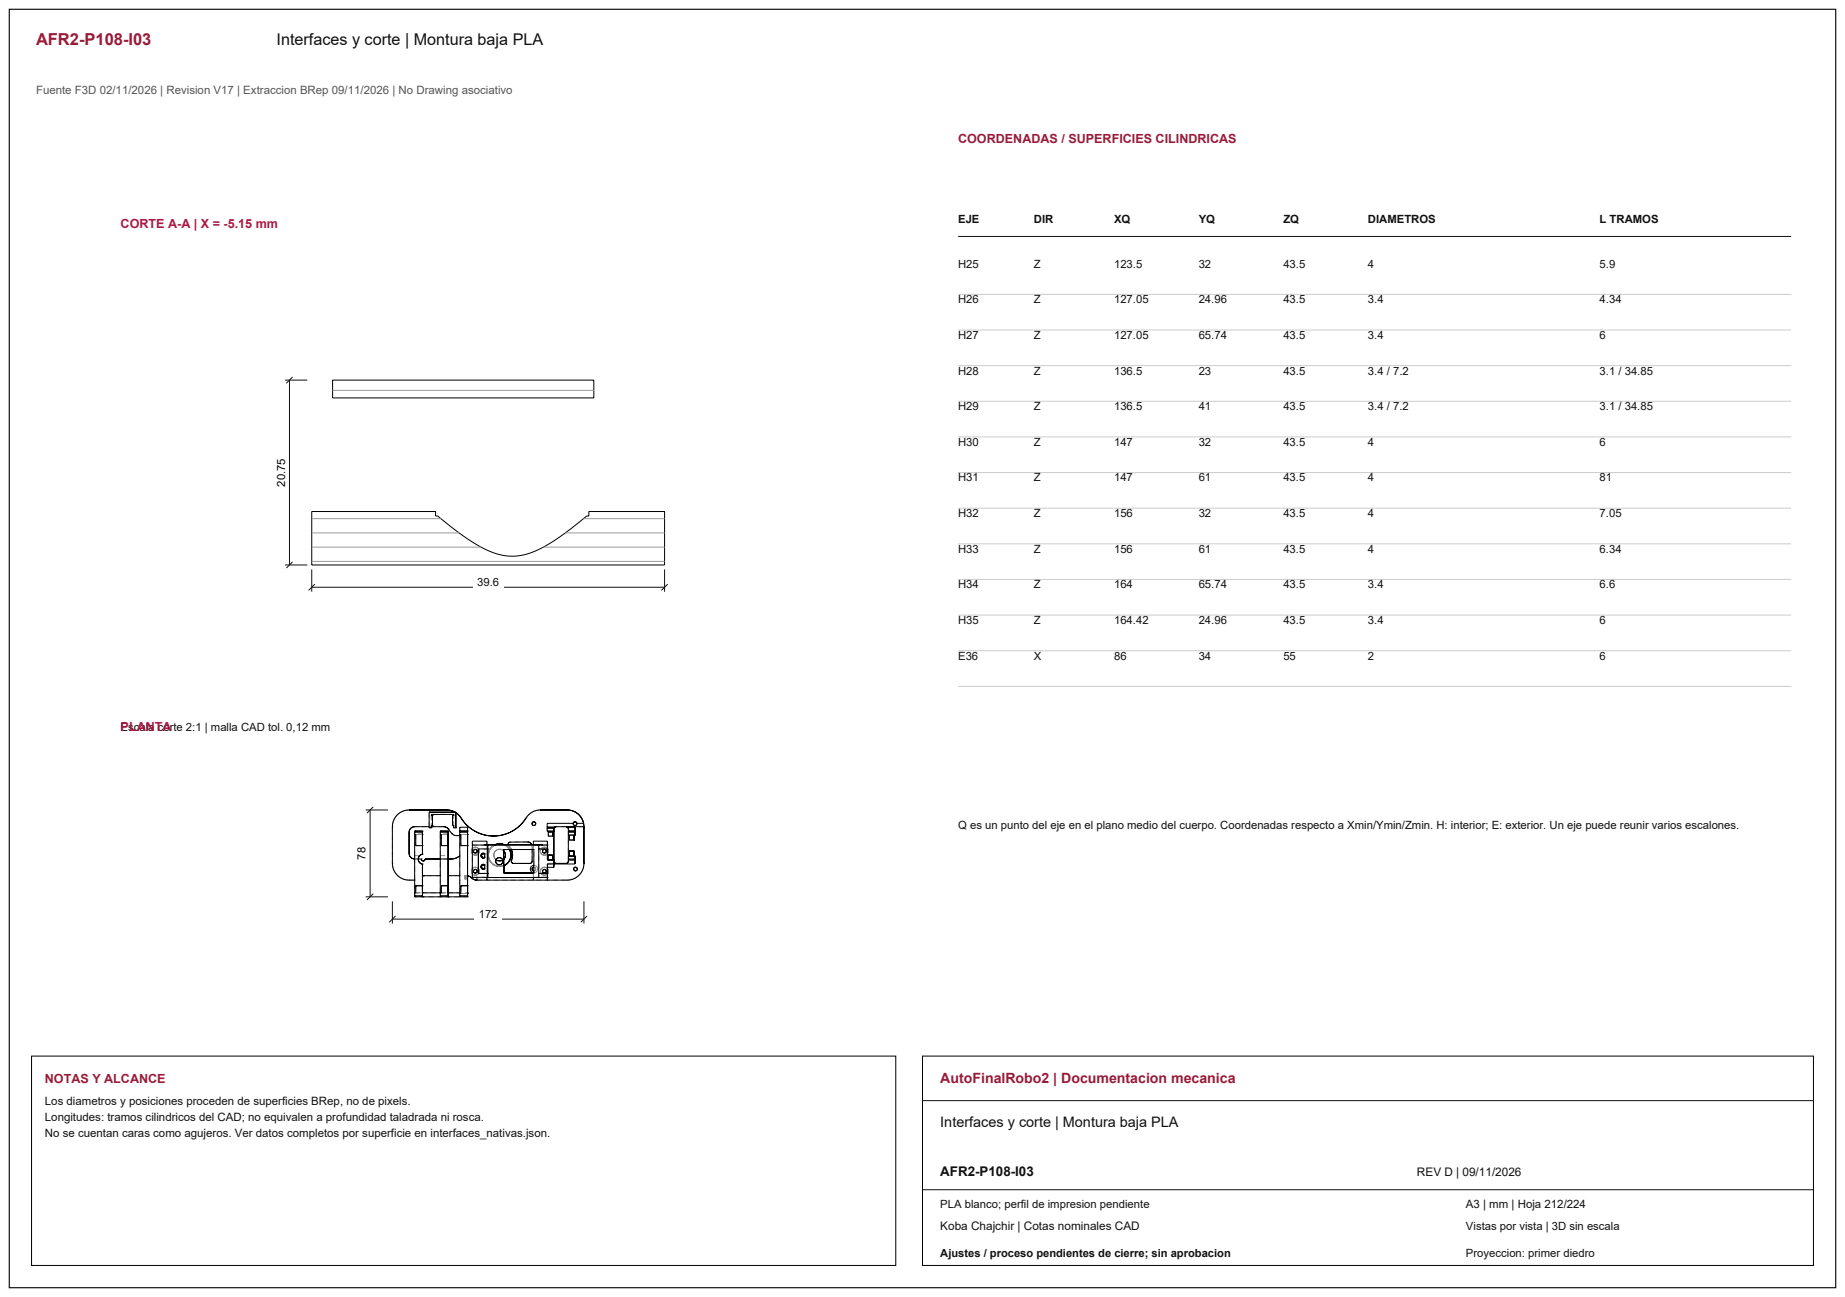
[picture p268: page 29]
CORTE A-A | X = -5.15 mm; EJE; DIR; DIAMETROS; L TRAMOS; NOTAS Y ALCANCE; AutoFinalRobo2 | Documentacion mecanica; AFR2-P108-I03; REV D | 09/11/2026

COORDENADAS / SUPERFICIES CILINDRICAS

Escala corte 2:1 | malla CAD tol. 0,12 mm PLANTA

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

Interfaces y corte | Montura baja PLA

PLA blanco; perfil de impresion pendiente

AFR2-P108-I04 | Interfaces y corte | Montura baja PLA

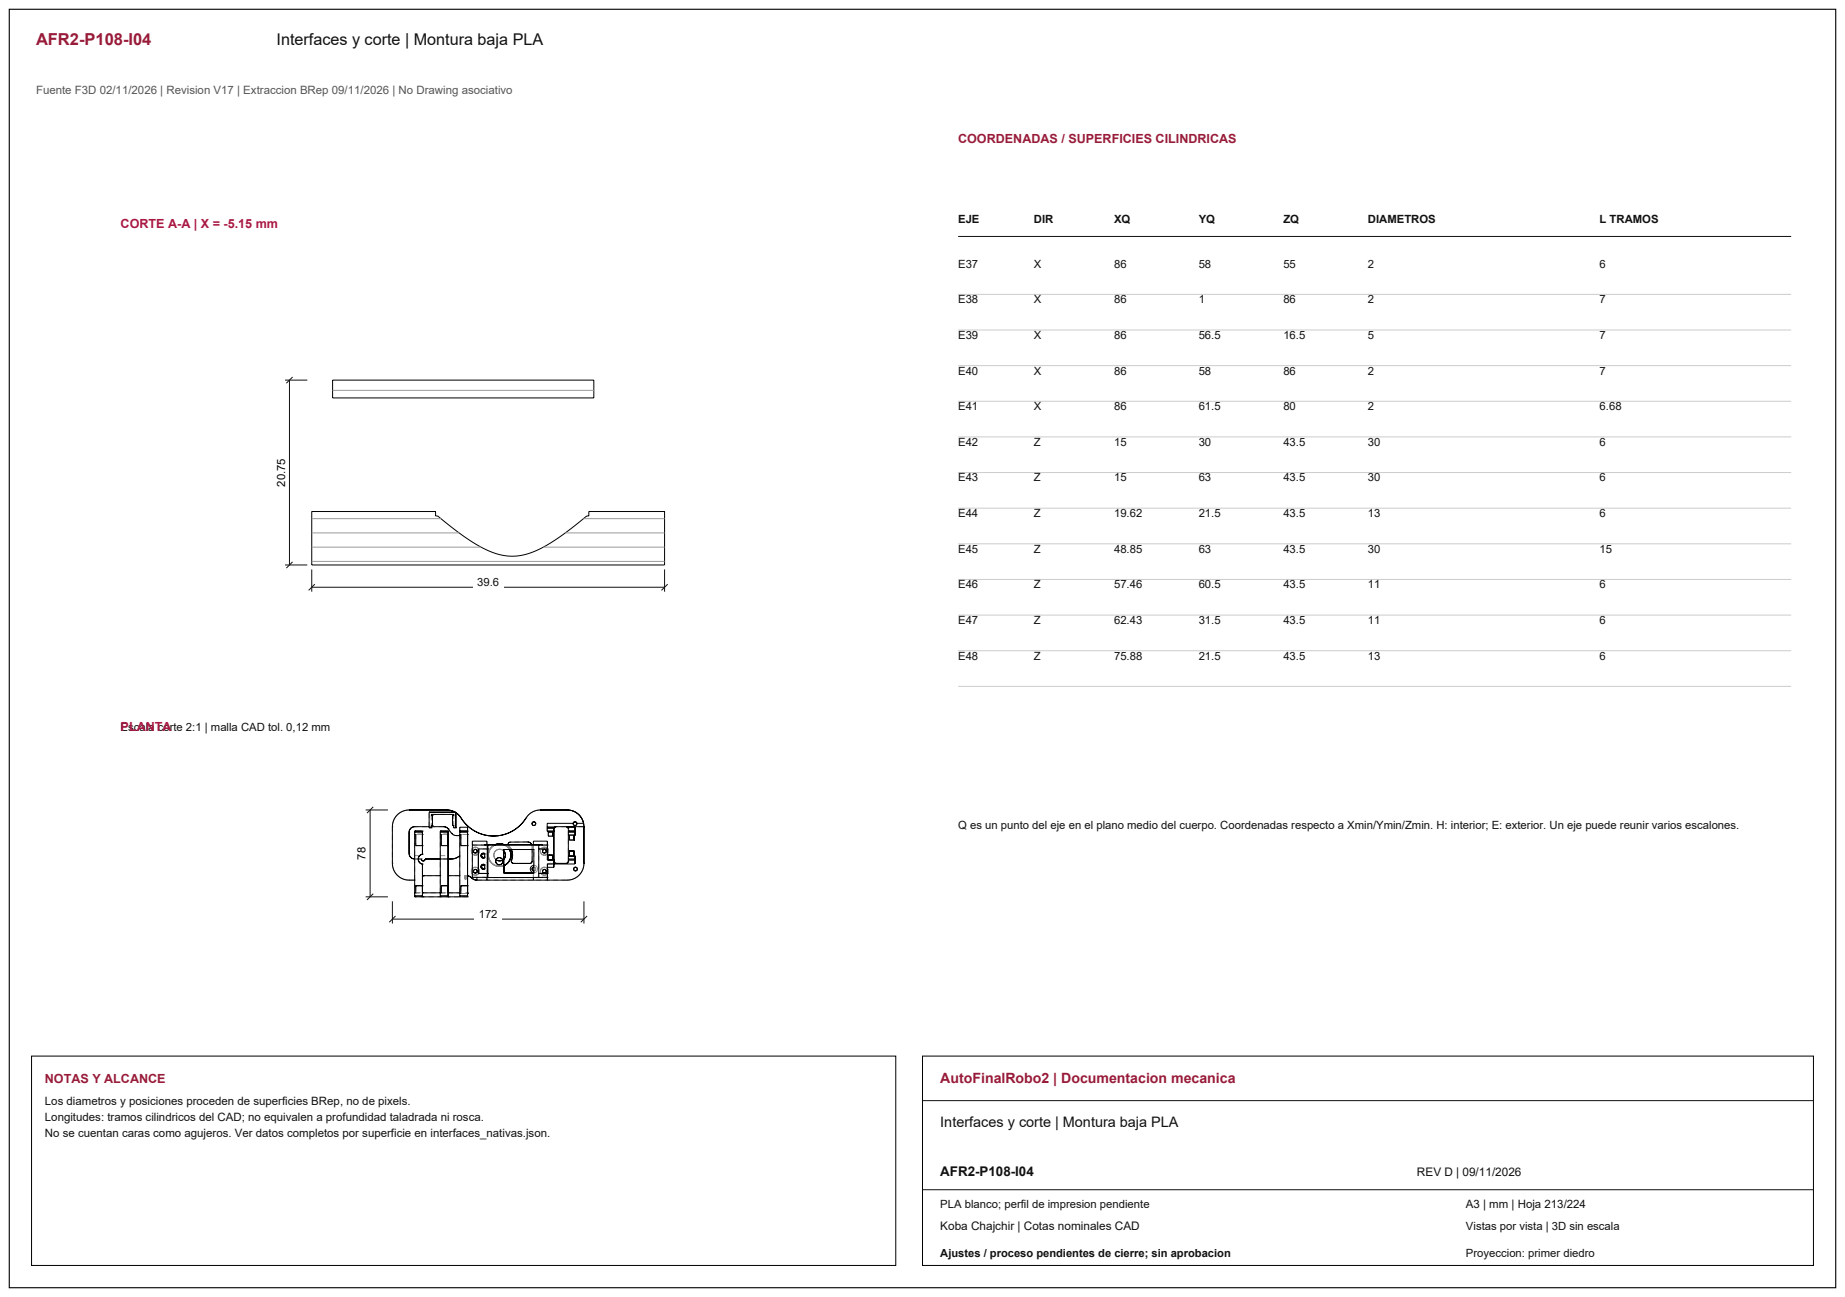
[picture p269: page 30]
CORTE A-A | X = -5.15 mm; EJE; DIR; DIAMETROS; L TRAMOS; NOTAS Y ALCANCE; AutoFinalRobo2 | Documentacion mecanica; AFR2-P108-I04; REV D | 09/11/2026

COORDENADAS / SUPERFICIES CILINDRICAS

Escala corte 2:1 | malla CAD tol. 0,12 mm PLANTA

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

Interfaces y corte | Montura baja PLA

PLA blanco; perfil de impresion pendiente

AFR2-P108-I05 | Interfaces y corte | Montura baja PLA

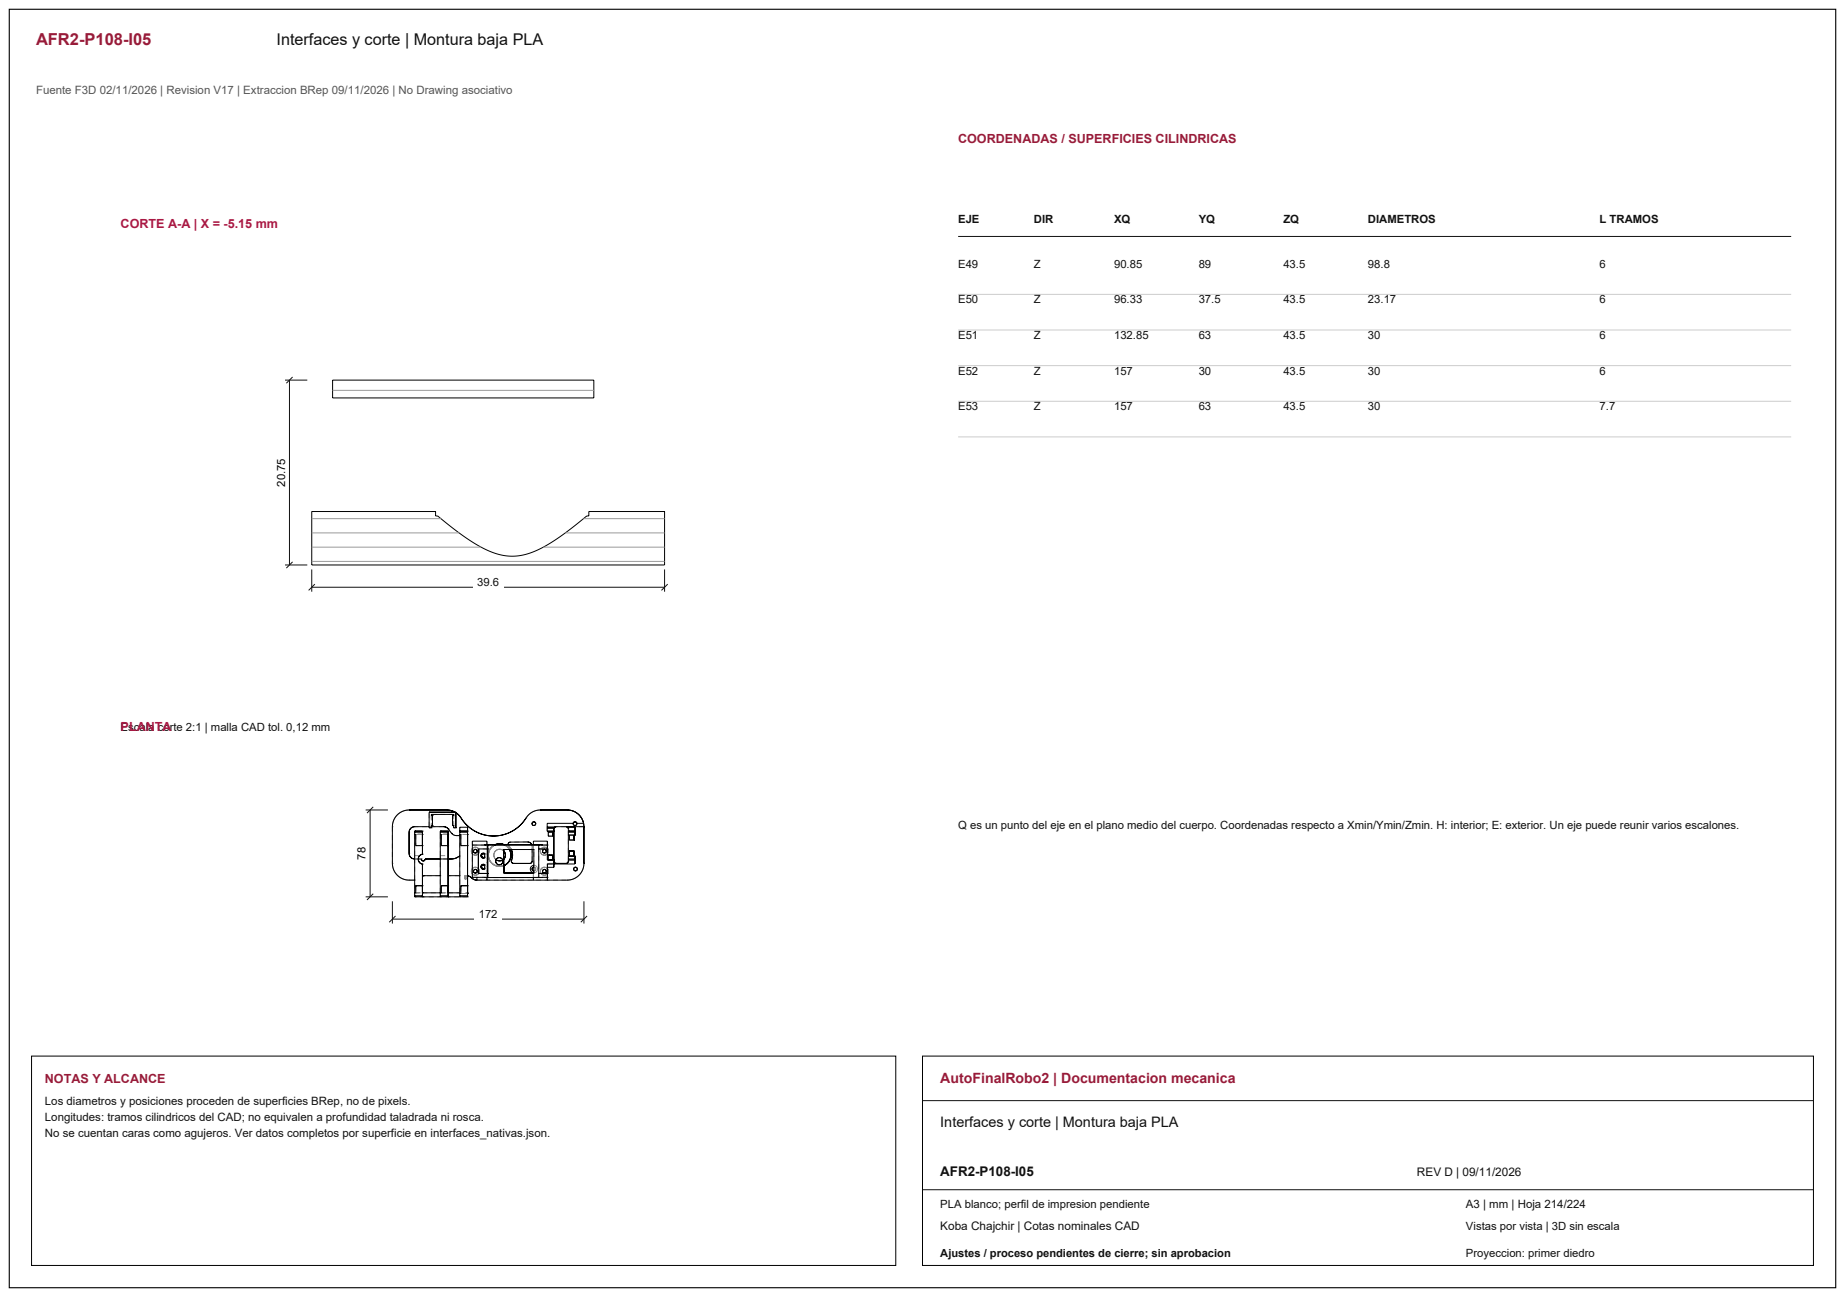
[picture p270: page 31]
CORTE A-A | X = -5.15 mm; EJE; DIR; DIAMETROS; L TRAMOS; NOTAS Y ALCANCE; AutoFinalRobo2 | Documentacion mecanica; AFR2-P108-I05; REV D | 09/11/2026

COORDENADAS / SUPERFICIES CILINDRICAS

Escala corte 2:1 | malla CAD tol. 0,12 mm PLANTA

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

Interfaces y corte | Montura baja PLA

PLA blanco; perfil de impresion pendiente

AFR2-P109 | Contraplaca inferior unica PLA

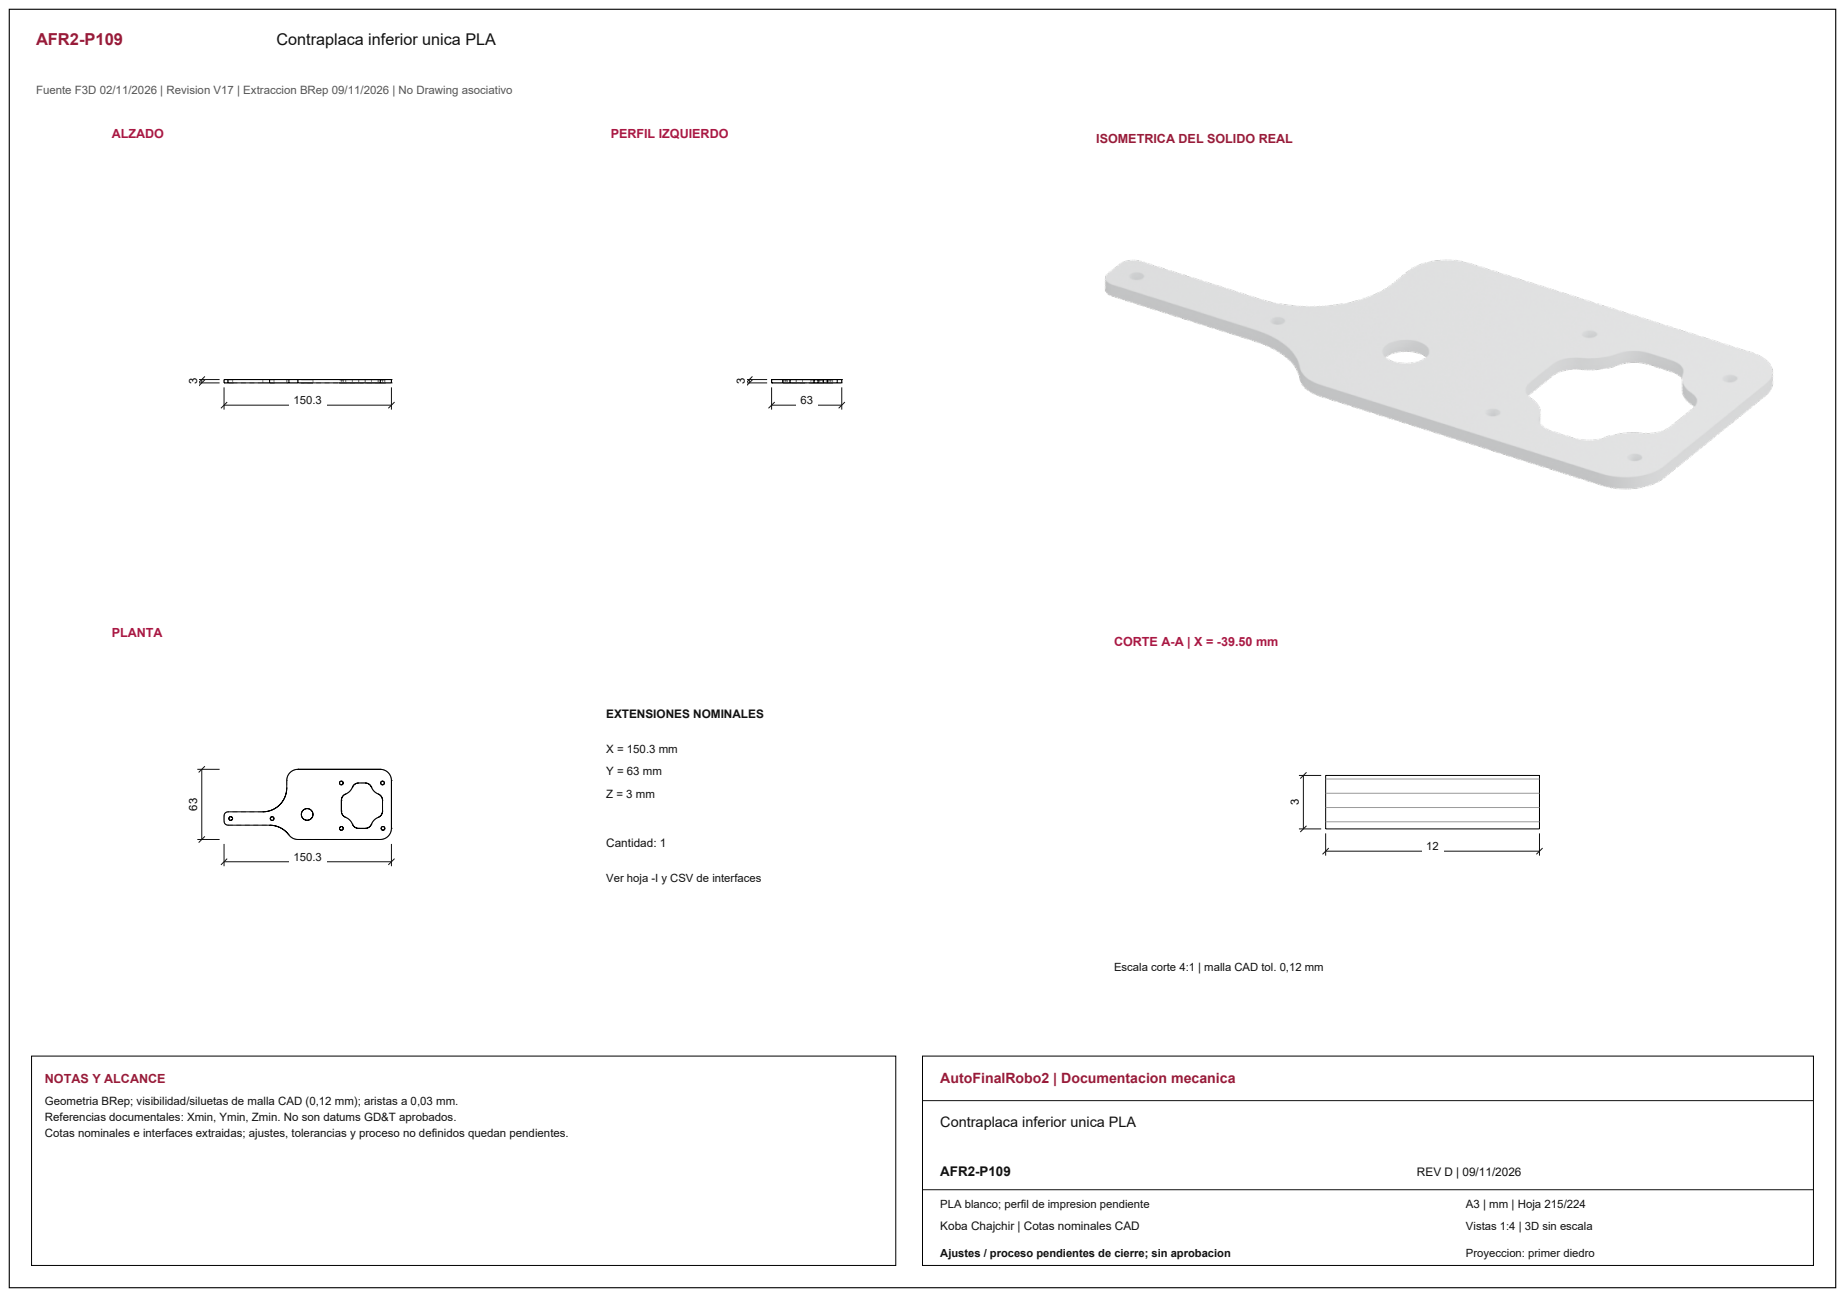
[picture p271: page 32]
ALZADO; PERFIL IZQUIERDO; PLANTA; CORTE A-A | X = -39.50 mm; EXTENSIONES NOMINALES; Cantidad: 1; NOTAS Y ALCANCE; AutoFinalRobo2 | Documentacion mecanica; AFR2-P109; REV D | 09/11/2026

ISOMETRICA DEL SOLIDO REAL

Ver hoja -I y CSV de interfaces

Escala corte 4:1 | malla CAD tol. 0,12 mm

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

Contraplaca inferior unica PLA

PLA blanco; perfil de impresion pendiente

Vistas 1:4 | 3D sin escala

AFR2-P109-I01 | Interfaces y corte | Contraplaca inferior unica PLA

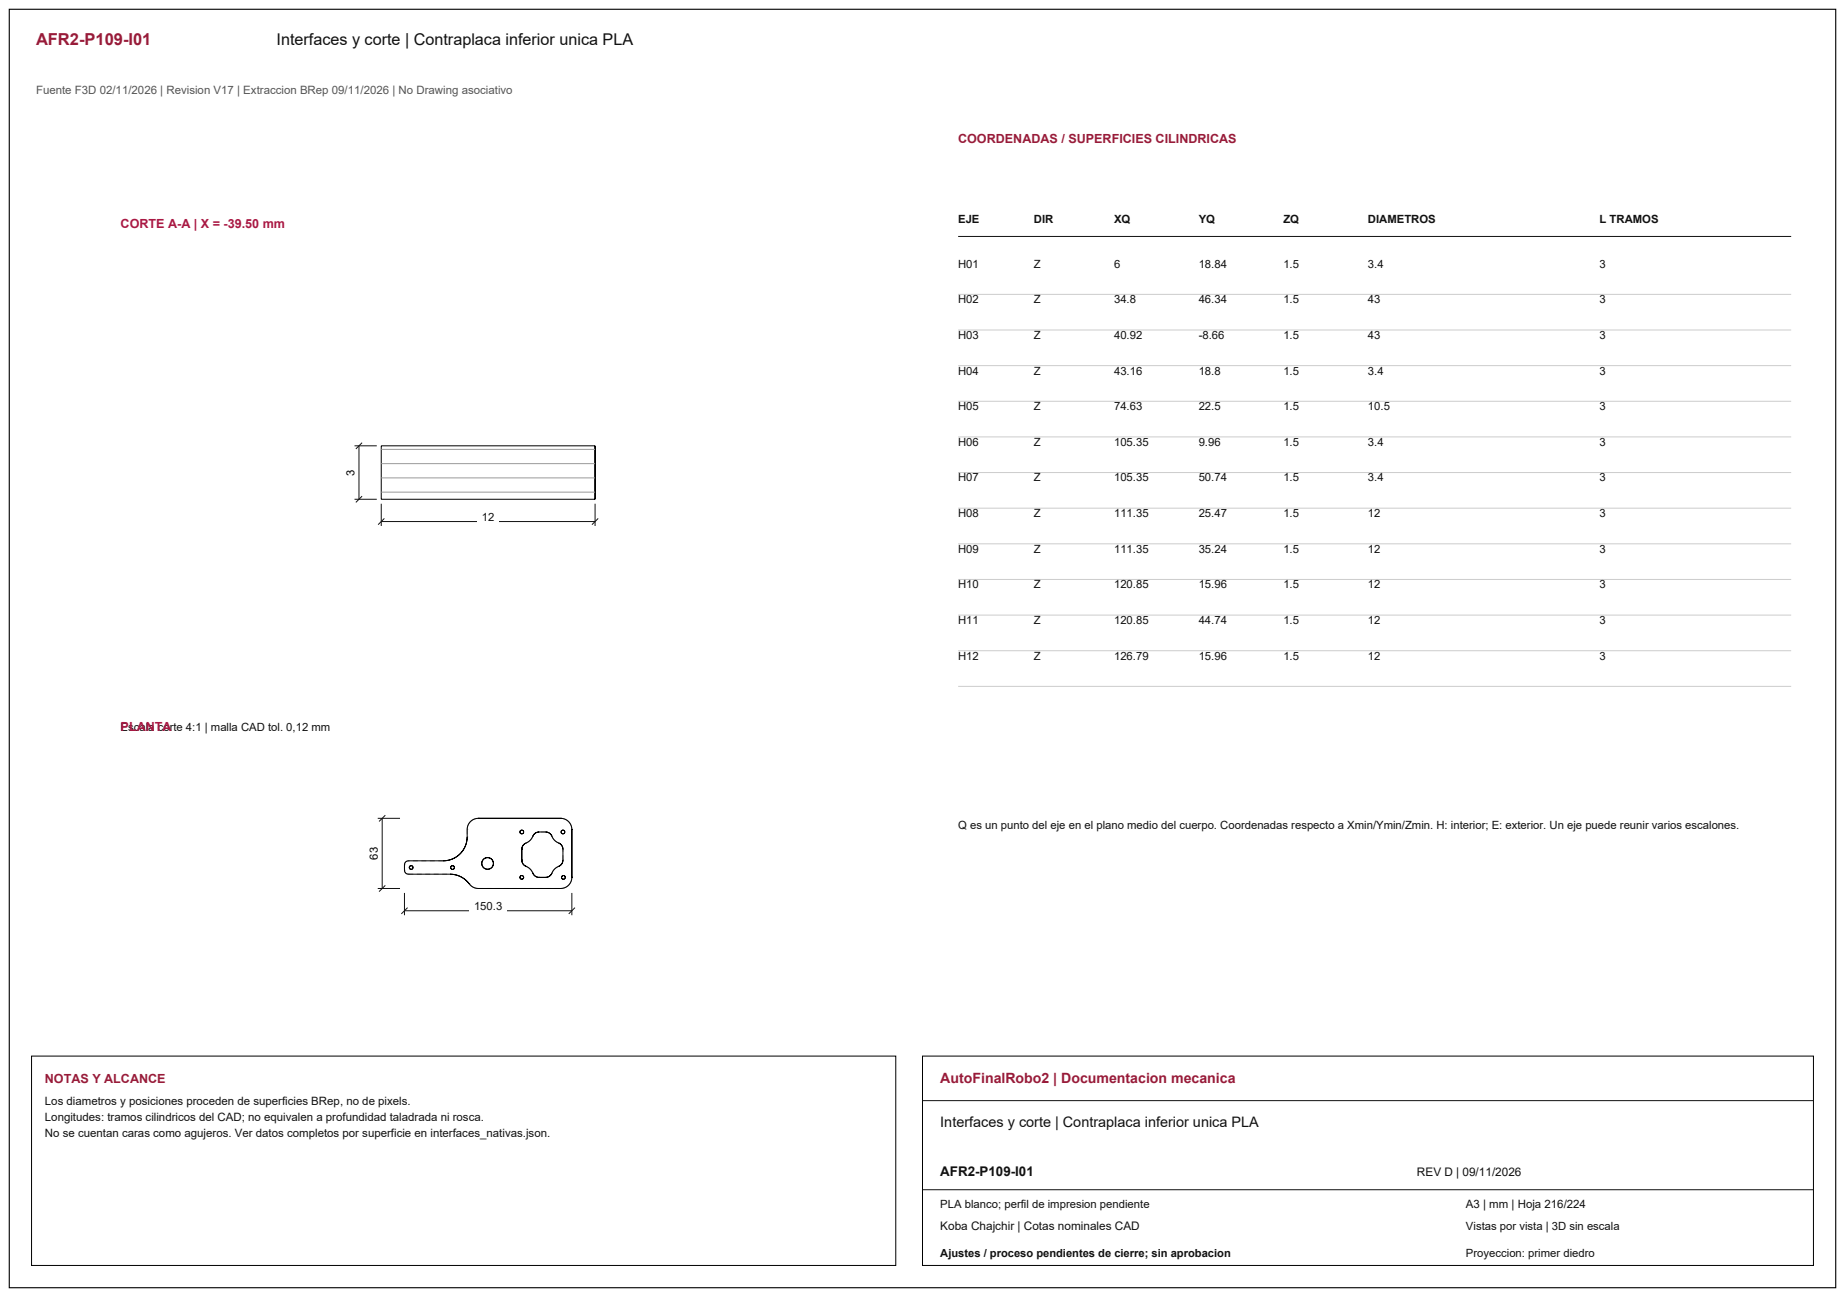
[picture p272: page 33]
CORTE A-A | X = -39.50 mm; EJE; DIR; DIAMETROS; L TRAMOS; NOTAS Y ALCANCE; AutoFinalRobo2 | Documentacion mecanica; AFR2-P109-I01; REV D | 09/11/2026

COORDENADAS / SUPERFICIES CILINDRICAS

Escala corte 4:1 | malla CAD tol. 0,12 mm PLANTA

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

Interfaces y corte | Contraplaca inferior unica PLA

PLA blanco; perfil de impresion pendiente

AFR2-P109-I02 | Interfaces y corte | Contraplaca inferior unica PLA

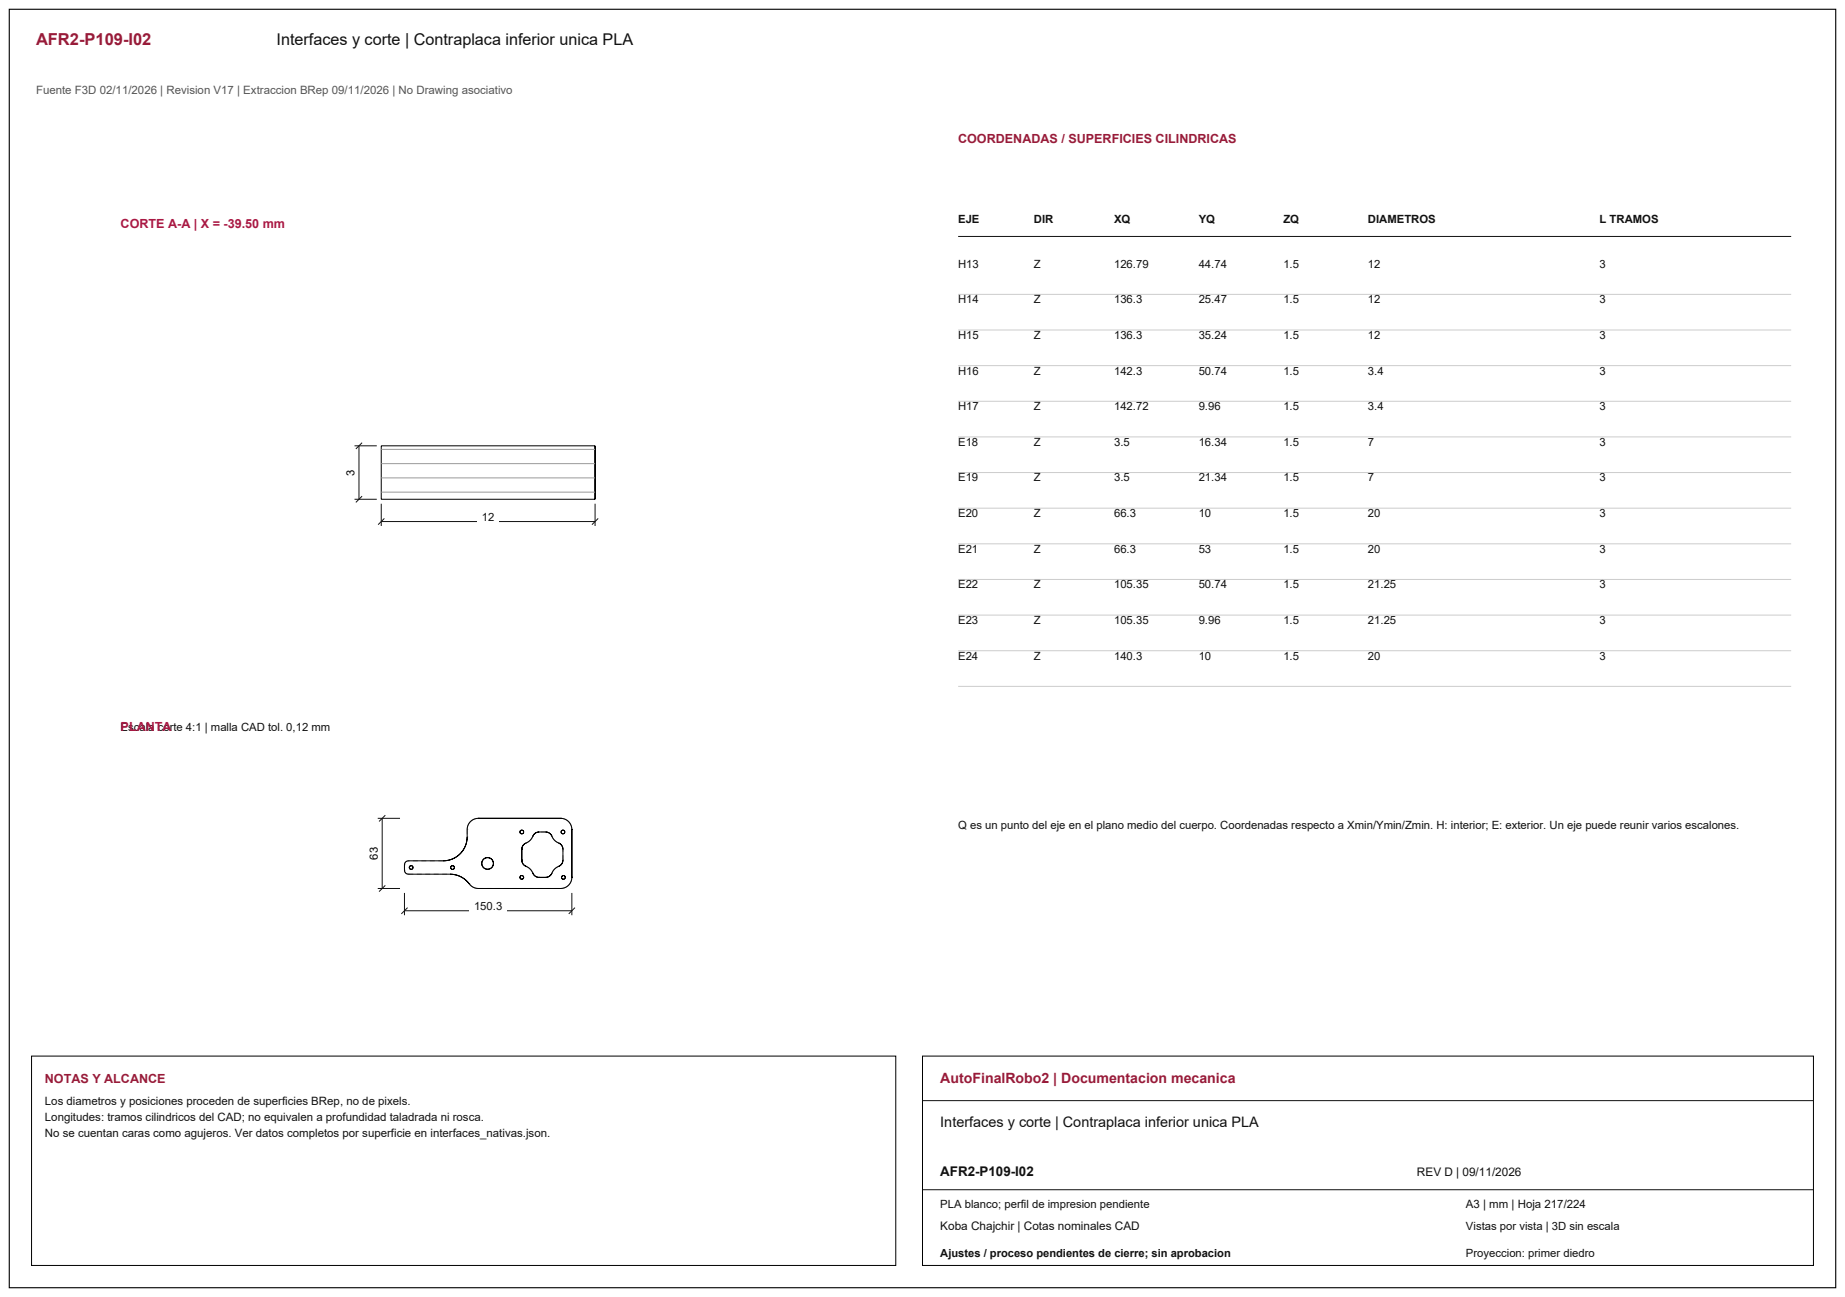
[picture p273: page 34]
CORTE A-A | X = -39.50 mm; EJE; DIR; DIAMETROS; L TRAMOS; NOTAS Y ALCANCE; AutoFinalRobo2 | Documentacion mecanica; AFR2-P109-I02; REV D | 09/11/2026

COORDENADAS / SUPERFICIES CILINDRICAS

Escala corte 4:1 | malla CAD tol. 0,12 mm PLANTA

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

Interfaces y corte | Contraplaca inferior unica PLA

PLA blanco; perfil de impresion pendiente

AFR2-P109-I03 | Interfaces y corte | Contraplaca inferior unica PLA

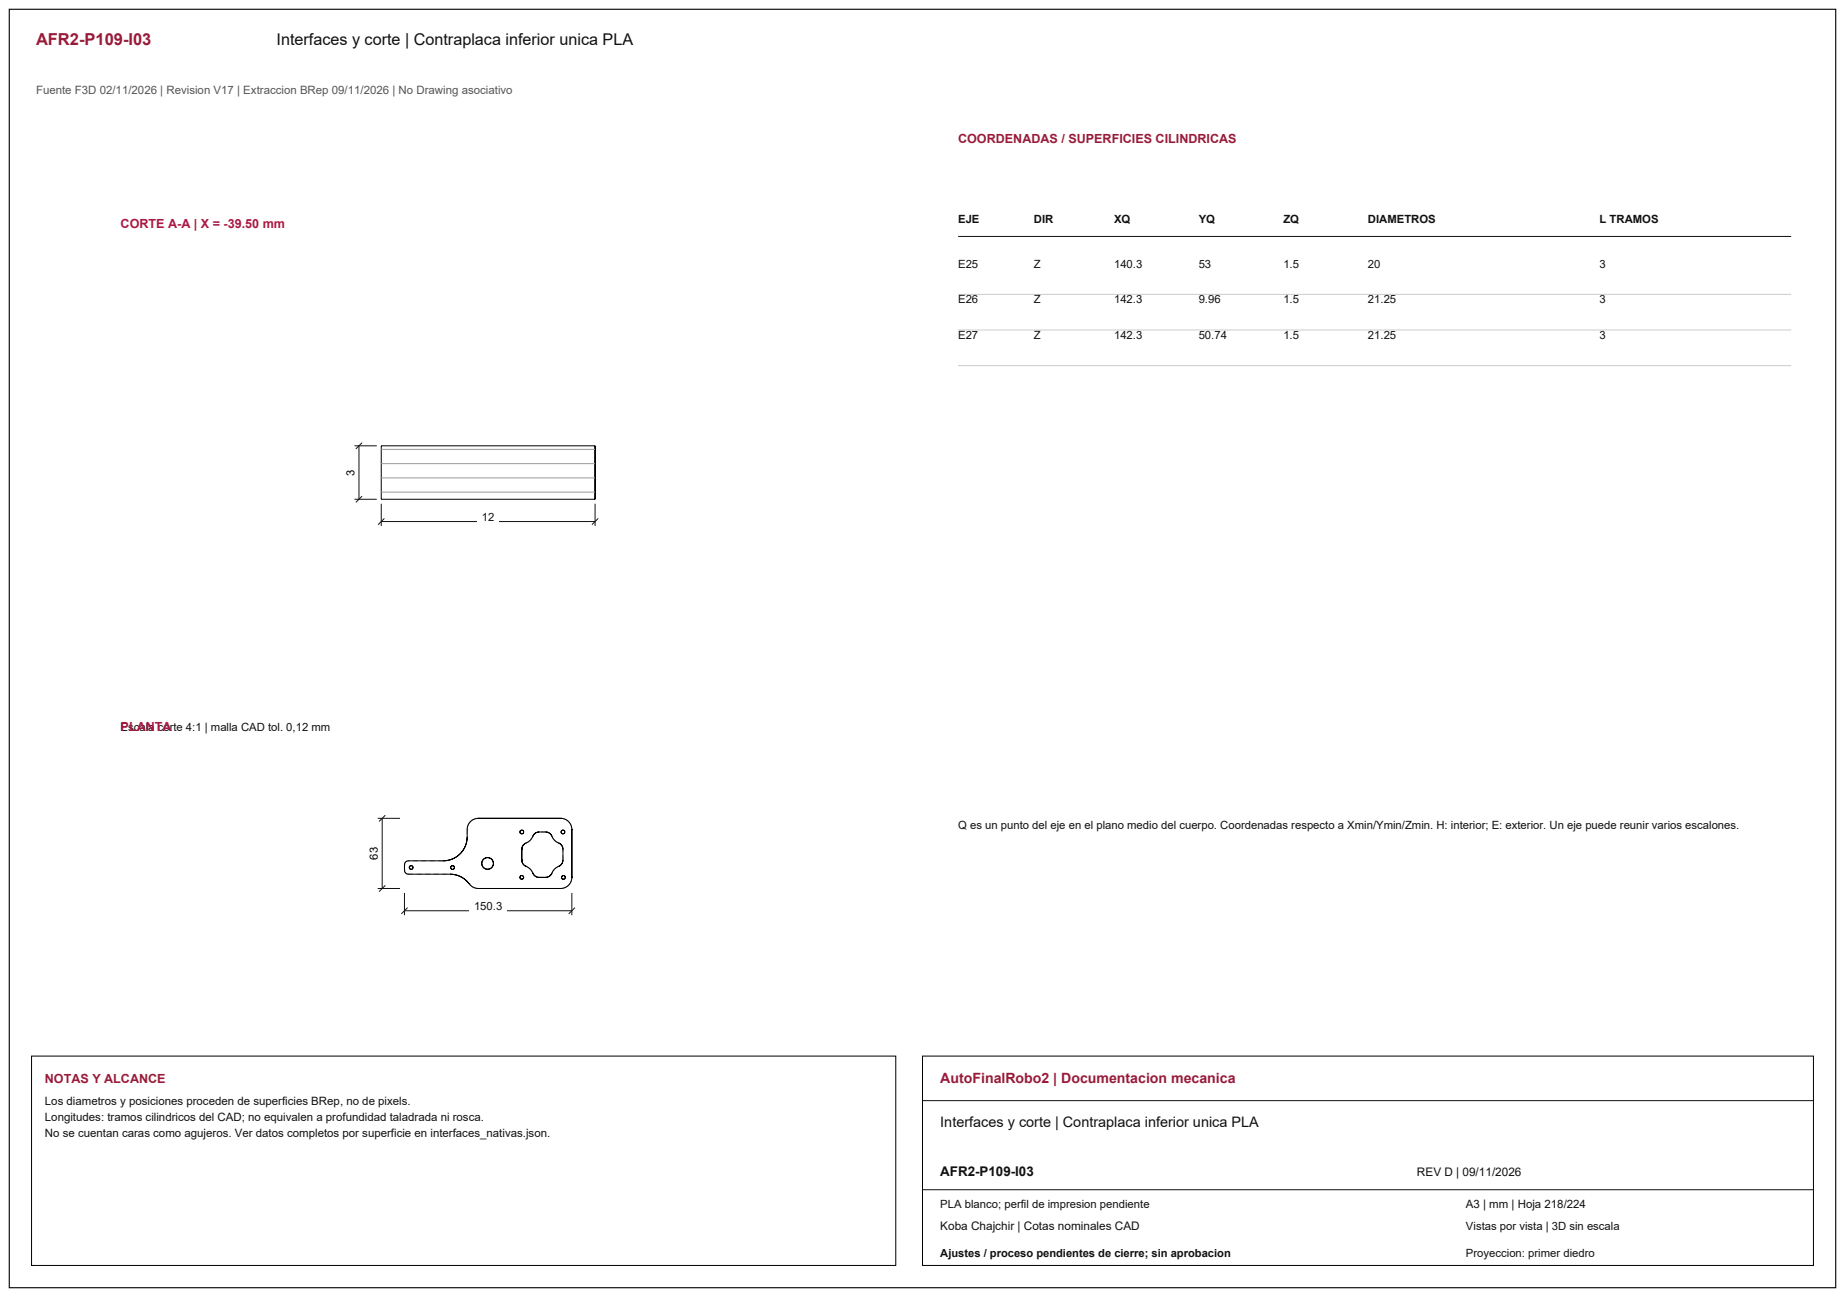
[picture p274: page 35]
CORTE A-A | X = -39.50 mm; EJE; DIR; DIAMETROS; L TRAMOS; NOTAS Y ALCANCE; AutoFinalRobo2 | Documentacion mecanica; AFR2-P109-I03; REV D | 09/11/2026

COORDENADAS / SUPERFICIES CILINDRICAS

Escala corte 4:1 | malla CAD tol. 0,12 mm PLANTA

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

Interfaces y corte | Contraplaca inferior unica PLA

PLA blanco; perfil de impresion pendiente

AFR2-P110 | Cartucho6000 desmontable PLA

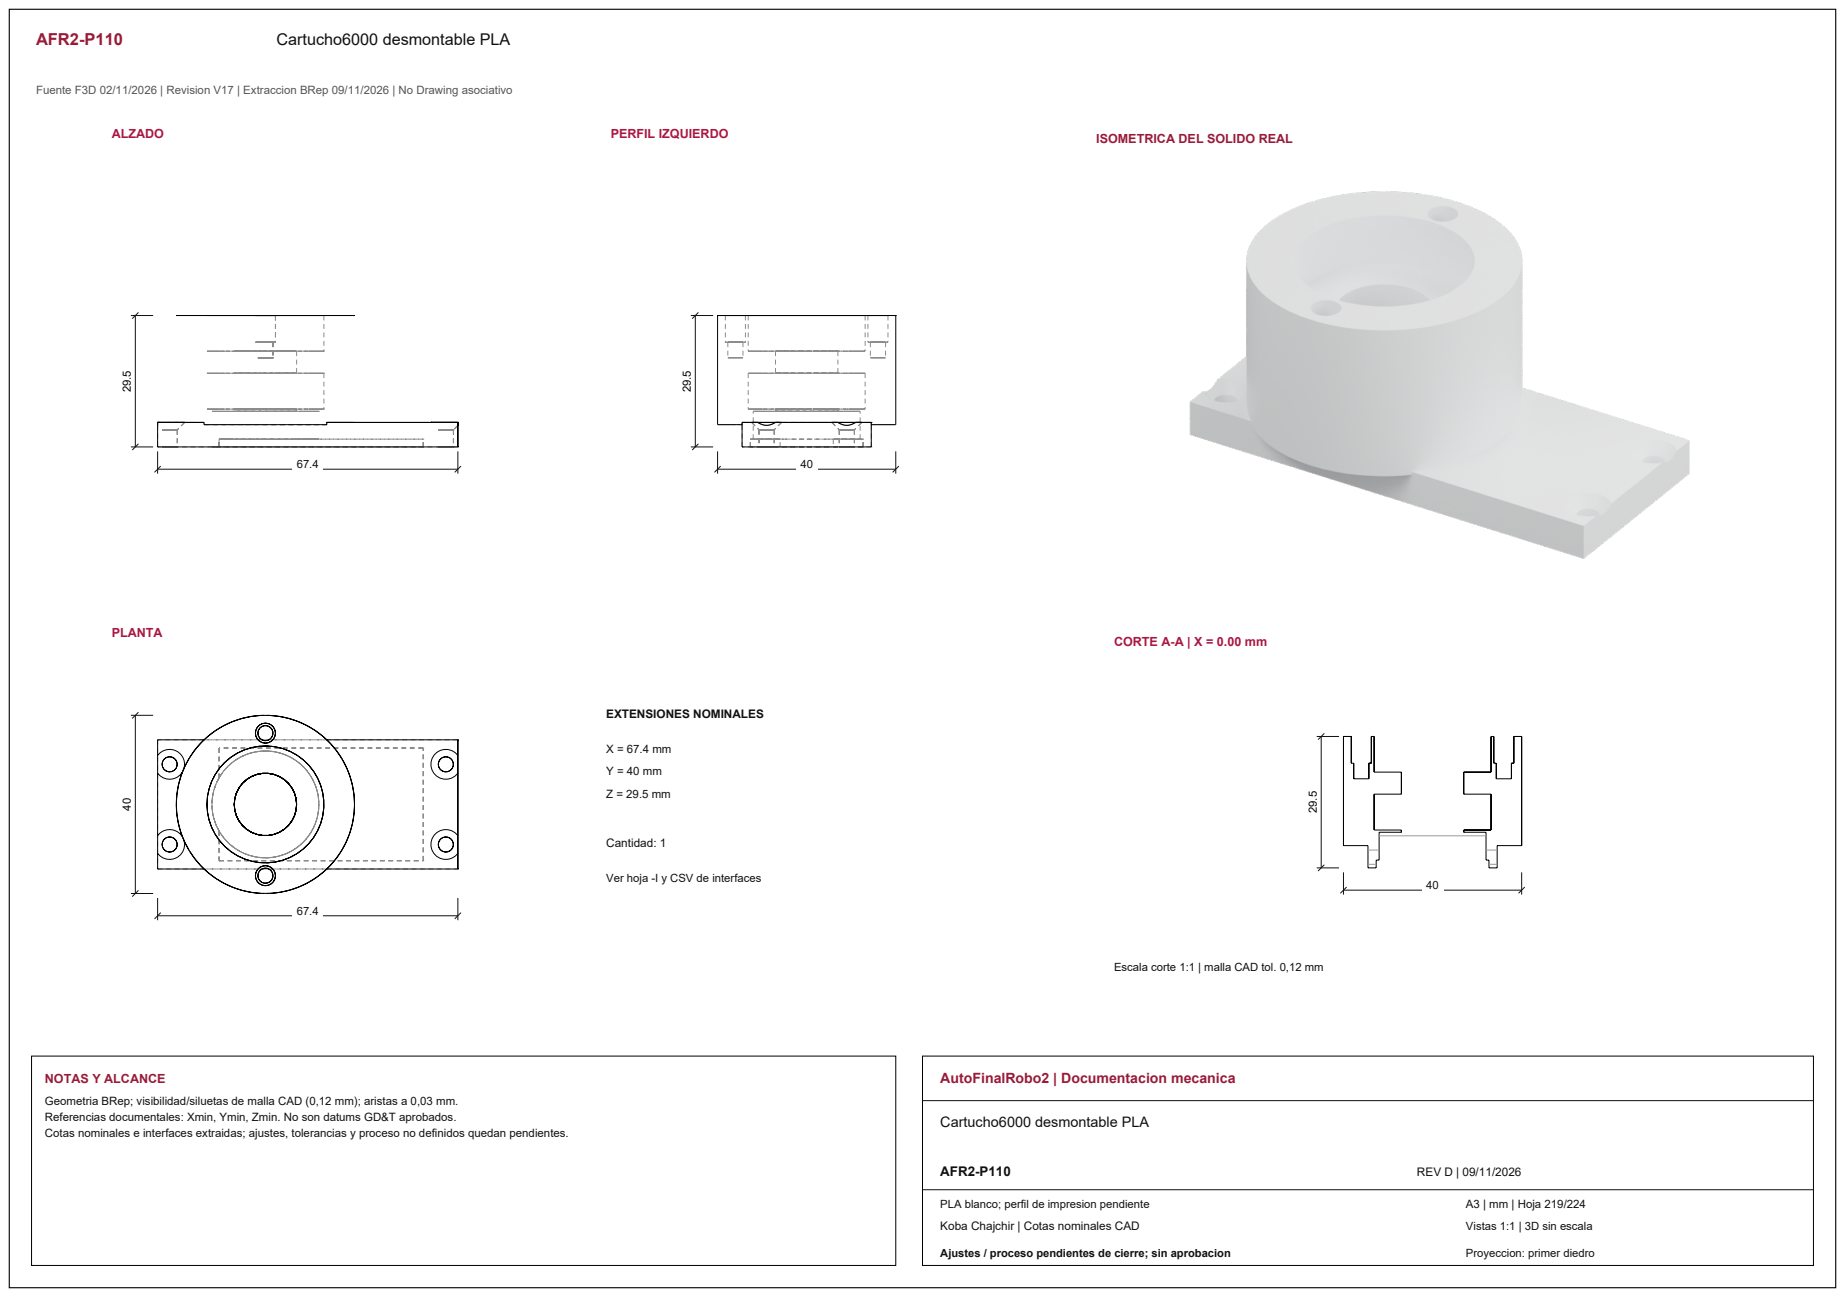
[picture p275: page 36]
ALZADO; PERFIL IZQUIERDO; PLANTA; CORTE A-A | X = 0.00 mm; EXTENSIONES NOMINALES; Cantidad: 1; NOTAS Y ALCANCE; AutoFinalRobo2 | Documentacion mecanica; Cartucho6000 desmontable PLA; AFR2-P110; REV D | 09/11/2026

ISOMETRICA DEL SOLIDO REAL

Ver hoja -I y CSV de interfaces
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
