kobachajchir/ProyectoRobotica2/Revision/R01_20261110/02_Planos/tomos/AFR2_Tomo_3_Brazo_y_correa_A3.pdf

AFR2-A300 | Brazo y accionamiento remoto J3
Fuente F3D 02/11/2026 | Revision V17 | Extraccion BRep 09/11/2026 | No Drawing asociativo

NOTAS Y ALCANCE

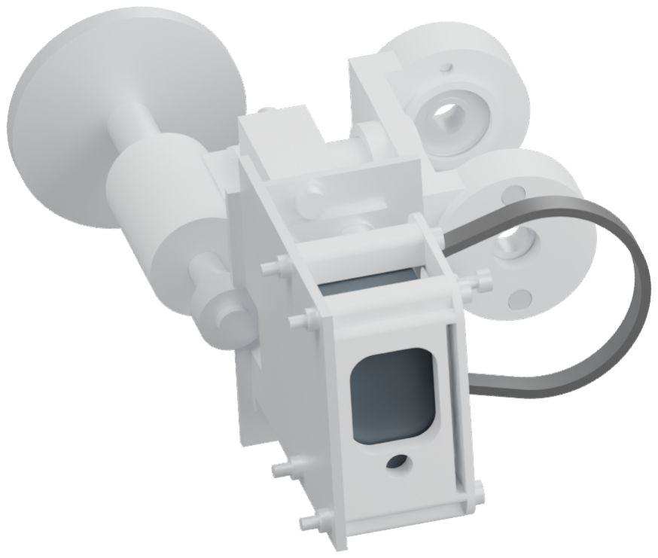
[picture p303: figure]

Conjunto armado desde la captura nativa, con sus orientaciones y ubicaciones guardadas. Lista de ocurrencias en hojas -LP y despieces por tramos -E.
No se modifica la geometria ni se afirma secuencia de montaje/desmontaje comprobada.

### AutoFinalRobo2 | Documentacion mecanica

### Brazo y accionamiento remoto J3

AFR2-A300 | REV D | 09/11/2026
Conjunto mixto Koba Chajchir | Cotas nominales CAD Ajustes / proceso pendientes de cierre; sin aprobacion | A3 | mm | Hoja 31/224
| Vistas -- | 3D sin escala
| Proyeccion: primer diedro

AFR2-A300-LP01 | Lista de ocurrencias | Brazo y accionamiento remoto J3
001 AFR2-P333 | A05 Encastre proximal brazo PETG
002 COMERCIAL/REFERENCIA | A05 Encastre proximal brazo PETG Perno M3 REF
003 AFR2-P334 | A06 Encastre distal brazo PETG
004 COMERCIAL/REFERENCIA | A06 Encastre distal brazo PETG Perno M3 REF
005 AFR2-P301 | E01 Eje hombro 8mm
006 AFR2-P302 | L01 PVC32 Corte 1
007 COMERCIAL/REFERENCIA | R03 608ZZ Codo -1
008 COMERCIAL/REFERENCIA | R03 608ZZ Codo 1
009 COMERCIAL/REFERENCIA | V03 Arandelas y tuerca A05 Encastre proximal brazo PETG
010 COMERCIAL/REFERENCIA | V03 Arandelas y tuerca A06 Encastre distal brazo PETG
011 COMERCIAL/REFERENCIA | V03 Collar 8mm retencion
012 COMERCIAL/REFERENCIA | V03 Inserto M3 A06 Encastre distal brazo PETG-1-1
013 COMERCIAL/REFERENCIA | V03 Inserto M3 A06 Encastre distal brazo PETG-11
014 COMERCIAL/REFERENCIA | V03 Inserto M3 A06 Encastre distal brazo PETG1-1
015 COMERCIAL/REFERENCIA | V03 Inserto M3 A06 Encastre distal brazo PETG11
016 COMERCIAL/REFERENCIA | V03 Prisionero M3x5 collar
017 AFR2-P305 | V03 Separador 8mm trasero
018 AFR2-P303 | V03 Tapa 608 A06 Encastre distal brazo PETG -1

NOTAS Y ALCANCE

Cada posicion identifica una ocurrencia; los solidos de un mismo comercial se mantienen agrupados. Las placas con hijos Nano/PCA9685/XL4016 se agrupan como unidades comerciales.
Codigo COMERCIAL/REFERENCIA no implica plano de fabricacion propio. Rutas completas en CSV.

### AutoFinalRobo2 | Documentacion mecanica

### Lista de ocurrencias | Brazo y accionamiento remoto J3

AFR2-A300-LP01 | REV D | 09/11/2026

Conjunto mixto

| Vistas -- | 3D sin escala

AFR2-A300-LP02 | Lista de ocurrencias | Brazo y accionamiento remoto J3
019 AFR2-P304 | V03 Tapa 608 A06 Encastre distal brazo PETG 1
020 COMERCIAL/REFERENCIA | V03 Tornillo tapa A06 Encastre distal brazo PETG-1-1
021 COMERCIAL/REFERENCIA | V03 Tornillo tapa A06 Encastre distal brazo PETG-11
022 COMERCIAL/REFERENCIA | V03 Tornillo tapa A06 Encastre distal brazo PETG1-1
023 COMERCIAL/REFERENCIA | V03 Tornillo tapa A06 Encastre distal brazo PETG11
024 COMERCIAL/REFERENCIA | V17 625 entrada J3 delantero
025 COMERCIAL/REFERENCIA | V17 625 entrada J3 trasero
026 COMERCIAL/REFERENCIA | V17 Arandela M3 J2 salida
027 COMERCIAL/REFERENCIA | V17 Arandela anclaje fijo -29 externa
028 COMERCIAL/REFERENCIA | V17 Arandela anclaje fijo -29 interna
029 COMERCIAL/REFERENCIA | V17 Arandela anclaje fijo 29 externa
030 COMERCIAL/REFERENCIA | V17 Arandela anclaje fijo 29 interna
031 COMERCIAL/REFERENCIA | V17 Arandela carro -17 -10 Exterior
032 COMERCIAL/REFERENCIA | V17 Arandela carro -17 -10 Interior
033 COMERCIAL/REFERENCIA | V17 Arandela carro -17 10 Exterior
034 COMERCIAL/REFERENCIA | V17 Arandela carro -17 10 Interior
035 COMERCIAL/REFERENCIA | V17 Arandela carro 17 -10 Exterior
036 COMERCIAL/REFERENCIA | V17 Arandela carro 17 -10 Interior

NOTAS Y ALCANCE

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

### AutoFinalRobo2 | Documentacion mecanica

### Lista de ocurrencias | Brazo y accionamiento remoto J3

AFR2-A300-LP02 | REV D | 09/11/2026

Conjunto mixto

| Vistas -- | 3D sin escala

AFR2-A300-LP03 | Lista de ocurrencias | Brazo y accionamiento remoto J3
037 COMERCIAL/REFERENCIA | V17 Arandela carro 17 10 Exterior
038 COMERCIAL/REFERENCIA | V17 Arandela carro 17 10 Interior
039 AFR2-P205 | V17 Carro motor apoyo Al
040 COMERCIAL/REFERENCIA | V17 Chaveta hombro 2x2x12
041 COMERCIAL/REFERENCIA | V17 Correa OMEGA HP 3M 6
042 AFR2-P204 | V17 Housing STS3250 y apoyo625
043 COMERCIAL/REFERENCIA | V17 M03 STS3250 remoto
044 COMERCIAL/REFERENCIA | V17 M2 tapa625 -14
045 COMERCIAL/REFERENCIA | V17 M2 tapa625 14
046 COMERCIAL/REFERENCIA | V17 M3 tapa -37 mm -105 mm
047 COMERCIAL/REFERENCIA | V17 M3 tapa -37 mm -80 mm
048 COMERCIAL/REFERENCIA | V17 M3 tapa 17 mm -105 mm
049 COMERCIAL/REFERENCIA | V17 M3 tapa 17 mm -80 mm
050 COMERCIAL/REFERENCIA | V17 M3x6 J2 salida
051 COMERCIAL/REFERENCIA | V17 M4 anclaje fijo -29
052 COMERCIAL/REFERENCIA | V17 M4 anclaje fijo 29
053 COMERCIAL/REFERENCIA | V17 M4 carro -17 -10
054 COMERCIAL/REFERENCIA | V17 M4 carro -17 10

NOTAS Y ALCANCE

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

### AutoFinalRobo2 | Documentacion mecanica

### Lista de ocurrencias | Brazo y accionamiento remoto J3

AFR2-A300-LP03 | REV D | 09/11/2026

Conjunto mixto

| Vistas -- | 3D sin escala

AFR2-A300-LP04 | Lista de ocurrencias | Brazo y accionamiento remoto J3
055 COMERCIAL/REFERENCIA | V17 M4 carro 17 -10
056 COMERCIAL/REFERENCIA | V17 M4 carro 17 10
057 AFR2-P306 | V17 Placa fija tensor Al
058 COMERCIAL/REFERENCIA | V17 Rueda72 J2 Al2024
059 AFR2-P336 | V17 Separador8 J2 salida
060 AFR2-P207 | V17 Tapa625 entrada trasera
061 AFR2-P206 | V17 Tapa housing STS3250
062 COMERCIAL/REFERENCIA | V17 Tornillo ajuste M3x20
063 COMERCIAL/REFERENCIA | V17 Tuerca anclaje fijo -29
064 COMERCIAL/REFERENCIA | V17 Tuerca anclaje fijo 29
065 COMERCIAL/REFERENCIA | V17 Tuerca carro -17 -10
066 COMERCIAL/REFERENCIA | V17 Tuerca carro -17 10
067 COMERCIAL/REFERENCIA | V17 Tuerca carro 17 -10
068 COMERCIAL/REFERENCIA | V17 Tuerca carro 17 10
069 COMERCIAL/REFERENCIA | V17 Tuerca tapa -37 mm -105 mm
070 COMERCIAL/REFERENCIA | V17 Tuerca tapa -37 mm -80 mm
071 COMERCIAL/REFERENCIA | V17 Tuerca tapa 17 mm -105 mm
072 COMERCIAL/REFERENCIA | V17 Tuerca tapa 17 mm -80 mm

NOTAS Y ALCANCE

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

### AutoFinalRobo2 | Documentacion mecanica

### Lista de ocurrencias | Brazo y accionamiento remoto J3

AFR2-A300-LP04 | REV D | 09/11/2026

Conjunto mixto

| Vistas -- | 3D sin escala

AFR2-A300-LP05 | Lista de ocurrencias | Brazo y accionamiento remoto J3
073 COMERCIAL/REFERENCIA | V17 Tuerca tensor M3
074 COMERCIAL/REFERENCIA | V17 Chaveta entrada 2x2x9
075 COMERCIAL/REFERENCIA | V17 Collar entrada5
076 AFR2-P339 | V17 Eje entrada 5mm
077 AFR2-P340 | V17 Horn STS3250 J3
078 COMERCIAL/REFERENCIA | V17 M3x6 horn J3 0
079 COMERCIAL/REFERENCIA | V17 M3x6 horn J3 1
080 COMERCIAL/REFERENCIA | V17 M3x6 horn J3 2
081 COMERCIAL/REFERENCIA | V17 M3x6 horn J3 3
082 COMERCIAL/REFERENCIA | V17 Polea 20T J3
083 COMERCIAL/REFERENCIA | V17 Prisionero collar entrada5
084 AFR2-P353 | V17 Separador entrada delantero
085 AFR2-P352 | V17 Separador entrada trasero
086 COMERCIAL/REFERENCIA | V17 Tornillo central servo J3

NOTAS Y ALCANCE

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

### AutoFinalRobo2 | Documentacion mecanica

### Lista de ocurrencias | Brazo y accionamiento remoto J3

AFR2-A300-LP05 | REV D | 09/11/2026

Conjunto mixto

| Vistas -- | 3D sin escala

AFR2-A300-E1 | Despiece isometrico | Brazo y accionamiento remoto J3

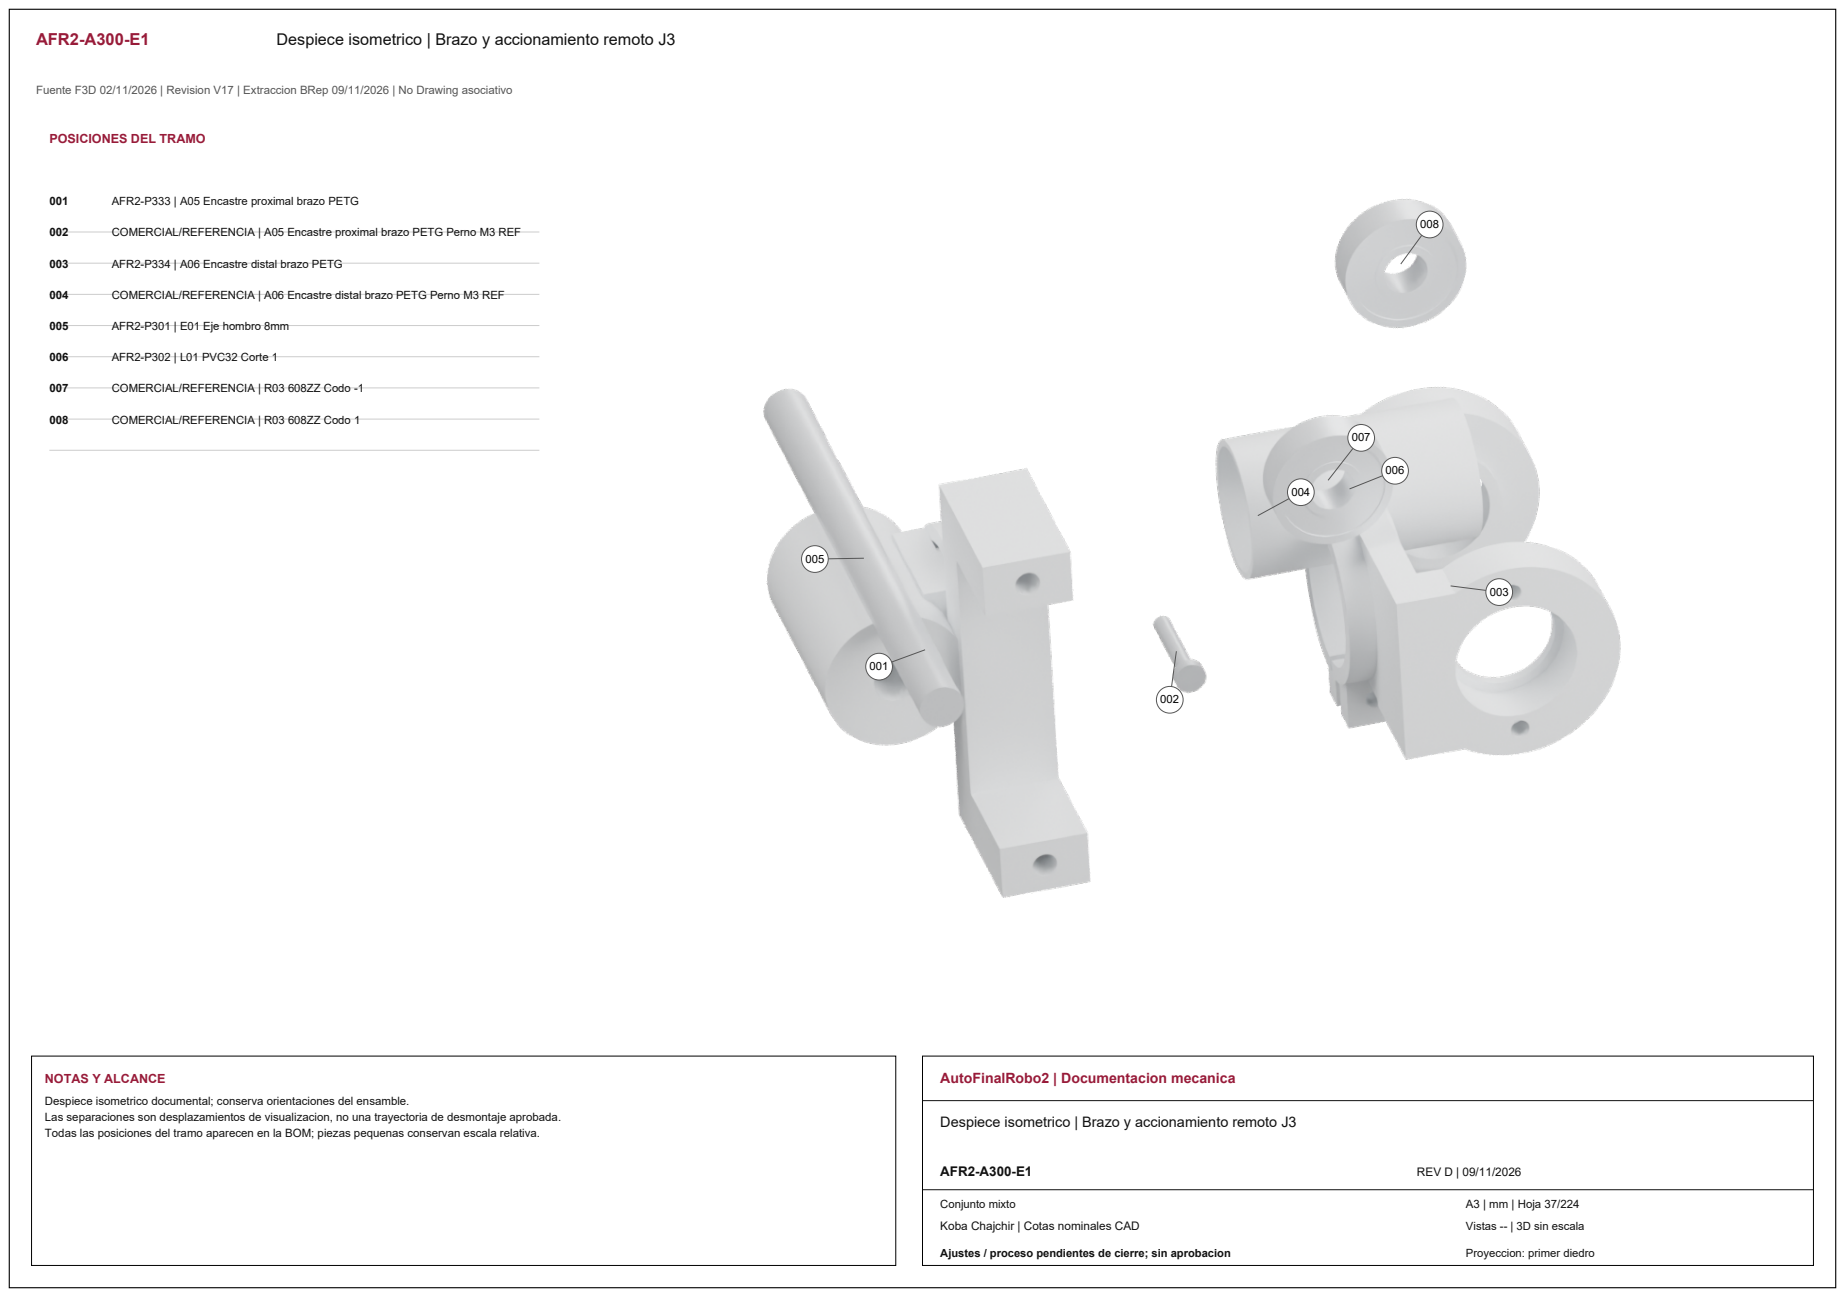
[picture p304: page 7]
005 AFR2-P301 | E01 Eje hombro 8mm; 006 AFR2-P302 | L01 PVC32 Corte 1; NOTAS Y ALCANCE; AutoFinalRobo2 | Documentacion mecanica; AFR2-A300-E1; REV D | 09/11/2026; Conjunto mixto

POSICIONES DEL TRAMO

001 AFR2-P333 | A05 Encastre proximal brazo PETG

002 COMERCIAL/REFERENCIA | A05 Encastre proximal brazo PETG Perno M3 REF

003 AFR2-P334 | A06 Encastre distal brazo PETG

004 COMERCIAL/REFERENCIA | A06 Encastre distal brazo PETG Perno M3 REF

007 COMERCIAL/REFERENCIA | R03 608ZZ Codo -1

008 COMERCIAL/REFERENCIA | R03 608ZZ Codo 1

Despiece isometrico documental; conserva orientaciones del ensamble.
Las separaciones son desplazamientos de visualizacion, no una trayectoria de desmontaje aprobada.
Todas las posiciones del tramo aparecen en la BOM; piezas pequenas conservan escala relativa.

Despiece isometrico | Brazo y accionamiento remoto J3

Vistas -- | 3D sin escala

AFR2-A300-E2 | Despiece isometrico | Brazo y accionamiento remoto J3

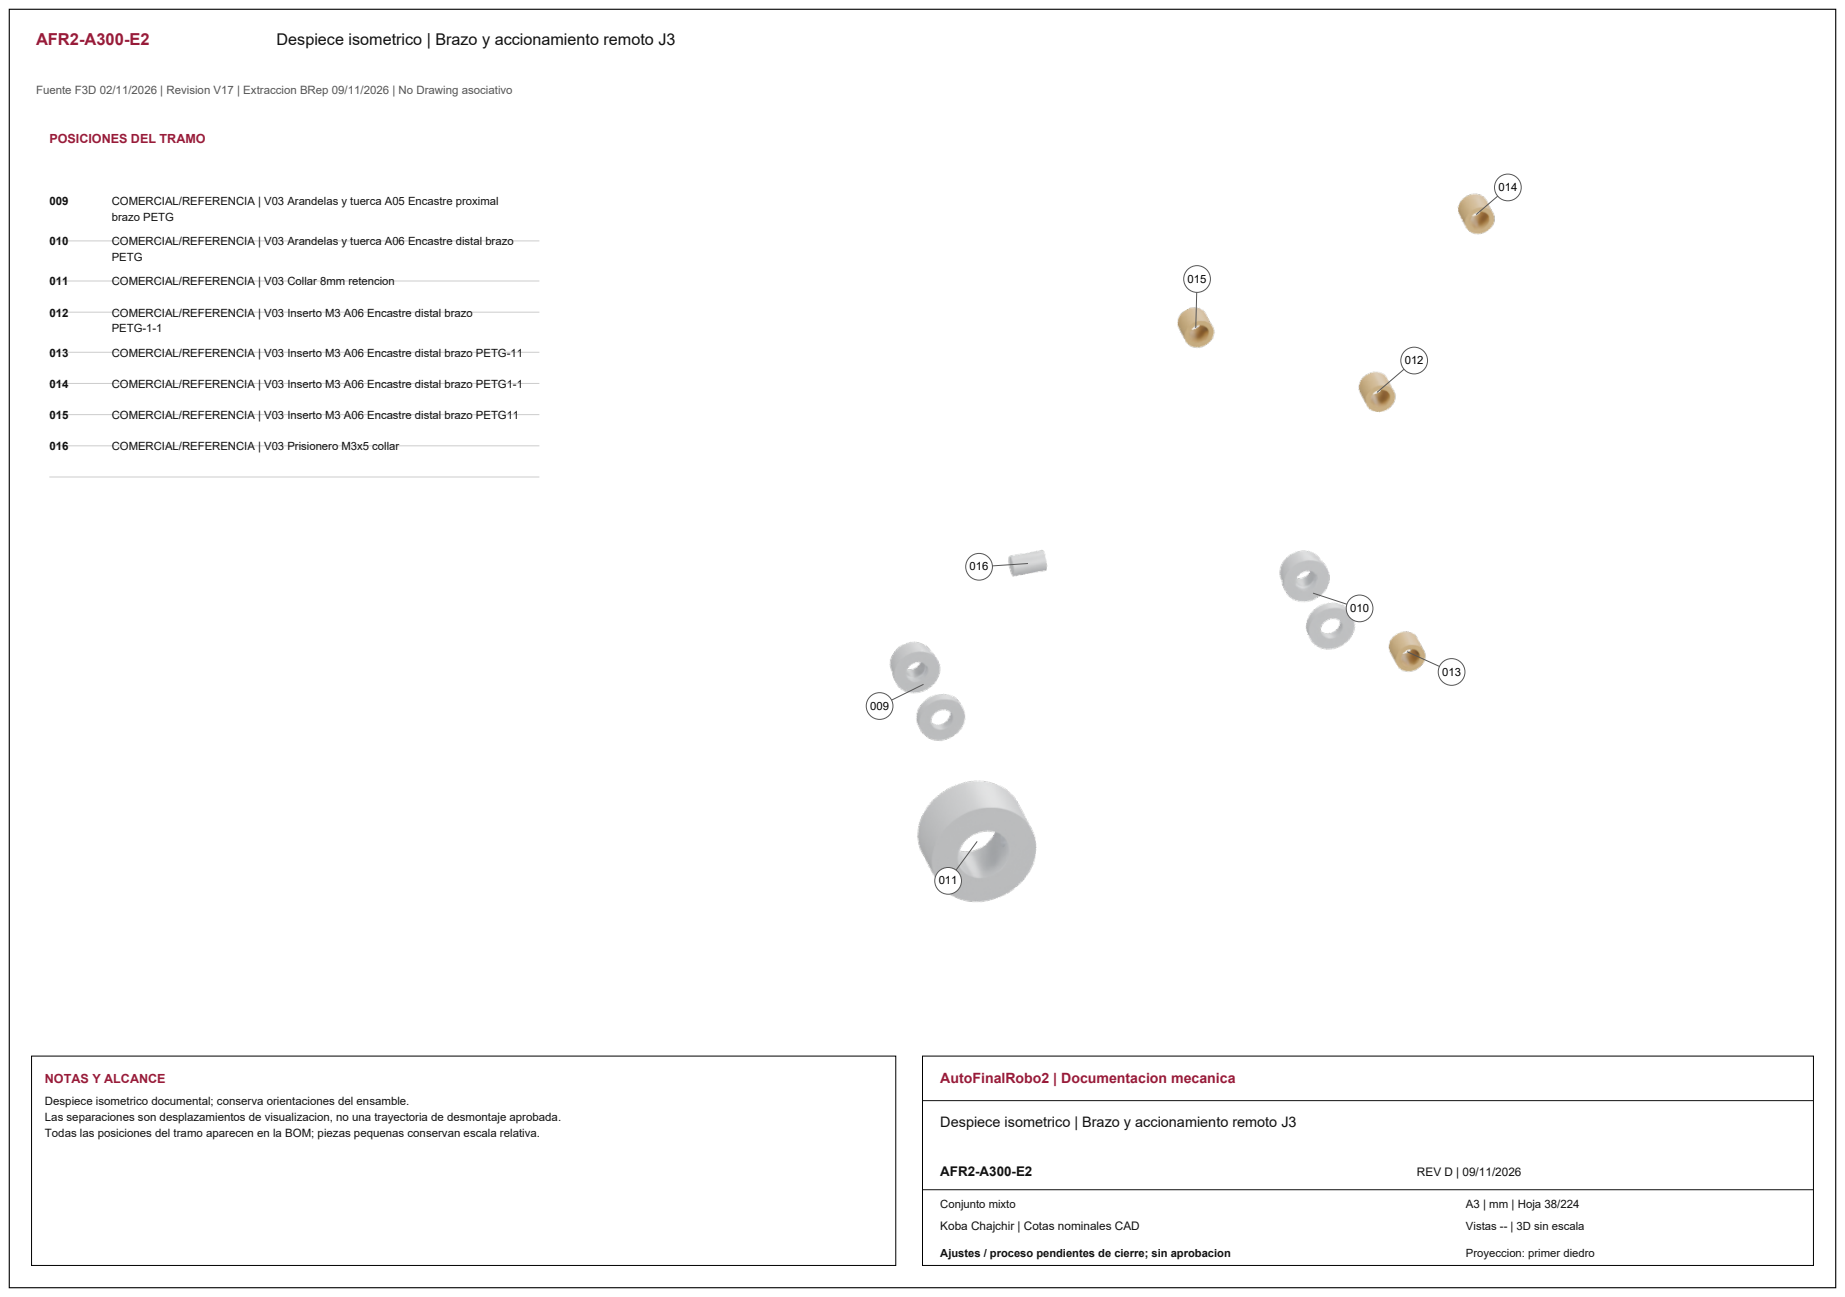
[picture p305: page 8]
brazo PETG; PETG; PETG-1-1; NOTAS Y ALCANCE; AutoFinalRobo2 | Documentacion mecanica; AFR2-A300-E2; REV D | 09/11/2026; Conjunto mixto

POSICIONES DEL TRAMO

009 COMERCIAL/REFERENCIA | V03 Arandelas y tuerca A05 Encastre proximal

010 COMERCIAL/REFERENCIA | V03 Arandelas y tuerca A06 Encastre distal brazo

011 COMERCIAL/REFERENCIA | V03 Collar 8mm retencion

012 COMERCIAL/REFERENCIA | V03 Inserto M3 A06 Encastre distal brazo

013 COMERCIAL/REFERENCIA | V03 Inserto M3 A06 Encastre distal brazo PETG-11

014 COMERCIAL/REFERENCIA | V03 Inserto M3 A06 Encastre distal brazo PETG1-1

015 COMERCIAL/REFERENCIA | V03 Inserto M3 A06 Encastre distal brazo PETG11

016 COMERCIAL/REFERENCIA | V03 Prisionero M3x5 collar

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

Despiece isometrico | Brazo y accionamiento remoto J3

Vistas -- | 3D sin escala

AFR2-A300-E3 | Despiece isometrico | Brazo y accionamiento remoto J3

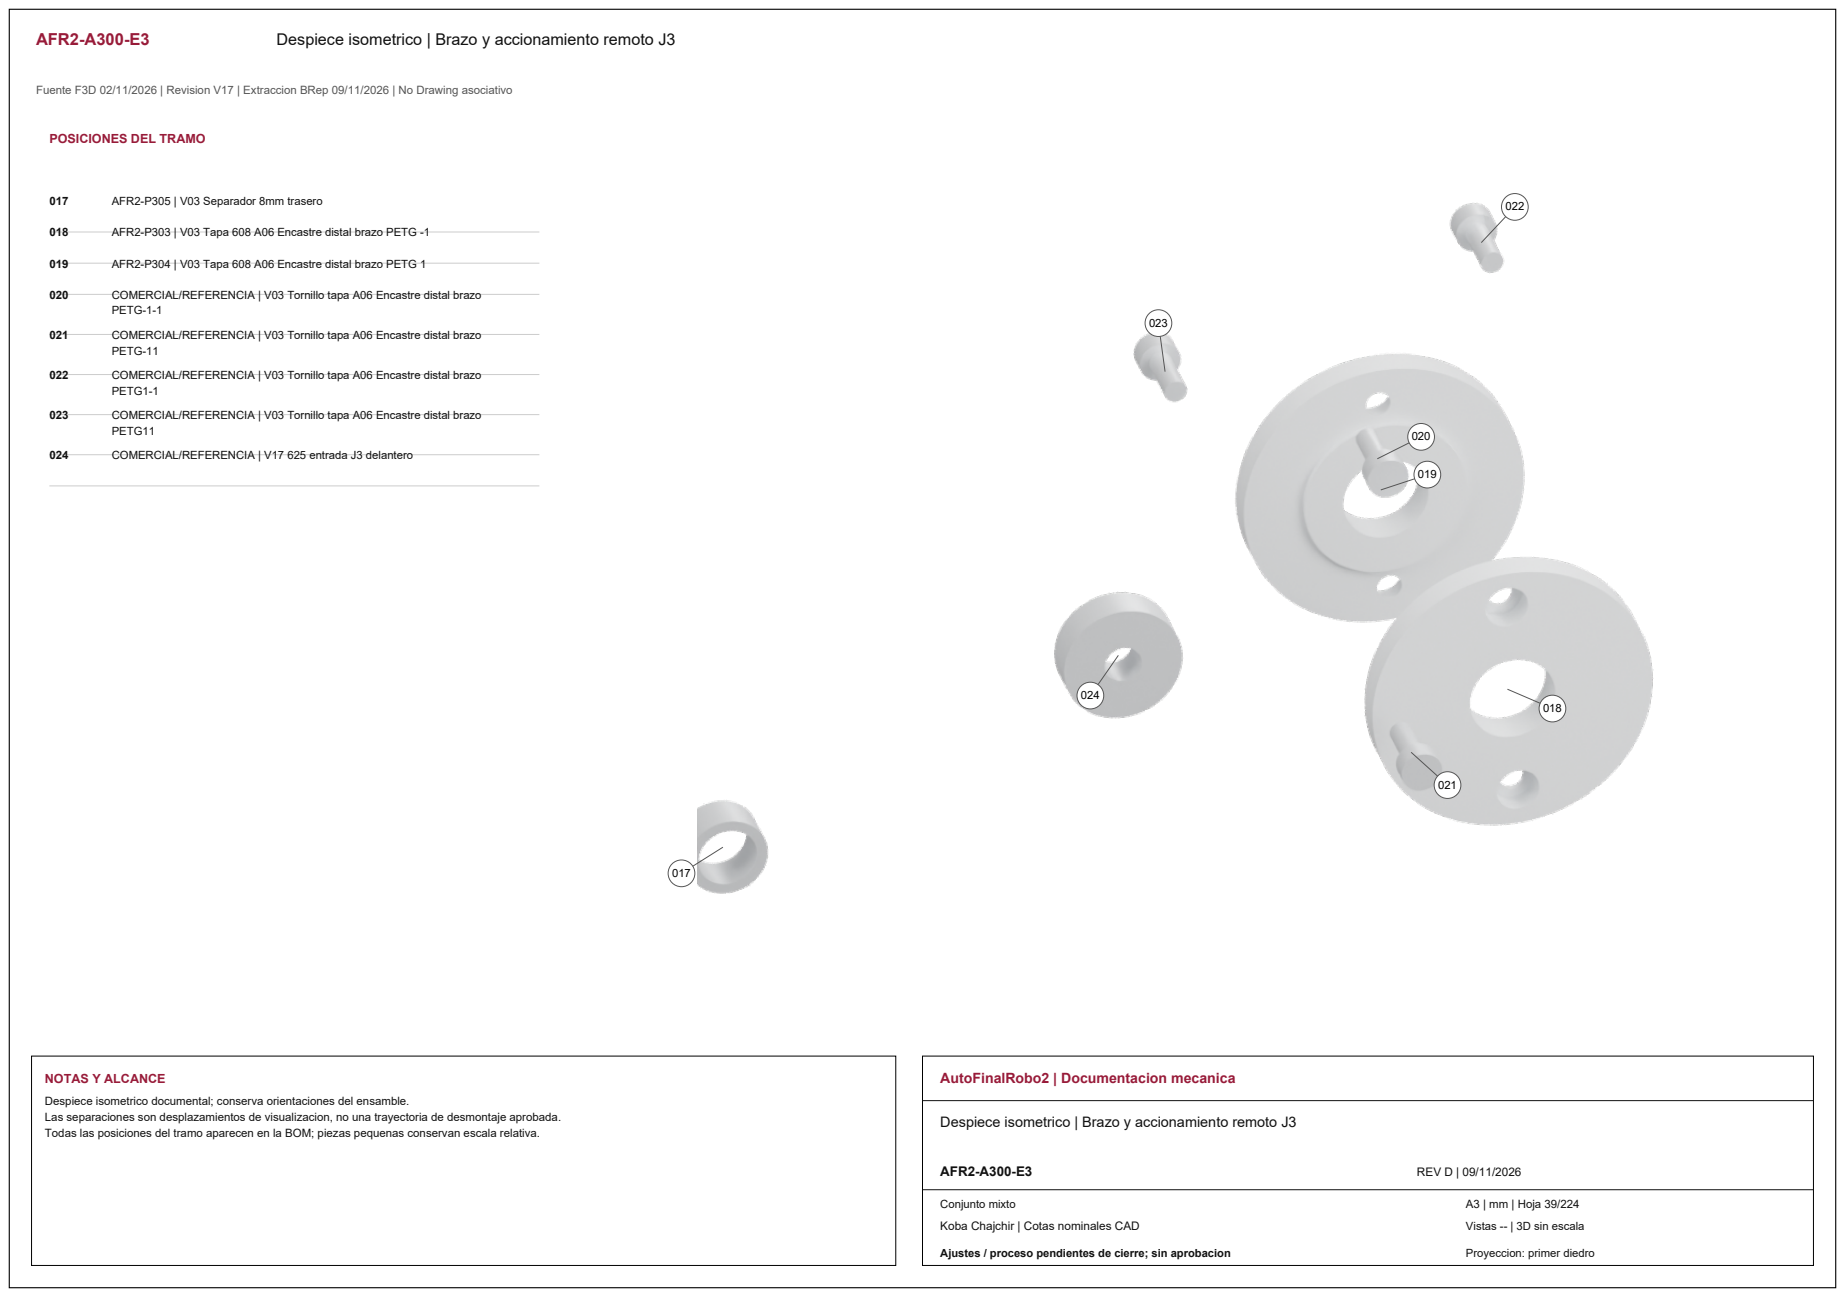
[picture p306: page 9]
017 AFR2-P305 | V03 Separador 8mm trasero; PETG-1-1; PETG-11; PETG1-1; PETG11; NOTAS Y ALCANCE; AutoFinalRobo2 | Documentacion mecanica; AFR2-A300-E3; REV D | 09/11/2026; Conjunto mixto

POSICIONES DEL TRAMO

018 AFR2-P303 | V03 Tapa 608 A06 Encastre distal brazo PETG -1

019 AFR2-P304 | V03 Tapa 608 A06 Encastre distal brazo PETG 1

020 COMERCIAL/REFERENCIA | V03 Tornillo tapa A06 Encastre distal brazo

021 COMERCIAL/REFERENCIA | V03 Tornillo tapa A06 Encastre distal brazo

022 COMERCIAL/REFERENCIA | V03 Tornillo tapa A06 Encastre distal brazo

023 COMERCIAL/REFERENCIA | V03 Tornillo tapa A06 Encastre distal brazo

024 COMERCIAL/REFERENCIA | V17 625 entrada J3 delantero

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

Despiece isometrico | Brazo y accionamiento remoto J3

Vistas -- | 3D sin escala

AFR2-A300-E4 | Despiece isometrico | Brazo y accionamiento remoto J3

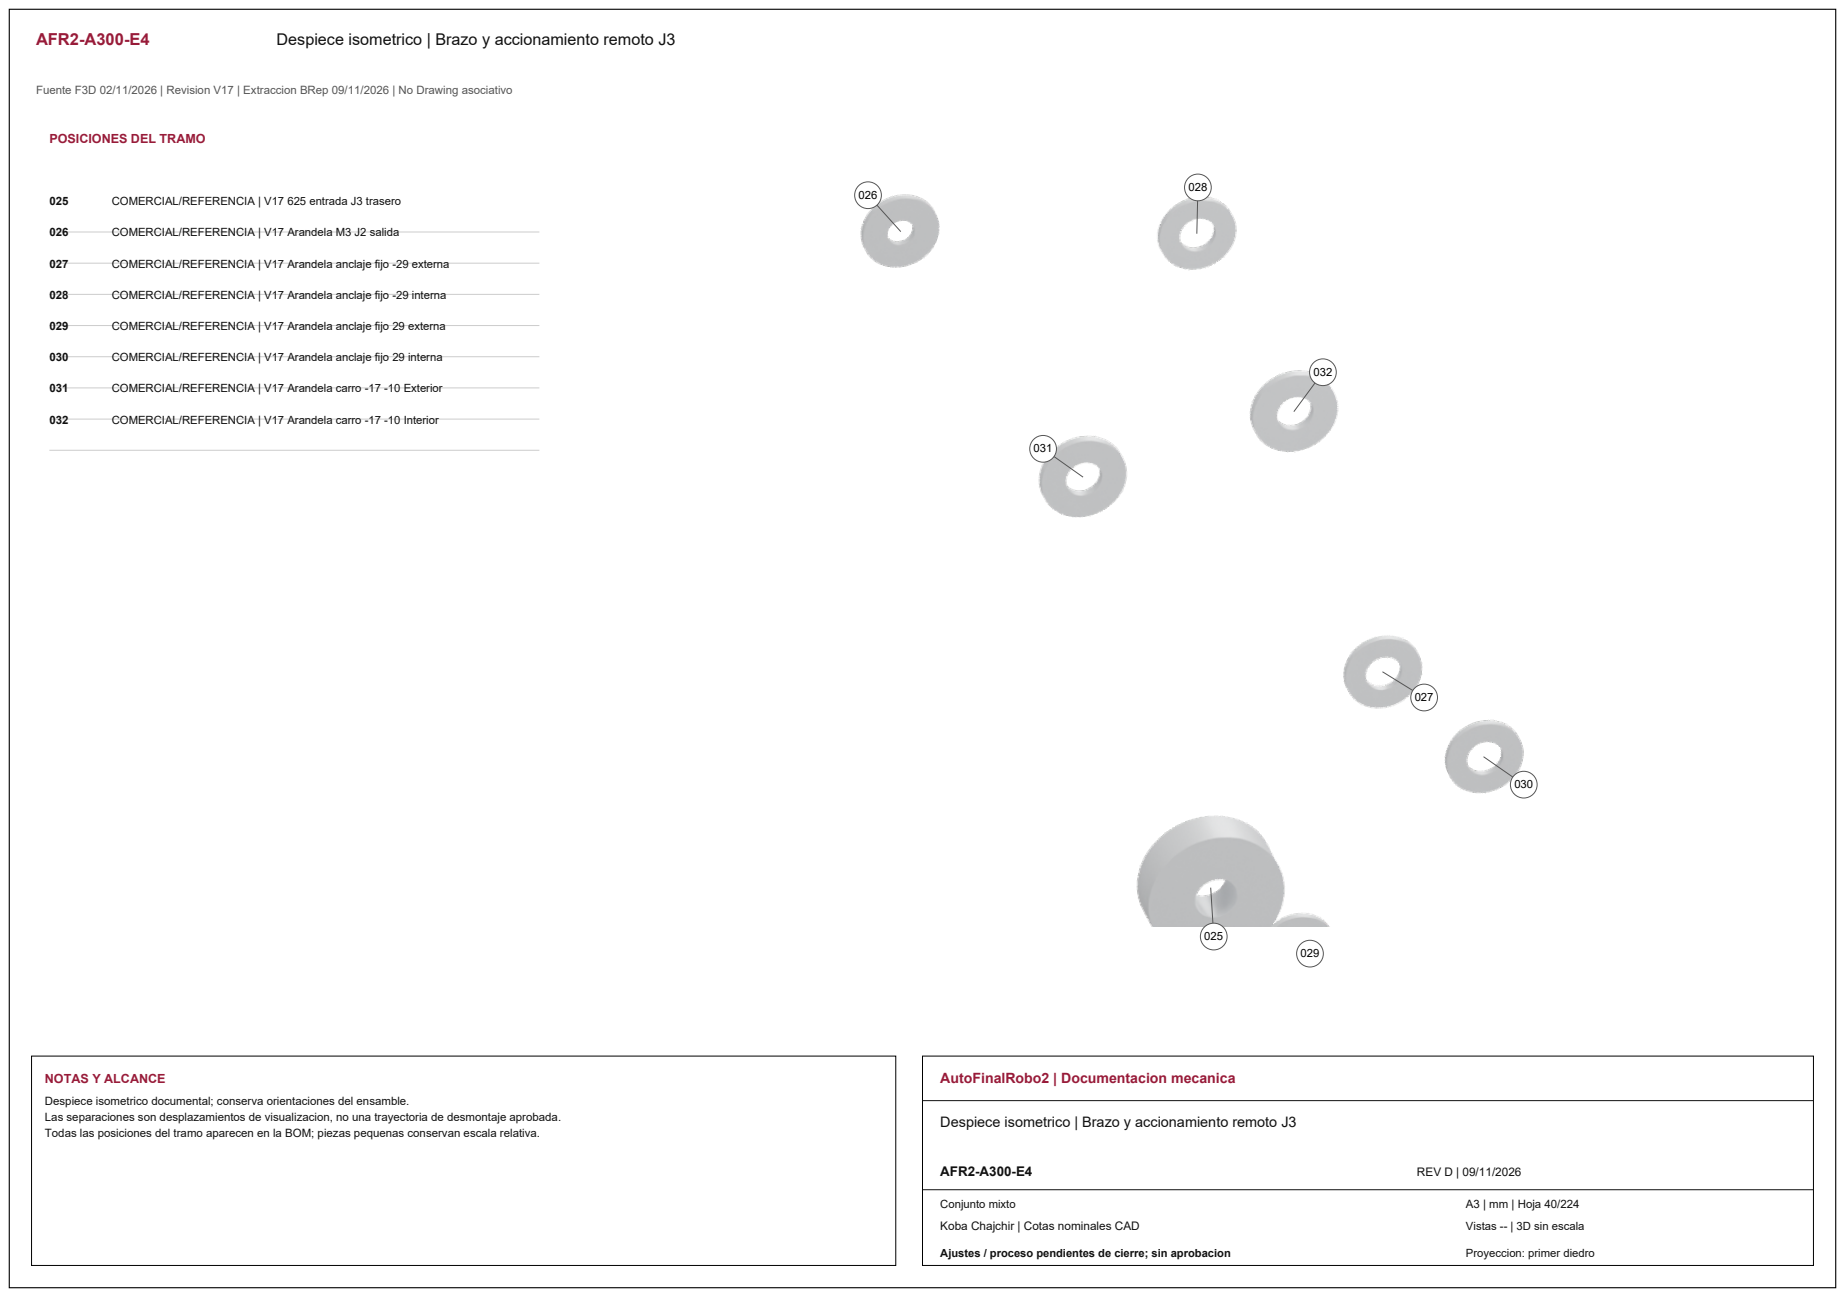
[picture p307: page 10]
NOTAS Y ALCANCE; AutoFinalRobo2 | Documentacion mecanica; AFR2-A300-E4; REV D | 09/11/2026; Conjunto mixto

POSICIONES DEL TRAMO

025 COMERCIAL/REFERENCIA | V17 625 entrada J3 trasero

026 COMERCIAL/REFERENCIA | V17 Arandela M3 J2 salida

027 COMERCIAL/REFERENCIA | V17 Arandela anclaje fijo -29 externa

028 COMERCIAL/REFERENCIA | V17 Arandela anclaje fijo -29 interna

029 COMERCIAL/REFERENCIA | V17 Arandela anclaje fijo 29 externa

030 COMERCIAL/REFERENCIA | V17 Arandela anclaje fijo 29 interna

031 COMERCIAL/REFERENCIA | V17 Arandela carro -17 -10 Exterior

032 COMERCIAL/REFERENCIA | V17 Arandela carro -17 -10 Interior

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

Despiece isometrico | Brazo y accionamiento remoto J3

Vistas -- | 3D sin escala

AFR2-A300-E5 | Despiece isometrico | Brazo y accionamiento remoto J3

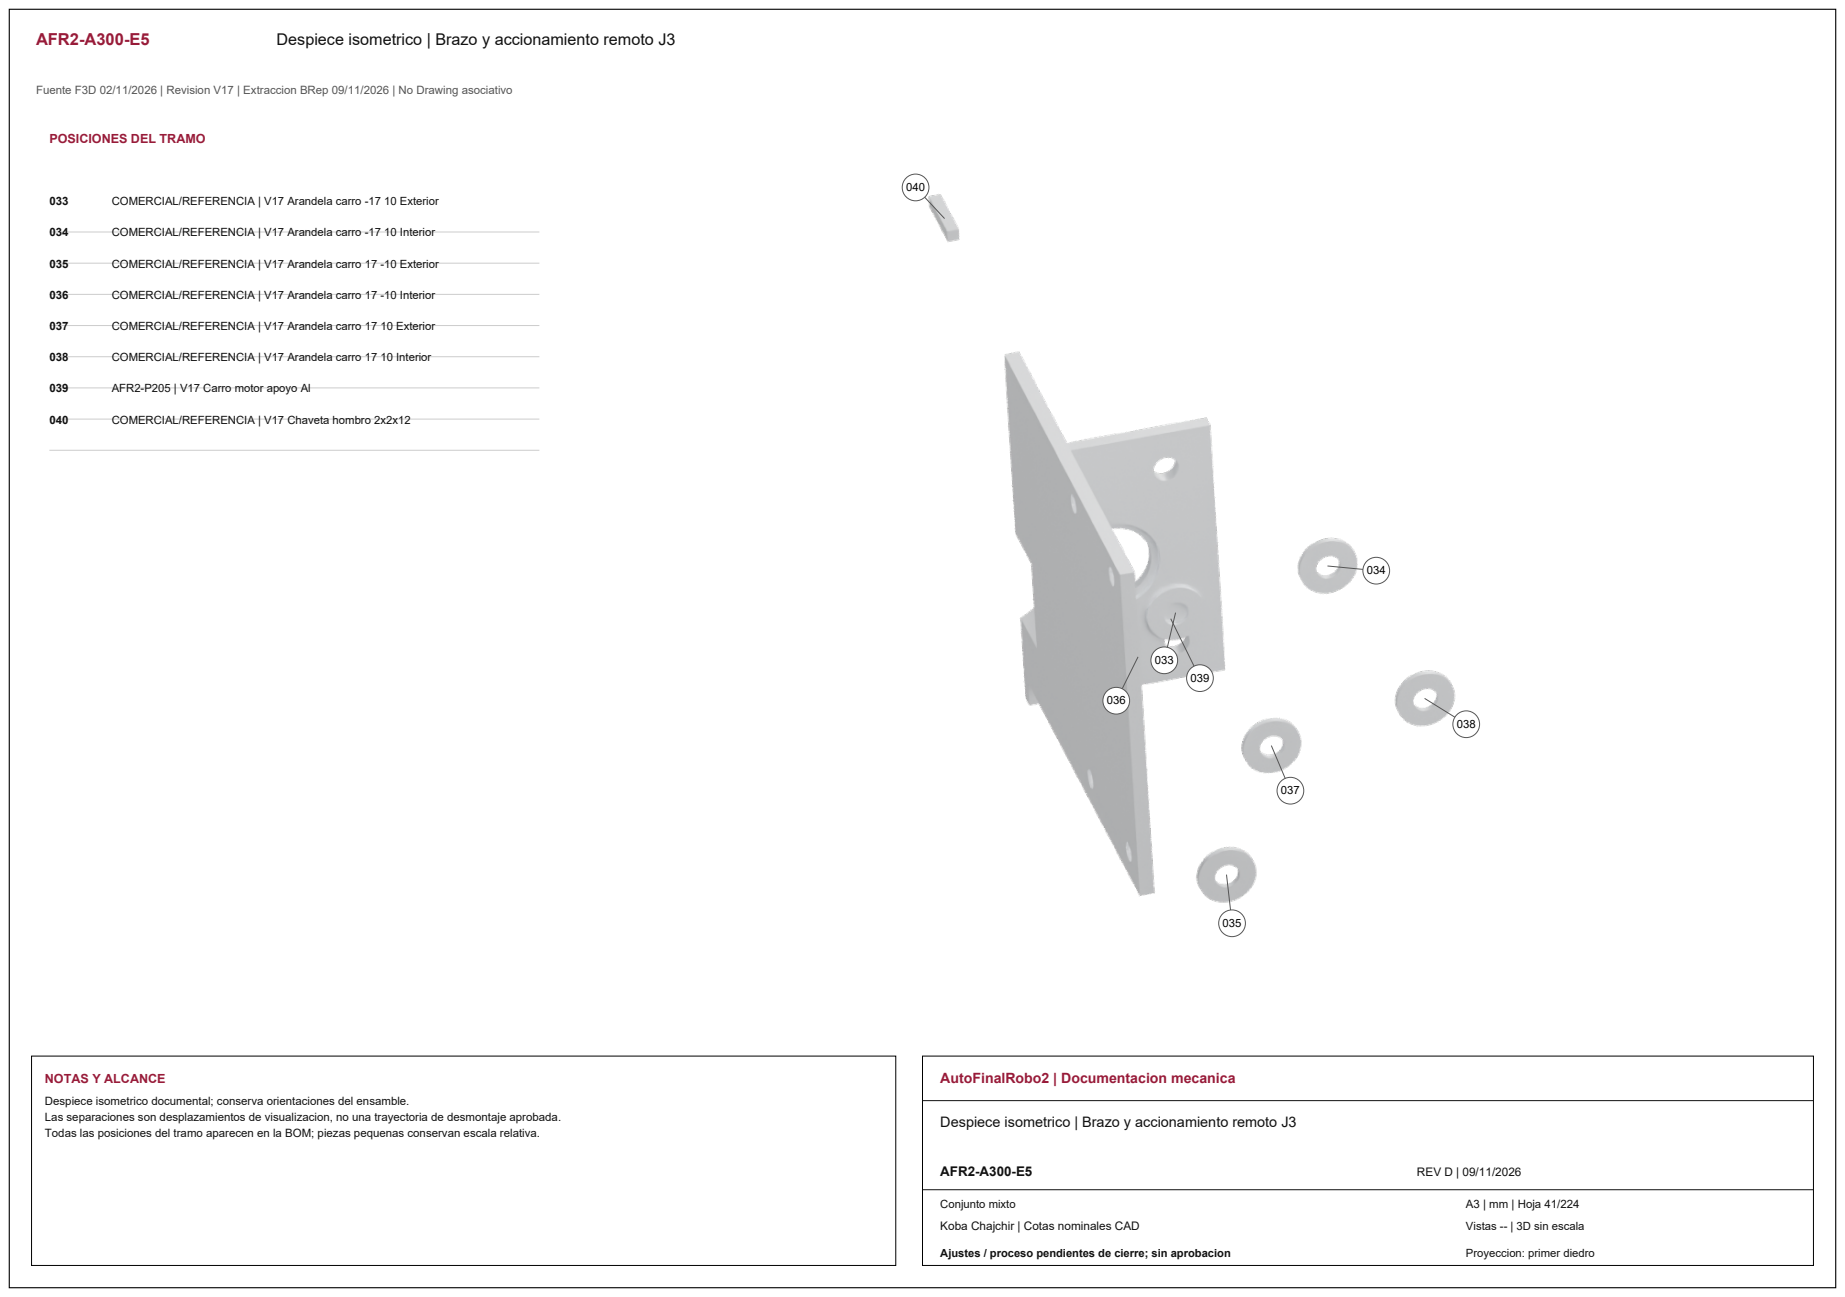
[picture p308: page 11]
NOTAS Y ALCANCE; AutoFinalRobo2 | Documentacion mecanica; AFR2-A300-E5; REV D | 09/11/2026; Conjunto mixto

POSICIONES DEL TRAMO

033 COMERCIAL/REFERENCIA | V17 Arandela carro -17 10 Exterior

034 COMERCIAL/REFERENCIA | V17 Arandela carro -17 10 Interior

035 COMERCIAL/REFERENCIA | V17 Arandela carro 17 -10 Exterior

036 COMERCIAL/REFERENCIA | V17 Arandela carro 17 -10 Interior

037 COMERCIAL/REFERENCIA | V17 Arandela carro 17 10 Exterior

038 COMERCIAL/REFERENCIA | V17 Arandela carro 17 10 Interior

039 AFR2-P205 | V17 Carro motor apoyo Al

040 COMERCIAL/REFERENCIA | V17 Chaveta hombro 2x2x12

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

Despiece isometrico | Brazo y accionamiento remoto J3

Vistas -- | 3D sin escala

AFR2-A300-E6 | Despiece isometrico | Brazo y accionamiento remoto J3

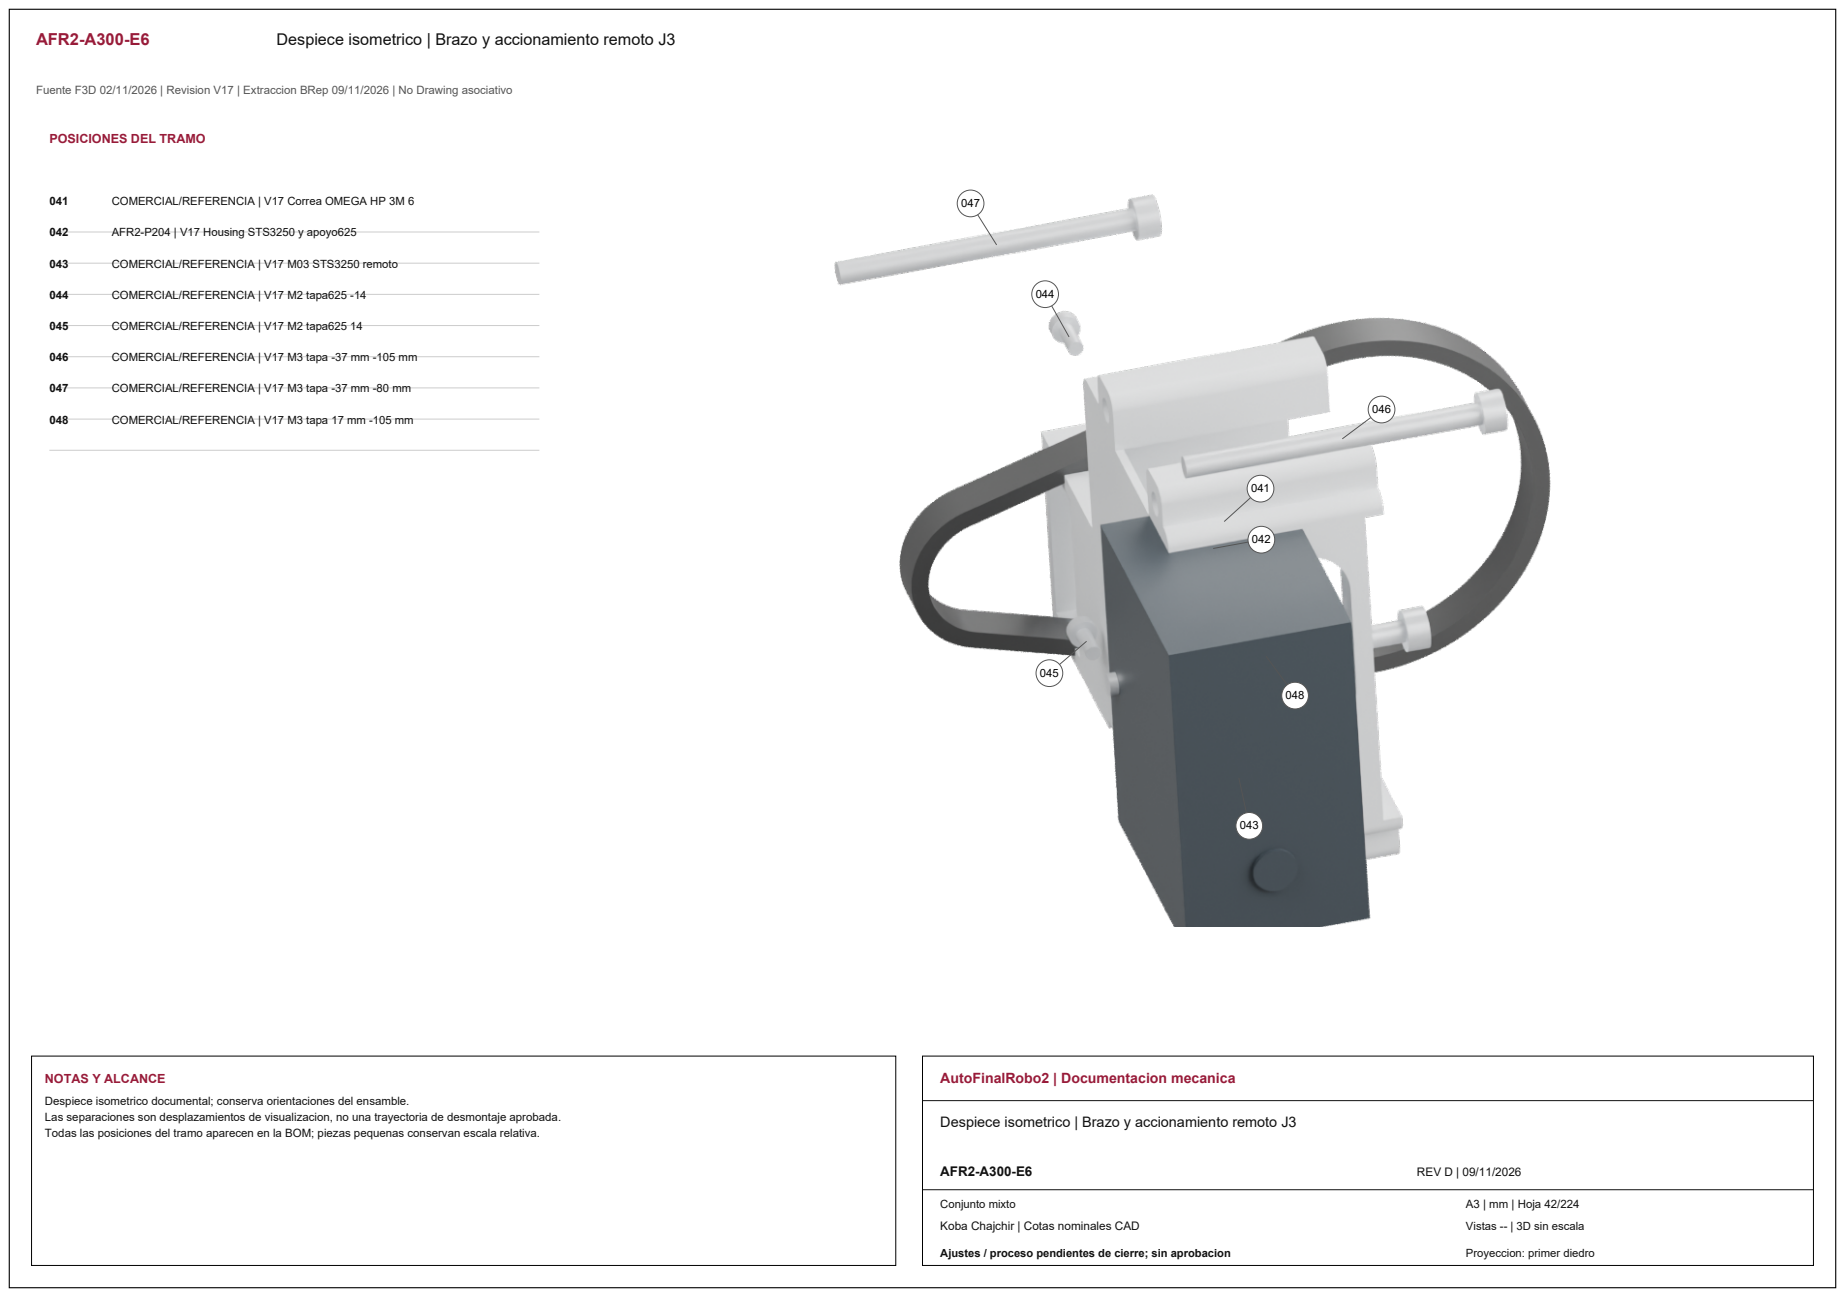
[picture p309: page 12]
042 AFR2-P204 | V17 Housing STS3250 y apoyo625; 044 COMERCIAL/REFERENCIA | V17 M2 tapa625 -14; 045 COMERCIAL/REFERENCIA | V17 M2 tapa625 14; NOTAS Y ALCANCE; AutoFinalRobo2 | Documentacion mecanica; AFR2-A300-E6; REV D | 09/11/2026; Conjunto mixto

POSICIONES DEL TRAMO

041 COMERCIAL/REFERENCIA | V17 Correa OMEGA HP 3M 6

043 COMERCIAL/REFERENCIA | V17 M03 STS3250 remoto

046 COMERCIAL/REFERENCIA | V17 M3 tapa -37 mm -105 mm

047 COMERCIAL/REFERENCIA | V17 M3 tapa -37 mm -80 mm

048 COMERCIAL/REFERENCIA | V17 M3 tapa 17 mm -105 mm

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

Despiece isometrico | Brazo y accionamiento remoto J3

Vistas -- | 3D sin escala

AFR2-A300-E7 | Despiece isometrico | Brazo y accionamiento remoto J3

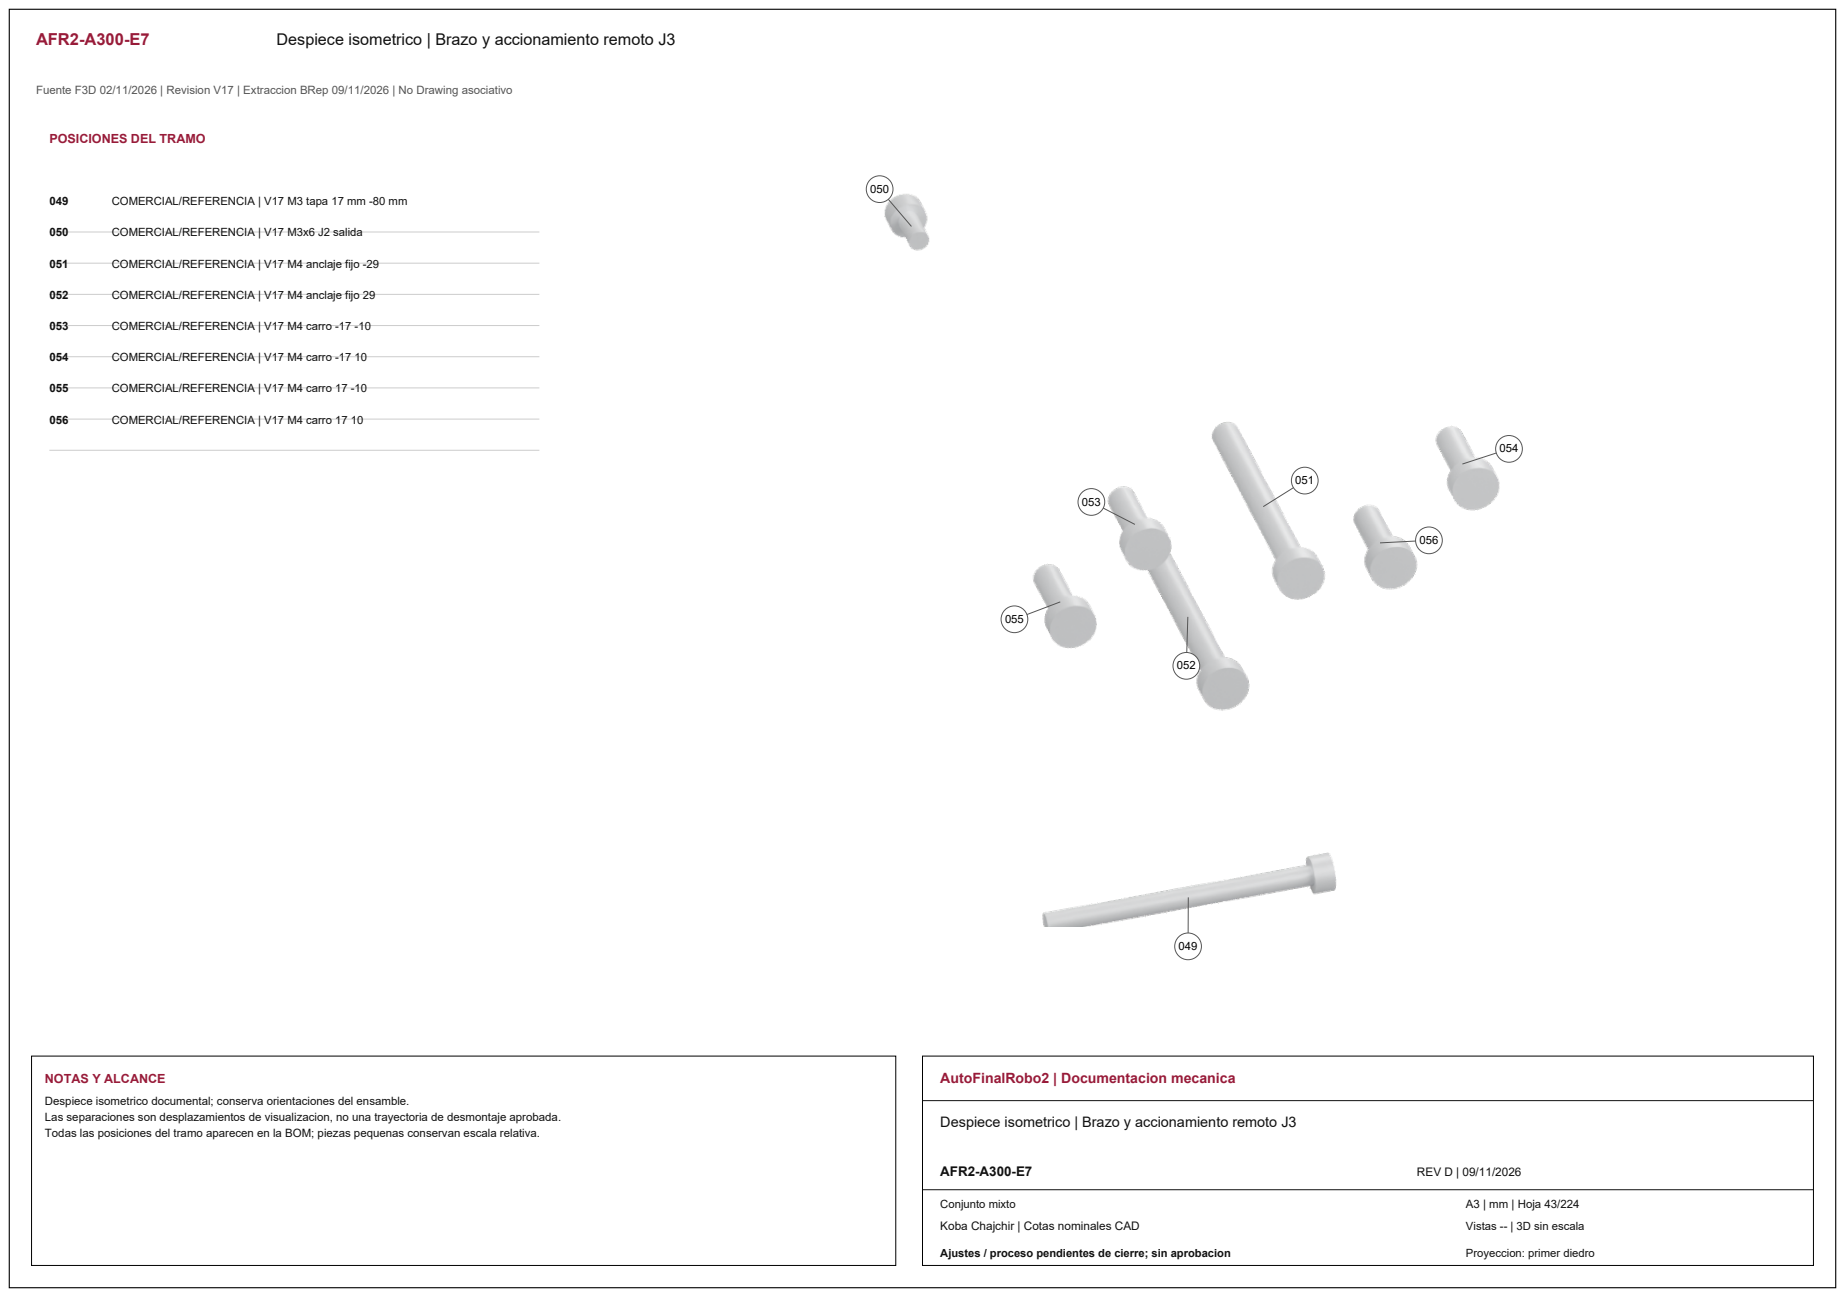
[picture p310: page 13]
NOTAS Y ALCANCE; AutoFinalRobo2 | Documentacion mecanica; AFR2-A300-E7; REV D | 09/11/2026; Conjunto mixto

POSICIONES DEL TRAMO

049 COMERCIAL/REFERENCIA | V17 M3 tapa 17 mm -80 mm

050 COMERCIAL/REFERENCIA | V17 M3x6 J2 salida

051 COMERCIAL/REFERENCIA | V17 M4 anclaje fijo -29

052 COMERCIAL/REFERENCIA | V17 M4 anclaje fijo 29

053 COMERCIAL/REFERENCIA | V17 M4 carro -17 -10

054 COMERCIAL/REFERENCIA | V17 M4 carro -17 10

055 COMERCIAL/REFERENCIA | V17 M4 carro 17 -10

056 COMERCIAL/REFERENCIA | V17 M4 carro 17 10

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

Despiece isometrico | Brazo y accionamiento remoto J3

Vistas -- | 3D sin escala

AFR2-A300-E8 | Despiece isometrico | Brazo y accionamiento remoto J3

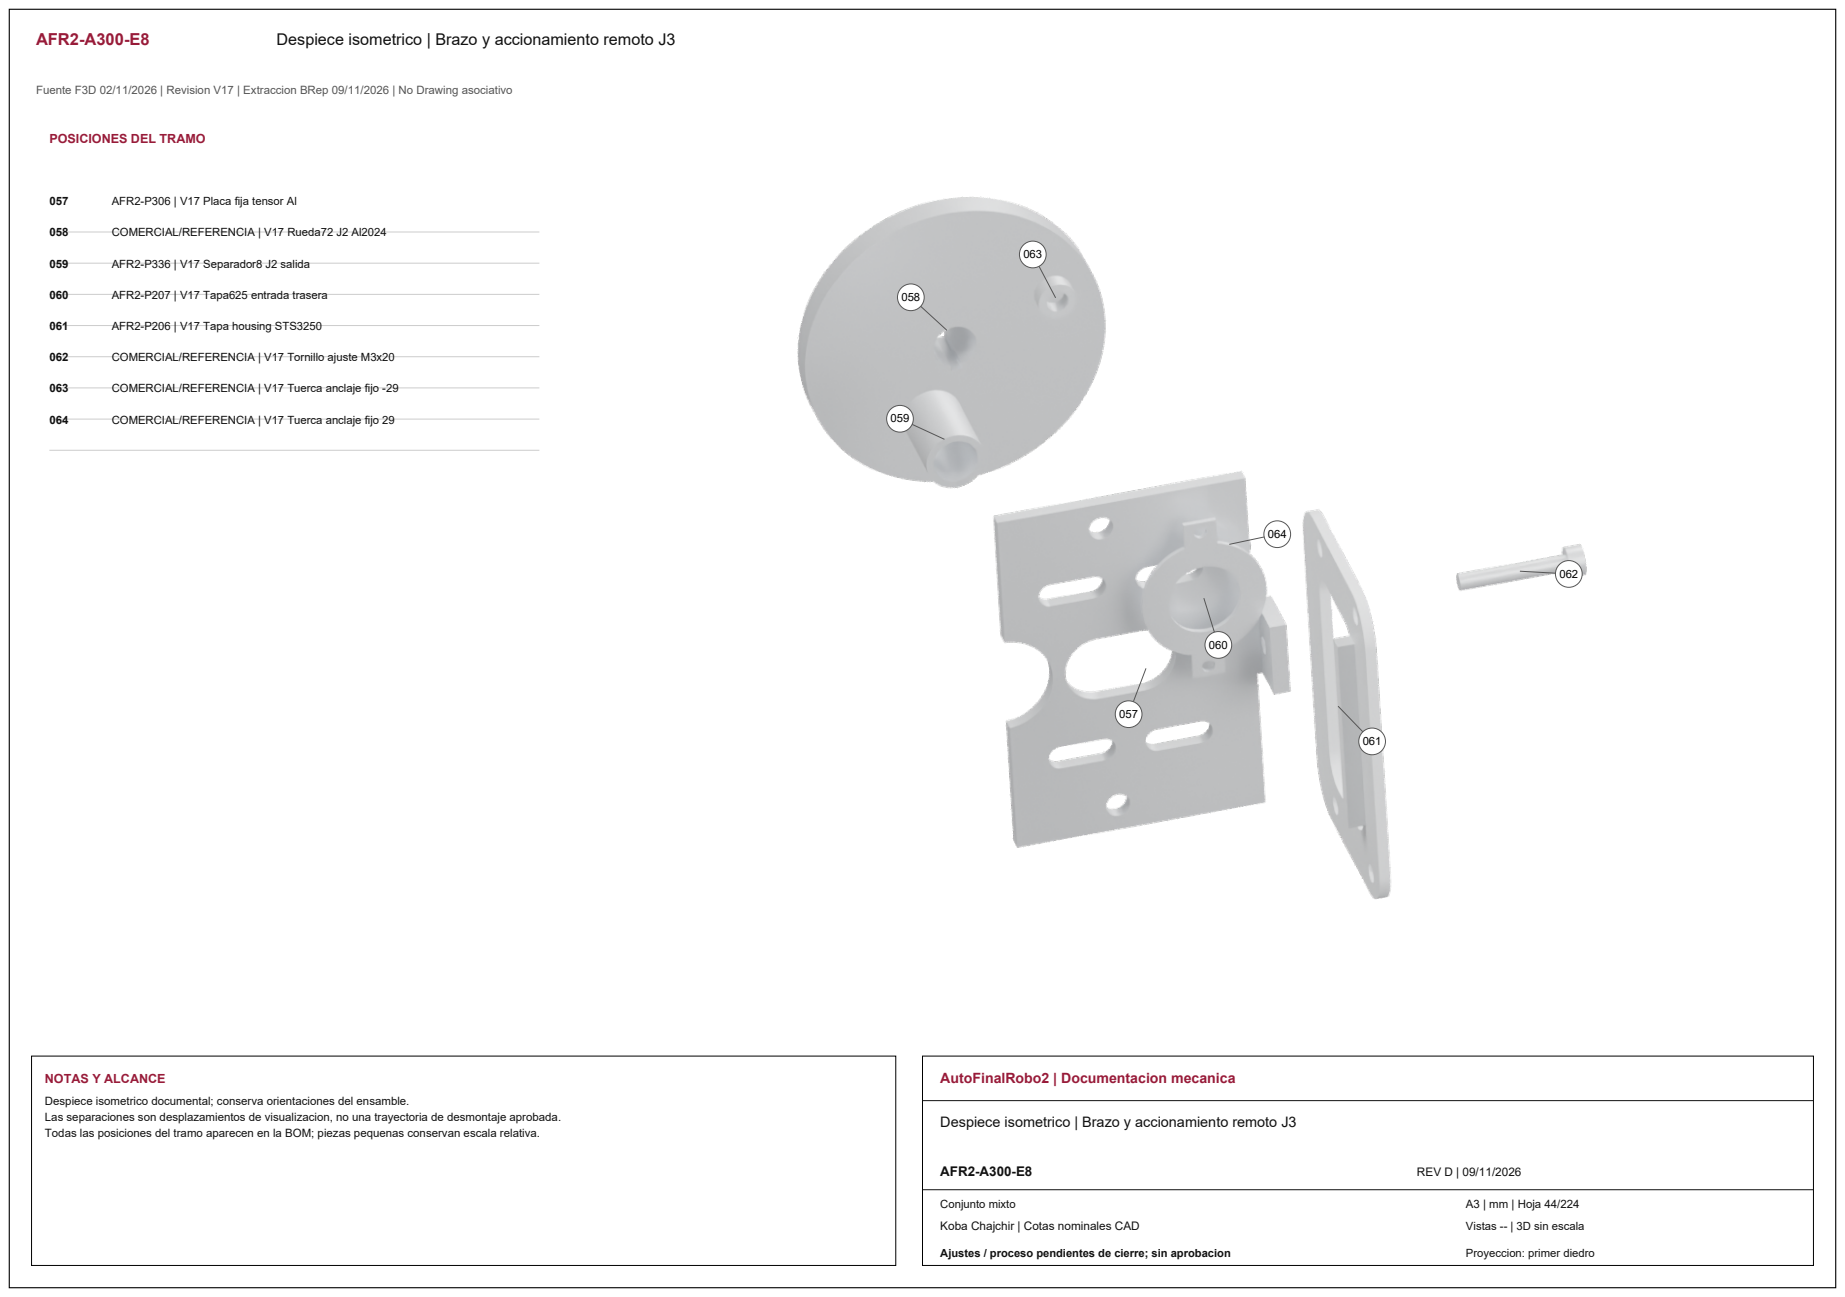
[picture p311: page 14]
058 COMERCIAL/REFERENCIA | V17 Rueda72 J2 Al2024; 059 AFR2-P336 | V17 Separador8 J2 salida; 060 AFR2-P207 | V17 Tapa625 entrada trasera; 061 AFR2-P206 | V17 Tapa housing STS3250; NOTAS Y ALCANCE; AutoFinalRobo2 | Documentacion mecanica; AFR2-A300-E8; REV D | 09/11/2026; Conjunto mixto

POSICIONES DEL TRAMO

057 AFR2-P306 | V17 Placa fija tensor Al

062 COMERCIAL/REFERENCIA | V17 Tornillo ajuste M3x20

063 COMERCIAL/REFERENCIA | V17 Tuerca anclaje fijo -29

064 COMERCIAL/REFERENCIA | V17 Tuerca anclaje fijo 29

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

Despiece isometrico | Brazo y accionamiento remoto J3

Vistas -- | 3D sin escala

AFR2-A300-E9 | Despiece isometrico | Brazo y accionamiento remoto J3

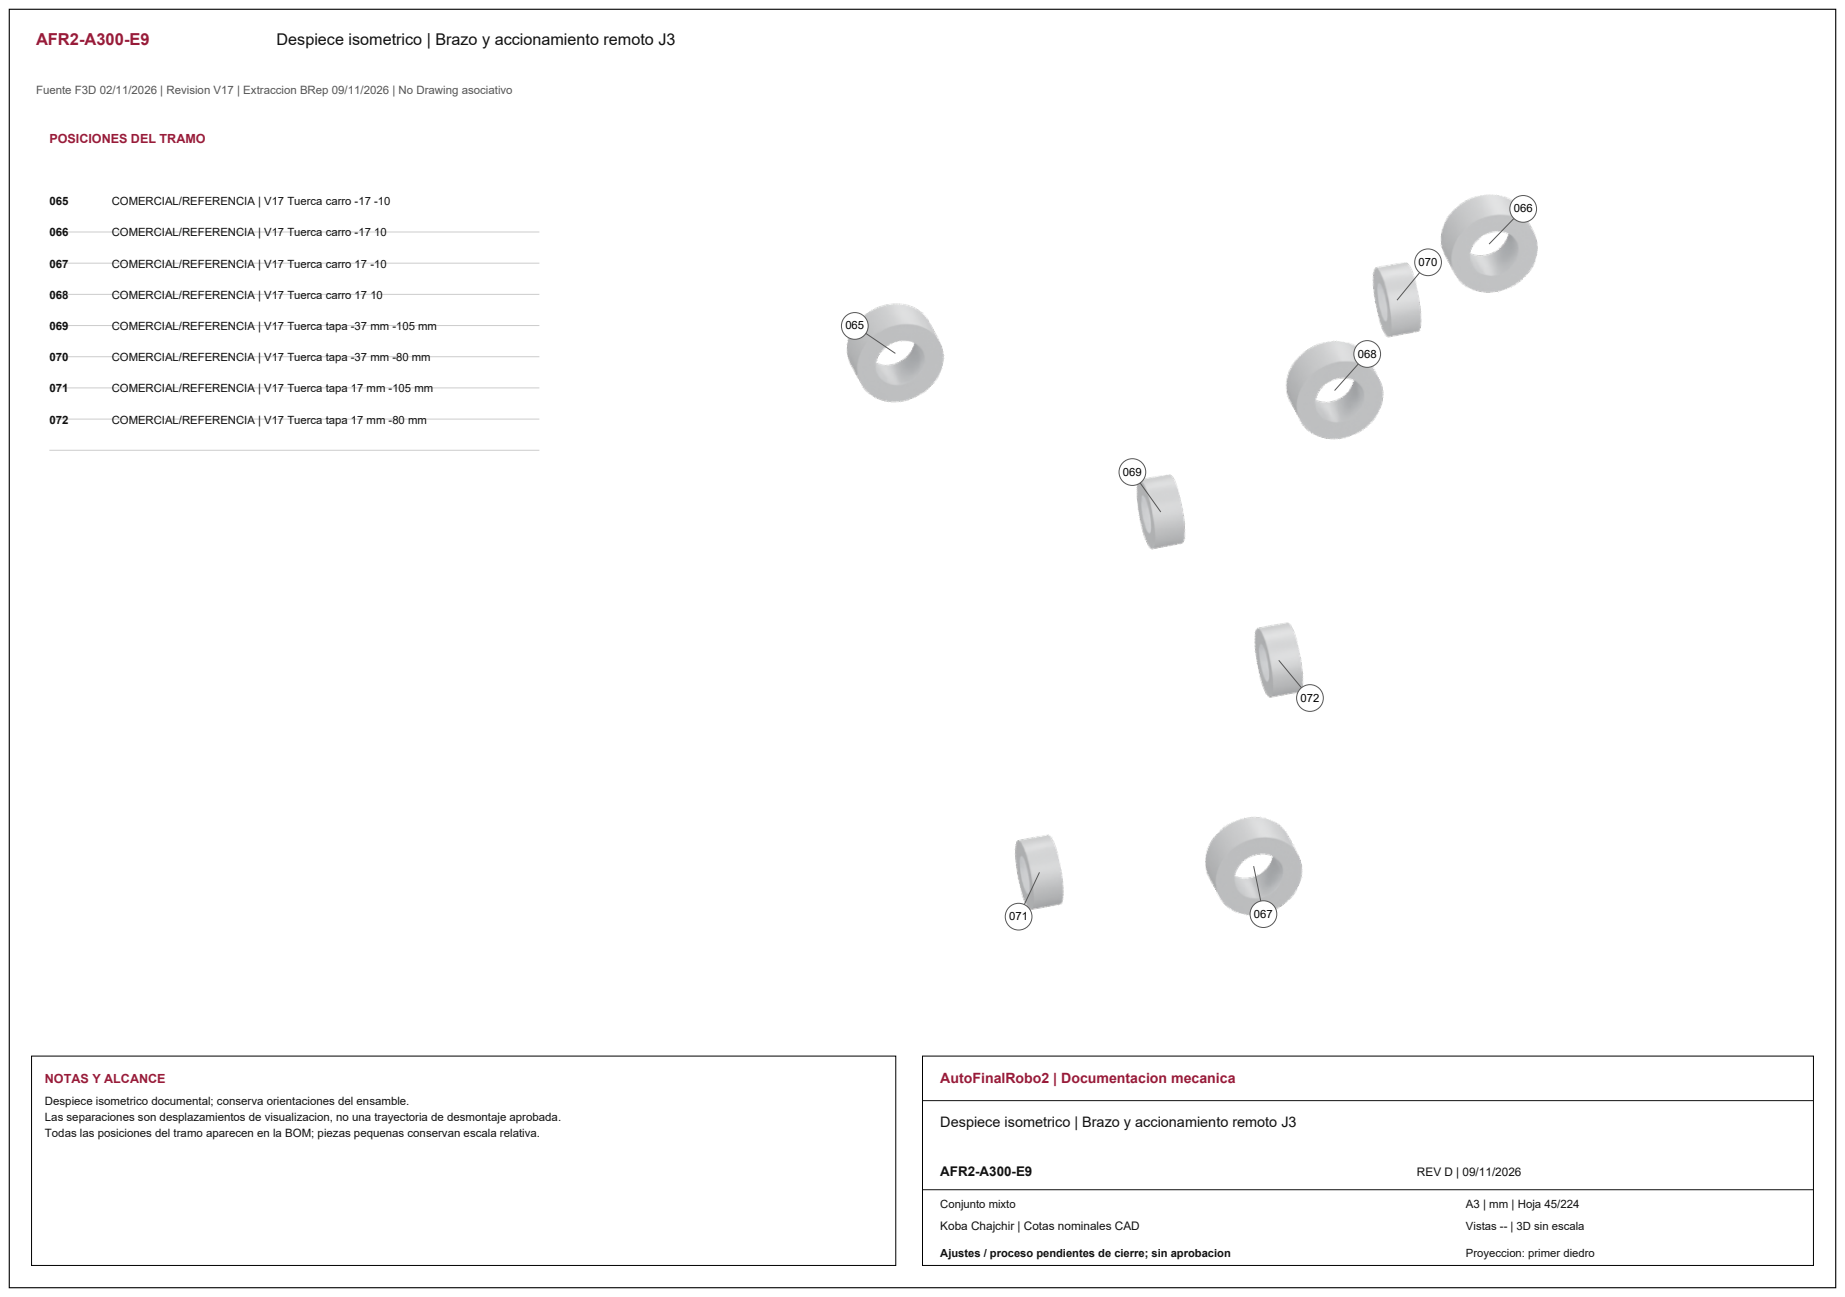
[picture p312: page 15]
NOTAS Y ALCANCE; AutoFinalRobo2 | Documentacion mecanica; AFR2-A300-E9; REV D | 09/11/2026; Conjunto mixto

POSICIONES DEL TRAMO

065 COMERCIAL/REFERENCIA | V17 Tuerca carro -17 -10

066 COMERCIAL/REFERENCIA | V17 Tuerca carro -17 10

067 COMERCIAL/REFERENCIA | V17 Tuerca carro 17 -10

068 COMERCIAL/REFERENCIA | V17 Tuerca carro 17 10

069 COMERCIAL/REFERENCIA | V17 Tuerca tapa -37 mm -105 mm

070 COMERCIAL/REFERENCIA | V17 Tuerca tapa -37 mm -80 mm

071 COMERCIAL/REFERENCIA | V17 Tuerca tapa 17 mm -105 mm

072 COMERCIAL/REFERENCIA | V17 Tuerca tapa 17 mm -80 mm

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

Despiece isometrico | Brazo y accionamiento remoto J3

Vistas -- | 3D sin escala

AFR2-A300-E10 | Despiece isometrico | Brazo y accionamiento remoto J3

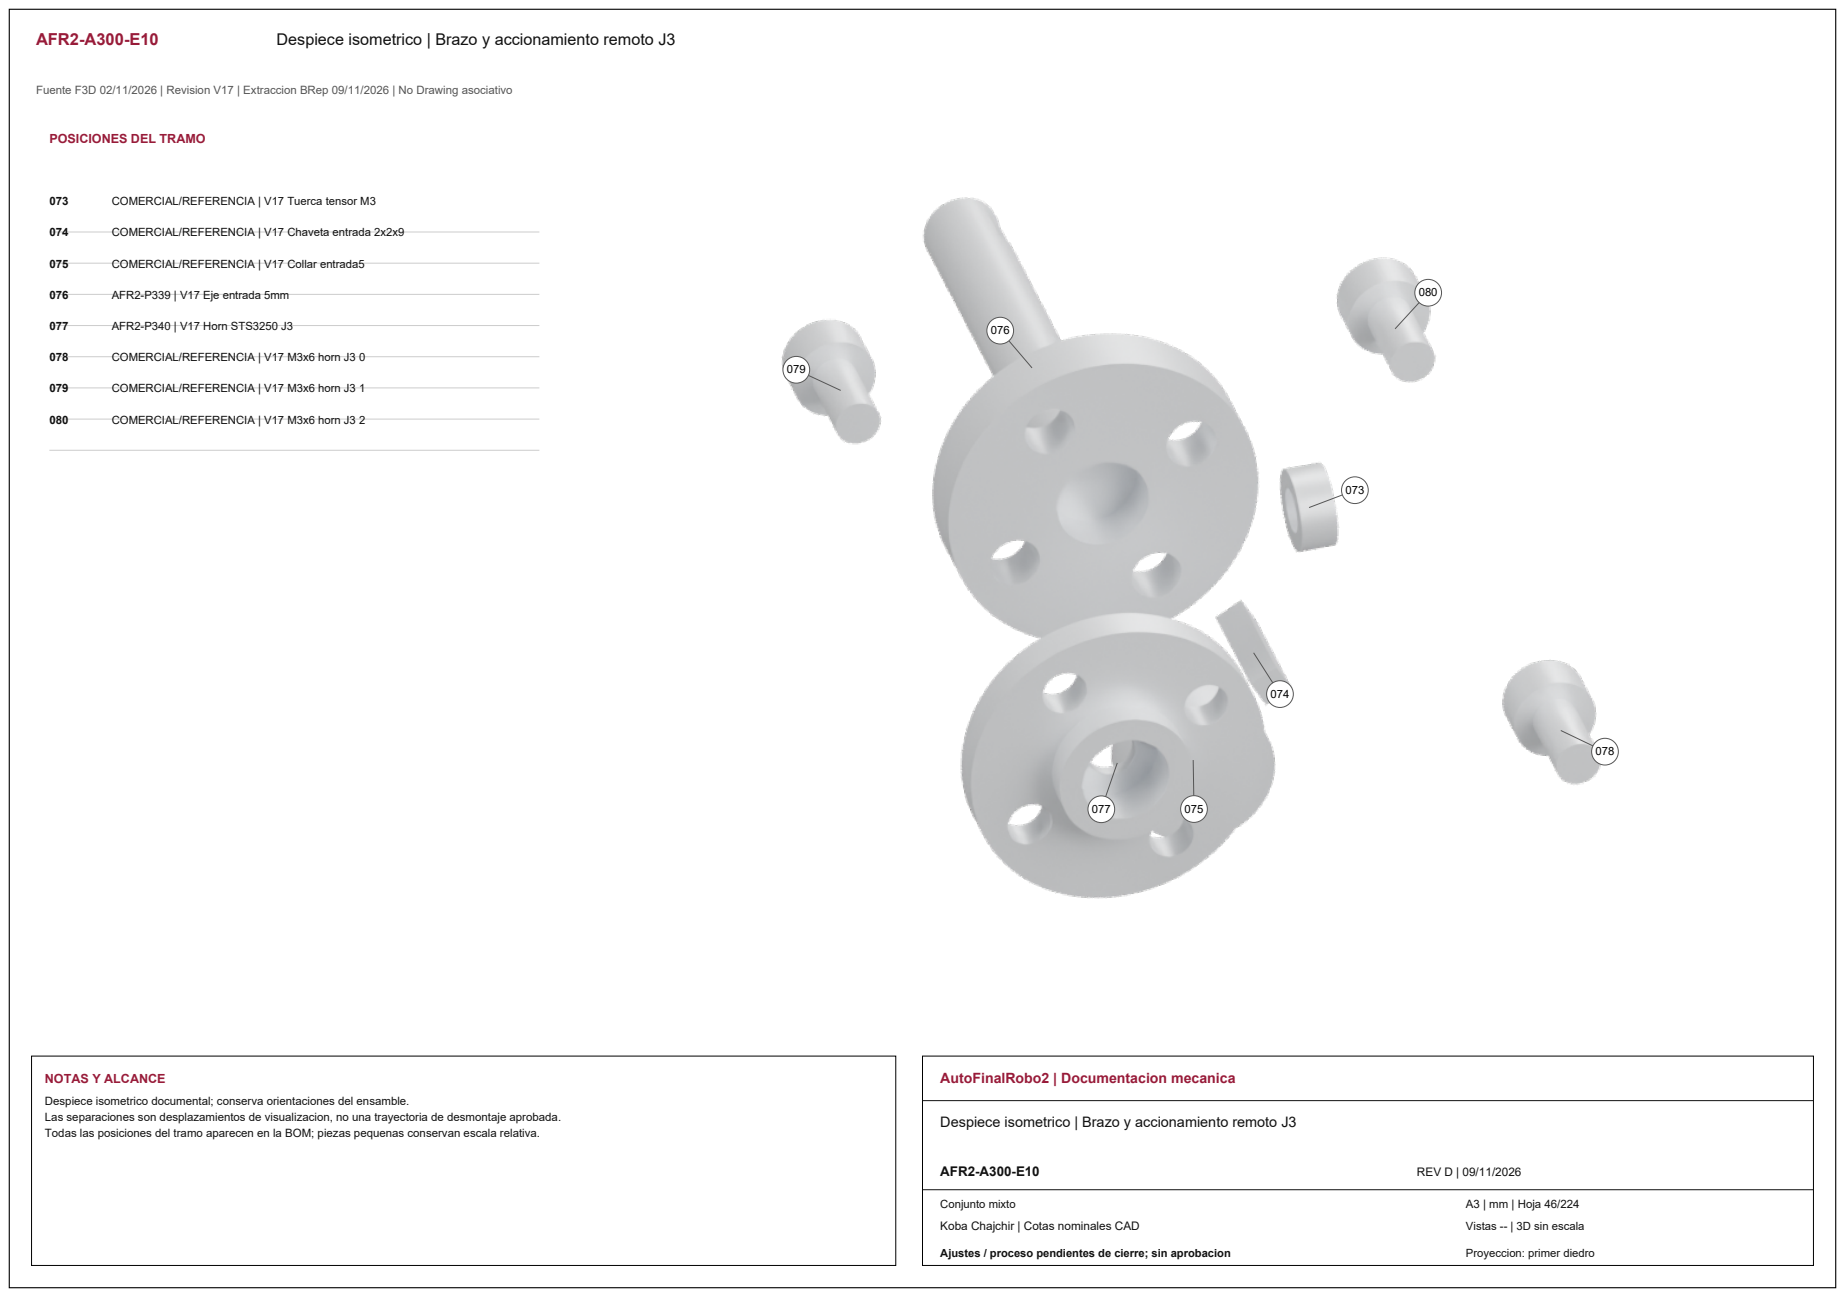
[picture p313: page 16]
076 AFR2-P339 | V17 Eje entrada 5mm; 077 AFR2-P340 | V17 Horn STS3250 J3; NOTAS Y ALCANCE; AutoFinalRobo2 | Documentacion mecanica; AFR2-A300-E10; REV D | 09/11/2026; Conjunto mixto

POSICIONES DEL TRAMO

073 COMERCIAL/REFERENCIA | V17 Tuerca tensor M3

074 COMERCIAL/REFERENCIA | V17 Chaveta entrada 2x2x9

075 COMERCIAL/REFERENCIA | V17 Collar entrada5

078 COMERCIAL/REFERENCIA | V17 M3x6 horn J3 0

079 COMERCIAL/REFERENCIA | V17 M3x6 horn J3 1

080 COMERCIAL/REFERENCIA | V17 M3x6 horn J3 2

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

Despiece isometrico | Brazo y accionamiento remoto J3

Vistas -- | 3D sin escala

AFR2-A300-E11 | Despiece isometrico | Brazo y accionamiento remoto J3

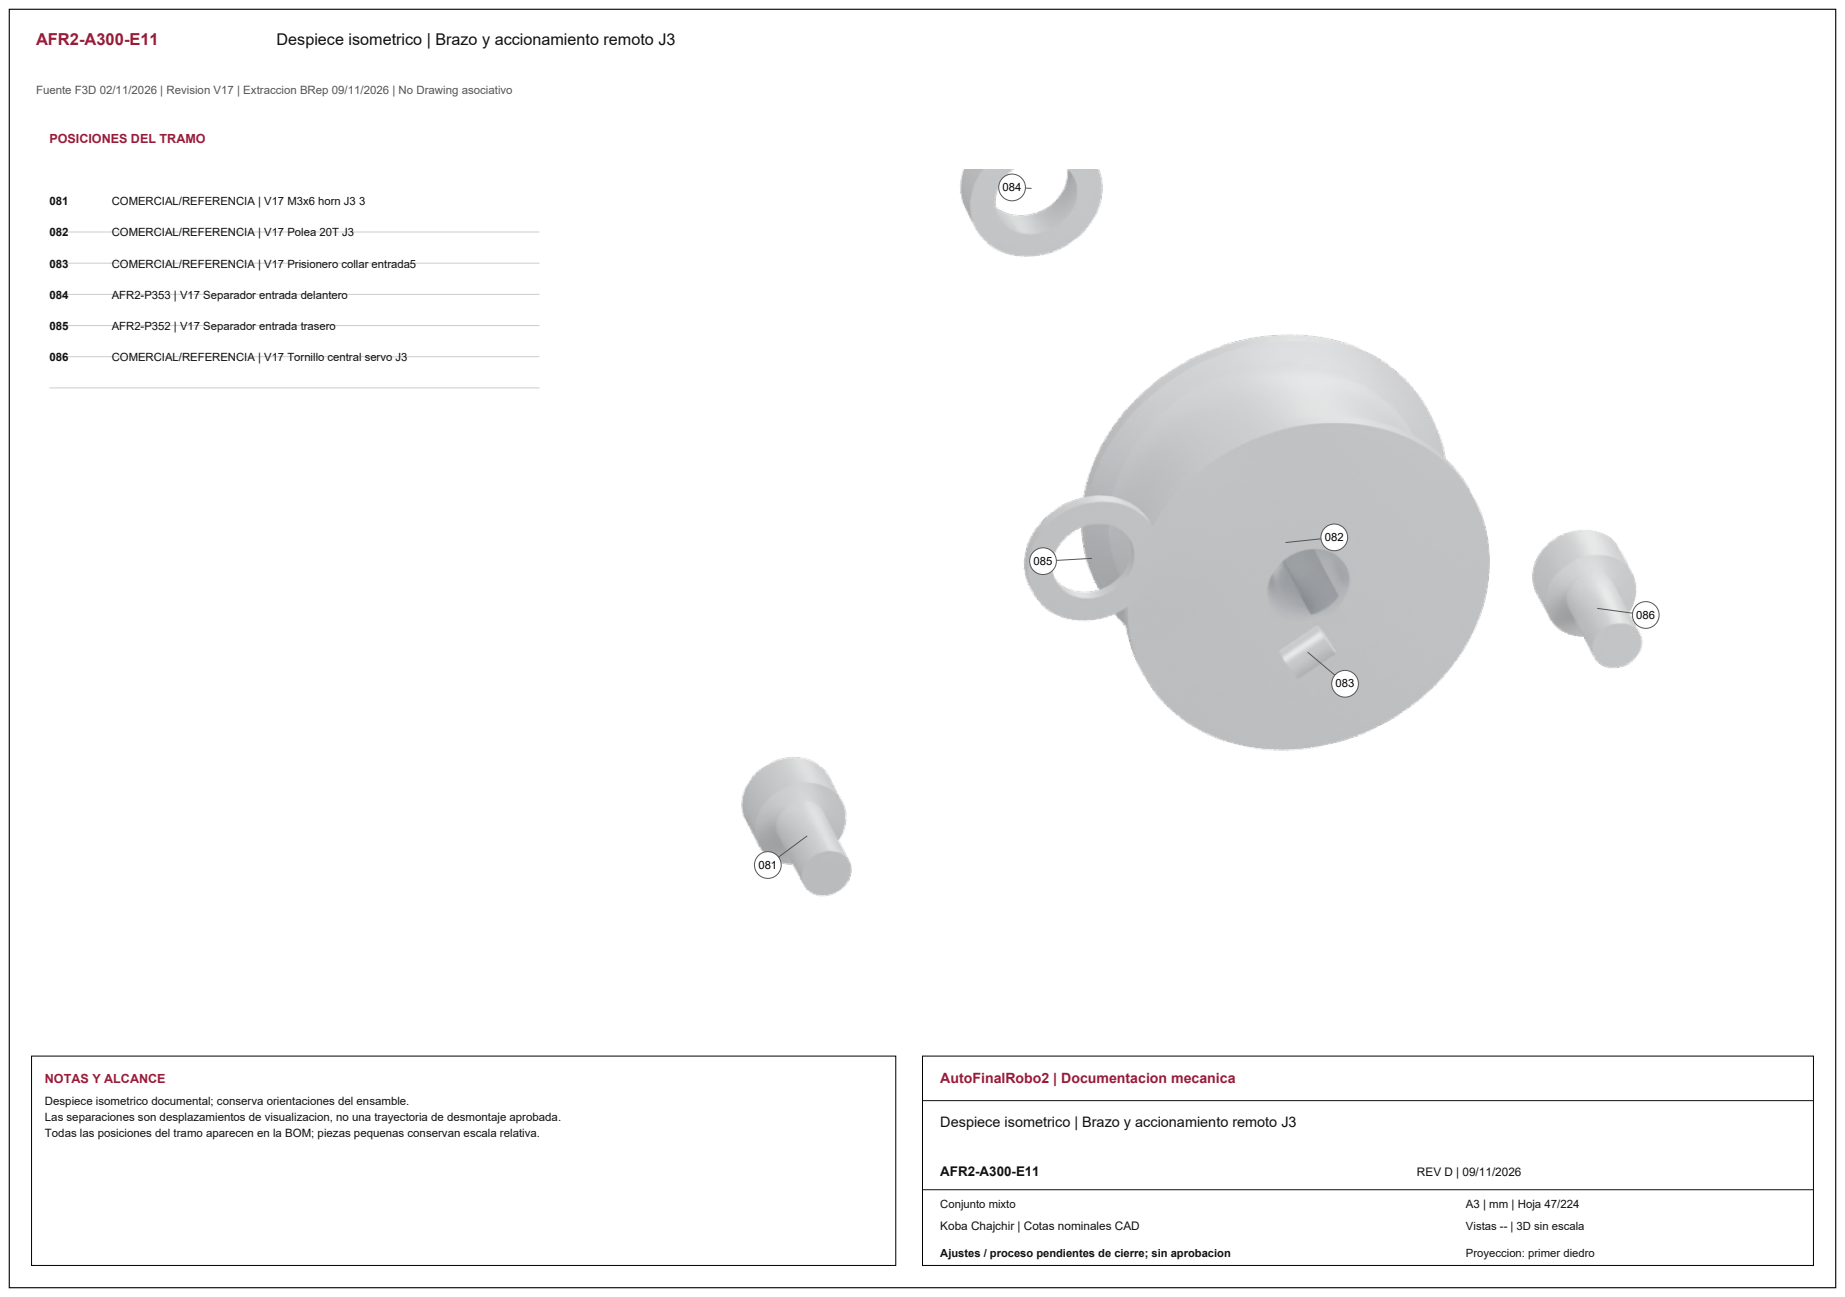
[picture p314: page 17]
NOTAS Y ALCANCE; AutoFinalRobo2 | Documentacion mecanica; AFR2-A300-E11; REV D | 09/11/2026; Conjunto mixto

POSICIONES DEL TRAMO

081 COMERCIAL/REFERENCIA | V17 M3x6 horn J3 3

082 COMERCIAL/REFERENCIA | V17 Polea 20T J3

083 COMERCIAL/REFERENCIA | V17 Prisionero collar entrada5

084 AFR2-P353 | V17 Separador entrada delantero

085 AFR2-P352 | V17 Separador entrada trasero

086 COMERCIAL/REFERENCIA | V17 Tornillo central servo J3

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

Despiece isometrico | Brazo y accionamiento remoto J3

Vistas -- | 3D sin escala

AFR2-P301 | E01 Eje hombro 8mm

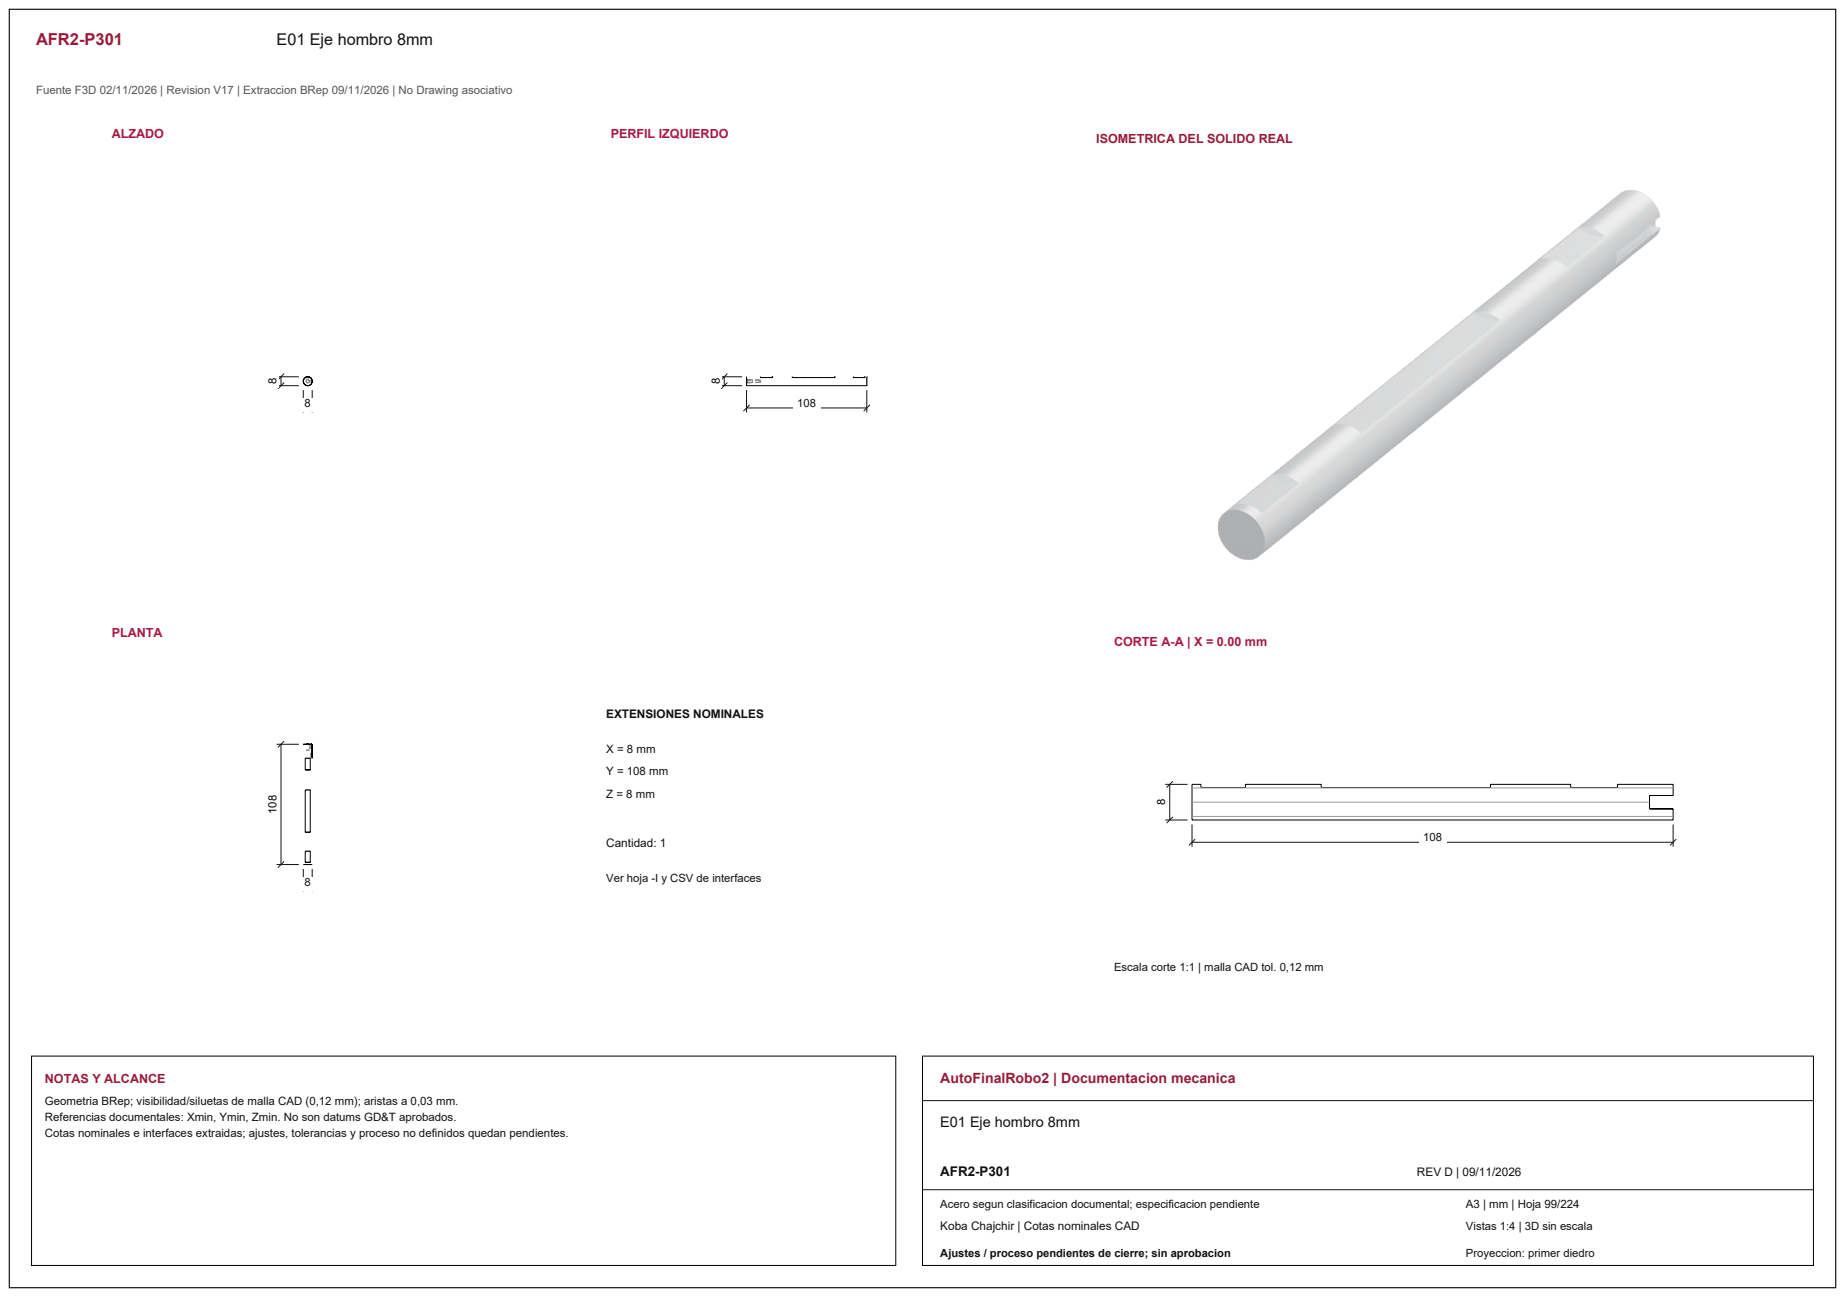
[picture p315: page 18]
ALZADO; PERFIL IZQUIERDO; PLANTA; CORTE A-A | X = 0.00 mm; EXTENSIONES NOMINALES; Cantidad: 1; NOTAS Y ALCANCE; AutoFinalRobo2 | Documentacion mecanica; E01 Eje hombro 8mm; AFR2-P301; REV D | 09/11/2026

ISOMETRICA DEL SOLIDO REAL

Ver hoja -I y CSV de interfaces

Escala corte 1:1 | malla CAD tol. 0,12 mm

Geometria BRep; visibilidad/siluetas de malla CAD (0,12 mm); aristas a 0,03 mm.
Referencias documentales: Xmin, Ymin, Zmin. No son datums GD&T aprobados.
Cotas nominales e interfaces extraidas; ajustes, tolerancias y proceso no definidos quedan pendientes.

Acero segun clasificacion documental; especificacion pendiente

Vistas 1:4 | 3D sin escala

AFR2-P301-I01 | Interfaces y corte | E01 Eje hombro 8mm

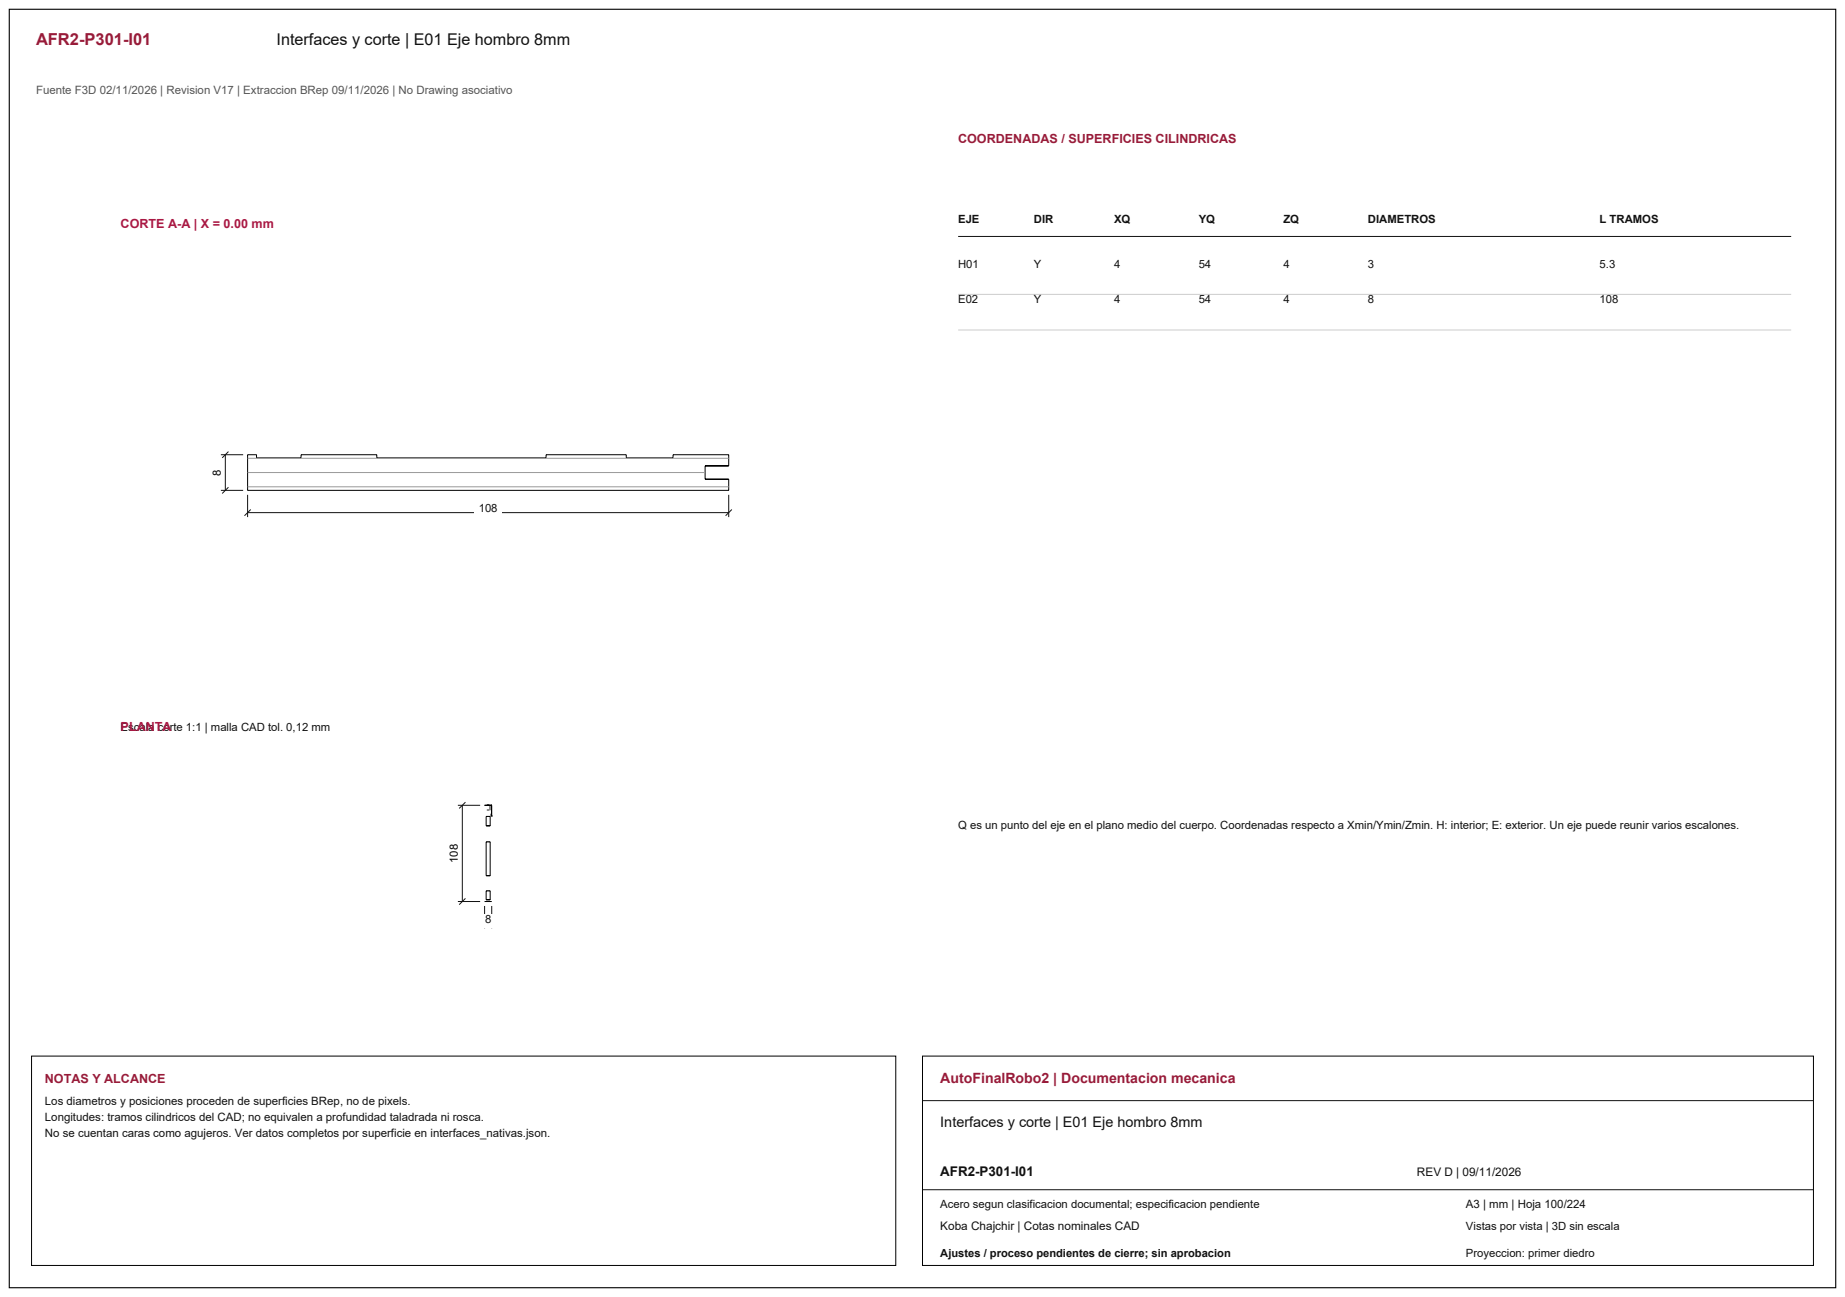
[picture p316: page 19]
CORTE A-A | X = 0.00 mm; EJE; DIR; DIAMETROS; L TRAMOS; NOTAS Y ALCANCE; AutoFinalRobo2 | Documentacion mecanica; AFR2-P301-I01; REV D | 09/11/2026

COORDENADAS / SUPERFICIES CILINDRICAS

Escala corte 1:1 | malla CAD tol. 0,12 mm PLANTA

Q es un punto del eje en el plano medio del cuerpo. Coordenadas respecto a Xmin/Ymin/Zmin. H: interior; E: exterior. Un eje puede reunir varios escalones.

Los diametros y posiciones proceden de superficies BRep, no de pixels.
Longitudes: tramos cilindricos del CAD; no equivalen a profundidad taladrada ni rosca.
No se cuentan caras como agujeros. Ver datos completos por superficie en interfaces_nativas.json.

Interfaces y corte | E01 Eje hombro 8mm

Acero segun clasificacion documental; especificacion pendiente

Vistas por vista | 3D sin escala

AFR2-P302 | L01 PVC nominal V17 Corte 1

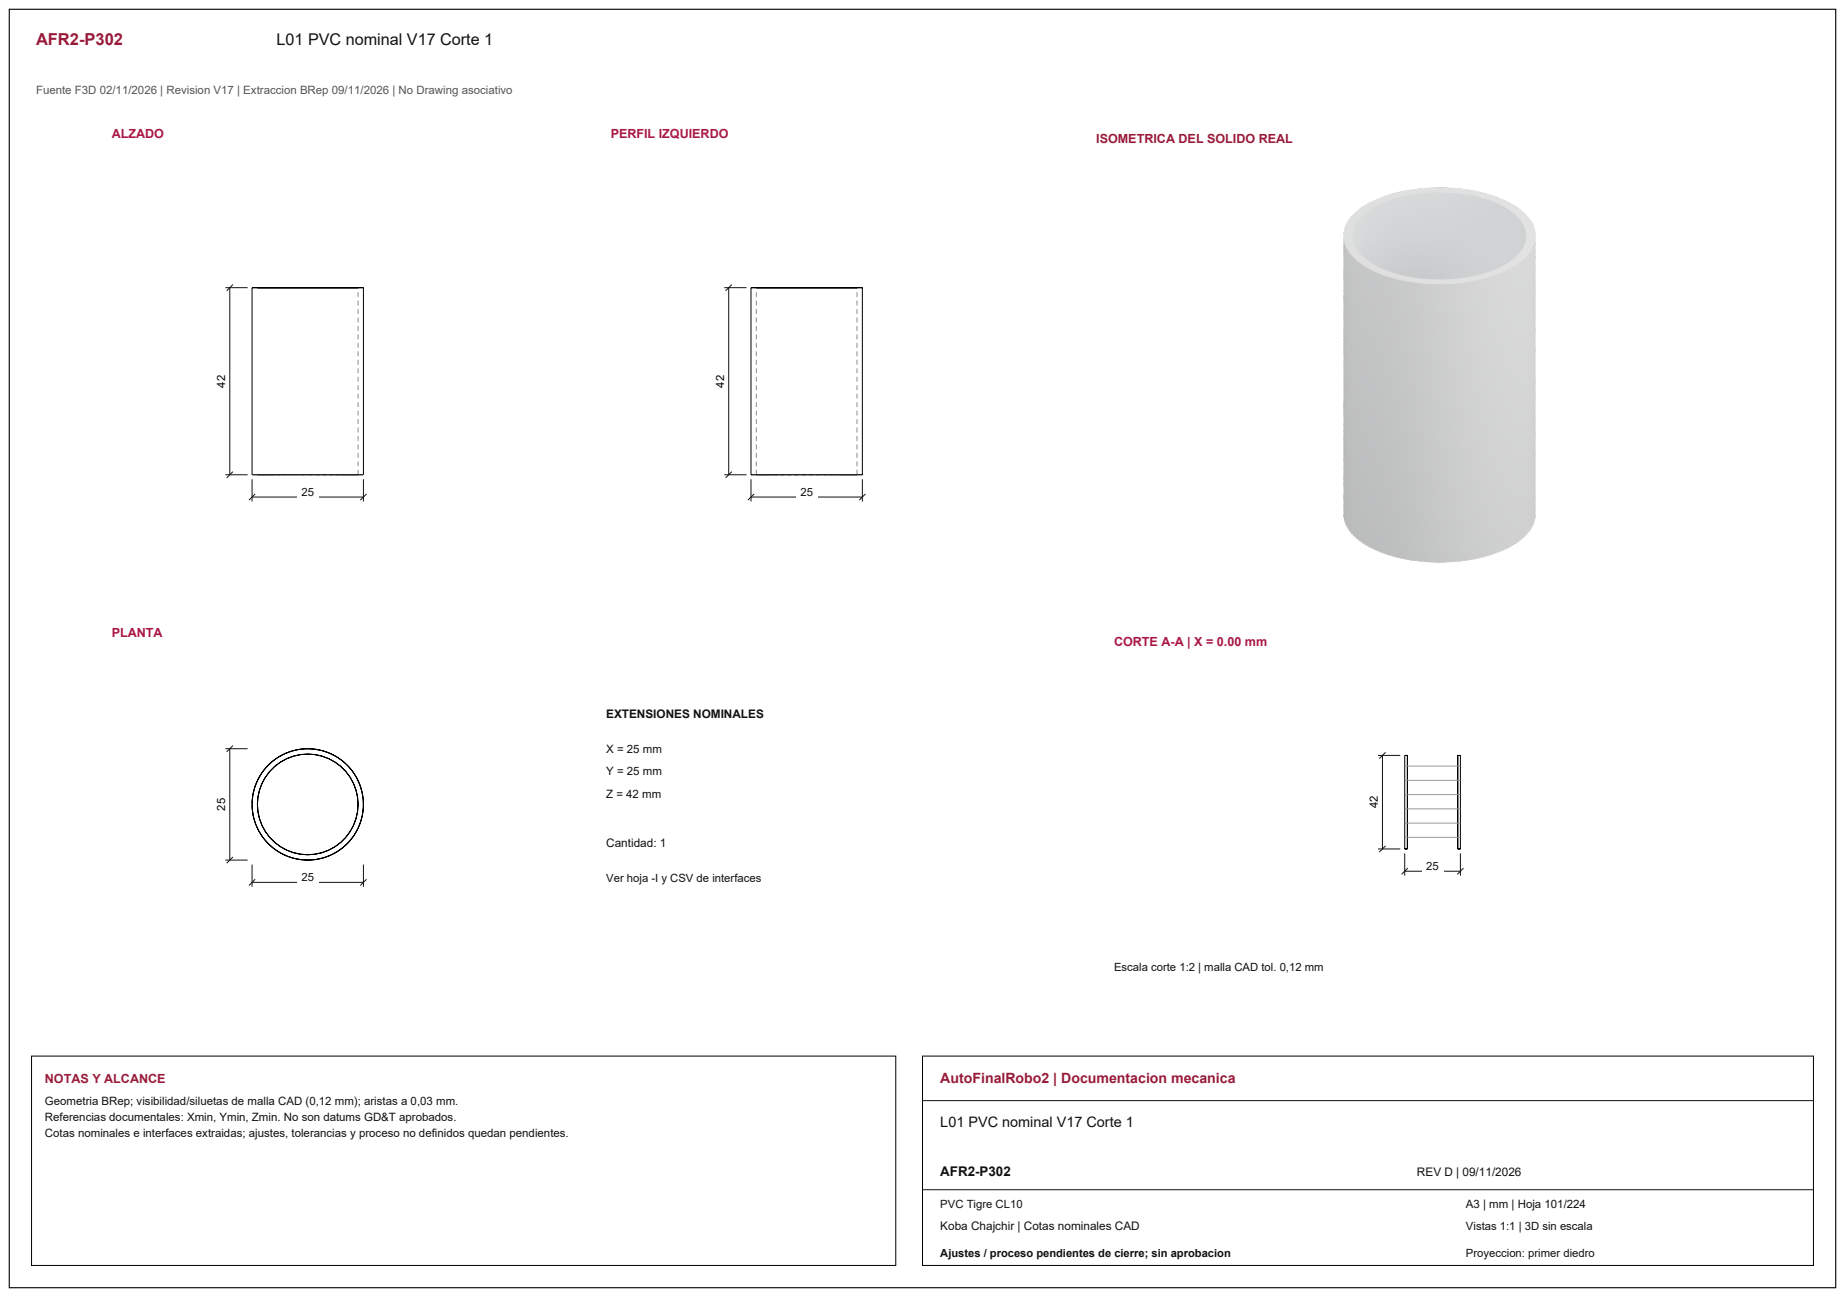
[picture p317: page 20]
ALZADO; PERFIL IZQUIERDO; PLANTA; CORTE A-A | X = 0.00 mm; EXTENSIONES NOMINALES; Cantidad: 1; NOTAS Y ALCANCE; AutoFinalRobo2 | Documentacion mecanica; AFR2-P302; REV D | 09/11/2026; PVC Tigre CL10

ISOMETRICA DEL SOLIDO REAL

Ver hoja -I y CSV de interfaces

Escala corte 1:2 | malla CAD tol. 0,12 mm

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

L01 PVC nominal V17 Corte 1

Vistas 1:1 | 3D sin escala

AFR2-P302-I01 | Interfaces y corte | L01 PVC nominal V17 Corte 1

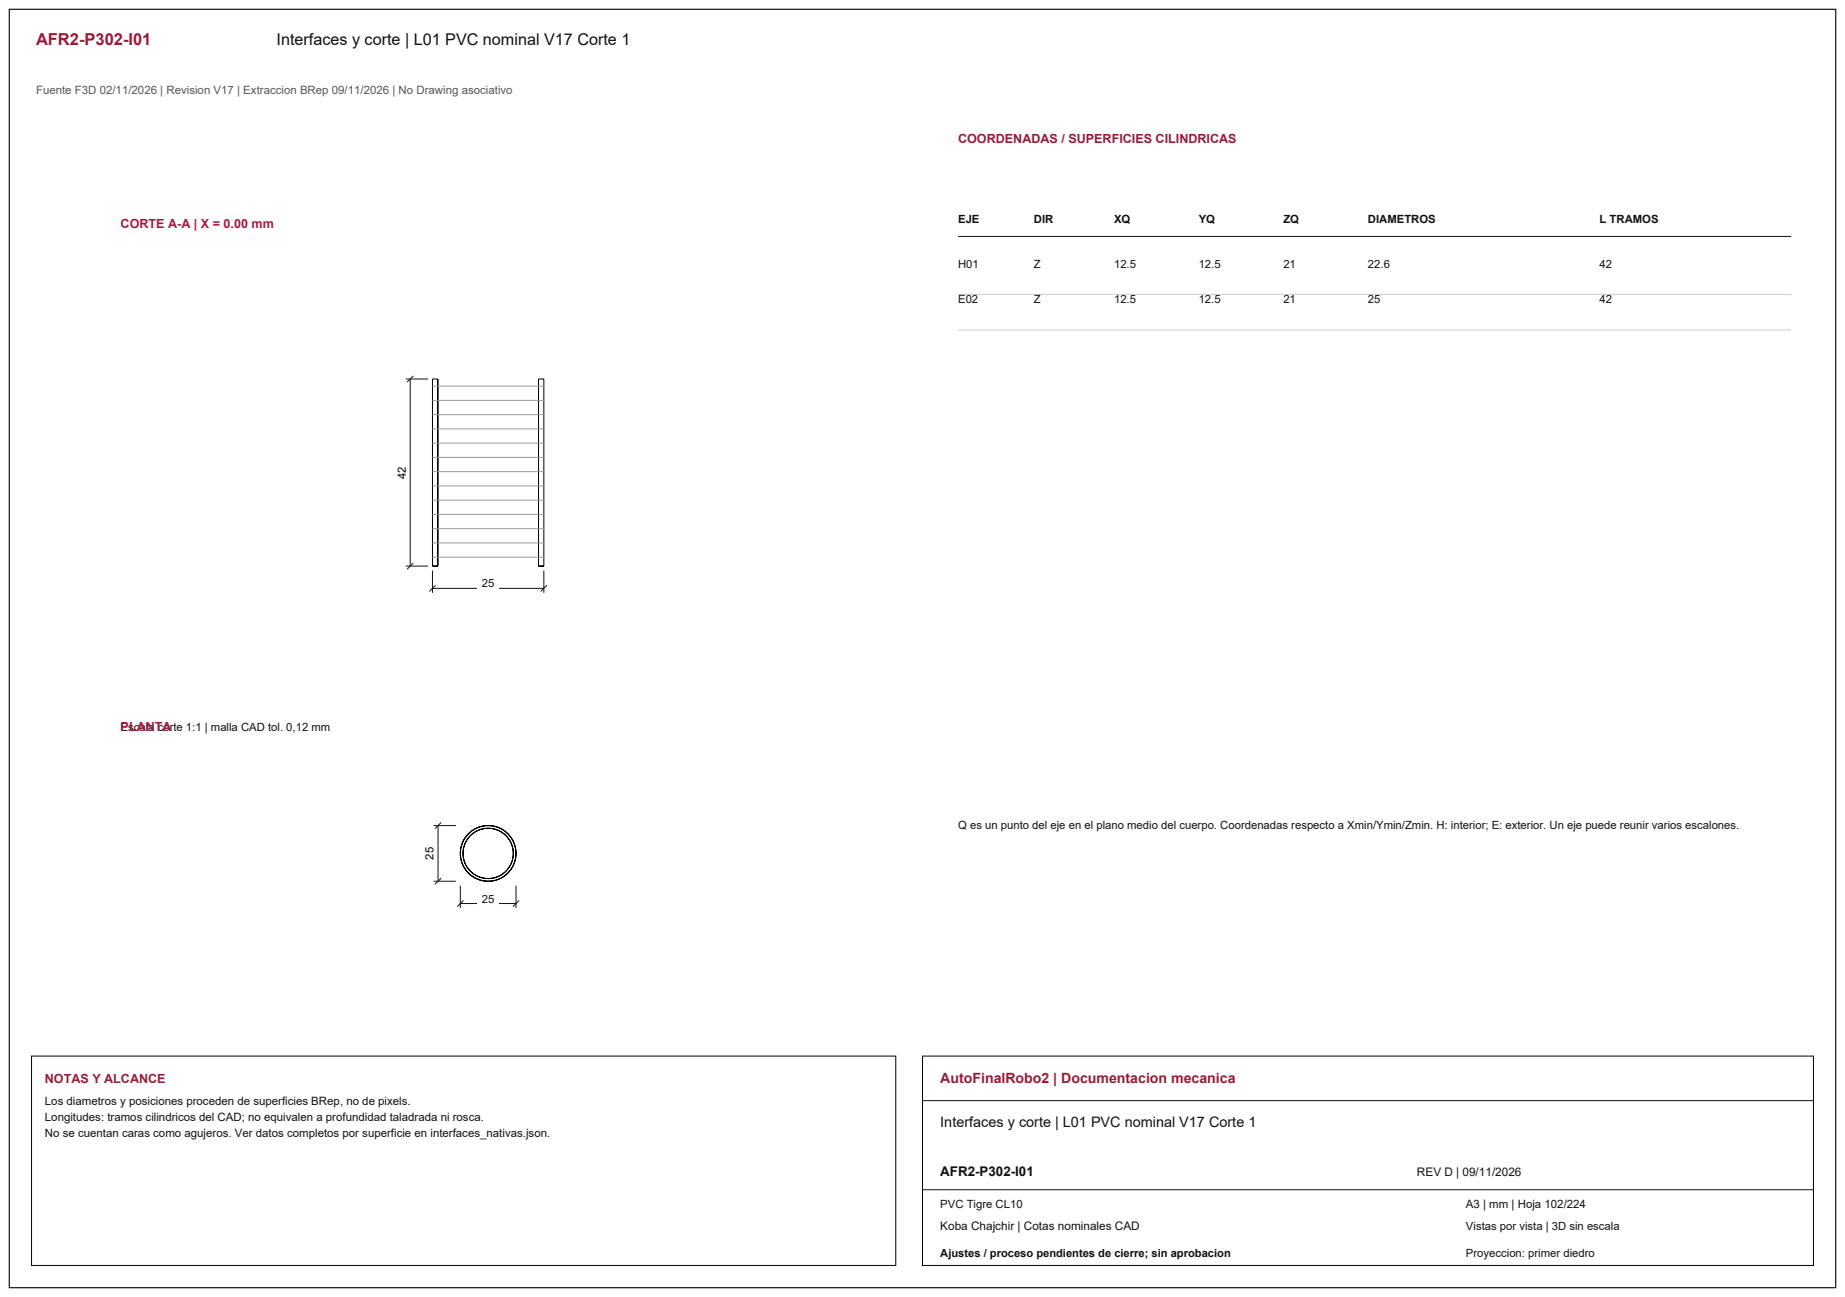
[picture p318: page 21]
CORTE A-A | X = 0.00 mm; EJE; DIR; DIAMETROS; L TRAMOS; NOTAS Y ALCANCE; AutoFinalRobo2 | Documentacion mecanica; AFR2-P302-I01; REV D | 09/11/2026; PVC Tigre CL10

COORDENADAS / SUPERFICIES CILINDRICAS

Escala corte 1:1 | malla CAD tol. 0,12 mm PLANTA

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

Interfaces y corte | L01 PVC nominal V17 Corte 1

Vistas por vista | 3D sin escala

AFR2-P303 | Tapa 608 A06 Encastre distal brazo PLA -1

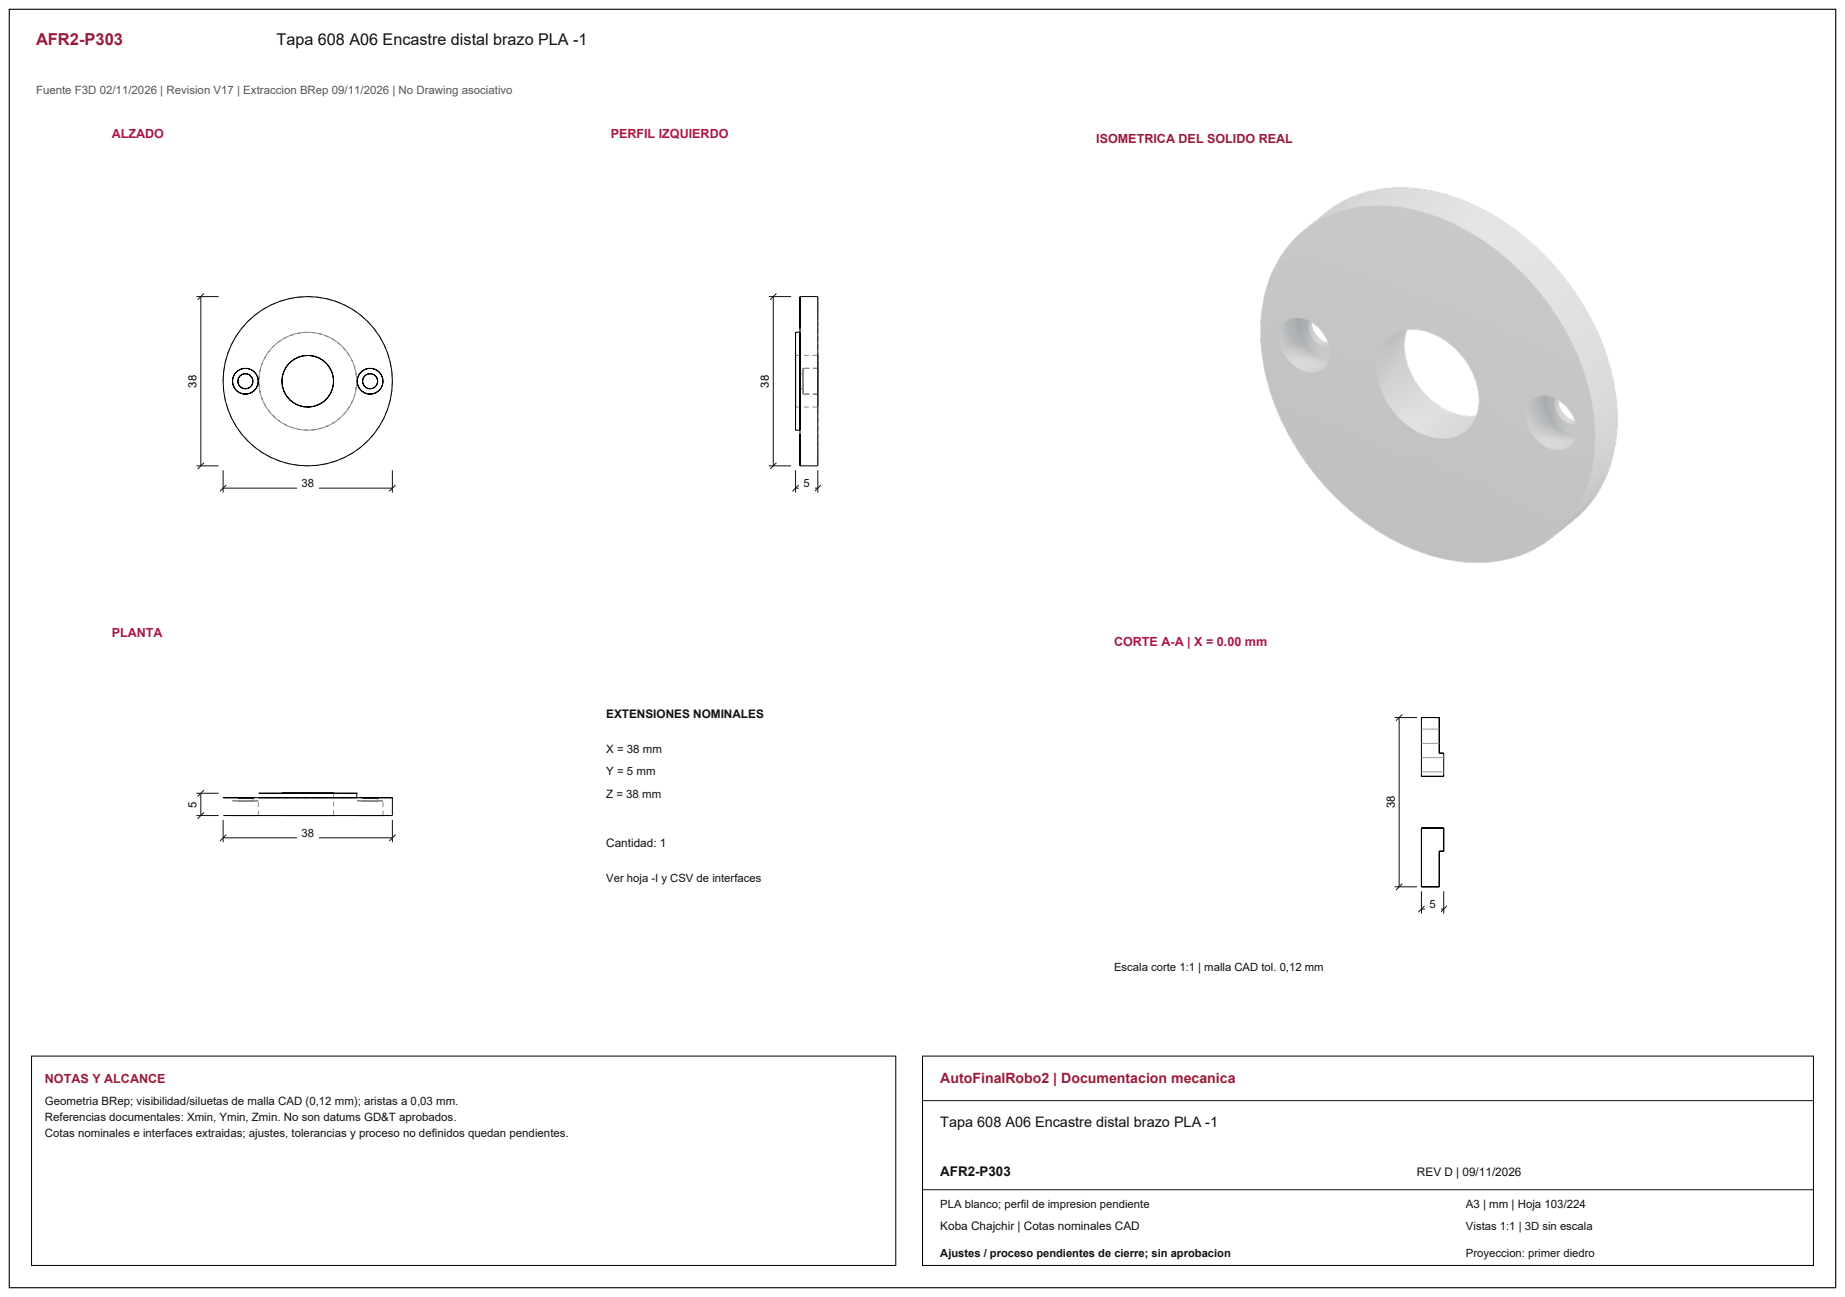
[picture p319: page 22]
ALZADO; PERFIL IZQUIERDO; PLANTA; CORTE A-A | X = 0.00 mm; EXTENSIONES NOMINALES; Cantidad: 1; NOTAS Y ALCANCE; AutoFinalRobo2 | Documentacion mecanica; AFR2-P303; REV D | 09/11/2026

ISOMETRICA DEL SOLIDO REAL

Ver hoja -I y CSV de interfaces

Escala corte 1:1 | malla CAD tol. 0,12 mm

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

Tapa 608 A06 Encastre distal brazo PLA -1

PLA blanco; perfil de impresion pendiente

Vistas 1:1 | 3D sin escala

AFR2-P303-I01 | Interfaces y corte | Tapa 608 A06 Encastre distal brazo PLA -1

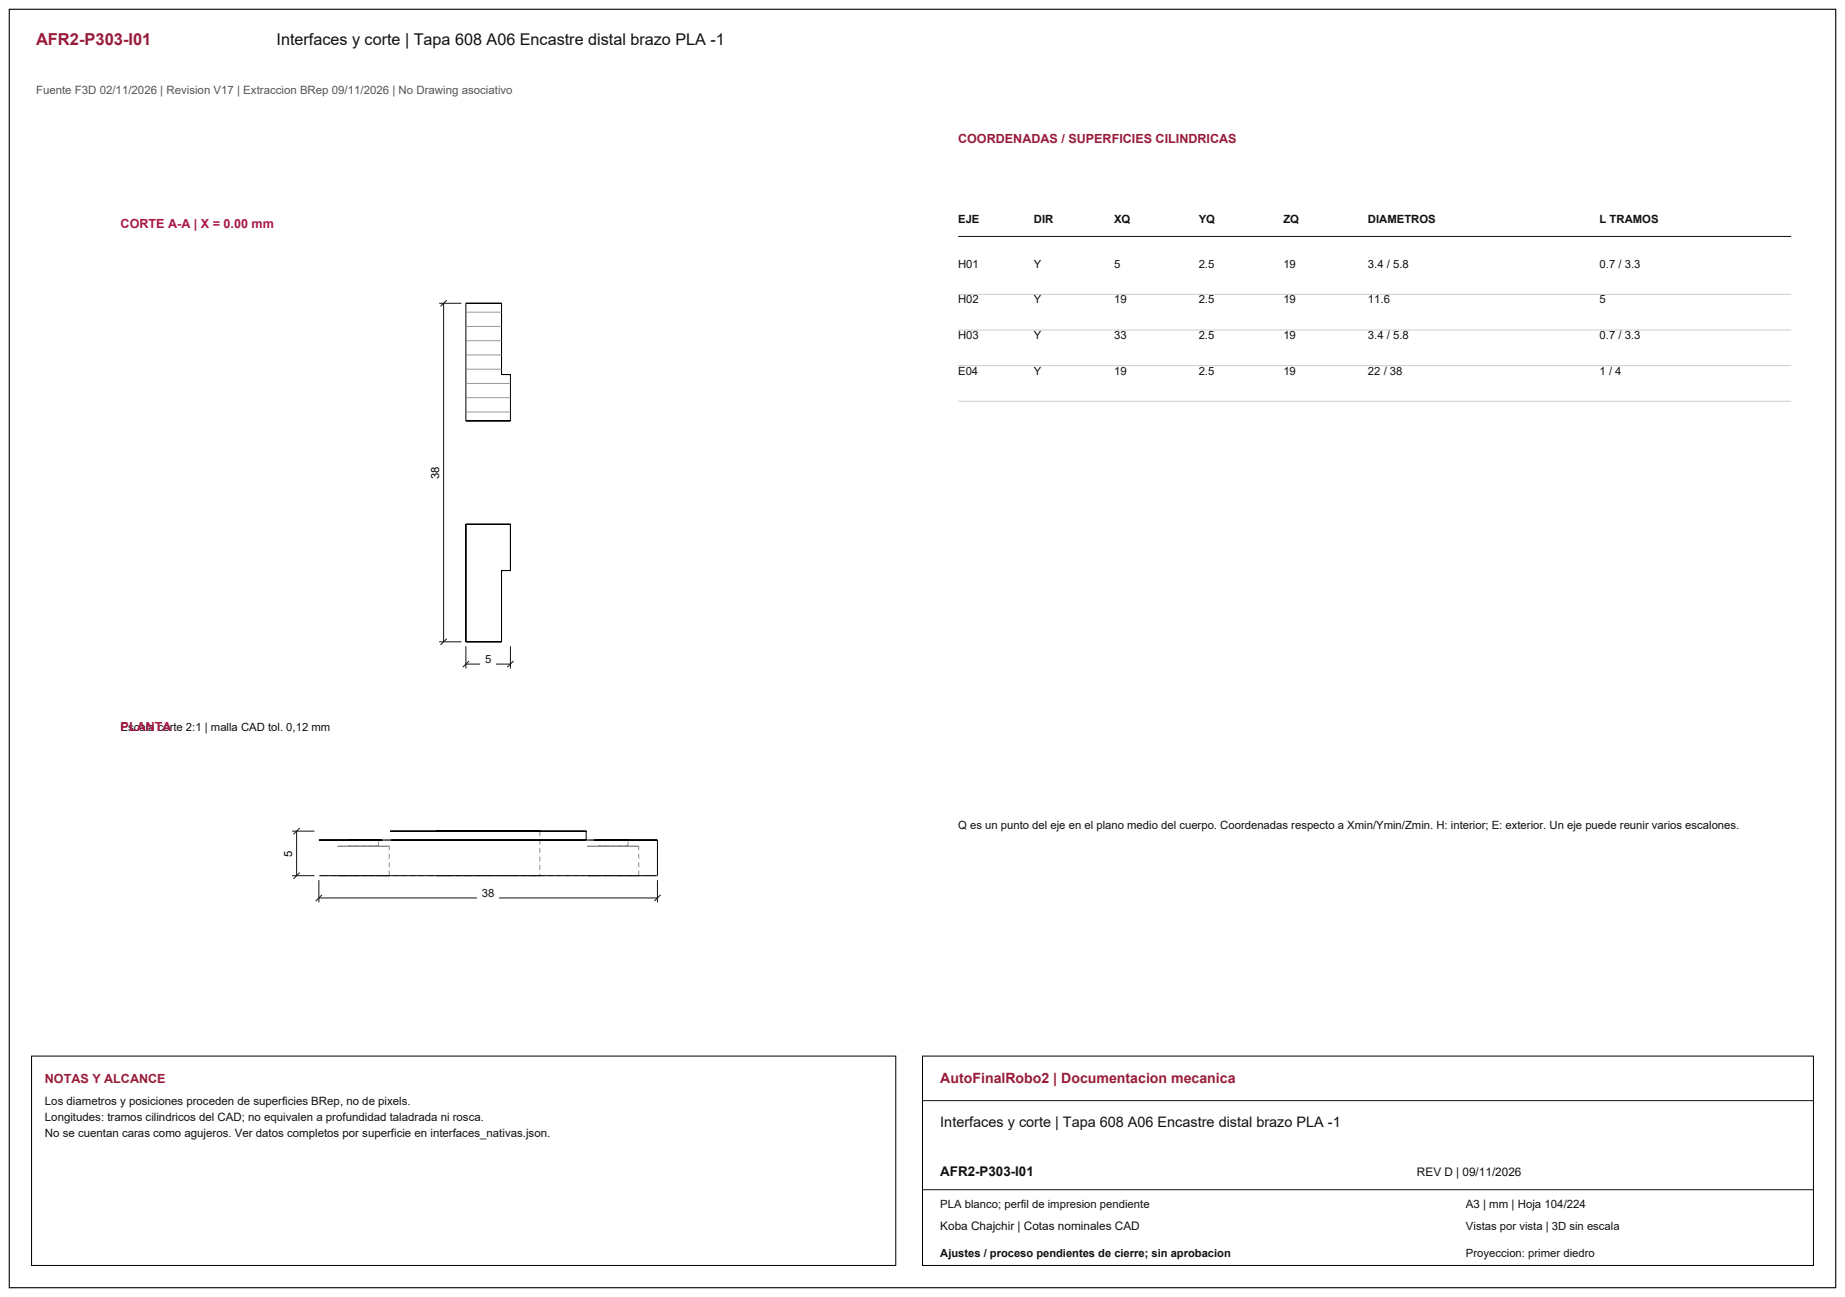
[picture p320: page 23]
CORTE A-A | X = 0.00 mm; EJE; DIR; DIAMETROS; L TRAMOS; NOTAS Y ALCANCE; AutoFinalRobo2 | Documentacion mecanica; AFR2-P303-I01; REV D | 09/11/2026

COORDENADAS / SUPERFICIES CILINDRICAS

Escala corte 2:1 | malla CAD tol. 0,12 mm PLANTA

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

Interfaces y corte | Tapa 608 A06 Encastre distal brazo PLA -1

PLA blanco; perfil de impresion pendiente

Vistas por vista | 3D sin escala

AFR2-P304 | Tapa 608 A06 Encastre distal brazo PLA 1

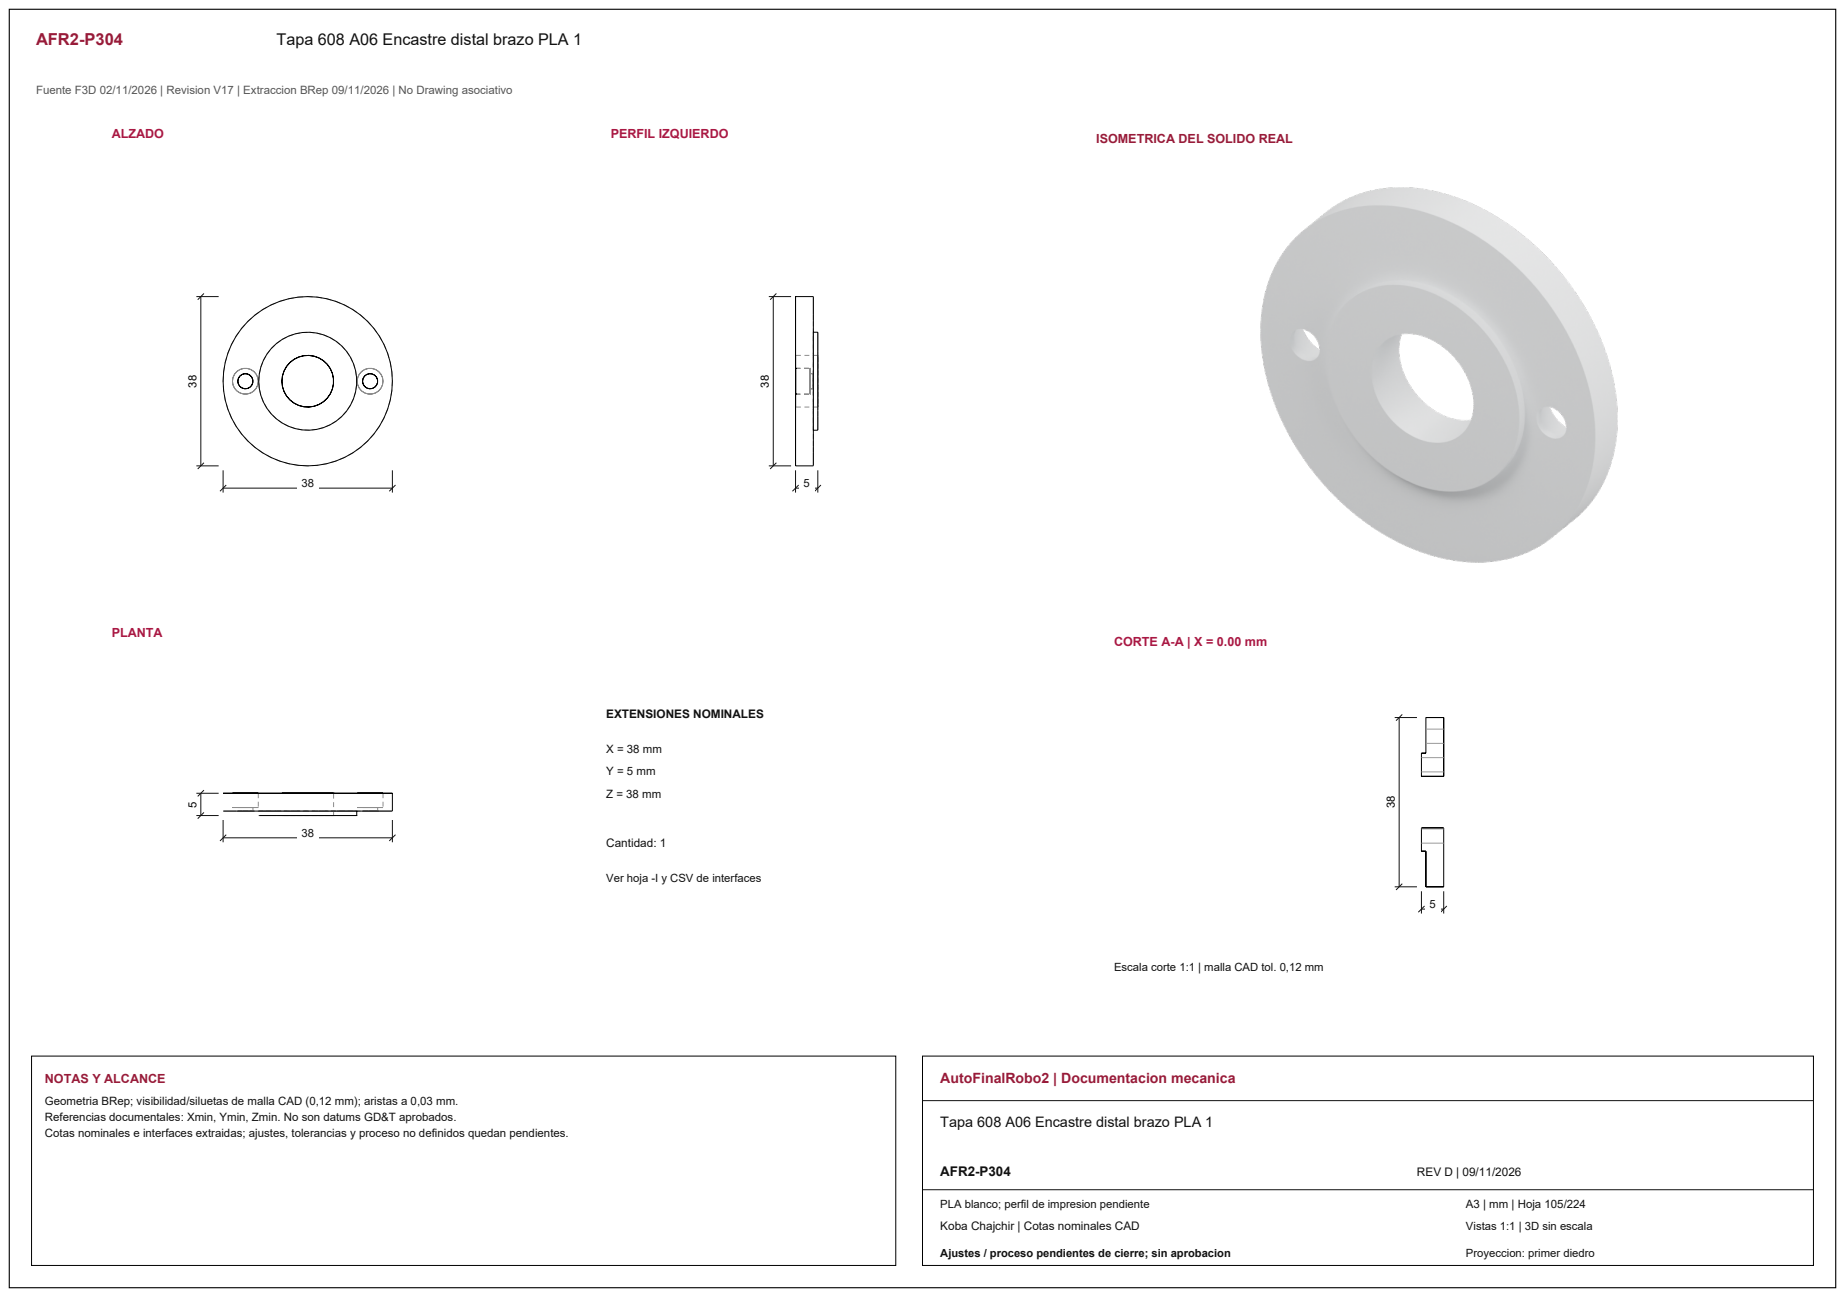
[picture p321: page 24]
ALZADO; PERFIL IZQUIERDO; PLANTA; CORTE A-A | X = 0.00 mm; EXTENSIONES NOMINALES; Cantidad: 1; NOTAS Y ALCANCE; AutoFinalRobo2 | Documentacion mecanica; AFR2-P304; REV D | 09/11/2026

ISOMETRICA DEL SOLIDO REAL

Ver hoja -I y CSV de interfaces

Escala corte 1:1 | malla CAD tol. 0,12 mm

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

Tapa 608 A06 Encastre distal brazo PLA 1

PLA blanco; perfil de impresion pendiente

Vistas 1:1 | 3D sin escala

AFR2-P304-I01 | Interfaces y corte | Tapa 608 A06 Encastre distal brazo PLA 1

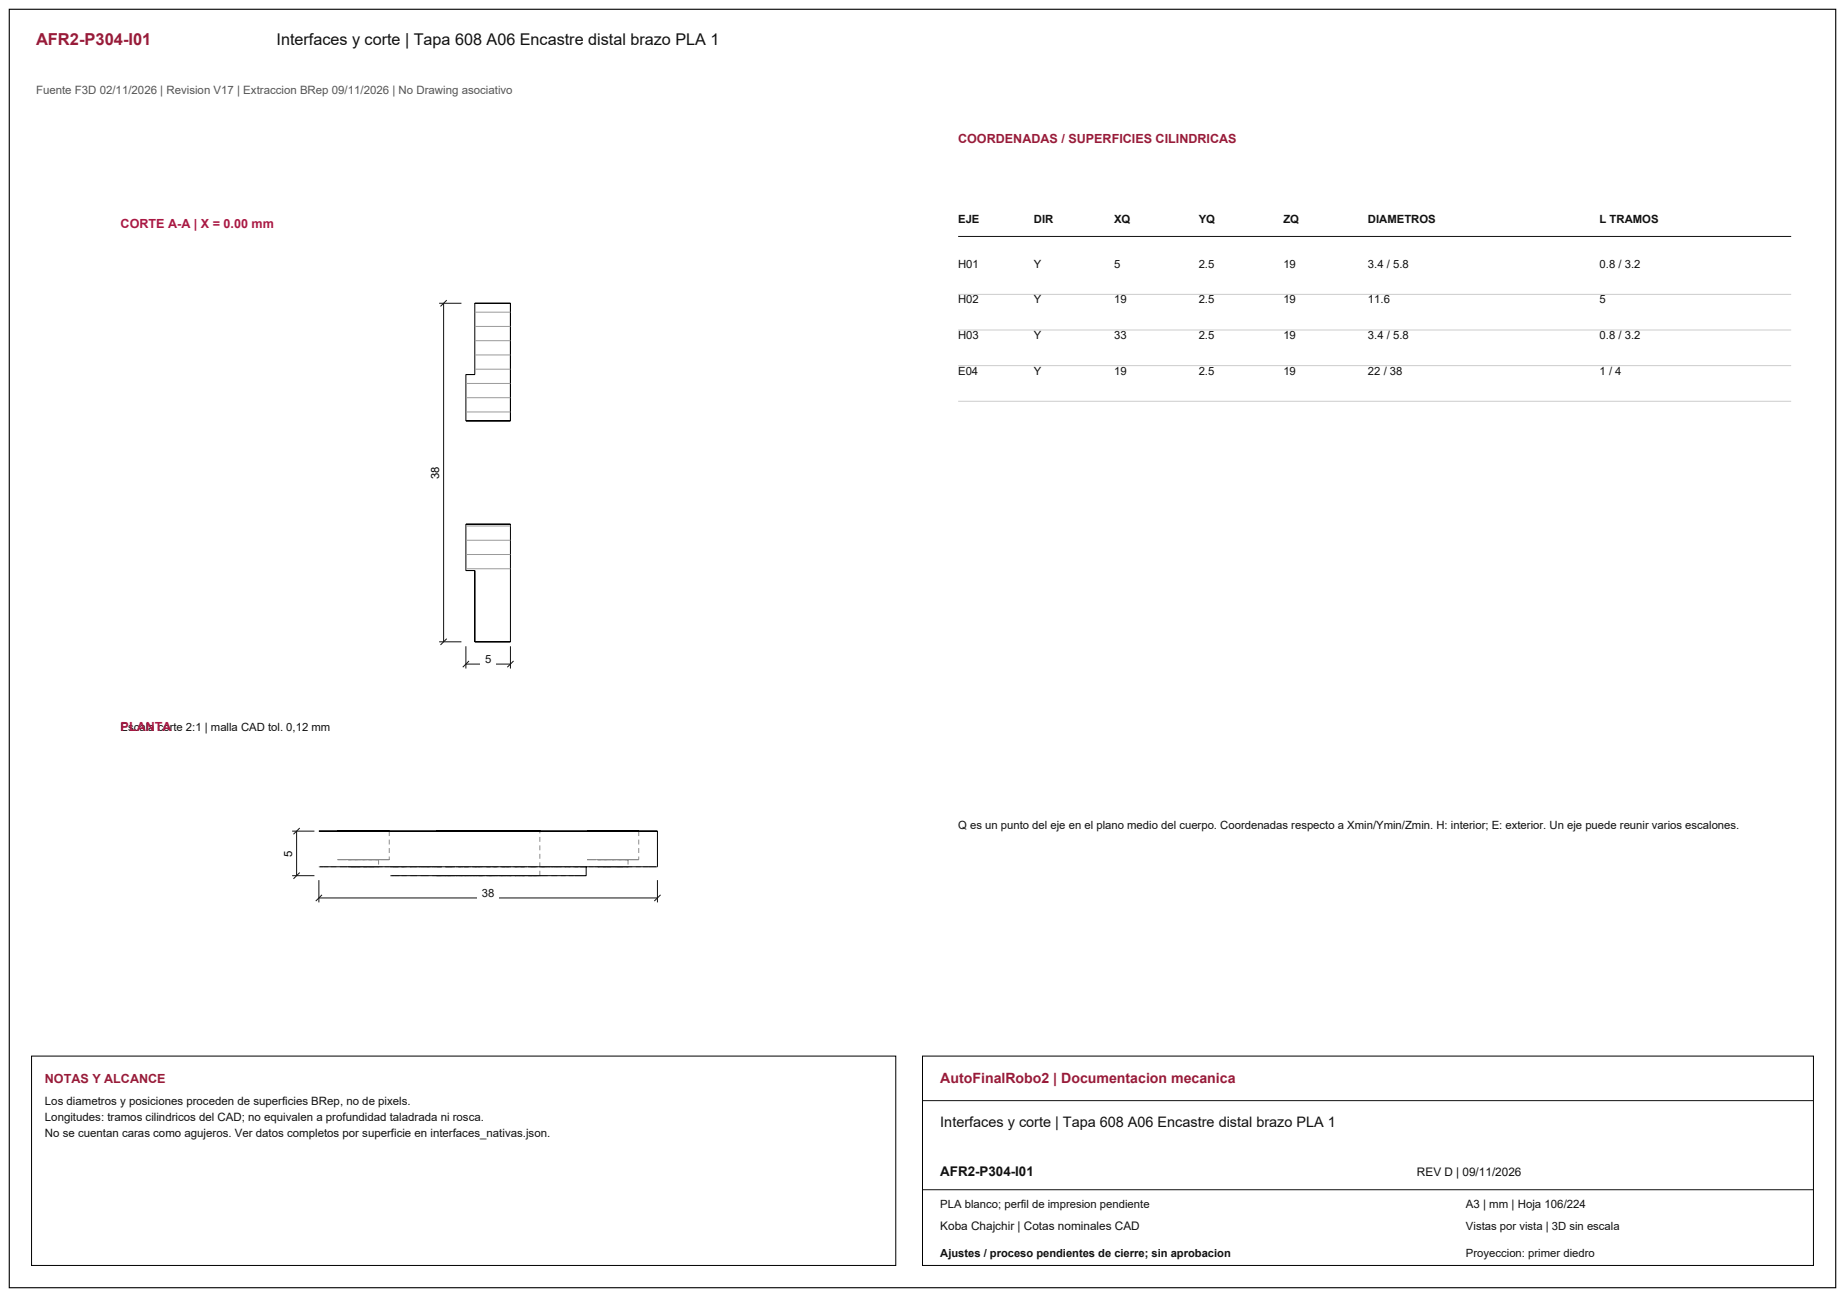
[picture p322: page 25]
CORTE A-A | X = 0.00 mm; EJE; DIR; DIAMETROS; L TRAMOS; NOTAS Y ALCANCE; AutoFinalRobo2 | Documentacion mecanica; AFR2-P304-I01; REV D | 09/11/2026

COORDENADAS / SUPERFICIES CILINDRICAS

Escala corte 2:1 | malla CAD tol. 0,12 mm PLANTA

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

Interfaces y corte | Tapa 608 A06 Encastre distal brazo PLA 1

PLA blanco; perfil de impresion pendiente

Vistas por vista | 3D sin escala

AFR2-P305 | Separador 8mm trasero

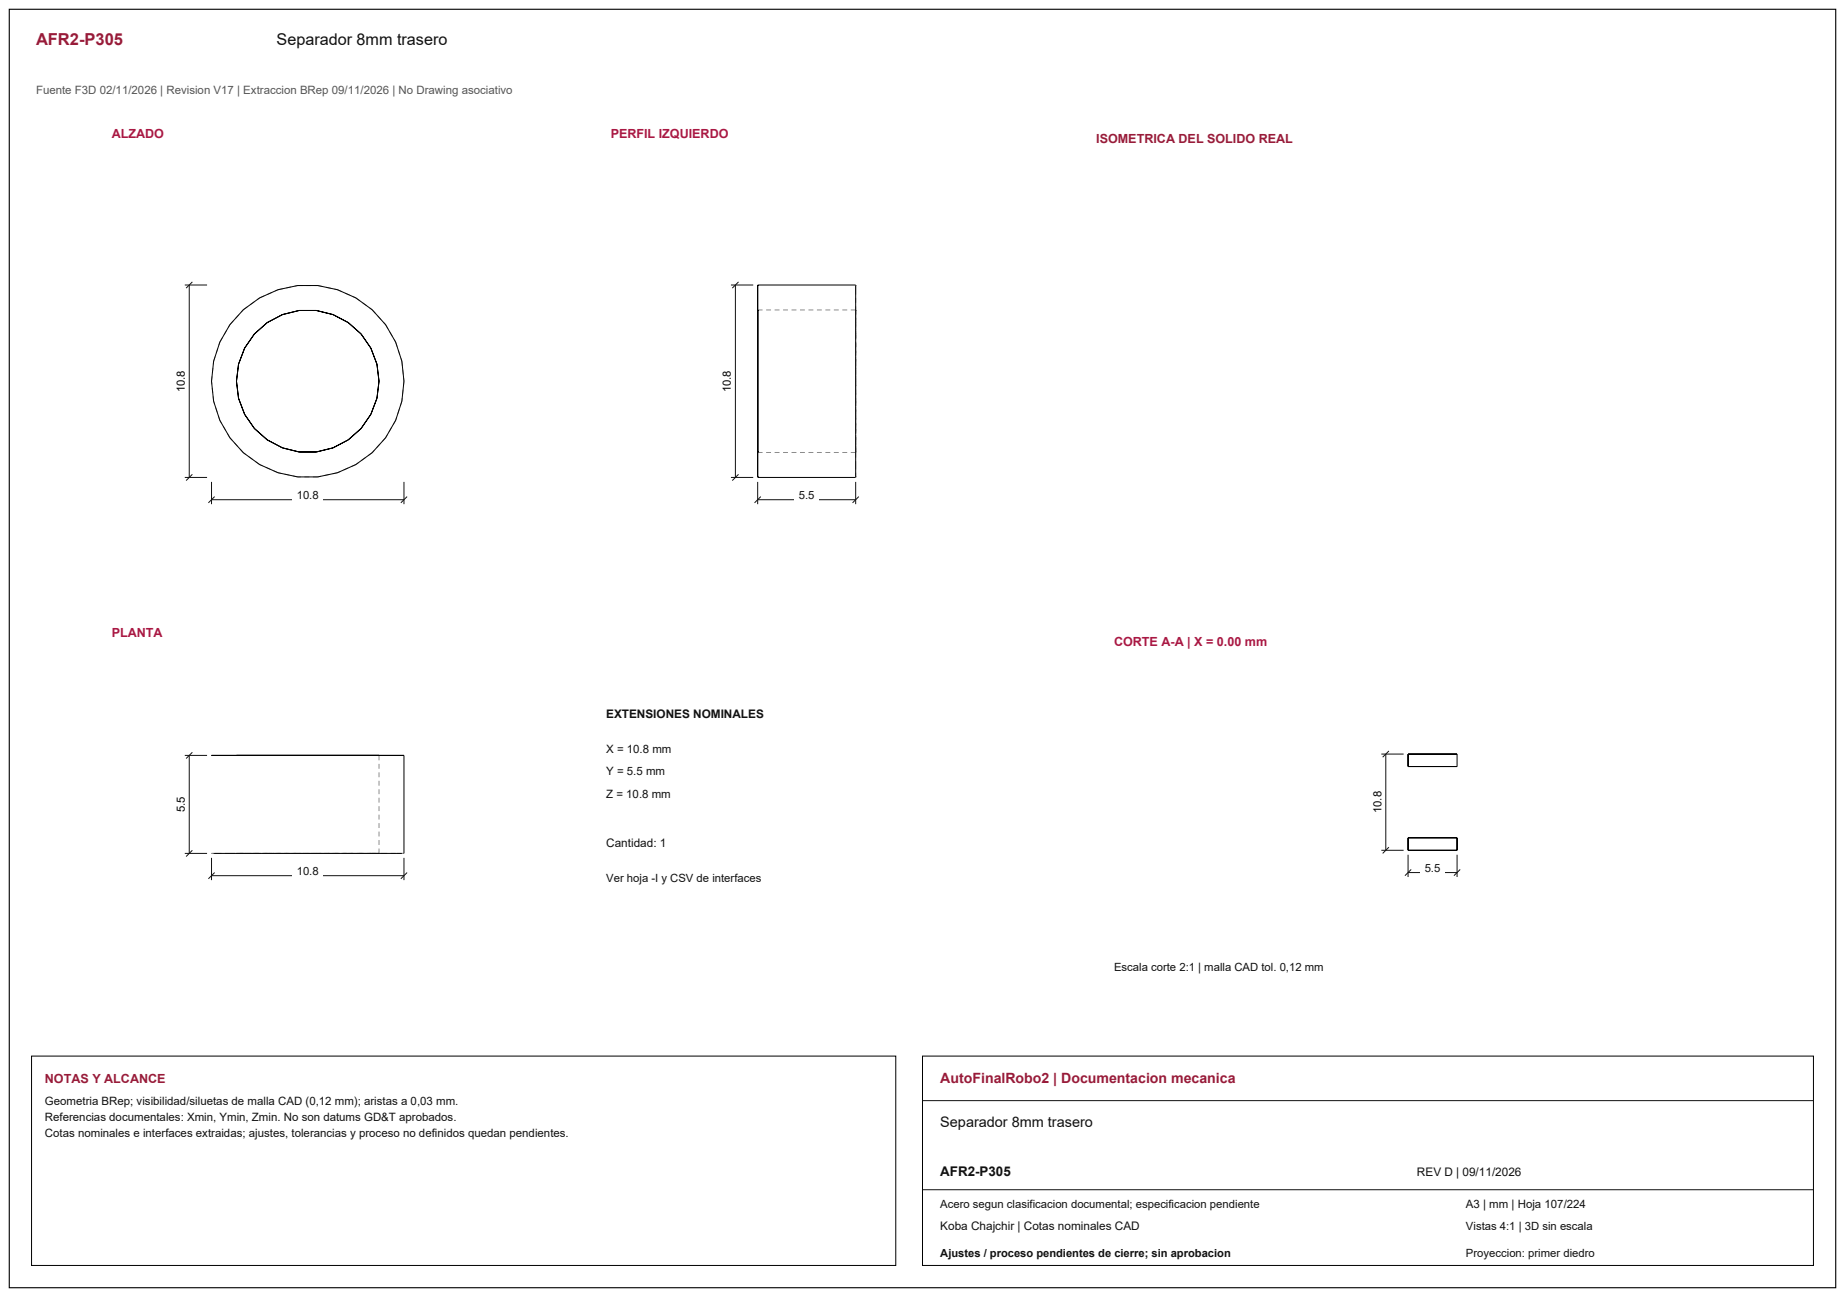
[picture p323: page 26]
ALZADO; PERFIL IZQUIERDO; PLANTA; CORTE A-A | X = 0.00 mm; EXTENSIONES NOMINALES; Cantidad: 1; NOTAS Y ALCANCE; AutoFinalRobo2 | Documentacion mecanica; Separador 8mm trasero; AFR2-P305; REV D | 09/11/2026

ISOMETRICA DEL SOLIDO REAL

Ver hoja -I y CSV de interfaces

Escala corte 2:1 | malla CAD tol. 0,12 mm

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

Acero segun clasificacion documental; especificacion pendiente

Vistas 4:1 | 3D sin escala

AFR2-P305-I01 | Interfaces y corte | Separador 8mm trasero

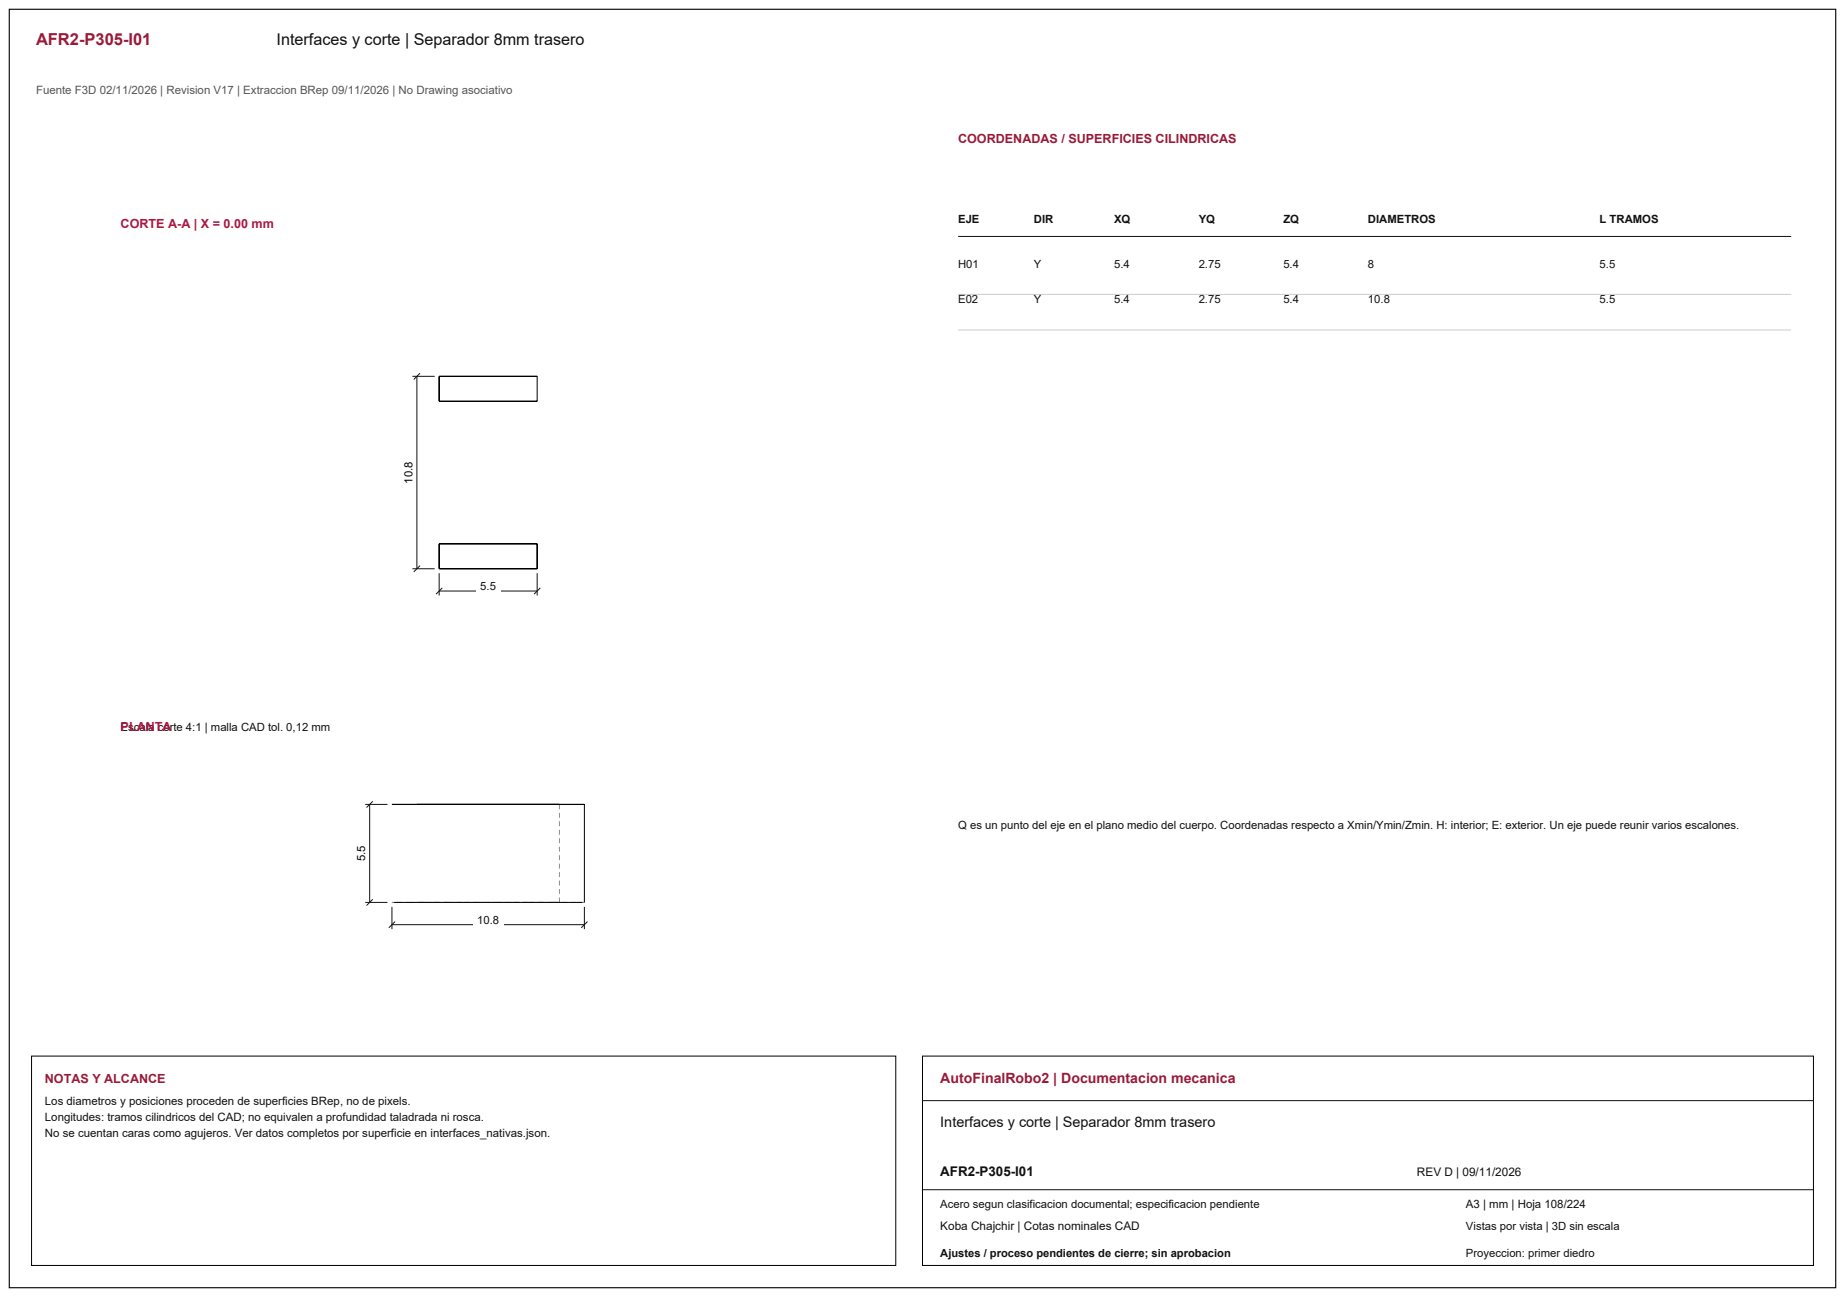
[picture p324: page 27]
CORTE A-A | X = 0.00 mm; EJE; DIR; DIAMETROS; L TRAMOS; NOTAS Y ALCANCE; AutoFinalRobo2 | Documentacion mecanica; AFR2-P305-I01; REV D | 09/11/2026

COORDENADAS / SUPERFICIES CILINDRICAS

Escala corte 4:1 | malla CAD tol. 0,12 mm PLANTA

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

Interfaces y corte | Separador 8mm trasero

Acero segun clasificacion documental; especificacion pendiente

Vistas por vista | 3D sin escala

AFR2-P306 | Placa fija tensor Al

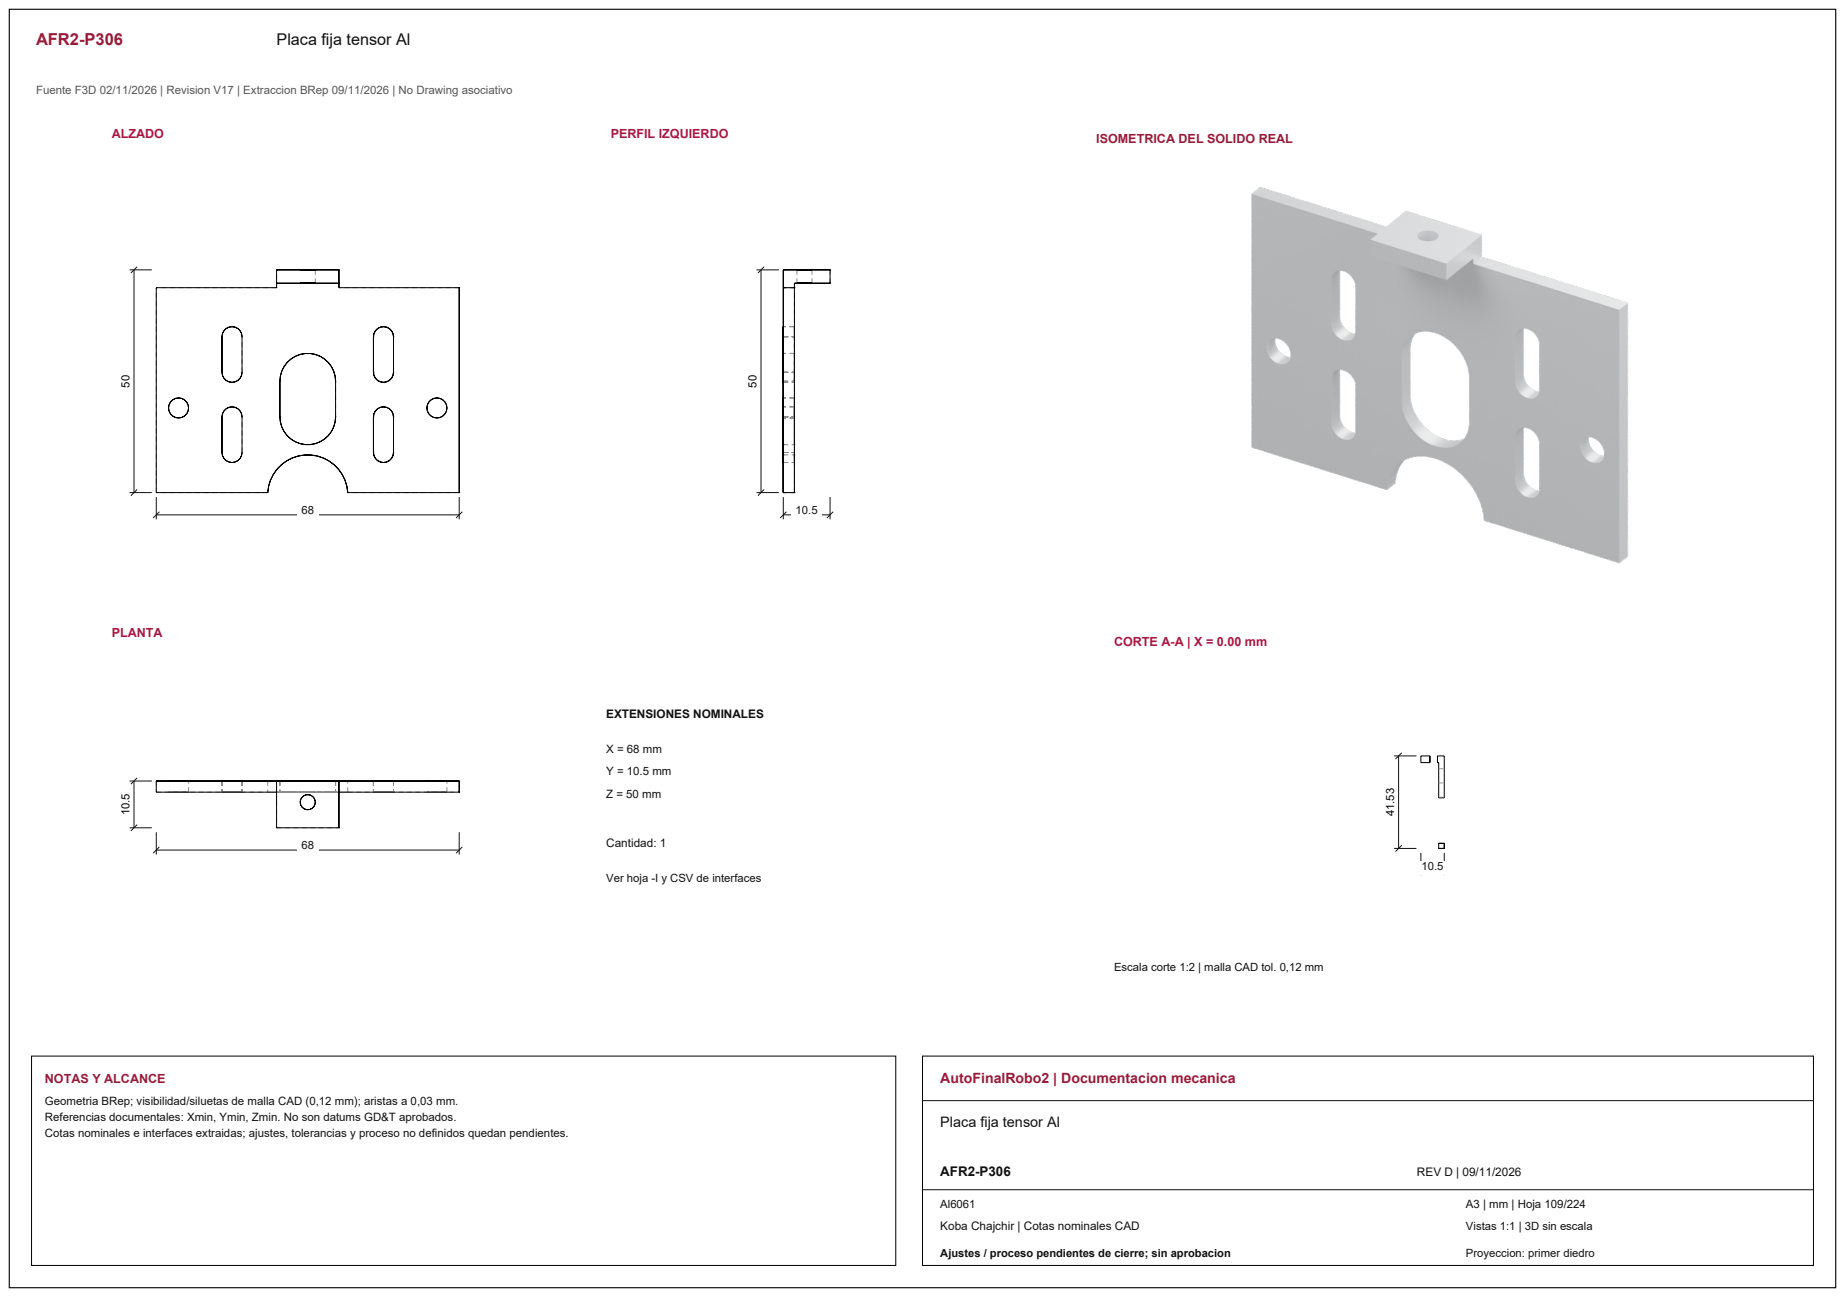
[picture p325: page 28]
ALZADO; PERFIL IZQUIERDO; PLANTA; CORTE A-A | X = 0.00 mm; EXTENSIONES NOMINALES; Cantidad: 1; NOTAS Y ALCANCE; AutoFinalRobo2 | Documentacion mecanica; AFR2-P306; REV D | 09/11/2026

ISOMETRICA DEL SOLIDO REAL

Ver hoja -I y CSV de interfaces

Escala corte 1:2 | malla CAD tol. 0,12 mm

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

Placa fija tensor Al

Vistas 1:1 | 3D sin escala

AFR2-P306-I01 | Interfaces y corte | Placa fija tensor Al

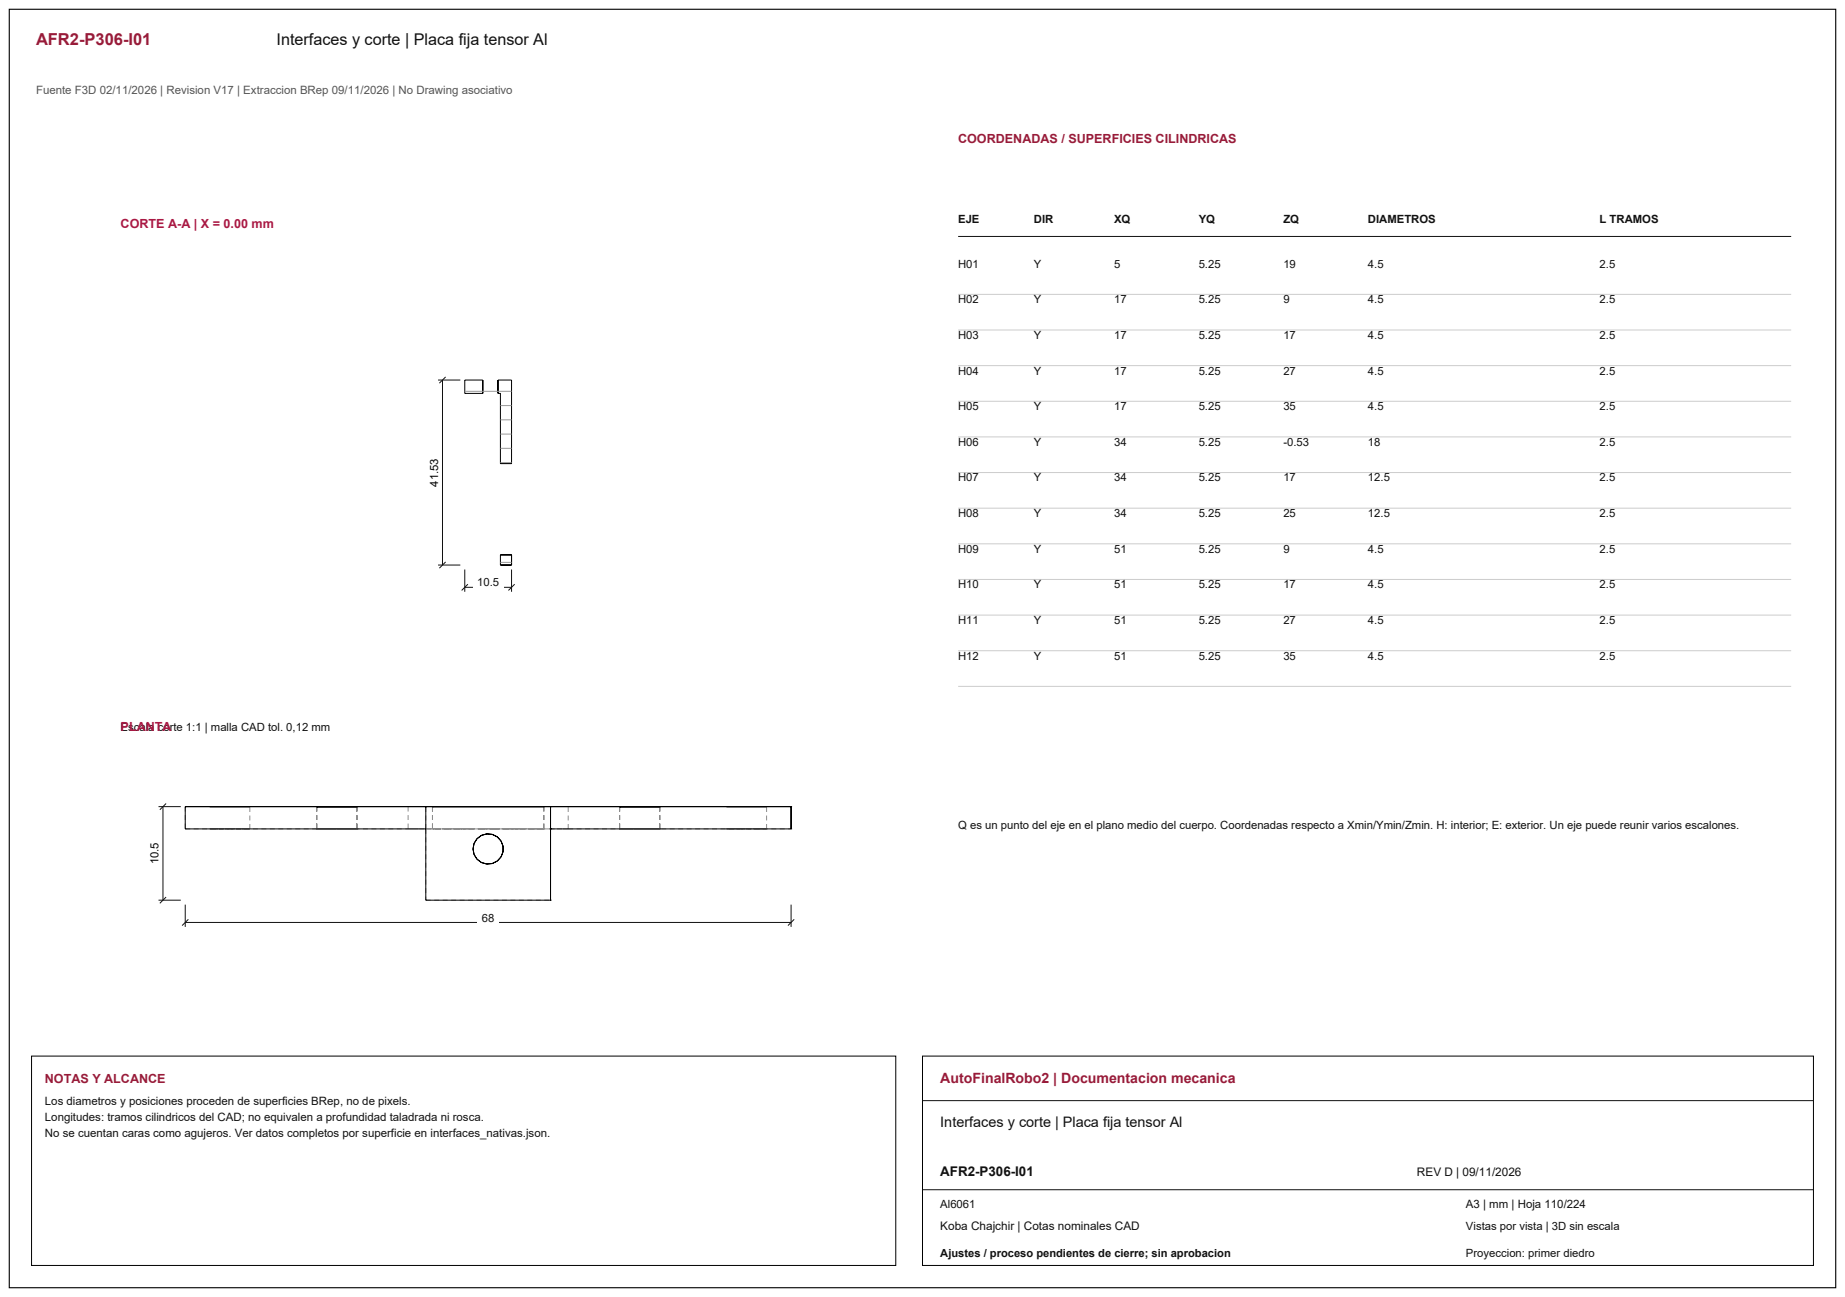
[picture p326: page 29]
CORTE A-A | X = 0.00 mm; EJE; DIR; DIAMETROS; L TRAMOS; NOTAS Y ALCANCE; AutoFinalRobo2 | Documentacion mecanica; AFR2-P306-I01; REV D | 09/11/2026

COORDENADAS / SUPERFICIES CILINDRICAS

Escala corte 1:1 | malla CAD tol. 0,12 mm PLANTA

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

Interfaces y corte | Placa fija tensor Al

Vistas por vista | 3D sin escala

AFR2-P306-I02 | Interfaces y corte | Placa fija tensor Al

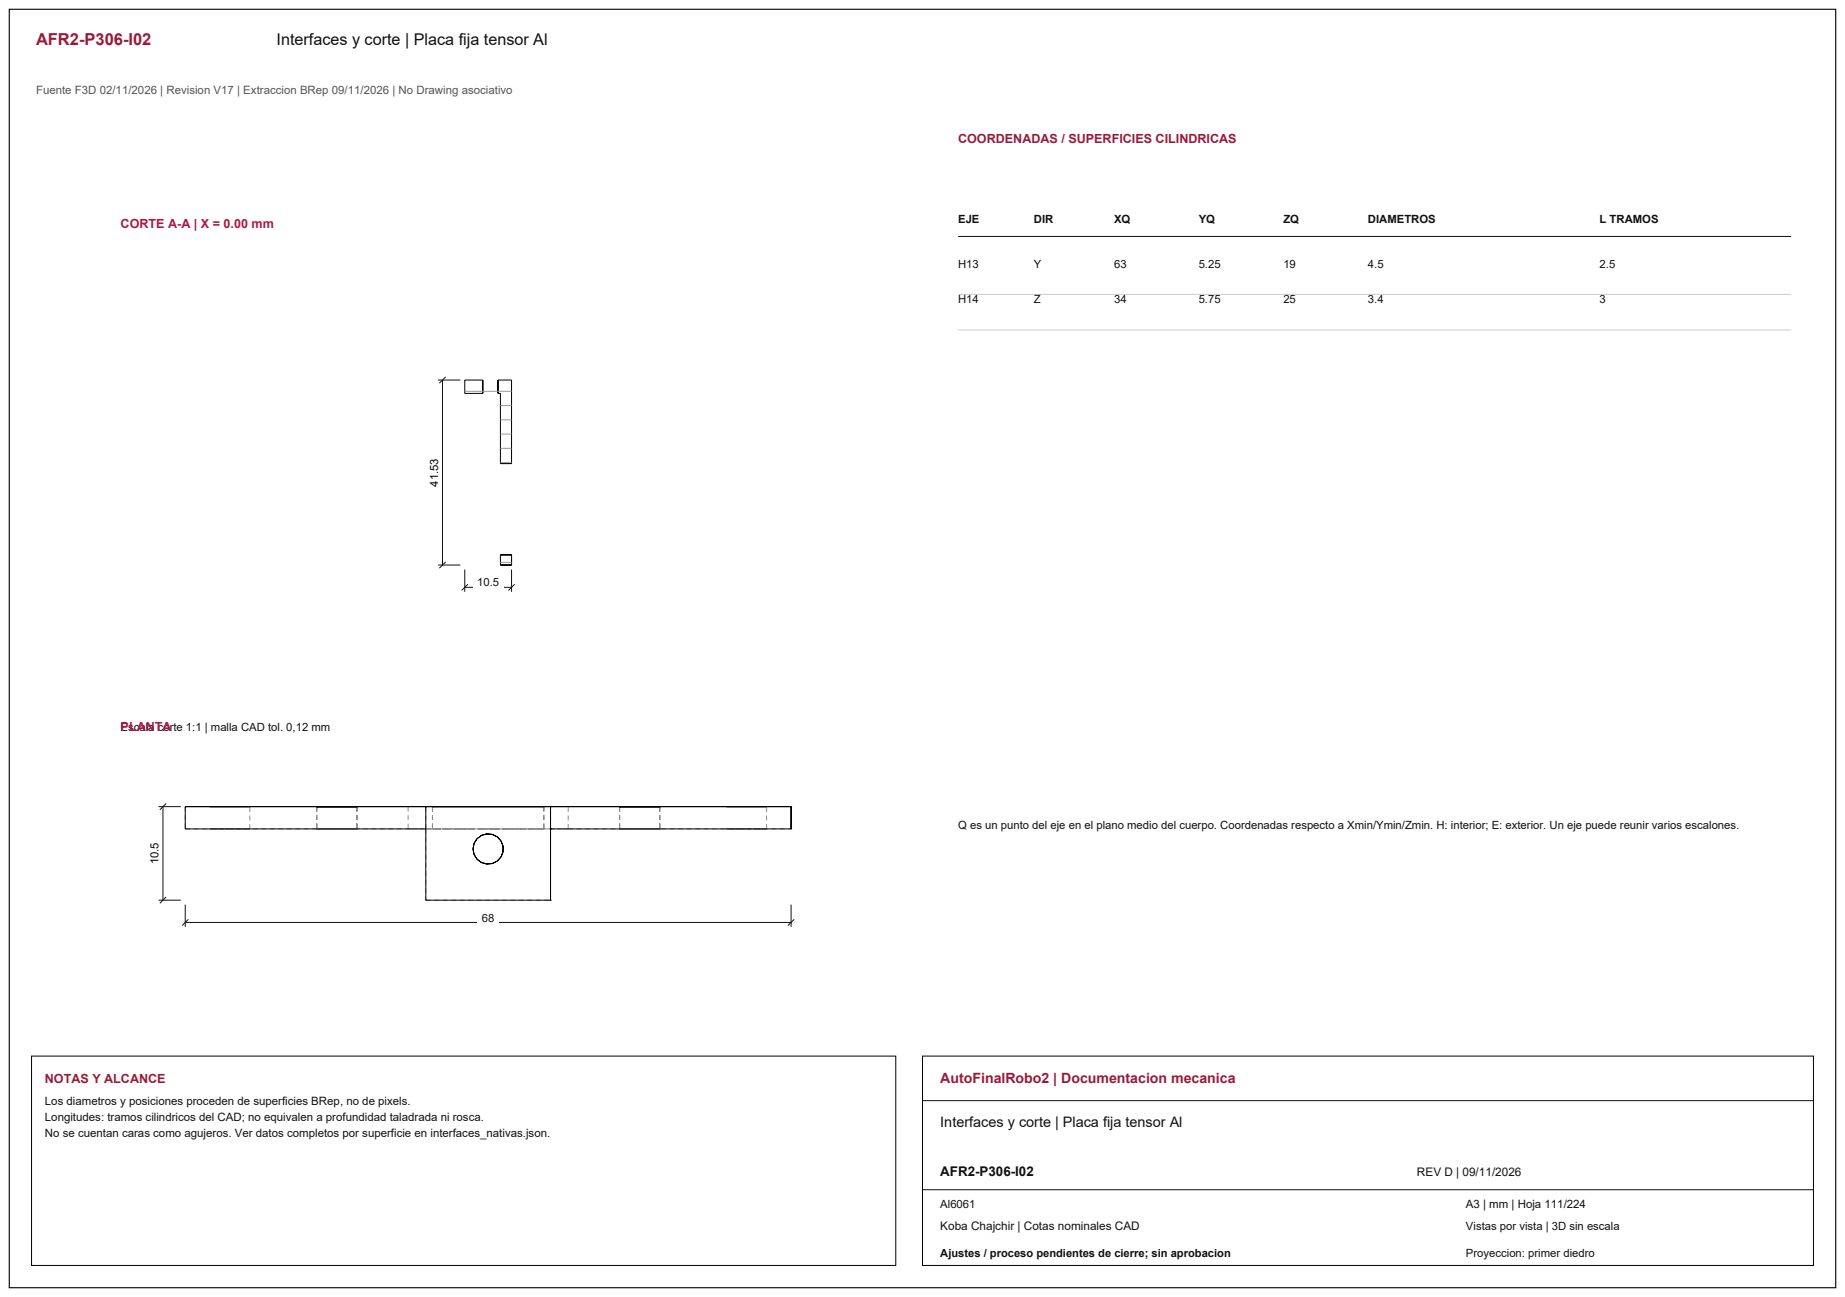
[picture p327: page 30]
CORTE A-A | X = 0.00 mm; EJE; DIR; DIAMETROS; L TRAMOS; NOTAS Y ALCANCE; AutoFinalRobo2 | Documentacion mecanica; AFR2-P306-I02; REV D | 09/11/2026

COORDENADAS / SUPERFICIES CILINDRICAS

Escala corte 1:1 | malla CAD tol. 0,12 mm PLANTA

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

Interfaces y corte | Placa fija tensor Al

Vistas por vista | 3D sin escala

AFR2-P333 | A05 Encastre proximal brazo PLA

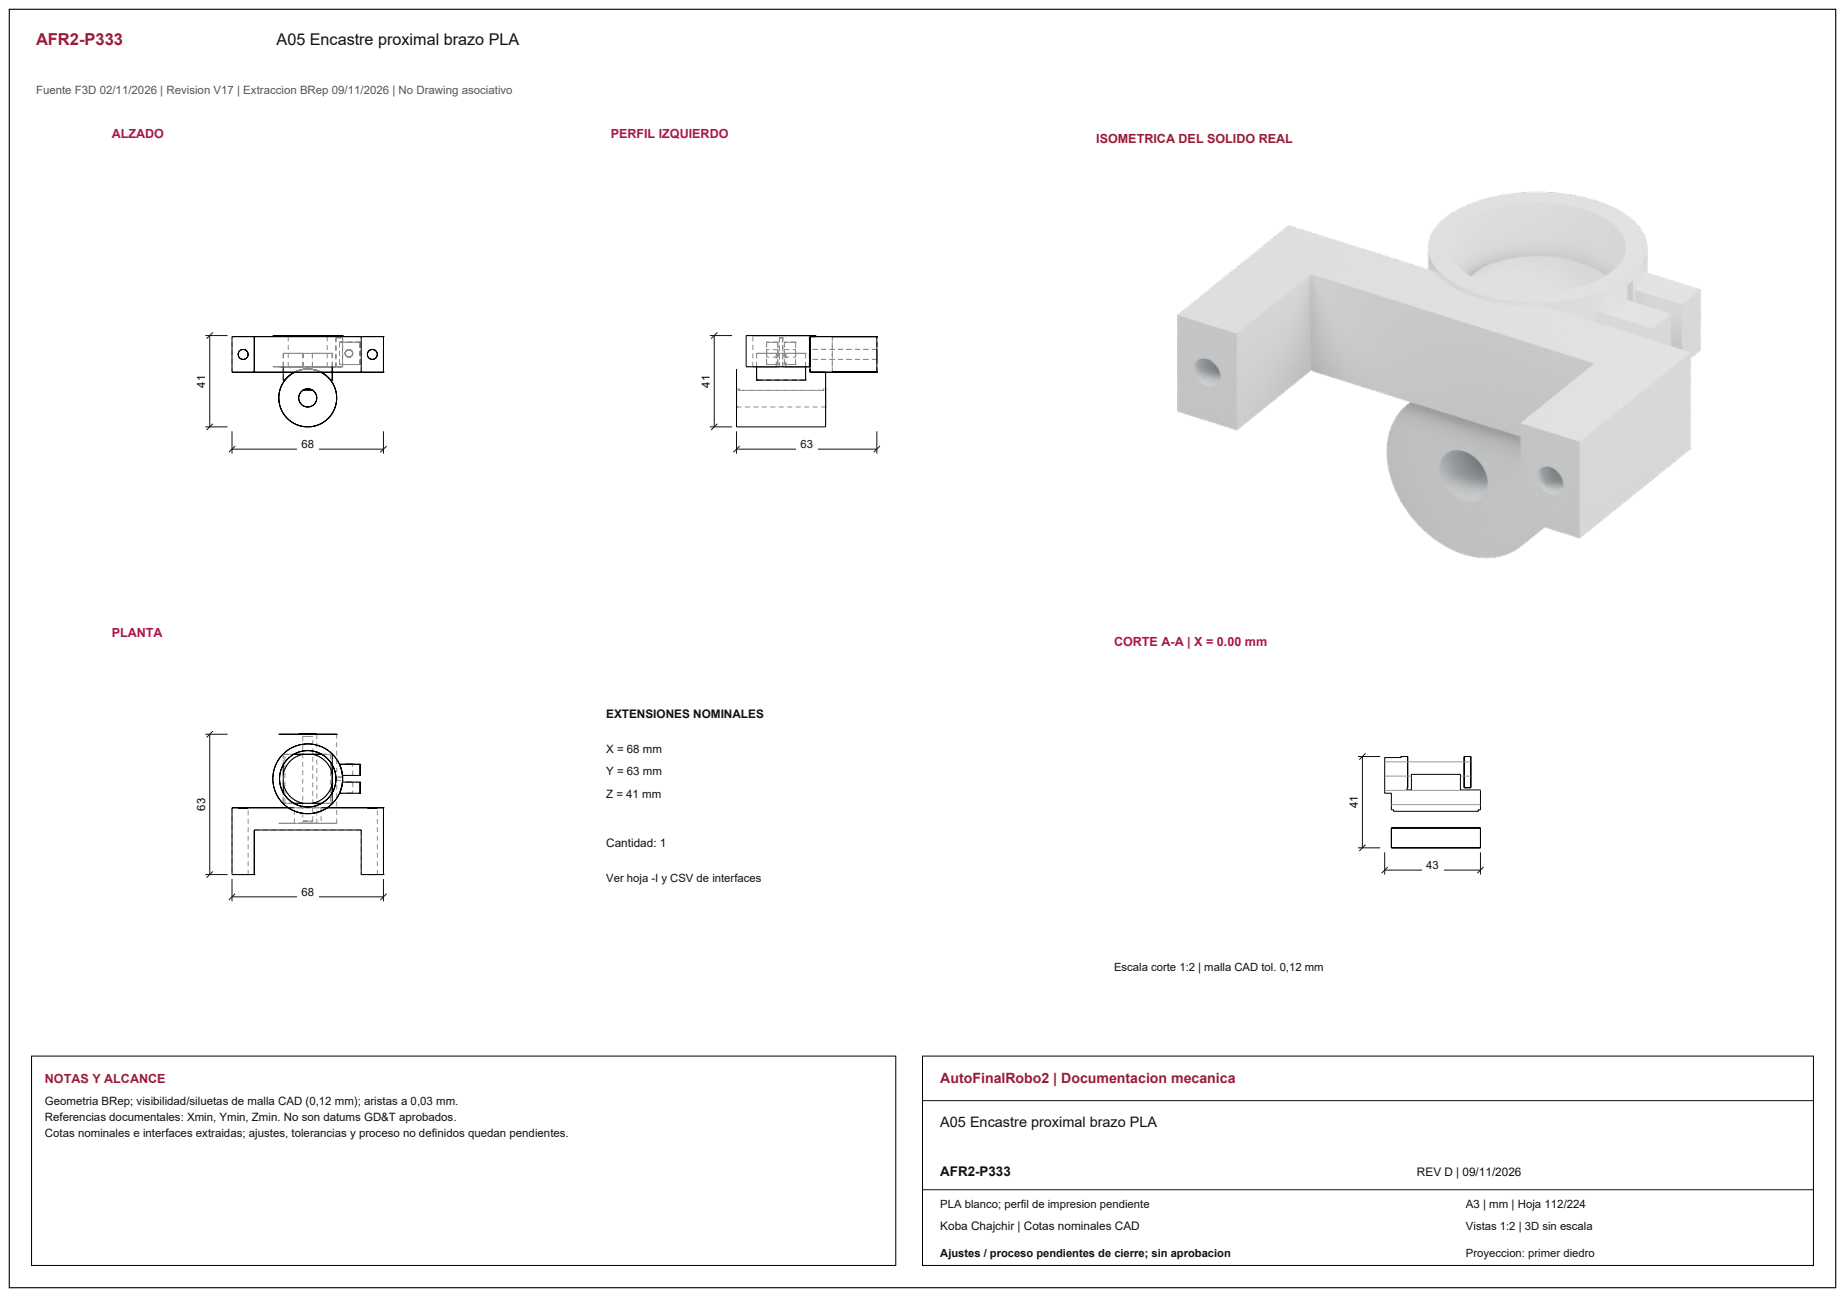
[picture p328: page 31]
ALZADO; PERFIL IZQUIERDO; PLANTA; CORTE A-A | X = 0.00 mm; EXTENSIONES NOMINALES; Cantidad: 1; NOTAS Y ALCANCE; AutoFinalRobo2 | Documentacion mecanica; AFR2-P333; REV D | 09/11/2026

ISOMETRICA DEL SOLIDO REAL

Ver hoja -I y CSV de interfaces

Escala corte 1:2 | malla CAD tol. 0,12 mm
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
