kobachajchir/ProyectoRobotica2/Revision/R01_20261110/02_Planos/tomos/AFR2_Tomo_4_Antebrazo_y_J4_A3.pdf

AFR2-A400 | Antebrazo y muneca J4/J5
Fuente F3D 02/11/2026 | Revision V17 | Extraccion BRep 09/11/2026 | No Drawing asociativo

NOTAS Y ALCANCE

Conjunto armado desde la captura nativa, con sus orientaciones y ubicaciones guardadas. Lista de ocurrencias en hojas -LP y despieces por tramos -E.
No se modifica la geometria ni se afirma secuencia de montaje/desmontaje comprobada.

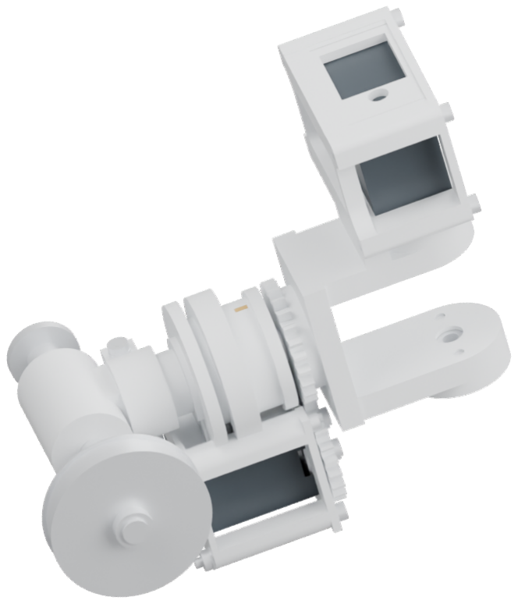
[picture p329: figure]

### AutoFinalRobo2 | Documentacion mecanica

### Antebrazo y muneca J4/J5

AFR2-A400 | REV D | 09/11/2026
Conjunto mixto Koba Chajchir | Cotas nominales CAD Ajustes / proceso pendientes de cierre; sin aprobacion | A3 | mm | Hoja 48/224
| Vistas -- | 3D sin escala
| Proyeccion: primer diedro

AFR2-A400-LP01 | Lista de ocurrencias | Antebrazo y muneca J4/J5
001 AFR2-P430 | A11 Encastre proximal antebrazo PETG
002 COMERCIAL/REFERENCIA | A11 Encastre proximal antebrazo PETG Perno M3 REF
003 AFR2-P422 | A12 Encastre distal antebrazo PETG
004 COMERCIAL/REFERENCIA | A12 Encastre distal antebrazo PETG Perno M3 REF
005 AFR2-P421 | L02 PVC32 Corte 2
006 AFR2-P423 | V02 E02 Eje y brida codo
007 COMERCIAL/REFERENCIA | V02 R04 608 J4
008 COMERCIAL/REFERENCIA | V03 Arandelas y tuerca A11 Encastre proximal antebrazo PETG
009 COMERCIAL/REFERENCIA | V03 Arandelas y tuerca A12 Encastre distal antebrazo PETG
010 COMERCIAL/REFERENCIA | V03 Inserto M3 J4 -1
011 COMERCIAL/REFERENCIA | V03 Inserto M3 J4 1
012 COMERCIAL/REFERENCIA | V03 R04 608 J4 inferior
013 AFR2-P425 | V03 Separador 8mm delantero (1)
014 AFR2-P424 | V03 Tapa 608 J4
015 COMERCIAL/REFERENCIA | V03 Tornillo tapa J4 -1
016 COMERCIAL/REFERENCIA | V03 Tornillo tapa J4 1
017 COMERCIAL/REFERENCIA | V17 Arandela M3 J4 0
018 COMERCIAL/REFERENCIA | V17 Arandela M3 J4 0

NOTAS Y ALCANCE

Cada posicion identifica una ocurrencia; los solidos de un mismo comercial se mantienen agrupados. Las placas con hijos Nano/PCA9685/XL4016 se agrupan como unidades comerciales.
Codigo COMERCIAL/REFERENCIA no implica plano de fabricacion propio. Rutas completas en CSV.

### AutoFinalRobo2 | Documentacion mecanica

### Lista de ocurrencias | Antebrazo y muneca J4/J5

AFR2-A400-LP01 | REV D | 09/11/2026

Conjunto mixto

| Vistas -- | 3D sin escala

AFR2-A400-LP02 | Lista de ocurrencias | Antebrazo y muneca J4/J5
019 COMERCIAL/REFERENCIA | V17 Arandela M3 J4 0
020 COMERCIAL/REFERENCIA | V17 Arandela M3 J4 0
021 COMERCIAL/REFERENCIA | V17 Chaveta 2x2x15
022 COMERCIAL/REFERENCIA | V17 Collar retencion codo
023 COMERCIAL/REFERENCIA | V17 M03 STS3250 remoto
024 COMERCIAL/REFERENCIA | V17 M3x45 tapa J4 0
025 COMERCIAL/REFERENCIA | V17 M3x45 tapa J4 0
026 COMERCIAL/REFERENCIA | V17 M3x45 tapa J4 0
027 COMERCIAL/REFERENCIA | V17 M3x45 tapa J4 0
028 COMERCIAL/REFERENCIA | V17 Polea 50T J3
029 COMERCIAL/REFERENCIA | V17 Prisionero collar codo
030 AFR2-P427 | V17 Separador codo trasero
031 AFR2-P431 | V17 Tapa STS3250 J4
032 COMERCIAL/REFERENCIA | V17 Tuerca M3 J4 0
033 COMERCIAL/REFERENCIA | V17 Tuerca M3 J4 0
034 COMERCIAL/REFERENCIA | V17 Tuerca M3 J4 0
035 COMERCIAL/REFERENCIA | V17 Tuerca M3 J4 0
036 AFR2-P435 | V02 A15 Horquilla J5 PETG

NOTAS Y ALCANCE

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

### AutoFinalRobo2 | Documentacion mecanica

### Lista de ocurrencias | Antebrazo y muneca J4/J5

AFR2-A400-LP02 | REV D | 09/11/2026

Conjunto mixto

| Vistas -- | 3D sin escala

AFR2-A400-LP03 | Lista de ocurrencias | Antebrazo y muneca J4/J5
037 AFR2-P436 | V02 E03 Eje J4
038 COMERCIAL/REFERENCIA | V02 R05 625 -1
039 COMERCIAL/REFERENCIA | V02 R05 625 1
040 COMERCIAL/REFERENCIA | V03 E03 Retencion superior J4
041 COMERCIAL/REFERENCIA | V03 Inserto M3 V02 A15 Horquilla J5 PETG-1-1
042 COMERCIAL/REFERENCIA | V03 Inserto M3 V02 A15 Horquilla J5 PETG-11
043 COMERCIAL/REFERENCIA | V03 Inserto M3 V02 A15 Horquilla J5 PETG1-1
044 COMERCIAL/REFERENCIA | V03 Inserto M3 V02 A15 Horquilla J5 PETG11
045 AFR2-P439 | V03 Separador axial J4
046 AFR2-P437 | V03 Tapa 625 V02 A15 Horquilla J5 PETG -1
047 AFR2-P438 | V03 Tapa 625 V02 A15 Horquilla J5 PETG 1
048 COMERCIAL/REFERENCIA | V03 Tornillo axial J4
049 COMERCIAL/REFERENCIA | V03 Tornillo tapa V02 A15 Horquilla J5 PETG-1-1
050 COMERCIAL/REFERENCIA | V03 Tornillo tapa V02 A15 Horquilla J5 PETG-11
051 COMERCIAL/REFERENCIA | V03 Tornillo tapa V02 A15 Horquilla J5 PETG1-1
052 COMERCIAL/REFERENCIA | V03 Tornillo tapa V02 A15 Horquilla J5 PETG11
053 COMERCIAL/REFERENCIA | V17 Arandela M3 J5 0
054 COMERCIAL/REFERENCIA | V17 Arandela M3 J5 1

NOTAS Y ALCANCE

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

### AutoFinalRobo2 | Documentacion mecanica

### Lista de ocurrencias | Antebrazo y muneca J4/J5

AFR2-A400-LP03 | REV D | 09/11/2026

Conjunto mixto

| Vistas -- | 3D sin escala

AFR2-A400-LP04 | Lista de ocurrencias | Antebrazo y muneca J4/J5
055 COMERCIAL/REFERENCIA | V17 Arandela M3 J5 2
056 COMERCIAL/REFERENCIA | V17 Arandela M3 J5 3
057 COMERCIAL/REFERENCIA | V17 M03 STS3250 remoto
058 COMERCIAL/REFERENCIA | V17 M3x35 tapa J5 0
059 COMERCIAL/REFERENCIA | V17 M3x35 tapa J5 1
060 COMERCIAL/REFERENCIA | V17 M3x35 tapa J5 2
061 COMERCIAL/REFERENCIA | V17 M3x35 tapa J5 3
062 AFR2-P440 | V17 Tapa STS3250 J5
063 COMERCIAL/REFERENCIA | V17 Tuerca M3 J5 0
064 COMERCIAL/REFERENCIA | V17 Tuerca M3 J5 1
065 COMERCIAL/REFERENCIA | V17 Tuerca M3 J5 2
066 COMERCIAL/REFERENCIA | V17 Tuerca M3 J5 3
067 AFR2-P453 | V02 Pinon24 J4
068 AFR2-P340 | V17 Horn STS3250 J3
069 COMERCIAL/REFERENCIA | V17 M3x6 central J4
070 COMERCIAL/REFERENCIA | V17 M3x8 horn J4 0
071 COMERCIAL/REFERENCIA | V17 M3x8 horn J4 0
072 COMERCIAL/REFERENCIA | V17 M3x8 horn J4 0

NOTAS Y ALCANCE

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

### AutoFinalRobo2 | Documentacion mecanica

### Lista de ocurrencias | Antebrazo y muneca J4/J5

AFR2-A400-LP04 | REV D | 09/11/2026

Conjunto mixto

| Vistas -- | 3D sin escala

AFR2-A400-LP05 | Lista de ocurrencias | Antebrazo y muneca J4/J5
073 COMERCIAL/REFERENCIA | V17 M3x8 horn J4 0
074 AFR2-P454 | V17 Separador horn J4

NOTAS Y ALCANCE

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

### AutoFinalRobo2 | Documentacion mecanica

### Lista de ocurrencias | Antebrazo y muneca J4/J5

AFR2-A400-LP05 | REV D | 09/11/2026

Conjunto mixto

| Vistas -- | 3D sin escala

AFR2-A400-E1 | Despiece isometrico | Antebrazo y muneca J4/J5

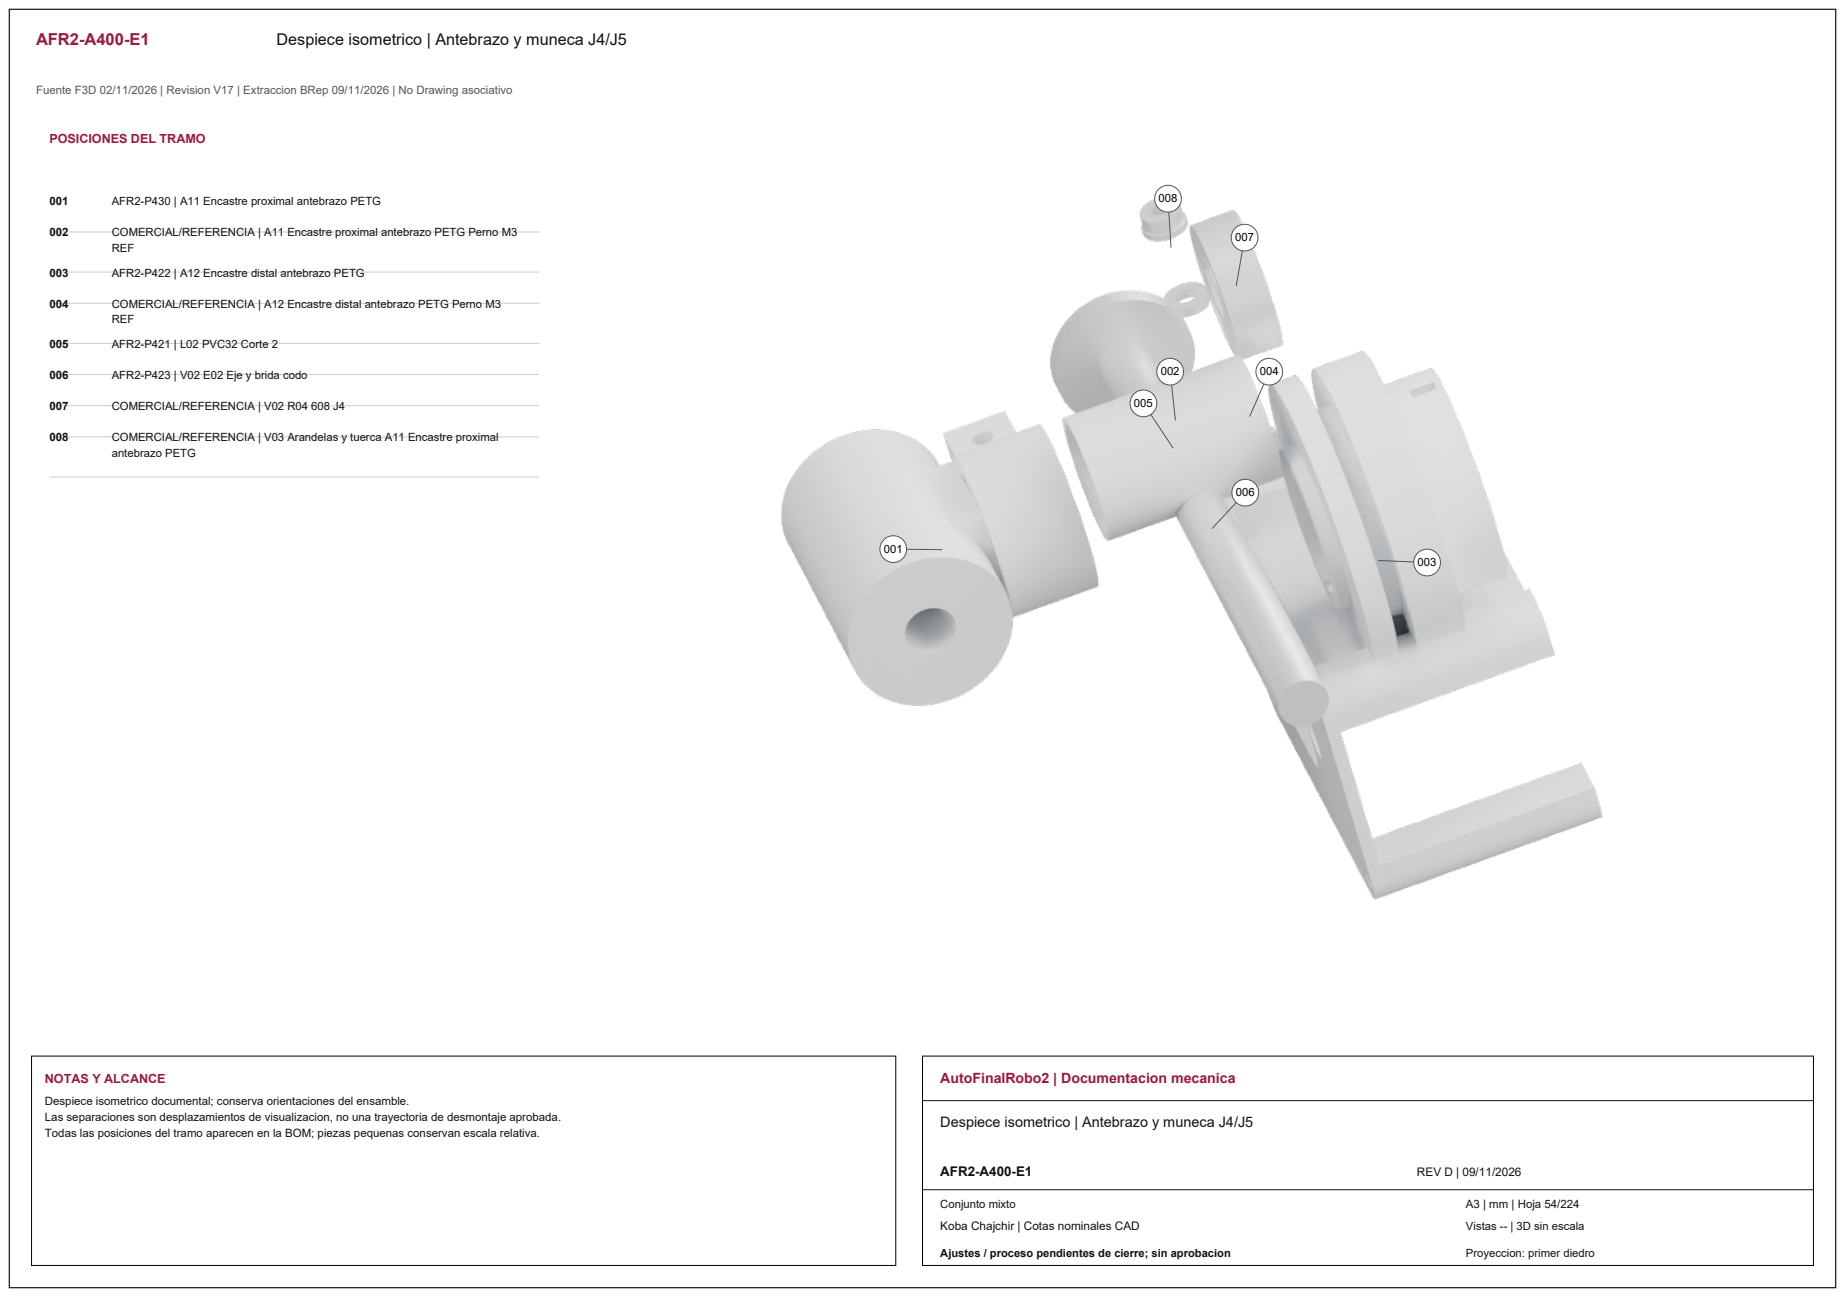
[picture p330: page 7]
REF; 005 AFR2-P421 | L02 PVC32 Corte 2; 007 COMERCIAL/REFERENCIA | V02 R04 608 J4; antebrazo PETG; NOTAS Y ALCANCE; AutoFinalRobo2 | Documentacion mecanica; AFR2-A400-E1; REV D | 09/11/2026; Conjunto mixto

POSICIONES DEL TRAMO

001 AFR2-P430 | A11 Encastre proximal antebrazo PETG

002 COMERCIAL/REFERENCIA | A11 Encastre proximal antebrazo PETG Perno M3

003 AFR2-P422 | A12 Encastre distal antebrazo PETG

004 COMERCIAL/REFERENCIA | A12 Encastre distal antebrazo PETG Perno M3

006 AFR2-P423 | V02 E02 Eje y brida codo

008 COMERCIAL/REFERENCIA | V03 Arandelas y tuerca A11 Encastre proximal

Despiece isometrico documental; conserva orientaciones del ensamble.
Las separaciones son desplazamientos de visualizacion, no una trayectoria de desmontaje aprobada.
Todas las posiciones del tramo aparecen en la BOM; piezas pequenas conservan escala relativa.

Despiece isometrico | Antebrazo y muneca J4/J5

Vistas -- | 3D sin escala

AFR2-A400-E2 | Despiece isometrico | Antebrazo y muneca J4/J5

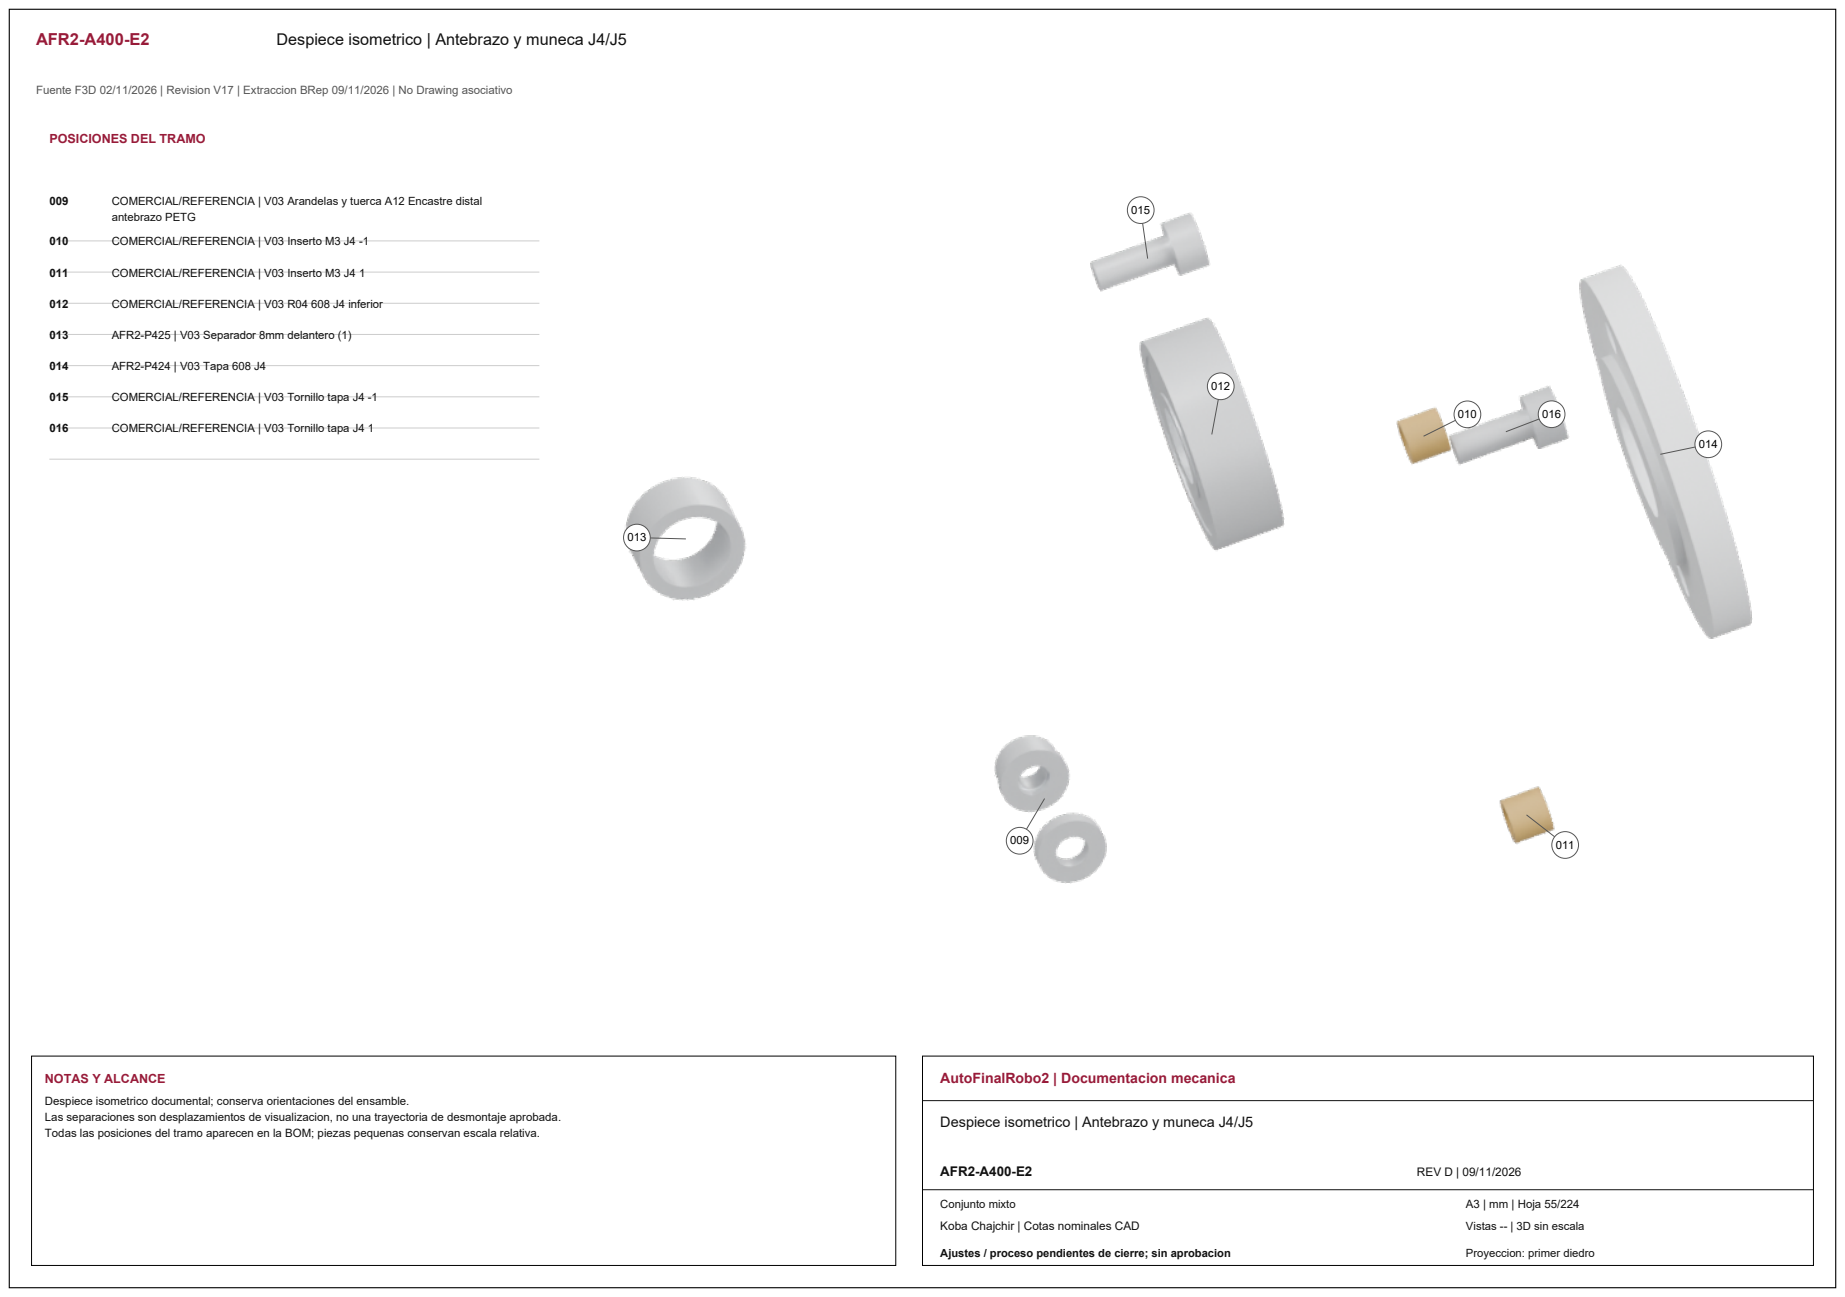
[picture p331: page 8]
antebrazo PETG; 013 AFR2-P425 | V03 Separador 8mm delantero (1); 014 AFR2-P424 | V03 Tapa 608 J4; NOTAS Y ALCANCE; AutoFinalRobo2 | Documentacion mecanica; AFR2-A400-E2; REV D | 09/11/2026; Conjunto mixto

POSICIONES DEL TRAMO

009 COMERCIAL/REFERENCIA | V03 Arandelas y tuerca A12 Encastre distal

010 COMERCIAL/REFERENCIA | V03 Inserto M3 J4 -1

011 COMERCIAL/REFERENCIA | V03 Inserto M3 J4 1

012 COMERCIAL/REFERENCIA | V03 R04 608 J4 inferior

015 COMERCIAL/REFERENCIA | V03 Tornillo tapa J4 -1

016 COMERCIAL/REFERENCIA | V03 Tornillo tapa J4 1

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

Despiece isometrico | Antebrazo y muneca J4/J5

Vistas -- | 3D sin escala

AFR2-A400-E3 | Despiece isometrico | Antebrazo y muneca J4/J5

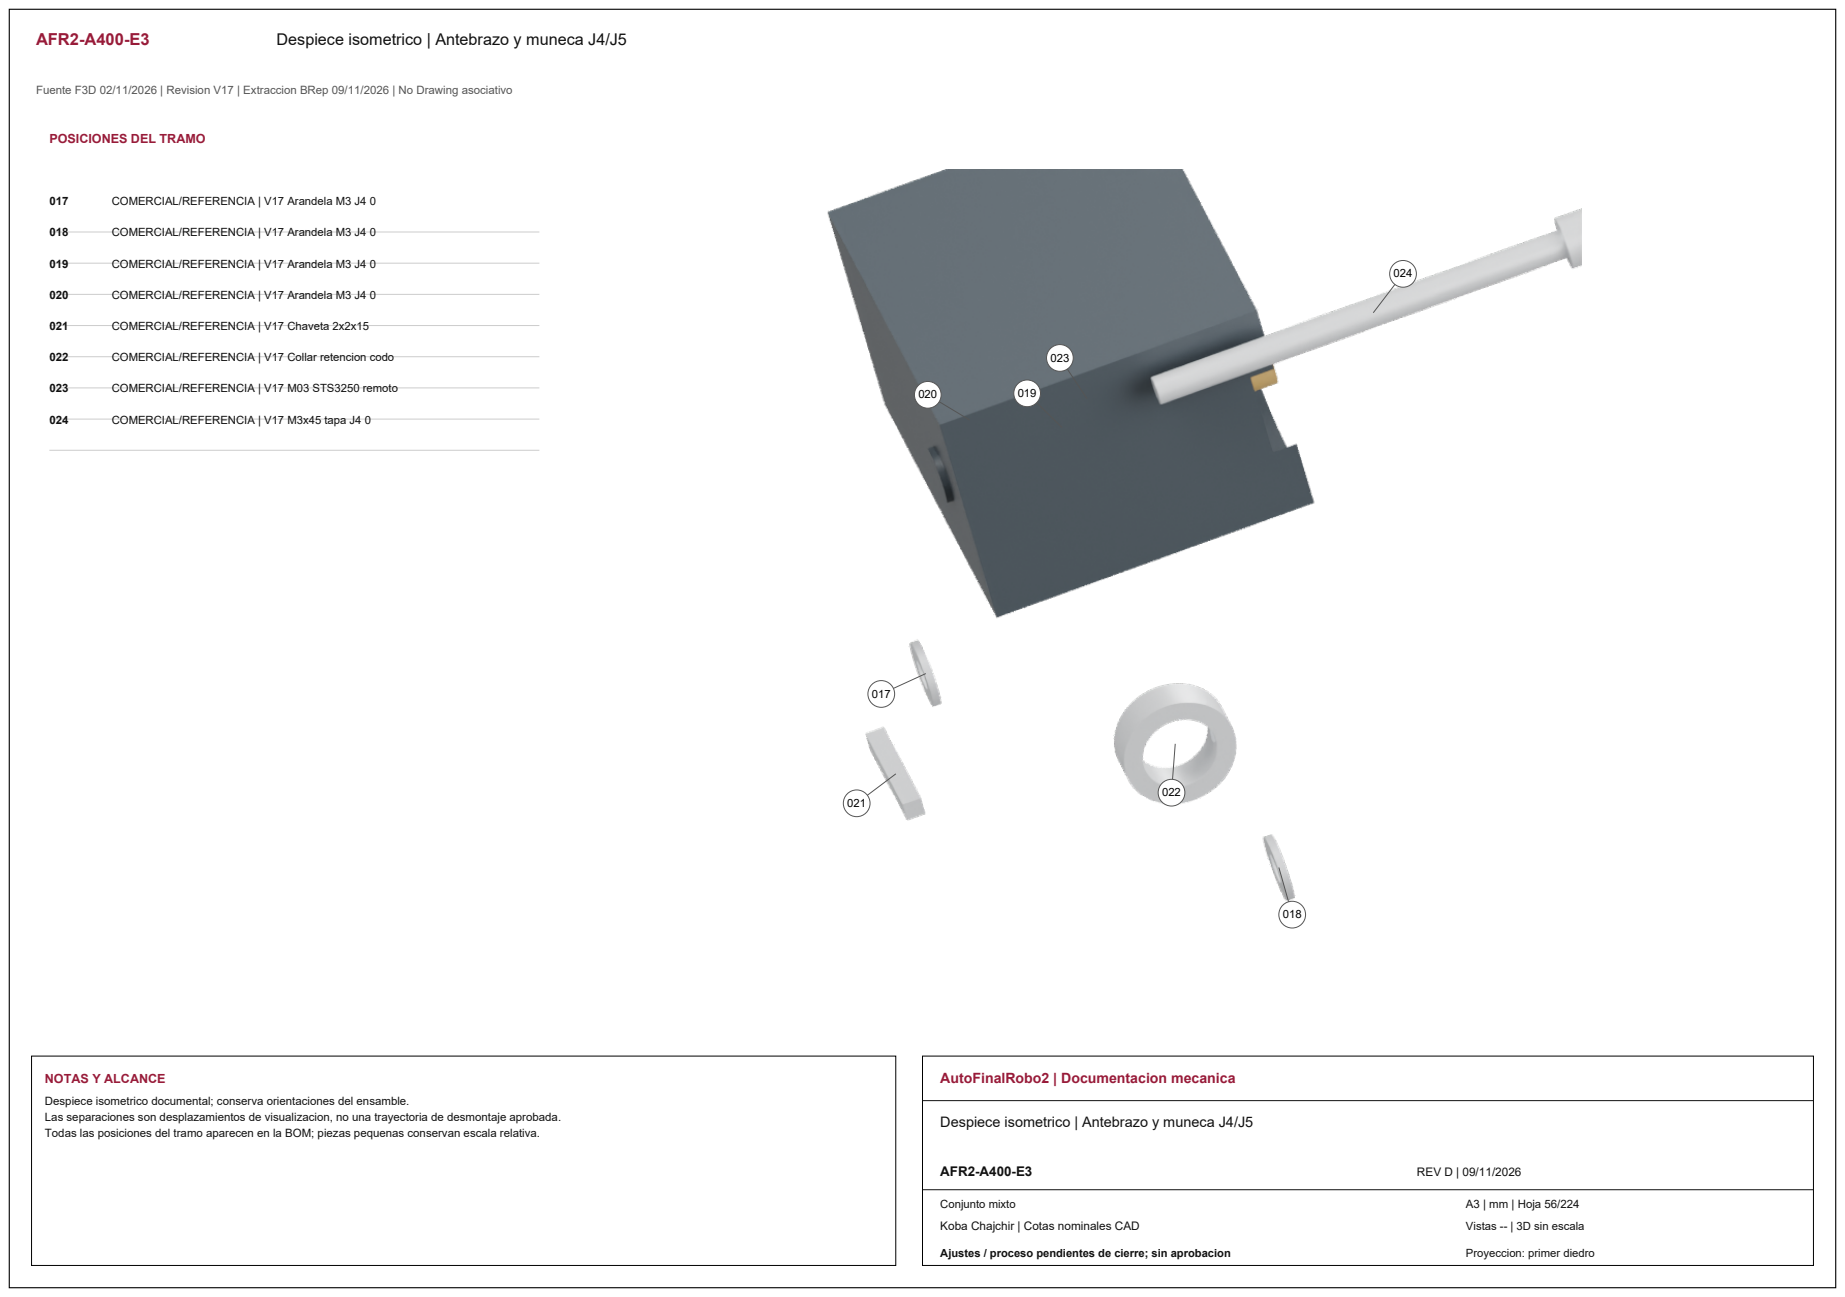
[picture p332: page 9]
NOTAS Y ALCANCE; AutoFinalRobo2 | Documentacion mecanica; AFR2-A400-E3; REV D | 09/11/2026; Conjunto mixto

POSICIONES DEL TRAMO

017 COMERCIAL/REFERENCIA | V17 Arandela M3 J4 0

018 COMERCIAL/REFERENCIA | V17 Arandela M3 J4 0

019 COMERCIAL/REFERENCIA | V17 Arandela M3 J4 0

020 COMERCIAL/REFERENCIA | V17 Arandela M3 J4 0

021 COMERCIAL/REFERENCIA | V17 Chaveta 2x2x15

022 COMERCIAL/REFERENCIA | V17 Collar retencion codo

023 COMERCIAL/REFERENCIA | V17 M03 STS3250 remoto

024 COMERCIAL/REFERENCIA | V17 M3x45 tapa J4 0

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

Despiece isometrico | Antebrazo y muneca J4/J5

Vistas -- | 3D sin escala

AFR2-A400-E4 | Despiece isometrico | Antebrazo y muneca J4/J5

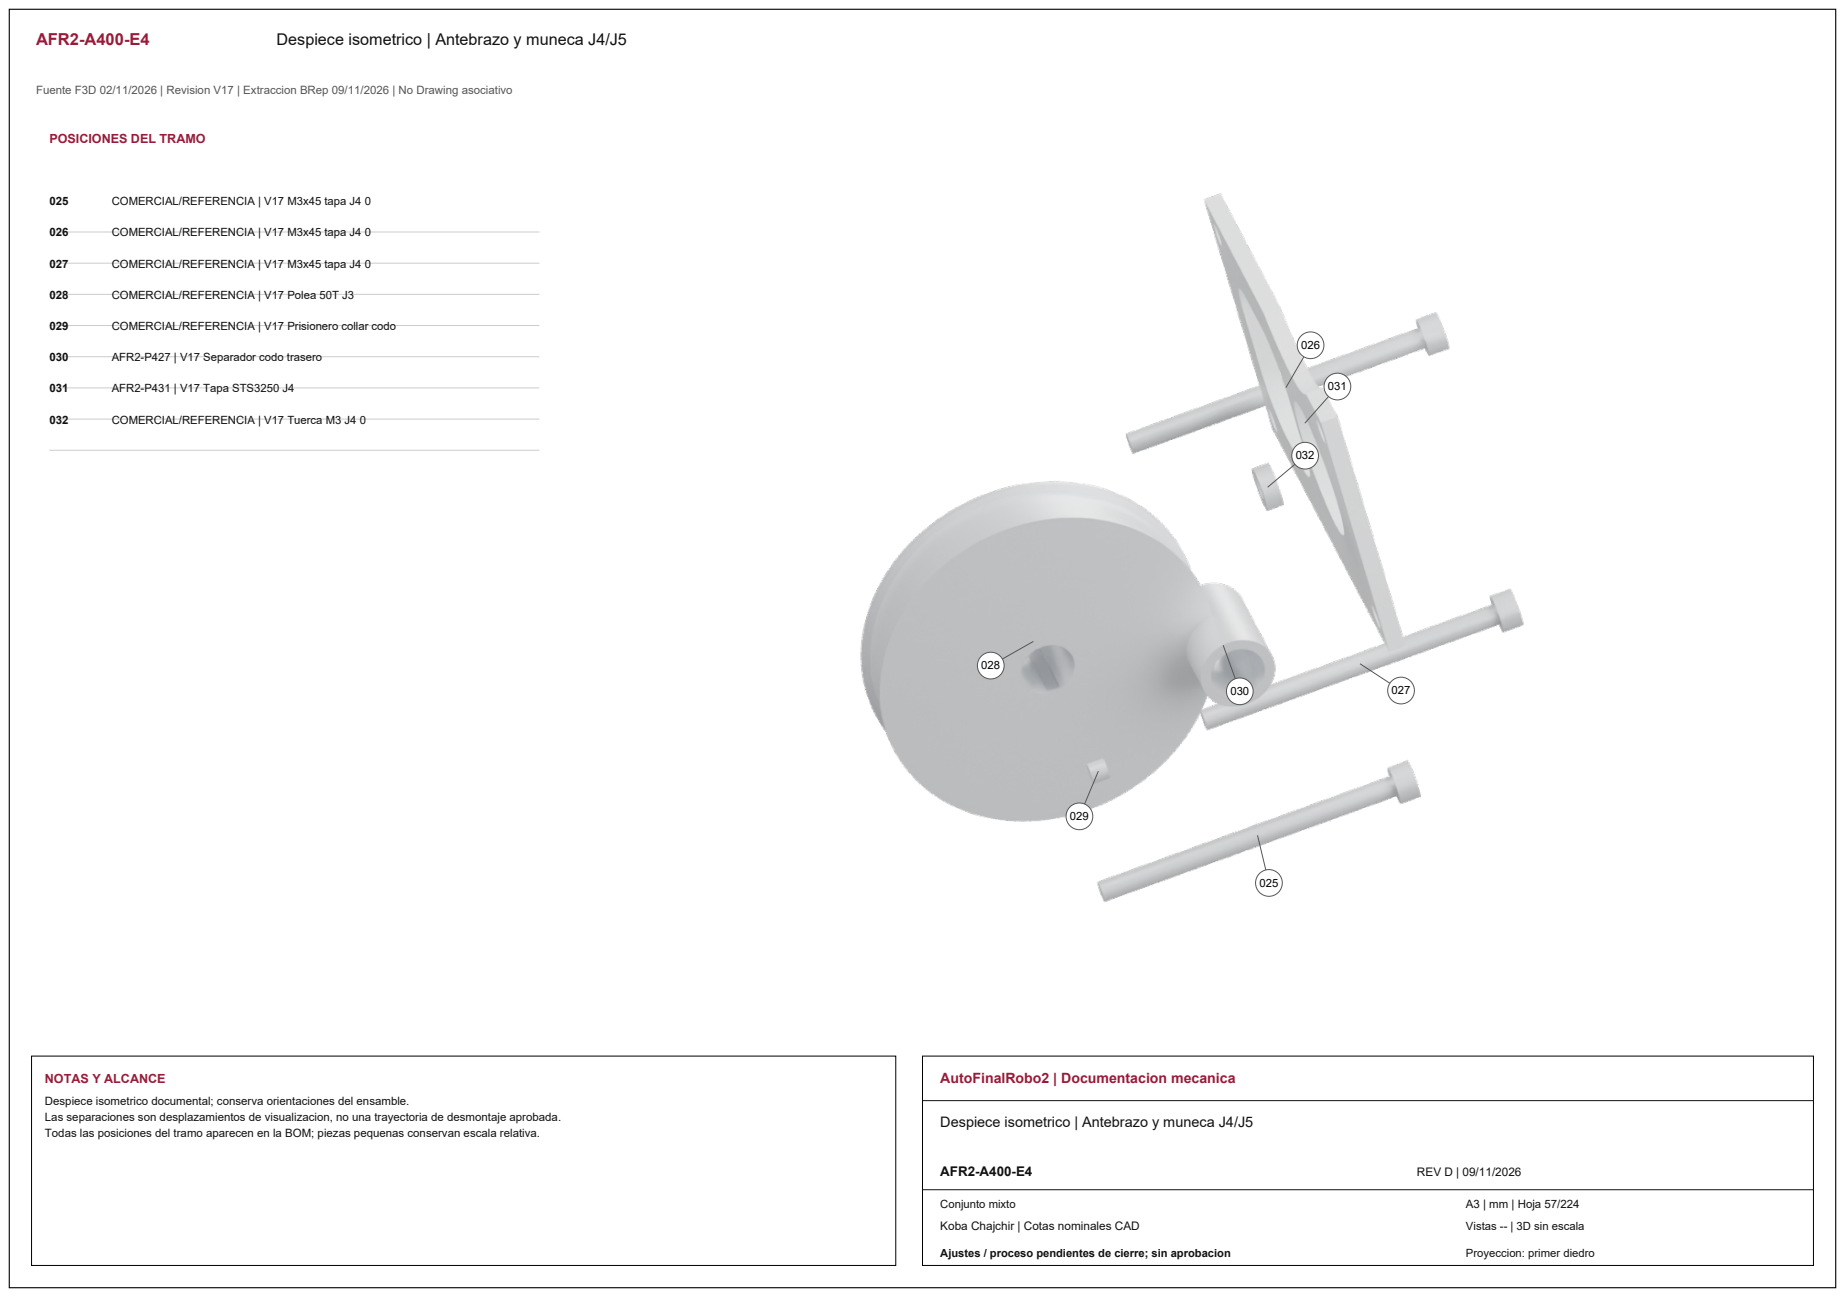
[picture p333: page 10]
031 AFR2-P431 | V17 Tapa STS3250 J4; NOTAS Y ALCANCE; AutoFinalRobo2 | Documentacion mecanica; AFR2-A400-E4; REV D | 09/11/2026; Conjunto mixto

POSICIONES DEL TRAMO

025 COMERCIAL/REFERENCIA | V17 M3x45 tapa J4 0

026 COMERCIAL/REFERENCIA | V17 M3x45 tapa J4 0

027 COMERCIAL/REFERENCIA | V17 M3x45 tapa J4 0

028 COMERCIAL/REFERENCIA | V17 Polea 50T J3

029 COMERCIAL/REFERENCIA | V17 Prisionero collar codo

030 AFR2-P427 | V17 Separador codo trasero

032 COMERCIAL/REFERENCIA | V17 Tuerca M3 J4 0

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

Despiece isometrico | Antebrazo y muneca J4/J5

Vistas -- | 3D sin escala

AFR2-A400-E5 | Despiece isometrico | Antebrazo y muneca J4/J5

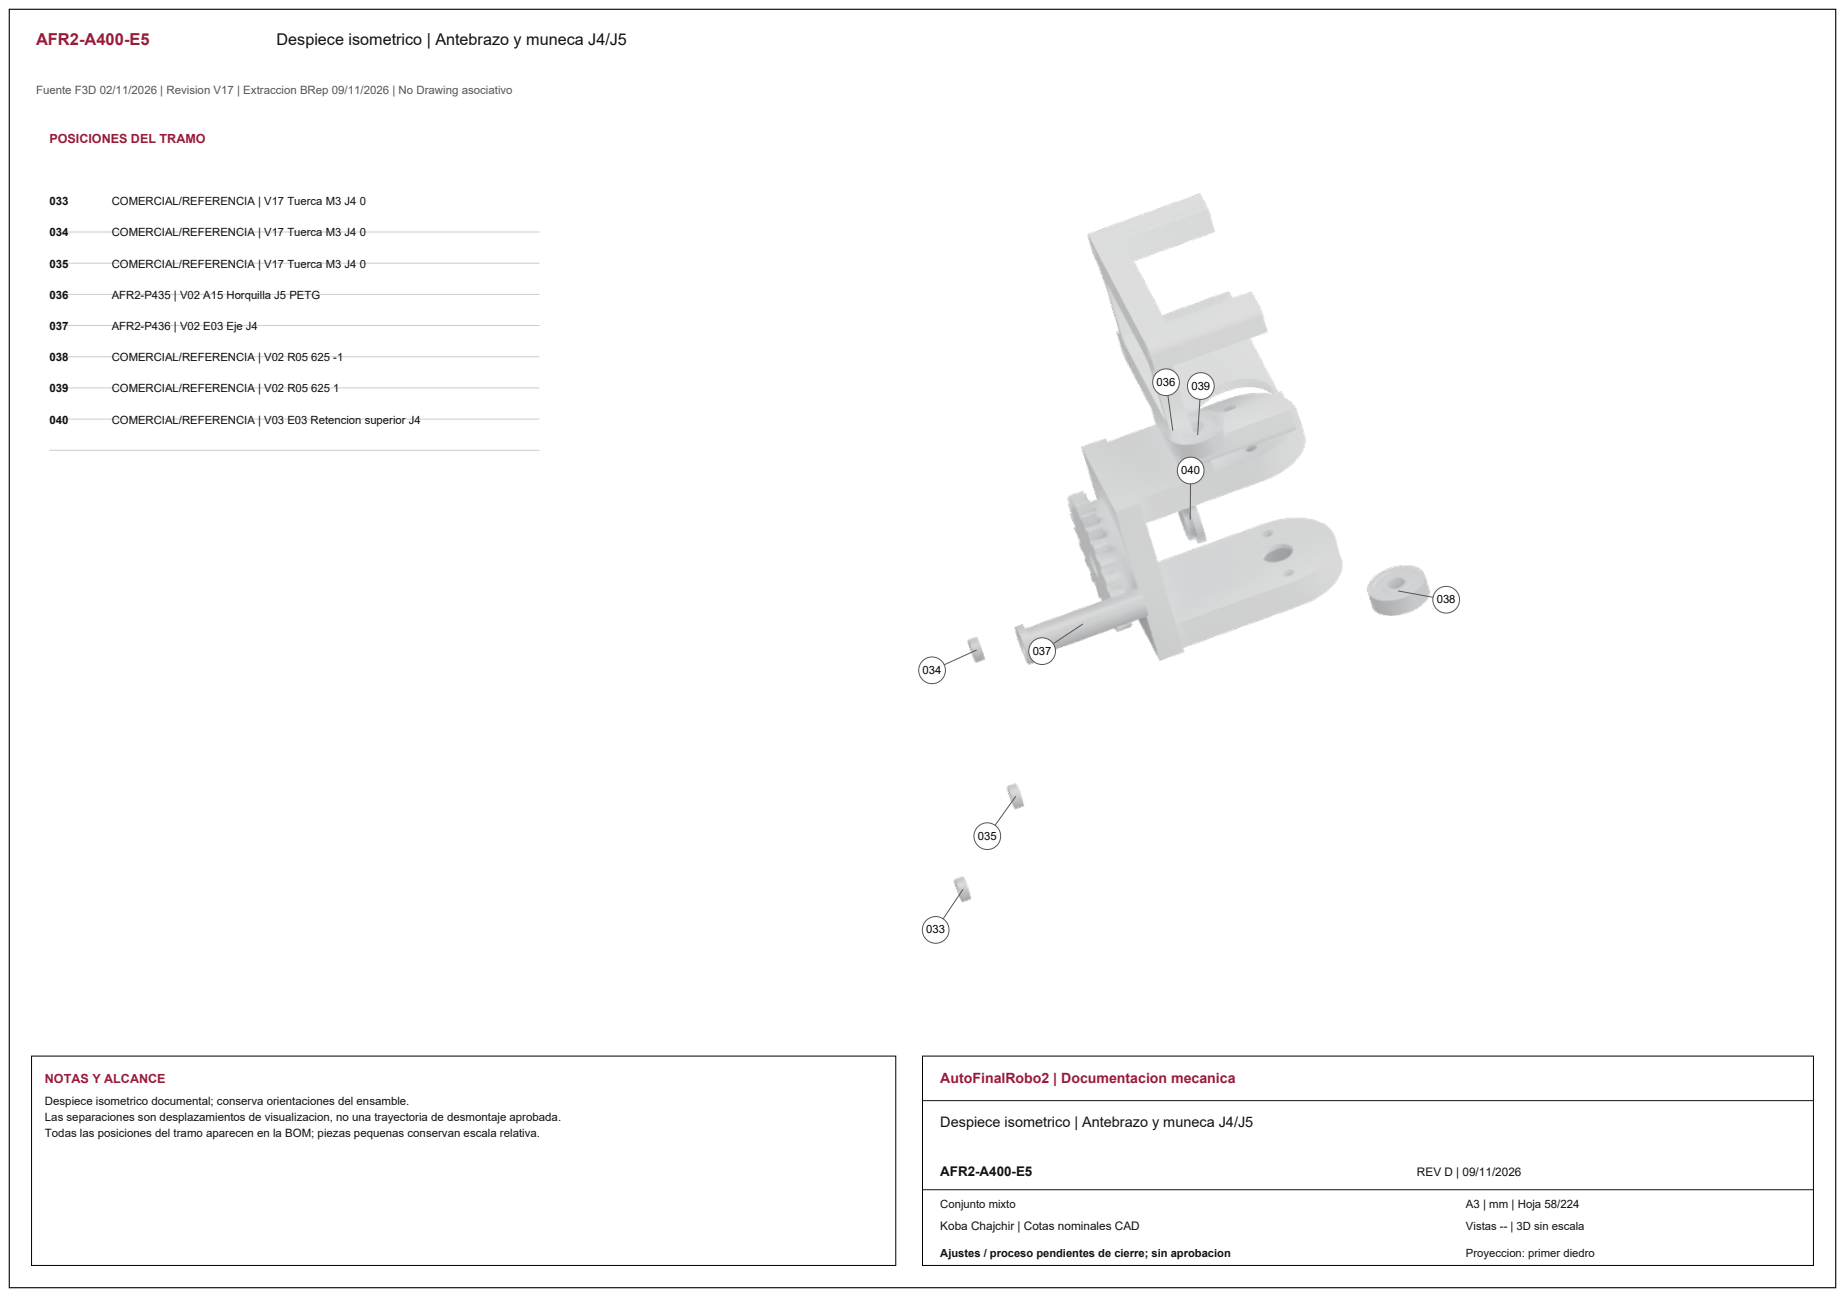
[picture p334: page 11]
036 AFR2-P435 | V02 A15 Horquilla J5 PETG; 037 AFR2-P436 | V02 E03 Eje J4; 038 COMERCIAL/REFERENCIA | V02 R05 625 -1; 039 COMERCIAL/REFERENCIA | V02 R05 625 1; NOTAS Y ALCANCE; AutoFinalRobo2 | Documentacion mecanica; AFR2-A400-E5; REV D | 09/11/2026; Conjunto mixto

POSICIONES DEL TRAMO

033 COMERCIAL/REFERENCIA | V17 Tuerca M3 J4 0

034 COMERCIAL/REFERENCIA | V17 Tuerca M3 J4 0

035 COMERCIAL/REFERENCIA | V17 Tuerca M3 J4 0

040 COMERCIAL/REFERENCIA | V03 E03 Retencion superior J4

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

Despiece isometrico | Antebrazo y muneca J4/J5

Vistas -- | 3D sin escala

AFR2-A400-E6 | Despiece isometrico | Antebrazo y muneca J4/J5

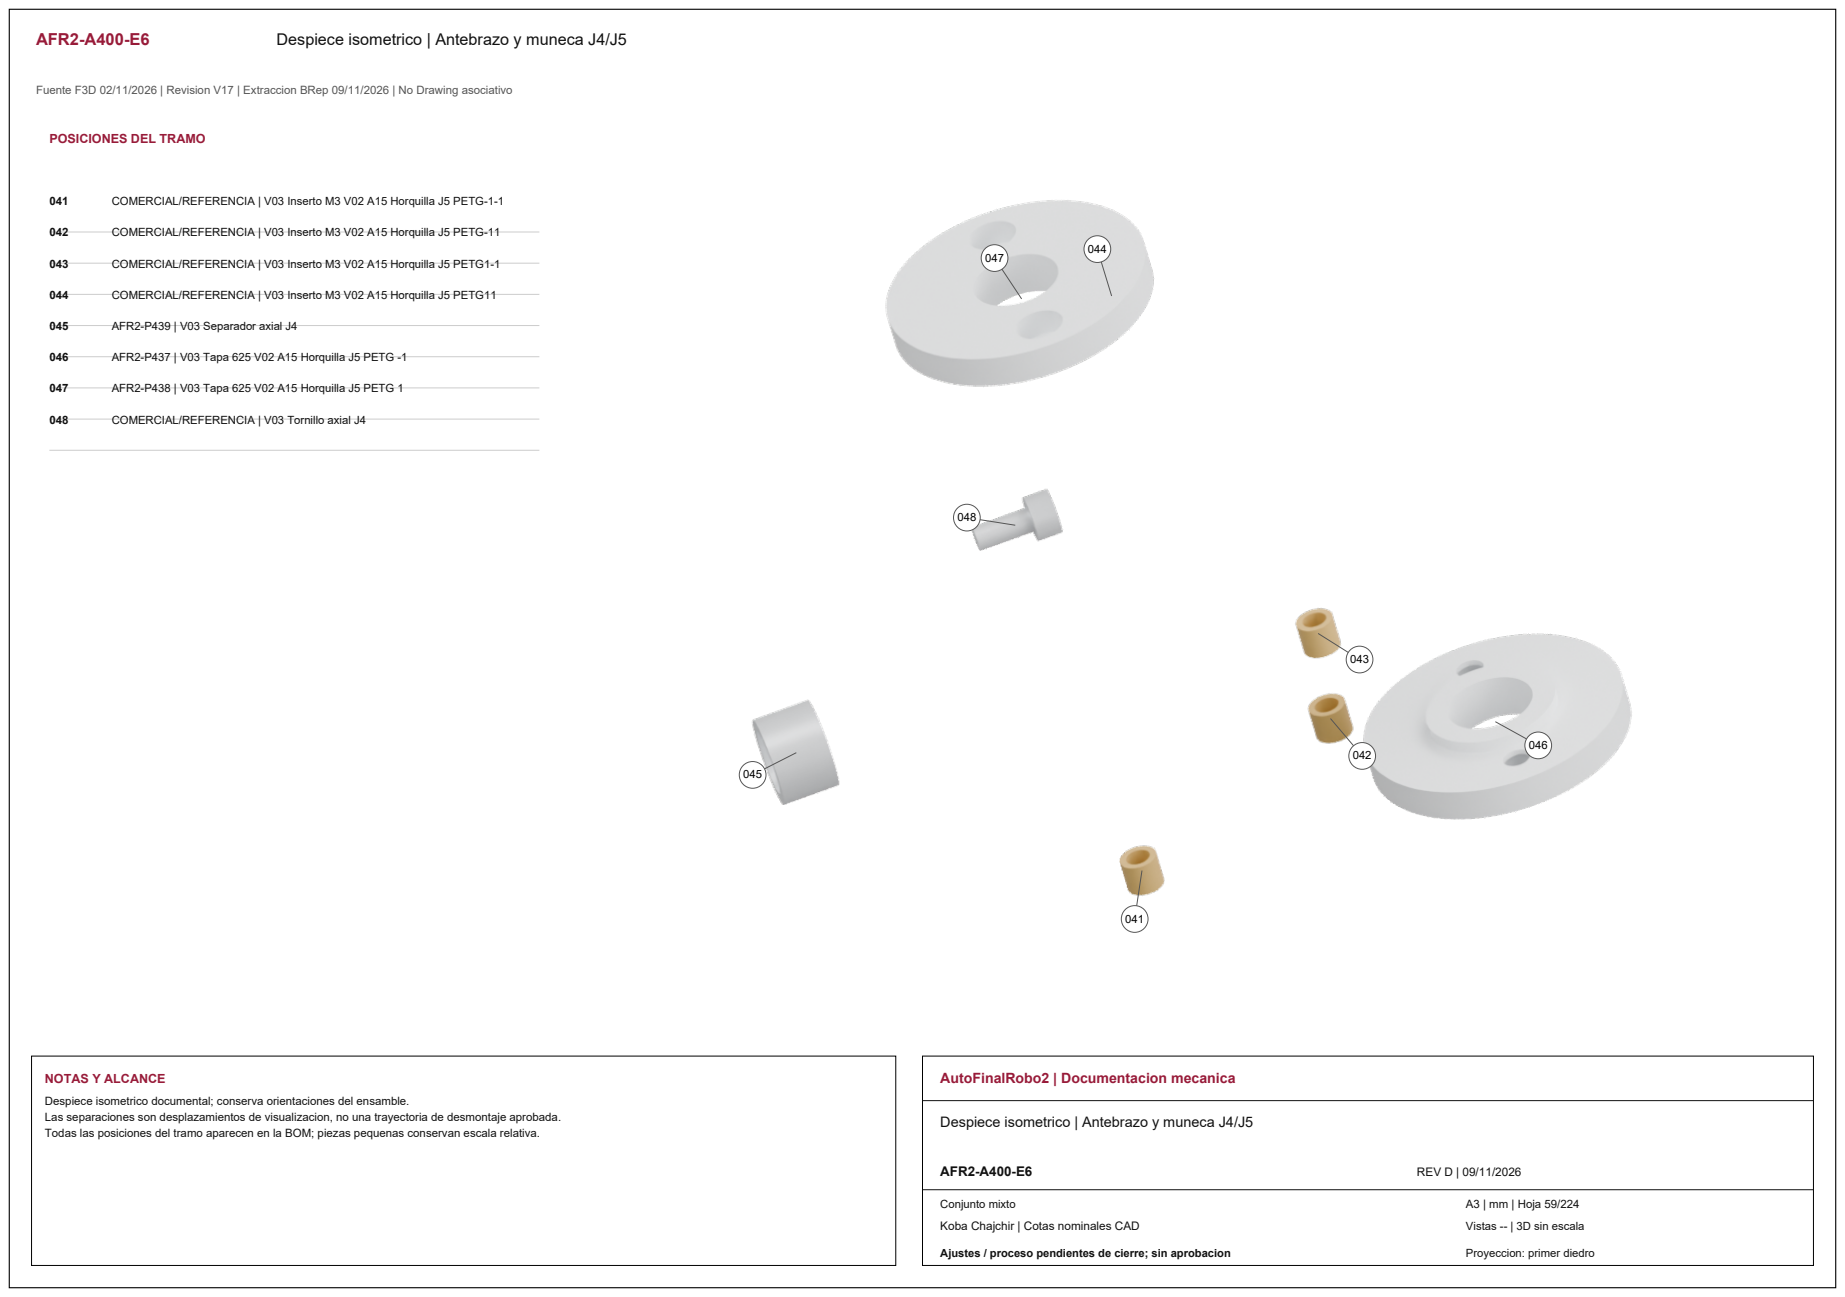
[picture p335: page 12]
045 AFR2-P439 | V03 Separador axial J4; NOTAS Y ALCANCE; AutoFinalRobo2 | Documentacion mecanica; AFR2-A400-E6; REV D | 09/11/2026; Conjunto mixto

POSICIONES DEL TRAMO

041 COMERCIAL/REFERENCIA | V03 Inserto M3 V02 A15 Horquilla J5 PETG-1-1

042 COMERCIAL/REFERENCIA | V03 Inserto M3 V02 A15 Horquilla J5 PETG-11

043 COMERCIAL/REFERENCIA | V03 Inserto M3 V02 A15 Horquilla J5 PETG1-1

044 COMERCIAL/REFERENCIA | V03 Inserto M3 V02 A15 Horquilla J5 PETG11

046 AFR2-P437 | V03 Tapa 625 V02 A15 Horquilla J5 PETG -1

047 AFR2-P438 | V03 Tapa 625 V02 A15 Horquilla J5 PETG 1

048 COMERCIAL/REFERENCIA | V03 Tornillo axial J4

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

Despiece isometrico | Antebrazo y muneca J4/J5

Vistas -- | 3D sin escala

AFR2-A400-E7 | Despiece isometrico | Antebrazo y muneca J4/J5

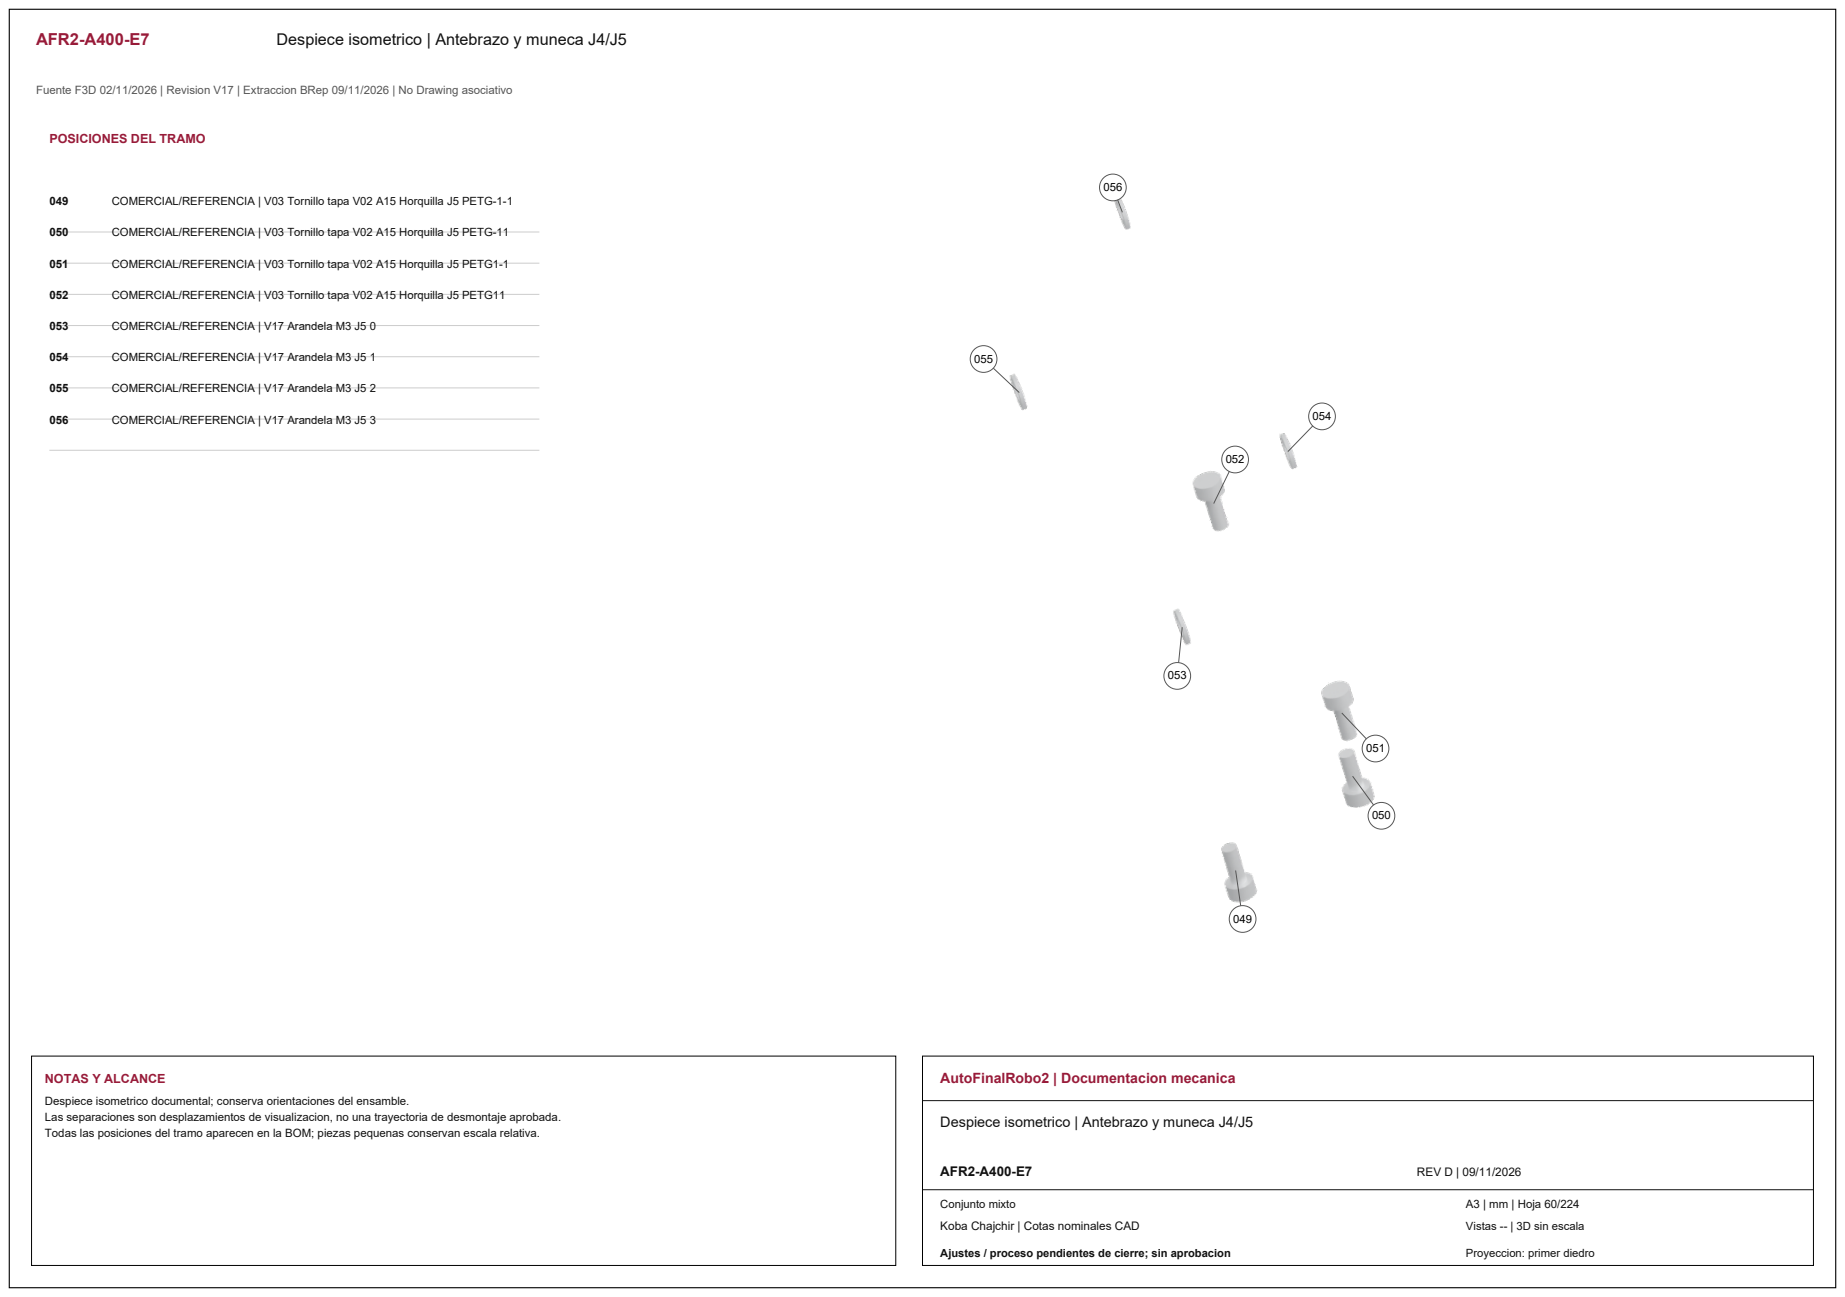
[picture p336: page 13]
NOTAS Y ALCANCE; AutoFinalRobo2 | Documentacion mecanica; AFR2-A400-E7; REV D | 09/11/2026; Conjunto mixto

POSICIONES DEL TRAMO

049 COMERCIAL/REFERENCIA | V03 Tornillo tapa V02 A15 Horquilla J5 PETG-1-1

050 COMERCIAL/REFERENCIA | V03 Tornillo tapa V02 A15 Horquilla J5 PETG-11

051 COMERCIAL/REFERENCIA | V03 Tornillo tapa V02 A15 Horquilla J5 PETG1-1

052 COMERCIAL/REFERENCIA | V03 Tornillo tapa V02 A15 Horquilla J5 PETG11

053 COMERCIAL/REFERENCIA | V17 Arandela M3 J5 0

054 COMERCIAL/REFERENCIA | V17 Arandela M3 J5 1

055 COMERCIAL/REFERENCIA | V17 Arandela M3 J5 2

056 COMERCIAL/REFERENCIA | V17 Arandela M3 J5 3

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

Despiece isometrico | Antebrazo y muneca J4/J5

Vistas -- | 3D sin escala

AFR2-A400-E8 | Despiece isometrico | Antebrazo y muneca J4/J5

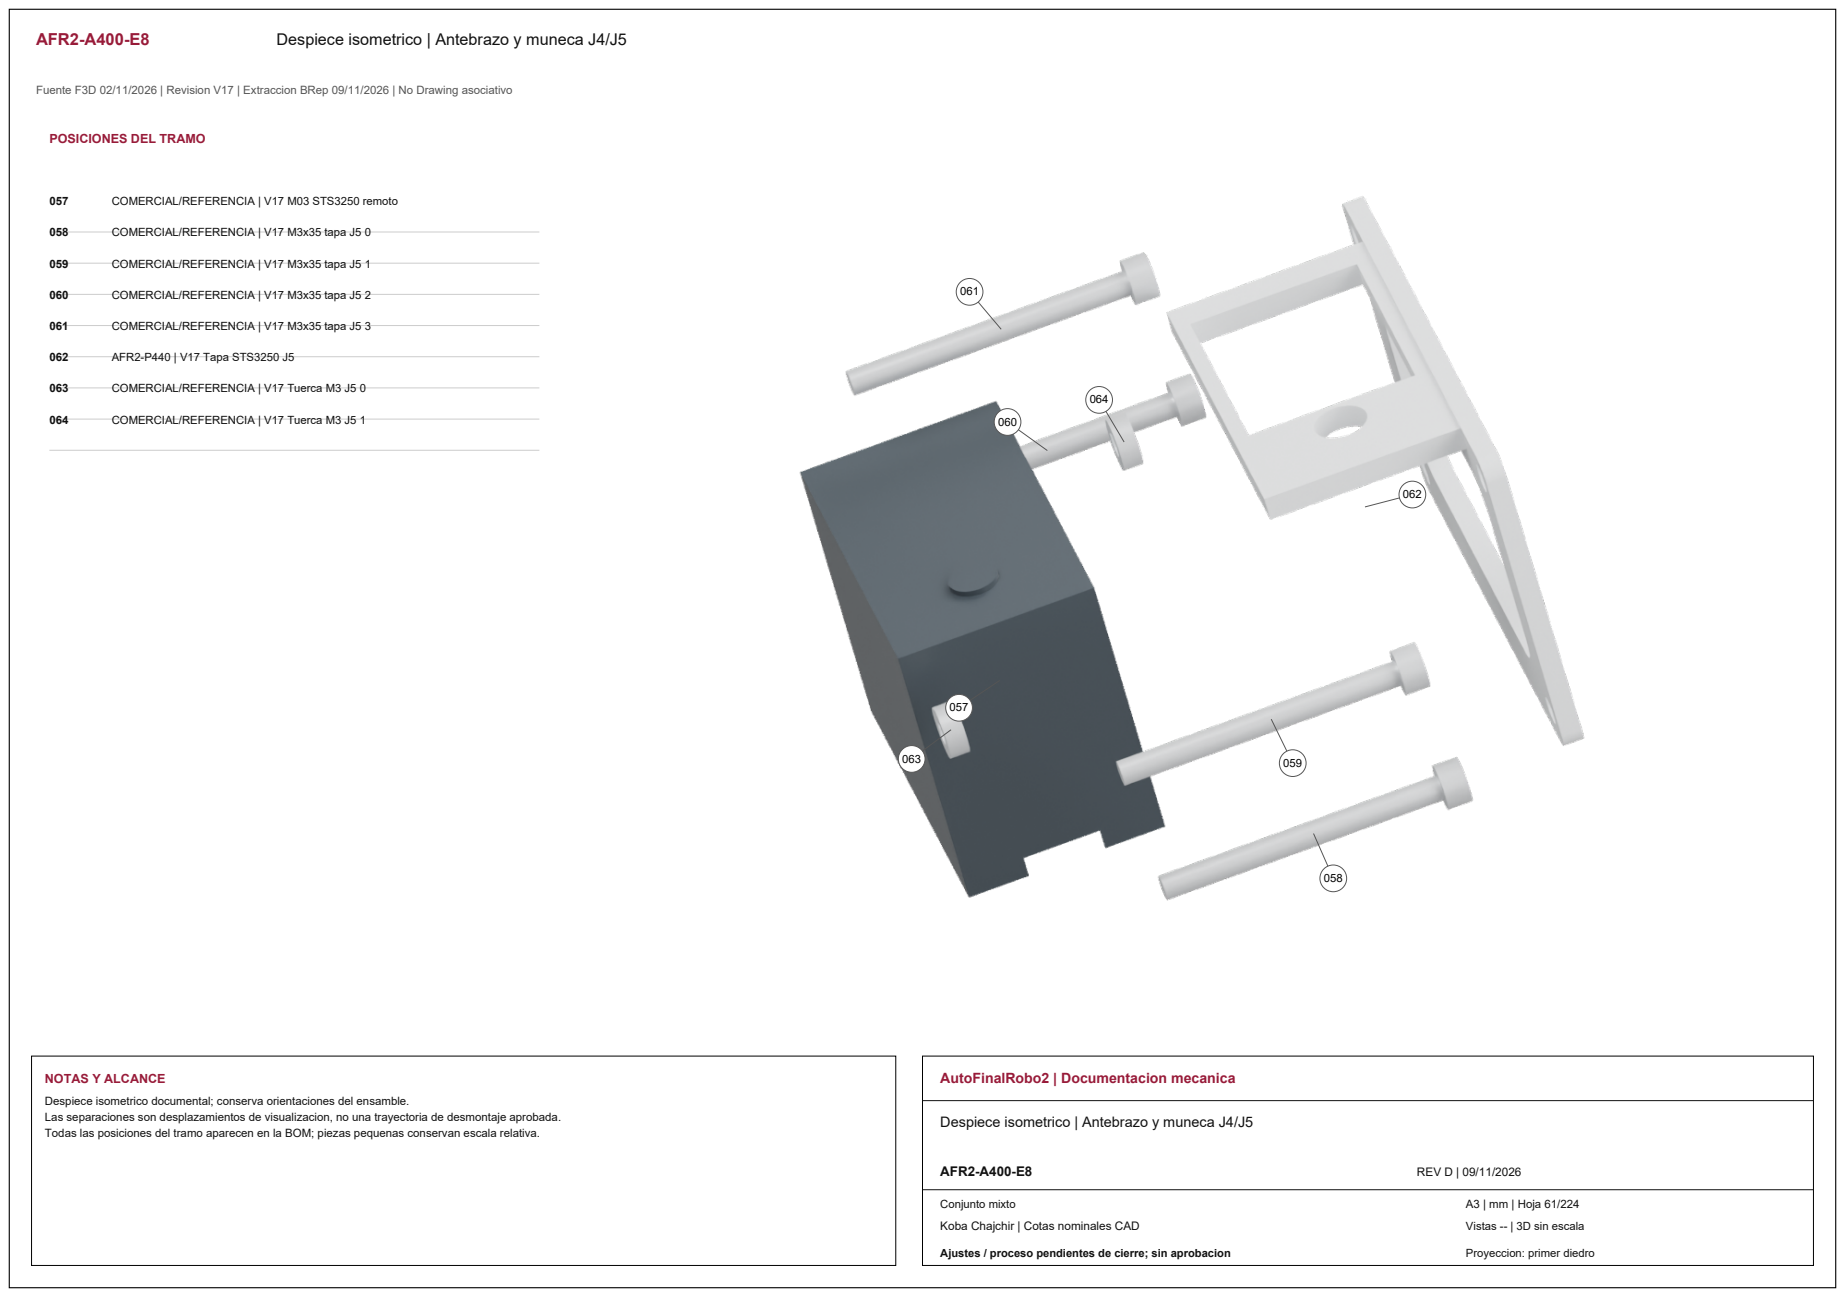
[picture p337: page 14]
062 AFR2-P440 | V17 Tapa STS3250 J5; NOTAS Y ALCANCE; AutoFinalRobo2 | Documentacion mecanica; AFR2-A400-E8; REV D | 09/11/2026; Conjunto mixto

POSICIONES DEL TRAMO

057 COMERCIAL/REFERENCIA | V17 M03 STS3250 remoto

058 COMERCIAL/REFERENCIA | V17 M3x35 tapa J5 0

059 COMERCIAL/REFERENCIA | V17 M3x35 tapa J5 1

060 COMERCIAL/REFERENCIA | V17 M3x35 tapa J5 2

061 COMERCIAL/REFERENCIA | V17 M3x35 tapa J5 3

063 COMERCIAL/REFERENCIA | V17 Tuerca M3 J5 0

064 COMERCIAL/REFERENCIA | V17 Tuerca M3 J5 1

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

Despiece isometrico | Antebrazo y muneca J4/J5

Vistas -- | 3D sin escala

AFR2-A400-E9 | Despiece isometrico | Antebrazo y muneca J4/J5

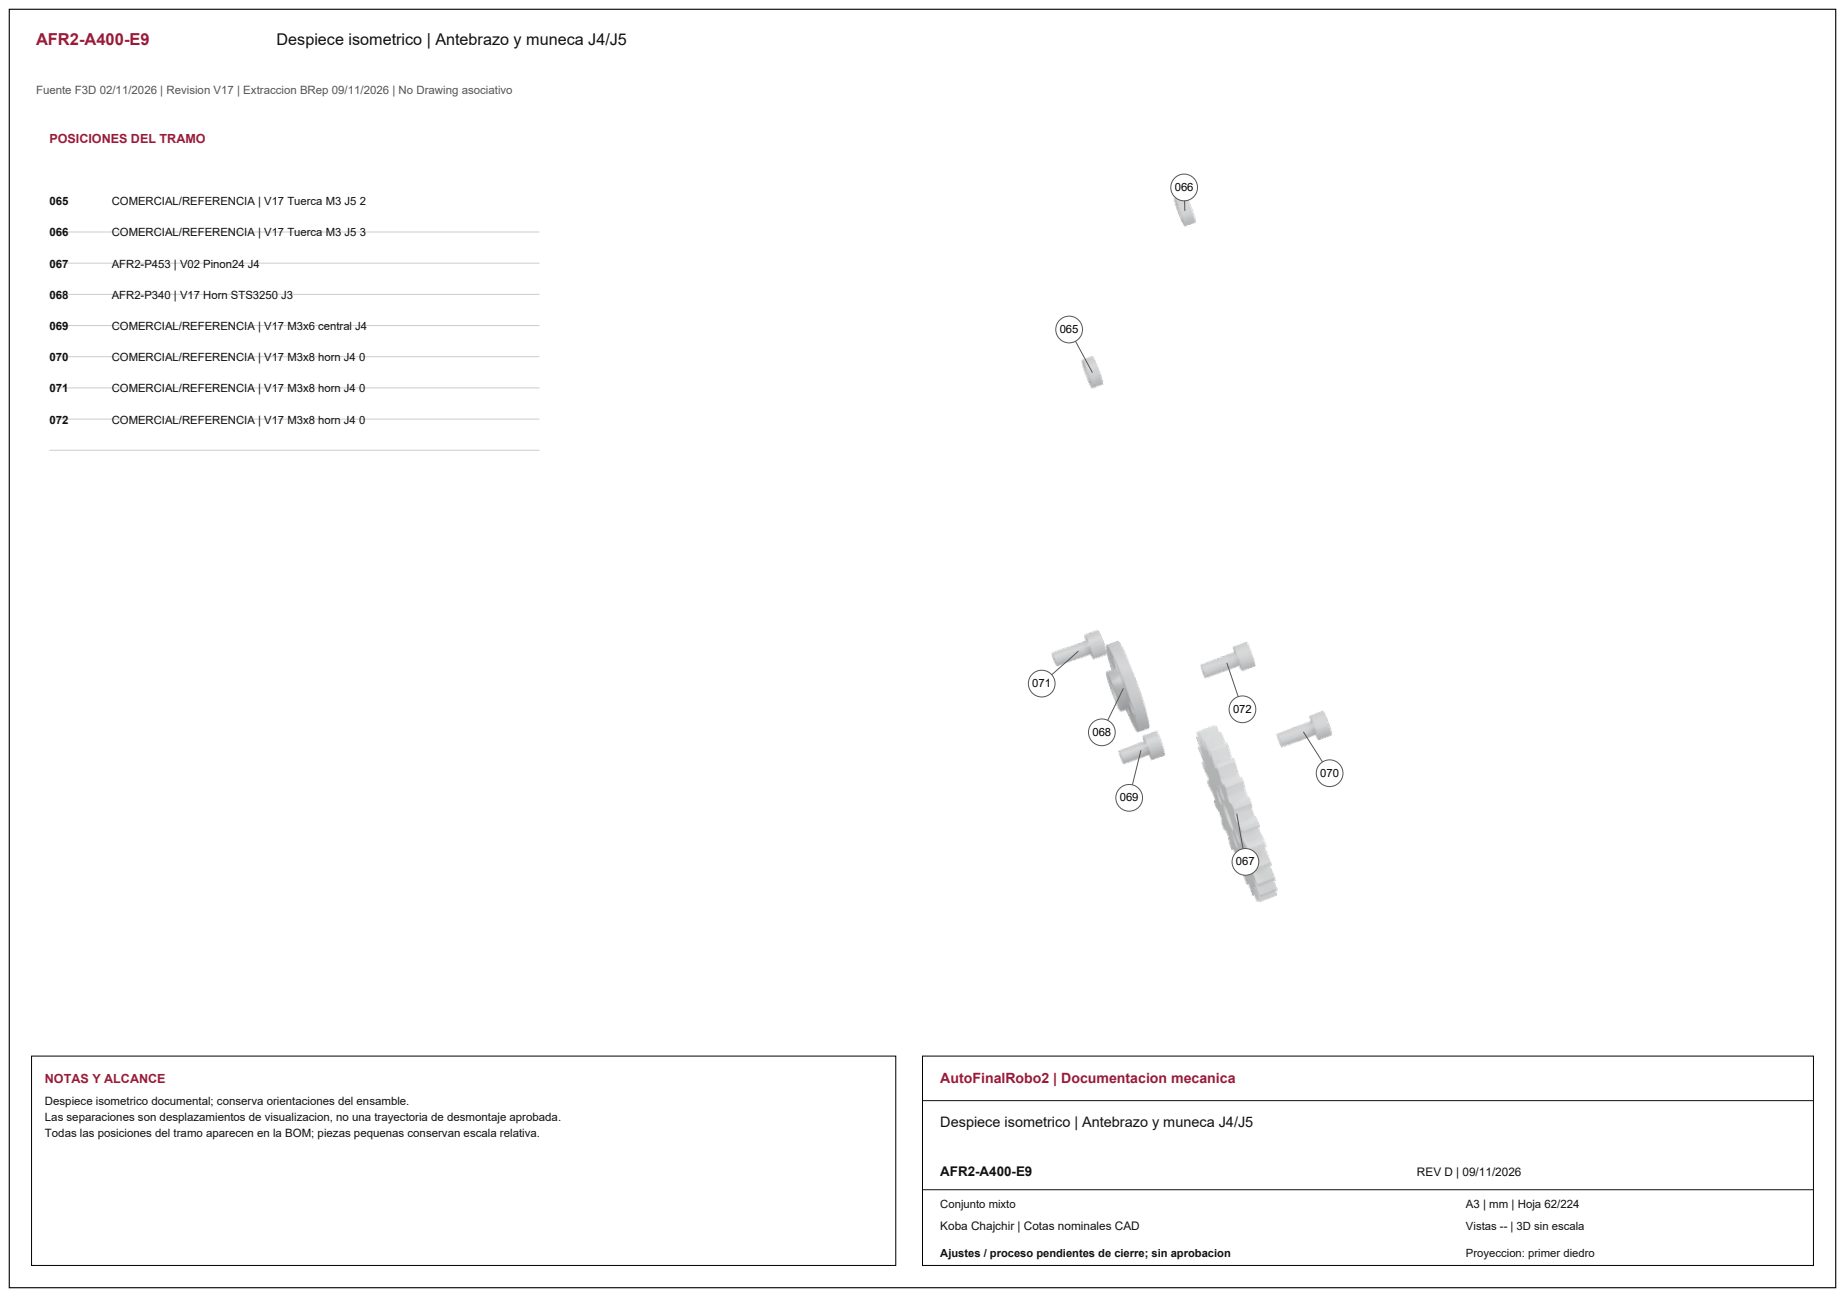
[picture p338: page 15]
067 AFR2-P453 | V02 Pinon24 J4; 068 AFR2-P340 | V17 Horn STS3250 J3; NOTAS Y ALCANCE; AutoFinalRobo2 | Documentacion mecanica; AFR2-A400-E9; REV D | 09/11/2026; Conjunto mixto

POSICIONES DEL TRAMO

065 COMERCIAL/REFERENCIA | V17 Tuerca M3 J5 2

066 COMERCIAL/REFERENCIA | V17 Tuerca M3 J5 3

069 COMERCIAL/REFERENCIA | V17 M3x6 central J4

070 COMERCIAL/REFERENCIA | V17 M3x8 horn J4 0

071 COMERCIAL/REFERENCIA | V17 M3x8 horn J4 0

072 COMERCIAL/REFERENCIA | V17 M3x8 horn J4 0

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

Despiece isometrico | Antebrazo y muneca J4/J5

Vistas -- | 3D sin escala

AFR2-A400-E10 | Despiece isometrico | Antebrazo y muneca J4/J5

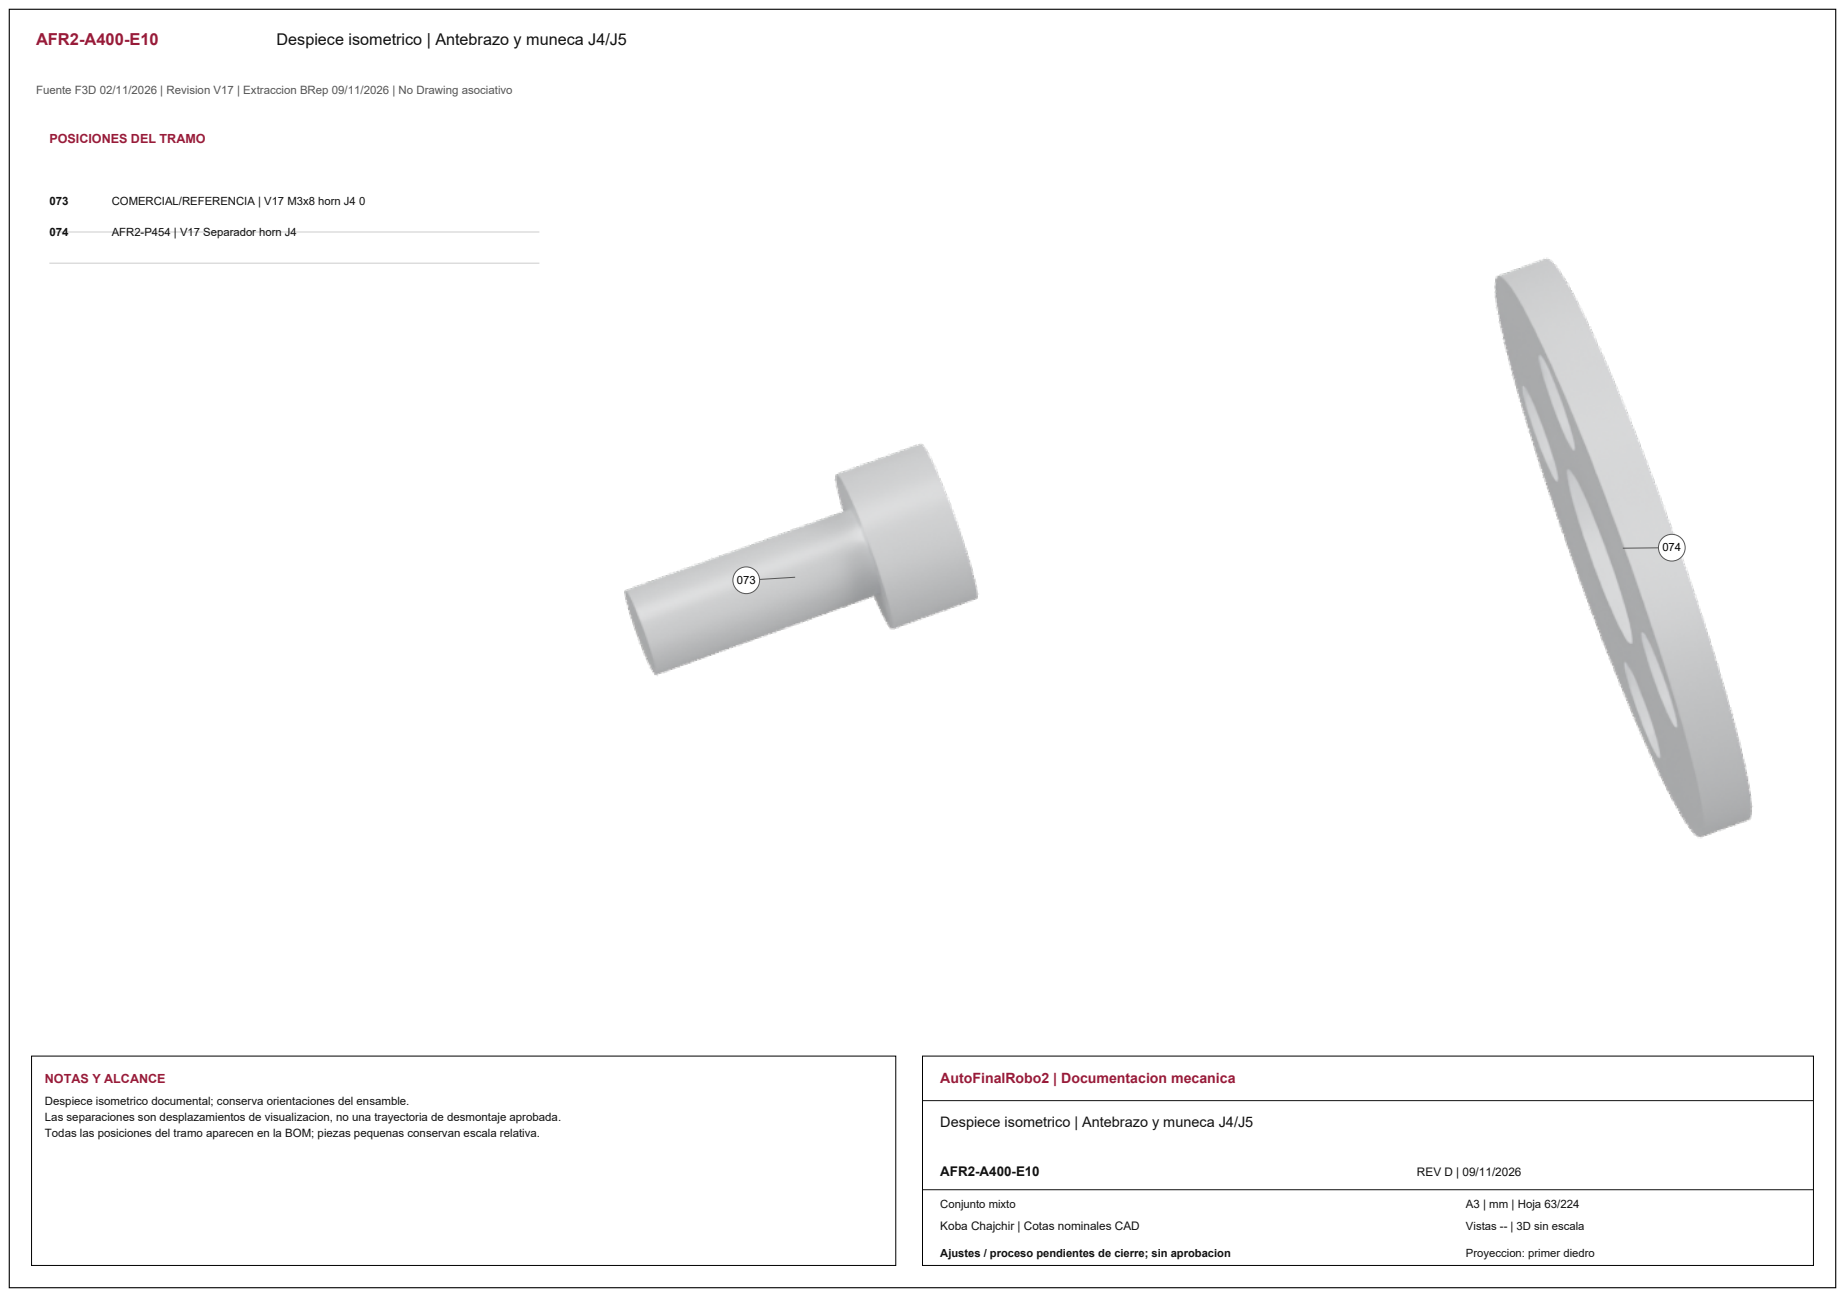
[picture p339: page 16]
074 AFR2-P454 | V17 Separador horn J4; NOTAS Y ALCANCE; AutoFinalRobo2 | Documentacion mecanica; AFR2-A400-E10; REV D | 09/11/2026; Conjunto mixto

POSICIONES DEL TRAMO

073 COMERCIAL/REFERENCIA | V17 M3x8 horn J4 0

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

Despiece isometrico | Antebrazo y muneca J4/J5

Vistas -- | 3D sin escala

AFR2-P421 | L02 PVC nominal V17 Corte 2

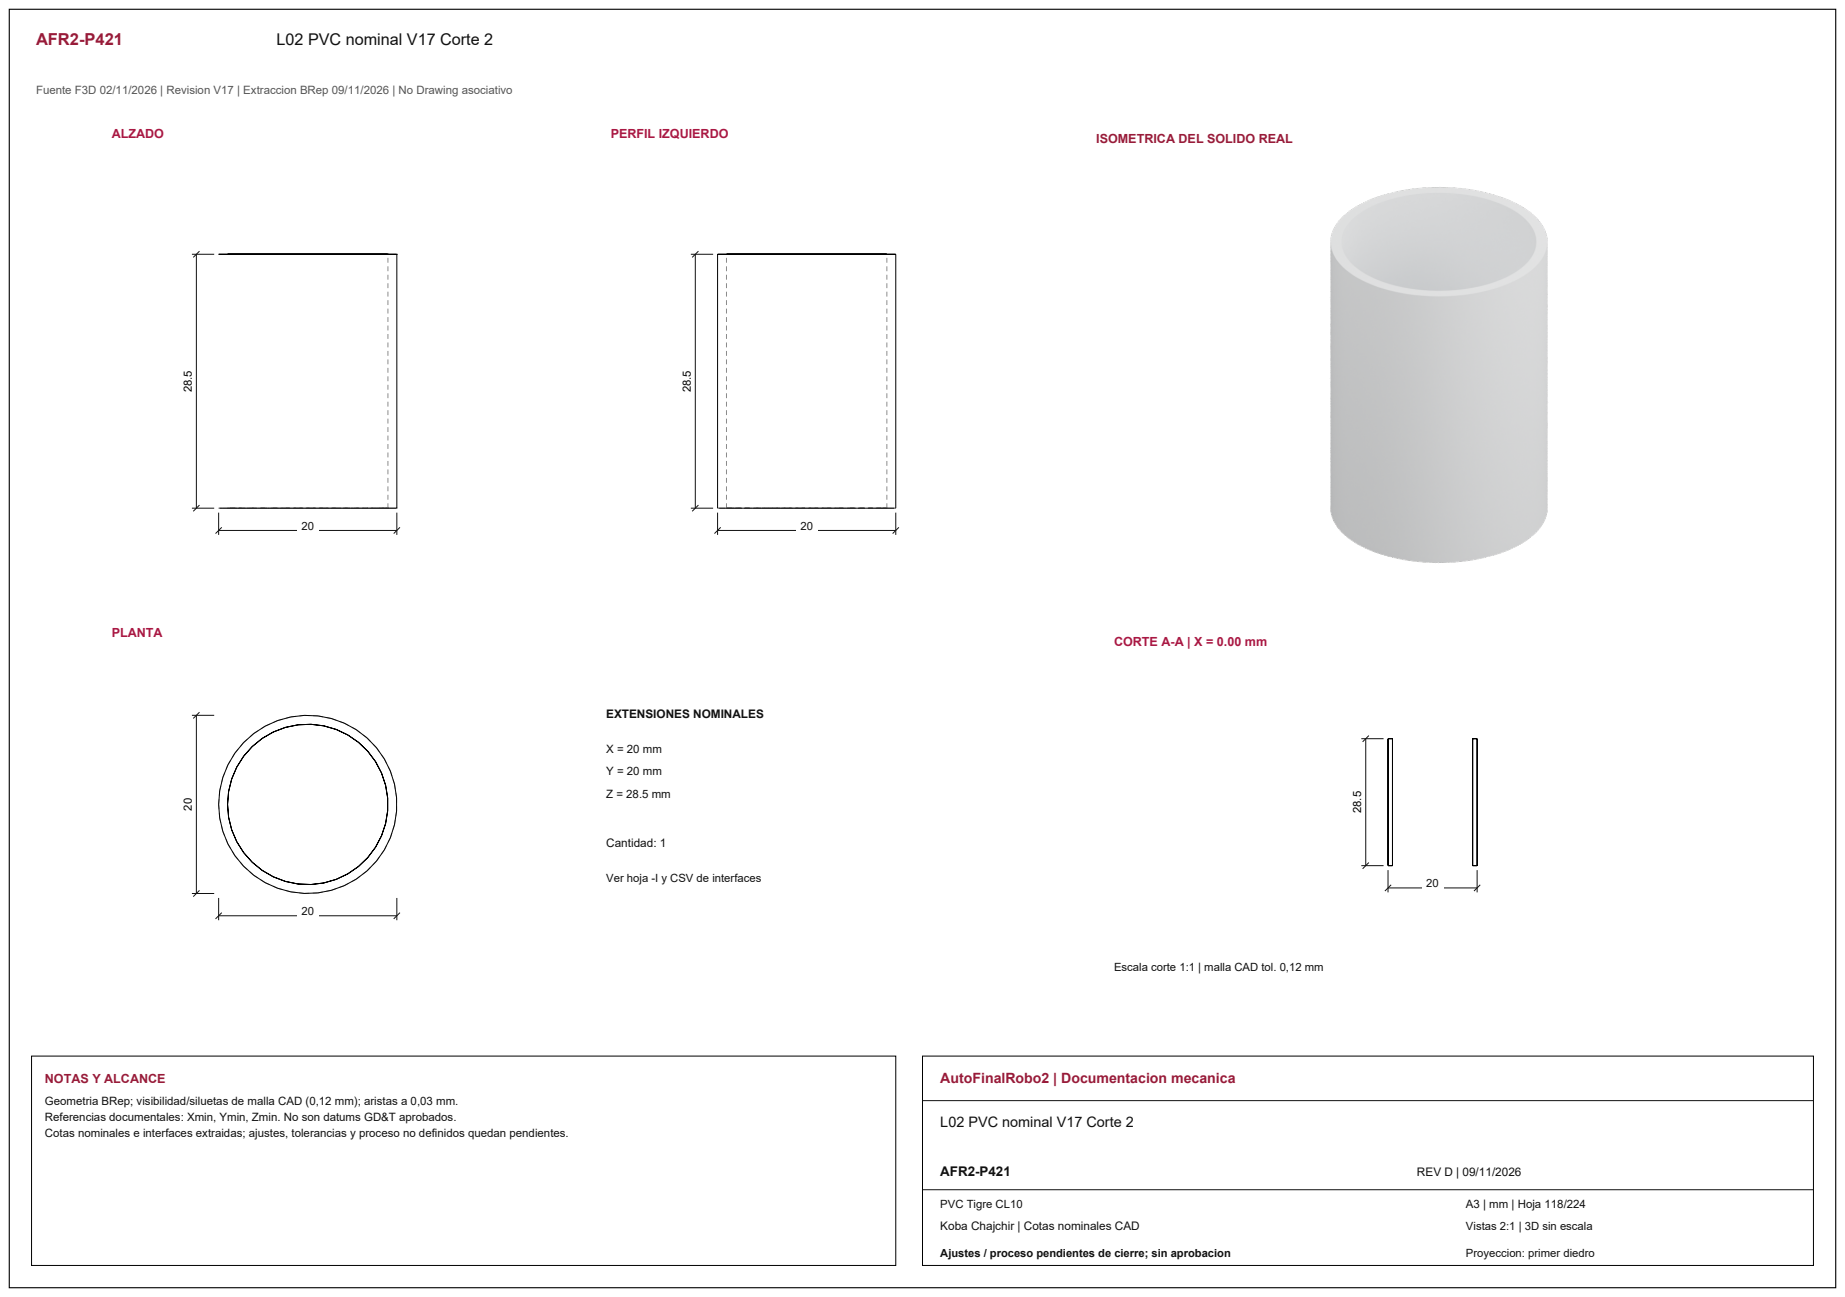
[picture p340: page 17]
ALZADO; PERFIL IZQUIERDO; PLANTA; CORTE A-A | X = 0.00 mm; EXTENSIONES NOMINALES; Cantidad: 1; NOTAS Y ALCANCE; AutoFinalRobo2 | Documentacion mecanica; AFR2-P421; REV D | 09/11/2026; PVC Tigre CL10

ISOMETRICA DEL SOLIDO REAL

Ver hoja -I y CSV de interfaces

Escala corte 1:1 | malla CAD tol. 0,12 mm

Geometria BRep; visibilidad/siluetas de malla CAD (0,12 mm); aristas a 0,03 mm.
Referencias documentales: Xmin, Ymin, Zmin. No son datums GD&T aprobados.
Cotas nominales e interfaces extraidas; ajustes, tolerancias y proceso no definidos quedan pendientes.

L02 PVC nominal V17 Corte 2

Vistas 2:1 | 3D sin escala

AFR2-P421-I01 | Interfaces y corte | L02 PVC nominal V17 Corte 2

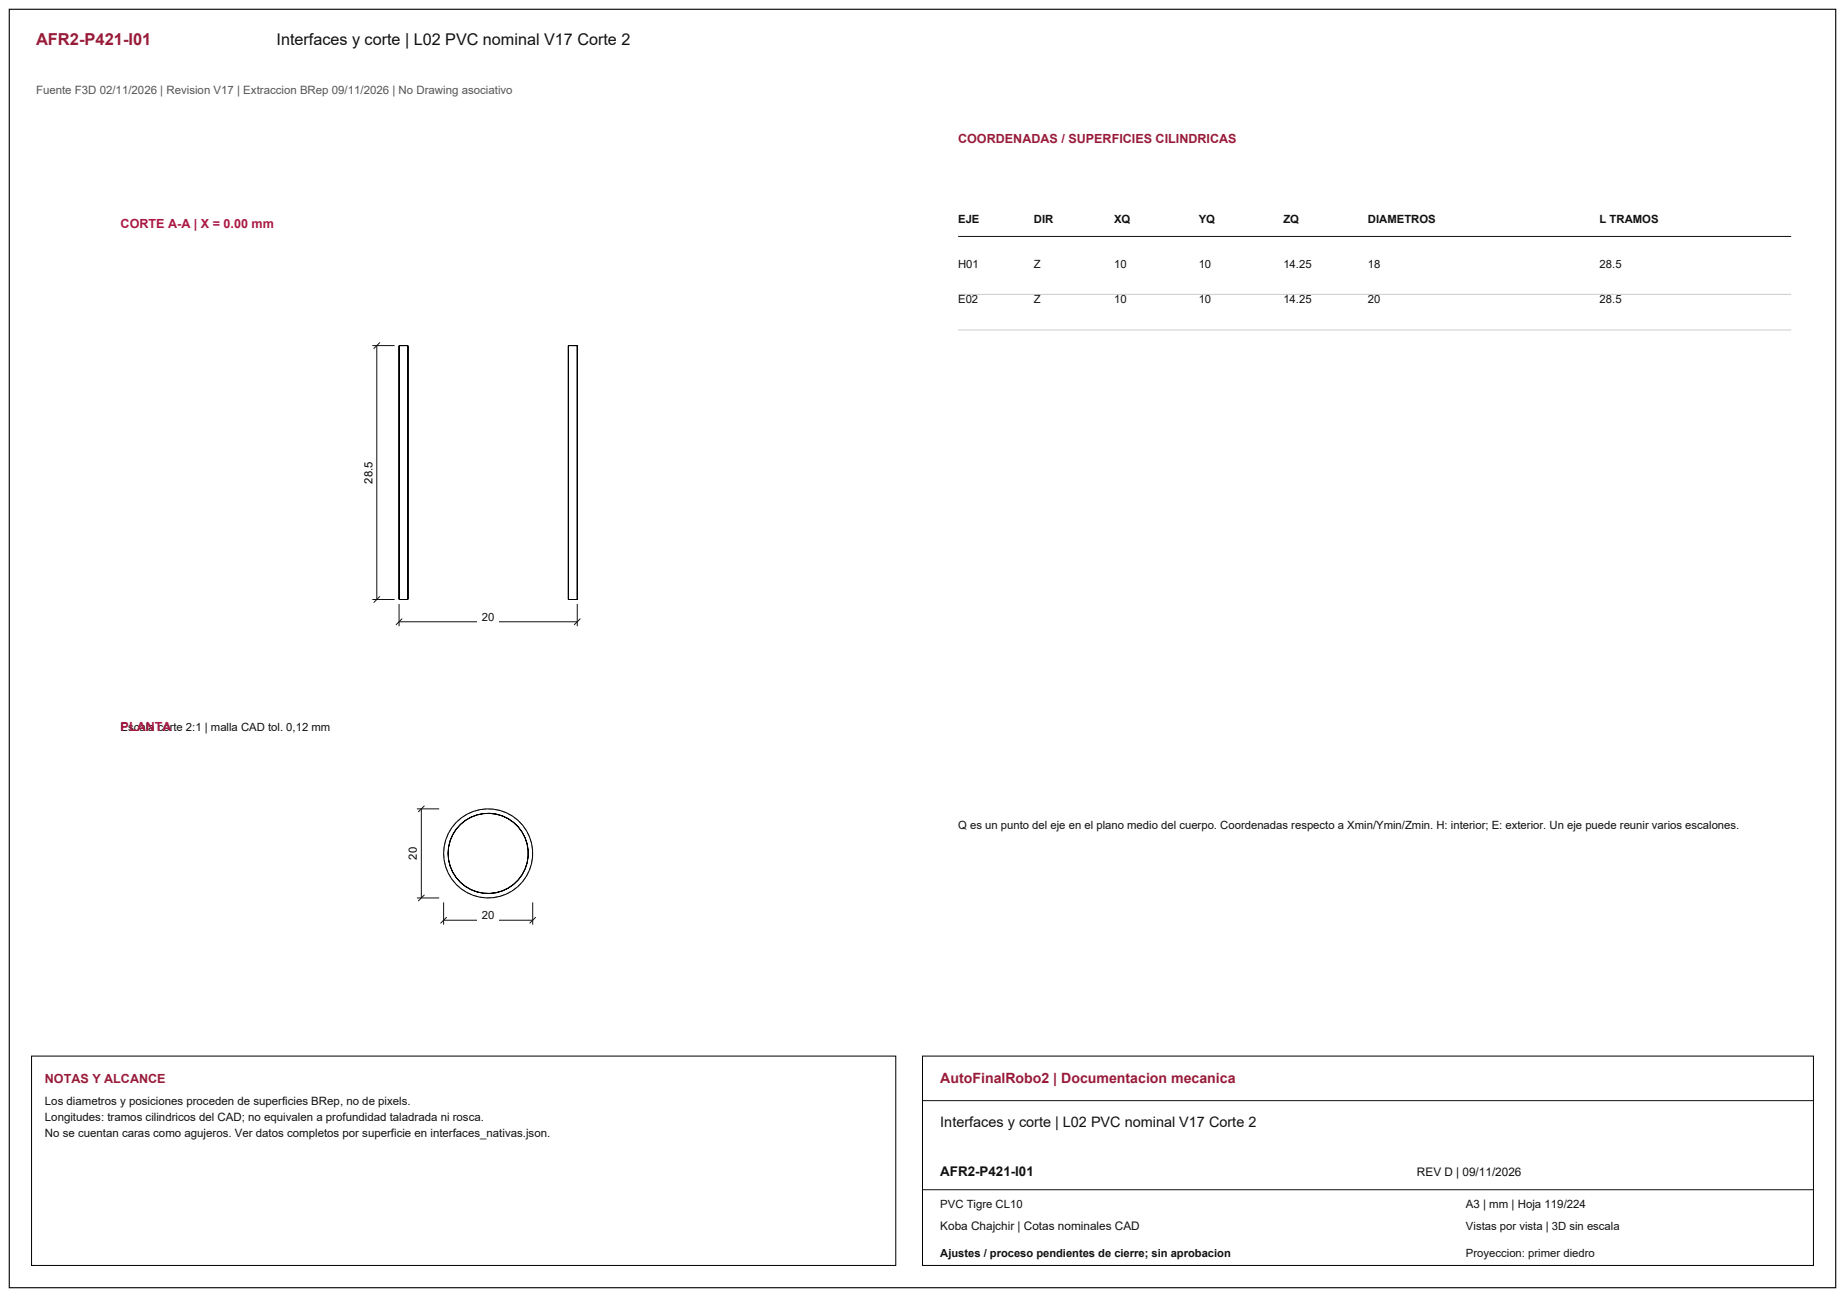
[picture p341: page 18]
CORTE A-A | X = 0.00 mm; EJE; DIR; DIAMETROS; L TRAMOS; NOTAS Y ALCANCE; AutoFinalRobo2 | Documentacion mecanica; AFR2-P421-I01; REV D | 09/11/2026; PVC Tigre CL10

COORDENADAS / SUPERFICIES CILINDRICAS

Escala corte 2:1 | malla CAD tol. 0,12 mm PLANTA

Q es un punto del eje en el plano medio del cuerpo. Coordenadas respecto a Xmin/Ymin/Zmin. H: interior; E: exterior. Un eje puede reunir varios escalones.

Los diametros y posiciones proceden de superficies BRep, no de pixels.
Longitudes: tramos cilindricos del CAD; no equivalen a profundidad taladrada ni rosca.
No se cuentan caras como agujeros. Ver datos completos por superficie en interfaces_nativas.json.

Interfaces y corte | L02 PVC nominal V17 Corte 2

Vistas por vista | 3D sin escala

AFR2-P422 | A12 Encastre distal antebrazo PLA

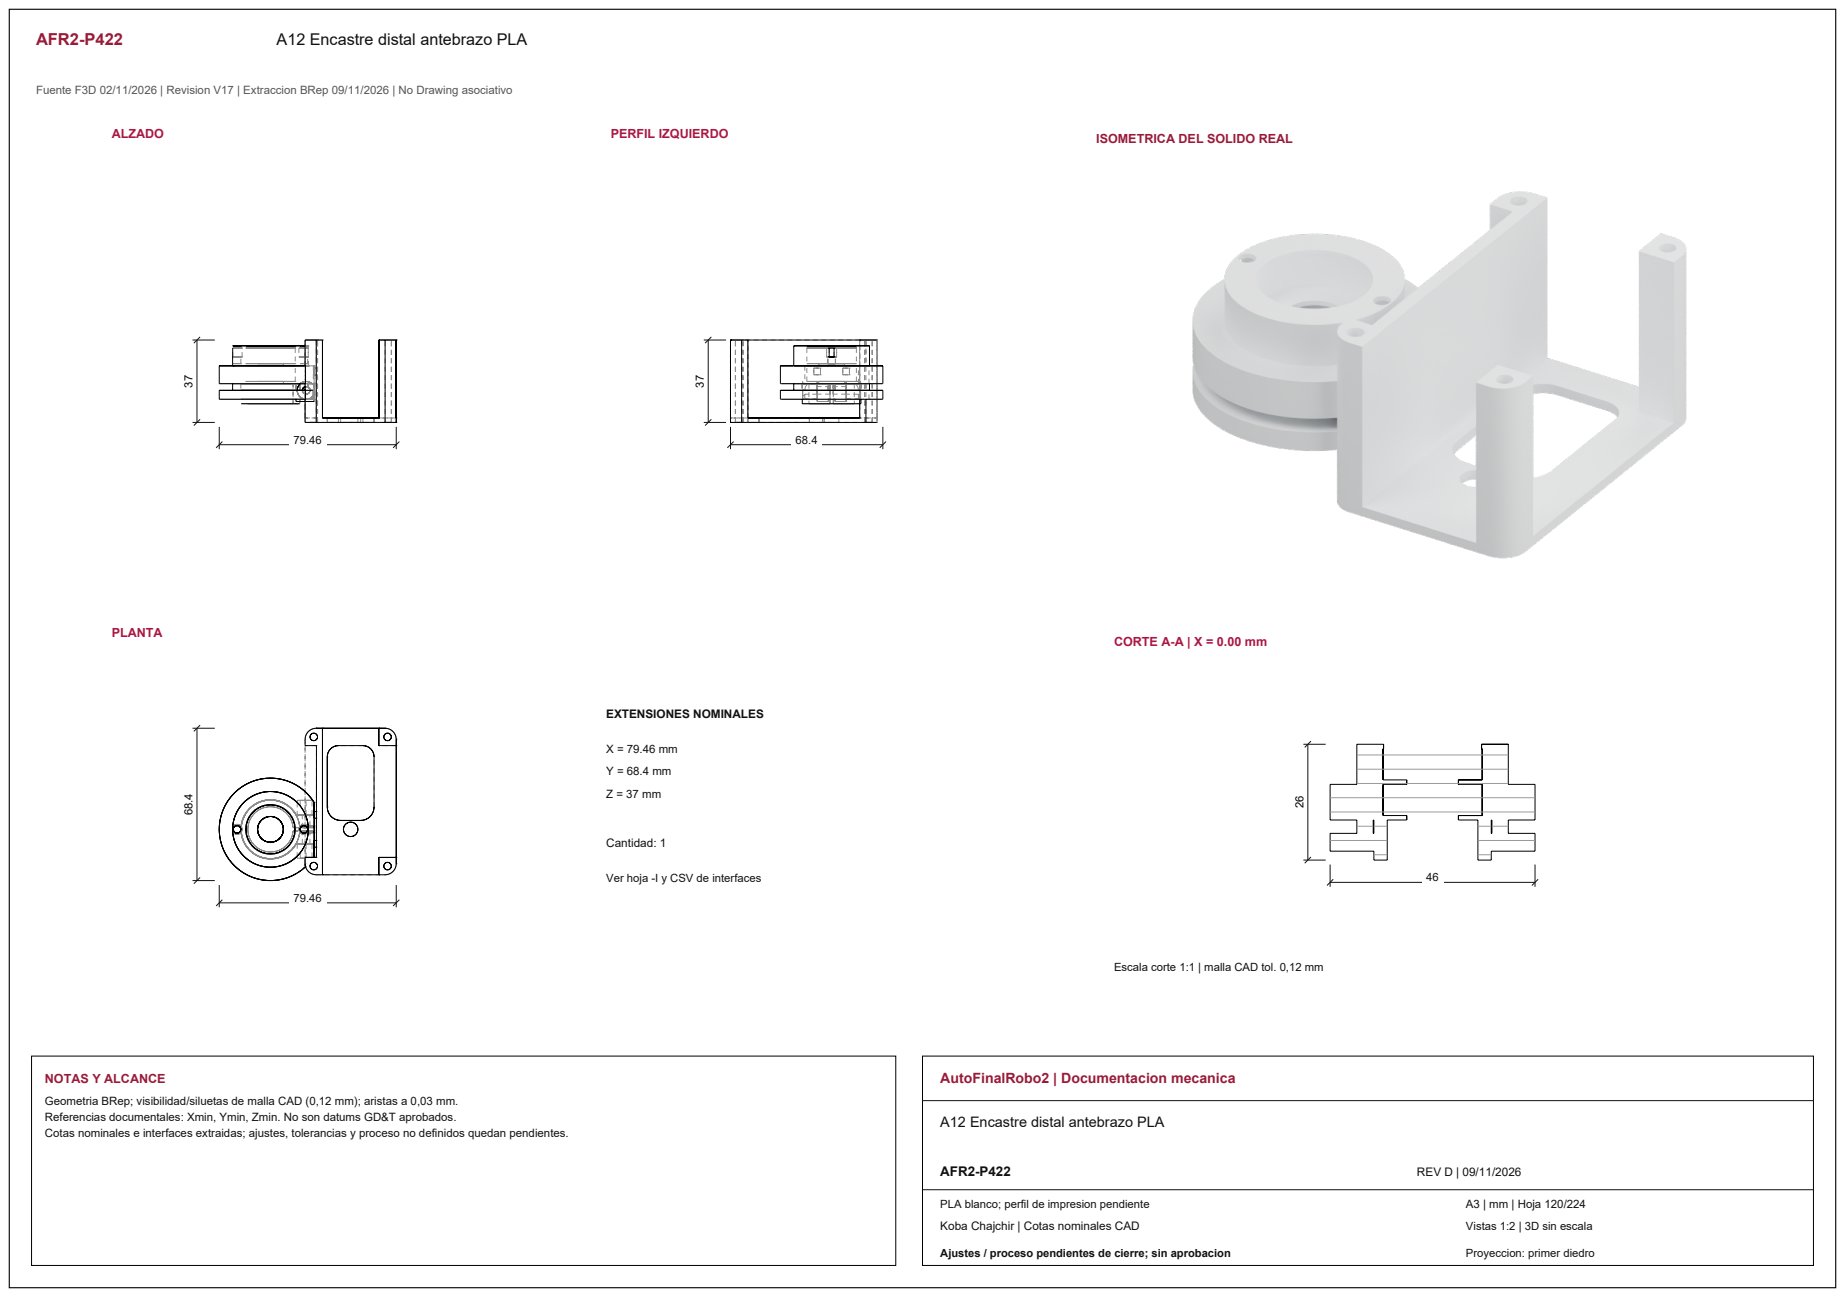
[picture p342: page 19]
ALZADO; PERFIL IZQUIERDO; PLANTA; CORTE A-A | X = 0.00 mm; EXTENSIONES NOMINALES; Cantidad: 1; NOTAS Y ALCANCE; AutoFinalRobo2 | Documentacion mecanica; AFR2-P422; REV D | 09/11/2026

ISOMETRICA DEL SOLIDO REAL

Ver hoja -I y CSV de interfaces

Escala corte 1:1 | malla CAD tol. 0,12 mm

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

A12 Encastre distal antebrazo PLA

PLA blanco; perfil de impresion pendiente

Vistas 1:2 | 3D sin escala

AFR2-P422-I01 | Interfaces y corte | A12 Encastre distal antebrazo PLA

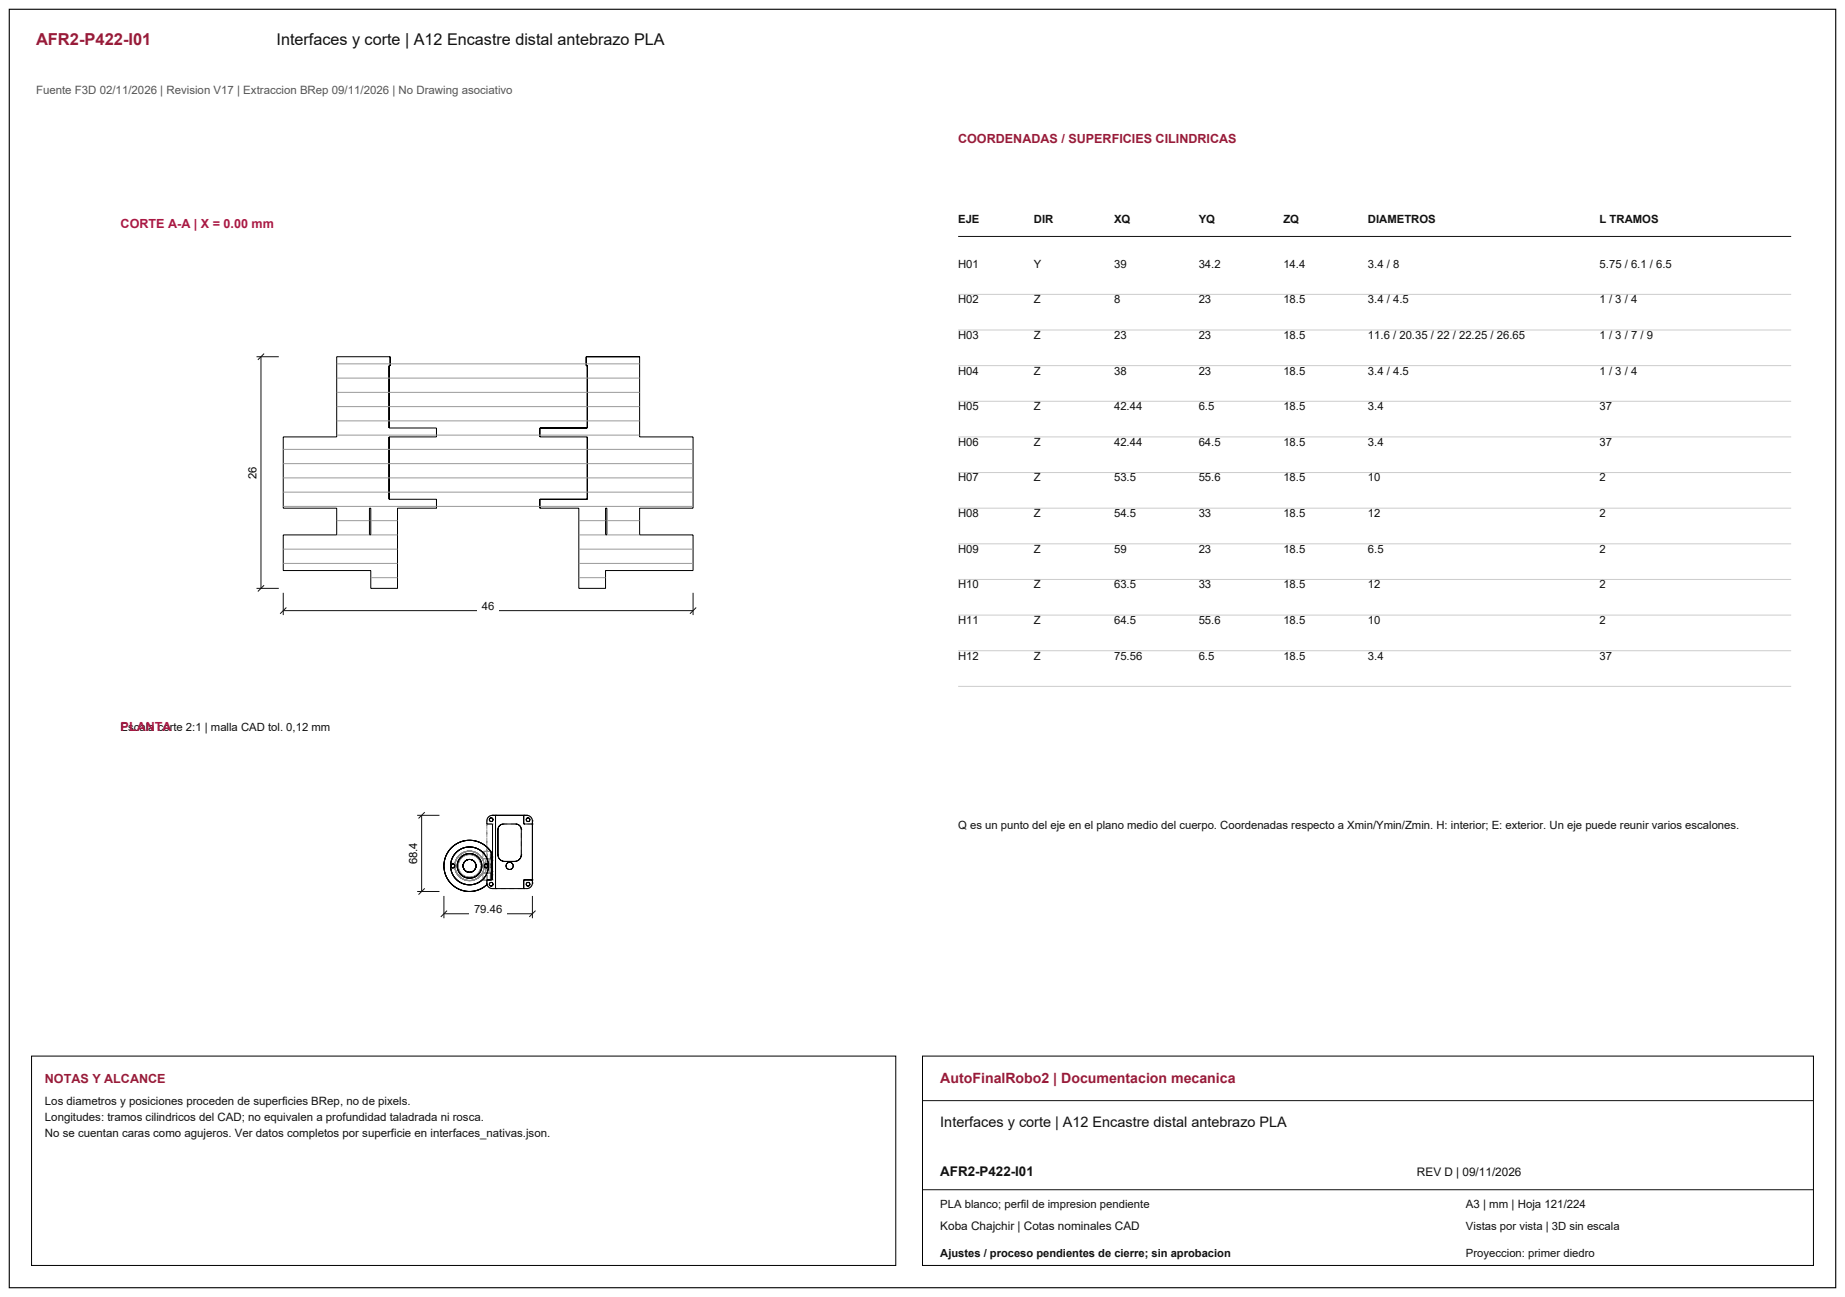
[picture p343: page 20]
CORTE A-A | X = 0.00 mm; EJE; DIR; DIAMETROS; L TRAMOS; NOTAS Y ALCANCE; AutoFinalRobo2 | Documentacion mecanica; AFR2-P422-I01; REV D | 09/11/2026

COORDENADAS / SUPERFICIES CILINDRICAS

Escala corte 2:1 | malla CAD tol. 0,12 mm PLANTA

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

Interfaces y corte | A12 Encastre distal antebrazo PLA

Vistas por vista | 3D sin escala

AFR2-P422-I02 | Interfaces y corte | A12 Encastre distal antebrazo PLA

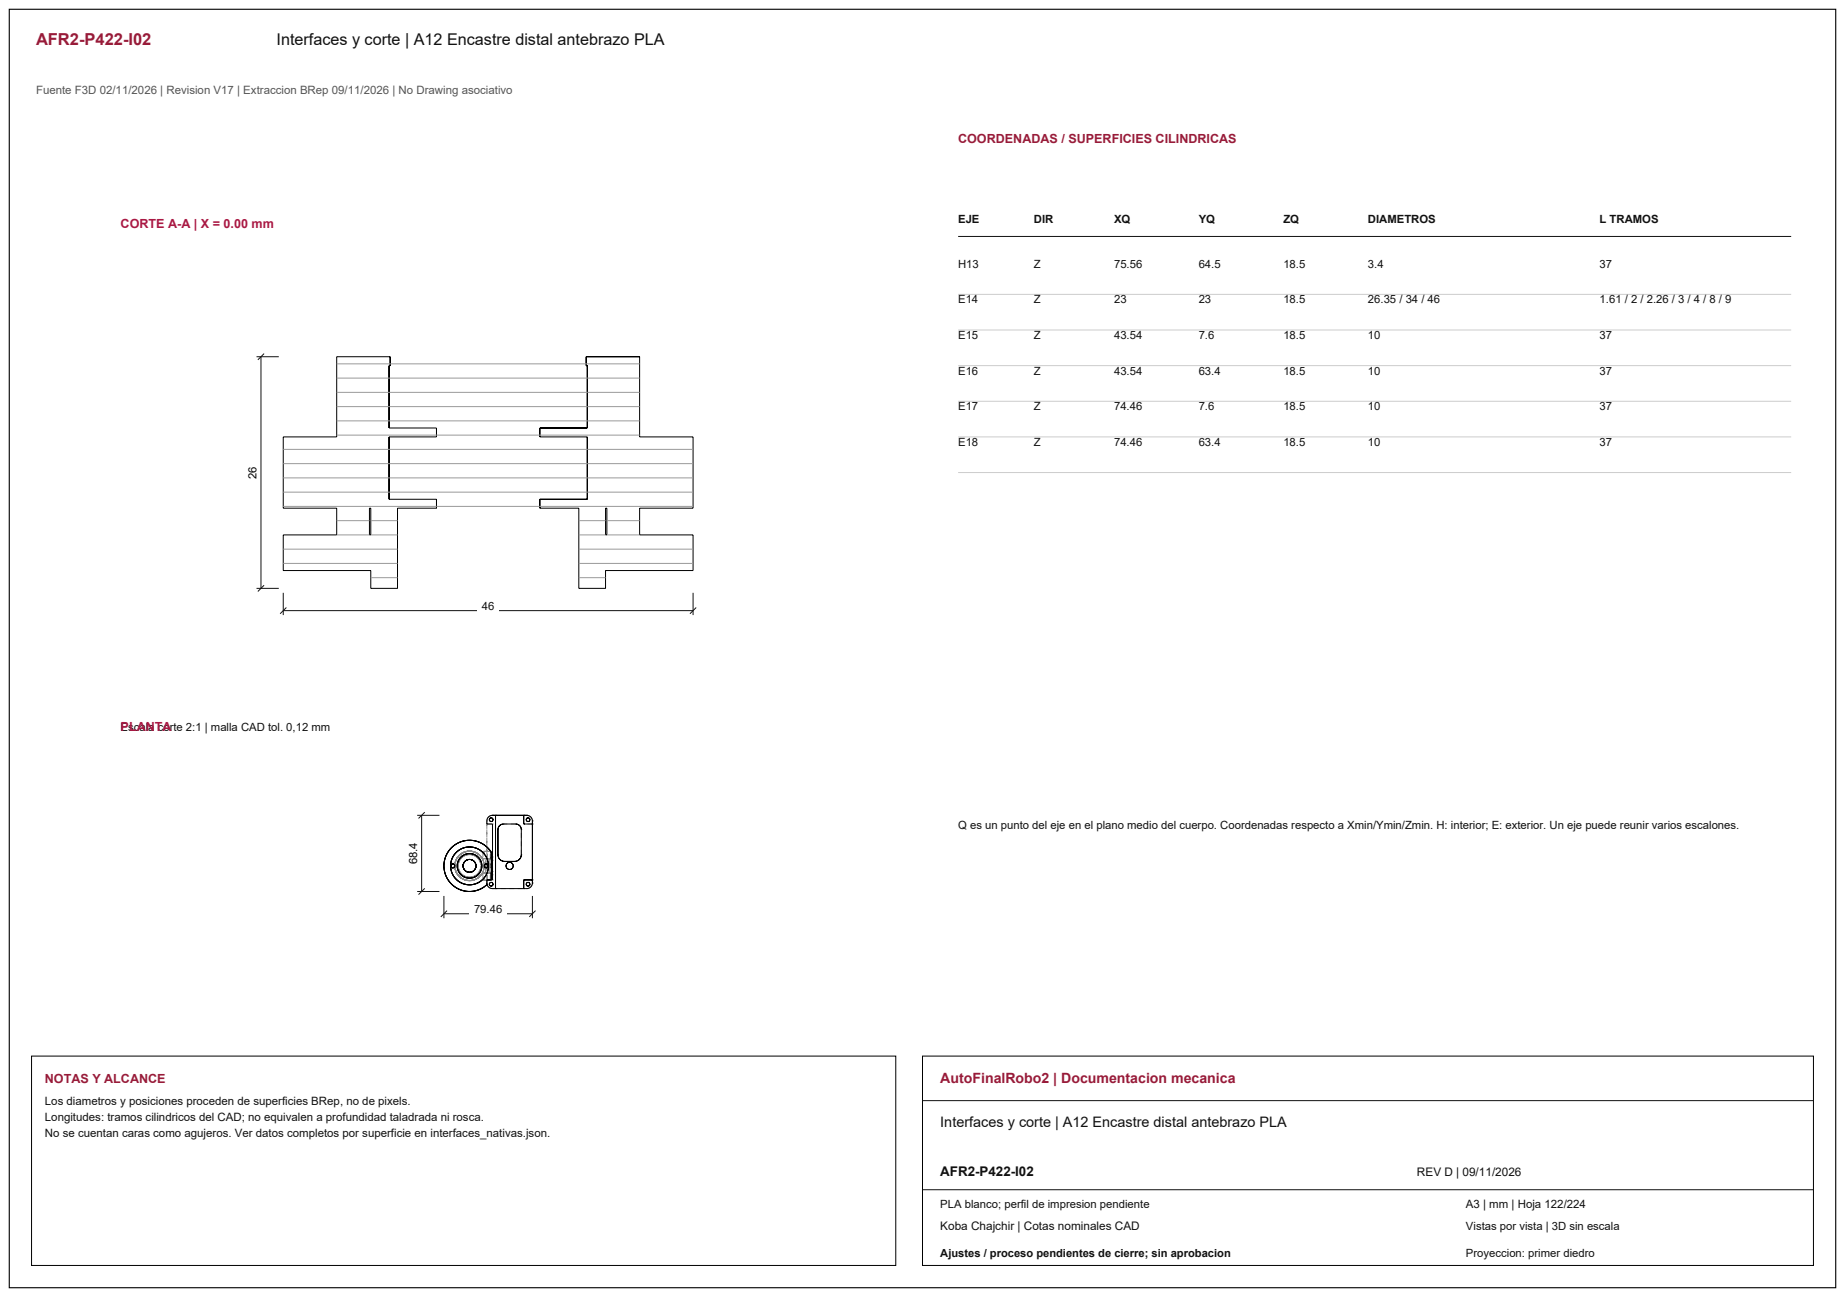
[picture p344: page 21]
CORTE A-A | X = 0.00 mm; EJE; DIR; DIAMETROS; L TRAMOS; NOTAS Y ALCANCE; AutoFinalRobo2 | Documentacion mecanica; AFR2-P422-I02; REV D | 09/11/2026

COORDENADAS / SUPERFICIES CILINDRICAS

Escala corte 2:1 | malla CAD tol. 0,12 mm PLANTA

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

Interfaces y corte | A12 Encastre distal antebrazo PLA

Vistas por vista | 3D sin escala

AFR2-P423 | E02 Eje y brida codo

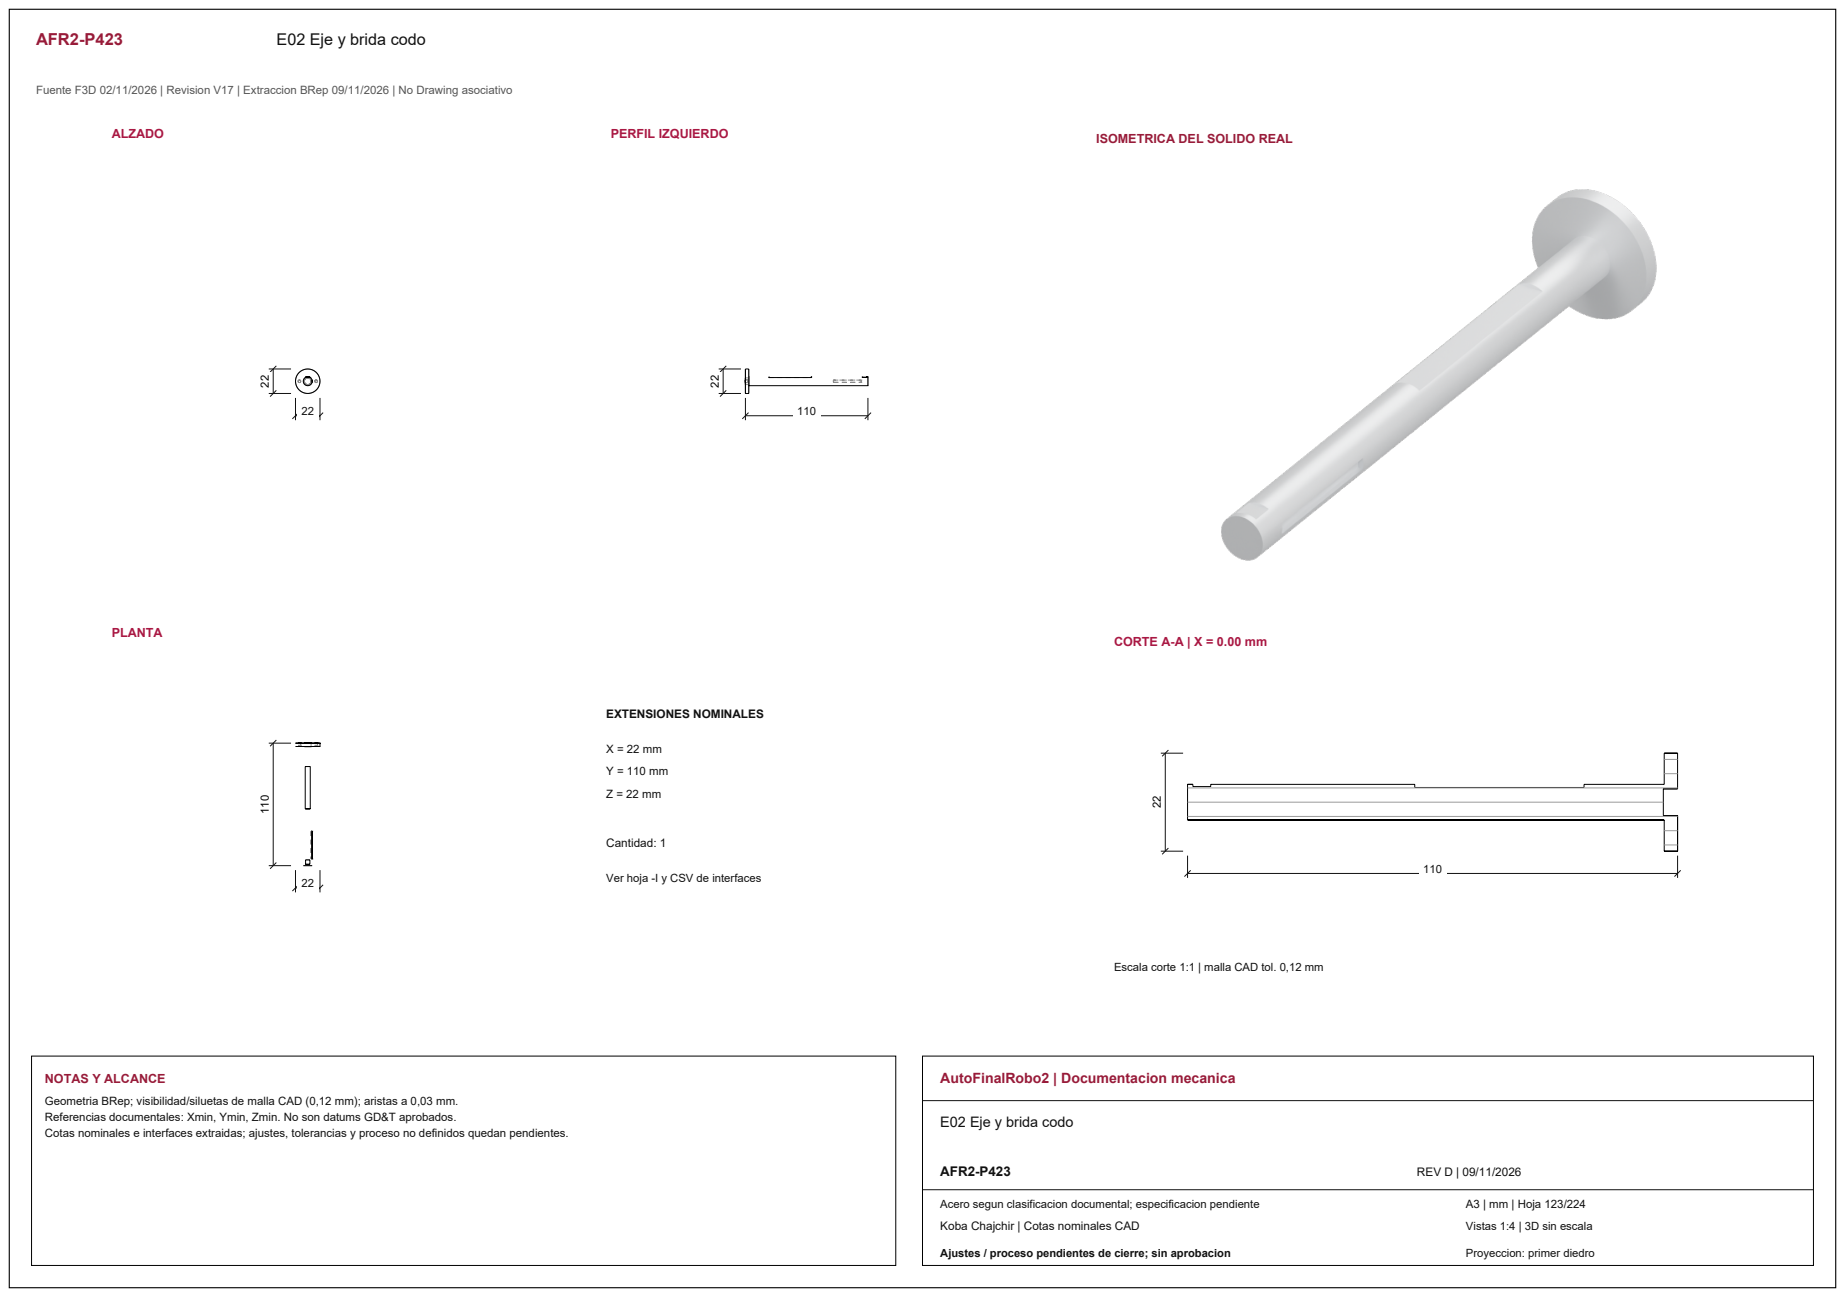
[picture p345: page 22]
ALZADO; PERFIL IZQUIERDO; PLANTA; CORTE A-A | X = 0.00 mm; EXTENSIONES NOMINALES; Cantidad: 1; NOTAS Y ALCANCE; AutoFinalRobo2 | Documentacion mecanica; AFR2-P423; REV D | 09/11/2026

ISOMETRICA DEL SOLIDO REAL

Ver hoja -I y CSV de interfaces

Escala corte 1:1 | malla CAD tol. 0,12 mm

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

E02 Eje y brida codo

Acero segun clasificacion documental; especificacion pendiente

Vistas 1:4 | 3D sin escala

AFR2-P423-I01 | Interfaces y corte | E02 Eje y brida codo

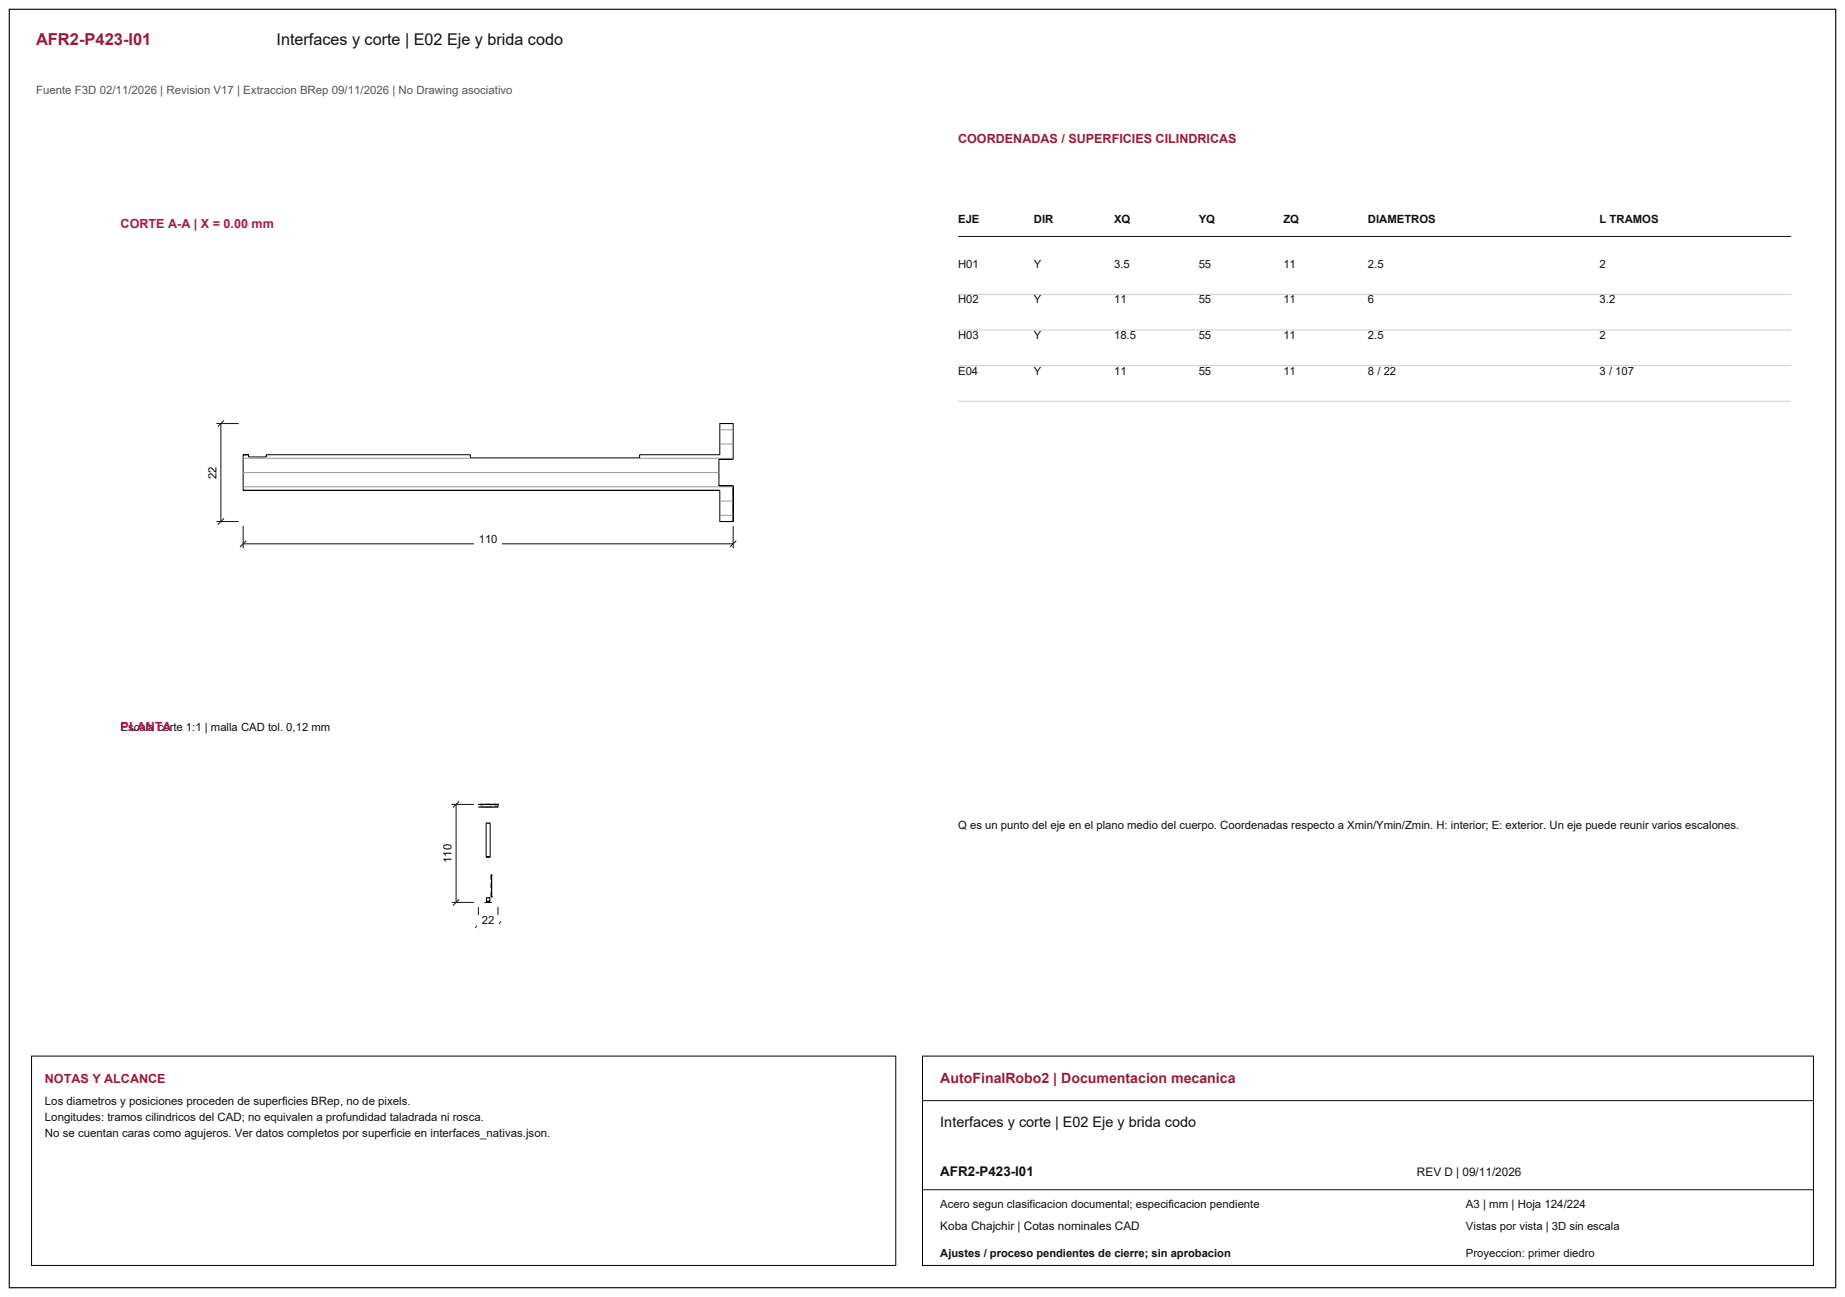
[picture p346: page 23]
CORTE A-A | X = 0.00 mm; EJE; DIR; DIAMETROS; L TRAMOS; NOTAS Y ALCANCE; AutoFinalRobo2 | Documentacion mecanica; AFR2-P423-I01; REV D | 09/11/2026

COORDENADAS / SUPERFICIES CILINDRICAS

Escala corte 1:1 | malla CAD tol. 0,12 mm PLANTA

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

Interfaces y corte | E02 Eje y brida codo

Acero segun clasificacion documental; especificacion pendiente

Vistas por vista | 3D sin escala

AFR2-P424 | Tapa 608 J4

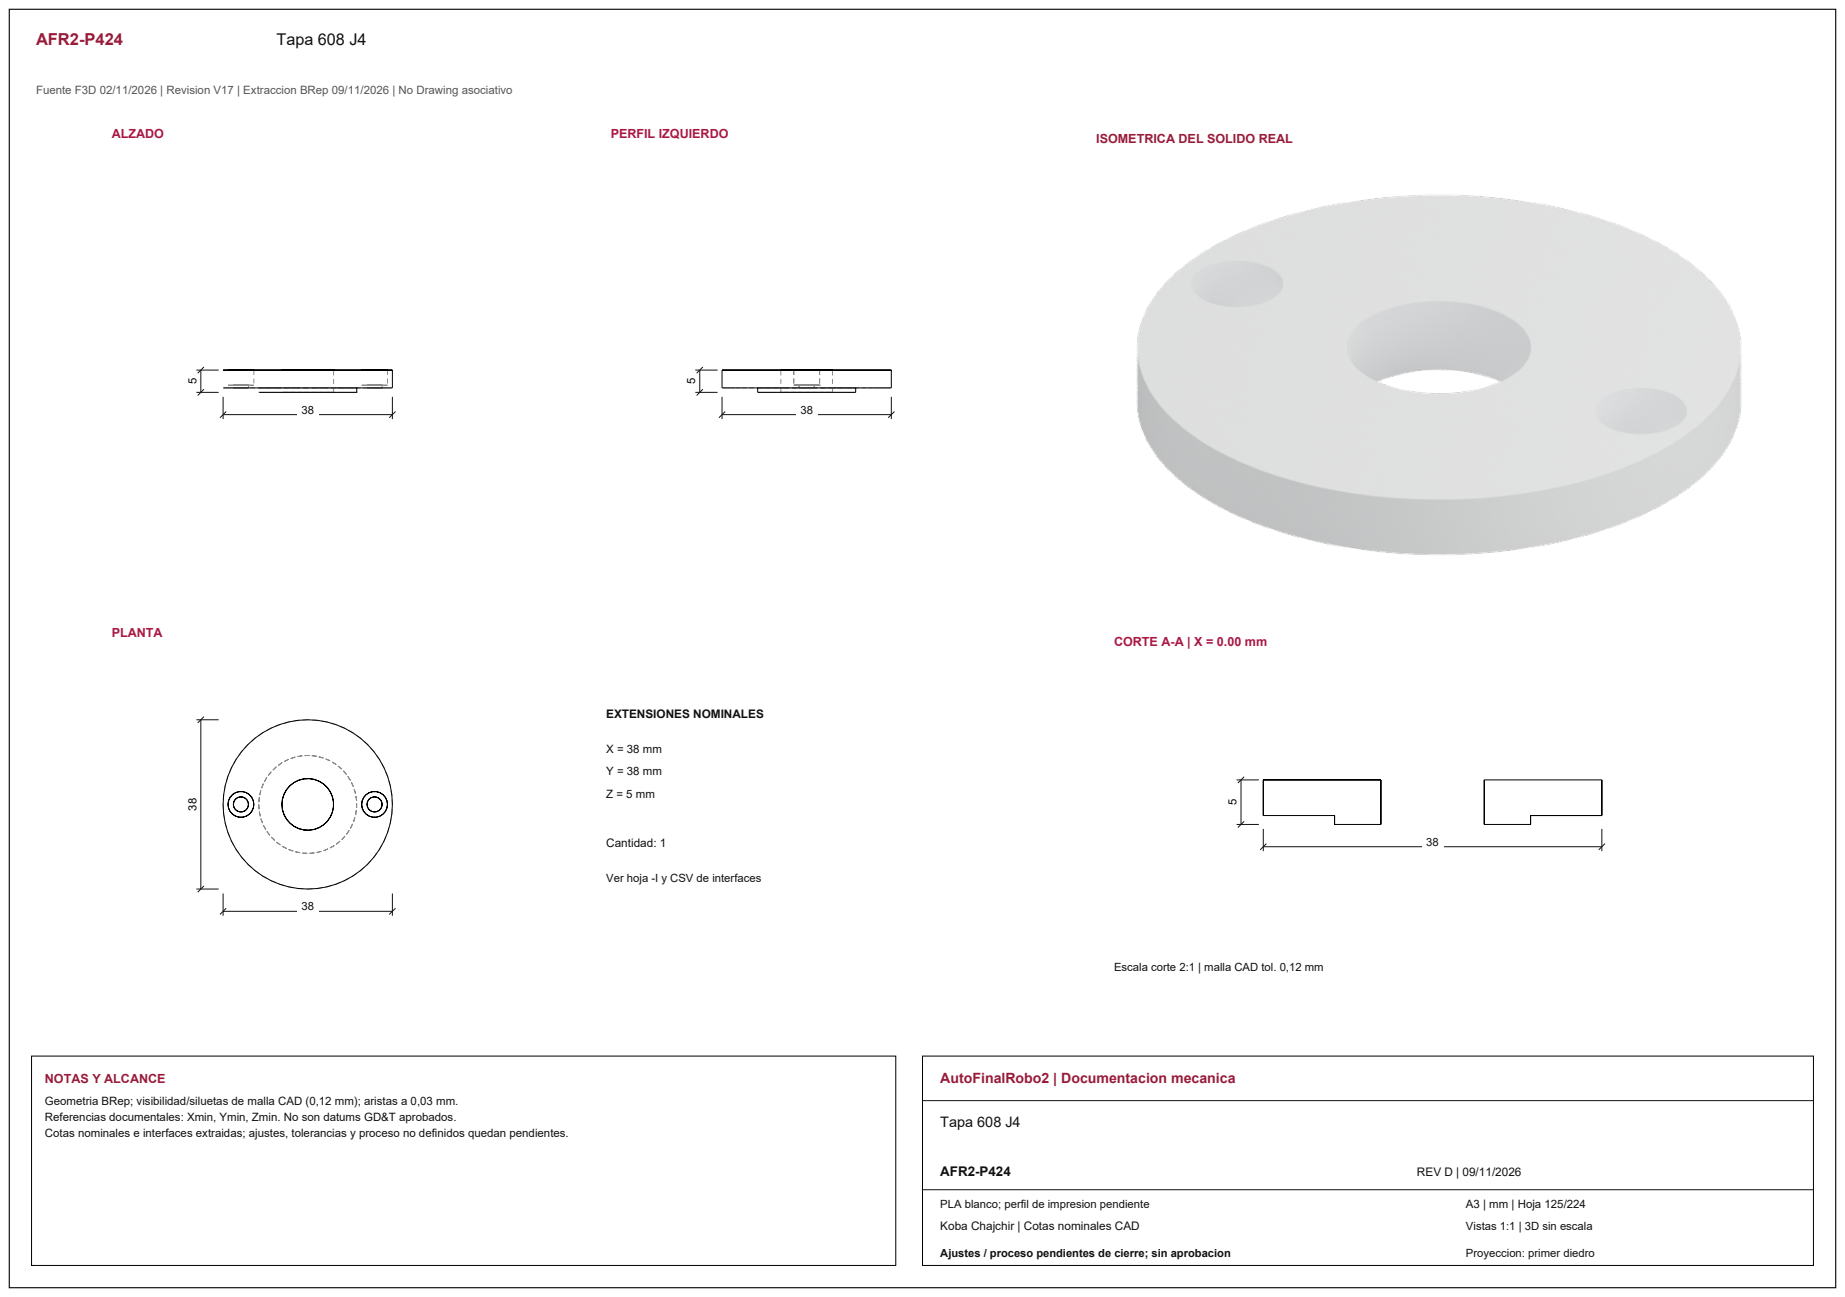
[picture p347: page 24]
ALZADO; PERFIL IZQUIERDO; PLANTA; CORTE A-A | X = 0.00 mm; EXTENSIONES NOMINALES; Cantidad: 1; NOTAS Y ALCANCE; AutoFinalRobo2 | Documentacion mecanica; Tapa 608 J4; AFR2-P424; REV D | 09/11/2026

ISOMETRICA DEL SOLIDO REAL

Ver hoja -I y CSV de interfaces

Escala corte 2:1 | malla CAD tol. 0,12 mm

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

Vistas 1:1 | 3D sin escala

AFR2-P424-I01 | Interfaces y corte | Tapa 608 J4

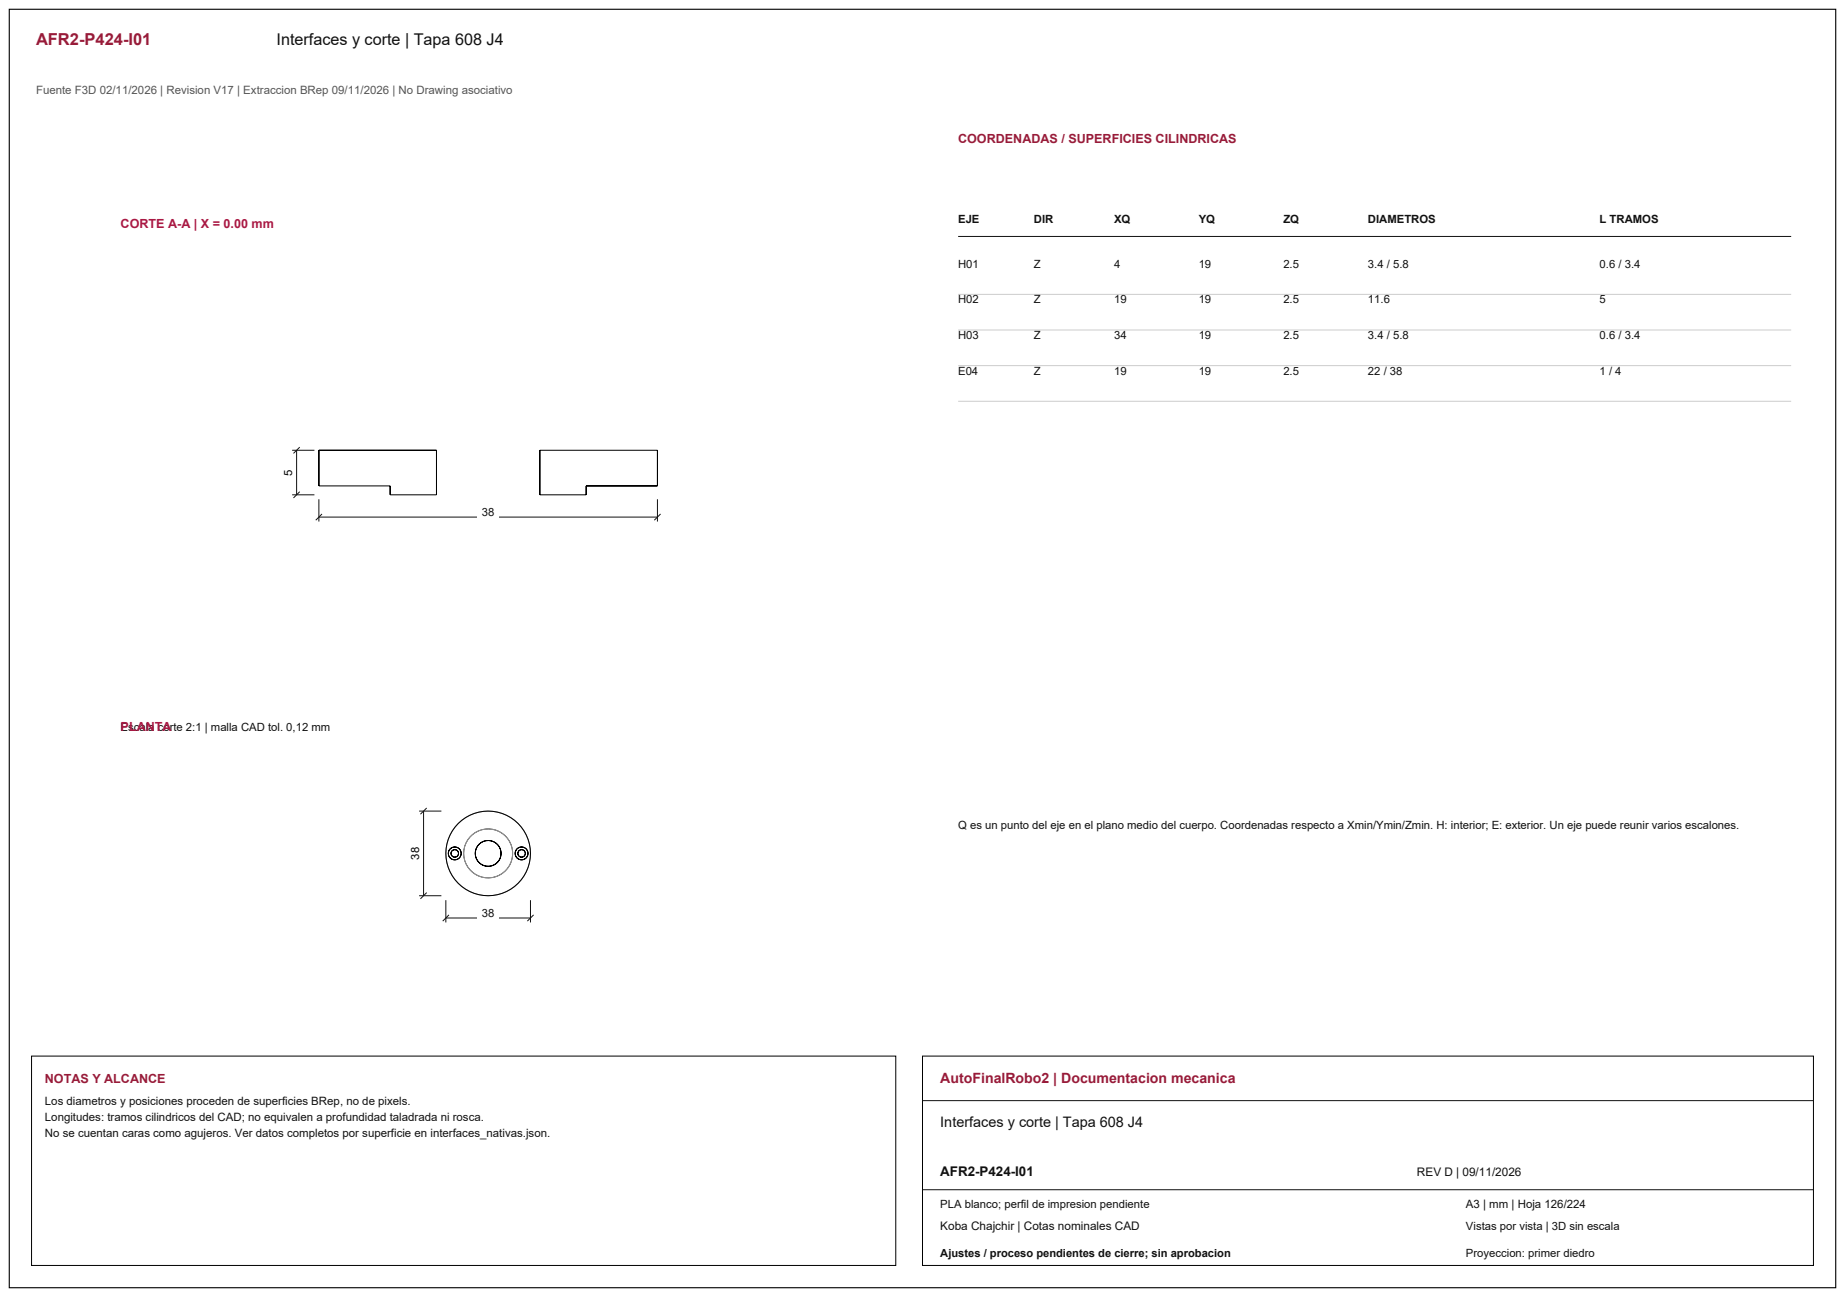
[picture p348: page 25]
CORTE A-A | X = 0.00 mm; EJE; DIR; DIAMETROS; L TRAMOS; NOTAS Y ALCANCE; AutoFinalRobo2 | Documentacion mecanica; AFR2-P424-I01; REV D | 09/11/2026

COORDENADAS / SUPERFICIES CILINDRICAS

Escala corte 2:1 | malla CAD tol. 0,12 mm PLANTA

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

Interfaces y corte | Tapa 608 J4

Vistas por vista | 3D sin escala

AFR2-P425 | Separador 8mm delantero (1)

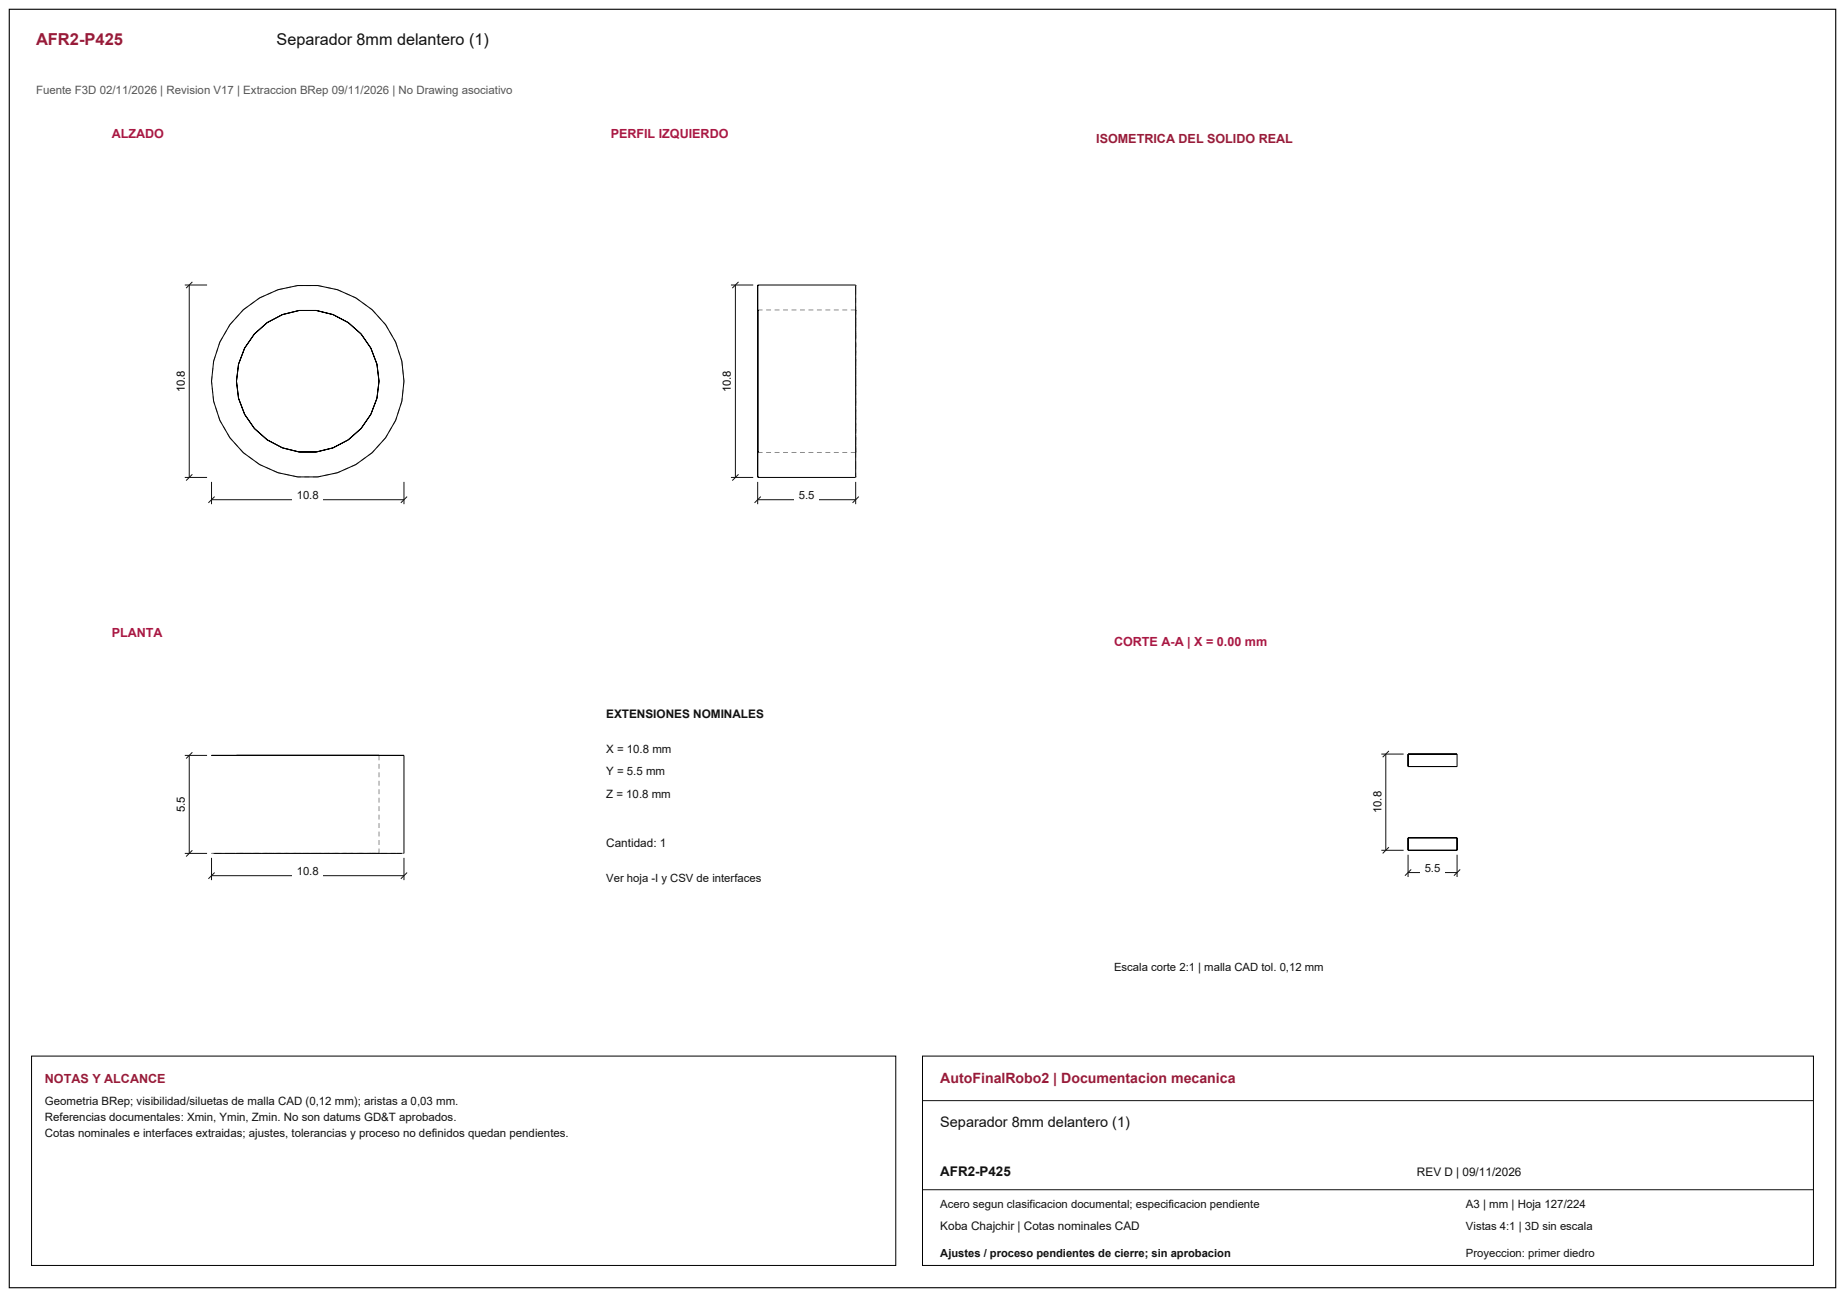
[picture p349: page 26]
ALZADO; PERFIL IZQUIERDO; PLANTA; CORTE A-A | X = 0.00 mm; EXTENSIONES NOMINALES; Cantidad: 1; NOTAS Y ALCANCE; AutoFinalRobo2 | Documentacion mecanica; Separador 8mm delantero (1); AFR2-P425; REV D | 09/11/2026

ISOMETRICA DEL SOLIDO REAL

Ver hoja -I y CSV de interfaces

Escala corte 2:1 | malla CAD tol. 0,12 mm

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

Acero segun clasificacion documental; especificacion pendiente

Vistas 4:1 | 3D sin escala

AFR2-P425-I01 | Interfaces y corte | Separador 8mm delantero (1)

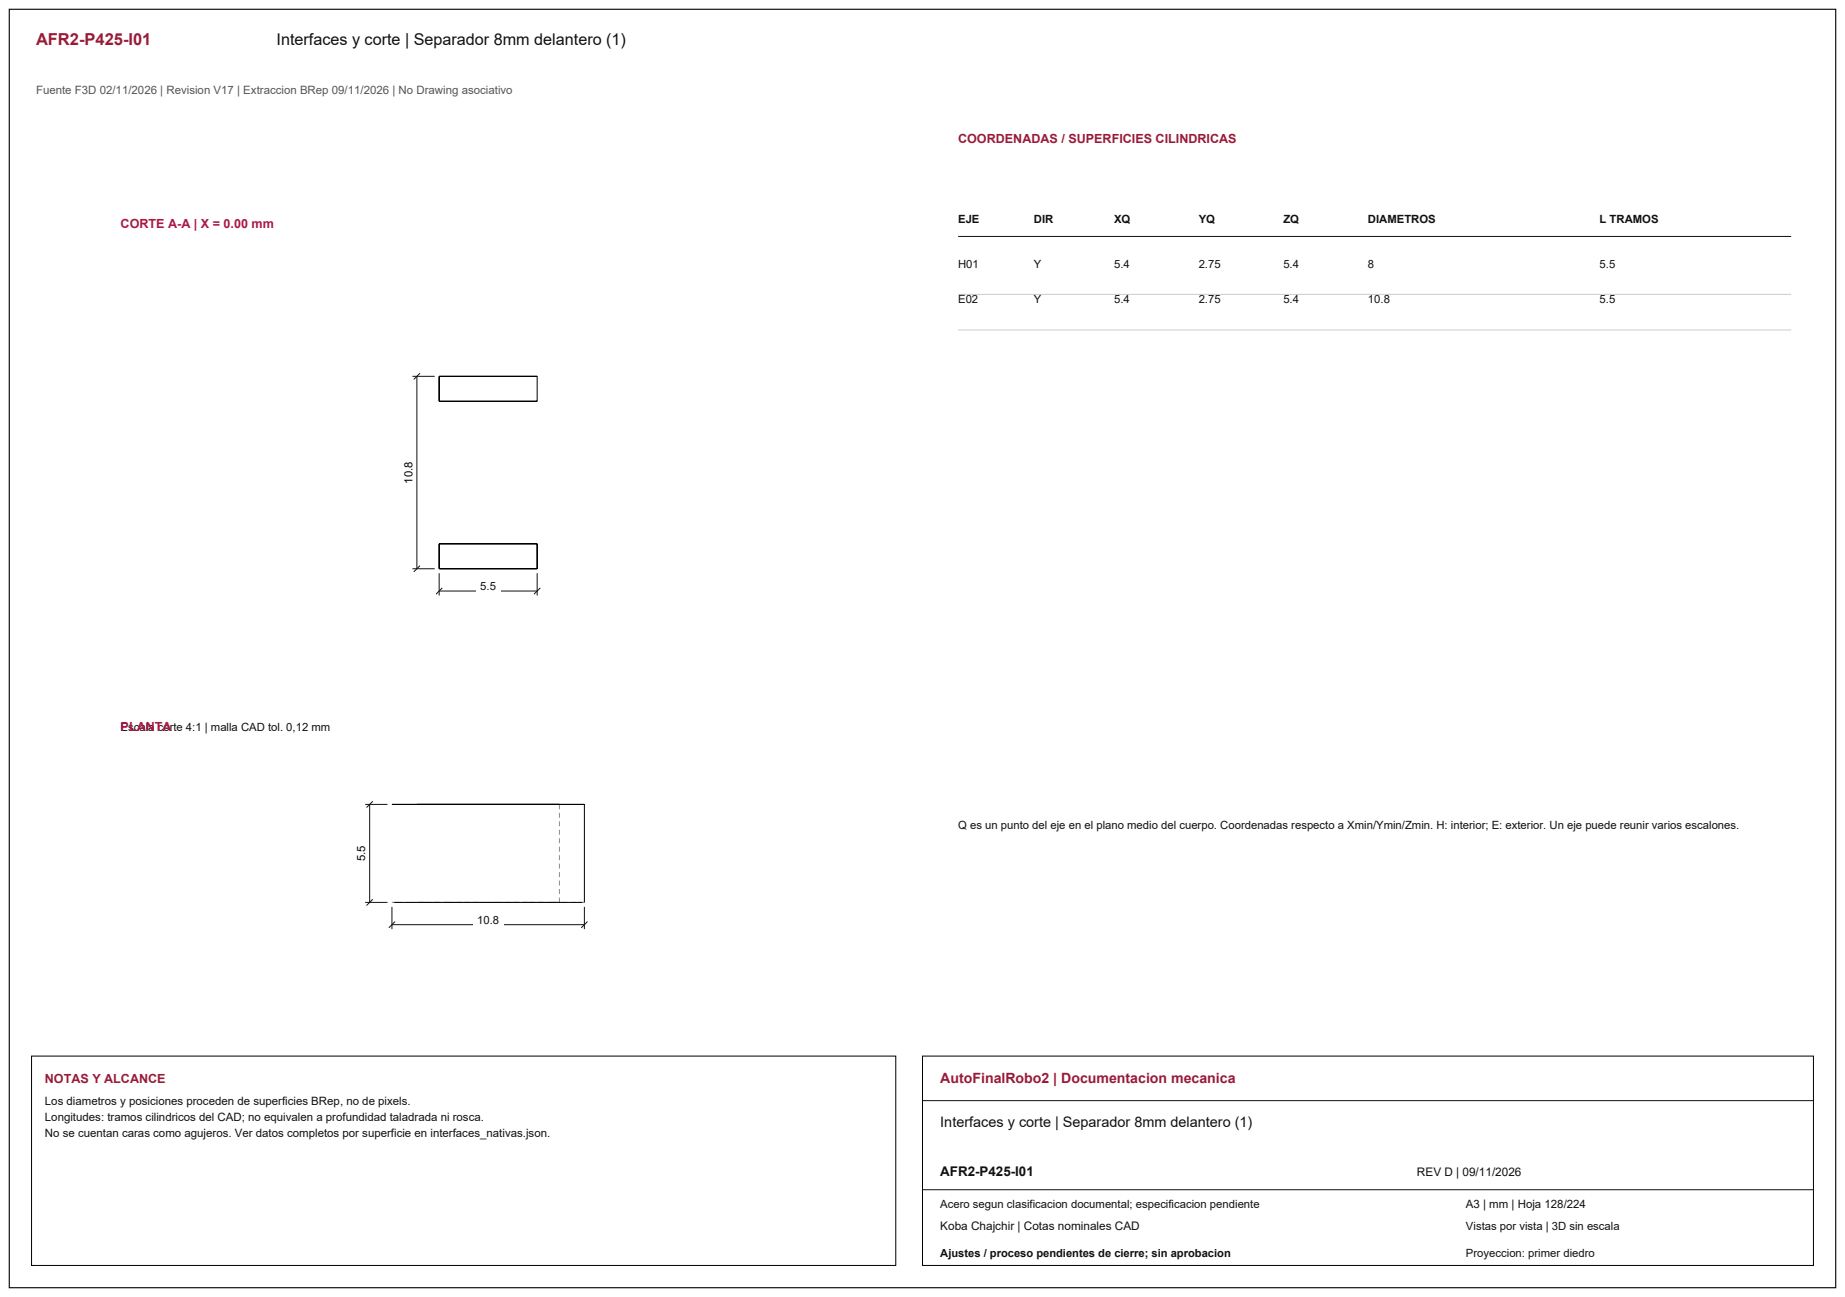
[picture p350: page 27]
CORTE A-A | X = 0.00 mm; EJE; DIR; DIAMETROS; L TRAMOS; NOTAS Y ALCANCE; AutoFinalRobo2 | Documentacion mecanica; AFR2-P425-I01; REV D | 09/11/2026

COORDENADAS / SUPERFICIES CILINDRICAS

Escala corte 4:1 | malla CAD tol. 0,12 mm PLANTA

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

Interfaces y corte | Separador 8mm delantero (1)

Acero segun clasificacion documental; especificacion pendiente

Vistas por vista | 3D sin escala

AFR2-P427 | Separador codo trasero

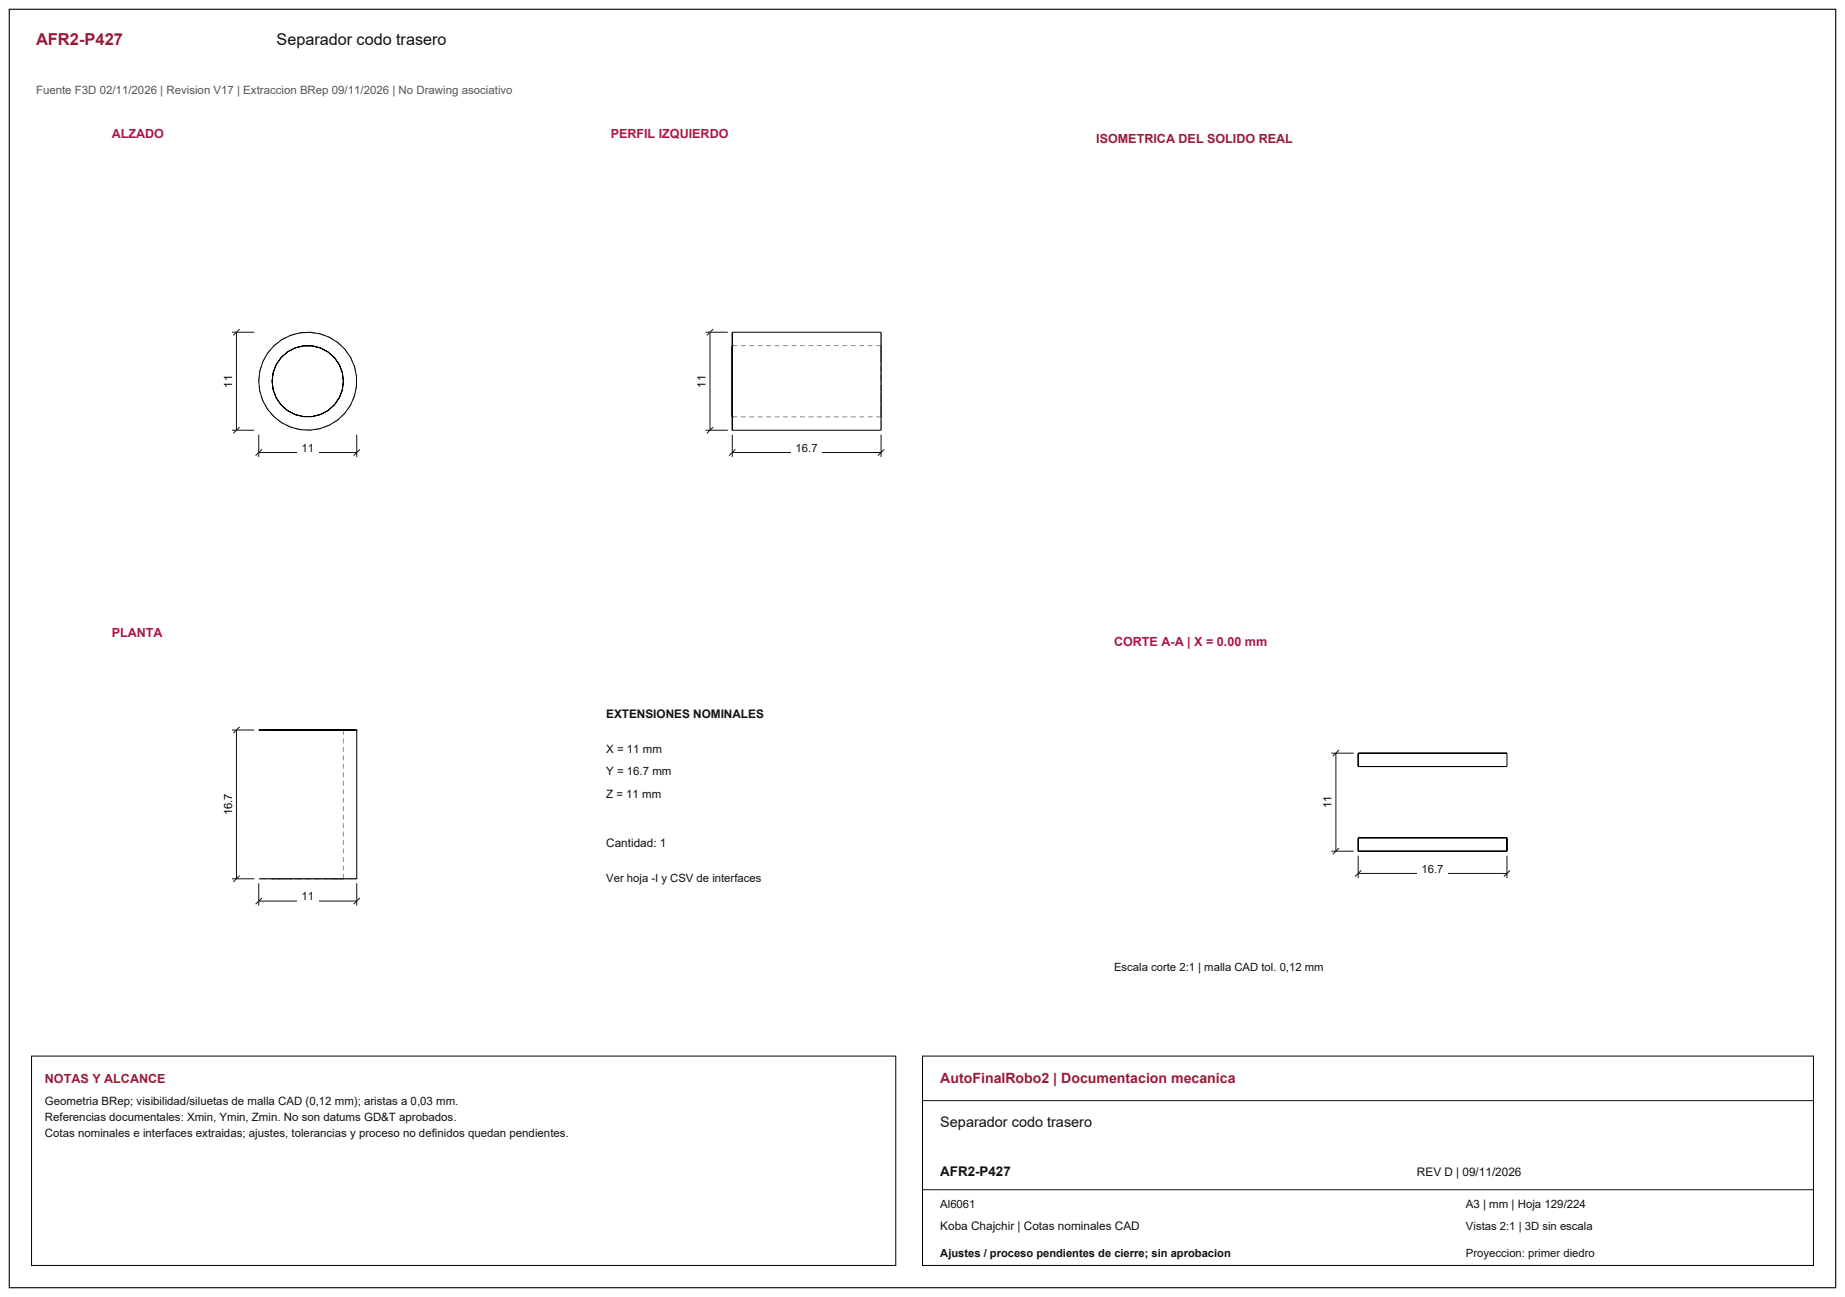
[picture p351: page 28]
ALZADO; PERFIL IZQUIERDO; PLANTA; CORTE A-A | X = 0.00 mm; EXTENSIONES NOMINALES; Cantidad: 1; NOTAS Y ALCANCE; AutoFinalRobo2 | Documentacion mecanica; AFR2-P427; REV D | 09/11/2026

ISOMETRICA DEL SOLIDO REAL

Ver hoja -I y CSV de interfaces

Escala corte 2:1 | malla CAD tol. 0,12 mm

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

Separador codo trasero

Vistas 2:1 | 3D sin escala

AFR2-P427-I01 | Interfaces y corte | Separador codo trasero

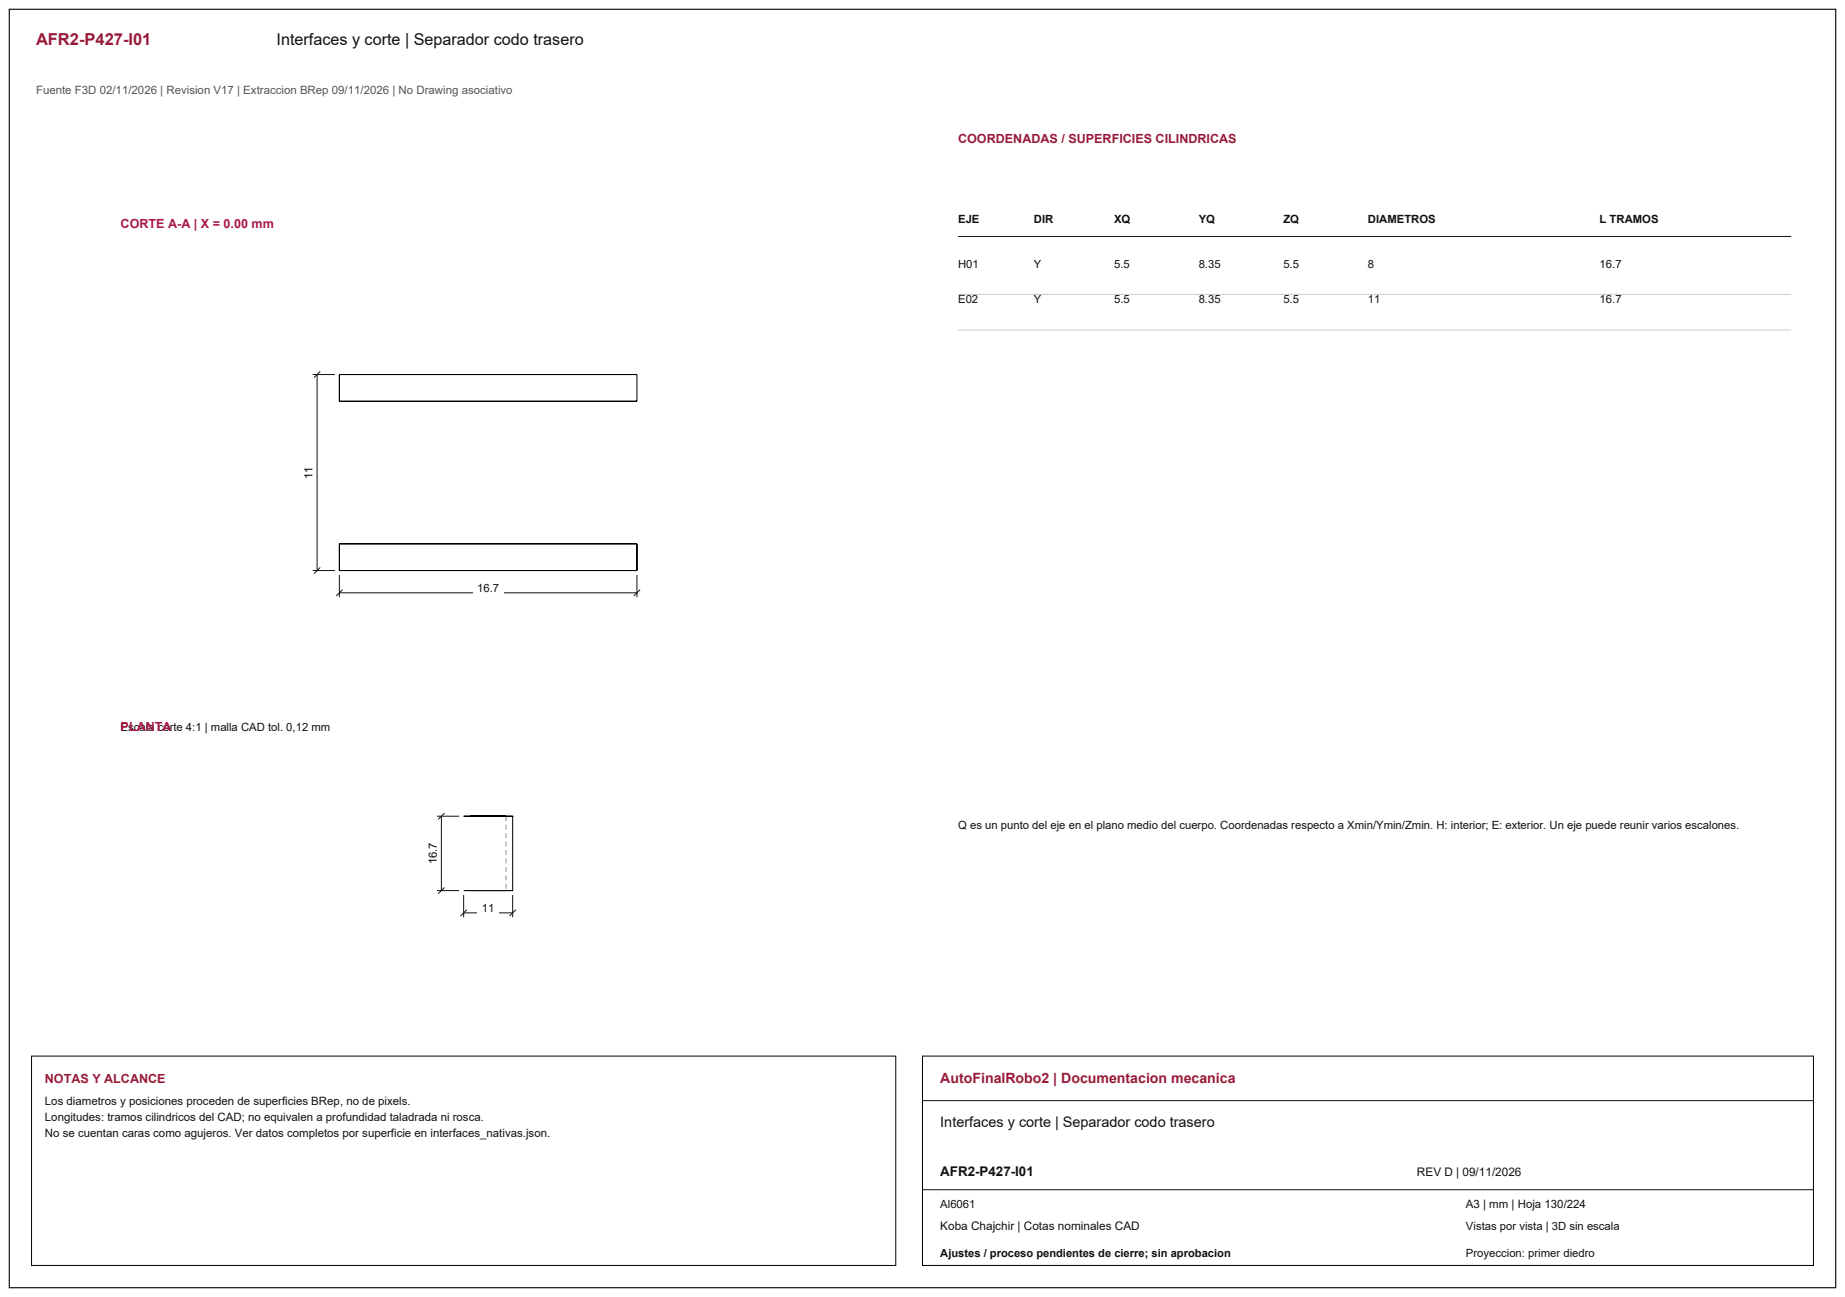
[picture p352: page 29]
CORTE A-A | X = 0.00 mm; EJE; DIR; DIAMETROS; L TRAMOS; NOTAS Y ALCANCE; AutoFinalRobo2 | Documentacion mecanica; AFR2-P427-I01; REV D | 09/11/2026

COORDENADAS / SUPERFICIES CILINDRICAS

Escala corte 4:1 | malla CAD tol. 0,12 mm PLANTA

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

Interfaces y corte | Separador codo trasero

Vistas por vista | 3D sin escala

AFR2-P430 | A11 Encastre proximal antebrazo PLA

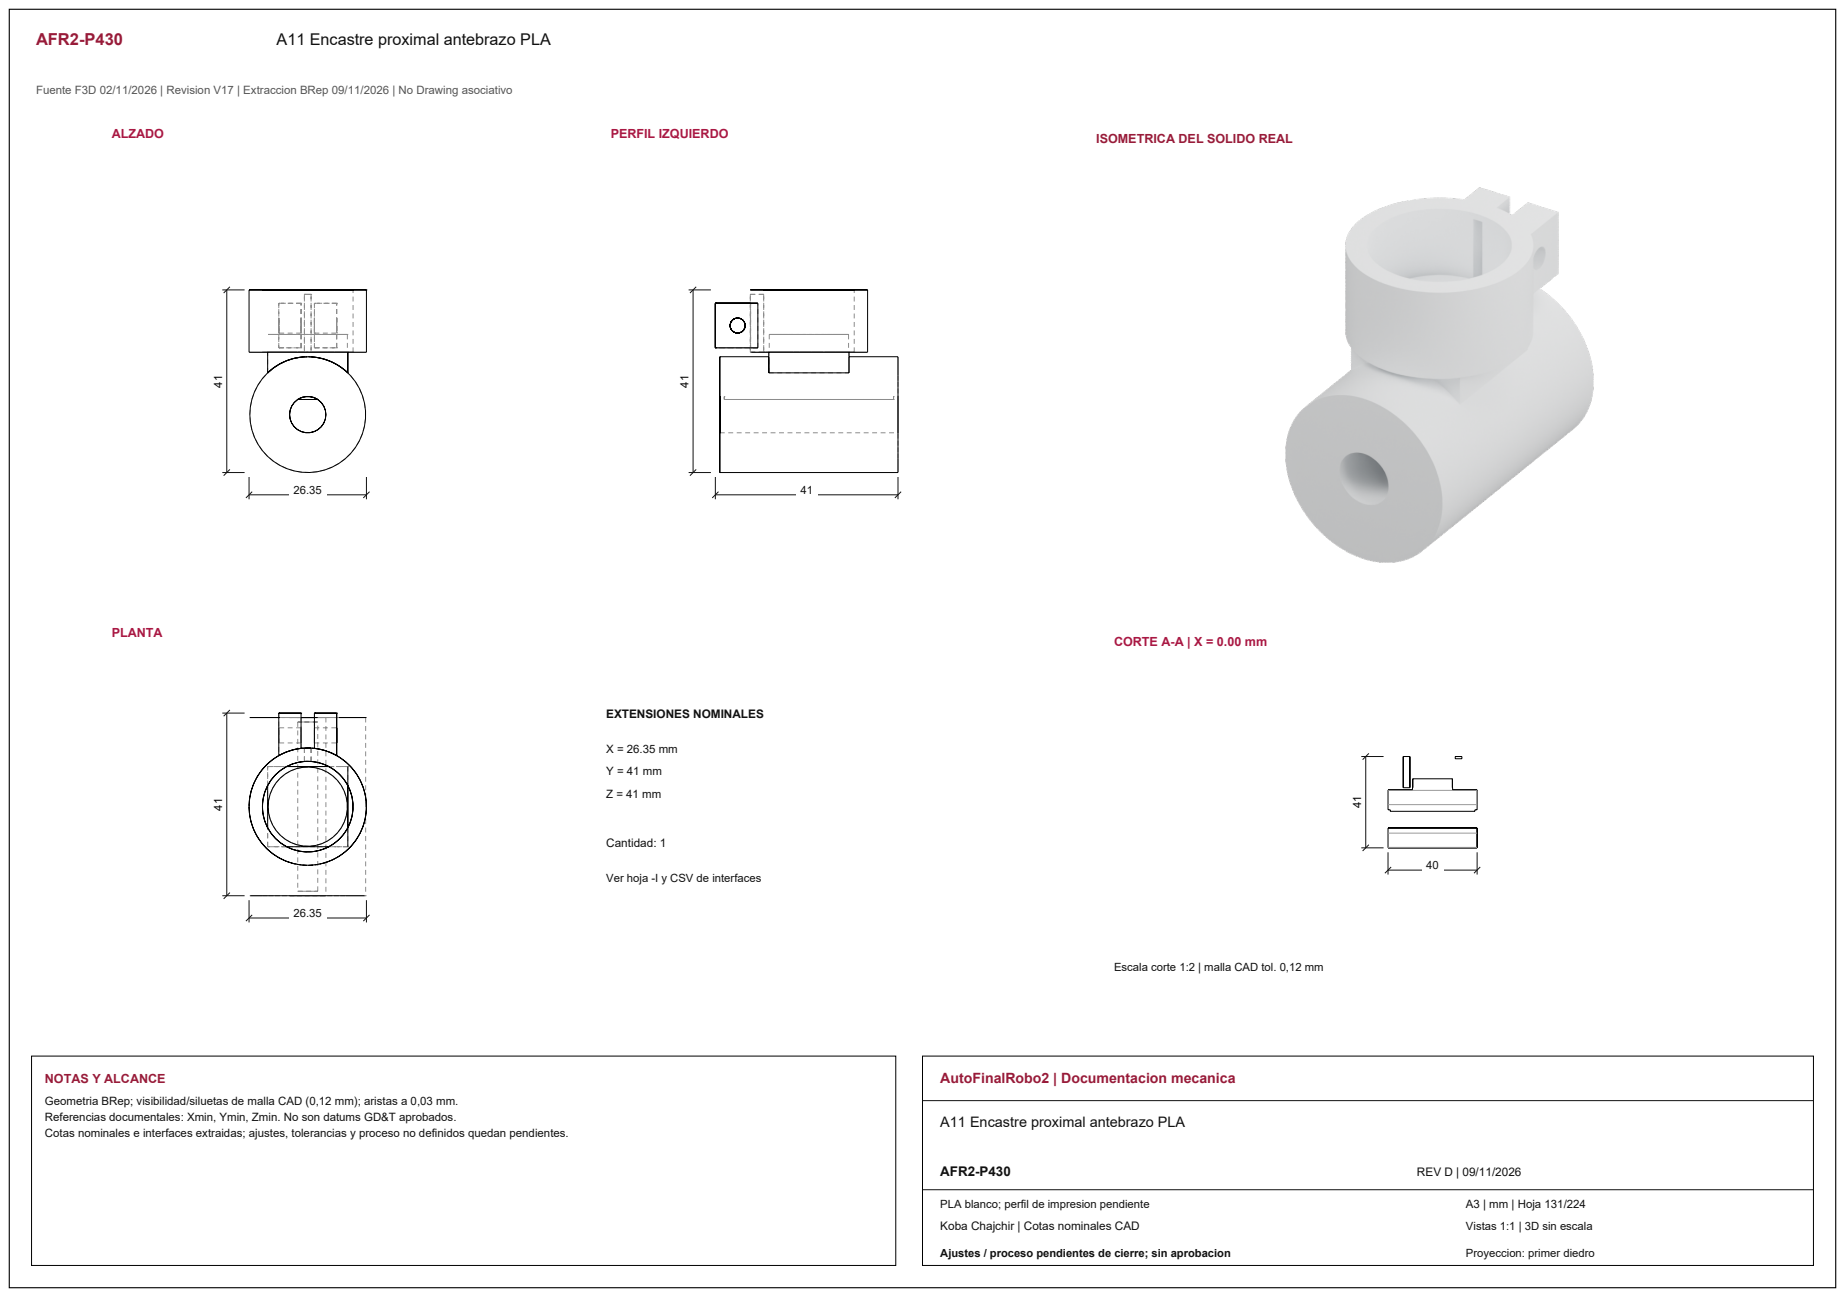
[picture p353: page 30]
ALZADO; PERFIL IZQUIERDO; PLANTA; CORTE A-A | X = 0.00 mm; EXTENSIONES NOMINALES; Cantidad: 1; NOTAS Y ALCANCE; AutoFinalRobo2 | Documentacion mecanica; AFR2-P430; REV D | 09/11/2026

ISOMETRICA DEL SOLIDO REAL

Ver hoja -I y CSV de interfaces

Escala corte 1:2 | malla CAD tol. 0,12 mm

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

A11 Encastre proximal antebrazo PLA

Vistas 1:1 | 3D sin escala

AFR2-P430-I01 | Interfaces y corte | A11 Encastre proximal antebrazo PLA

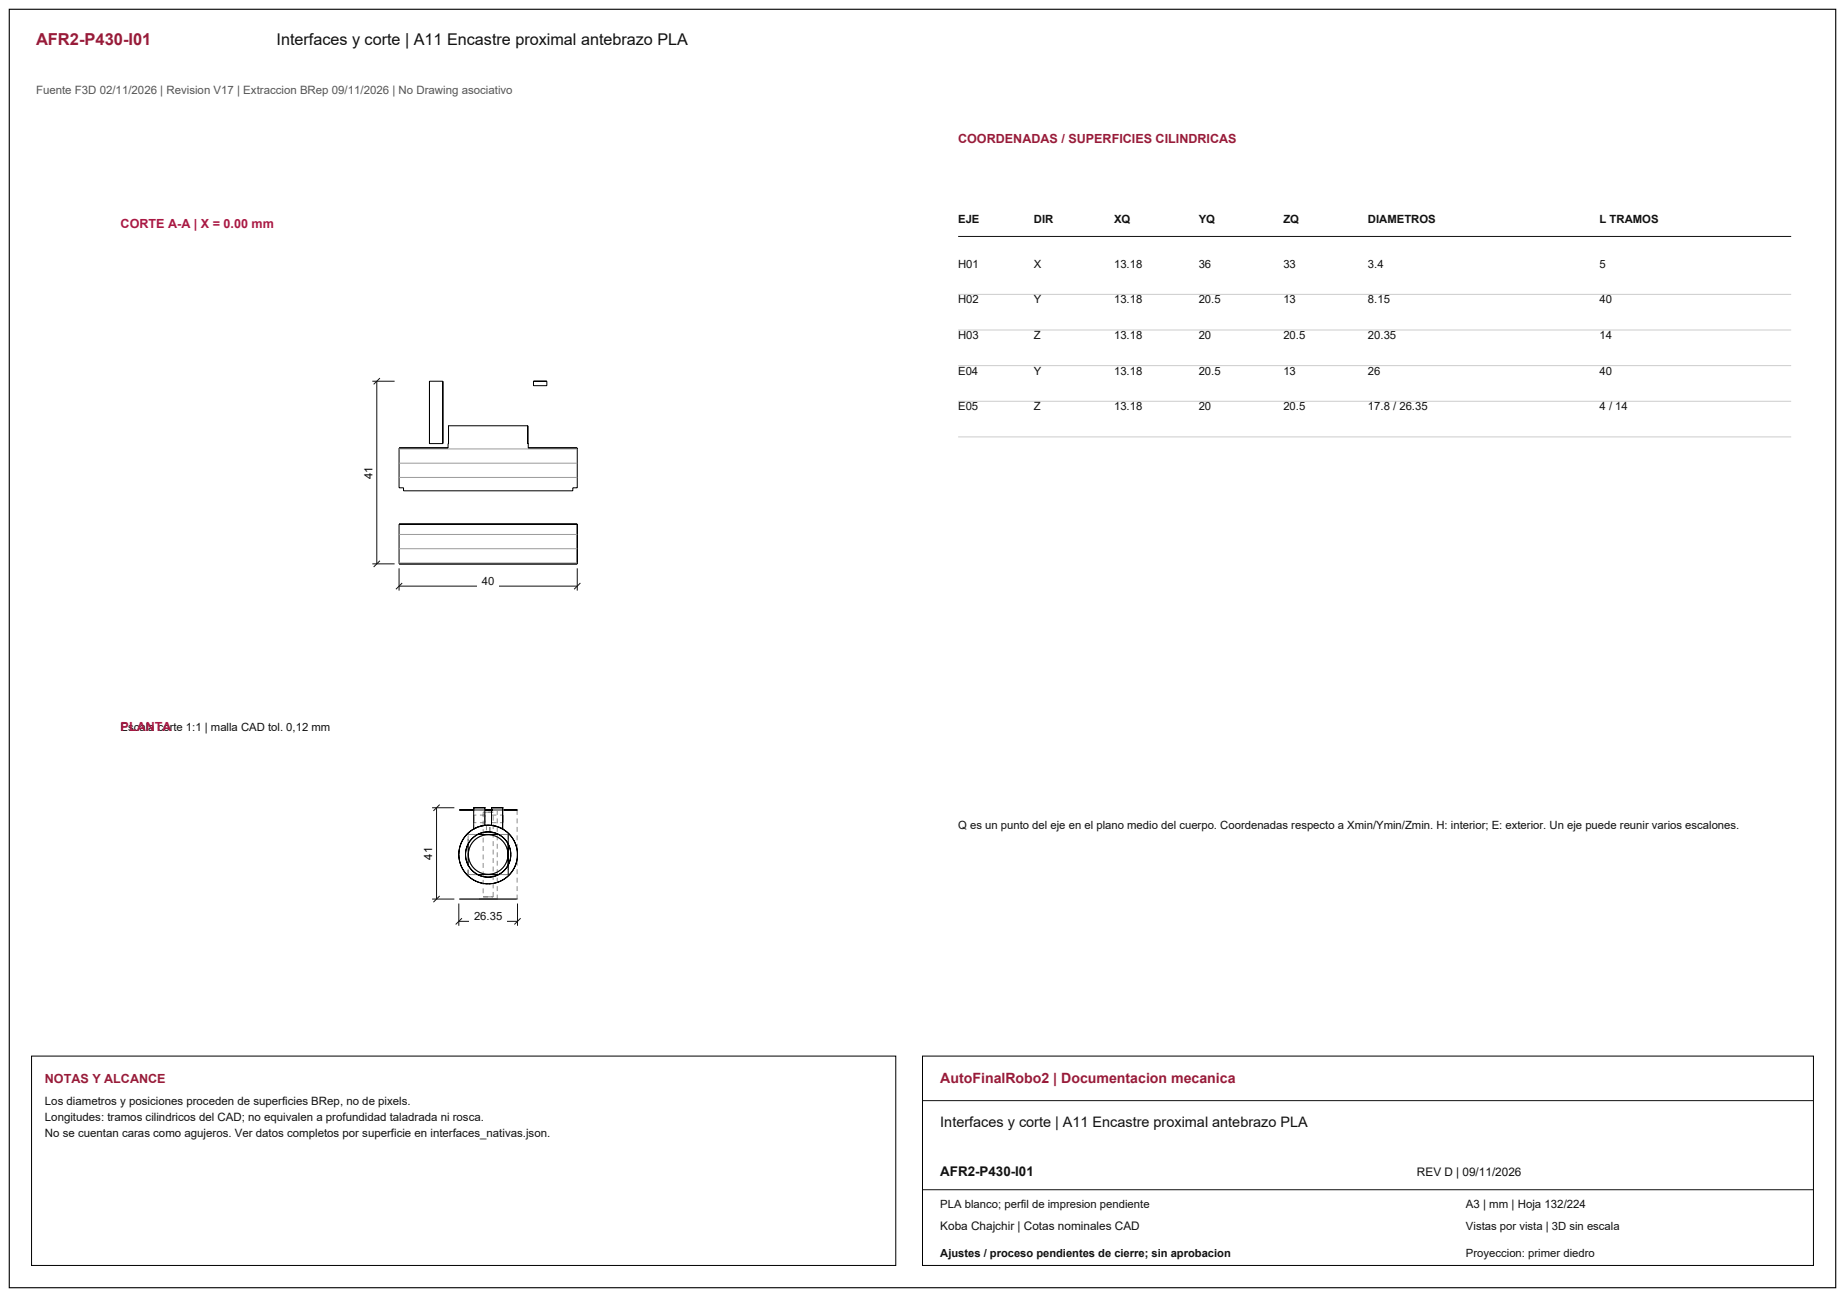
[picture p354: page 31]
CORTE A-A | X = 0.00 mm; EJE; DIR; DIAMETROS; L TRAMOS; NOTAS Y ALCANCE; AutoFinalRobo2 | Documentacion mecanica; AFR2-P430-I01; REV D | 09/11/2026

COORDENADAS / SUPERFICIES CILINDRICAS

Escala corte 1:1 | malla CAD tol. 0,12 mm PLANTA

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

Interfaces y corte | A11 Encastre proximal antebrazo PLA

Vistas por vista | 3D sin escala

AFR2-P431 | Tapa STS3250 J4

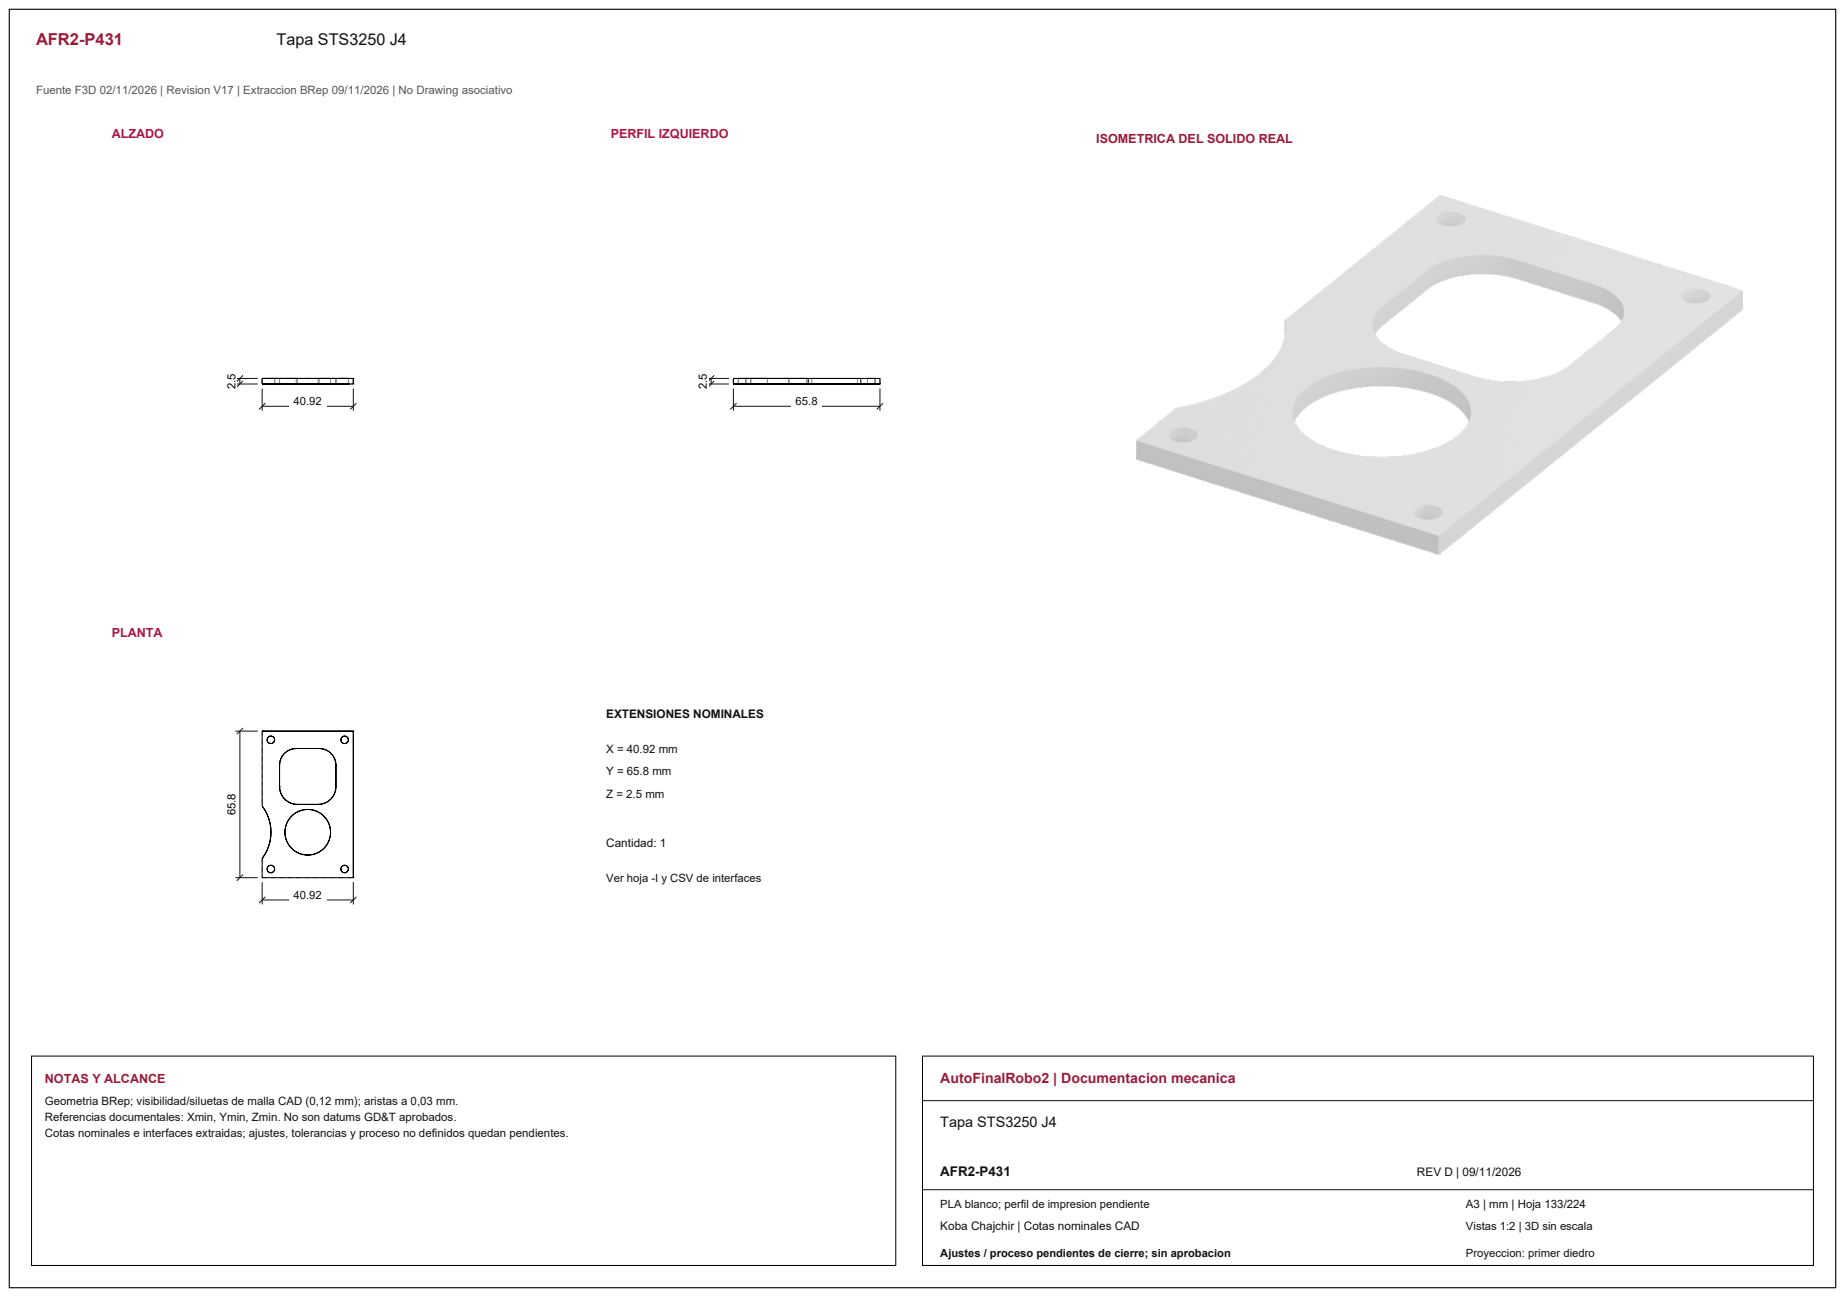
[picture p355: page 32]
ALZADO; PERFIL IZQUIERDO; PLANTA; EXTENSIONES NOMINALES; Cantidad: 1; NOTAS Y ALCANCE; AutoFinalRobo2 | Documentacion mecanica; Tapa STS3250 J4; AFR2-P431; REV D | 09/11/2026

ISOMETRICA DEL SOLIDO REAL

Ver hoja -I y CSV de interfaces

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

Vistas 1:2 | 3D sin escala

AFR2-P431-I01 | Interfaces y corte | Tapa STS3250 J4

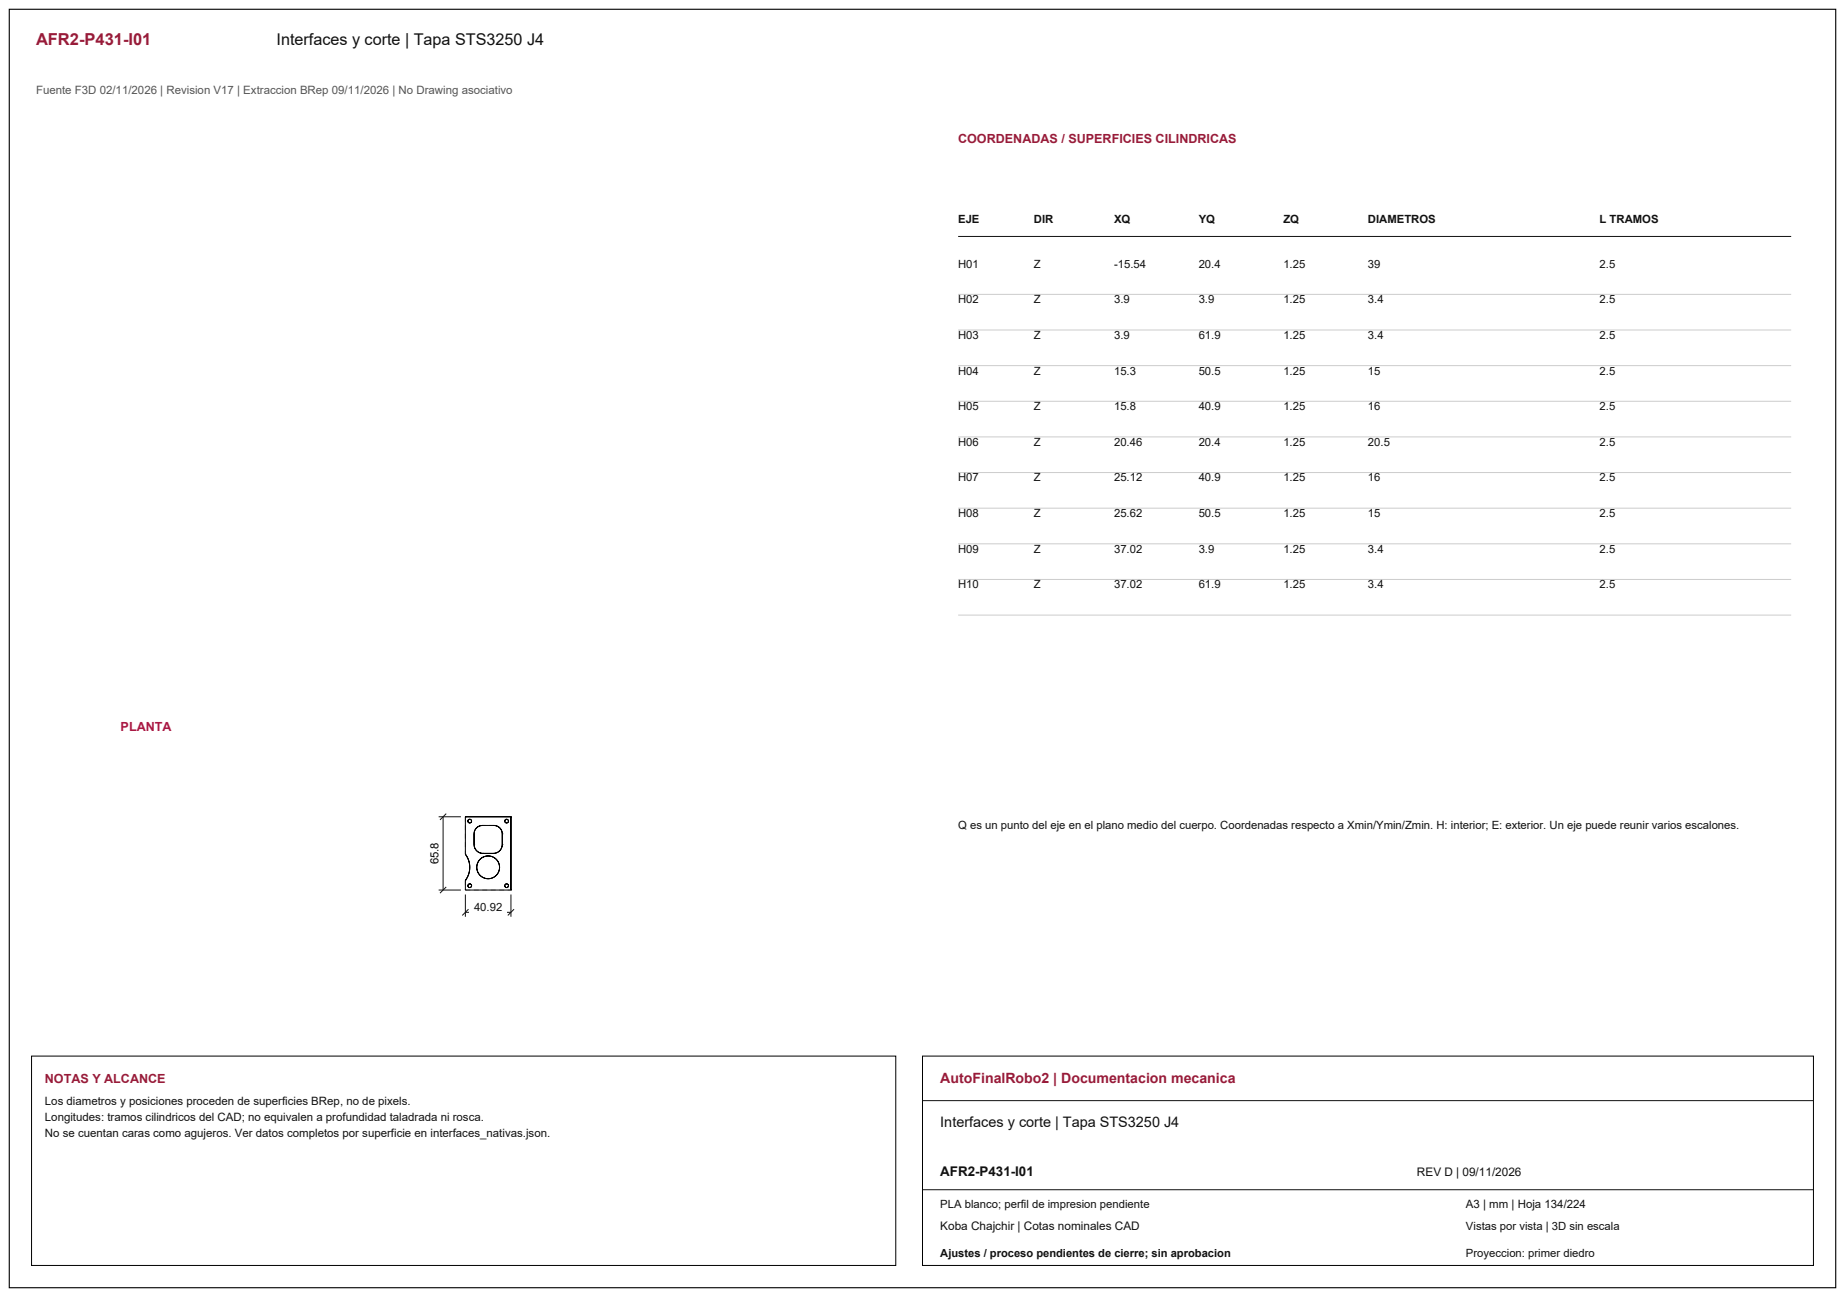
[picture p356: page 33]
PLANTA; EJE; DIR; DIAMETROS; L TRAMOS; NOTAS Y ALCANCE; AutoFinalRobo2 | Documentacion mecanica; AFR2-P431-I01; REV D | 09/11/2026

COORDENADAS / SUPERFICIES CILINDRICAS

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

Interfaces y corte | Tapa STS3250 J4

Vistas por vista | 3D sin escala

AFR2-P435 | A15 Horquilla J5 PLA

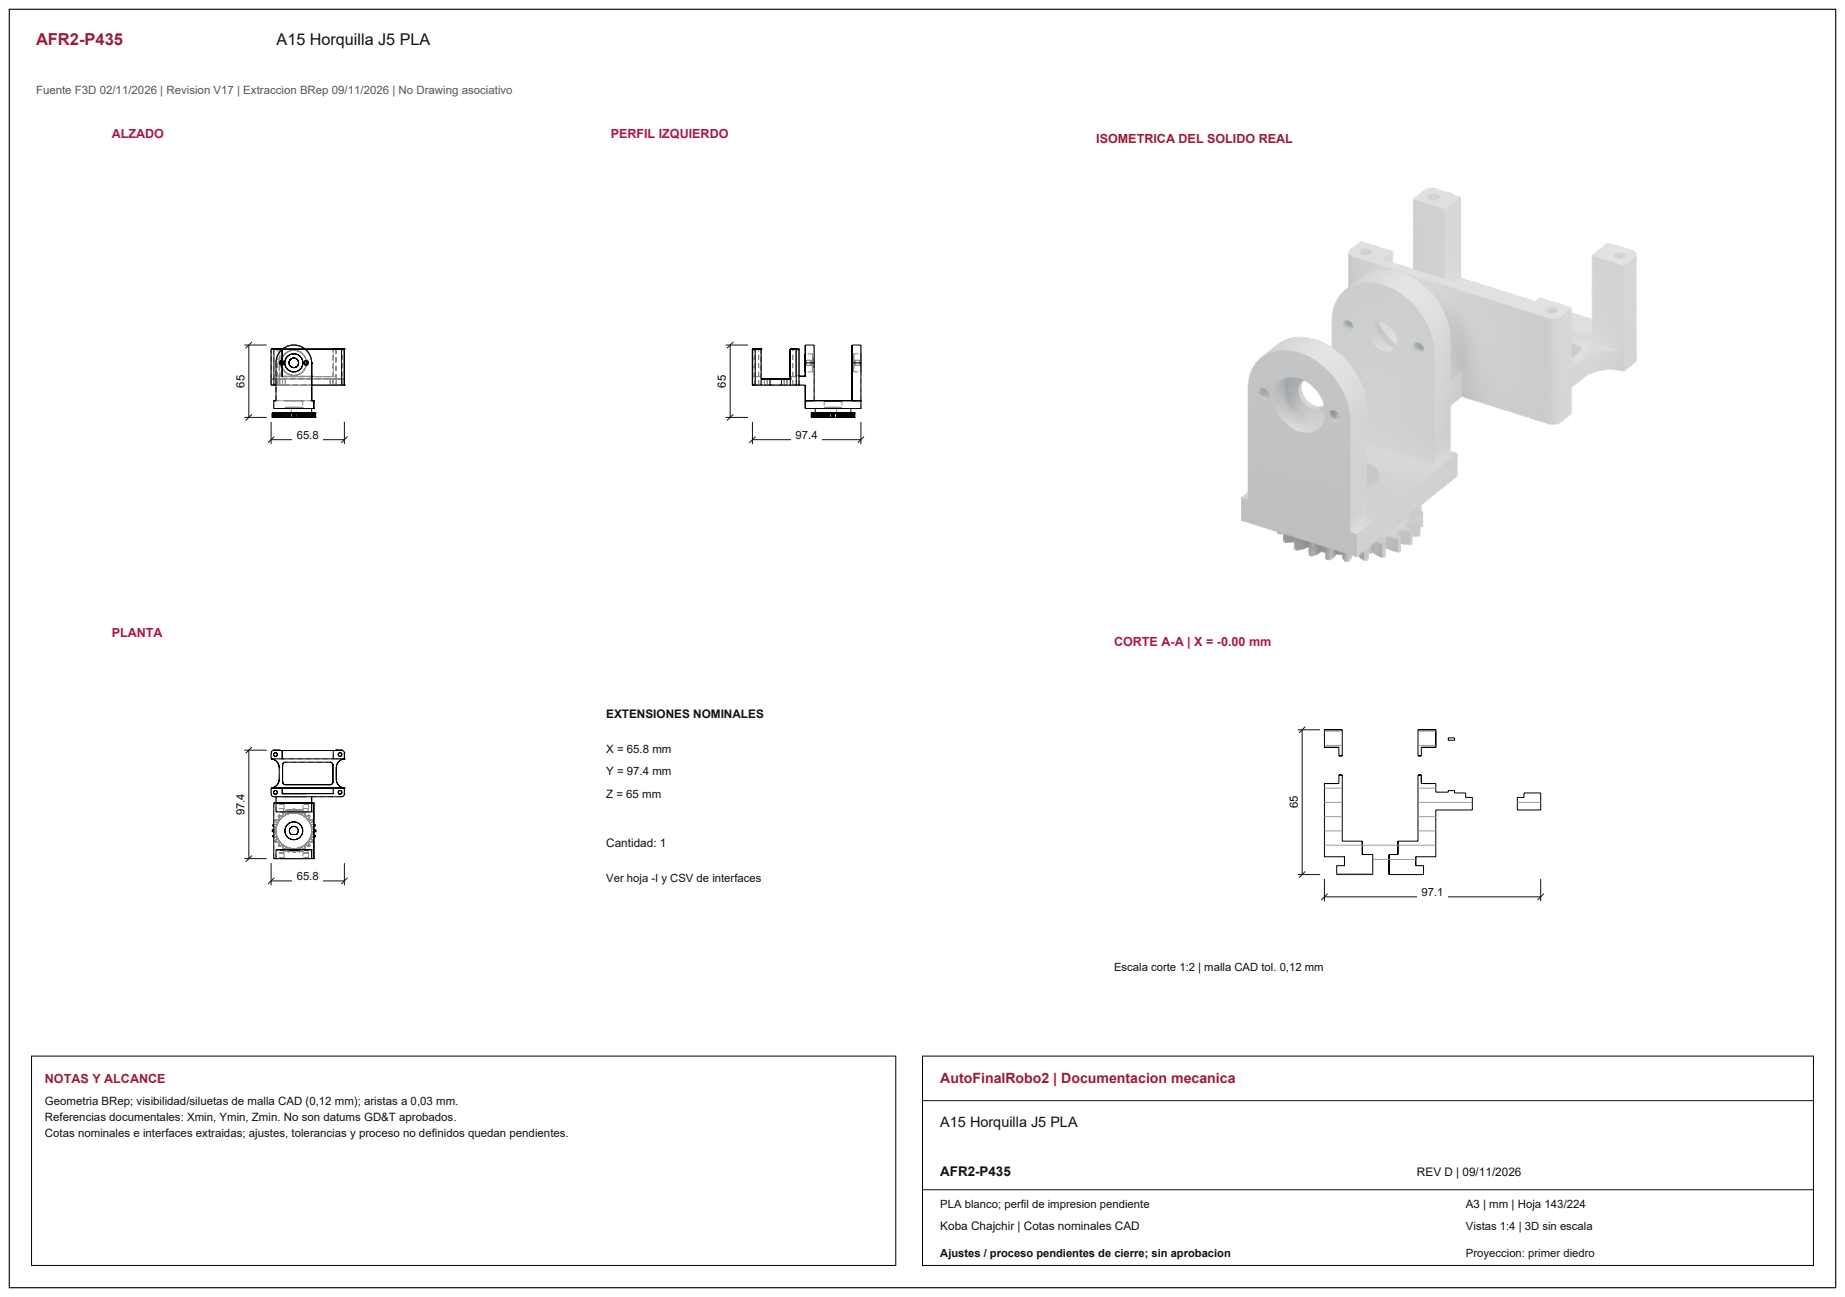
[picture p357: page 34]
ALZADO; PERFIL IZQUIERDO; PLANTA; CORTE A-A | X = -0.00 mm; EXTENSIONES NOMINALES; Cantidad: 1; NOTAS Y ALCANCE; AutoFinalRobo2 | Documentacion mecanica; A15 Horquilla J5 PLA; AFR2-P435; REV D | 09/11/2026

ISOMETRICA DEL SOLIDO REAL

Ver hoja -I y CSV de interfaces

Escala corte 1:2 | malla CAD tol. 0,12 mm

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

Vistas 1:4 | 3D sin escala
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
