kobachajchir/ProyectoRobotica2/Revision/R01_20261110/02_Planos/tomos/AFR2_Tomo_6_Herramienta_y_pinza_A3.pdf

AFR2-A600 | Herramienta y pinza V7
Fuente F3D 02/11/2026 | Revision V17 | Extraccion BRep 09/11/2026 | No Drawing asociativo

NOTAS Y ALCANCE

Conjunto armado desde la captura nativa, con sus orientaciones y ubicaciones guardadas. Lista de ocurrencias en hojas -LP y despieces por tramos -E.
No se modifica la geometria ni se afirma secuencia de montaje/desmontaje comprobada.

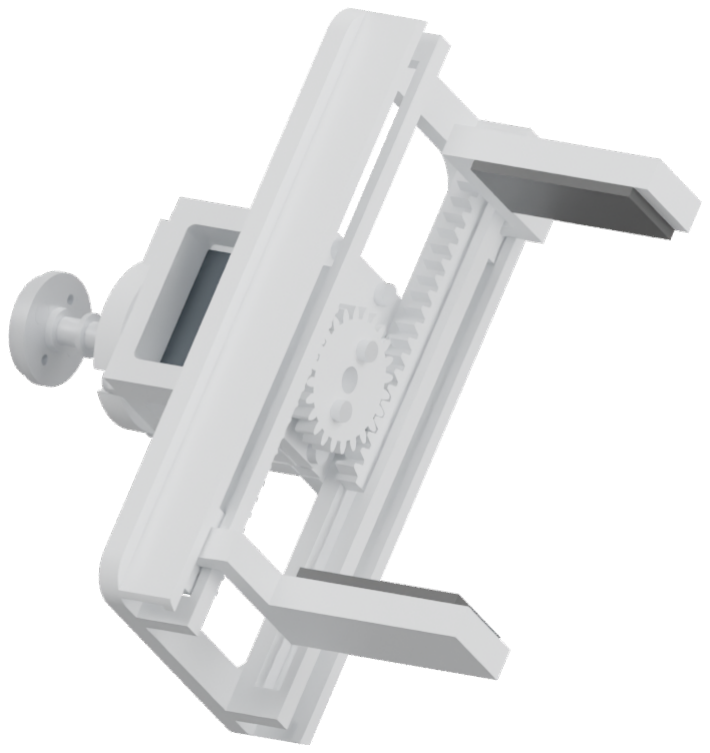
[picture p358: figure]

### AutoFinalRobo2 | Documentacion mecanica

### Herramienta y pinza V7

AFR2-A600 | REV D | 09/11/2026
Conjunto mixto Koba Chajchir | Cotas nominales CAD Ajustes / proceso pendientes de cierre; sin aprobacion | A3 | mm | Hoja 71/224
| Vistas -- | 3D sin escala
| Proyeccion: primer diedro

AFR2-A600-LP01 | Lista de ocurrencias | Herramienta y pinza V7

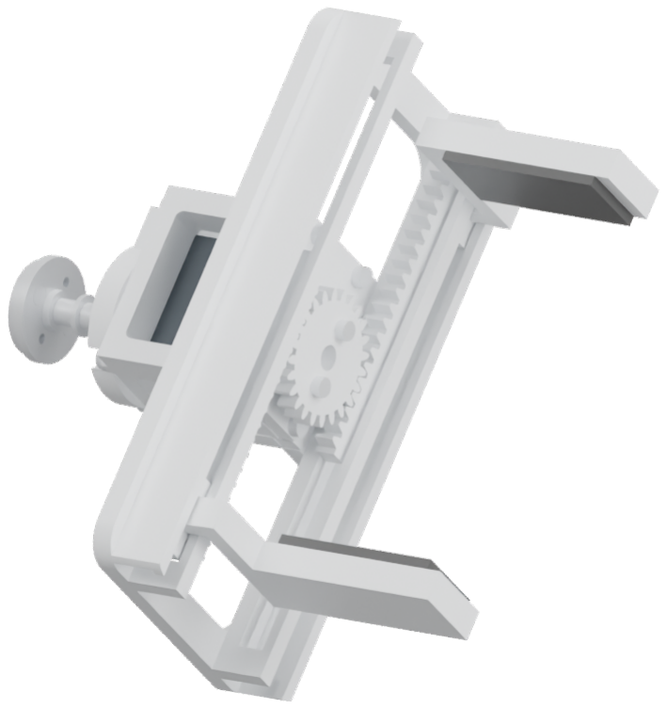
[picture p359: figure]

001 AFR2-P602 | V02 A20 Bastidor pinza
002 AFR2-P601 | V02 E05 Acople J6
003 COMERCIAL/REFERENCIA | V02 M07 MG90S Pinza
004 COMERCIAL/REFERENCIA | V03 Prisionero J6 M2 5x12 REF
005 AFR2-P604 | V03 Separador axial J6
006 AFR2-P603 | V03 Separador medio J6
007 AFR2-P606 | V17 Horn STS3032 J6
008 COMERCIAL/REFERENCIA | V17 M2x35 cilindrico J7 0
009 COMERCIAL/REFERENCIA | V17 M2x35 cilindrico J7 1
010 COMERCIAL/REFERENCIA | V17 M2x35 cilindrico J7 2
011 COMERCIAL/REFERENCIA | V17 M2x35 cilindrico J7 3
012 COMERCIAL/REFERENCIA | V17 M2x4 avellanado horn J6 0
013 COMERCIAL/REFERENCIA | V17 M2x4 avellanado horn J6 1
014 AFR2-P605 | V17 Tapa STS3032 J7
015 COMERCIAL/REFERENCIA | V17 Tornillo original M2 3 J6
016 COMERCIAL/REFERENCIA | V17 Tuerca M2 J7 0
017 COMERCIAL/REFERENCIA | V17 Tuerca M2 J7 1
018 COMERCIAL/REFERENCIA | V17 Tuerca M2 J7 2

NOTAS Y ALCANCE

Cada posicion identifica una ocurrencia; los solidos de un mismo comercial se mantienen agrupados. Las placas con hijos Nano/PCA9685/XL4016 se agrupan como unidades comerciales.
Codigo COMERCIAL/REFERENCIA no implica plano de fabricacion propio. Rutas completas en CSV.

### AutoFinalRobo2 | Documentacion mecanica

### Lista de ocurrencias | Herramienta y pinza V7

AFR2-A600-LP01 | REV D | 09/11/2026

Conjunto mixto

| Vistas -- | 3D sin escala

AFR2-A600-LP02 | Lista de ocurrencias | Herramienta y pinza V7
019 COMERCIAL/REFERENCIA | V17 Tuerca M2 J7 3
020 COMERCIAL/REFERENCIA | V02 Almohadilla -1
021 AFR2-P618 | V02 Mandibula -1
022 COMERCIAL/REFERENCIA | V02 Almohadilla 1
023 AFR2-P619 | V02 Mandibula 1
024 AFR2-P620 | V02 Pinon24 Pinza
025 AFR2-P621 | V17 Horn STS3032 J7
026 COMERCIAL/REFERENCIA | V17 Tornillo M2x6 union horn J7-1
027 COMERCIAL/REFERENCIA | V17 Tornillo M2x6 union horn J71
028 COMERCIAL/REFERENCIA | V17 Tornillo original M2 3 J7

NOTAS Y ALCANCE

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

### AutoFinalRobo2 | Documentacion mecanica

### Lista de ocurrencias | Herramienta y pinza V7

AFR2-A600-LP02 | REV D | 09/11/2026

Conjunto mixto

| Vistas -- | 3D sin escala

AFR2-A600-E1 | Despiece isometrico | Herramienta y pinza V7

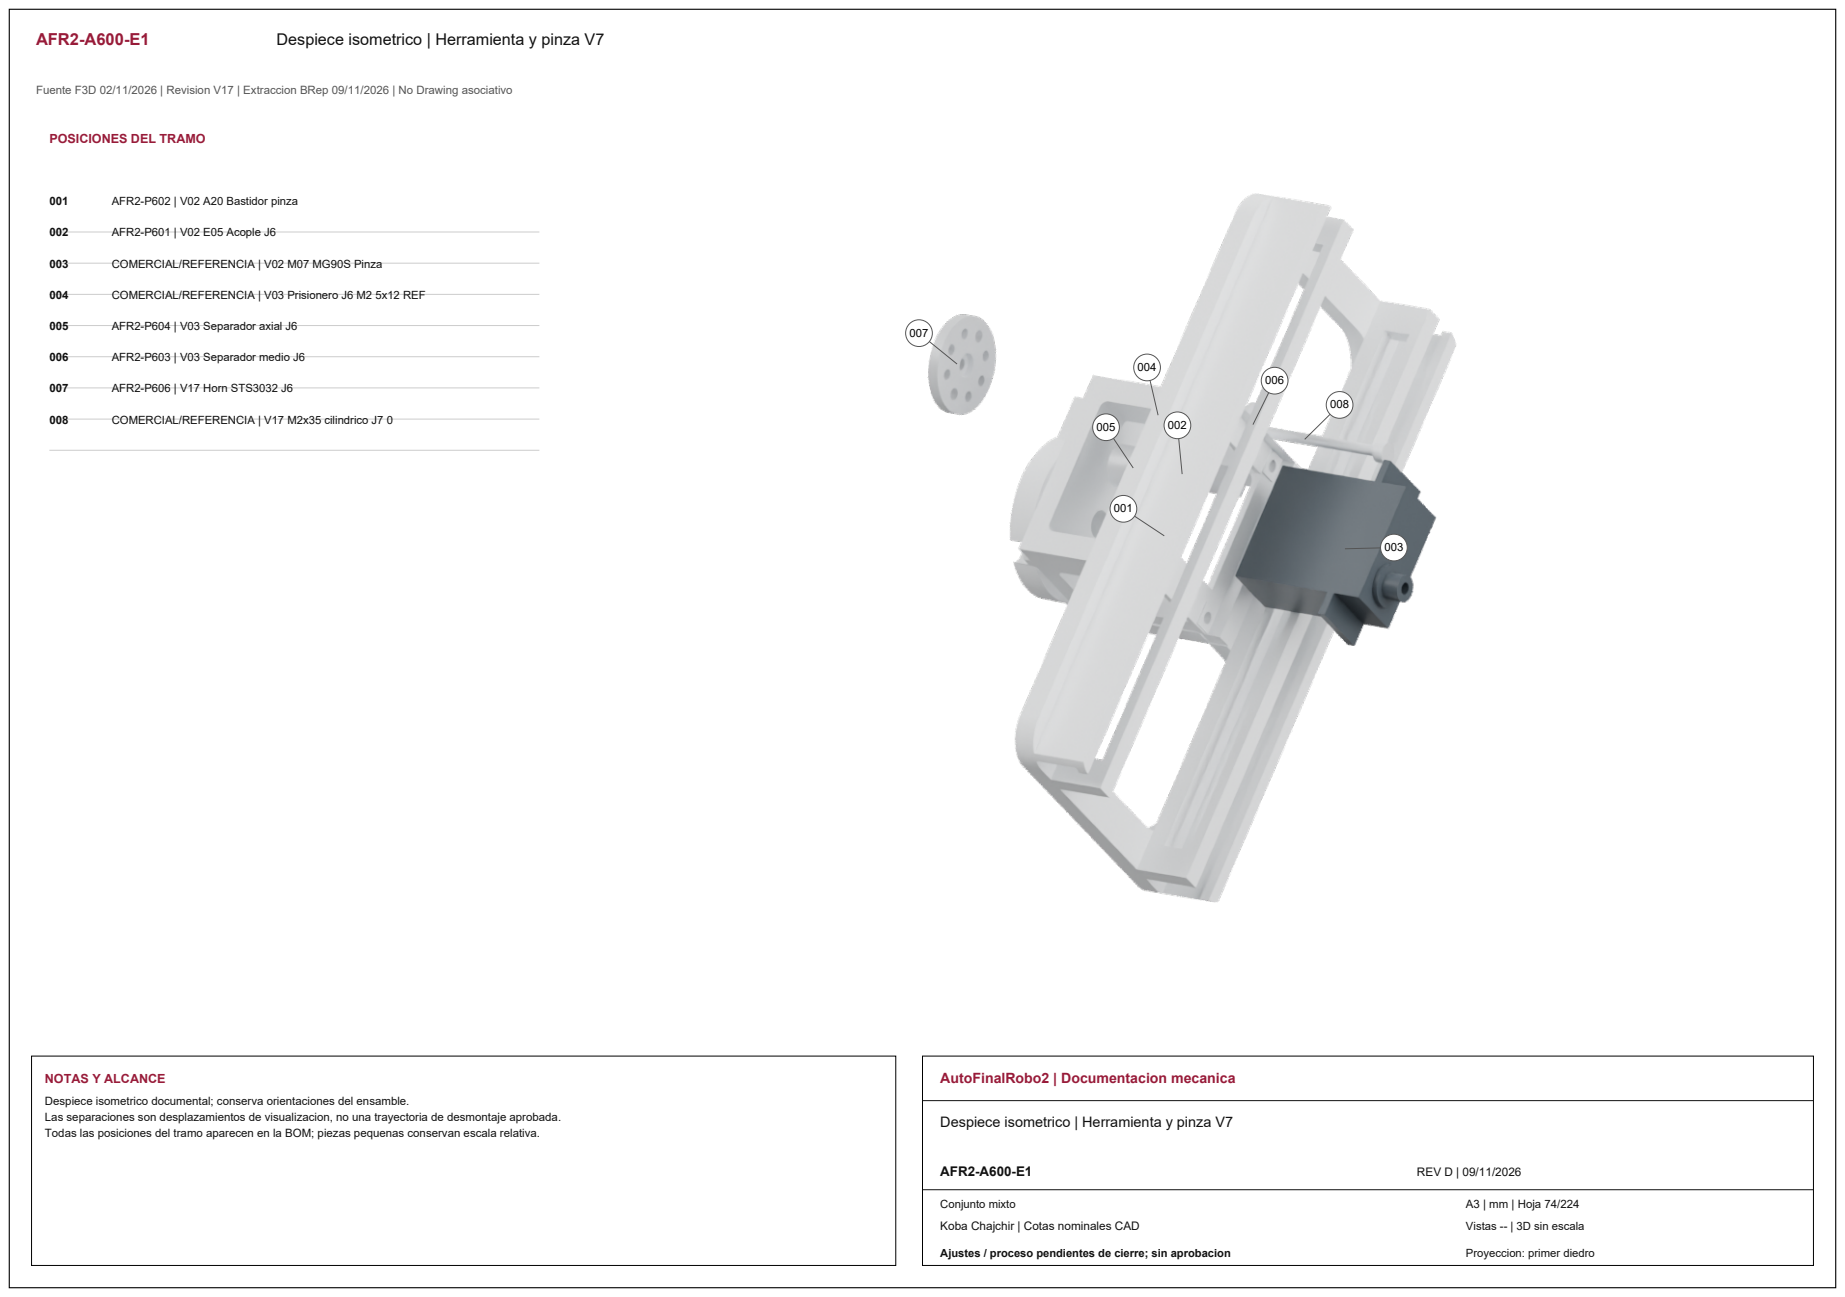
[picture p360: page 4]
001 AFR2-P602 | V02 A20 Bastidor pinza; 002 AFR2-P601 | V02 E05 Acople J6; 005 AFR2-P604 | V03 Separador axial J6; 006 AFR2-P603 | V03 Separador medio J6; 007 AFR2-P606 | V17 Horn STS3032 J6; NOTAS Y ALCANCE; AutoFinalRobo2 | Documentacion mecanica; AFR2-A600-E1; REV D | 09/11/2026; Conjunto mixto

POSICIONES DEL TRAMO

003 COMERCIAL/REFERENCIA | V02 M07 MG90S Pinza

004 COMERCIAL/REFERENCIA | V03 Prisionero J6 M2 5x12 REF

008 COMERCIAL/REFERENCIA | V17 M2x35 cilindrico J7 0

Despiece isometrico documental; conserva orientaciones del ensamble.
Las separaciones son desplazamientos de visualizacion, no una trayectoria de desmontaje aprobada.
Todas las posiciones del tramo aparecen en la BOM; piezas pequenas conservan escala relativa.

Despiece isometrico | Herramienta y pinza V7

Vistas -- | 3D sin escala

AFR2-A600-E2 | Despiece isometrico | Herramienta y pinza V7

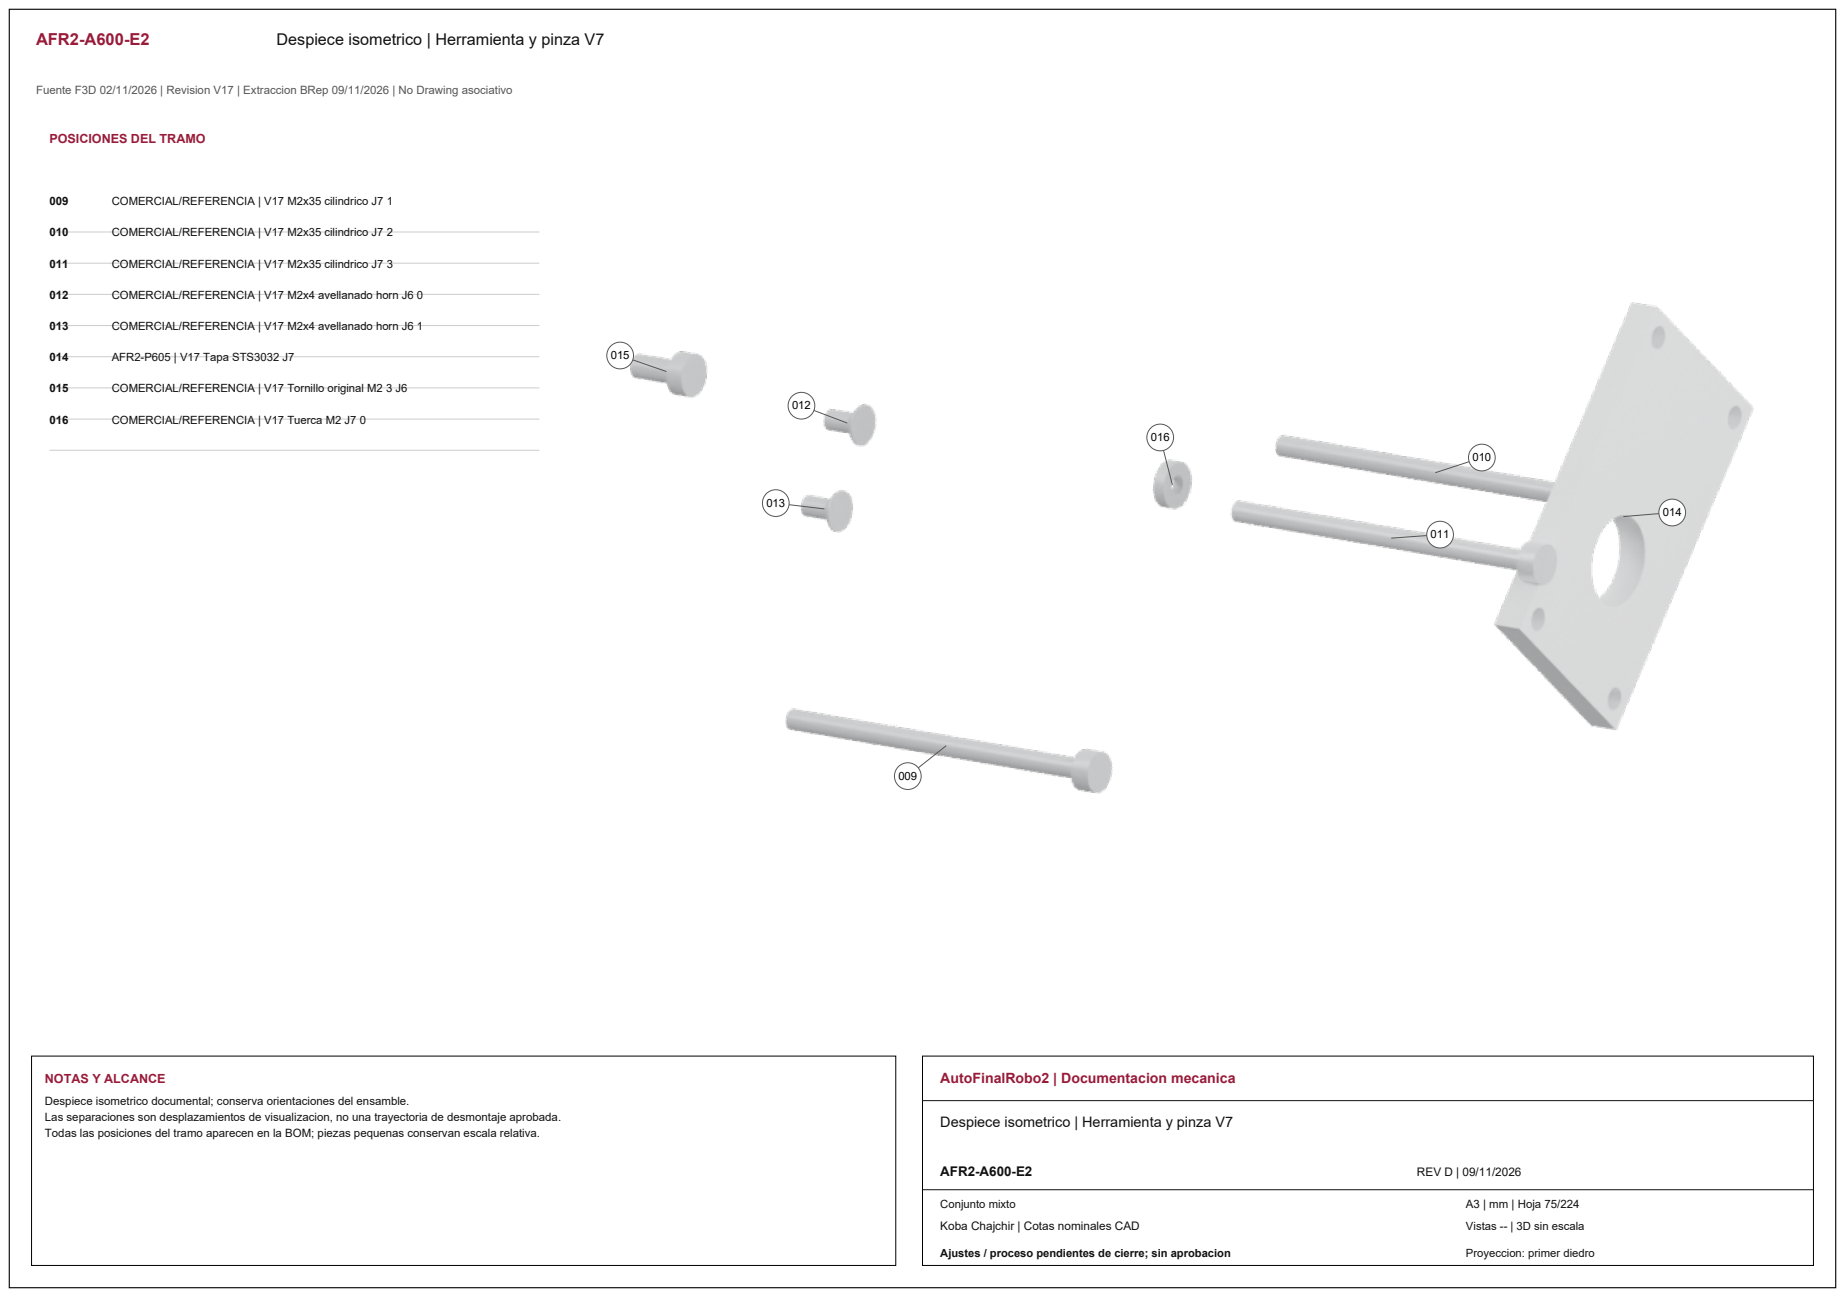
[picture p361: page 5]
014 AFR2-P605 | V17 Tapa STS3032 J7; NOTAS Y ALCANCE; AutoFinalRobo2 | Documentacion mecanica; AFR2-A600-E2; REV D | 09/11/2026; Conjunto mixto

POSICIONES DEL TRAMO

009 COMERCIAL/REFERENCIA | V17 M2x35 cilindrico J7 1

010 COMERCIAL/REFERENCIA | V17 M2x35 cilindrico J7 2

011 COMERCIAL/REFERENCIA | V17 M2x35 cilindrico J7 3

012 COMERCIAL/REFERENCIA | V17 M2x4 avellanado horn J6 0

013 COMERCIAL/REFERENCIA | V17 M2x4 avellanado horn J6 1

015 COMERCIAL/REFERENCIA | V17 Tornillo original M2 3 J6

016 COMERCIAL/REFERENCIA | V17 Tuerca M2 J7 0

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

Despiece isometrico | Herramienta y pinza V7

Vistas -- | 3D sin escala

AFR2-A600-E3 | Despiece isometrico | Herramienta y pinza V7

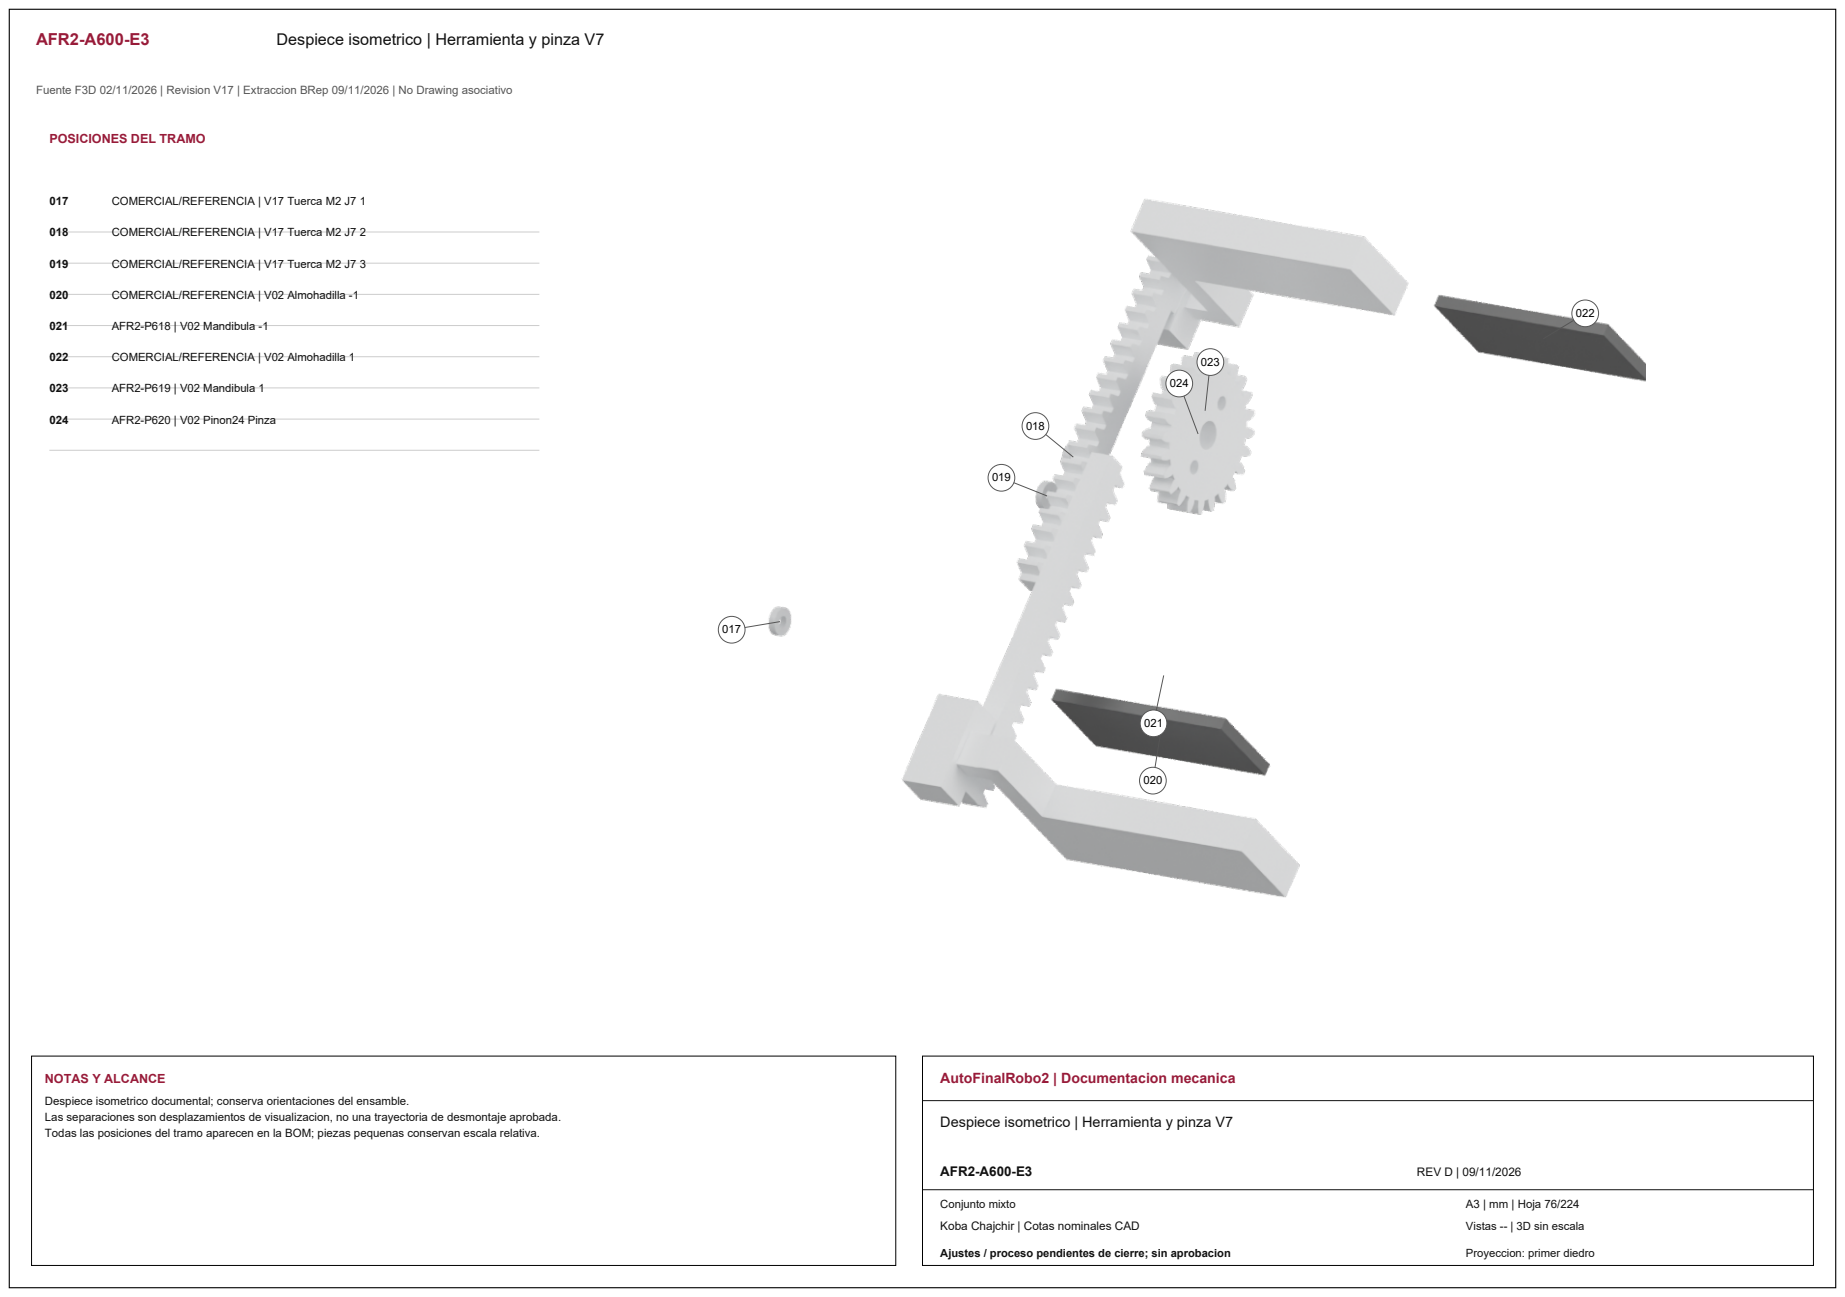
[picture p362: page 6]
021 AFR2-P618 | V02 Mandibula -1; 023 AFR2-P619 | V02 Mandibula 1; 024 AFR2-P620 | V02 Pinon24 Pinza; NOTAS Y ALCANCE; AutoFinalRobo2 | Documentacion mecanica; AFR2-A600-E3; REV D | 09/11/2026; Conjunto mixto

POSICIONES DEL TRAMO

017 COMERCIAL/REFERENCIA | V17 Tuerca M2 J7 1

018 COMERCIAL/REFERENCIA | V17 Tuerca M2 J7 2

019 COMERCIAL/REFERENCIA | V17 Tuerca M2 J7 3

020 COMERCIAL/REFERENCIA | V02 Almohadilla -1

022 COMERCIAL/REFERENCIA | V02 Almohadilla 1

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

Despiece isometrico | Herramienta y pinza V7

Vistas -- | 3D sin escala

AFR2-A600-E4 | Despiece isometrico | Herramienta y pinza V7

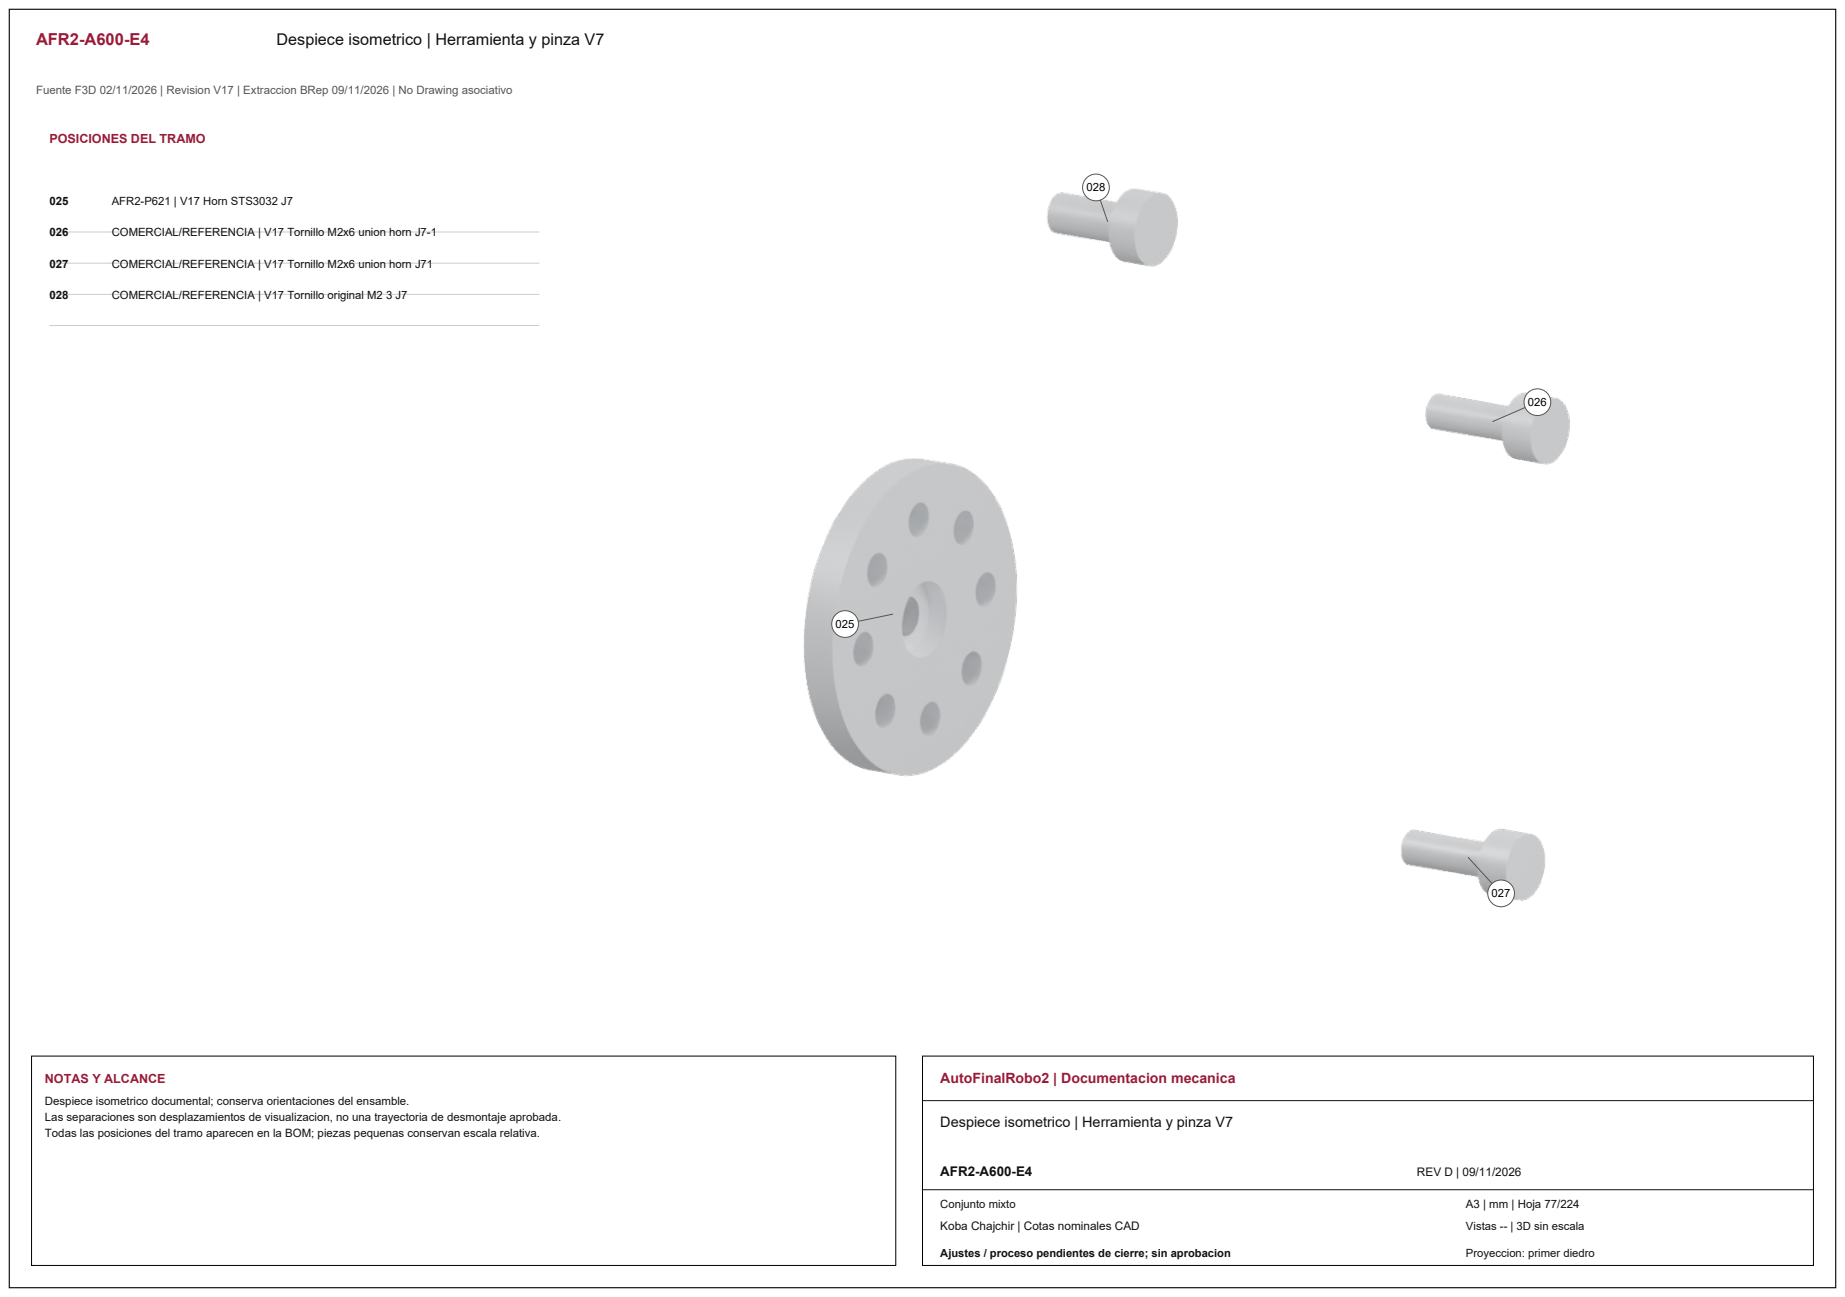
[picture p363: page 7]
025 AFR2-P621 | V17 Horn STS3032 J7; NOTAS Y ALCANCE; AutoFinalRobo2 | Documentacion mecanica; AFR2-A600-E4; REV D | 09/11/2026; Conjunto mixto

POSICIONES DEL TRAMO

026 COMERCIAL/REFERENCIA | V17 Tornillo M2x6 union horn J7-1

027 COMERCIAL/REFERENCIA | V17 Tornillo M2x6 union horn J71

028 COMERCIAL/REFERENCIA | V17 Tornillo original M2 3 J7

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

Despiece isometrico | Herramienta y pinza V7

Vistas -- | 3D sin escala

AFR2-P601 | E05 Acople J6

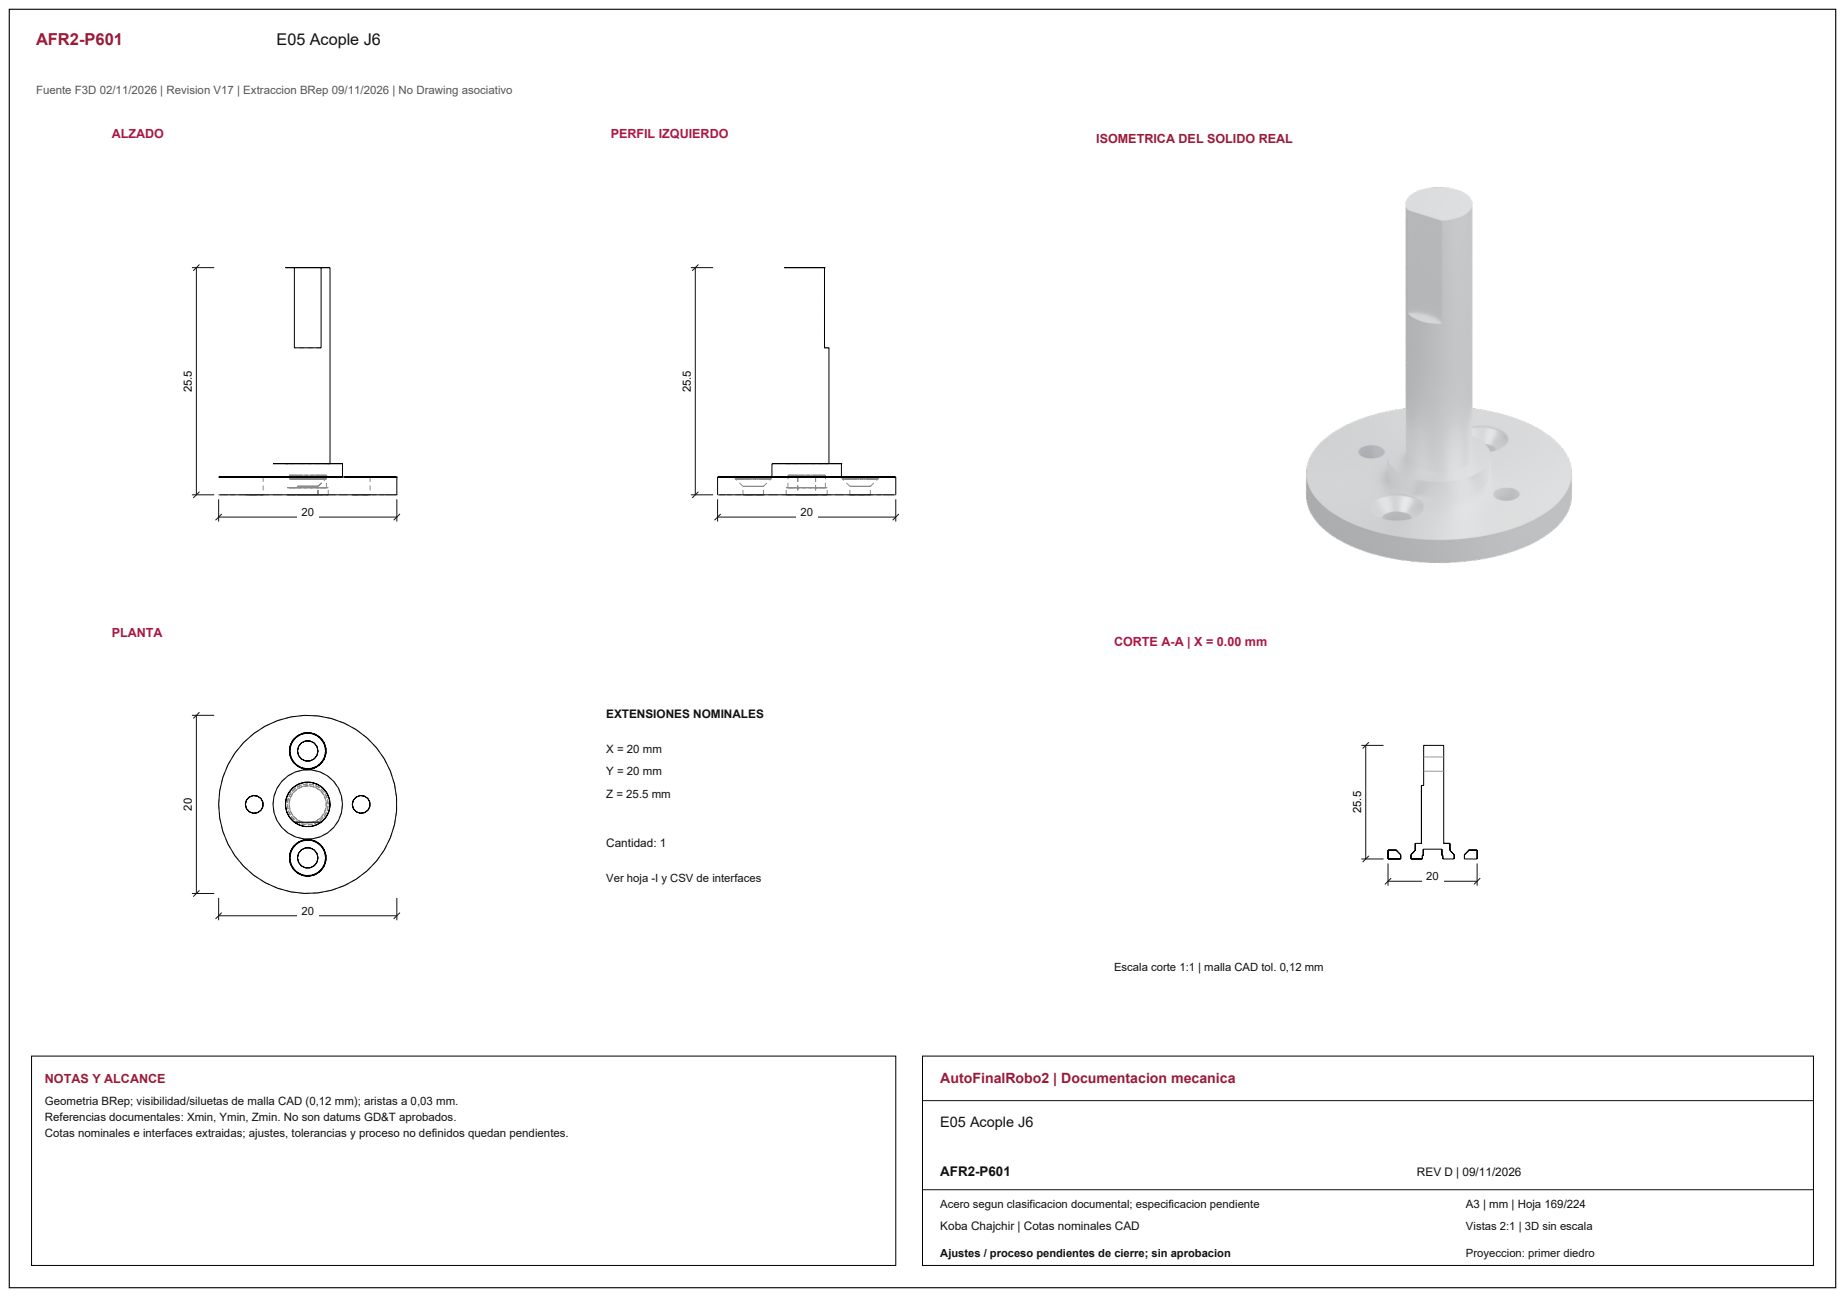
[picture p364: page 8]
ALZADO; PERFIL IZQUIERDO; PLANTA; CORTE A-A | X = 0.00 mm; EXTENSIONES NOMINALES; Cantidad: 1; NOTAS Y ALCANCE; AutoFinalRobo2 | Documentacion mecanica; E05 Acople J6; AFR2-P601; REV D | 09/11/2026

ISOMETRICA DEL SOLIDO REAL

Ver hoja -I y CSV de interfaces

Escala corte 1:1 | malla CAD tol. 0,12 mm

Geometria BRep; visibilidad/siluetas de malla CAD (0,12 mm); aristas a 0,03 mm.
Referencias documentales: Xmin, Ymin, Zmin. No son datums GD&T aprobados.
Cotas nominales e interfaces extraidas; ajustes, tolerancias y proceso no definidos quedan pendientes.

Acero segun clasificacion documental; especificacion pendiente

Vistas 2:1 | 3D sin escala

AFR2-P601-I01 | Interfaces y corte | E05 Acople J6

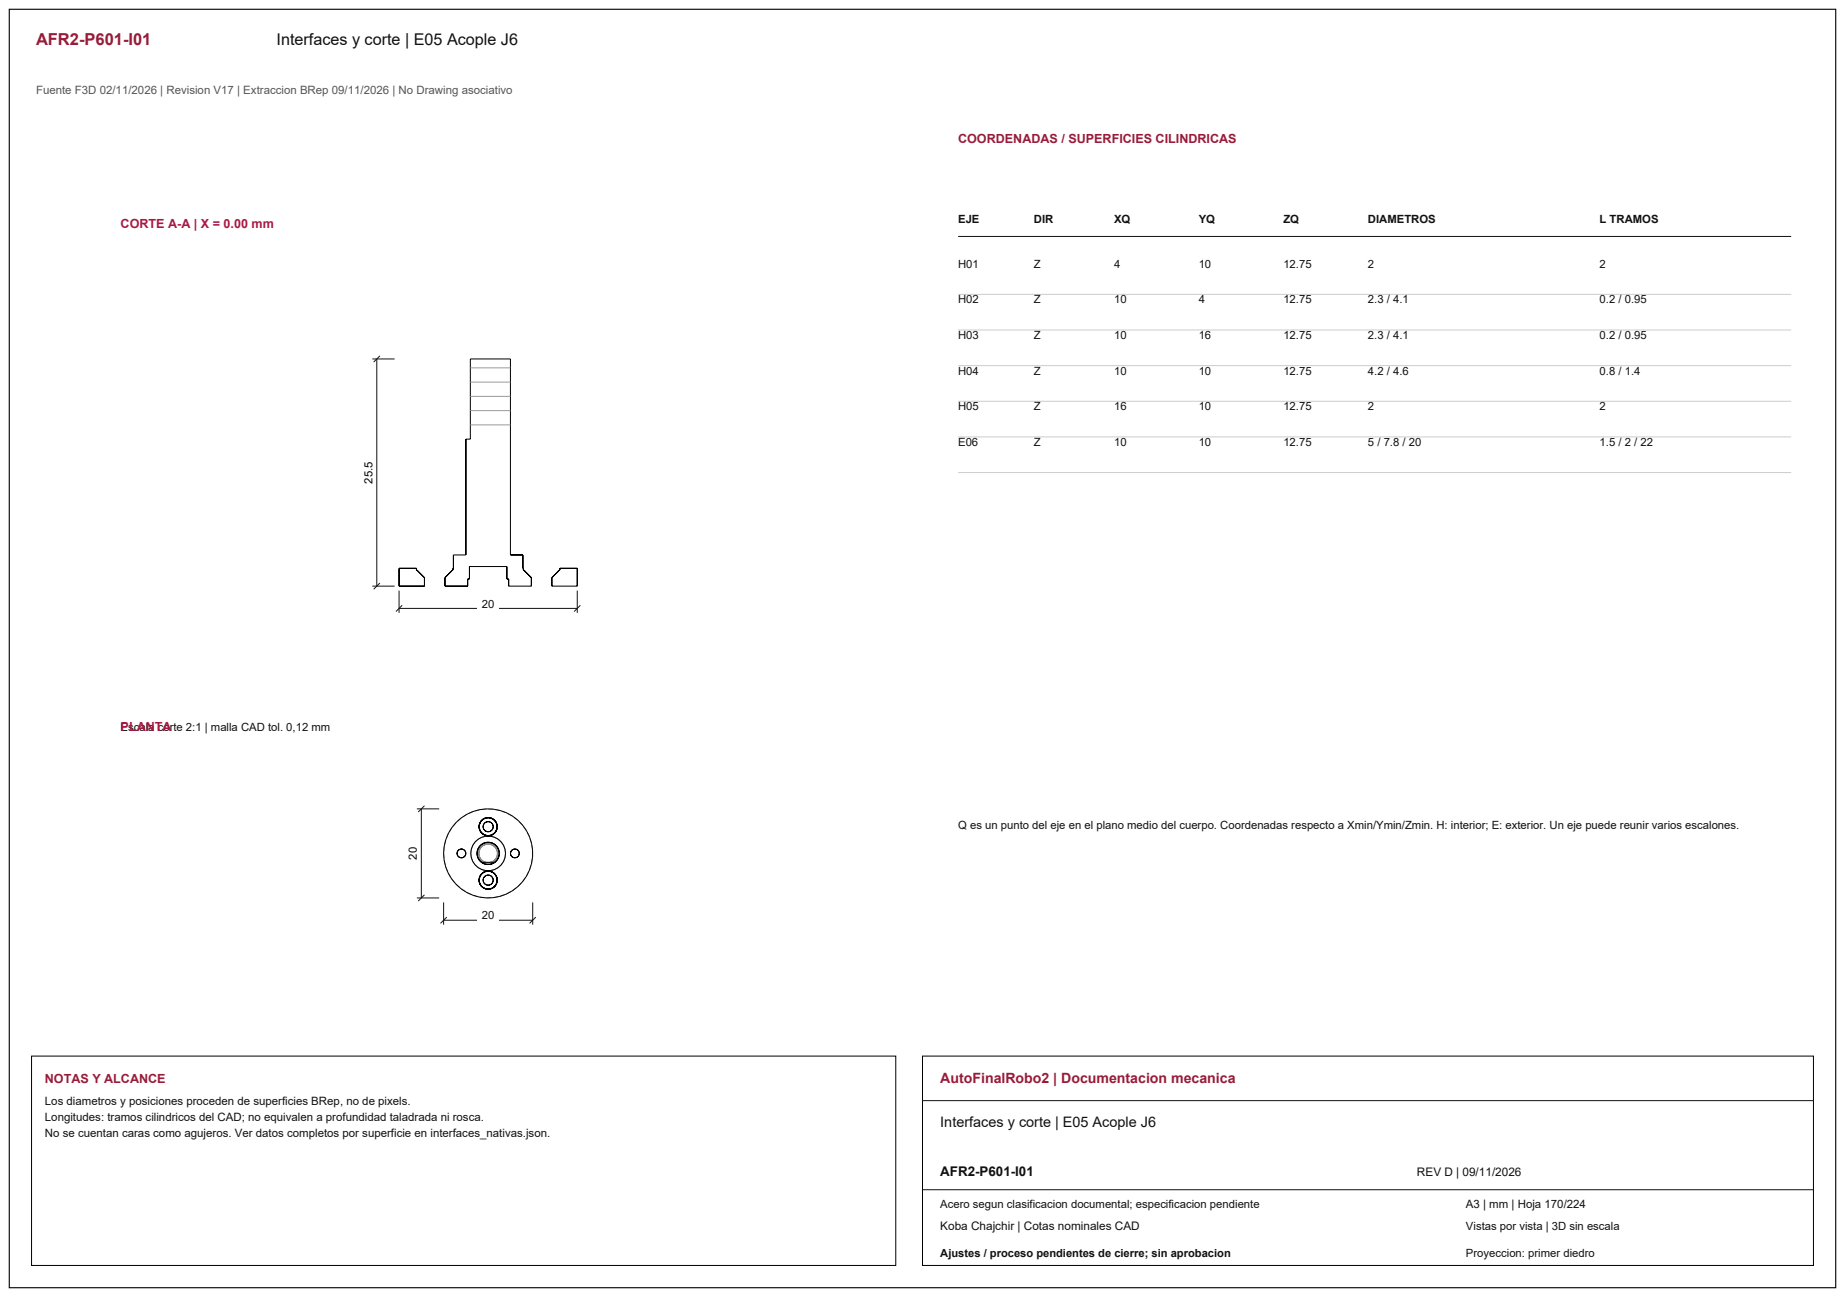
[picture p365: page 9]
CORTE A-A | X = 0.00 mm; EJE; DIR; DIAMETROS; L TRAMOS; NOTAS Y ALCANCE; AutoFinalRobo2 | Documentacion mecanica; AFR2-P601-I01; REV D | 09/11/2026

COORDENADAS / SUPERFICIES CILINDRICAS

Escala corte 2:1 | malla CAD tol. 0,12 mm PLANTA

Q es un punto del eje en el plano medio del cuerpo. Coordenadas respecto a Xmin/Ymin/Zmin. H: interior; E: exterior. Un eje puede reunir varios escalones.

Los diametros y posiciones proceden de superficies BRep, no de pixels.
Longitudes: tramos cilindricos del CAD; no equivalen a profundidad taladrada ni rosca.
No se cuentan caras como agujeros. Ver datos completos por superficie en interfaces_nativas.json.

Interfaces y corte | E05 Acople J6

Acero segun clasificacion documental; especificacion pendiente

Vistas por vista | 3D sin escala

AFR2-P602 | A20 Bastidor pinza

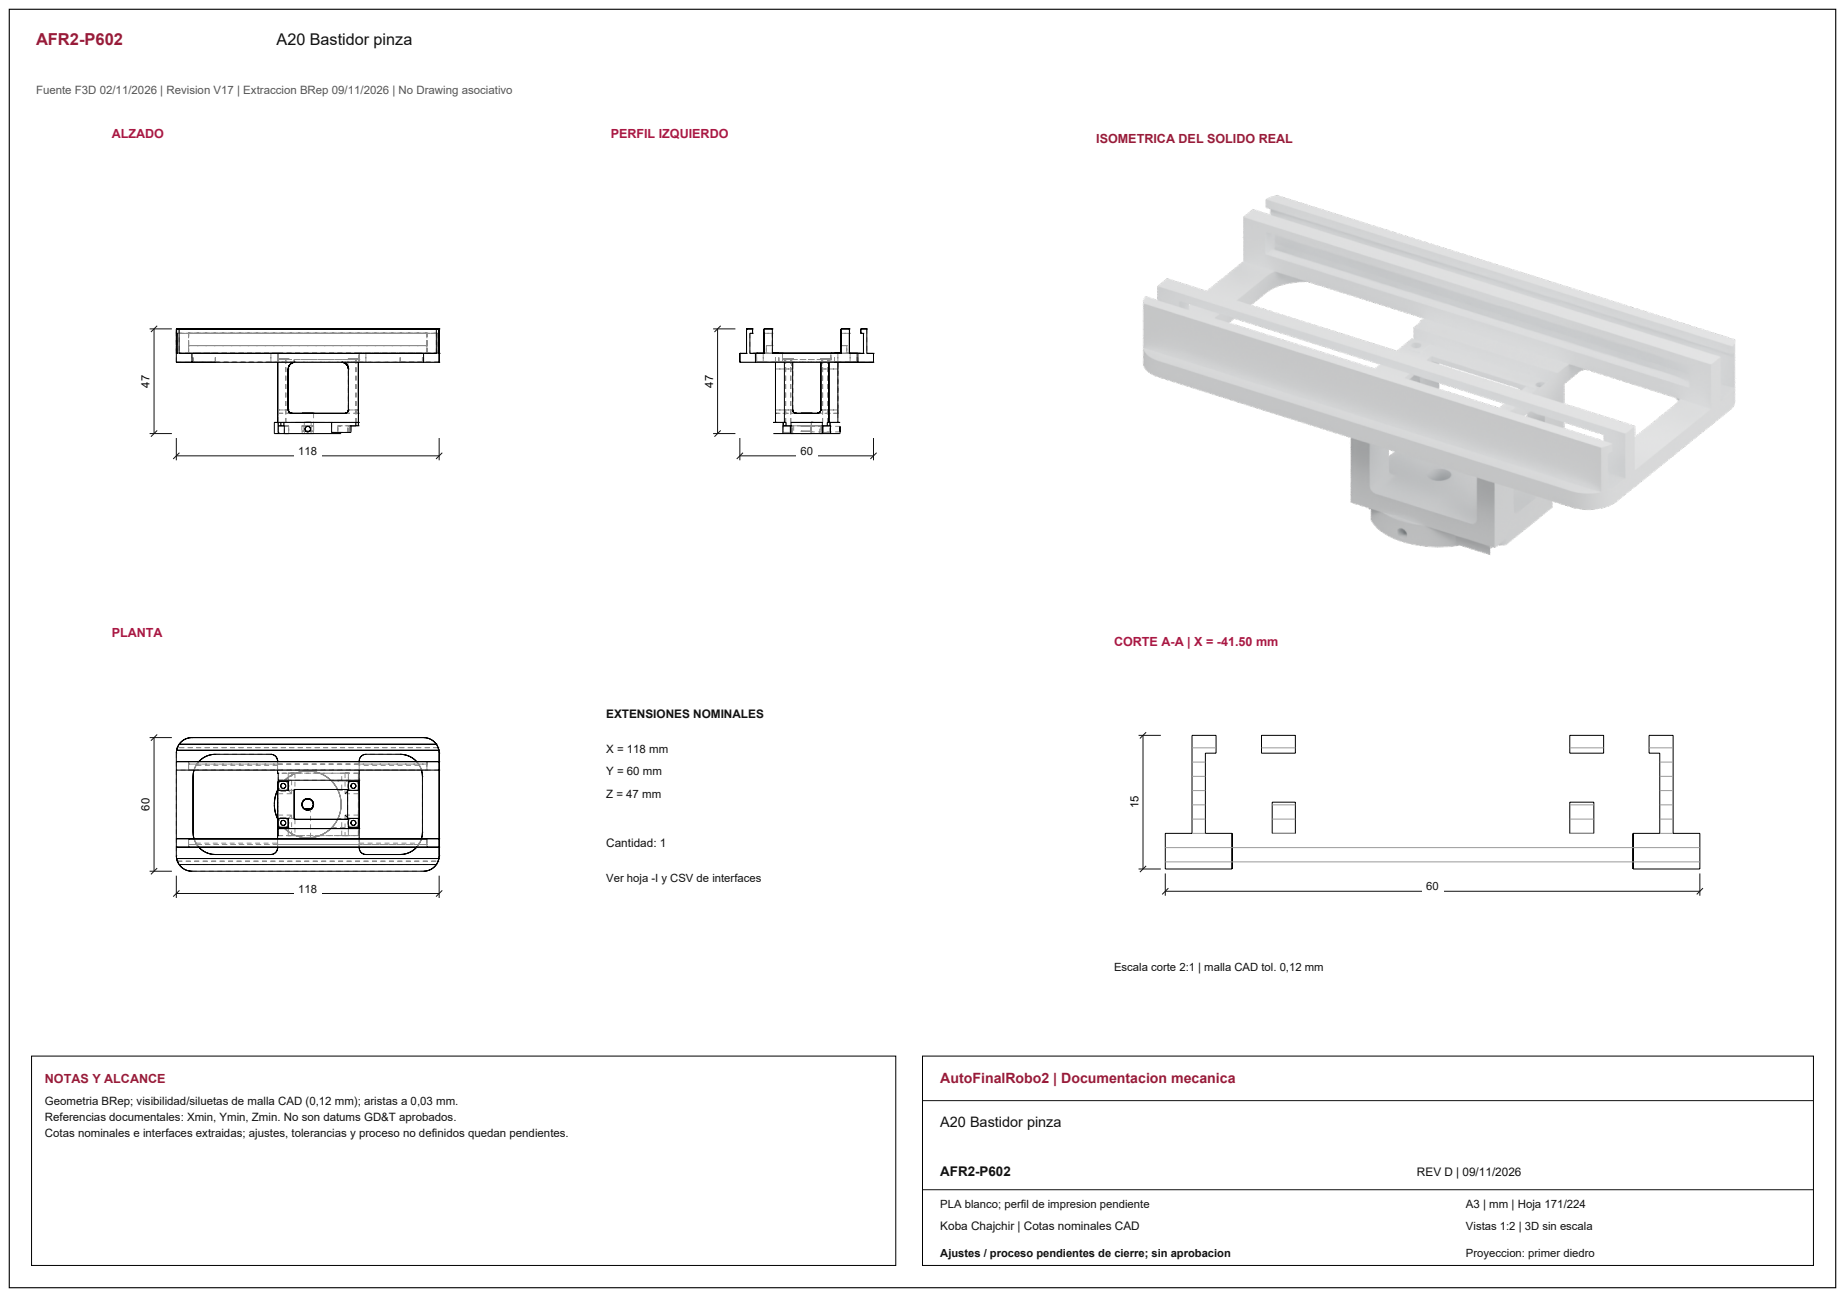
[picture p366: page 10]
ALZADO; PERFIL IZQUIERDO; PLANTA; CORTE A-A | X = -41.50 mm; EXTENSIONES NOMINALES; Cantidad: 1; NOTAS Y ALCANCE; AutoFinalRobo2 | Documentacion mecanica; A20 Bastidor pinza; AFR2-P602; REV D | 09/11/2026

ISOMETRICA DEL SOLIDO REAL

Ver hoja -I y CSV de interfaces

Escala corte 2:1 | malla CAD tol. 0,12 mm

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

PLA blanco; perfil de impresion pendiente

Vistas 1:2 | 3D sin escala

AFR2-P602-I01 | Interfaces y corte | A20 Bastidor pinza

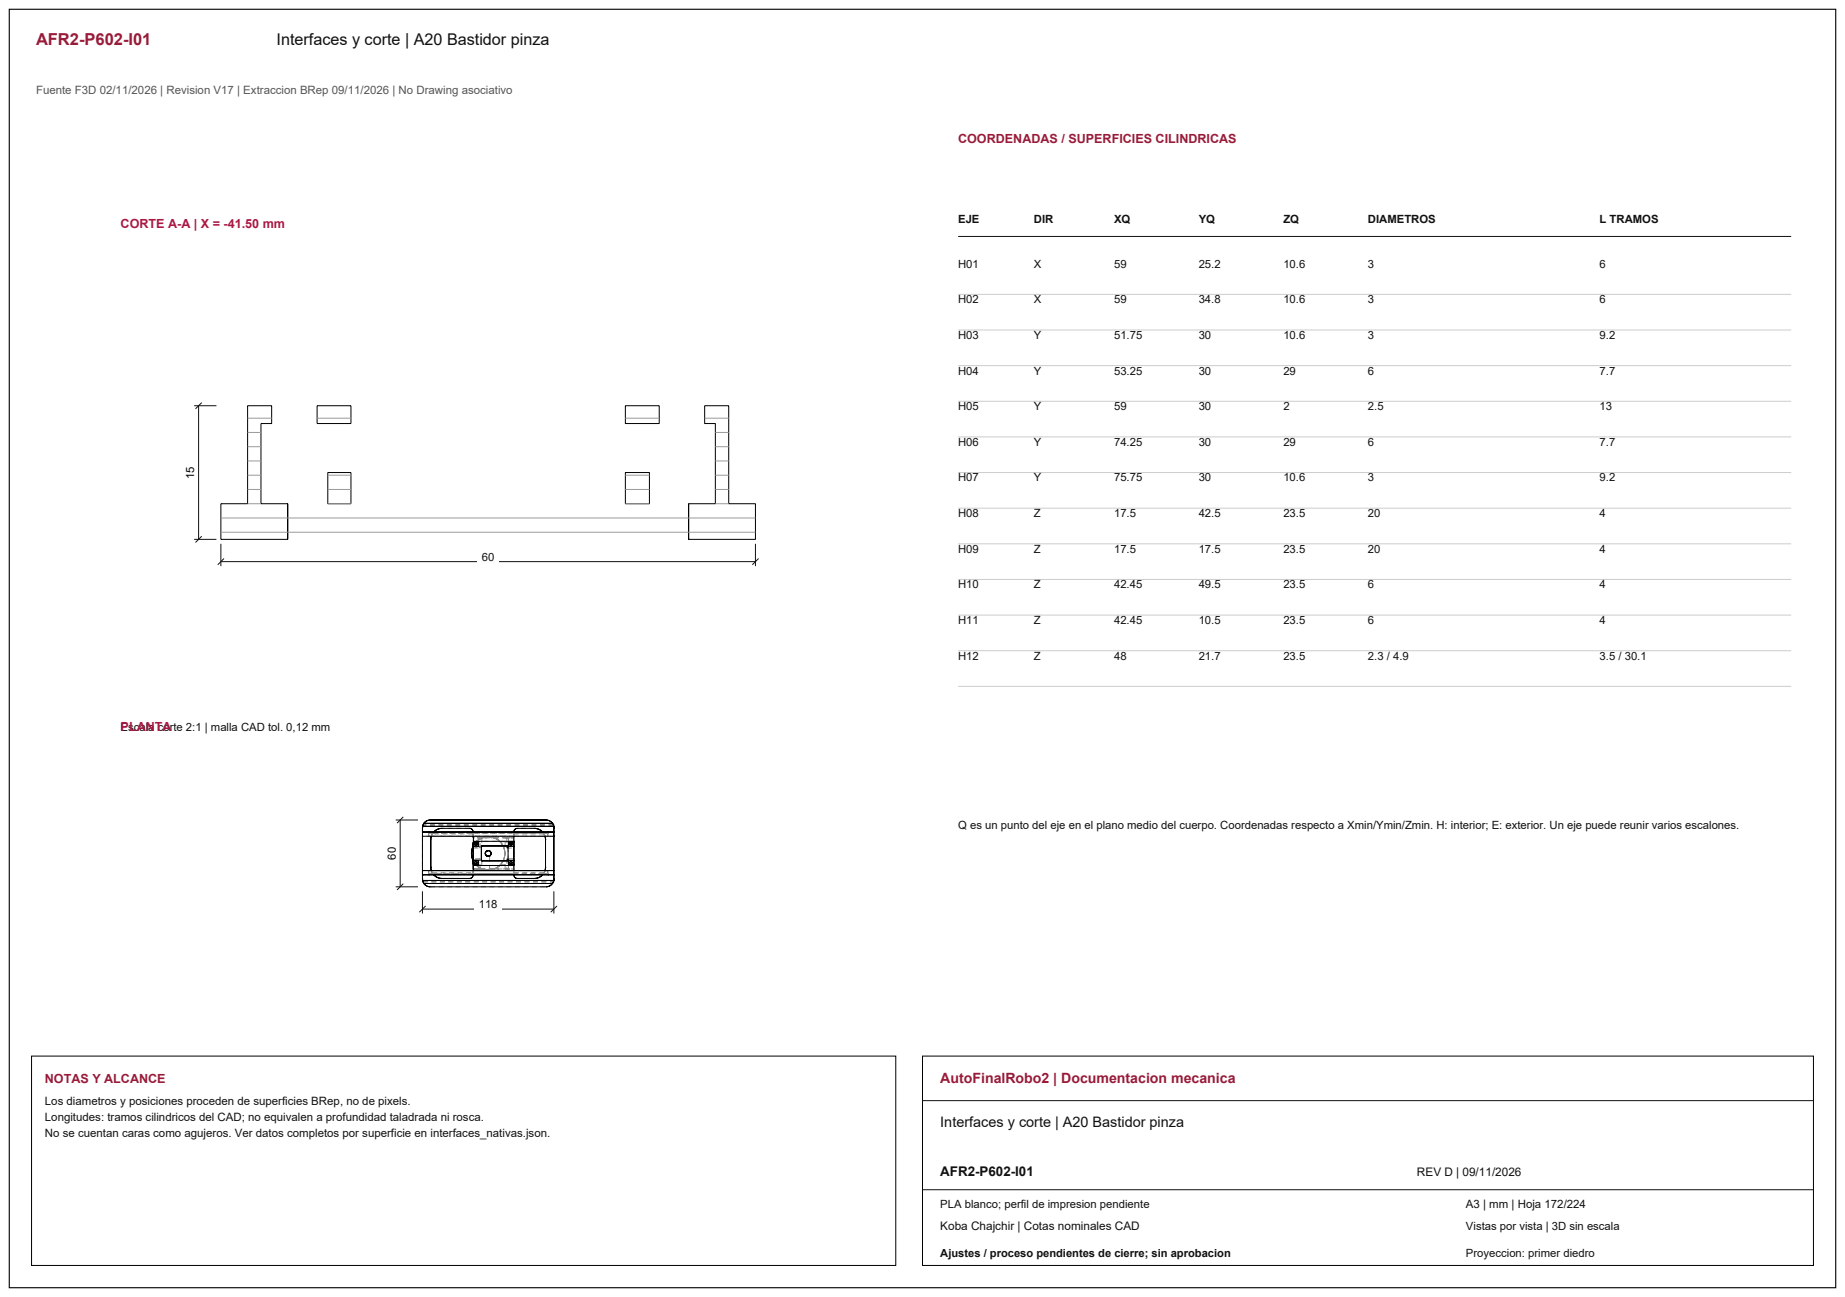
[picture p367: page 11]
CORTE A-A | X = -41.50 mm; EJE; DIR; DIAMETROS; L TRAMOS; NOTAS Y ALCANCE; AutoFinalRobo2 | Documentacion mecanica; AFR2-P602-I01; REV D | 09/11/2026

COORDENADAS / SUPERFICIES CILINDRICAS

Escala corte 2:1 | malla CAD tol. 0,12 mm PLANTA

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

Interfaces y corte | A20 Bastidor pinza

AFR2-P602-I02 | Interfaces y corte | A20 Bastidor pinza

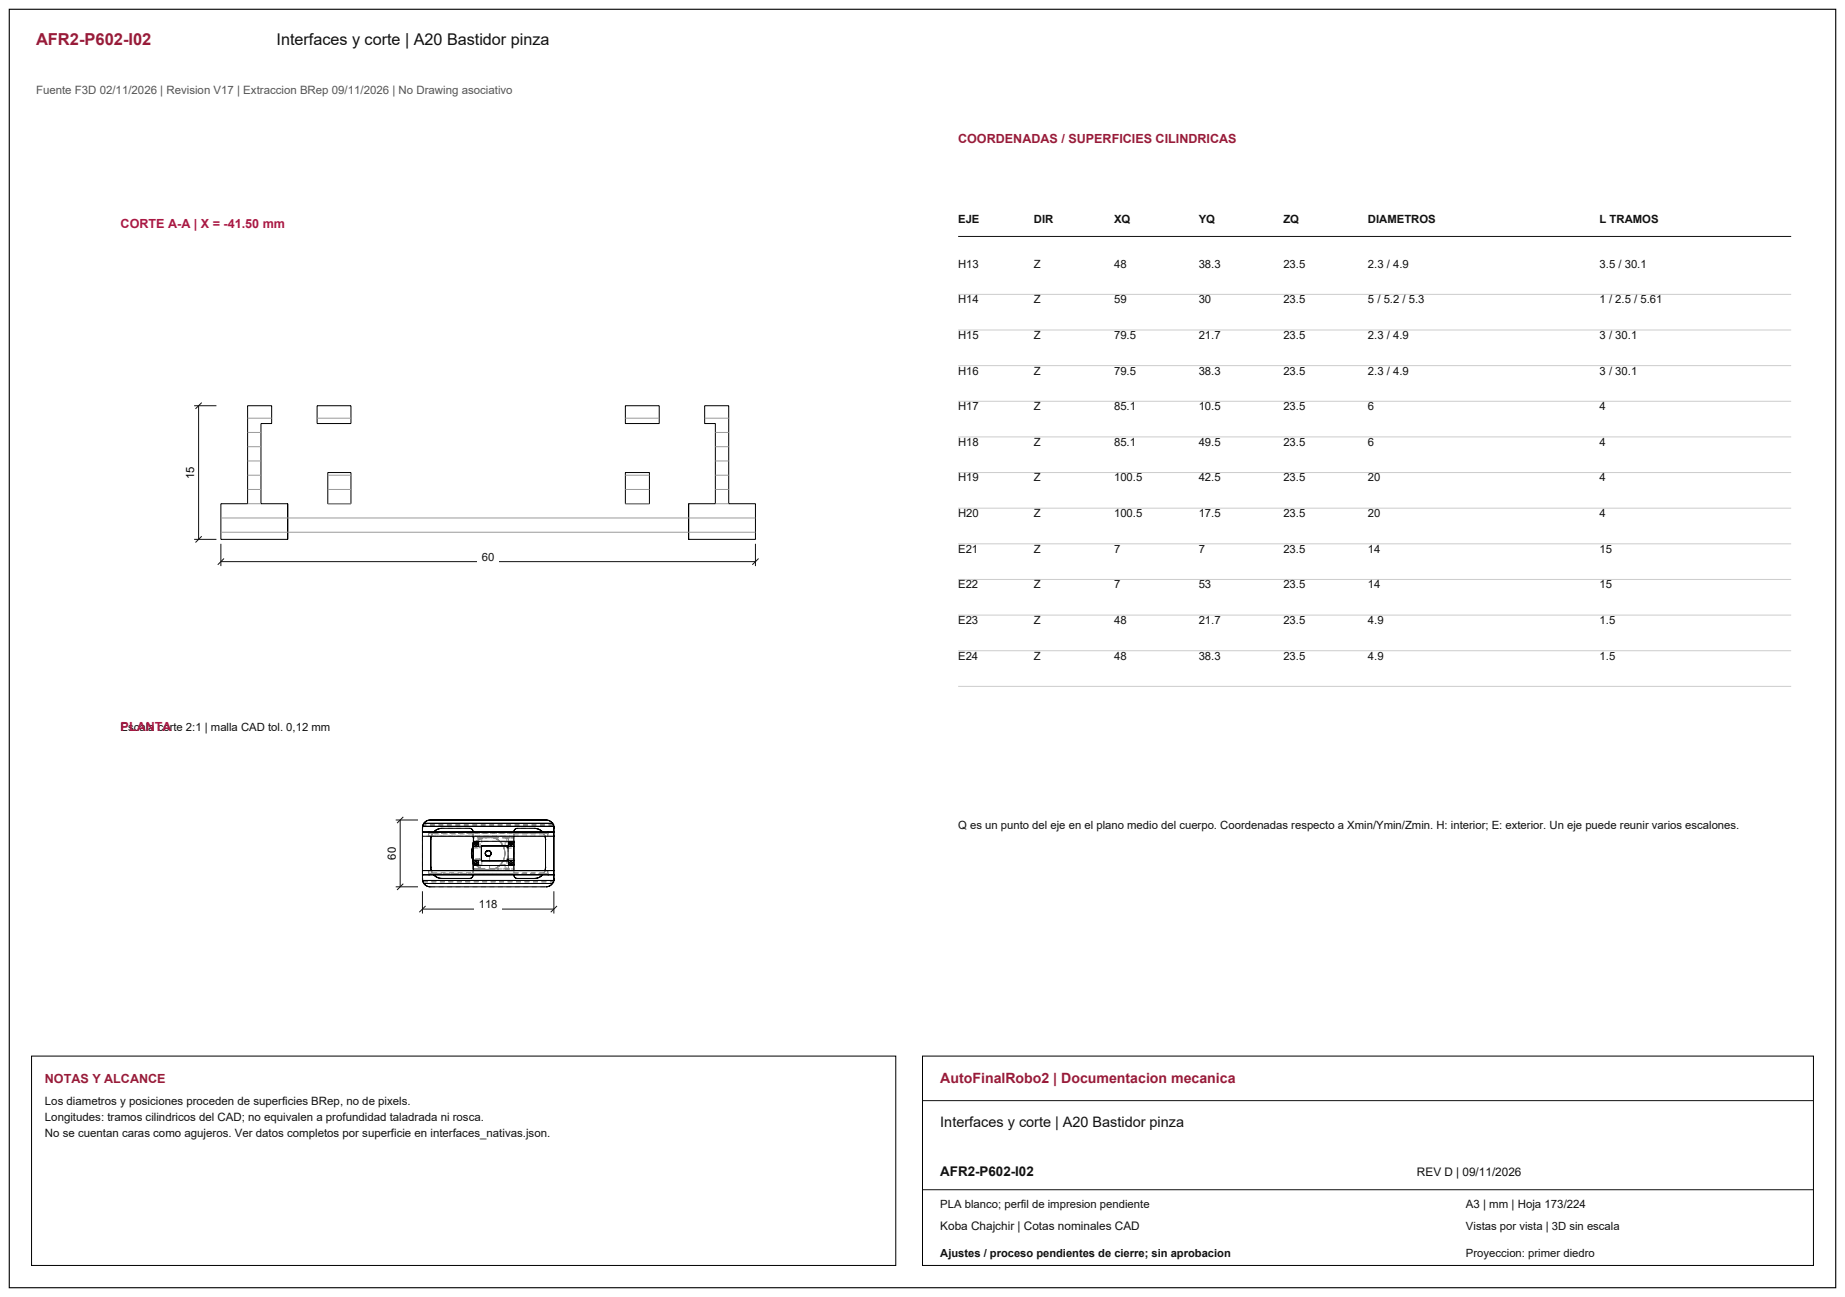
[picture p368: page 12]
CORTE A-A | X = -41.50 mm; EJE; DIR; DIAMETROS; L TRAMOS; NOTAS Y ALCANCE; AutoFinalRobo2 | Documentacion mecanica; AFR2-P602-I02; REV D | 09/11/2026

COORDENADAS / SUPERFICIES CILINDRICAS

Escala corte 2:1 | malla CAD tol. 0,12 mm PLANTA

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

Interfaces y corte | A20 Bastidor pinza

AFR2-P602-I03 | Interfaces y corte | A20 Bastidor pinza

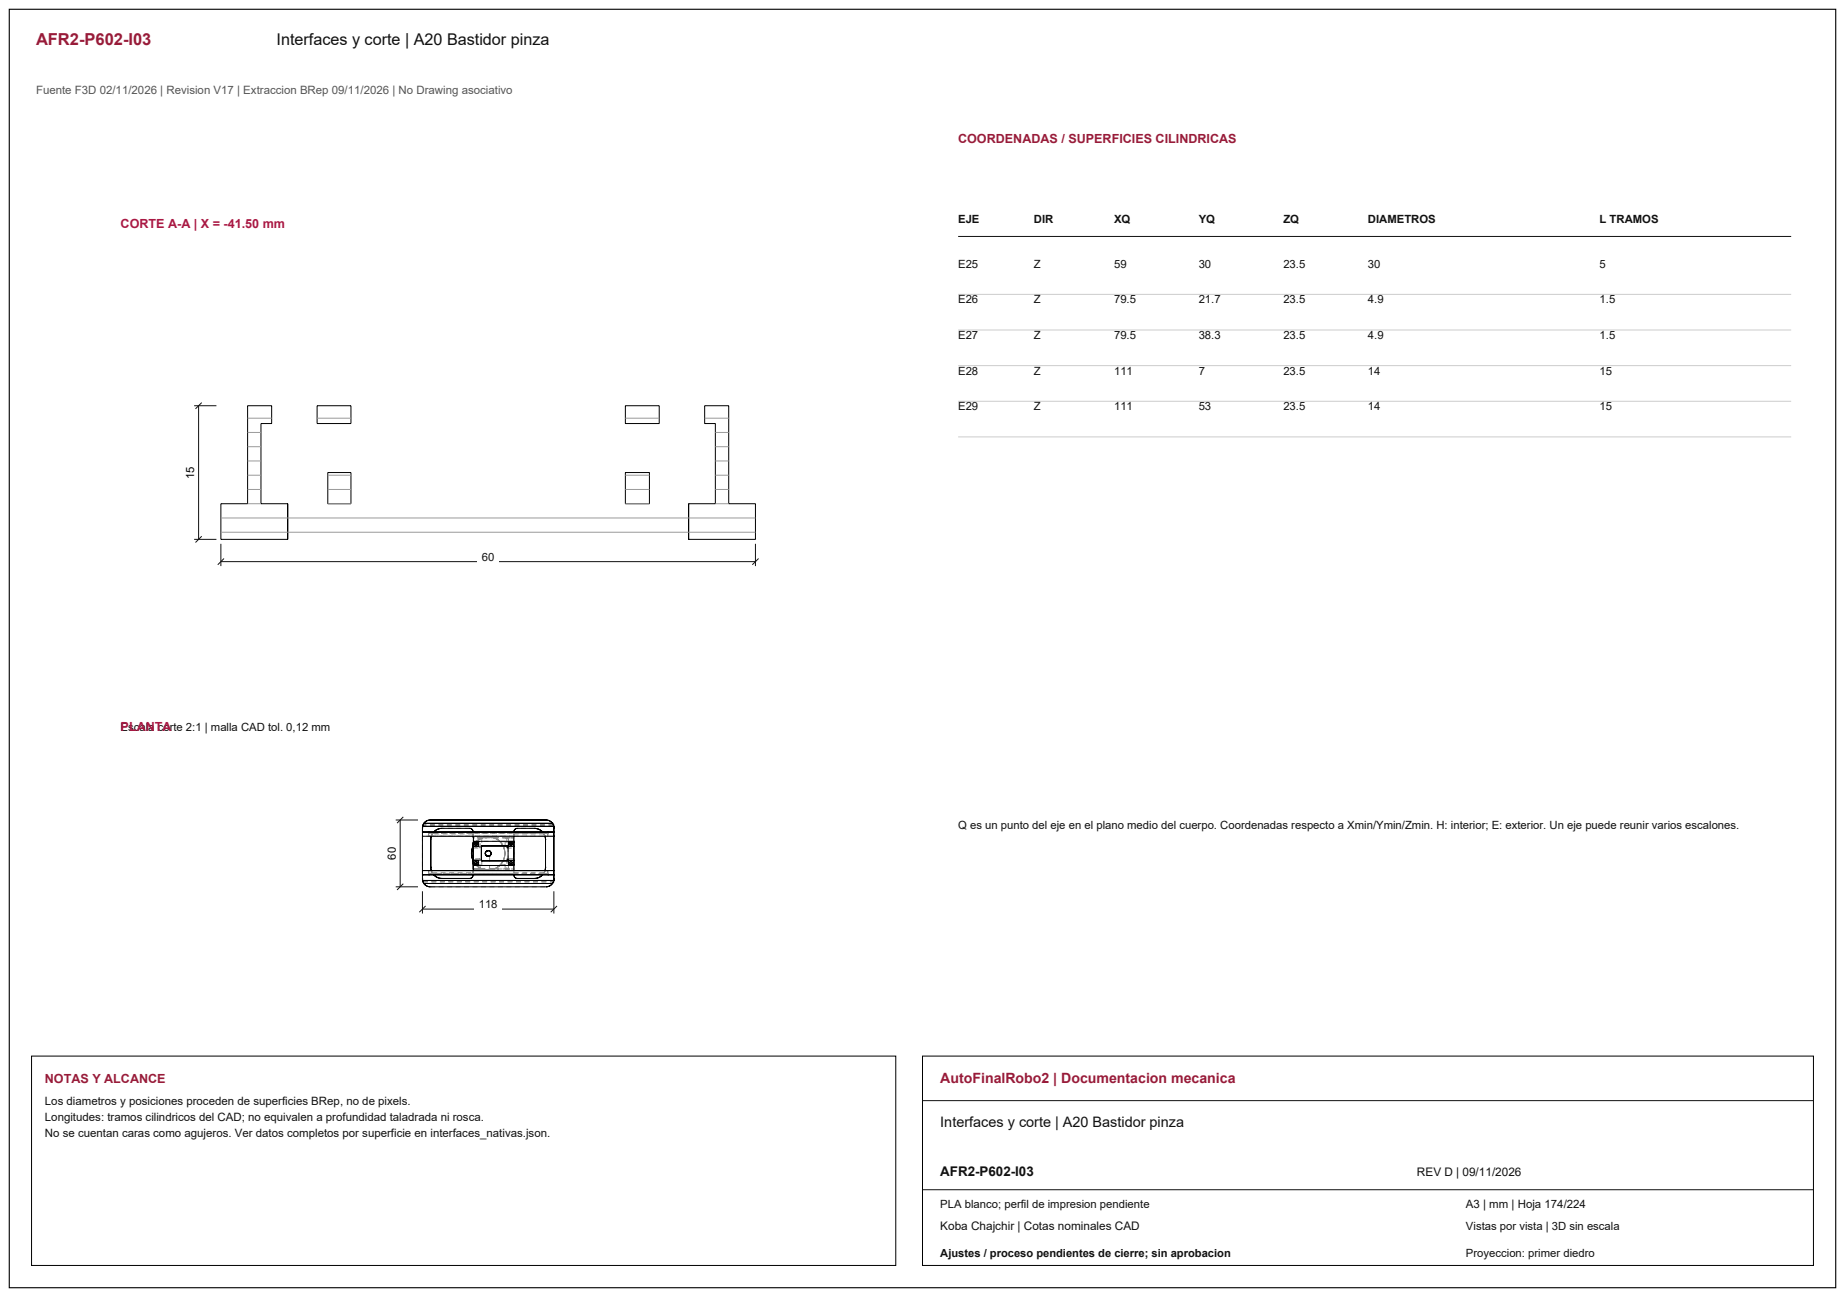
[picture p369: page 13]
CORTE A-A | X = -41.50 mm; EJE; DIR; DIAMETROS; L TRAMOS; NOTAS Y ALCANCE; AutoFinalRobo2 | Documentacion mecanica; AFR2-P602-I03; REV D | 09/11/2026

COORDENADAS / SUPERFICIES CILINDRICAS

Escala corte 2:1 | malla CAD tol. 0,12 mm PLANTA

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

Interfaces y corte | A20 Bastidor pinza

AFR2-P603 | Separador medio J6

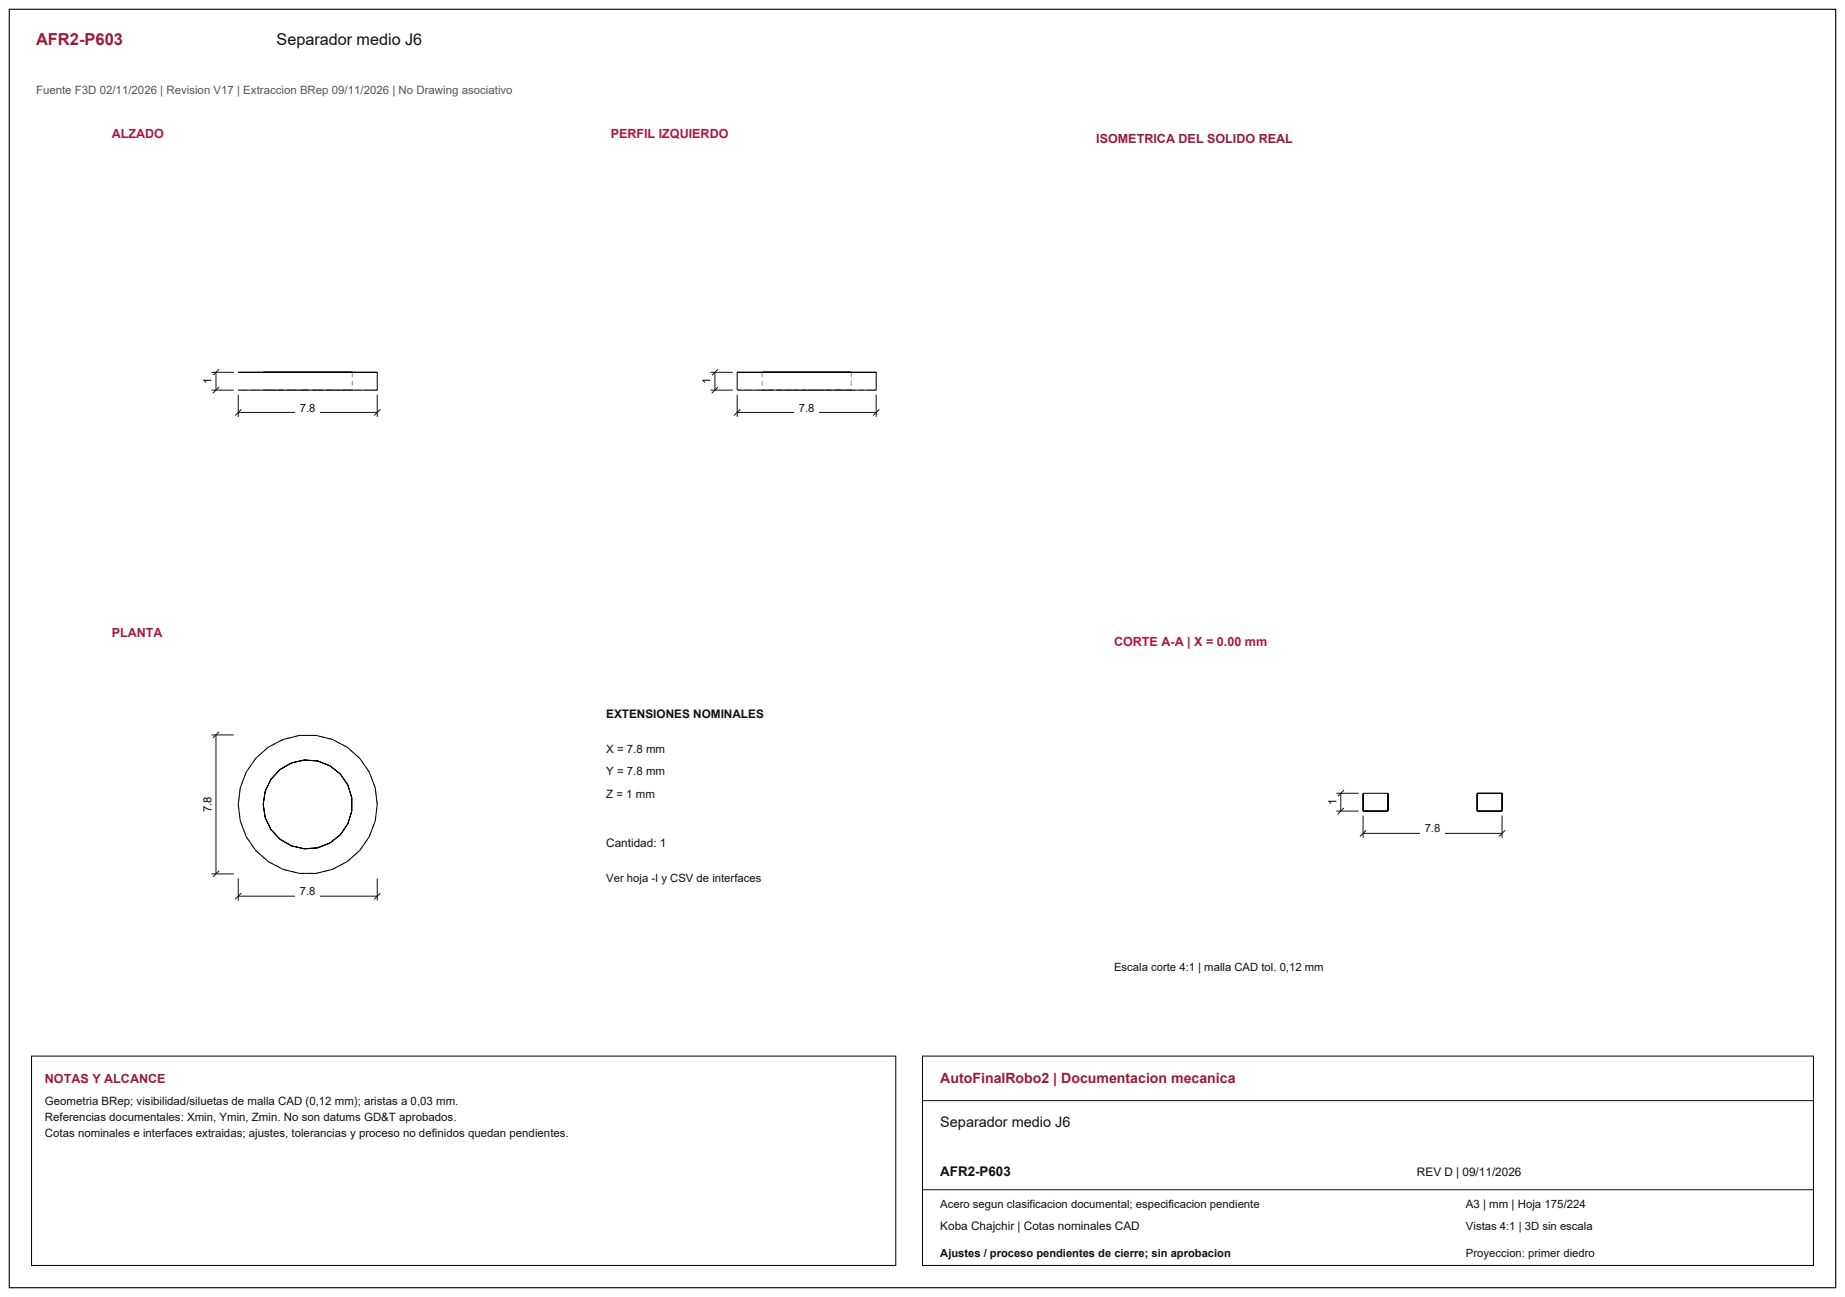
[picture p370: page 14]
ALZADO; PERFIL IZQUIERDO; PLANTA; CORTE A-A | X = 0.00 mm; EXTENSIONES NOMINALES; Cantidad: 1; NOTAS Y ALCANCE; AutoFinalRobo2 | Documentacion mecanica; Separador medio J6; AFR2-P603; REV D | 09/11/2026

ISOMETRICA DEL SOLIDO REAL

Ver hoja -I y CSV de interfaces

Escala corte 4:1 | malla CAD tol. 0,12 mm

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

Acero segun clasificacion documental; especificacion pendiente

Vistas 4:1 | 3D sin escala

AFR2-P603-I01 | Interfaces y corte | Separador medio J6

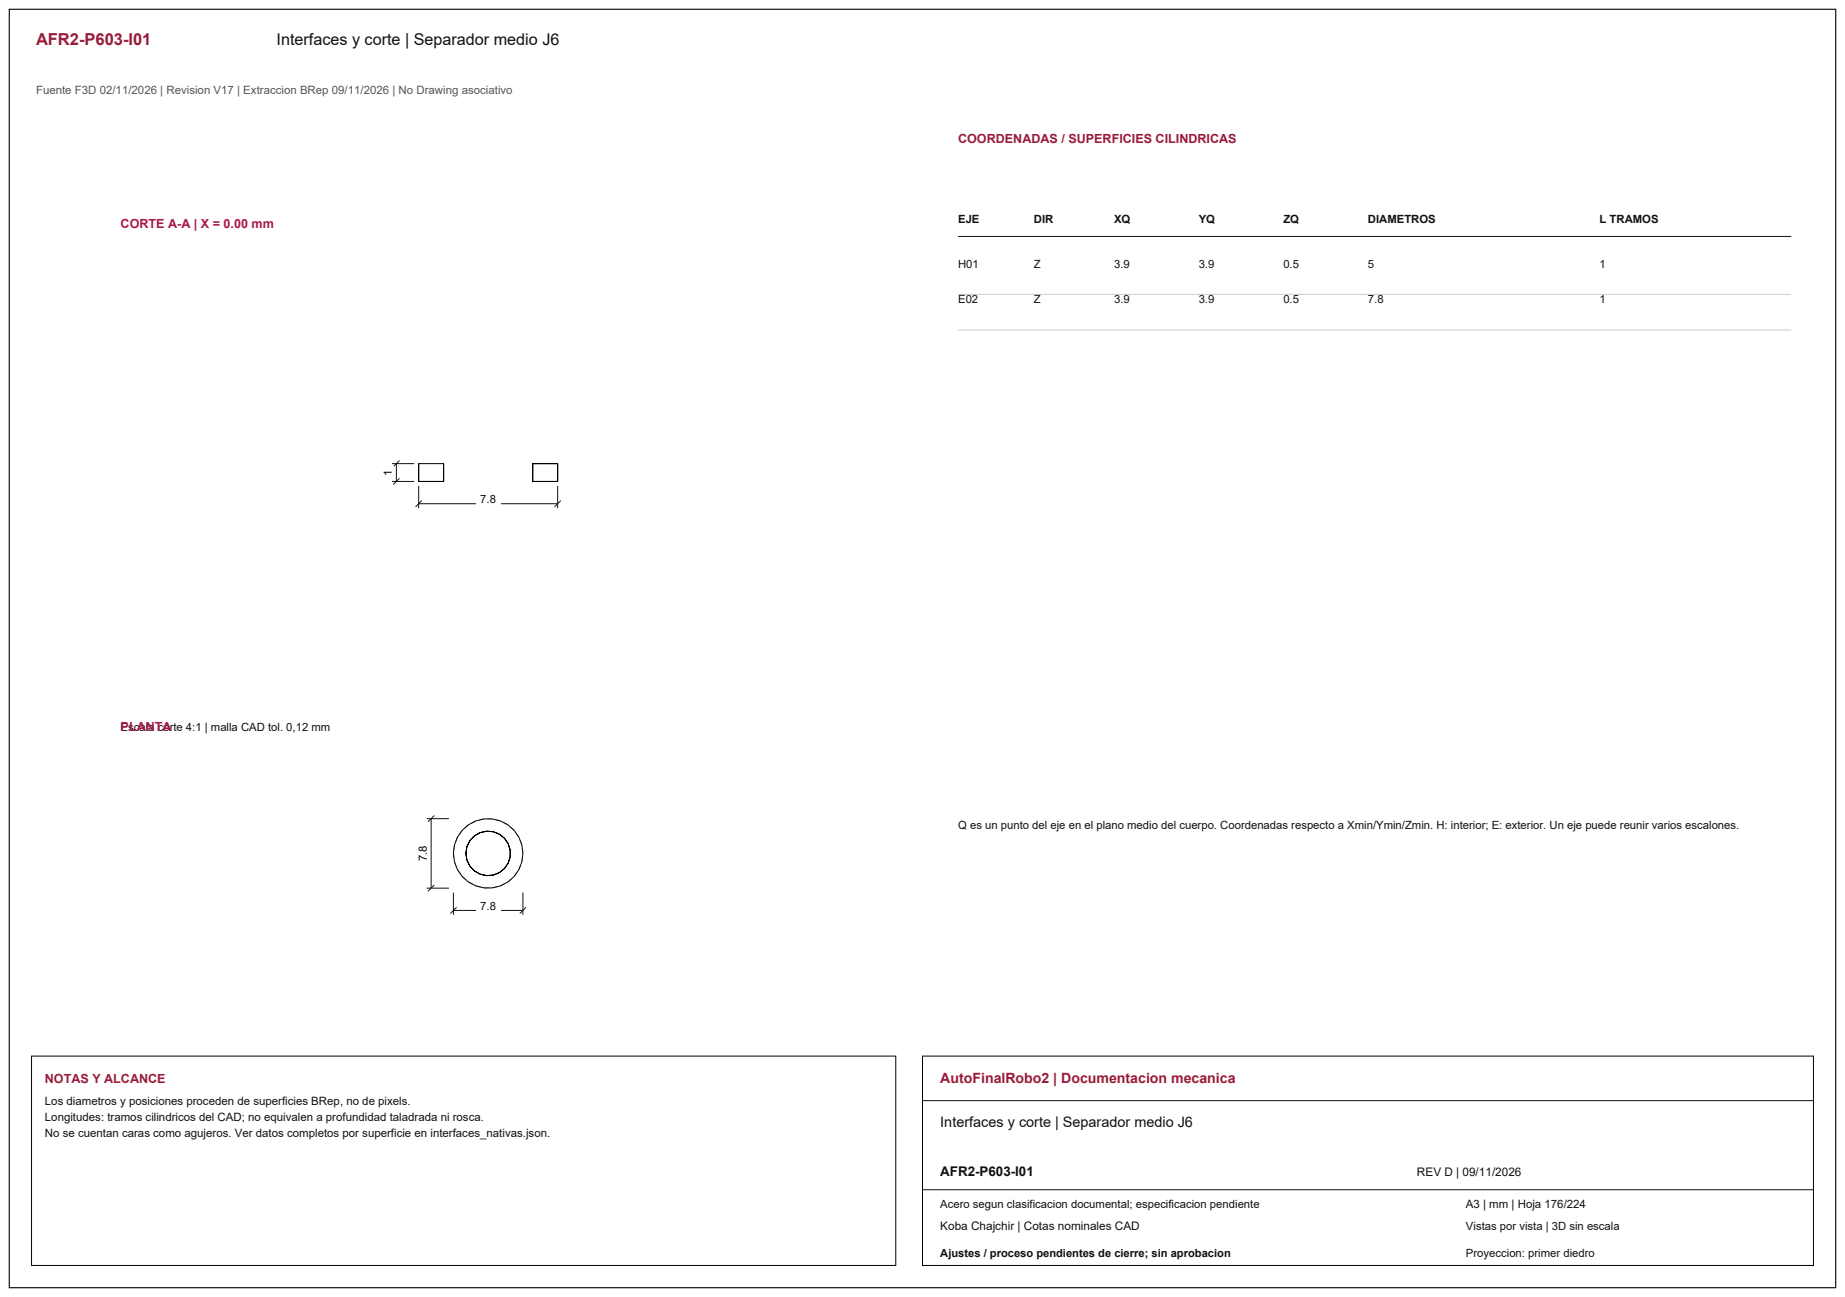
[picture p371: page 15]
CORTE A-A | X = 0.00 mm; EJE; DIR; DIAMETROS; L TRAMOS; NOTAS Y ALCANCE; AutoFinalRobo2 | Documentacion mecanica; AFR2-P603-I01; REV D | 09/11/2026

COORDENADAS / SUPERFICIES CILINDRICAS

Escala corte 4:1 | malla CAD tol. 0,12 mm PLANTA

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

Interfaces y corte | Separador medio J6

Acero segun clasificacion documental; especificacion pendiente

AFR2-P604 | Separador axial J6

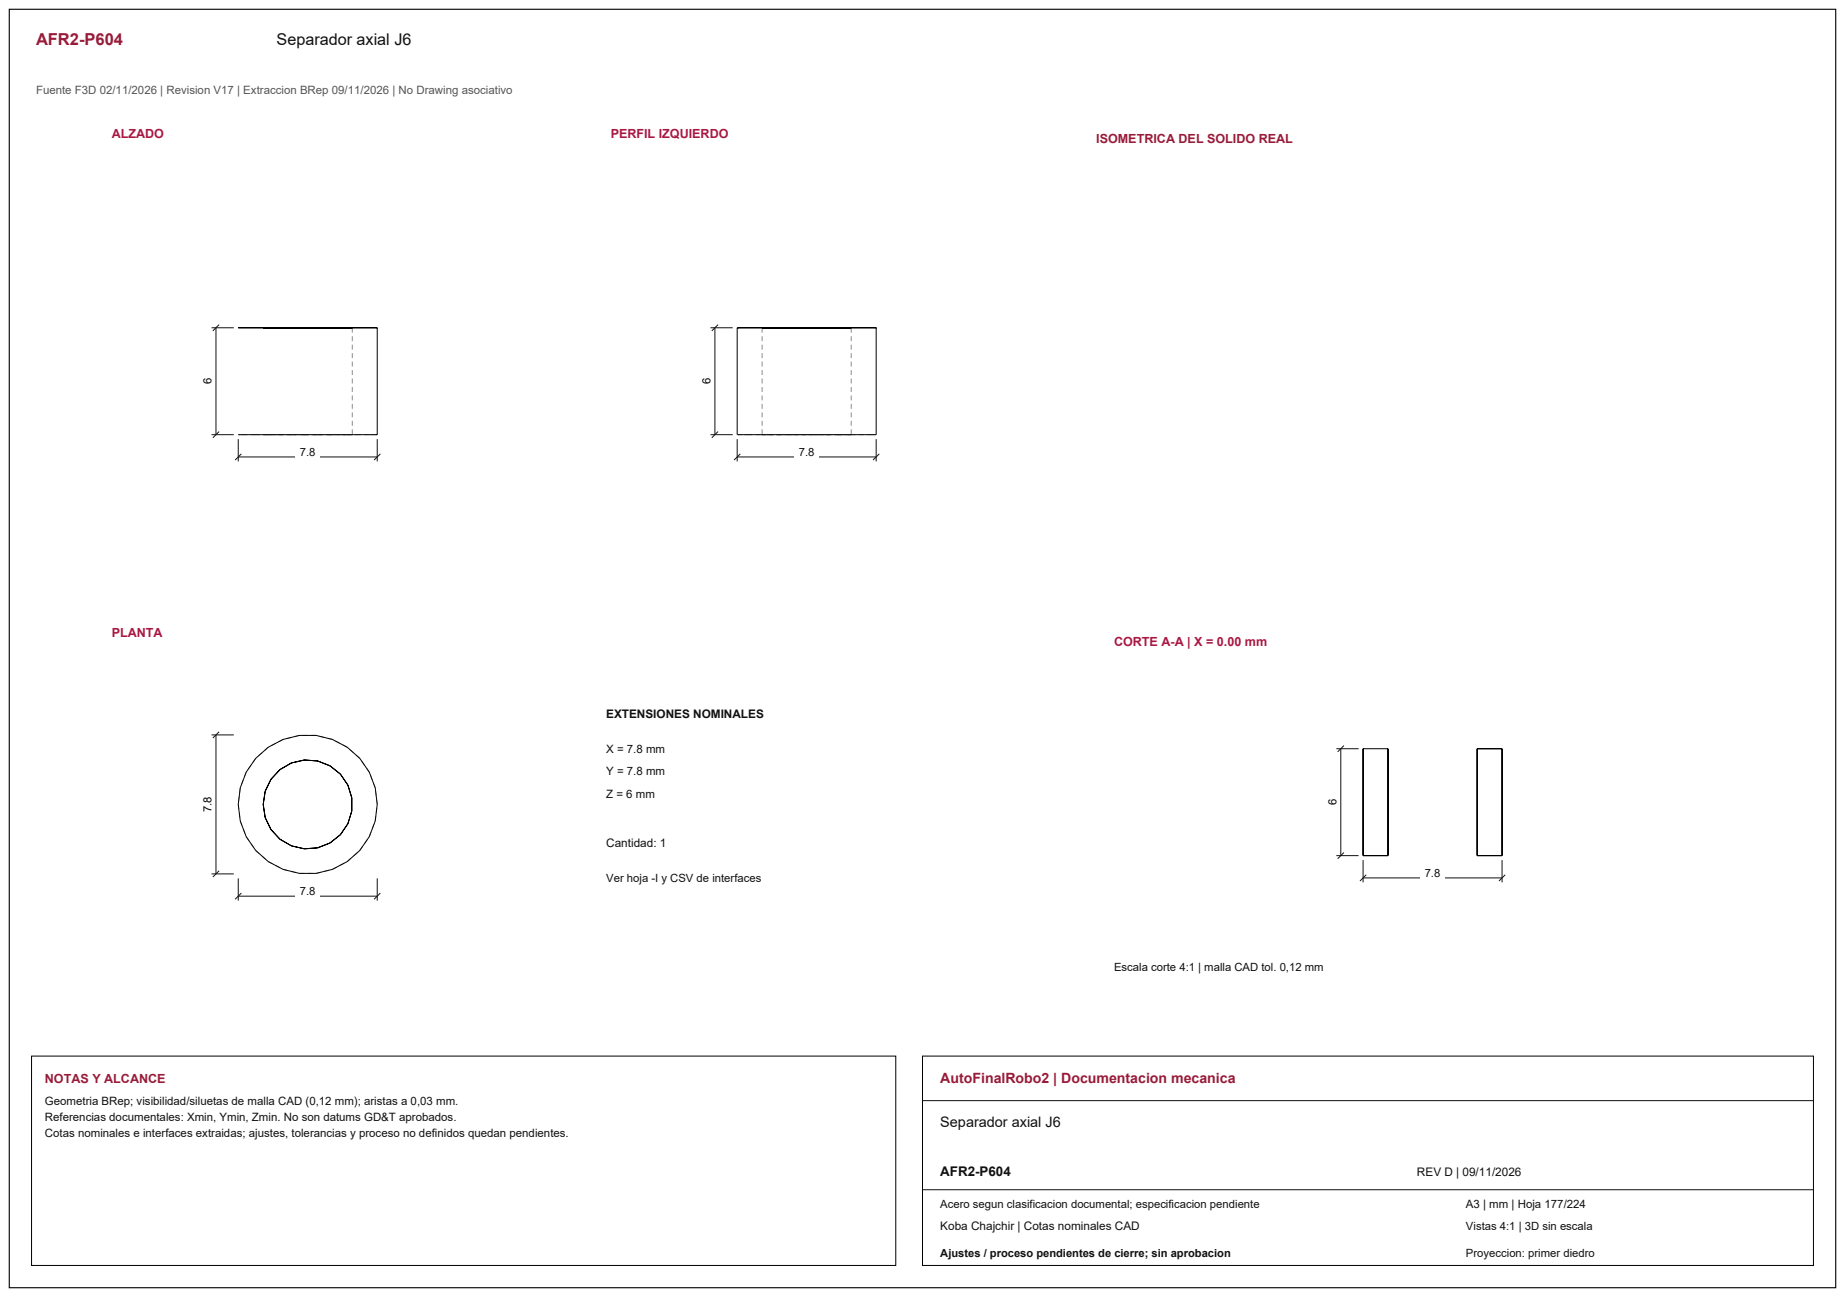
[picture p372: page 16]
ALZADO; PERFIL IZQUIERDO; PLANTA; CORTE A-A | X = 0.00 mm; EXTENSIONES NOMINALES; Cantidad: 1; NOTAS Y ALCANCE; AutoFinalRobo2 | Documentacion mecanica; Separador axial J6; AFR2-P604; REV D | 09/11/2026

ISOMETRICA DEL SOLIDO REAL

Ver hoja -I y CSV de interfaces

Escala corte 4:1 | malla CAD tol. 0,12 mm

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

Acero segun clasificacion documental; especificacion pendiente

Vistas 4:1 | 3D sin escala

AFR2-P604-I01 | Interfaces y corte | Separador axial J6

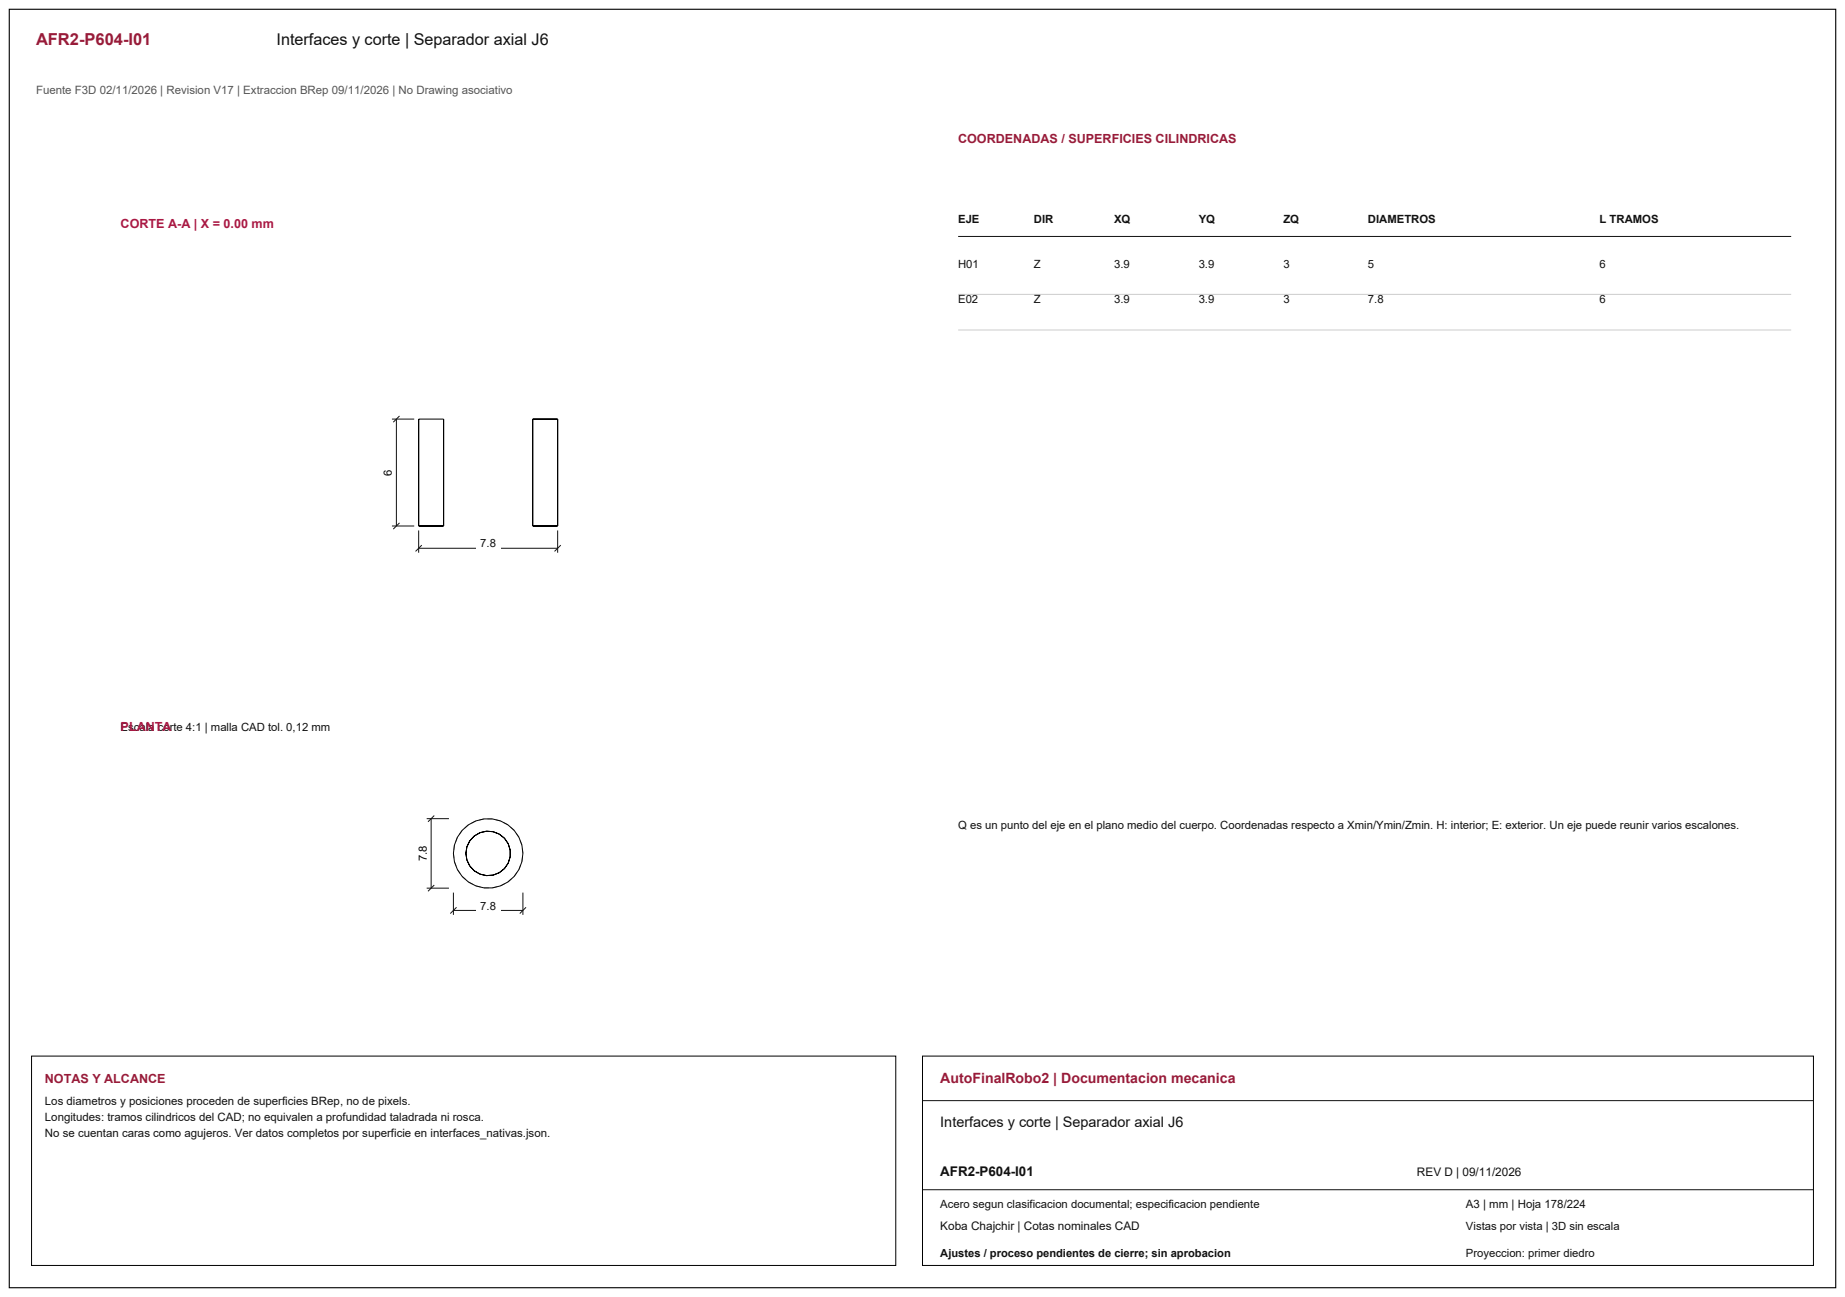
[picture p373: page 17]
CORTE A-A | X = 0.00 mm; EJE; DIR; DIAMETROS; L TRAMOS; NOTAS Y ALCANCE; AutoFinalRobo2 | Documentacion mecanica; AFR2-P604-I01; REV D | 09/11/2026

COORDENADAS / SUPERFICIES CILINDRICAS

Escala corte 4:1 | malla CAD tol. 0,12 mm PLANTA

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

Interfaces y corte | Separador axial J6

Acero segun clasificacion documental; especificacion pendiente

AFR2-P605 | Tapa STS3032 J7

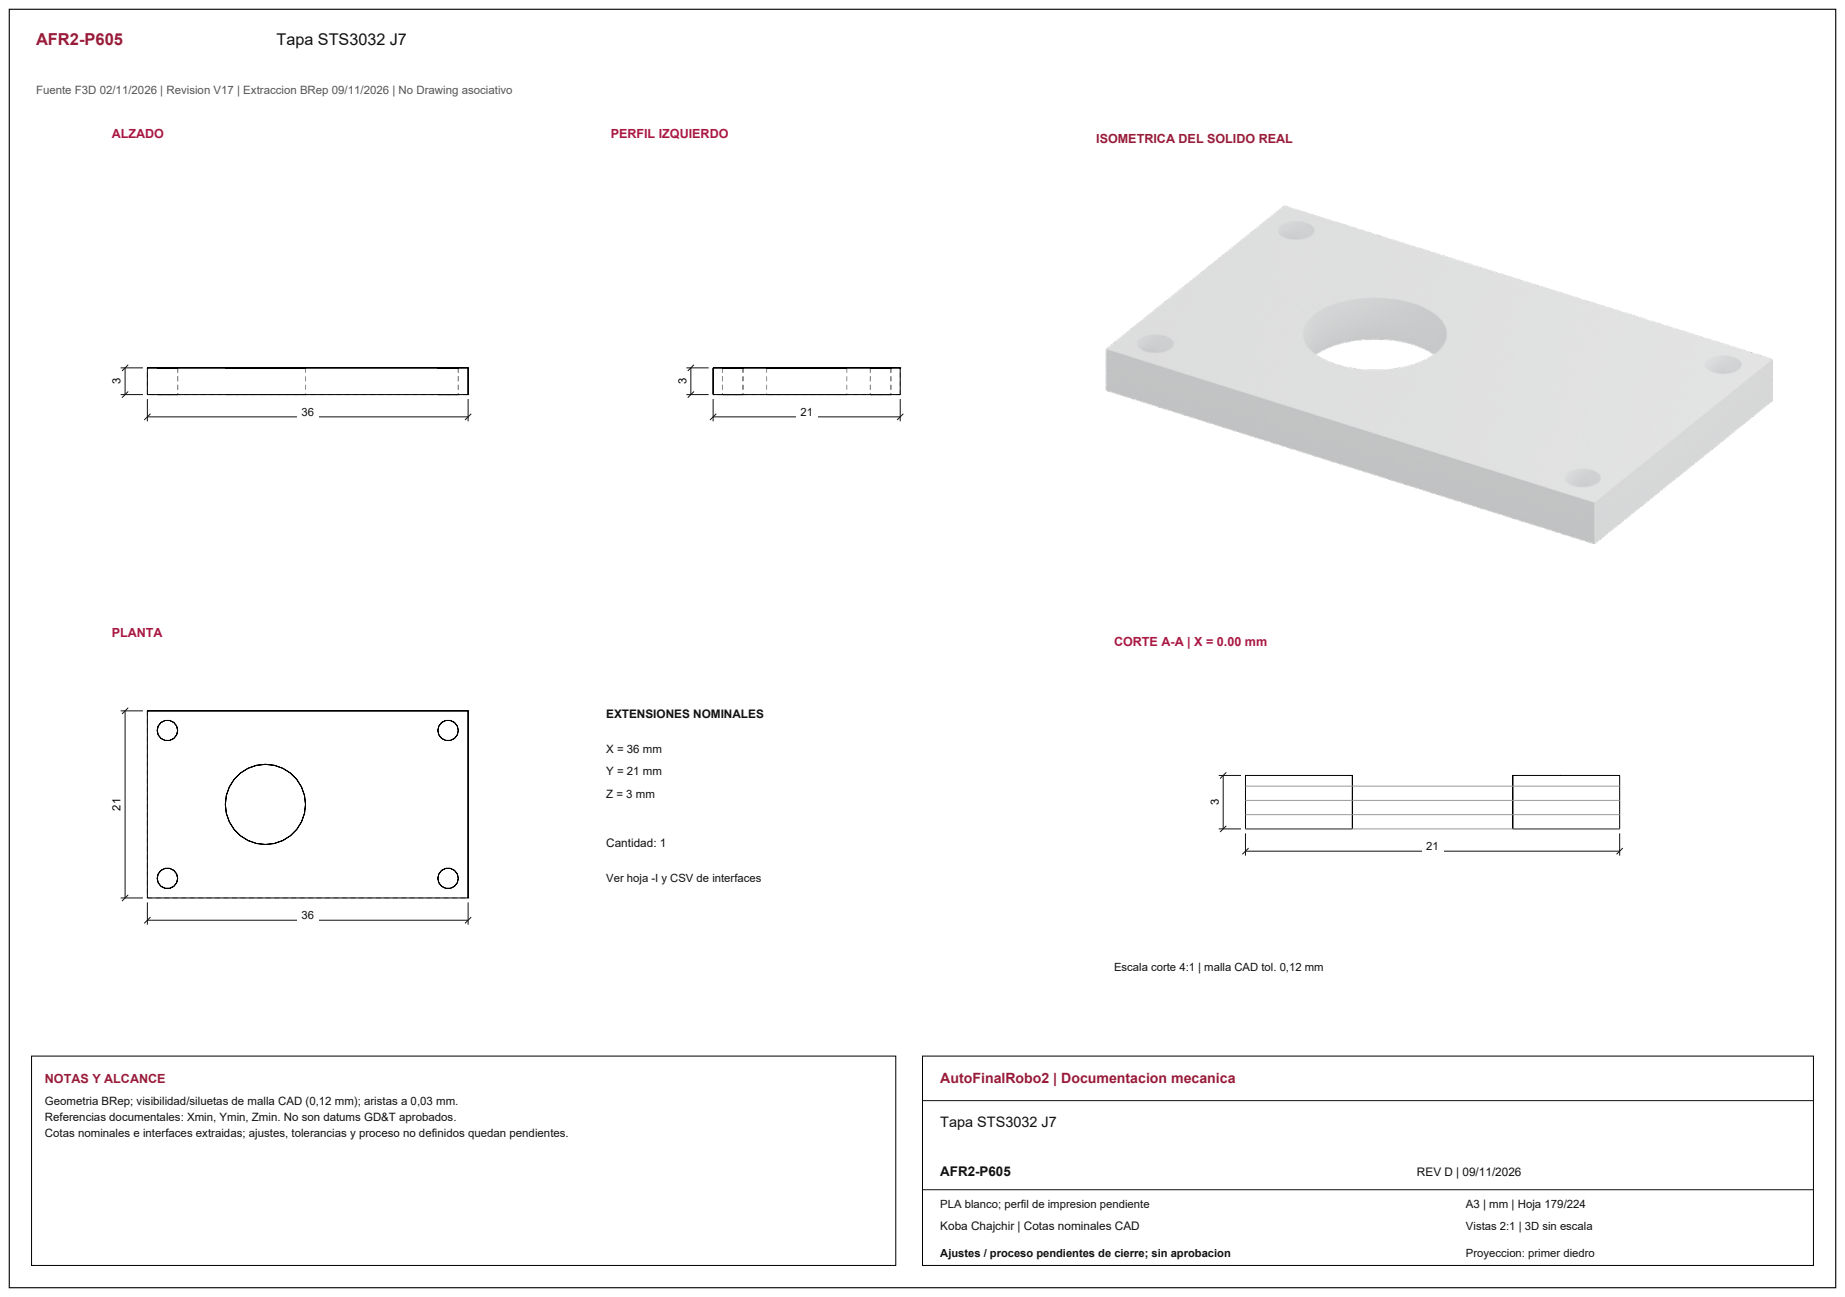
[picture p374: page 18]
ALZADO; PERFIL IZQUIERDO; PLANTA; CORTE A-A | X = 0.00 mm; EXTENSIONES NOMINALES; Cantidad: 1; NOTAS Y ALCANCE; AutoFinalRobo2 | Documentacion mecanica; Tapa STS3032 J7; AFR2-P605; REV D | 09/11/2026

ISOMETRICA DEL SOLIDO REAL

Ver hoja -I y CSV de interfaces

Escala corte 4:1 | malla CAD tol. 0,12 mm

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

Vistas 2:1 | 3D sin escala

AFR2-P605-I01 | Interfaces y corte | Tapa STS3032 J7

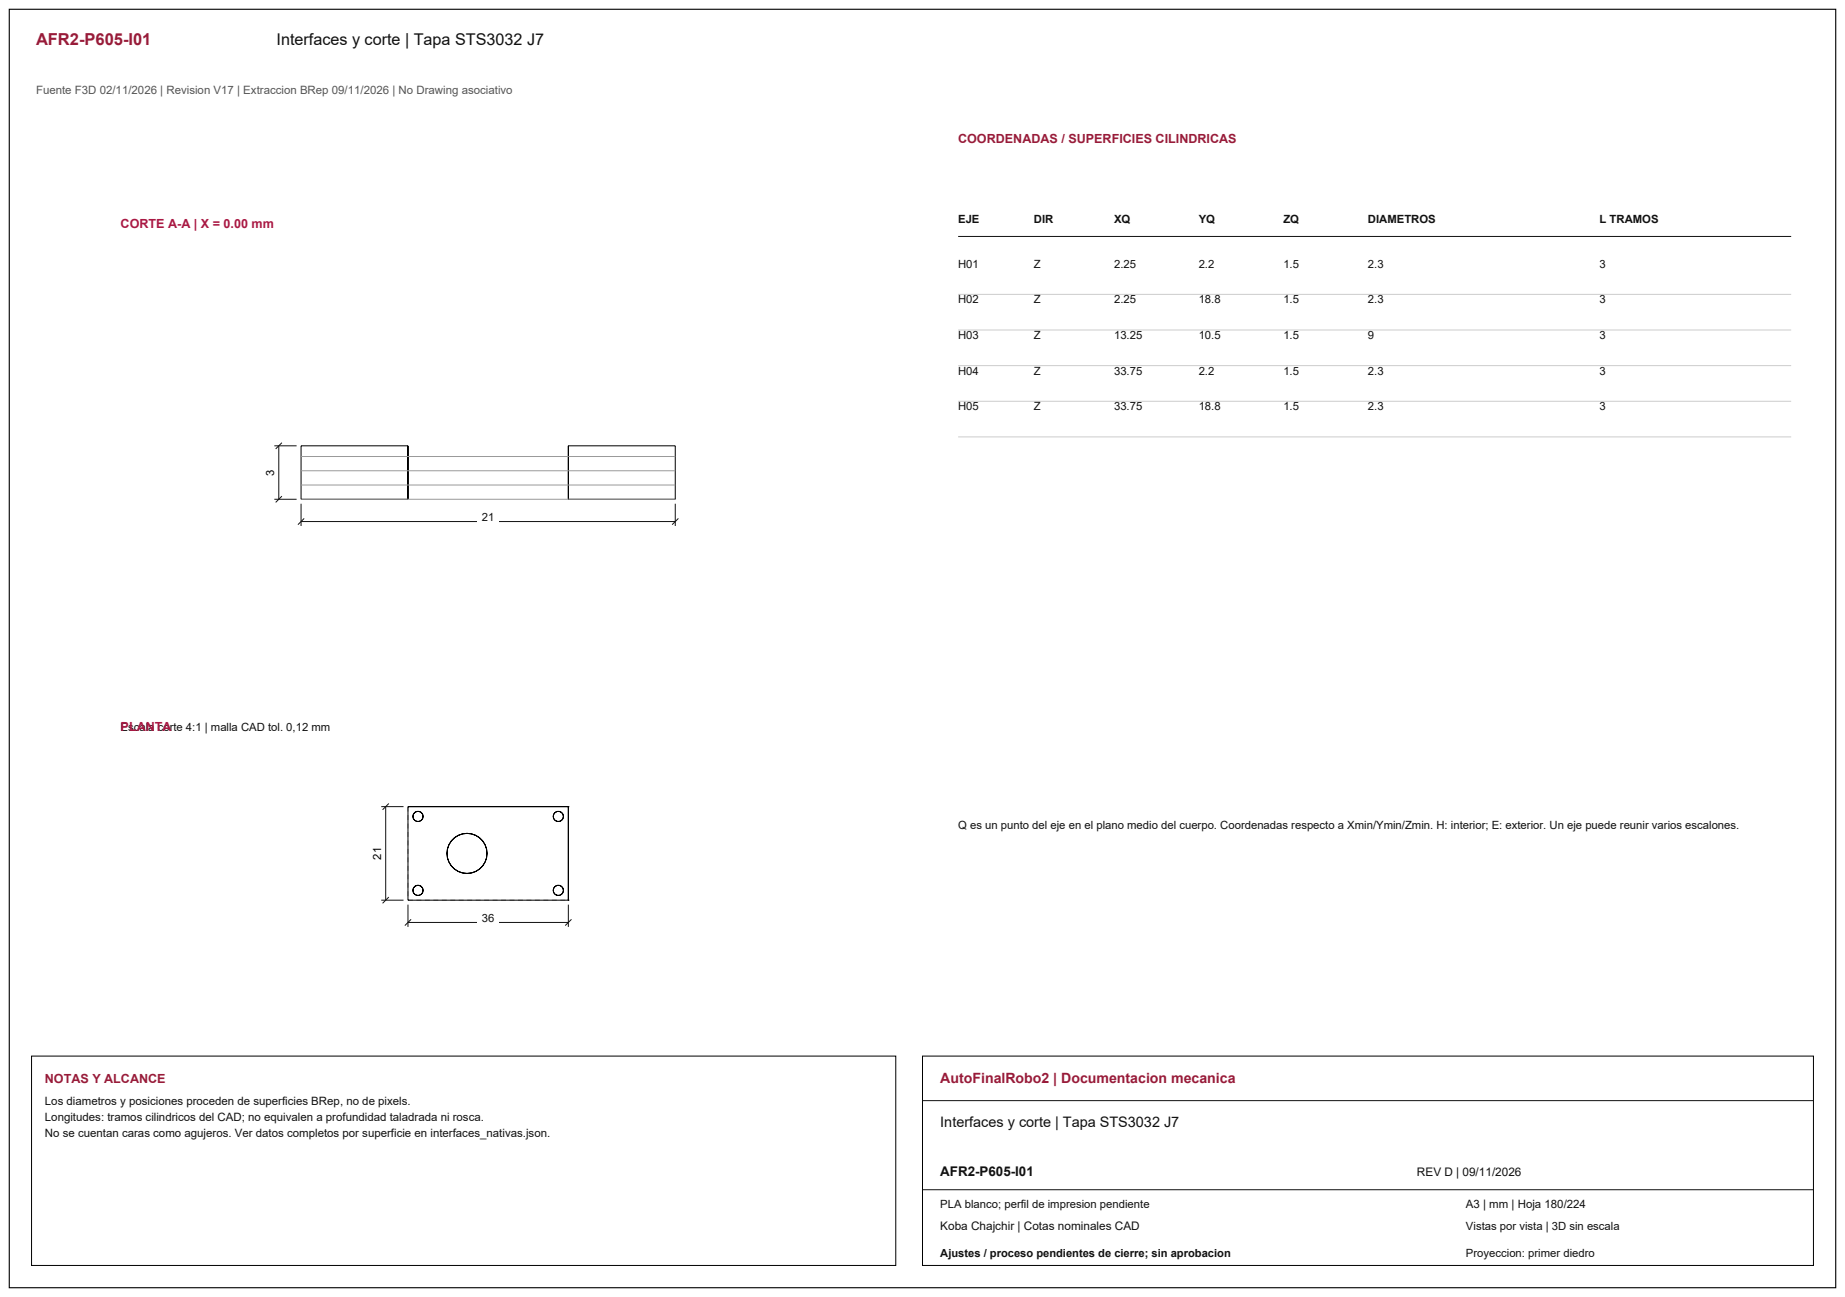
[picture p375: page 19]
CORTE A-A | X = 0.00 mm; EJE; DIR; DIAMETROS; L TRAMOS; NOTAS Y ALCANCE; AutoFinalRobo2 | Documentacion mecanica; AFR2-P605-I01; REV D | 09/11/2026

COORDENADAS / SUPERFICIES CILINDRICAS

Escala corte 4:1 | malla CAD tol. 0,12 mm PLANTA

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

Interfaces y corte | Tapa STS3032 J7

AFR2-P606 | Horn STS3032 J6

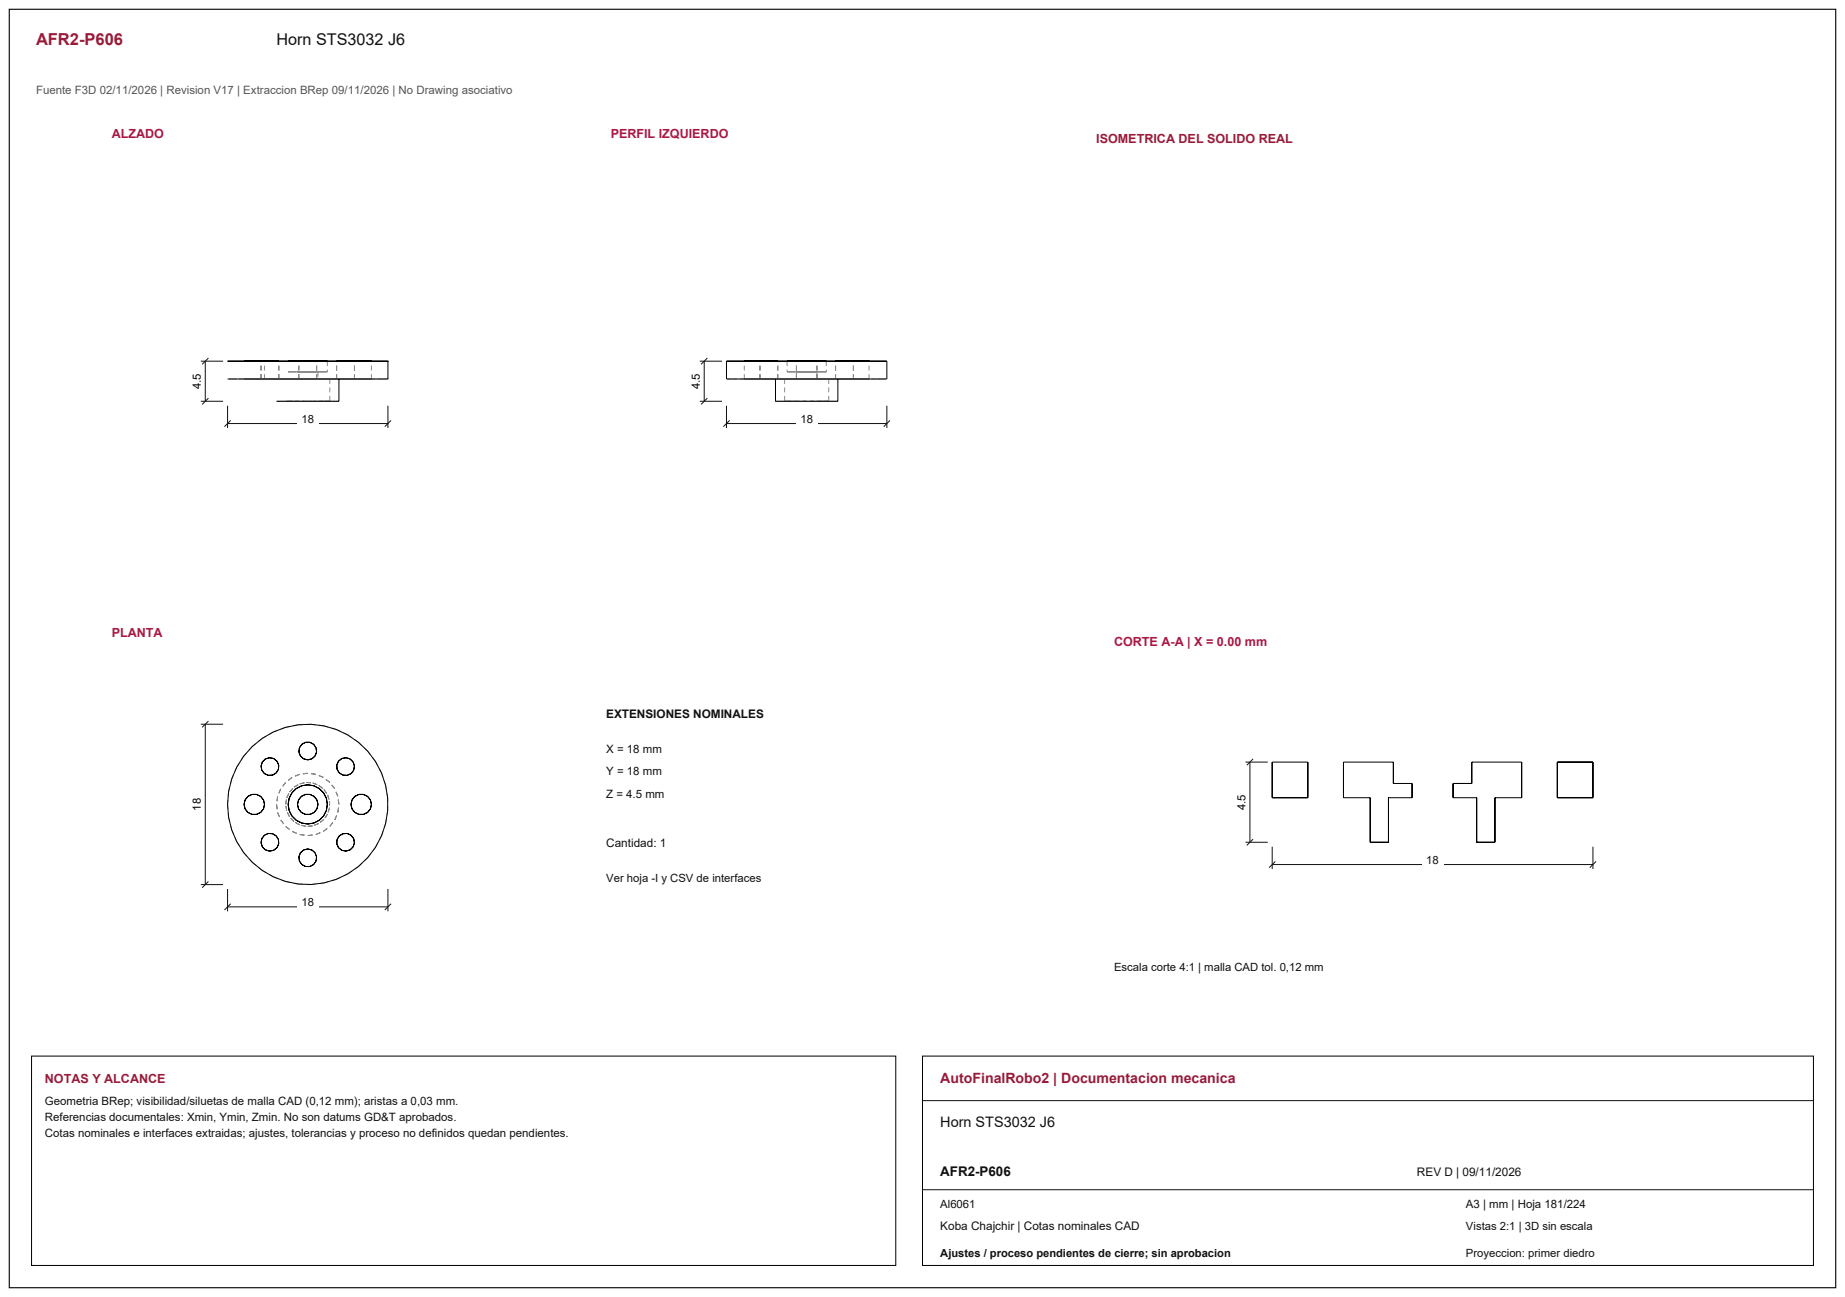
[picture p376: page 20]
ALZADO; PERFIL IZQUIERDO; PLANTA; CORTE A-A | X = 0.00 mm; EXTENSIONES NOMINALES; Cantidad: 1; NOTAS Y ALCANCE; AutoFinalRobo2 | Documentacion mecanica; Horn STS3032 J6; AFR2-P606; REV D | 09/11/2026

ISOMETRICA DEL SOLIDO REAL

Ver hoja -I y CSV de interfaces

Escala corte 4:1 | malla CAD tol. 0,12 mm

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

Vistas 2:1 | 3D sin escala

AFR2-P606-I01 | Interfaces y corte | Horn STS3032 J6

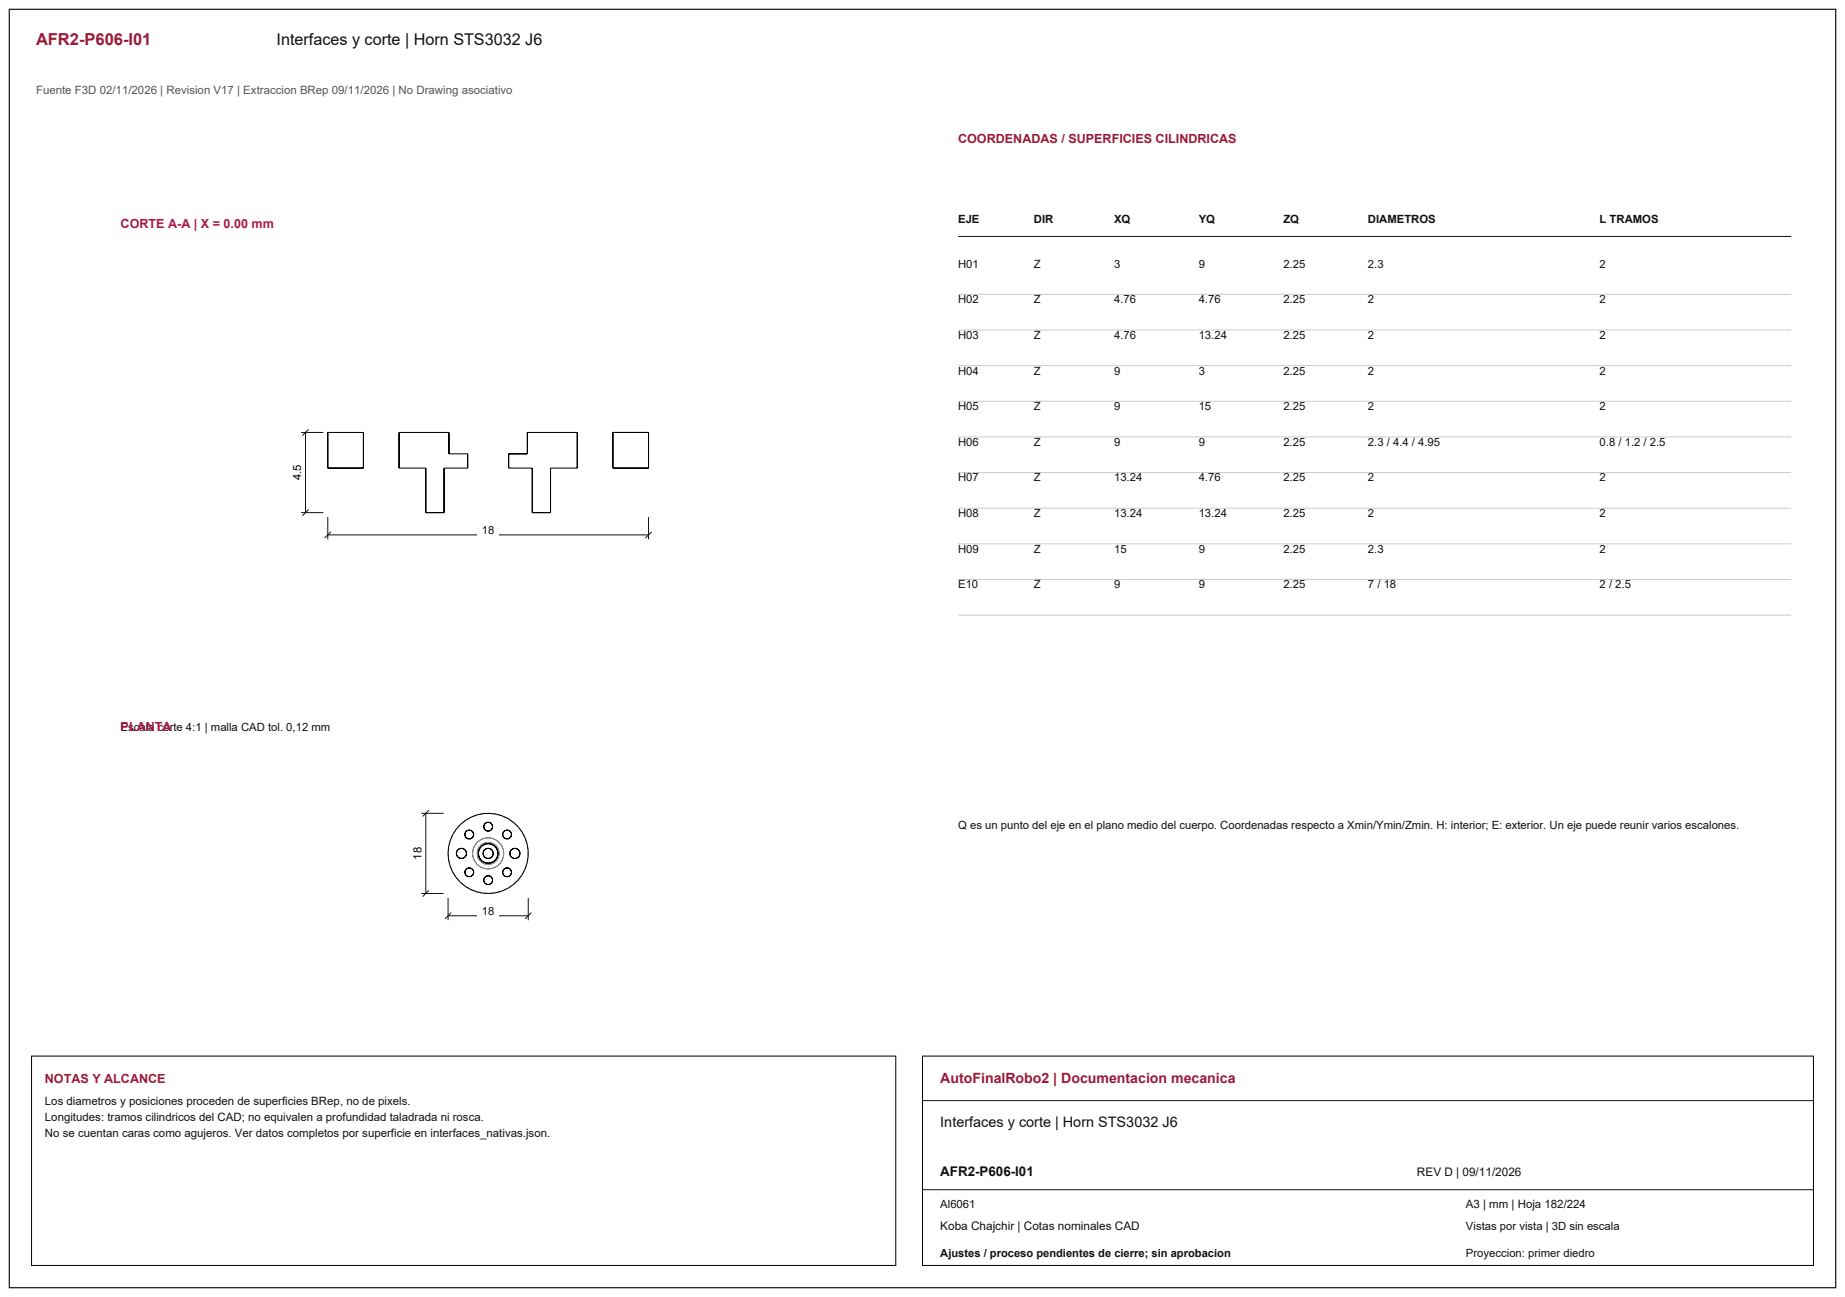
[picture p377: page 21]
CORTE A-A | X = 0.00 mm; EJE; DIR; DIAMETROS; L TRAMOS; NOTAS Y ALCANCE; AutoFinalRobo2 | Documentacion mecanica; AFR2-P606-I01; REV D | 09/11/2026

COORDENADAS / SUPERFICIES CILINDRICAS

Escala corte 4:1 | malla CAD tol. 0,12 mm PLANTA

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

Interfaces y corte | Horn STS3032 J6

AFR2-P618 | Mandibula -1

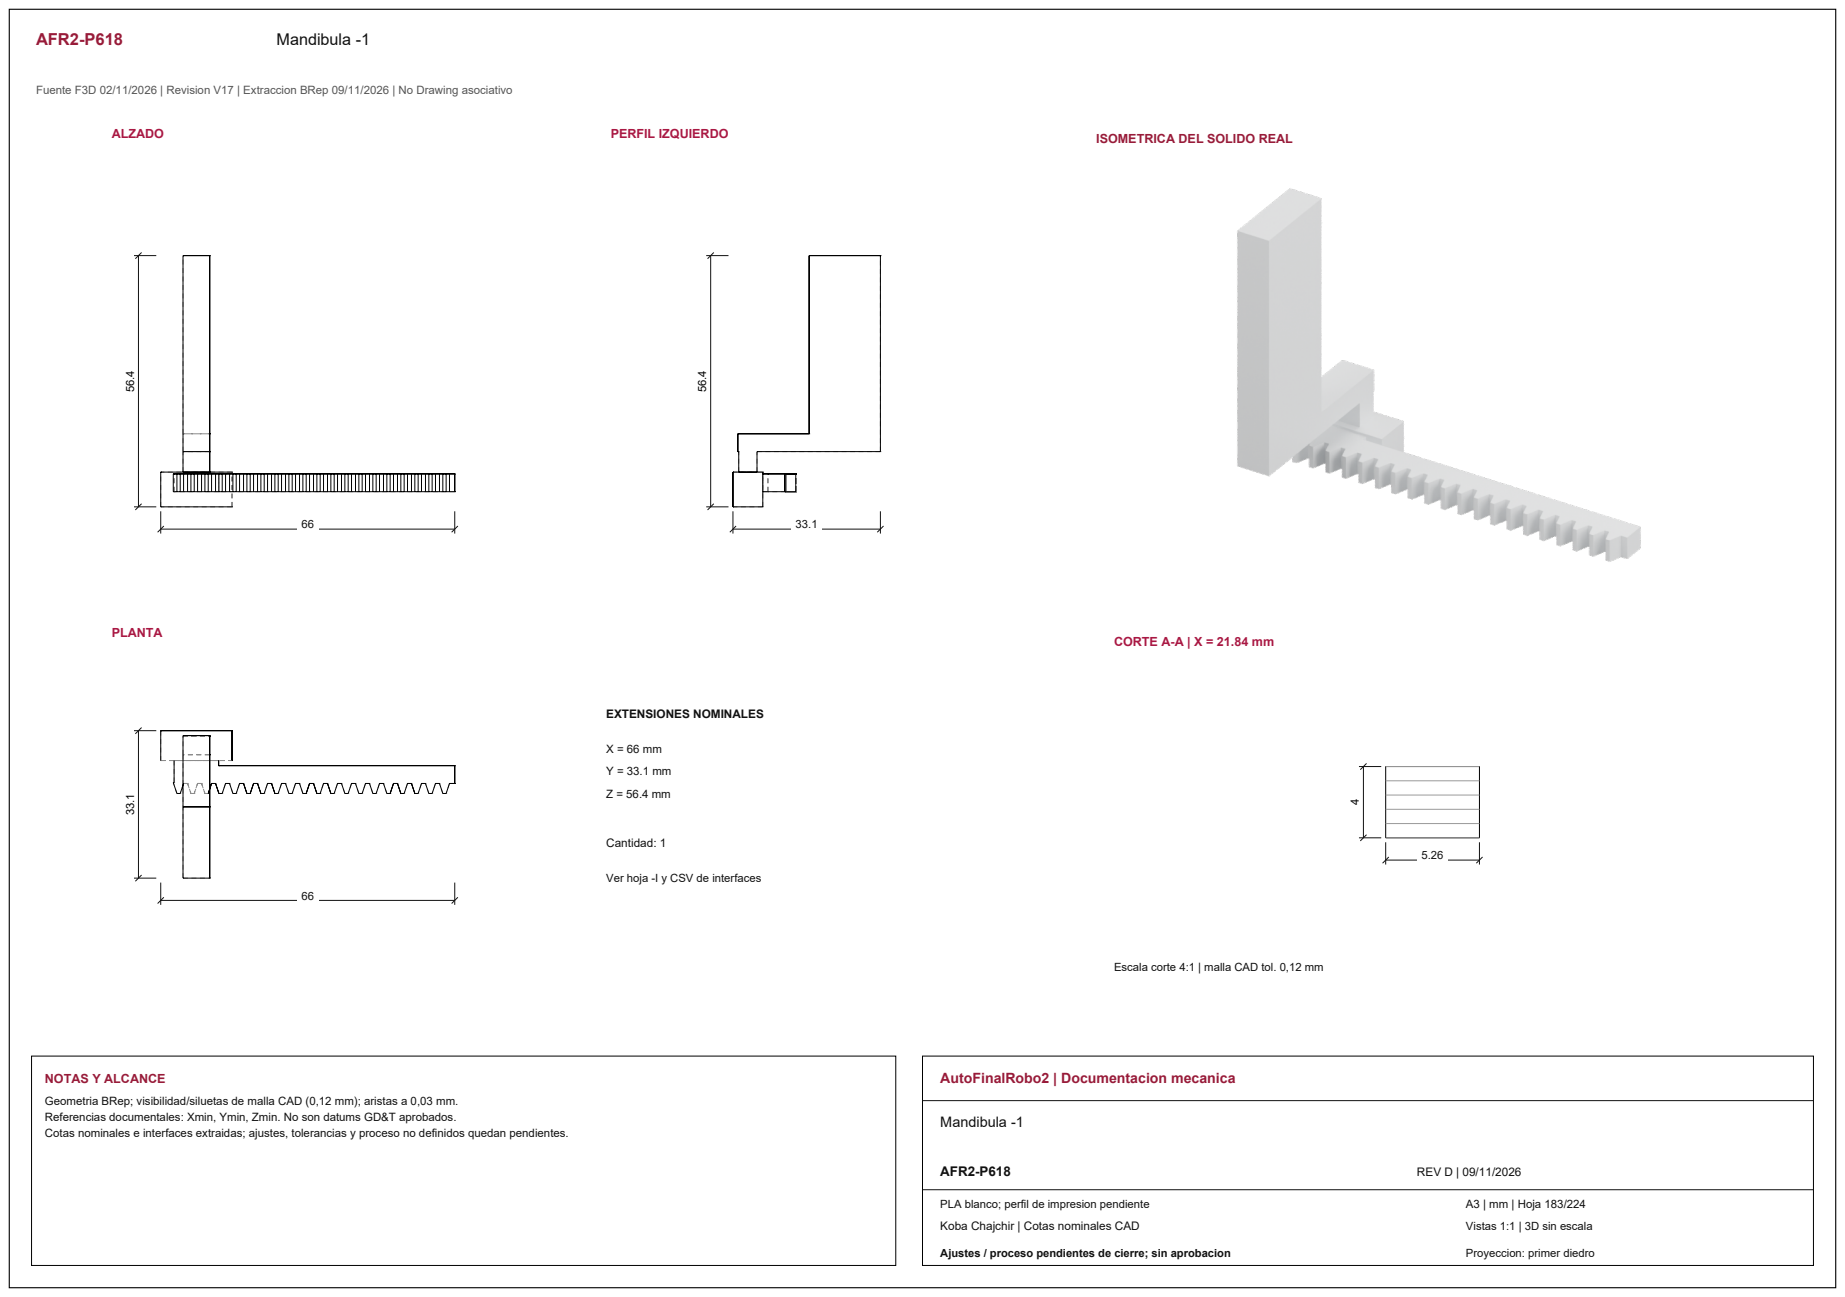
[picture p378: page 22]
ALZADO; PERFIL IZQUIERDO; PLANTA; CORTE A-A | X = 21.84 mm; EXTENSIONES NOMINALES; Cantidad: 1; NOTAS Y ALCANCE; AutoFinalRobo2 | Documentacion mecanica; Mandibula -1; AFR2-P618; REV D | 09/11/2026

ISOMETRICA DEL SOLIDO REAL

Ver hoja -I y CSV de interfaces

Escala corte 4:1 | malla CAD tol. 0,12 mm

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

Vistas 1:1 | 3D sin escala

AFR2-P618-I01 | Interfaces y corte | Mandibula -1

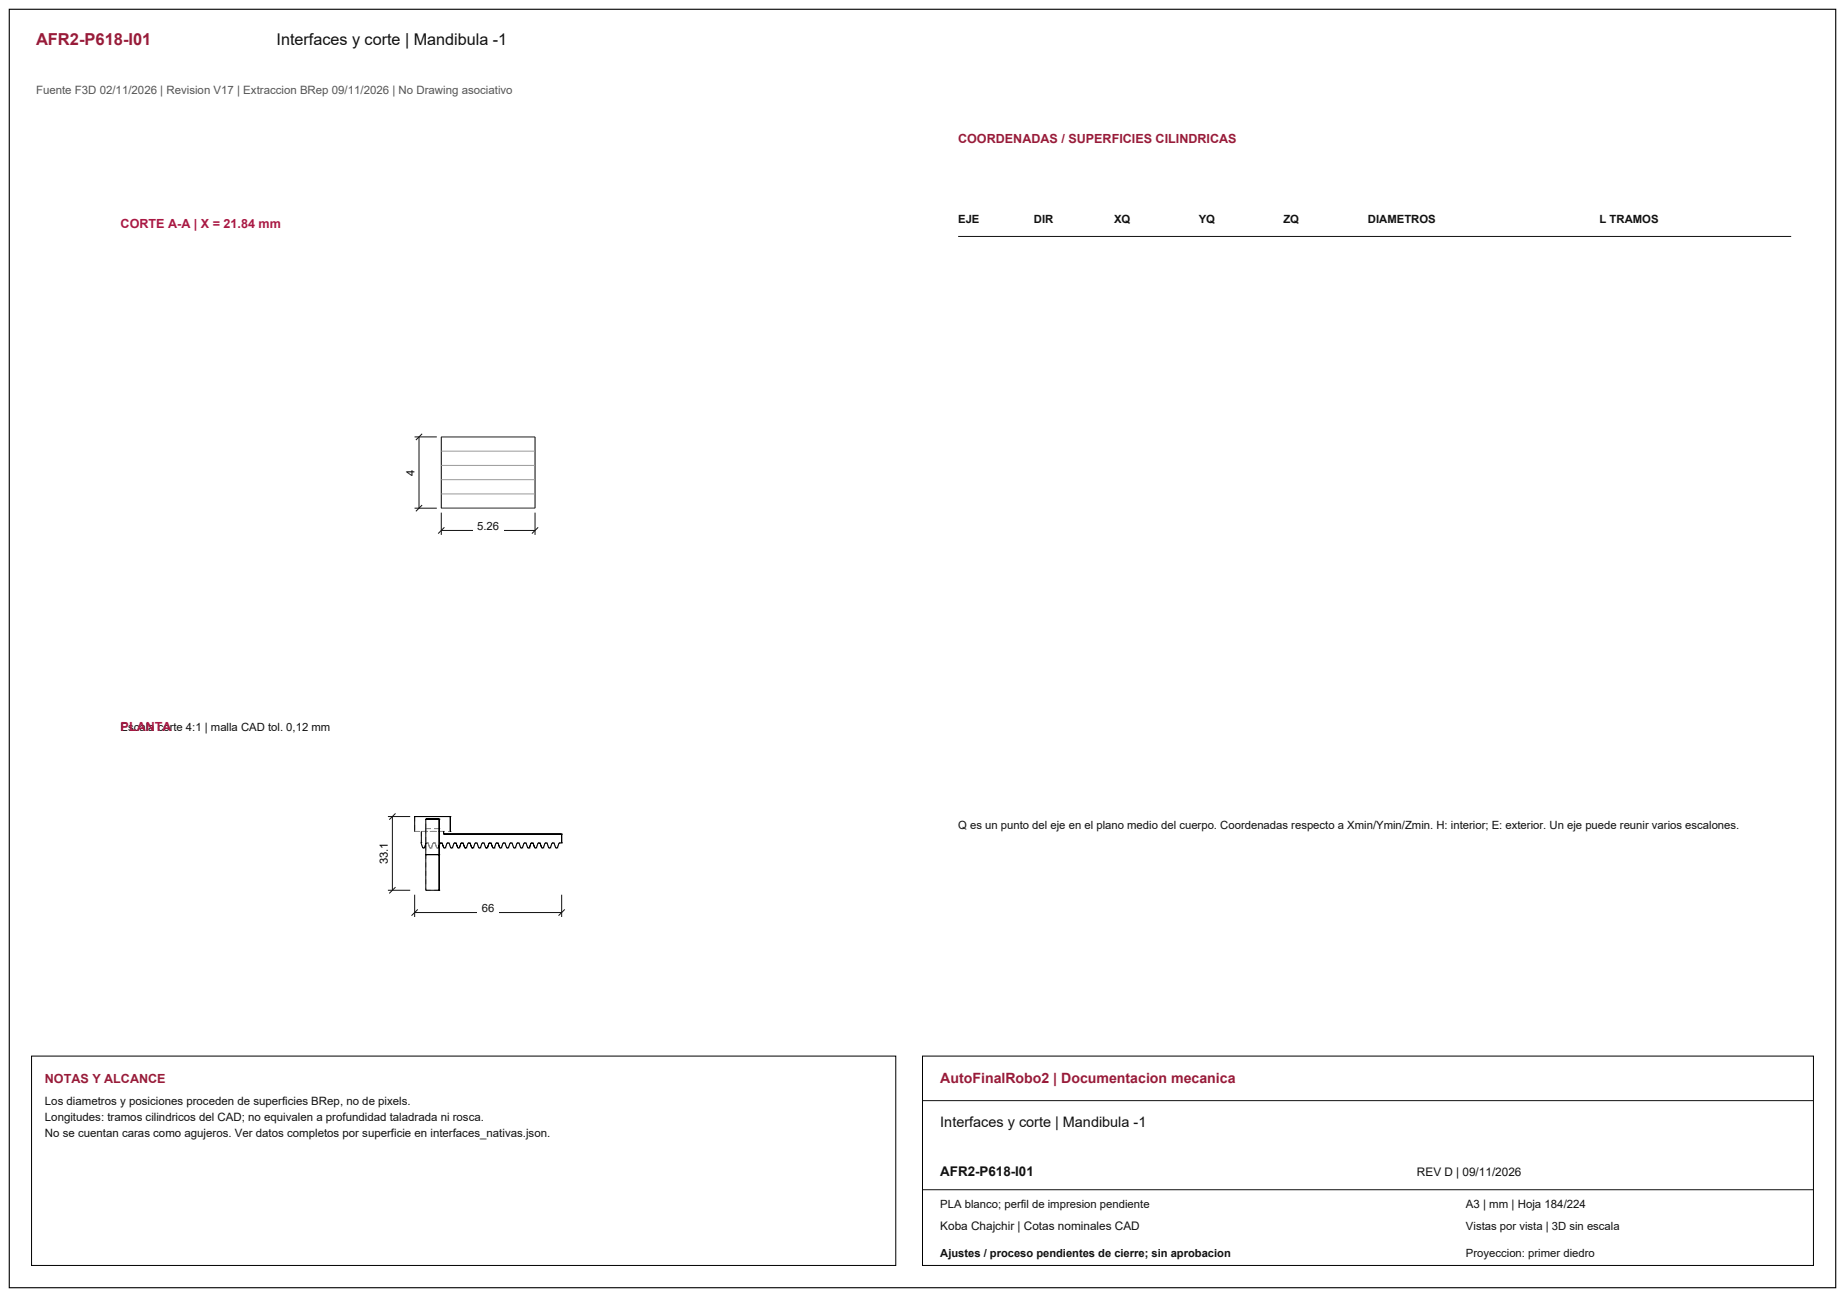
[picture p379: page 23]
CORTE A-A | X = 21.84 mm; EJE; DIR; DIAMETROS; L TRAMOS; NOTAS Y ALCANCE; AutoFinalRobo2 | Documentacion mecanica; AFR2-P618-I01; REV D | 09/11/2026

COORDENADAS / SUPERFICIES CILINDRICAS

Escala corte 4:1 | malla CAD tol. 0,12 mm PLANTA

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

Interfaces y corte | Mandibula -1

AFR2-P619 | Mandibula 1

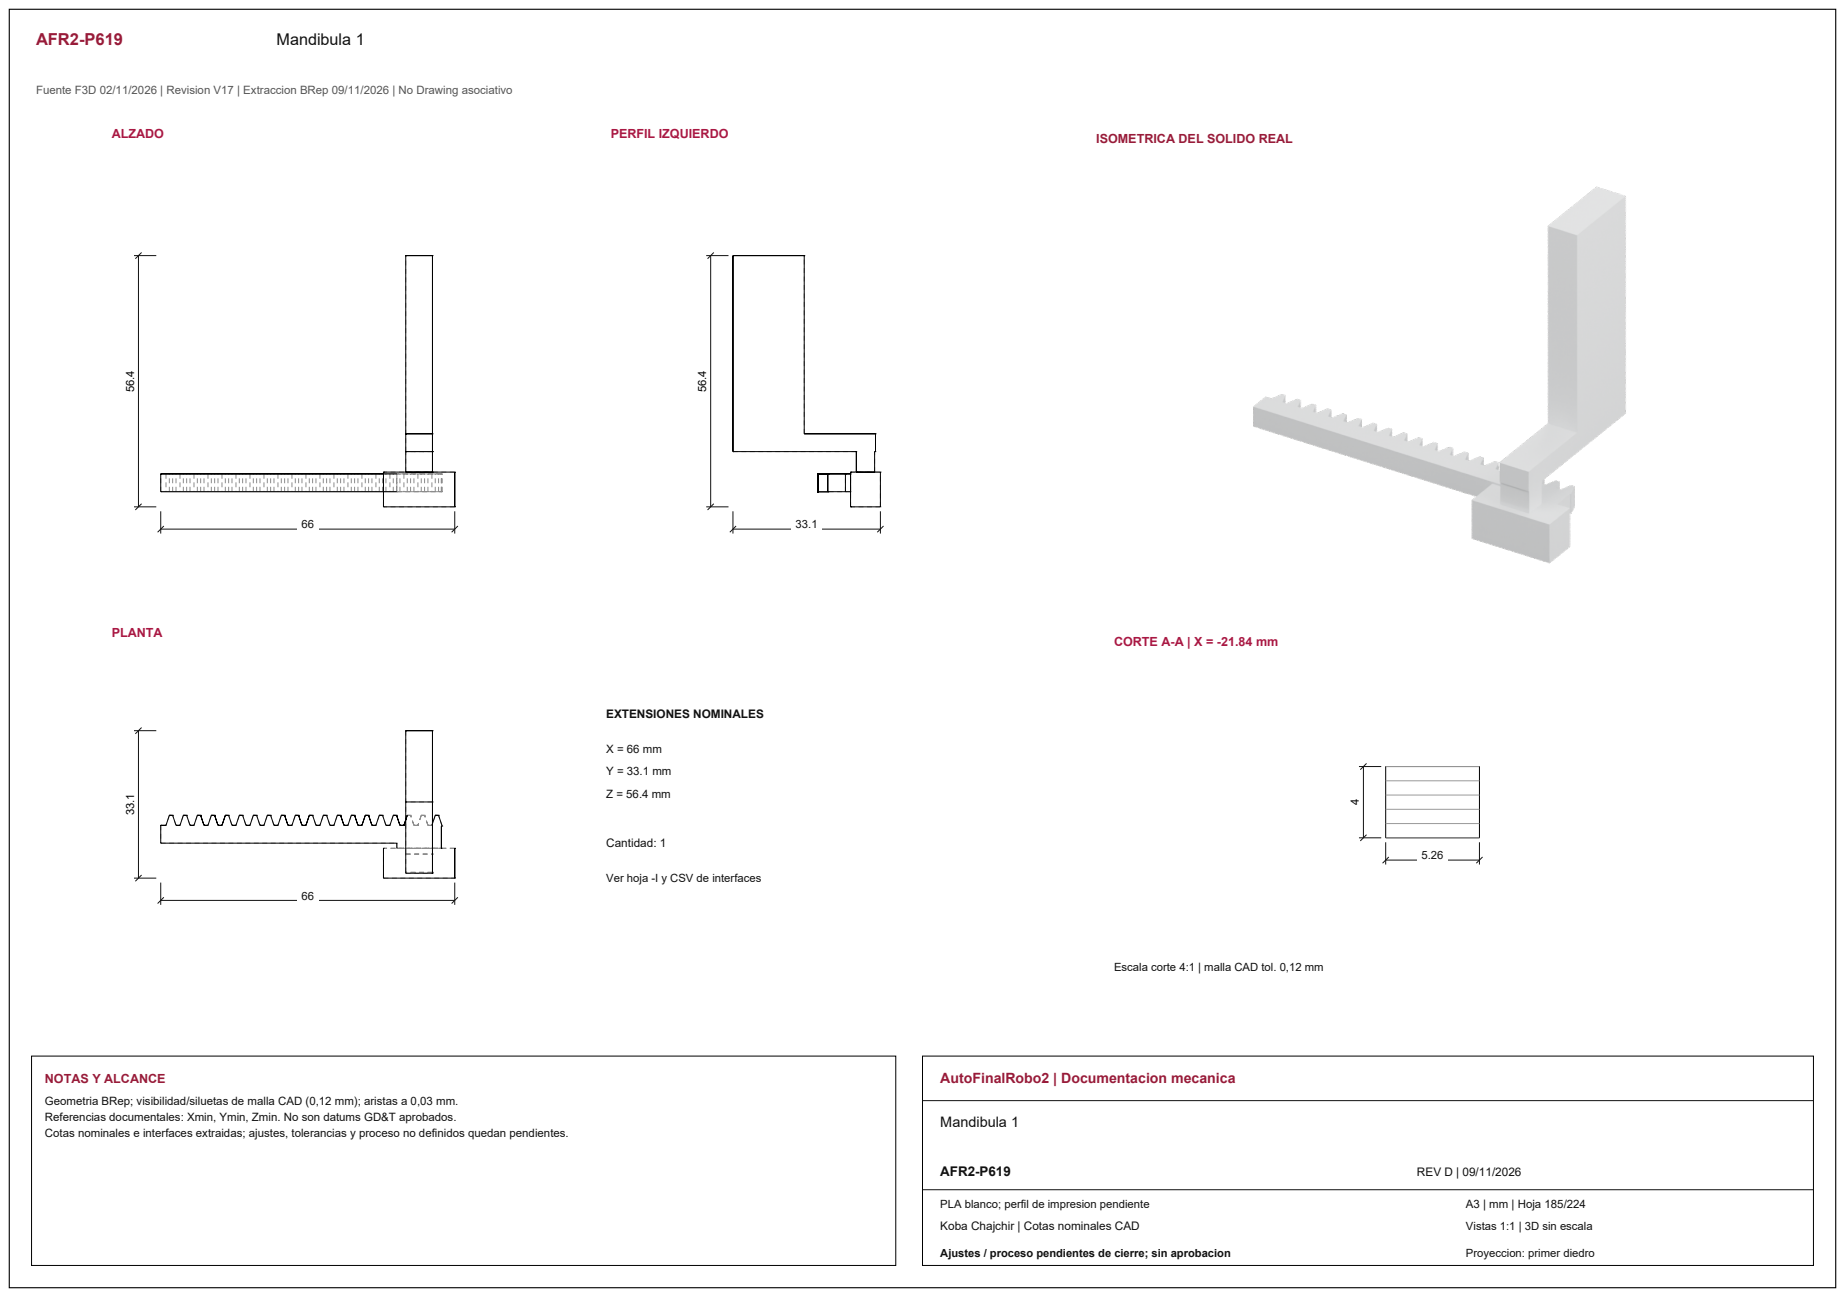
[picture p380: page 24]
ALZADO; PERFIL IZQUIERDO; PLANTA; CORTE A-A | X = -21.84 mm; EXTENSIONES NOMINALES; Cantidad: 1; NOTAS Y ALCANCE; AutoFinalRobo2 | Documentacion mecanica; Mandibula 1; AFR2-P619; REV D | 09/11/2026

ISOMETRICA DEL SOLIDO REAL

Ver hoja -I y CSV de interfaces

Escala corte 4:1 | malla CAD tol. 0,12 mm

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

Vistas 1:1 | 3D sin escala

AFR2-P619-I01 | Interfaces y corte | Mandibula 1

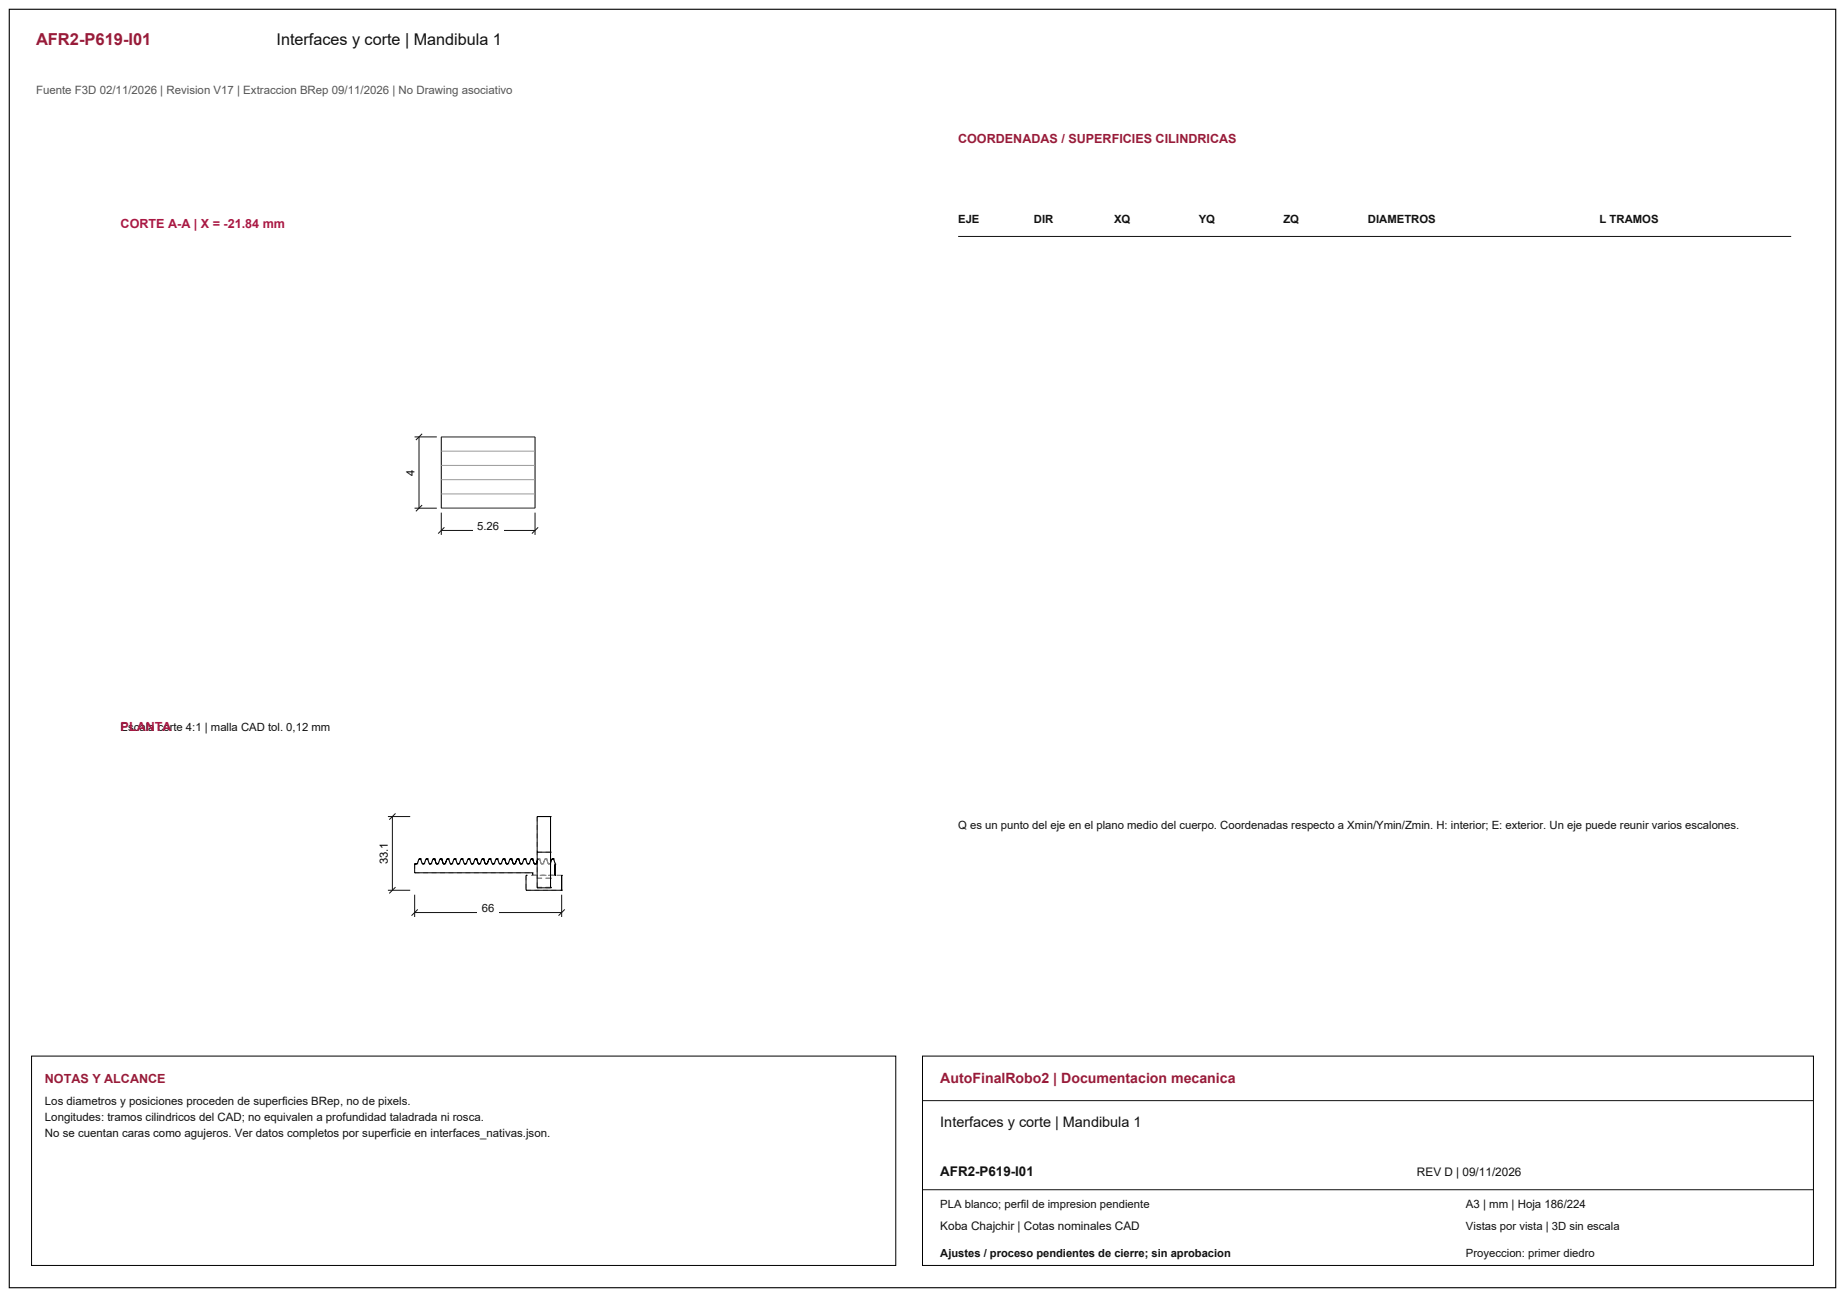
[picture p381: page 25]
CORTE A-A | X = -21.84 mm; EJE; DIR; DIAMETROS; L TRAMOS; NOTAS Y ALCANCE; AutoFinalRobo2 | Documentacion mecanica; AFR2-P619-I01; REV D | 09/11/2026

COORDENADAS / SUPERFICIES CILINDRICAS

Escala corte 4:1 | malla CAD tol. 0,12 mm PLANTA

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

Interfaces y corte | Mandibula 1

AFR2-P620 | Pinon24 Pinza

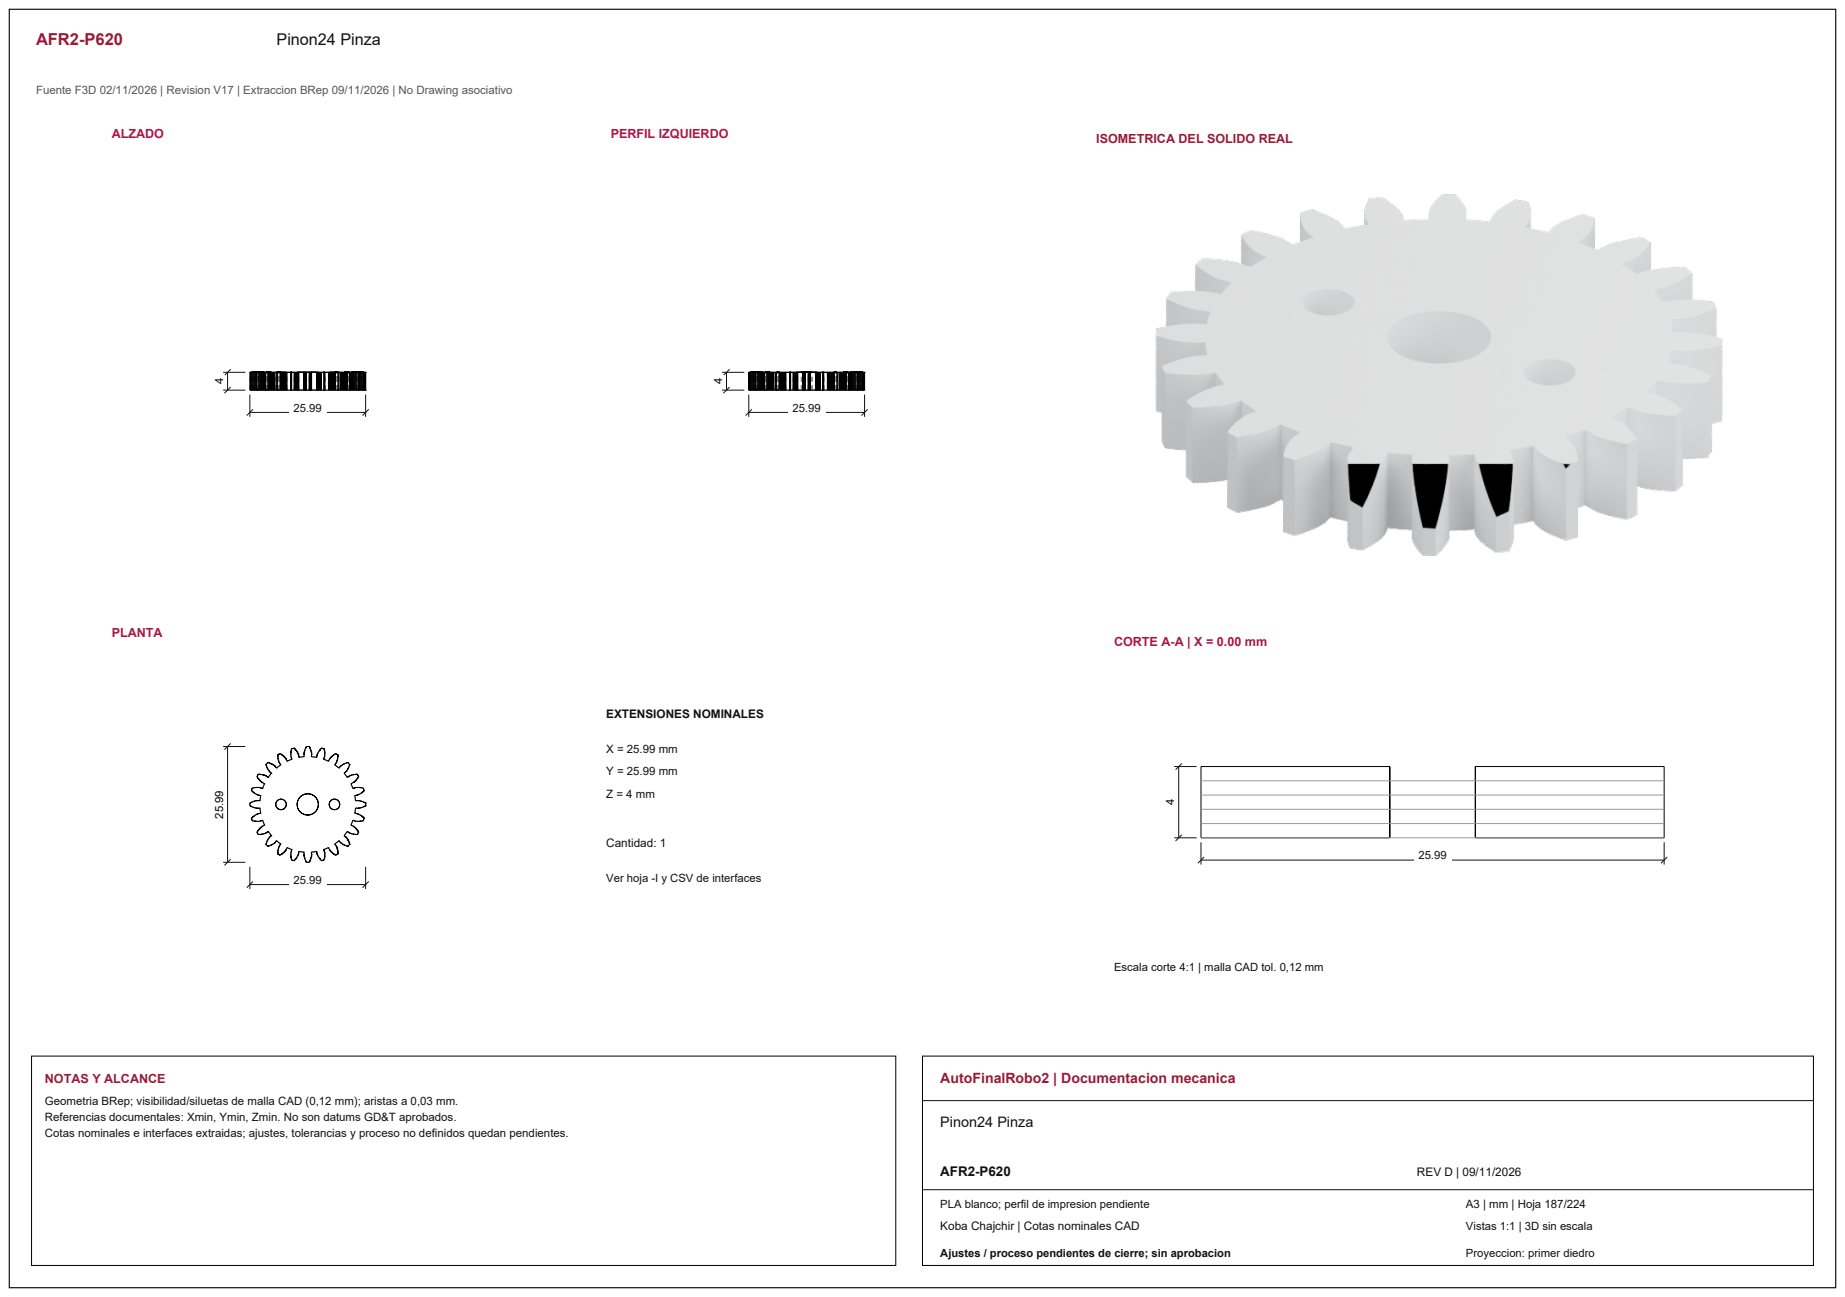
[picture p382: page 26]
ALZADO; PERFIL IZQUIERDO; PLANTA; CORTE A-A | X = 0.00 mm; EXTENSIONES NOMINALES; Cantidad: 1; NOTAS Y ALCANCE; AutoFinalRobo2 | Documentacion mecanica; Pinon24 Pinza; AFR2-P620; REV D | 09/11/2026

ISOMETRICA DEL SOLIDO REAL

Ver hoja -I y CSV de interfaces

Escala corte 4:1 | malla CAD tol. 0,12 mm

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

Vistas 1:1 | 3D sin escala

AFR2-P620-I01 | Interfaces y corte | Pinon24 Pinza

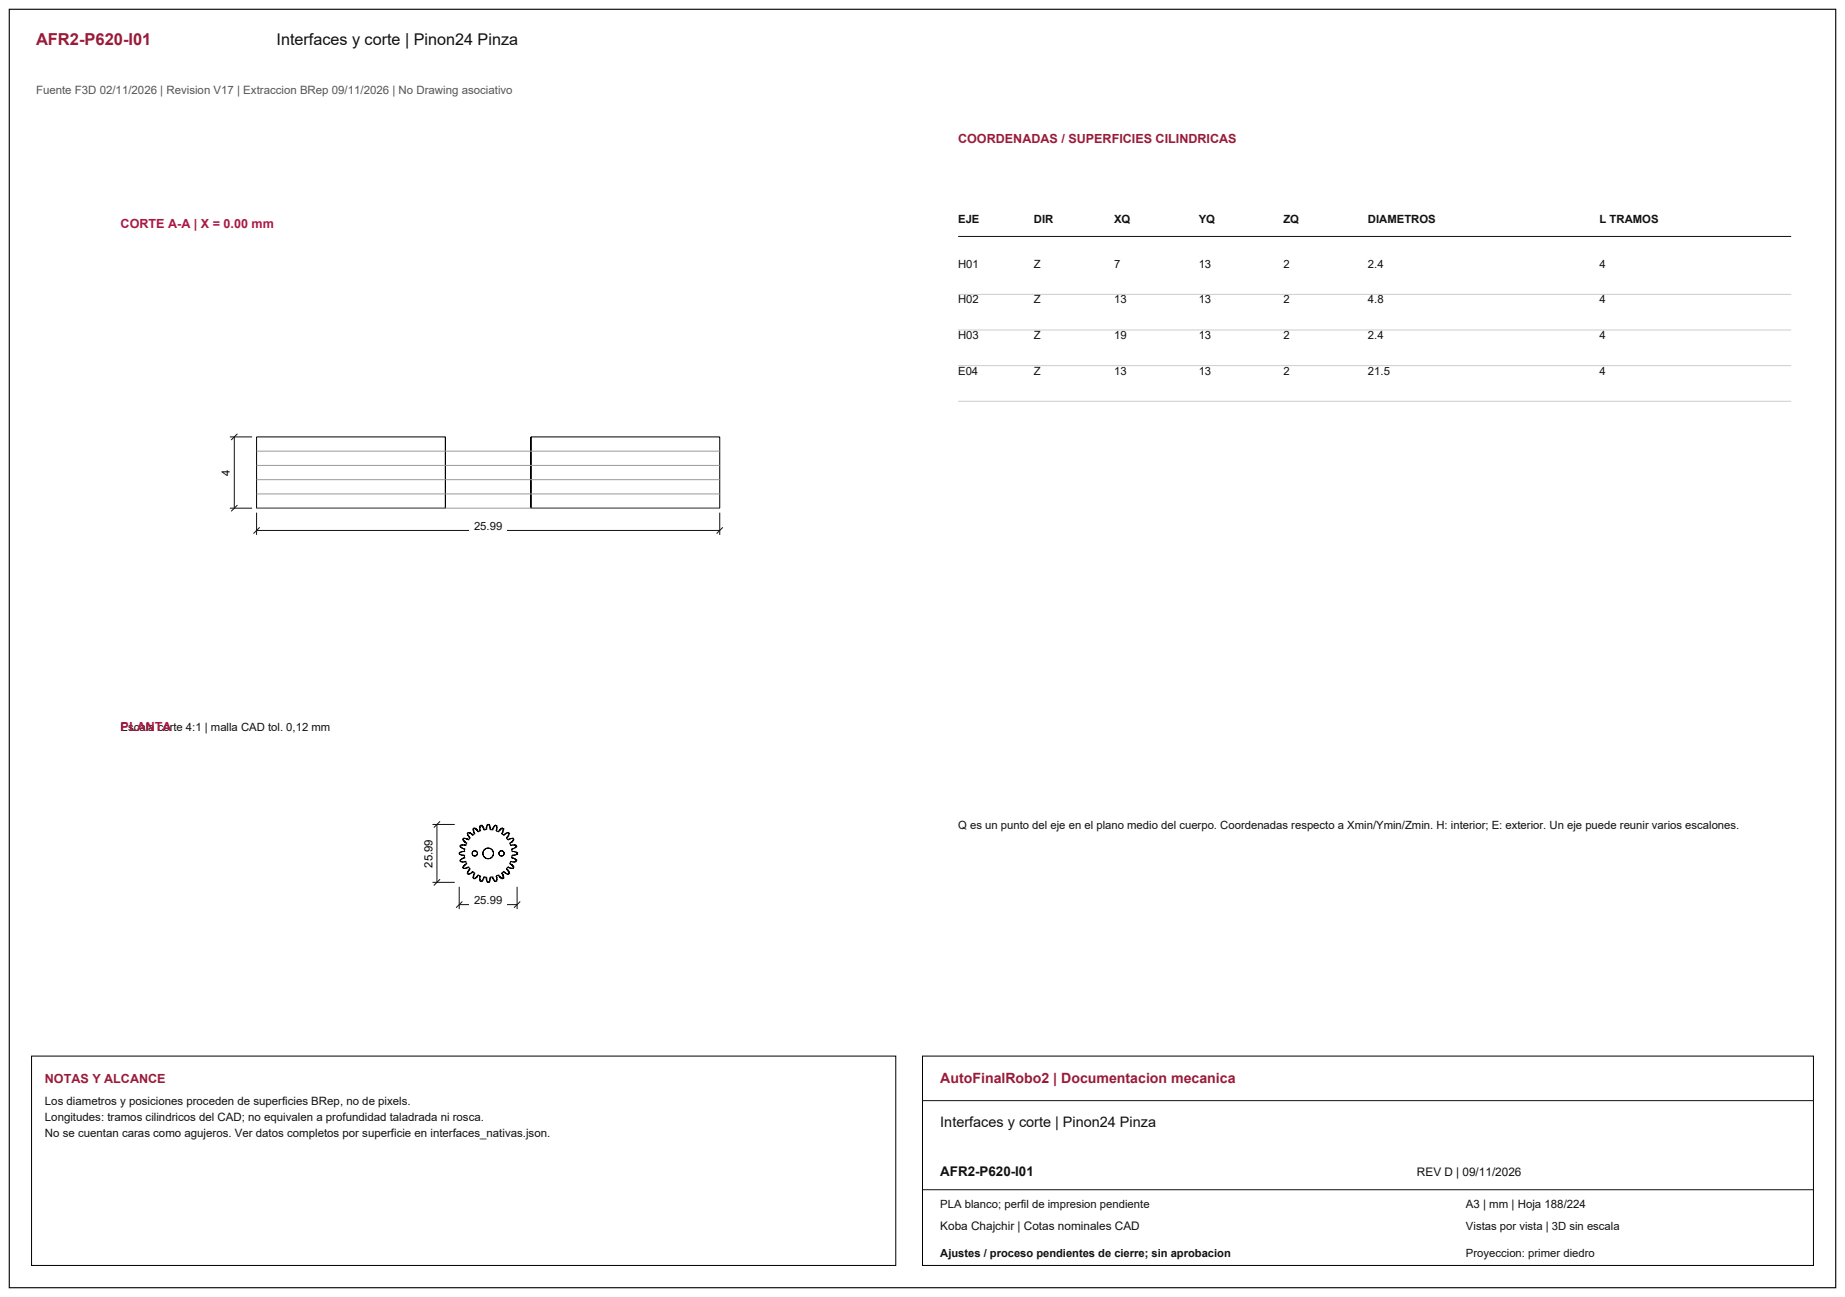
[picture p383: page 27]
CORTE A-A | X = 0.00 mm; EJE; DIR; DIAMETROS; L TRAMOS; NOTAS Y ALCANCE; AutoFinalRobo2 | Documentacion mecanica; AFR2-P620-I01; REV D | 09/11/2026

COORDENADAS / SUPERFICIES CILINDRICAS

Escala corte 4:1 | malla CAD tol. 0,12 mm PLANTA

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

Interfaces y corte | Pinon24 Pinza

AFR2-P621 | Horn STS3032 J7

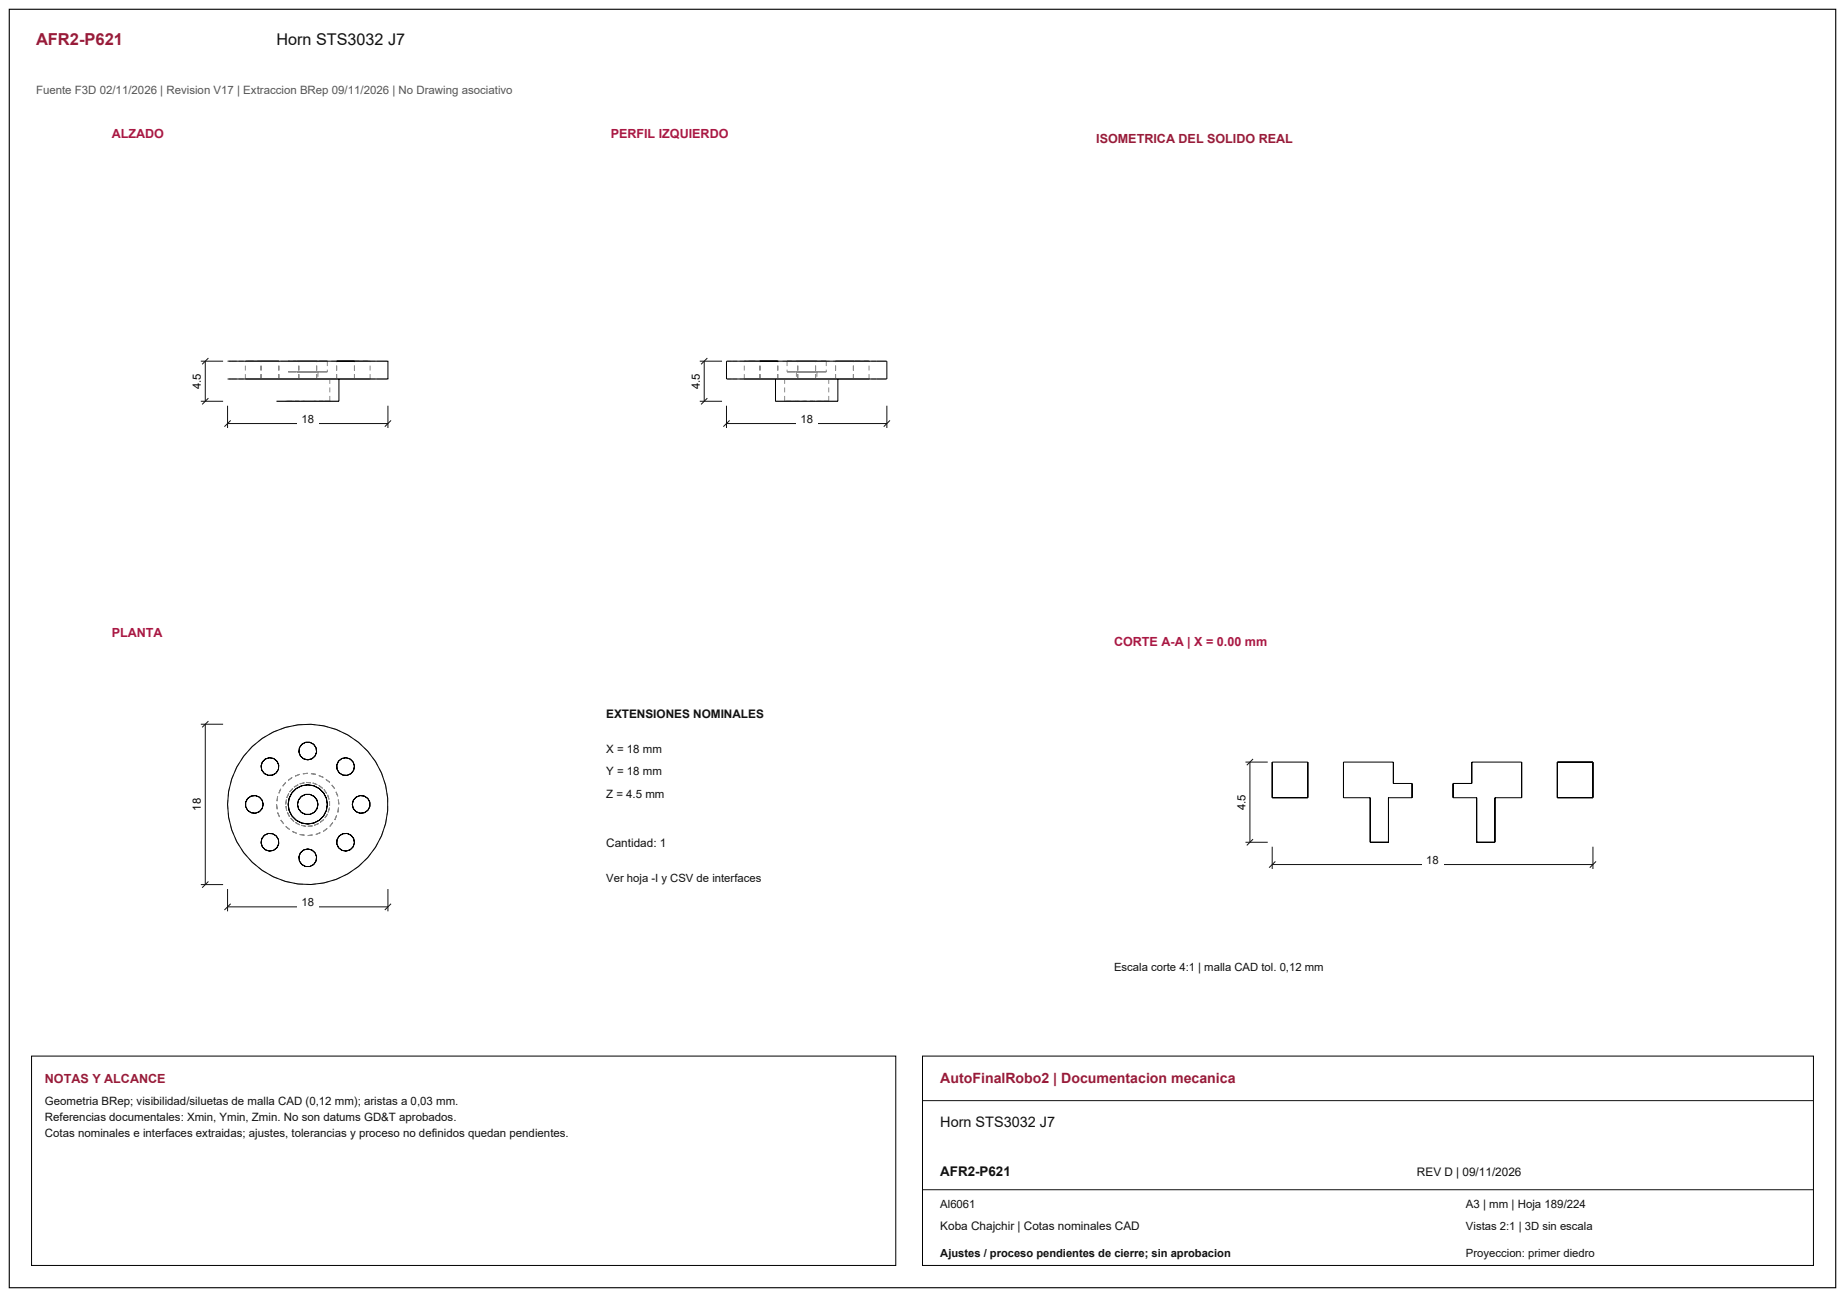
[picture p384: page 28]
ALZADO; PERFIL IZQUIERDO; PLANTA; CORTE A-A | X = 0.00 mm; EXTENSIONES NOMINALES; Cantidad: 1; NOTAS Y ALCANCE; AutoFinalRobo2 | Documentacion mecanica; Horn STS3032 J7; AFR2-P621; REV D | 09/11/2026

ISOMETRICA DEL SOLIDO REAL

Ver hoja -I y CSV de interfaces

Escala corte 4:1 | malla CAD tol. 0,12 mm

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

Vistas 2:1 | 3D sin escala

AFR2-P621-I01 | Interfaces y corte | Horn STS3032 J7

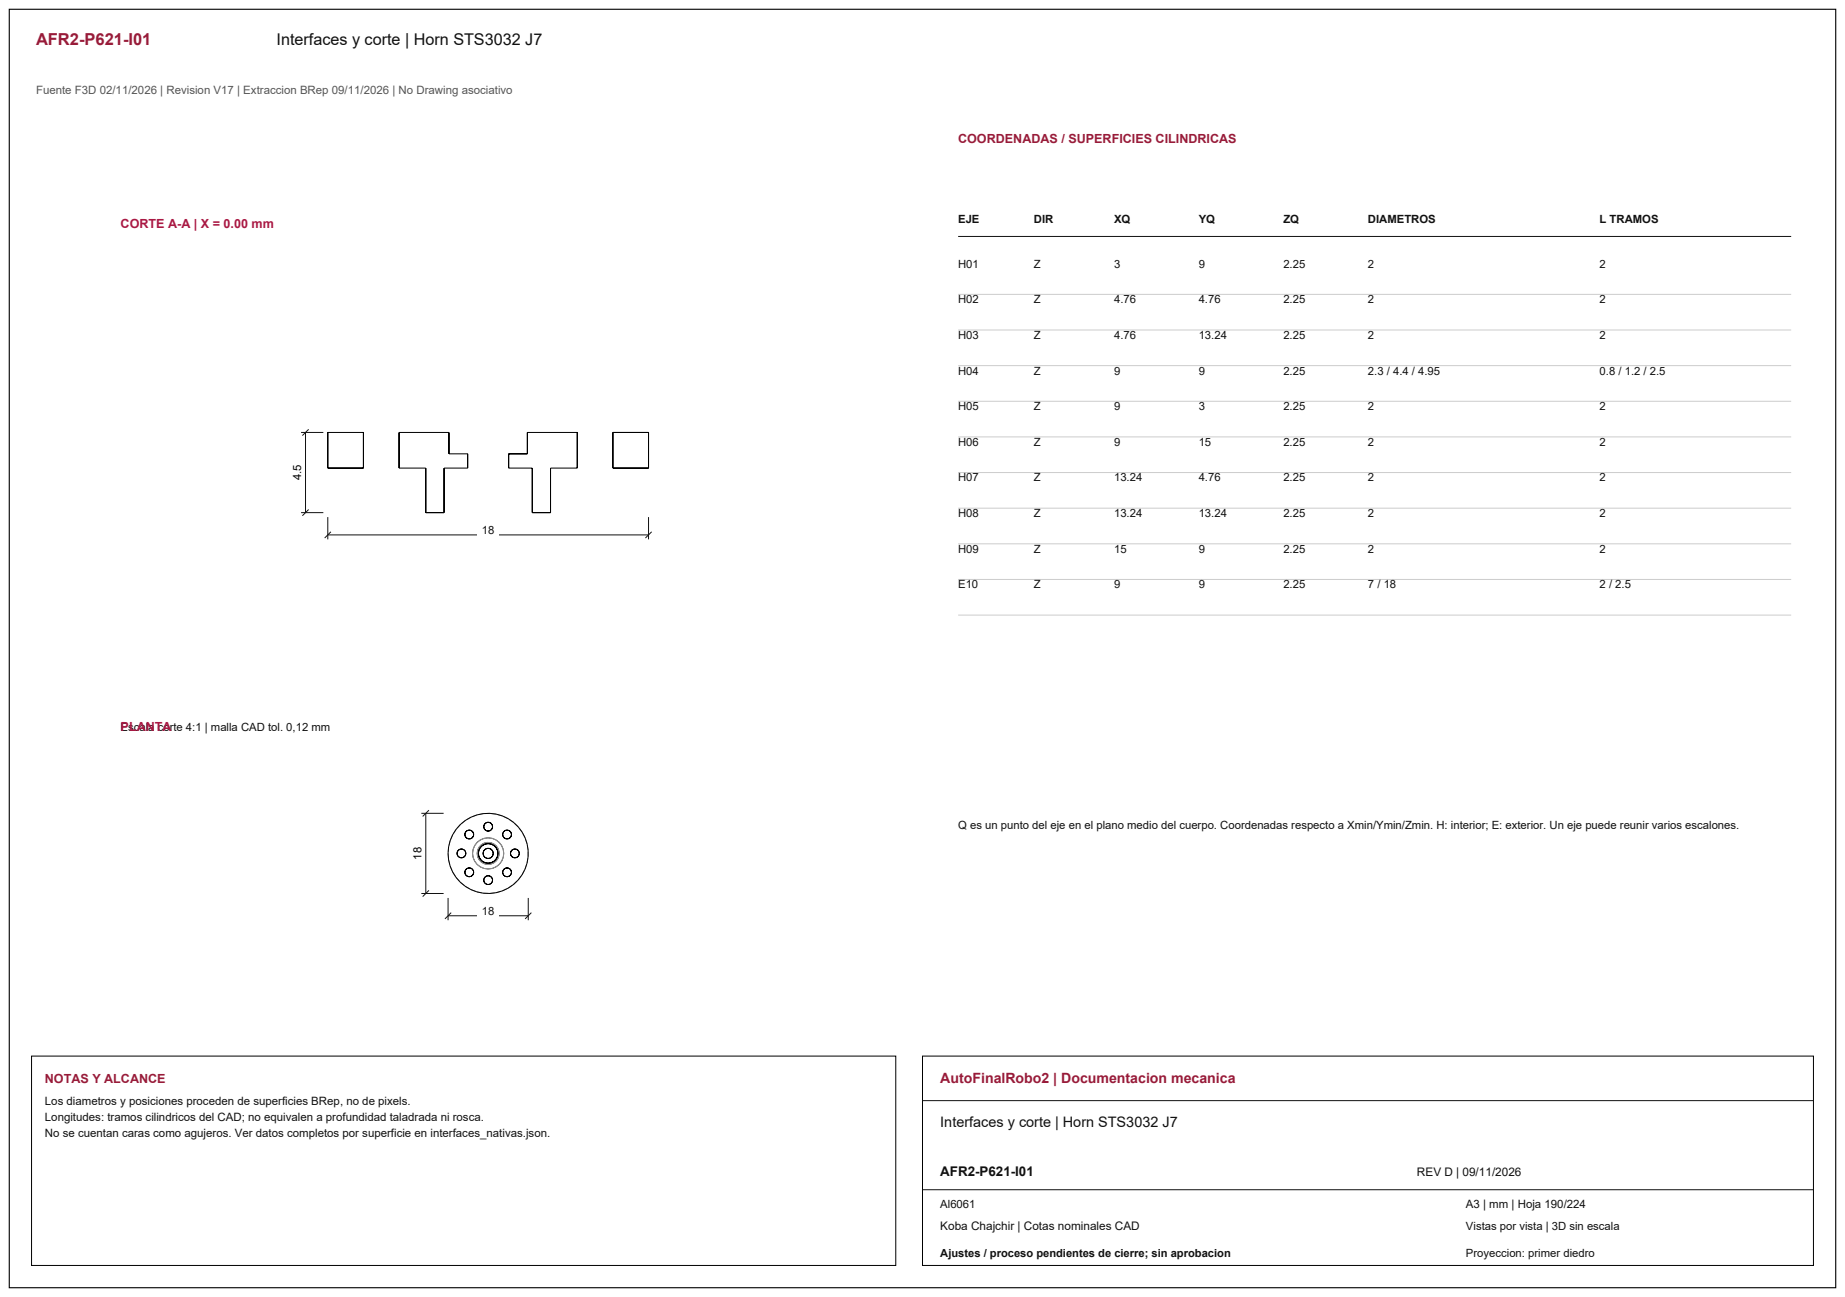
[picture p385: page 29]
CORTE A-A | X = 0.00 mm; EJE; DIR; DIAMETROS; L TRAMOS; NOTAS Y ALCANCE; AutoFinalRobo2 | Documentacion mecanica; AFR2-P621-I01; REV D | 09/11/2026

COORDENADAS / SUPERFICIES CILINDRICAS

Escala corte 4:1 | malla CAD tol. 0,12 mm PLANTA

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

Interfaces y corte | Horn STS3032 J7
