kobachajchir/ProyectoRobotica2/AutoFinalRobo2-CAD/mecanica/brazo-antropomorfo/revision_v17/laminas_20261102/AFR2_Laminas_Iniciales_A3.pdf

## AFR2-A000 / BRAZO COMPLETO Y SUS SUBCONJUNTOS

Brazo v17 / captura nativa 02-11-2026 | Cotas de geometria; no de imagen.

SUBCONJUNTOS DEL BRAZO


AFR2-A100

Montura y control fijo

AFR2-A200

Giro J1, torre y entrada J2

AFR2-A300

Eslabon y accionamiento remoto J3

AFR2-A400

Antebrazo y giro de muneca J4

AFR2-A500

Inclinacion J5 y soporte J6

AFR2-A600

Herramienta y pinza V7

VISTA 3D / BRAZO COMPLETO

NOTAS / ALCANCE

Ficha visual del brazo con sus seis subconjuntos funcionales.
Los grupos incluyen todas las425 instancias de solidos de la captura; no son piezas comerciales contadas. Esta ficha no sustituye los planos individuales; solo seis piezas tienen hoja preliminar en esta tanda.
AutoFinalRobo2 - Robotica II | Koba Chajchir

## Brazo completo y sus subconjuntos

AFR2-A000 | REV C | 02/11/2026

MATERIAL / PROCESO

Conjunto mixto

ESTADO: DOCUMENTACION PRELIMINAR

Unidades: mm | Proyeccion: primer diedro

Escala vistas: --

Isometrica: sin escala

Formato A3 | Hoja 1 / 14
AutoFinalRobo2 | Sin firma de aprobacion

## AFR2-R000 / ROBOT INTEGRADO Y CONJUNTOS DEL AUTO

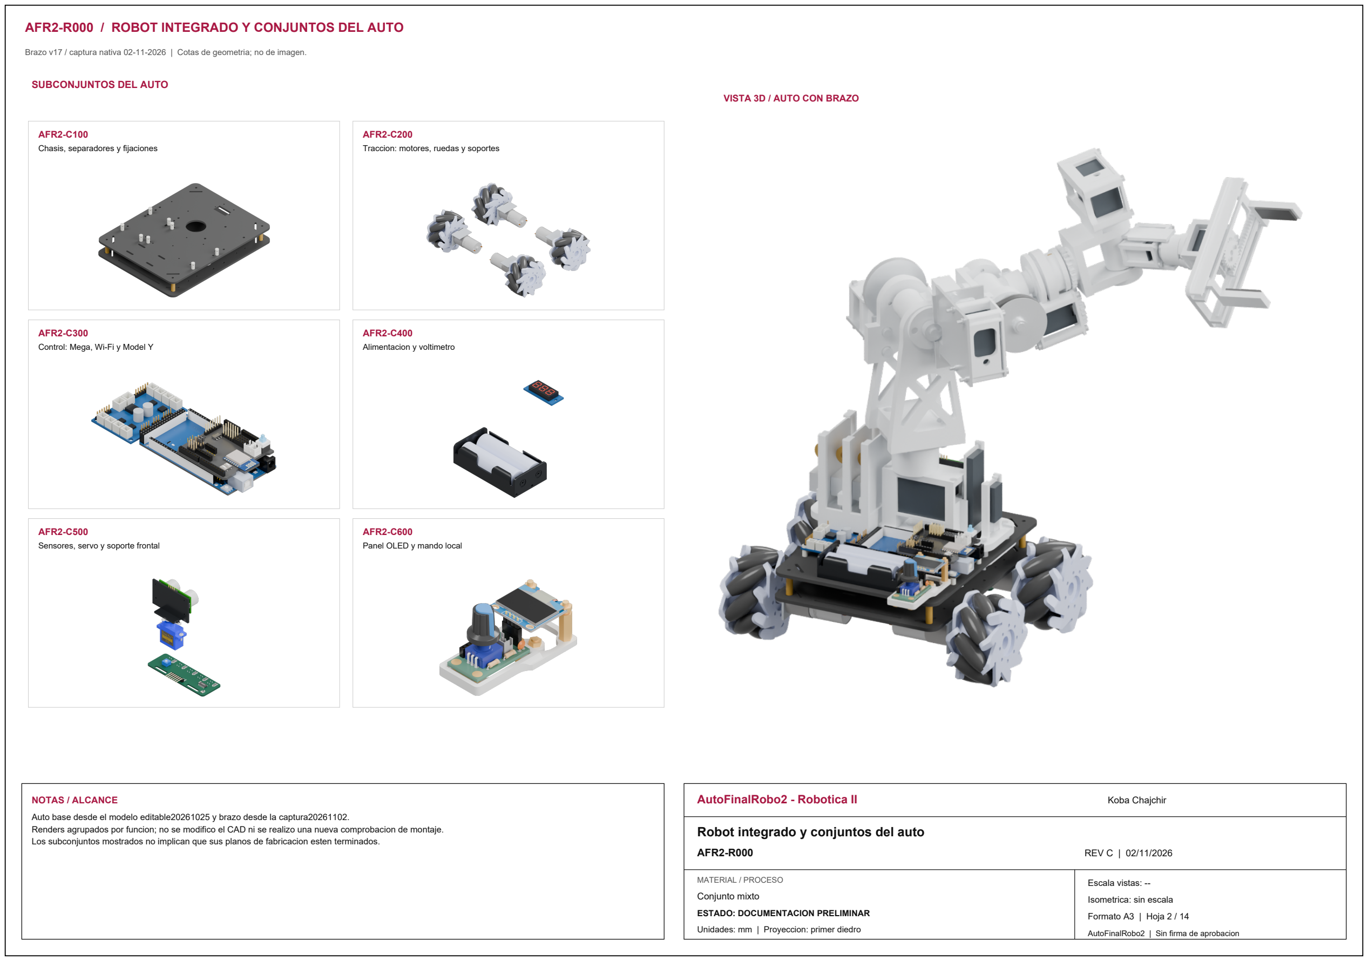
[picture p386: page 2]

SUBCONJUNTOS DEL AUTO

AFR2-C100

Chasis, separadores y fijaciones

AFR2-C200

Traccion: motores, ruedas y soportes

AFR2-C300

Control: Mega, Wi-Fi y Model Y

AFR2-C400

Alimentacion y voltimetro

AFR2-C500

Sensores, servo y soporte frontal

AFR2-C600

Panel OLED y mando local

VISTA 3D / AUTO CON BRAZO

NOTAS / ALCANCE

Auto base desde el modelo editable20261025 y brazo desde la captura20261102.
Renders agrupados por funcion; no se modifico el CAD ni se realizo una nueva comprobacion de montaje. Los subconjuntos mostrados no implican que sus planos de fabricacion esten terminados.
AutoFinalRobo2 - Robotica II | Koba Chajchir

## Robot integrado y conjuntos del auto

AFR2-R000 | REV C | 02/11/2026

MATERIAL / PROCESO
Escala vistas: --

## AFR2-A500 / INCLINACION J5 Y SOPORTE J6 - ARMADO

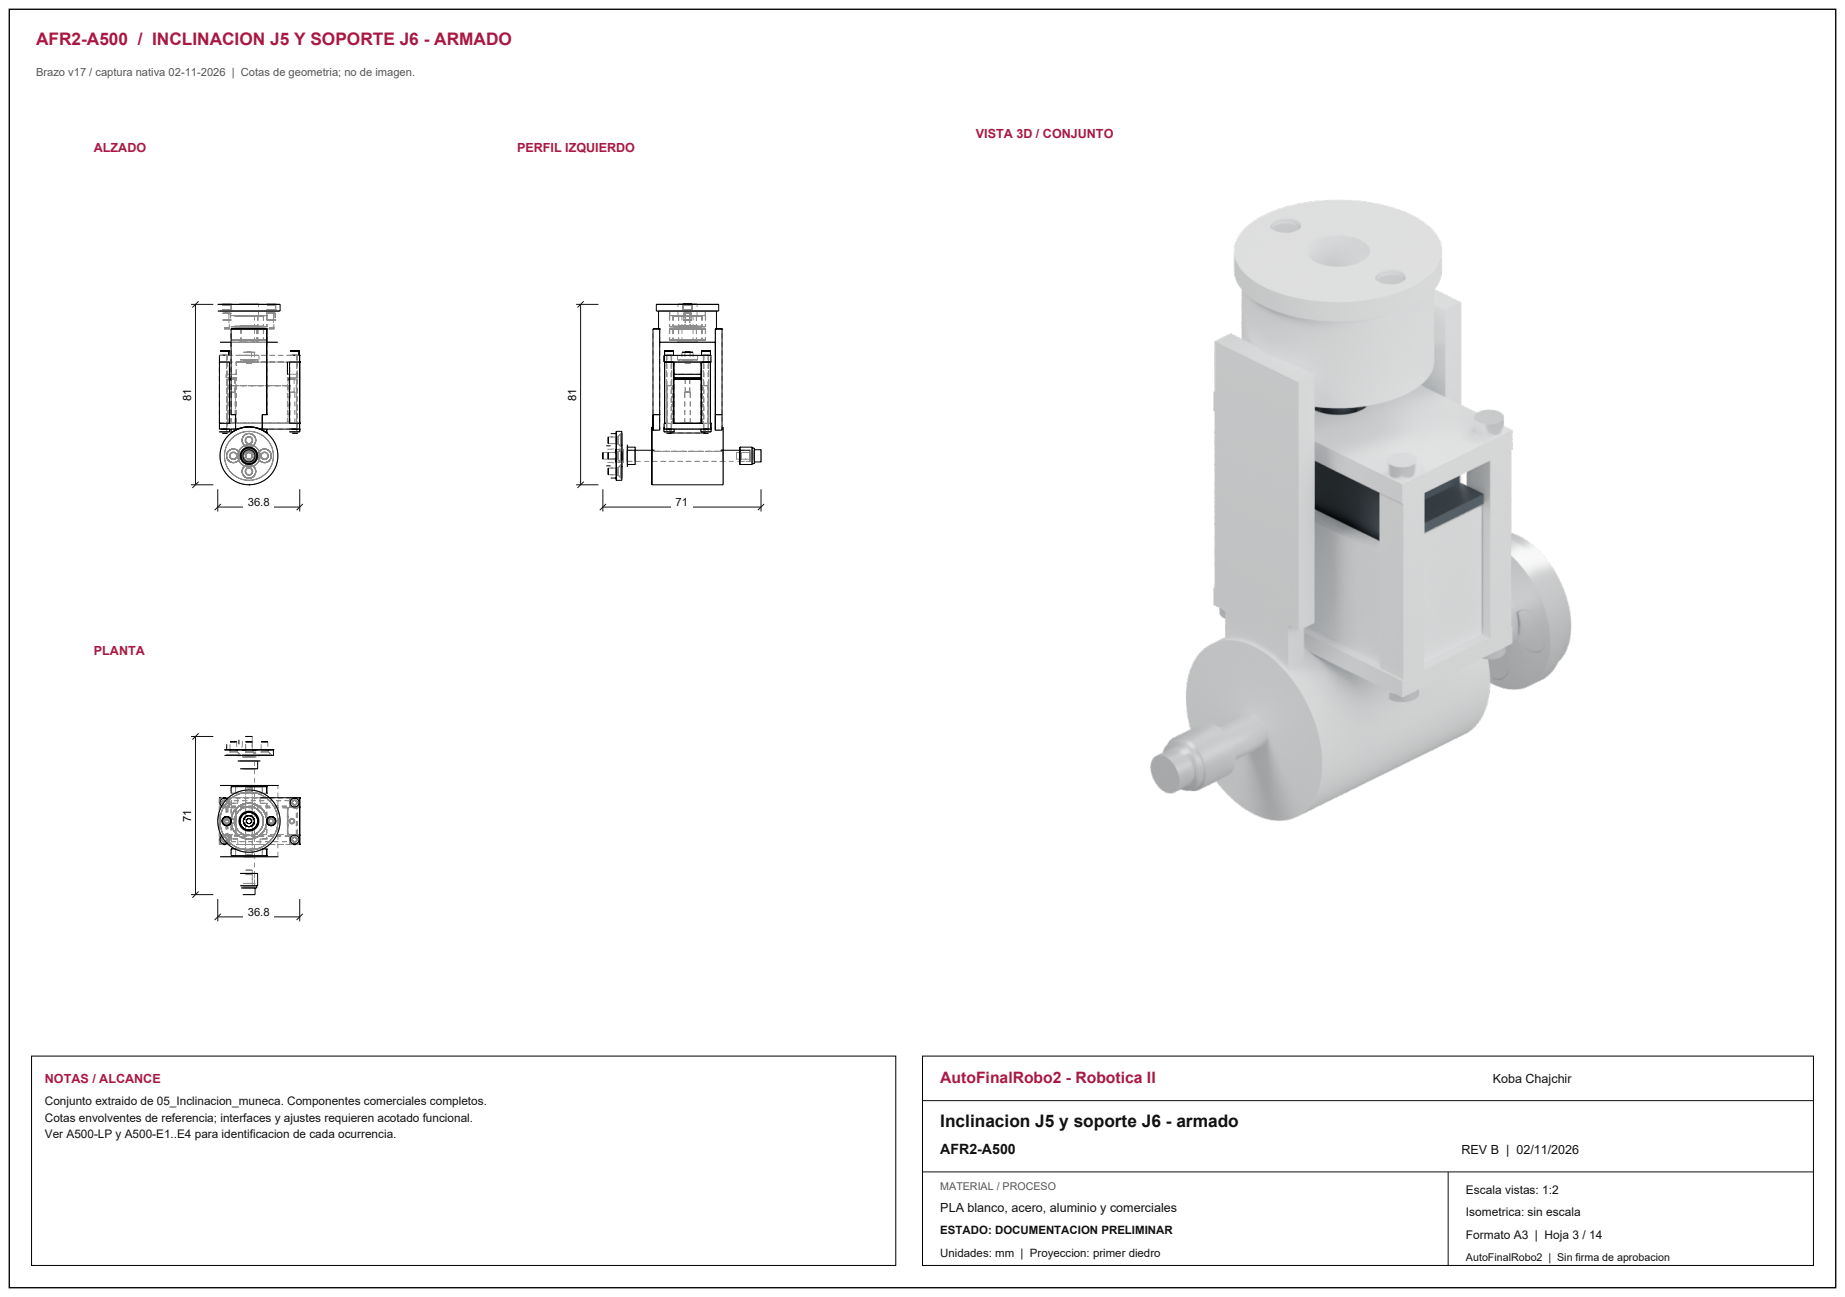
[picture p387: page 3]
ALZADO; PERFIL IZQUIERDO; PLANTA; VISTA 3D / CONJUNTO; NOTAS / ALCANCE; AutoFinalRobo2 - Robotica II; Koba Chajchir; AFR2-A500; REV B | 02/11/2026; Escala vistas: 1:2

Conjunto extraido de 05_Inclinacion_muneca. Componentes comerciales completos.
Cotas envolventes de referencia; interfaces y ajustes requieren acotado funcional.
Ver A500-LP y A500-E1..E4 para identificacion de cada ocurrencia.

Inclinacion J5 y soporte J6 - armado

MATERIAL / PROCESO
PLA blanco, acero, aluminio y comerciales

## AFR2-A500-LP / J5 / J6 - LISTA DE PIEZAS

### LISTA DE PIEZAS

POS. / CODIGO | DESCRIPCION | CANT.

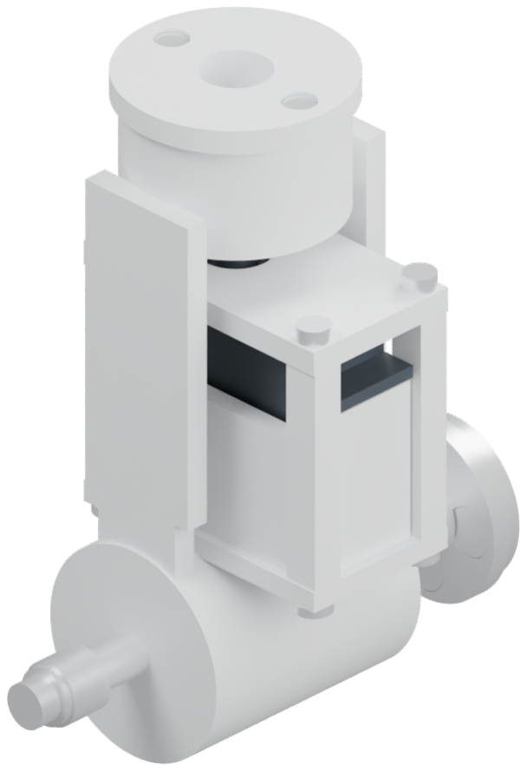
[picture p388: figure]

01 | Tornillo avellanado M3 x 6 | 1
02 | Horn de salida STS3250 | 1
03 | Arandela trasera J5 | 1
04 | Separador trasero de J5 | 1
05 | Tornillo axial trasero J5 | 1
06 | Eje y brida de J5 | 1
07 | Separador axial de J5 | 1
08 | Tornillo original horn V02 M05 MG946 J5 | 1
09 | Tornillo avellanado M3 x 6 | 1
10 | Tornillo avellanado M3 x 6 | 1
11 | Tornillo avellanado M3 x 6 | 1
12 | Tuerca M2 - envolvente CAD | 1
13 | Tuerca M2 - envolvente CAD | 1
14 | Tuerca M2 - envolvente CAD | 1
15 | Tuerca M2 - envolvente CAD | 1
16 | Núcleo J5 y soporte J6 | 1
17 | Tornillo M2 x 35 - envolvente CAD | 1
18 | Tornillo M2 x 35 - envolvente CAD | 1
19 | Tornillo M2 x 35 - envolvente CAD | 1
20 | Tornillo M2 x 35 - envolvente CAD | 1
21 | Servo FEETECH STS3032 A0 (nombre CAD heredado) | 1
22 | Tapa del servo STS3032 J6 | 1
23 | Rodamiento 625 (5 x 16 x 5 mm) | 1
24 | Rodamiento 625 (5 x 16 x 5 mm) | 1
25 | Inserto M2 - referencia | 1
26 | Inserto M2 - referencia | 1
27 | Tornillo de tapa J6 | 1
28 | Tornillo de tapa J6 | 1
29 | Tapa de retención 625 de J6 | 1

VISTA 3D / CONJUNTO

NOTAS / ALCANCE

Cada posicion es una ocurrencia de componente; los solidos internos de un rodamiento no son piezas adicionales. Nombres originales y rutas completas en BOM_A500.csv.
P501-P506 son piezas fabricadas documentadas por separado.
AutoFinalRobo2 - Robotica II | Koba Chajchir

## J5 / J6 - lista de piezas

AFR2-A500-LP | REV B | 02/11/2026

MATERIAL / PROCESO
Escala vistas: --

## AFR2-A500-E1 / J5 / J6 - EXPLOSION ISOMETRICA, TRAMO 1 DE 4

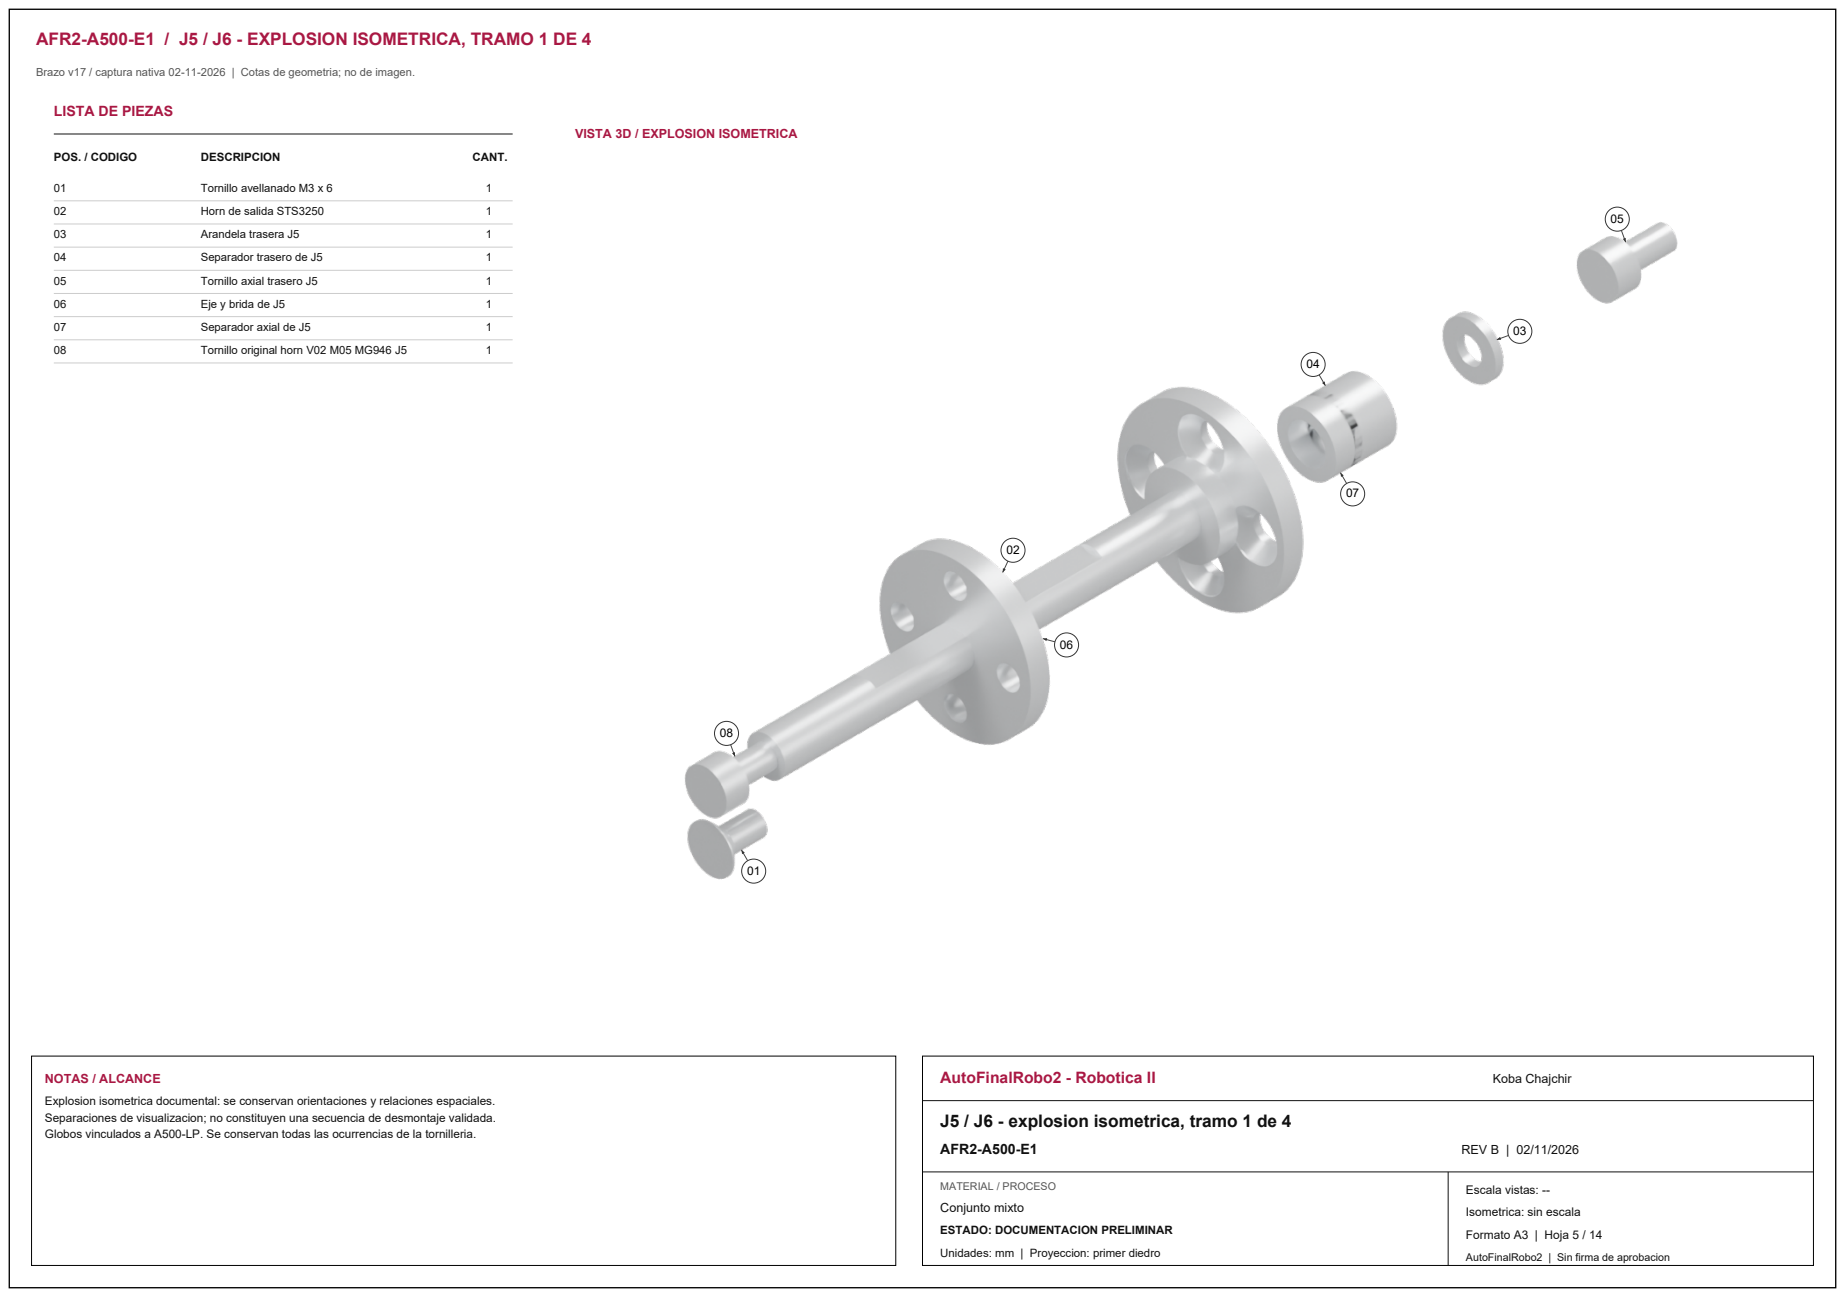
[picture p389: page 5]
POS. / CODIGO; DESCRIPCION; CANT.; Tornillo avellanado M3 x 6; Horn de salida STS3250; Arandela trasera J5; Separador trasero de J5; Tornillo axial trasero J5; Eje y brida de J5; Separador axial de J5; Tornillo original horn V02 M05 MG946 J5; NOTAS / ALCANCE; AutoFinalRobo2 - Robotica II; Koba Chajchir; AFR2-A500-E1; REV B | 02/11/2026; MATERIAL / PROCESO; Escala vistas: --

LISTA DE PIEZAS

VISTA 3D / EXPLOSION ISOMETRICA

Explosion isometrica documental: se conservan orientaciones y relaciones espaciales.
Separaciones de visualizacion; no constituyen una secuencia de desmontaje validada.
Globos vinculados a A500-LP. Se conservan todas las ocurrencias de la tornilleria.

J5 / J6 - explosion isometrica, tramo 1 de 4

## AFR2-A500-E2 / J5 / J6 - EXPLOSION ISOMETRICA, TRAMO 2 DE 4

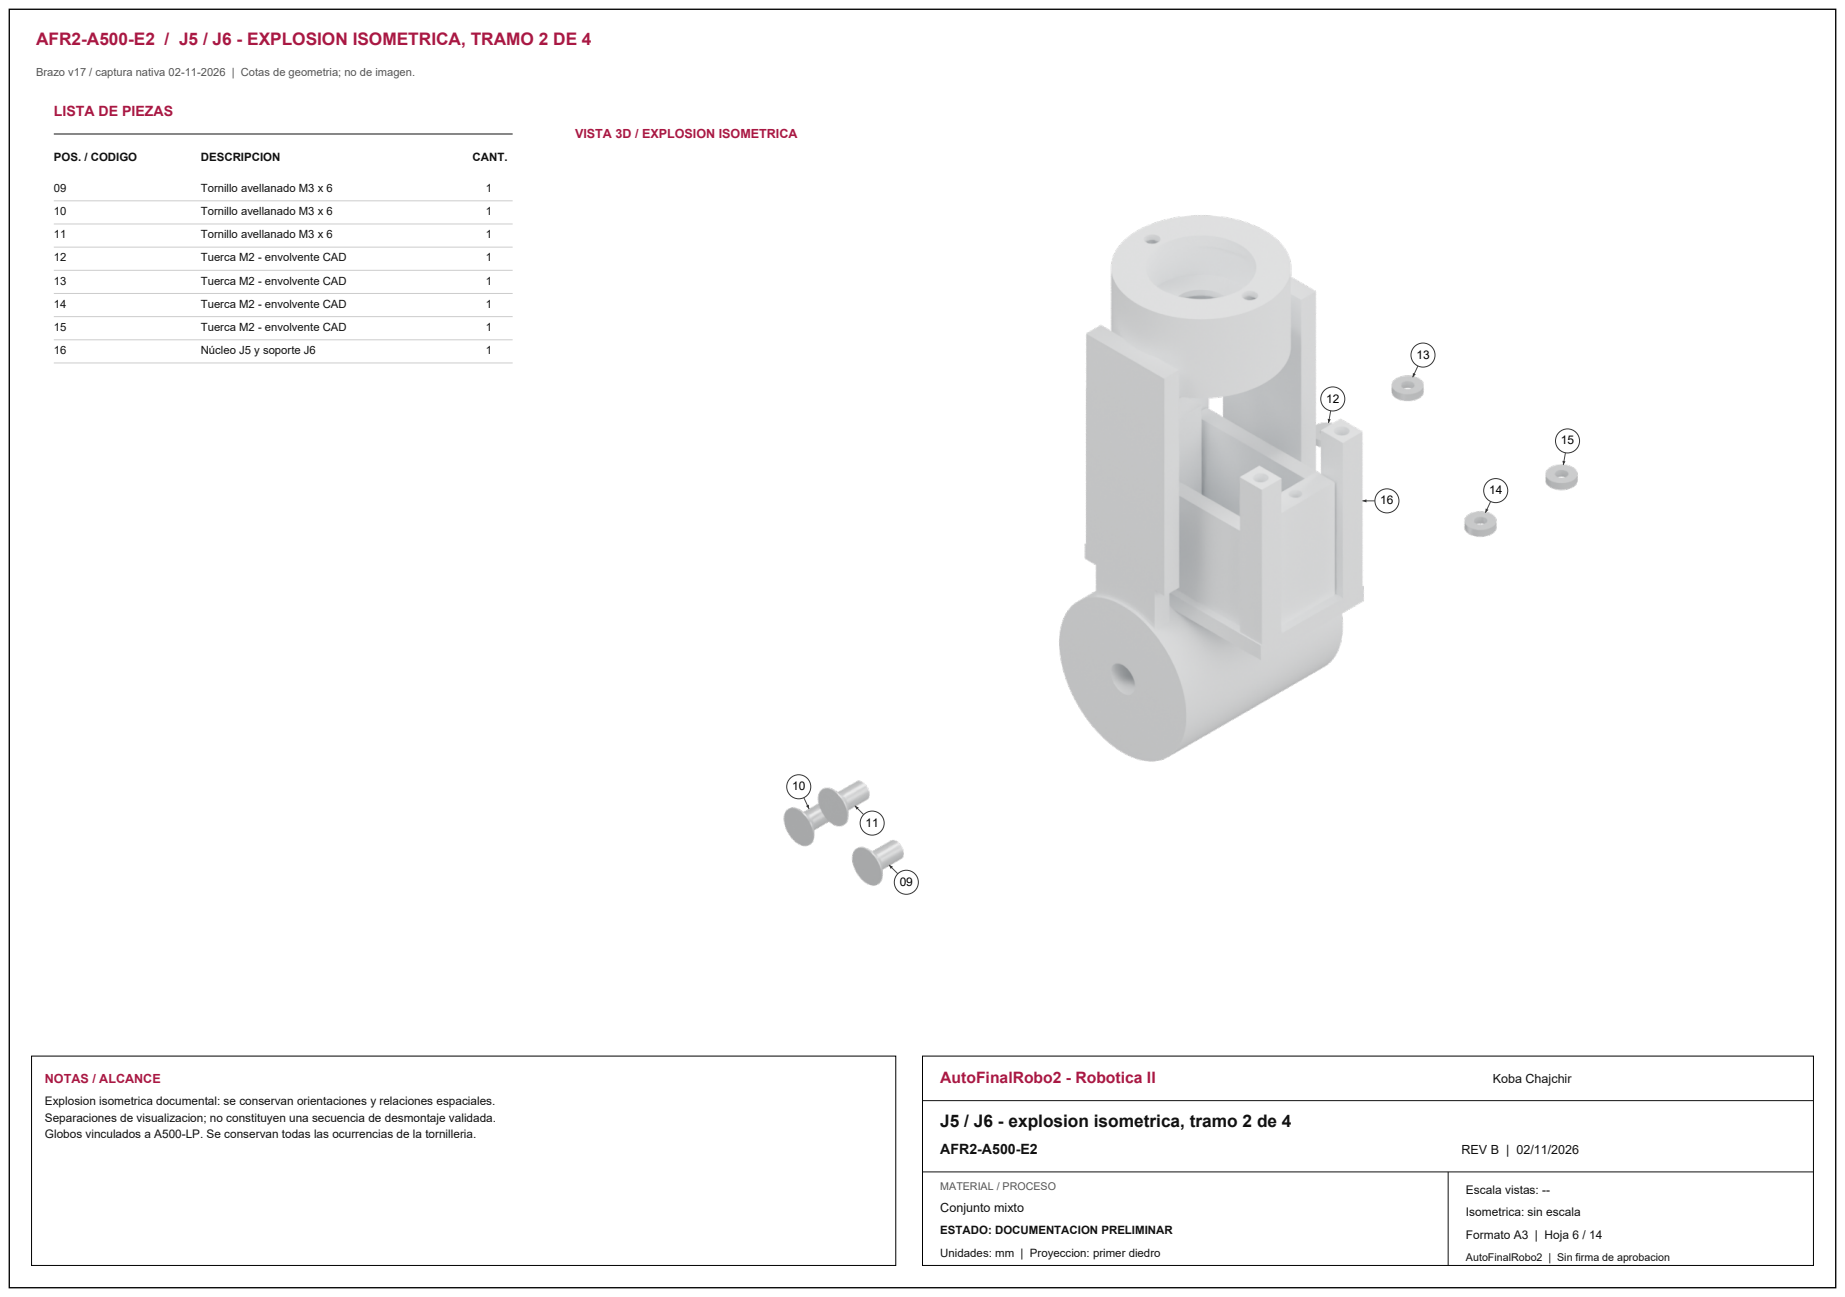
[picture p390: page 6]
POS. / CODIGO; DESCRIPCION; CANT.; Tornillo avellanado M3 x 6; Tuerca M2 - envolvente CAD; Núcleo J5 y soporte J6; NOTAS / ALCANCE; AutoFinalRobo2 - Robotica II; Koba Chajchir; AFR2-A500-E2; REV B | 02/11/2026; MATERIAL / PROCESO; Escala vistas: --

LISTA DE PIEZAS

VISTA 3D / EXPLOSION ISOMETRICA

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

J5 / J6 - explosion isometrica, tramo 2 de 4

## AFR2-A500-E3 / J5 / J6 - EXPLOSION ISOMETRICA, TRAMO 3 DE 4

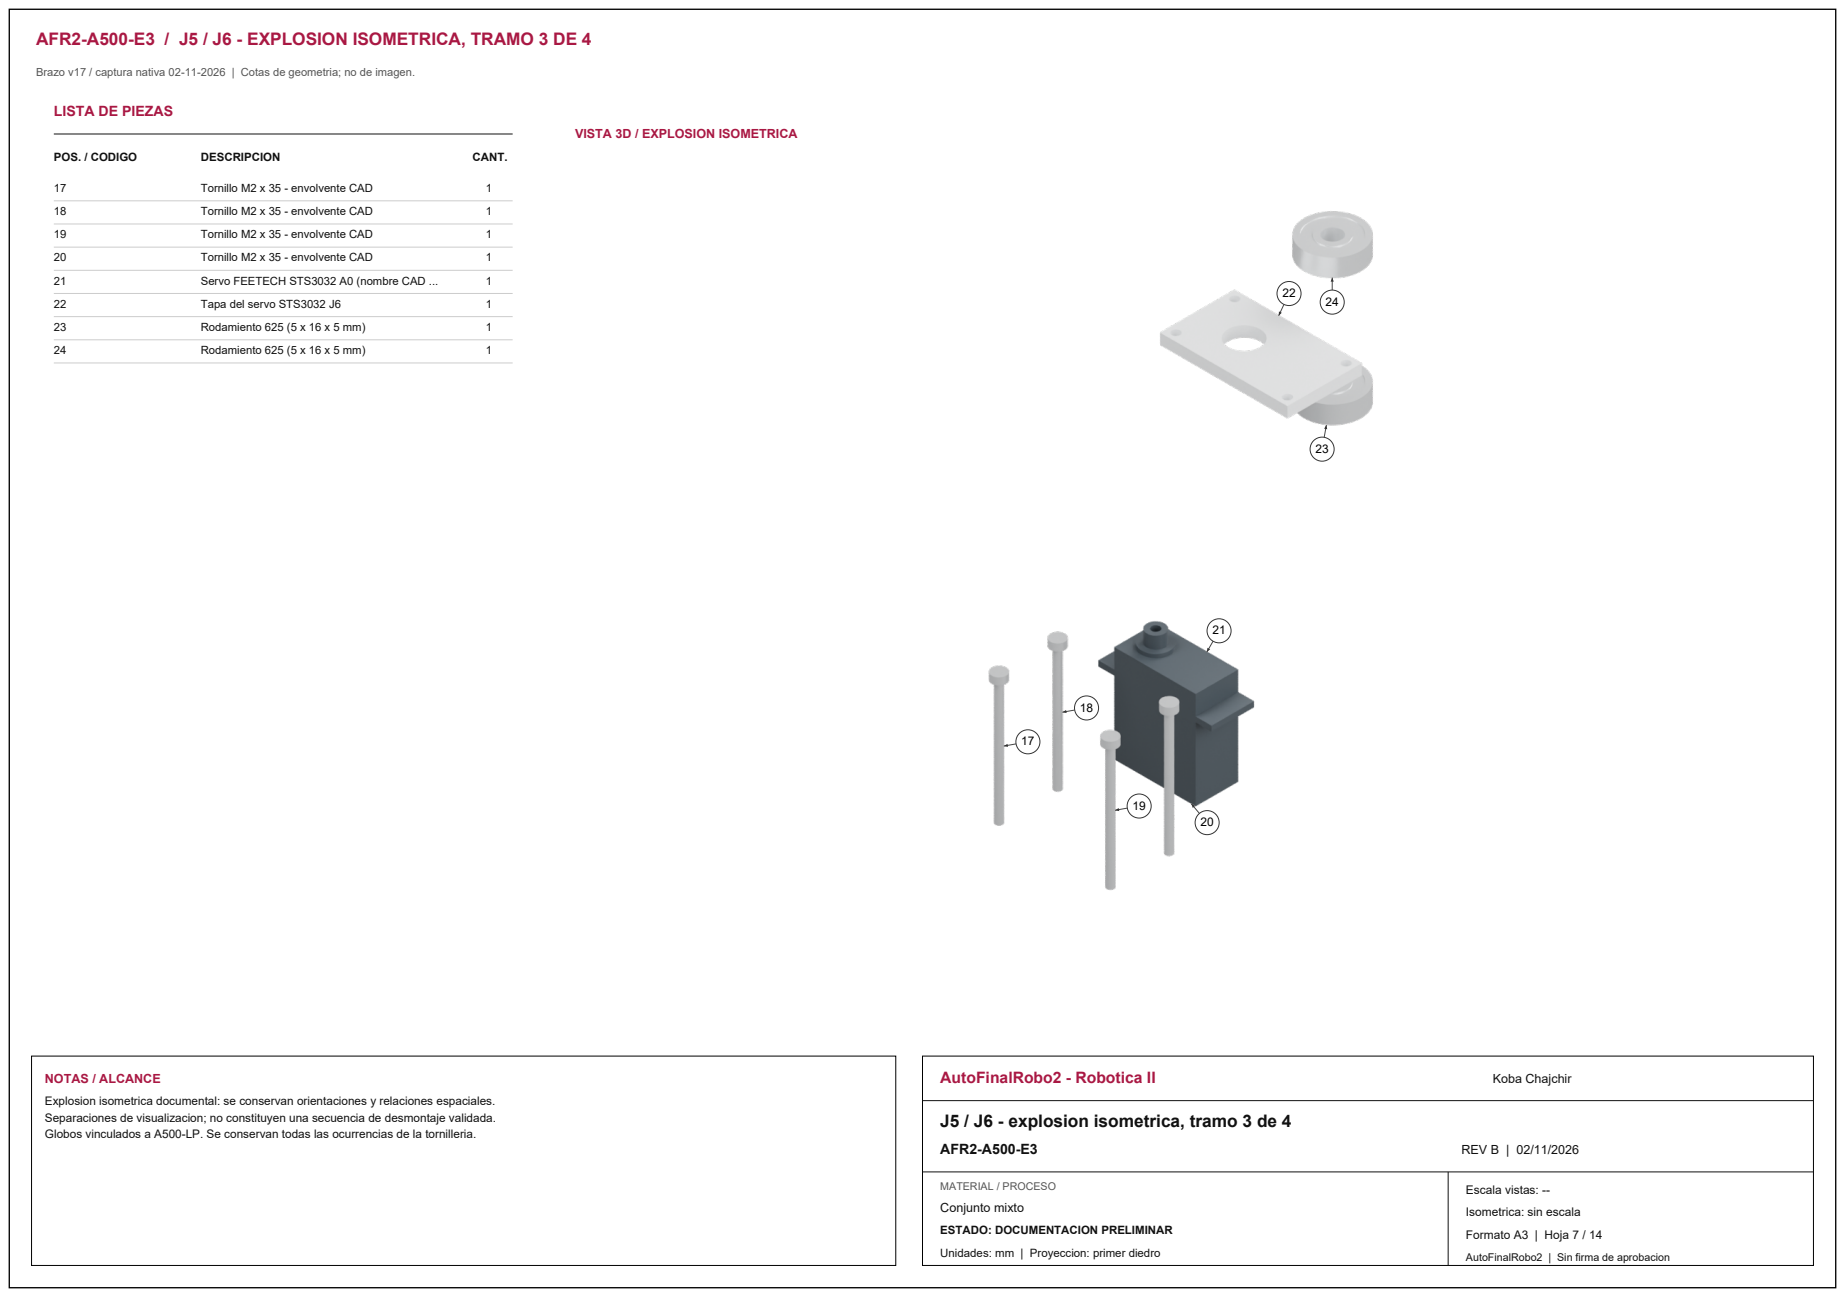
[picture p391: page 7]
POS. / CODIGO; DESCRIPCION; CANT.; Tornillo M2 x 35 - envolvente CAD; Servo FEETECH STS3032 A0 (nombre CAD ...; Tapa del servo STS3032 J6; Rodamiento 625 (5 x 16 x 5 mm); NOTAS / ALCANCE; AutoFinalRobo2 - Robotica II; Koba Chajchir; AFR2-A500-E3; REV B | 02/11/2026; MATERIAL / PROCESO; Escala vistas: --

LISTA DE PIEZAS

VISTA 3D / EXPLOSION ISOMETRICA

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

J5 / J6 - explosion isometrica, tramo 3 de 4

## AFR2-A500-E4 / J5 / J6 - EXPLOSION ISOMETRICA, TRAMO 4 DE 4

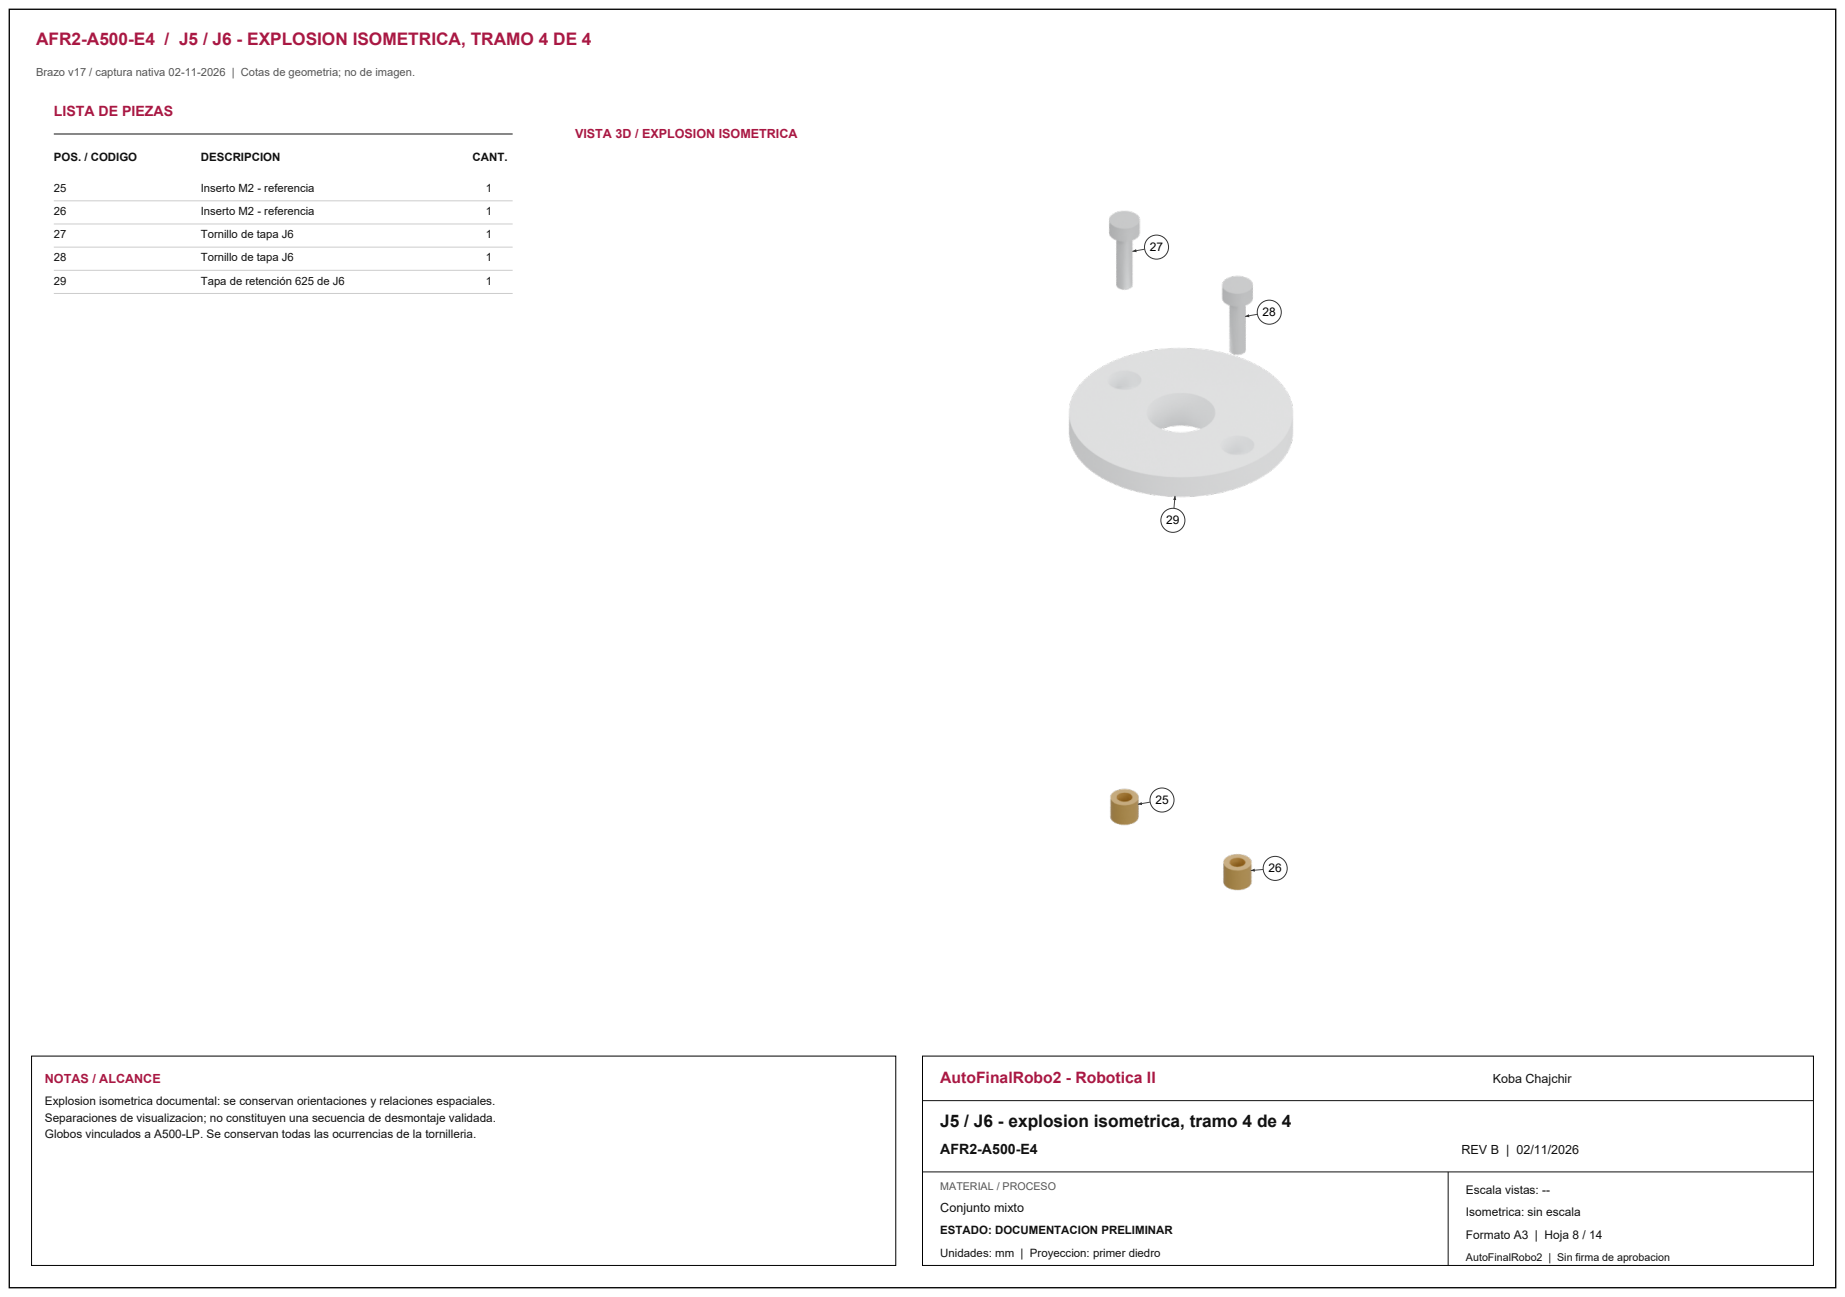
[picture p392: page 8]
POS. / CODIGO; DESCRIPCION; CANT.; Inserto M2 - referencia; Tornillo de tapa J6; Tapa de retención 625 de J6; NOTAS / ALCANCE; AutoFinalRobo2 - Robotica II; Koba Chajchir; AFR2-A500-E4; REV B | 02/11/2026; MATERIAL / PROCESO; Escala vistas: --

LISTA DE PIEZAS

VISTA 3D / EXPLOSION ISOMETRICA

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

J5 / J6 - explosion isometrica, tramo 4 de 4

## AFR2-P501 / NÚCLEO J5 Y SOPORTE J6

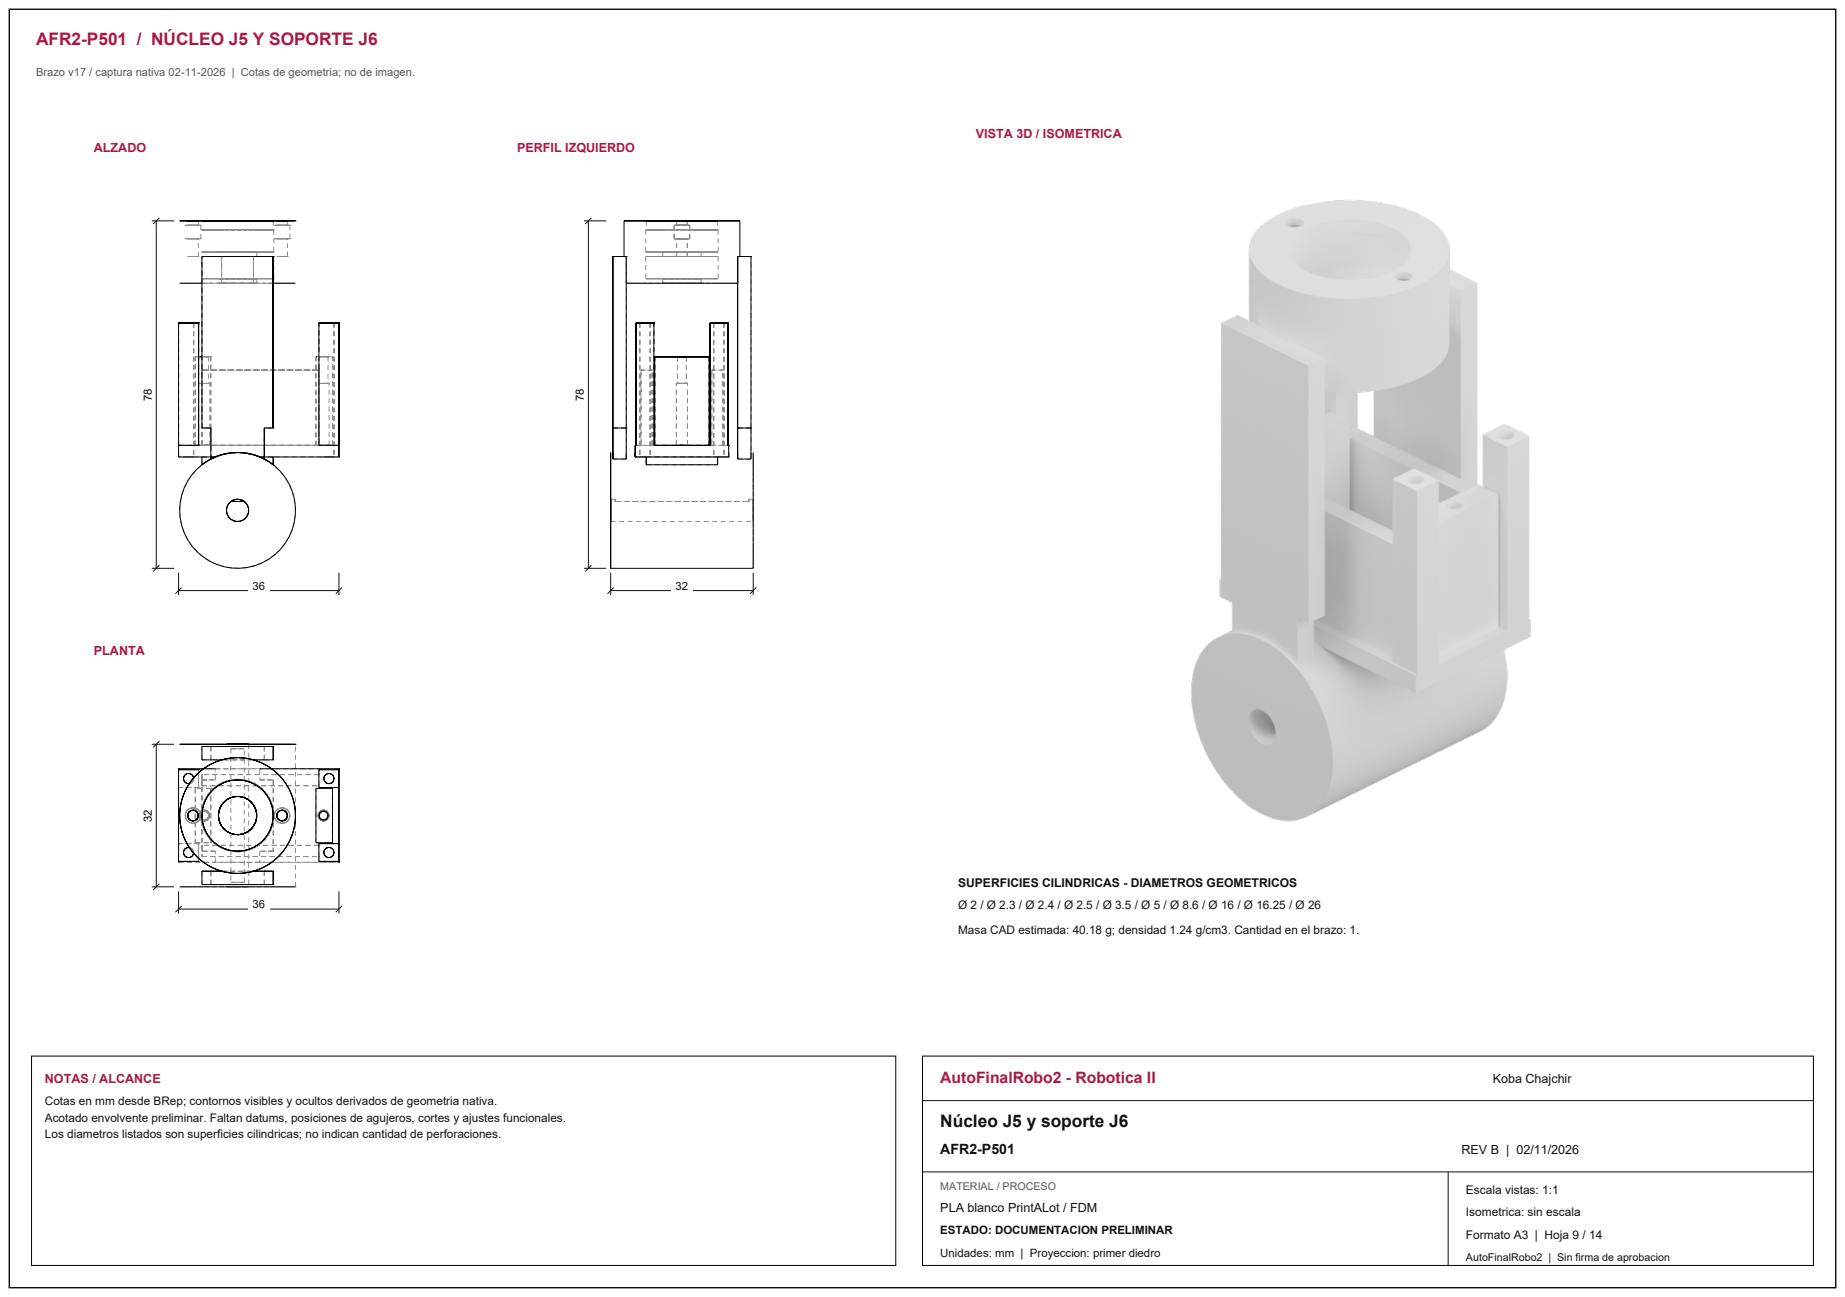
[picture p393: page 9]
ALZADO; PERFIL IZQUIERDO; PLANTA; VISTA 3D / ISOMETRICA; NOTAS / ALCANCE; AutoFinalRobo2 - Robotica II; Koba Chajchir; Núcleo J5 y soporte J6; AFR2-P501; REV B | 02/11/2026; Escala vistas: 1:1

SUPERFICIES CILINDRICAS - DIAMETROS GEOMETRICOS

Masa CAD estimada: 40.18 g; densidad 1.24 g/cm3. Cantidad en el brazo: 1.

Cotas en mm desde BRep; contornos visibles y ocultos derivados de geometria nativa.
Acotado envolvente preliminar. Faltan datums, posiciones de agujeros, cortes y ajustes funcionales.
Los diametros listados son superficies cilindricas; no indican cantidad de perforaciones.

MATERIAL / PROCESO
PLA blanco PrintALot / FDM

## AFR2-P502 / TAPA DE RETENCIÓN 625 DE J6

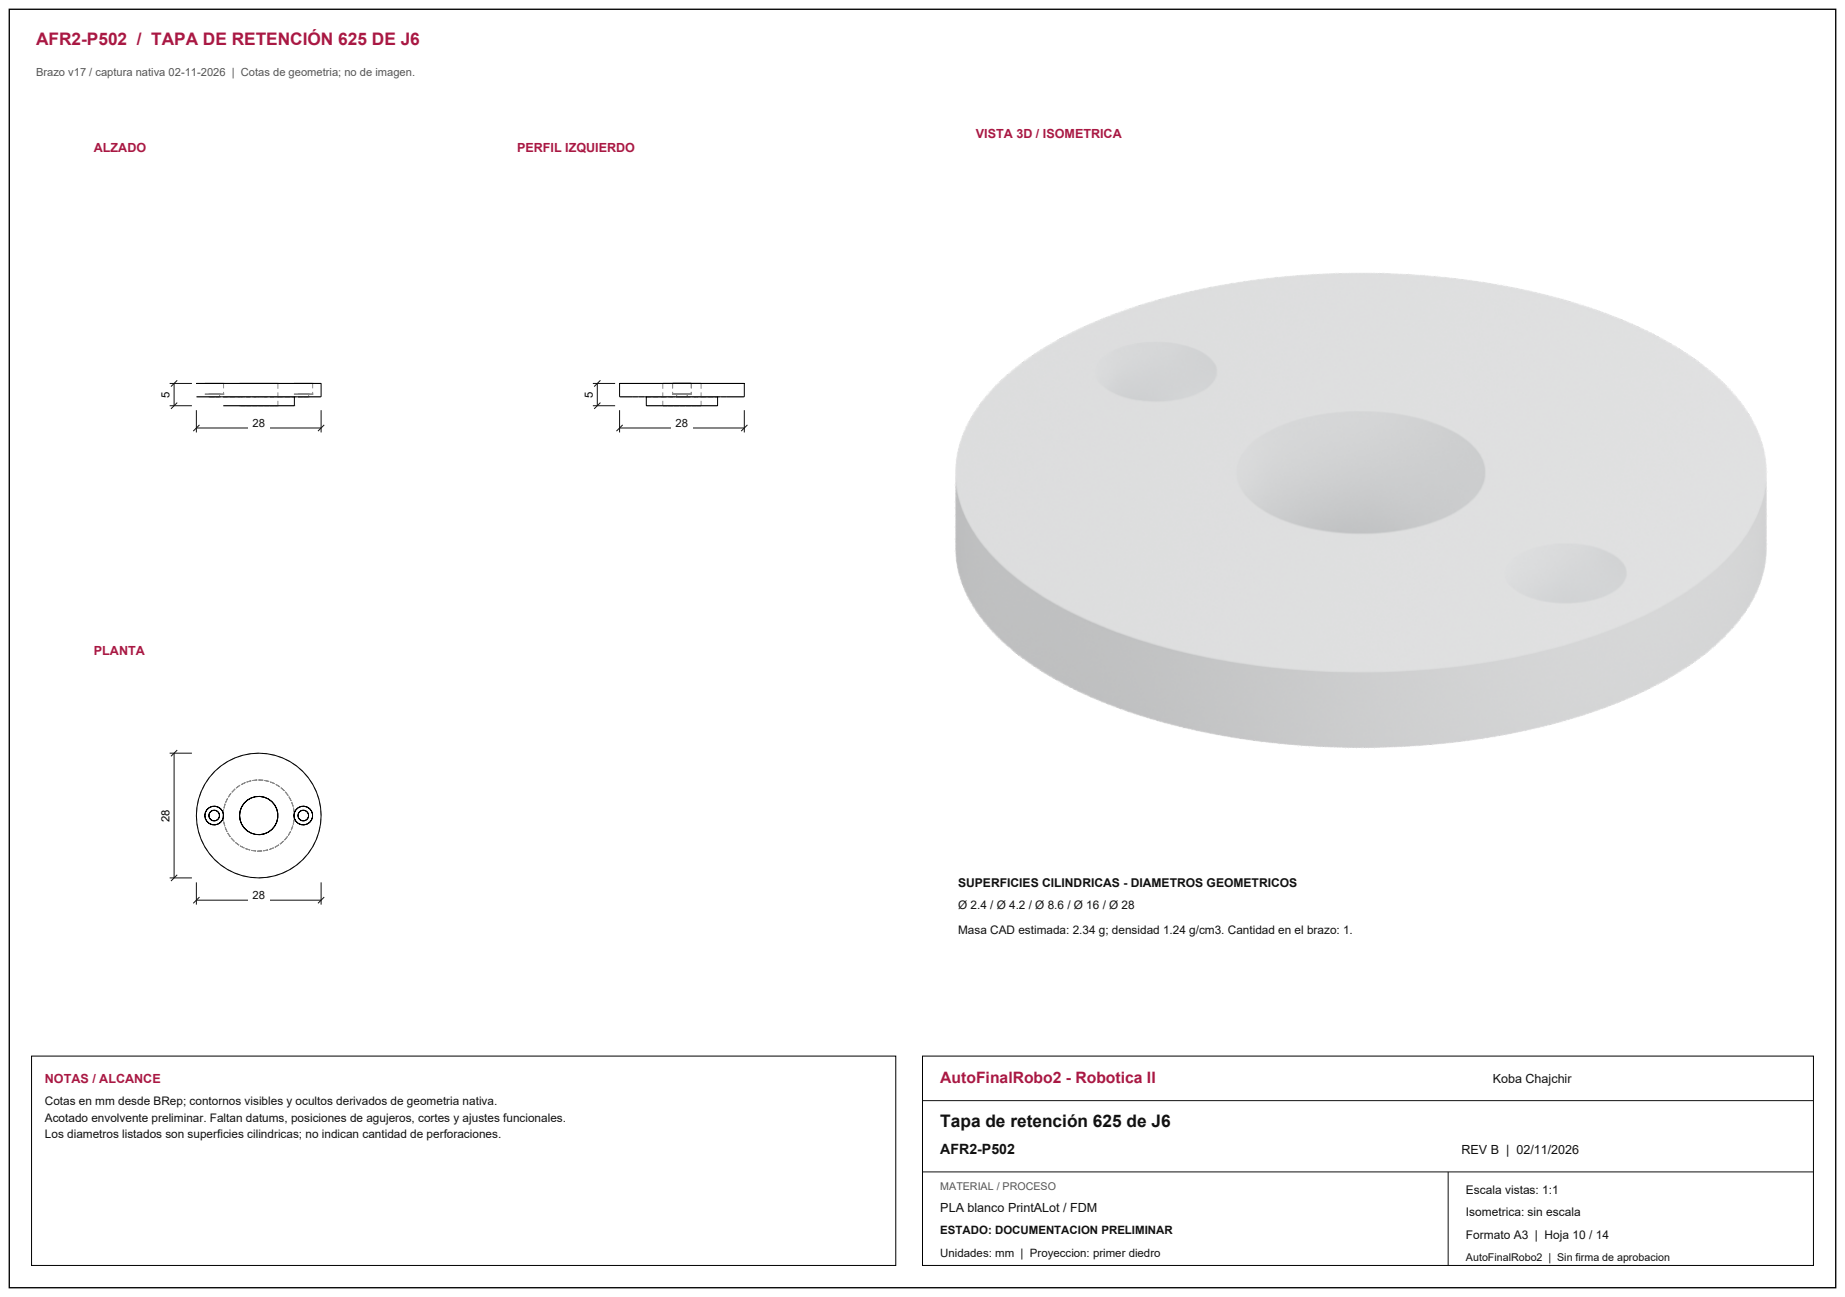
[picture p394: page 10]
ALZADO; PERFIL IZQUIERDO; PLANTA; VISTA 3D / ISOMETRICA; NOTAS / ALCANCE; AutoFinalRobo2 - Robotica II; Koba Chajchir; AFR2-P502; REV B | 02/11/2026; Escala vistas: 1:1

SUPERFICIES CILINDRICAS - DIAMETROS GEOMETRICOS

Masa CAD estimada: 2.34 g; densidad 1.24 g/cm3. Cantidad en el brazo: 1.

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

Tapa de retención 625 de J6

MATERIAL / PROCESO
PLA blanco PrintALot / FDM

## AFR2-P503 / TAPA DEL SERVO STS3032 J6

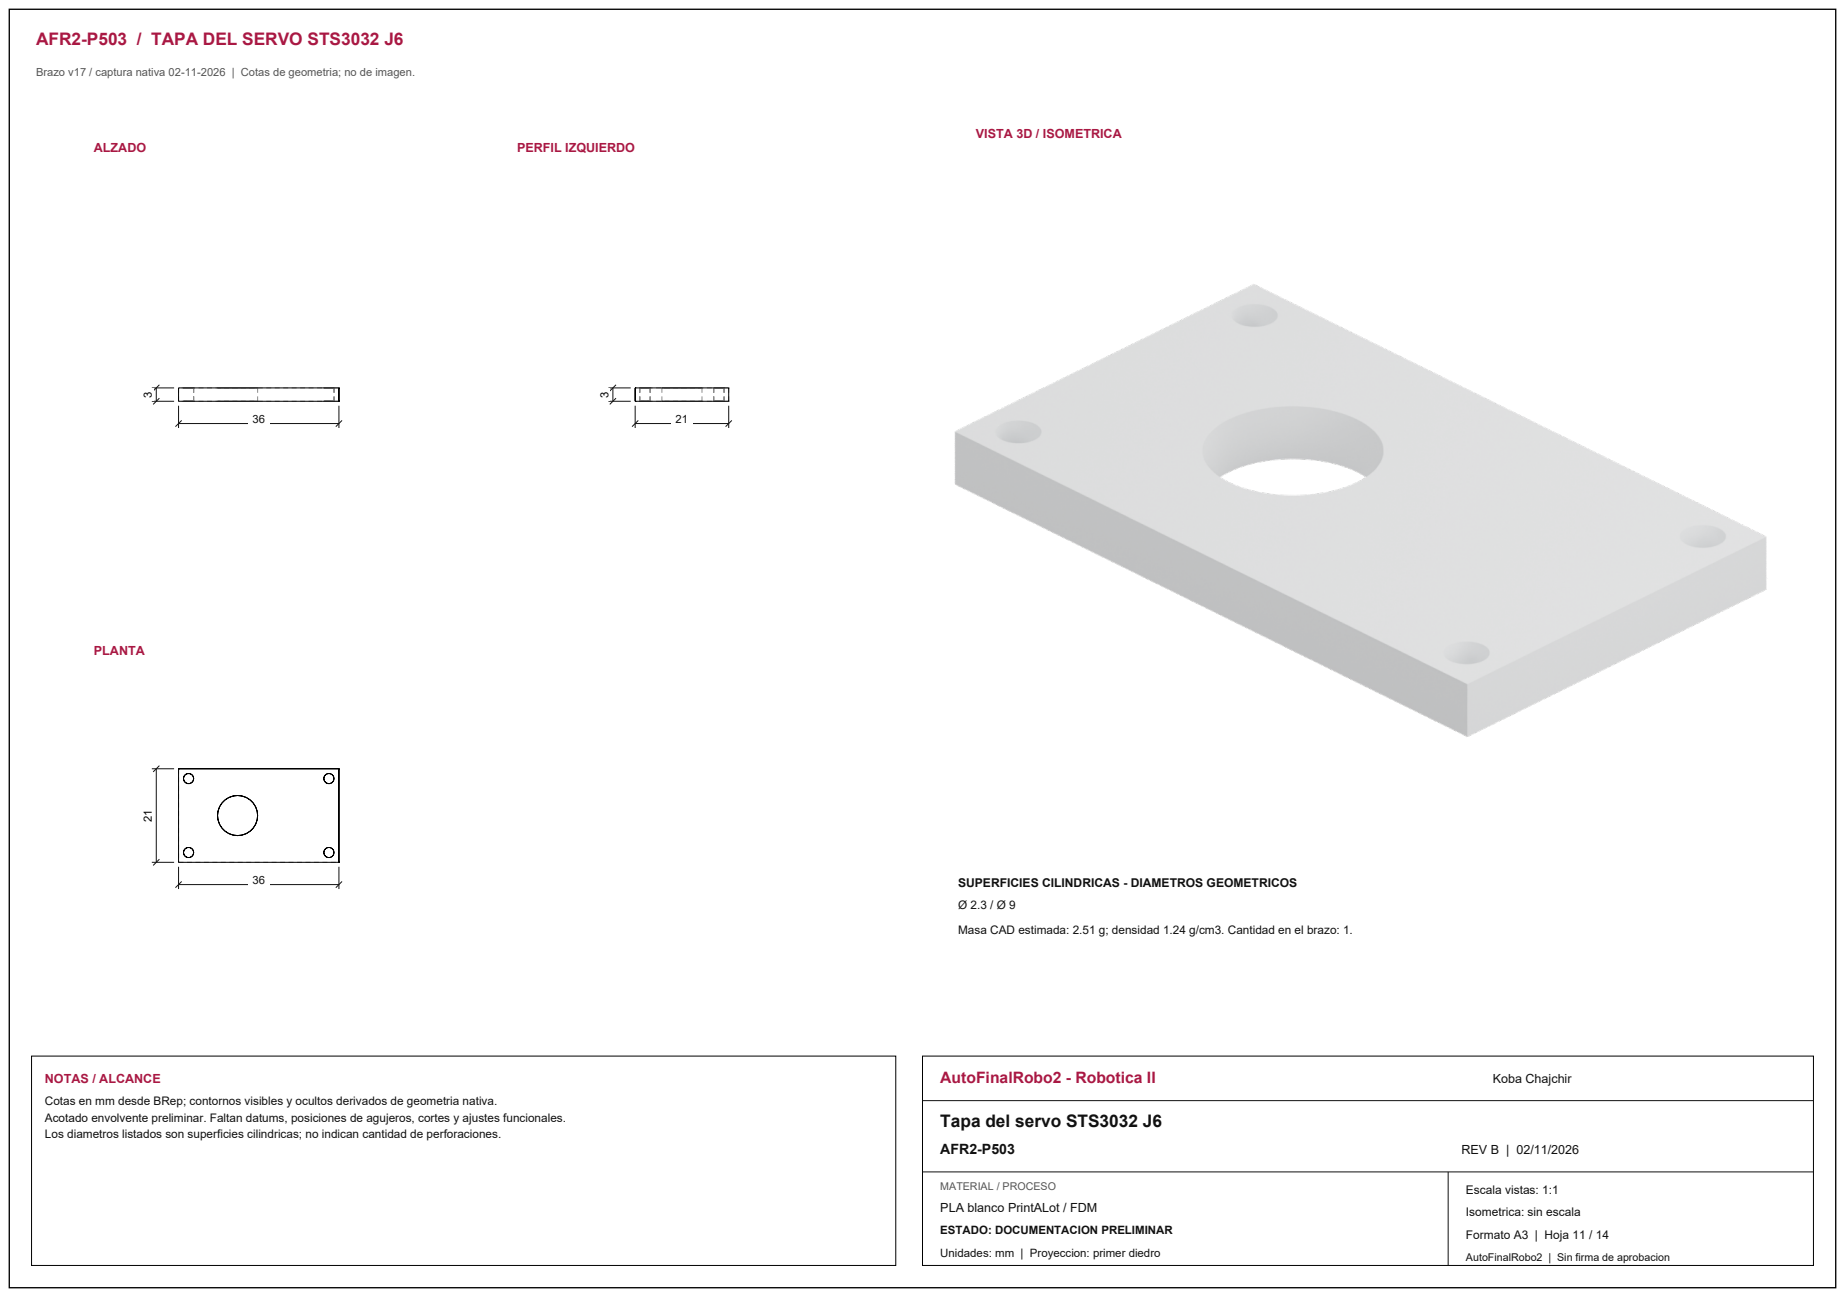
[picture p395: page 11]
ALZADO; PERFIL IZQUIERDO; PLANTA; VISTA 3D / ISOMETRICA; NOTAS / ALCANCE; AutoFinalRobo2 - Robotica II; Koba Chajchir; AFR2-P503; REV B | 02/11/2026; Escala vistas: 1:1

SUPERFICIES CILINDRICAS - DIAMETROS GEOMETRICOS

Masa CAD estimada: 2.51 g; densidad 1.24 g/cm3. Cantidad en el brazo: 1.

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

Tapa del servo STS3032 J6

MATERIAL / PROCESO
PLA blanco PrintALot / FDM

## AFR2-P504 / EJE Y BRIDA DE J5

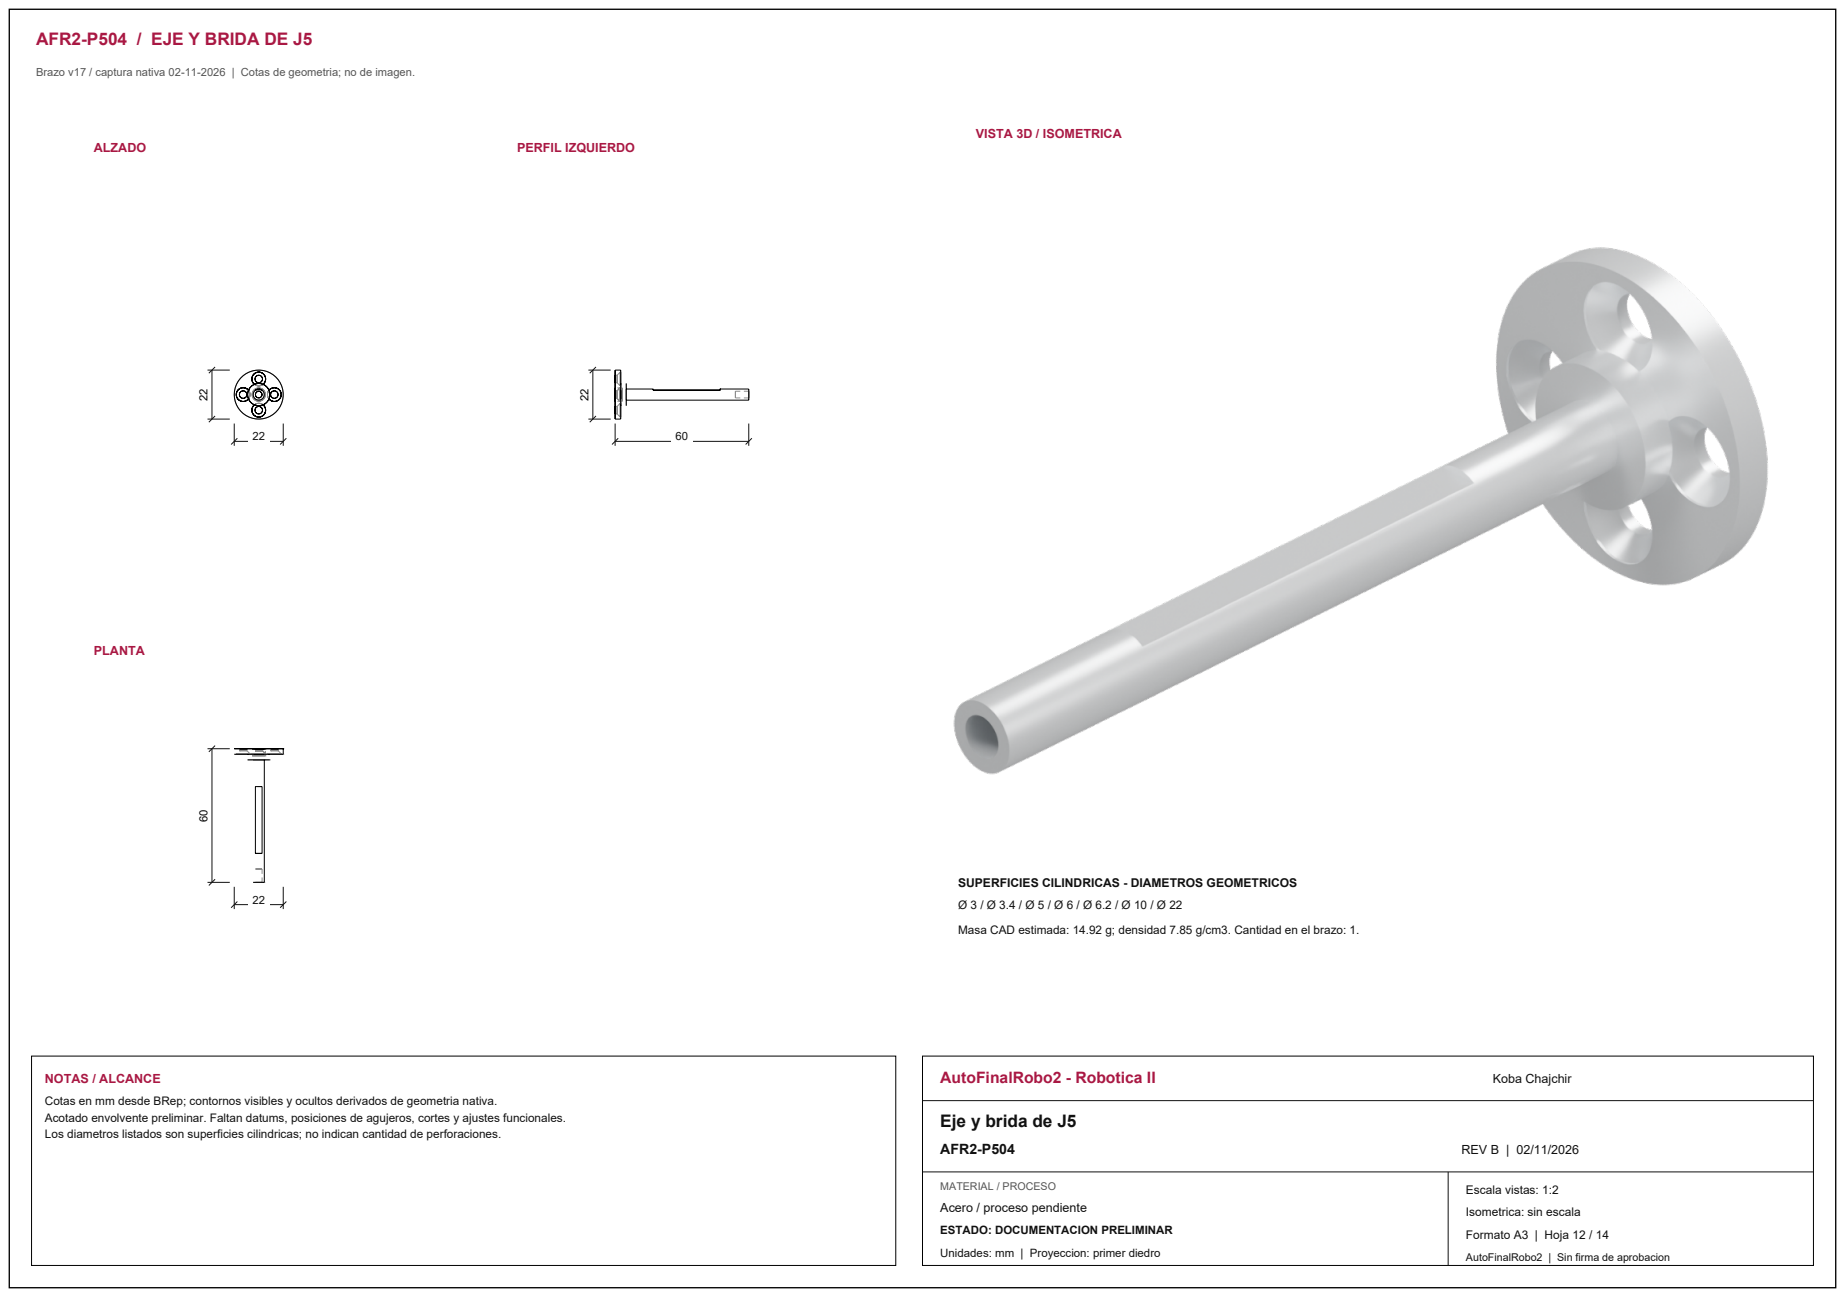
[picture p396: page 12]
ALZADO; PERFIL IZQUIERDO; PLANTA; VISTA 3D / ISOMETRICA; NOTAS / ALCANCE; AutoFinalRobo2 - Robotica II; Koba Chajchir; AFR2-P504; REV B | 02/11/2026; Escala vistas: 1:2

SUPERFICIES CILINDRICAS - DIAMETROS GEOMETRICOS

Masa CAD estimada: 14.92 g; densidad 7.85 g/cm3. Cantidad en el brazo: 1.

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

Eje y brida de J5

MATERIAL / PROCESO
Acero / proceso pendiente

## AFR2-P505 / SEPARADOR AXIAL DE J5

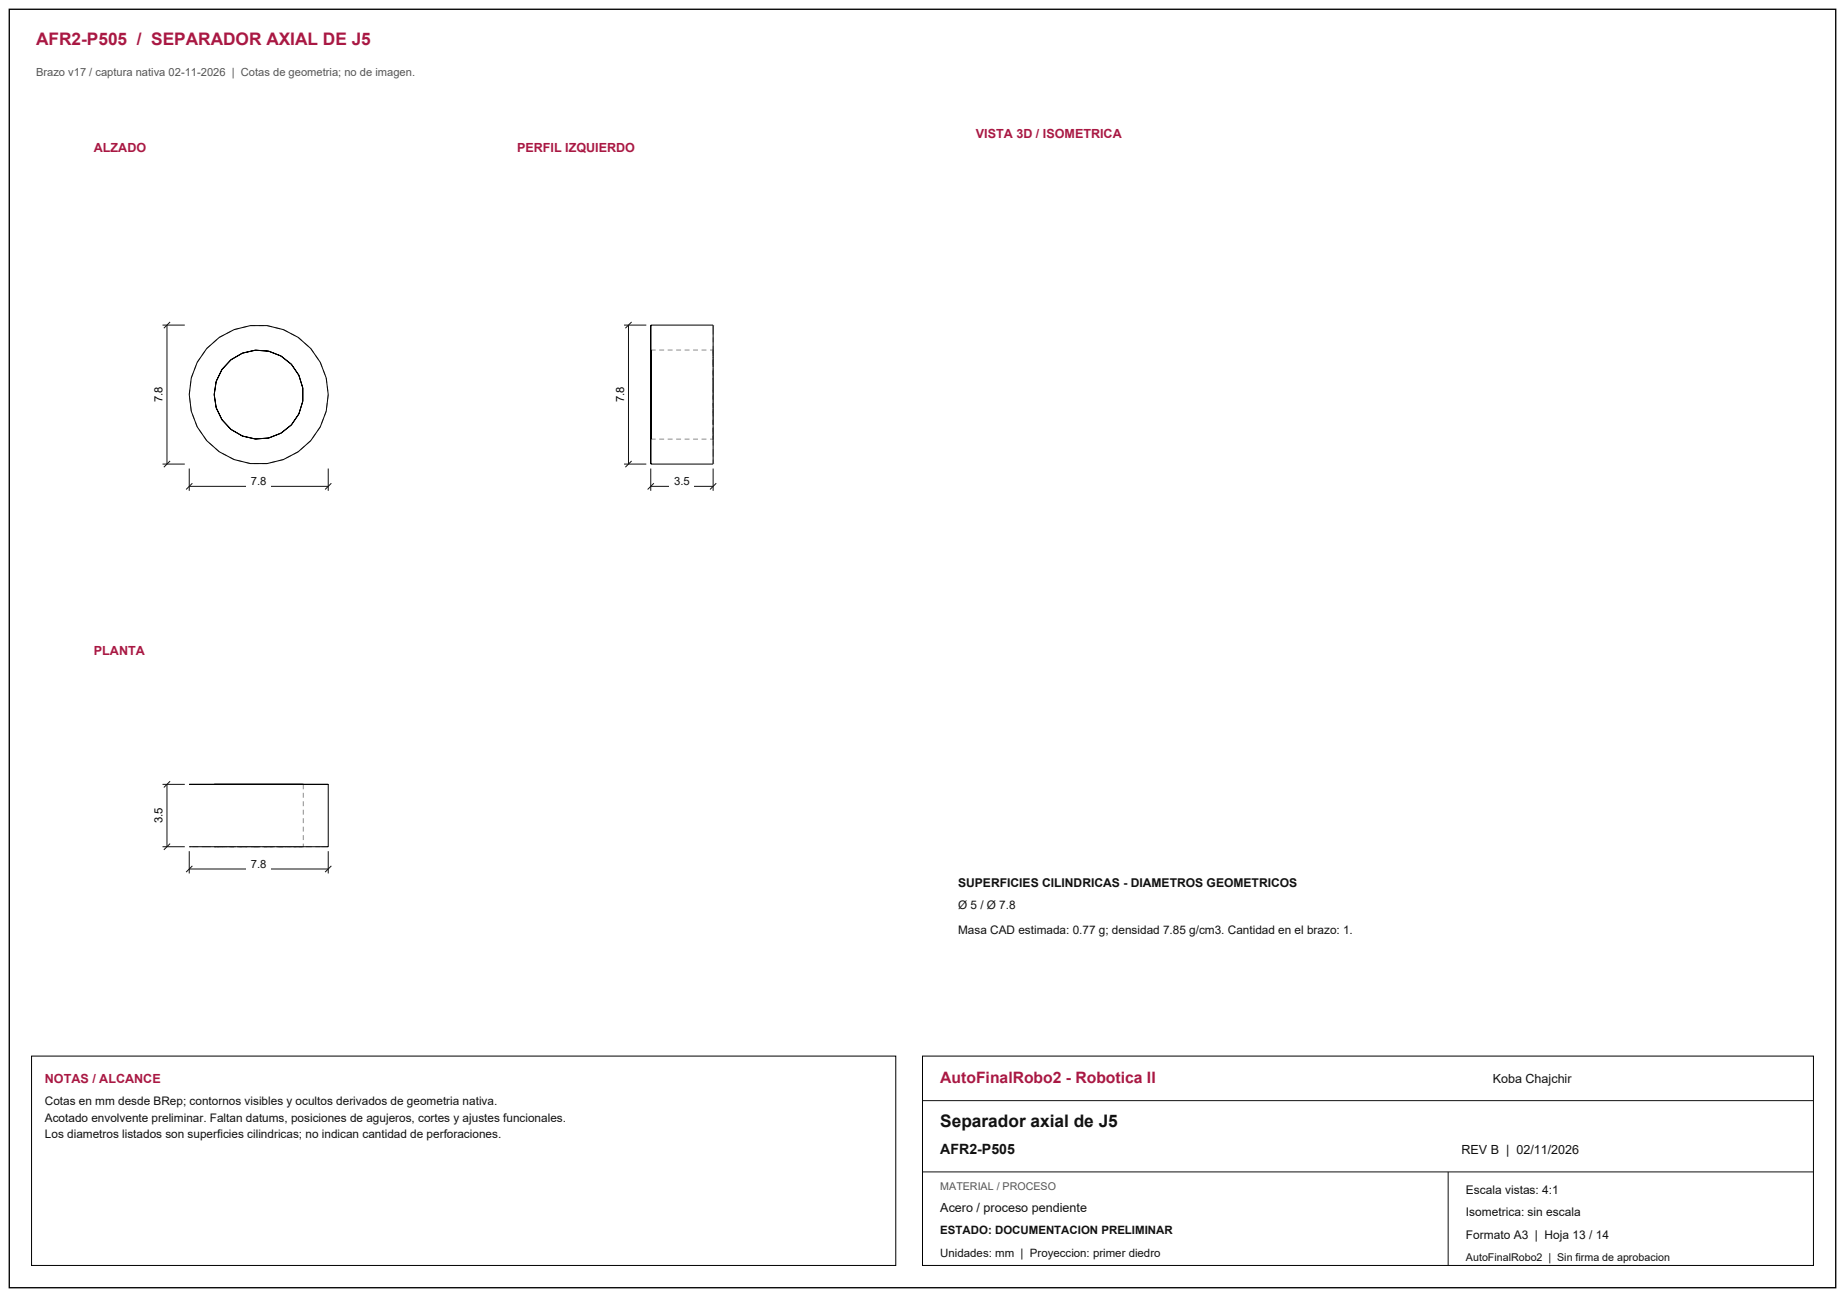
[picture p397: page 13]
ALZADO; PERFIL IZQUIERDO; PLANTA; VISTA 3D / ISOMETRICA; NOTAS / ALCANCE; AutoFinalRobo2 - Robotica II; Koba Chajchir; AFR2-P505; REV B | 02/11/2026; Escala vistas: 4:1

SUPERFICIES CILINDRICAS - DIAMETROS GEOMETRICOS

Masa CAD estimada: 0.77 g; densidad 7.85 g/cm3. Cantidad en el brazo: 1.

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

Separador axial de J5

MATERIAL / PROCESO
Acero / proceso pendiente

## AFR2-P506 / SEPARADOR TRASERO DE J5

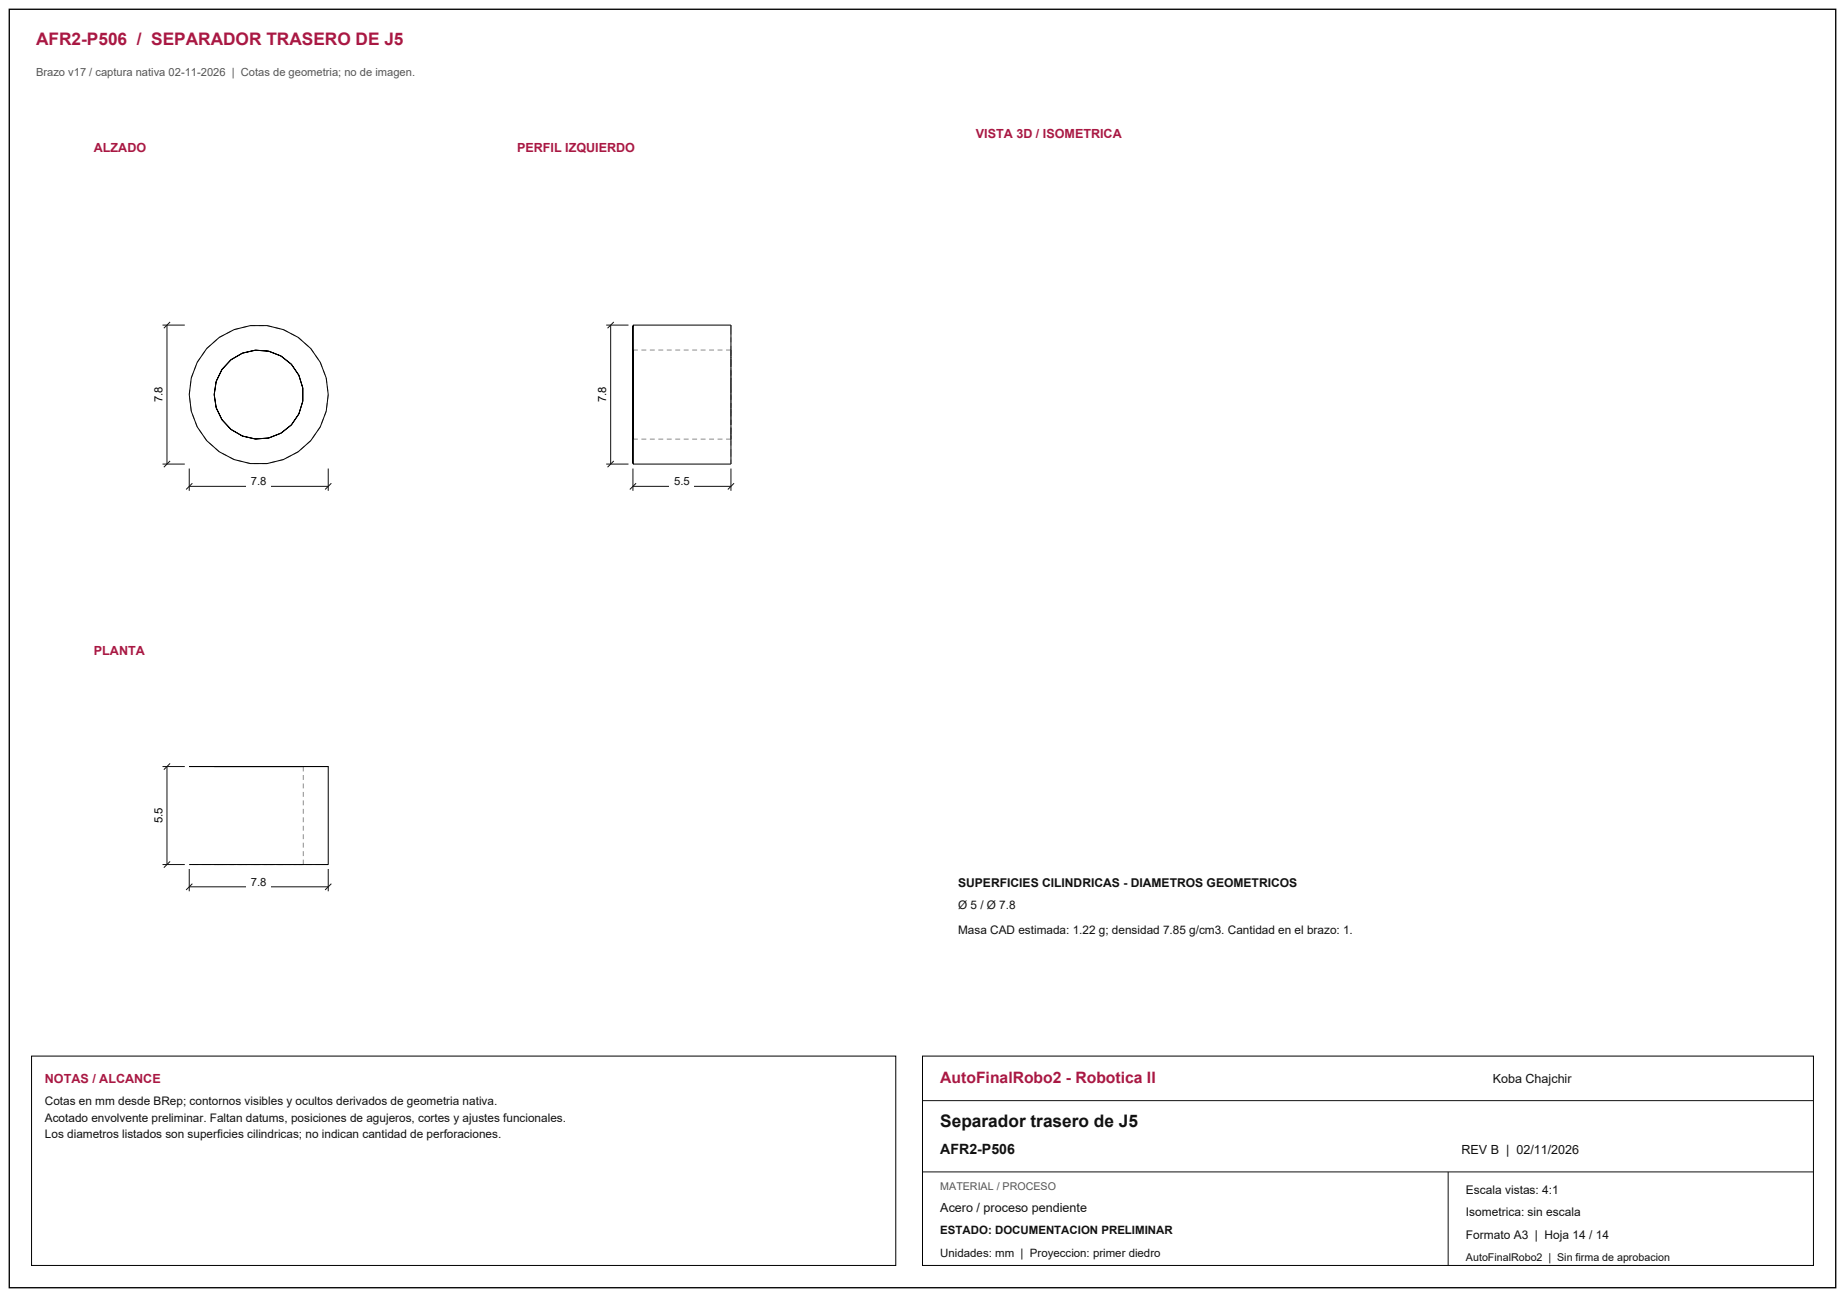
[picture p398: page 14]
ALZADO; PERFIL IZQUIERDO; PLANTA; VISTA 3D / ISOMETRICA; NOTAS / ALCANCE; AutoFinalRobo2 - Robotica II; Koba Chajchir; AFR2-P506; REV B | 02/11/2026; Escala vistas: 4:1

SUPERFICIES CILINDRICAS - DIAMETROS GEOMETRICOS

Masa CAD estimada: 1.22 g; densidad 7.85 g/cm3. Cantidad en el brazo: 1.

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

Separador trasero de J5

MATERIAL / PROCESO
Acero / proceso pendiente
