kobachajchir/ProyectoRobotica2/AutoFinalRobo2-CAD/mecanica/brazo-antropomorfo/revision_v17/laminas_20261109/tomos/AFR2_Tomo_5_Muneca_J5_J6_A3.pdf

AFR2-A500 | Inclinacion J5 y soporte J6
Fuente F3D 02/11/2026 | Revision V17 | Extraccion BRep 09/11/2026 | No Drawing asociativo

NOTAS Y ALCANCE

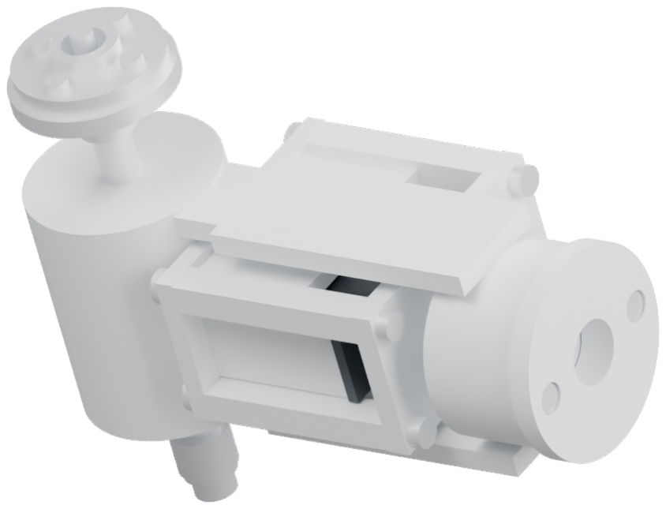
[picture p399: figure]

Conjunto armado desde la captura nativa, con sus orientaciones y ubicaciones guardadas. Lista de ocurrencias en hojas -LP y despieces por tramos -E.
No se modifica la geometria ni se afirma secuencia de montaje/desmontaje comprobada.

### AutoFinalRobo2 | Documentacion mecanica

### Inclinacion J5 y soporte J6

AFR2-A500 | REV D | 09/11/2026
Conjunto mixto Koba Chajchir | Cotas nominales CAD Ajustes / proceso pendientes de cierre; sin aprobacion | A3 | mm | Hoja 64/224
| Vistas -- | 3D sin escala
| Proyeccion: primer diedro

AFR2-A500-LP01 | Lista de ocurrencias | Inclinacion J5 y soporte J6
001 AFR2-P501 | V02 A18 Nucleo J5 y columna J6

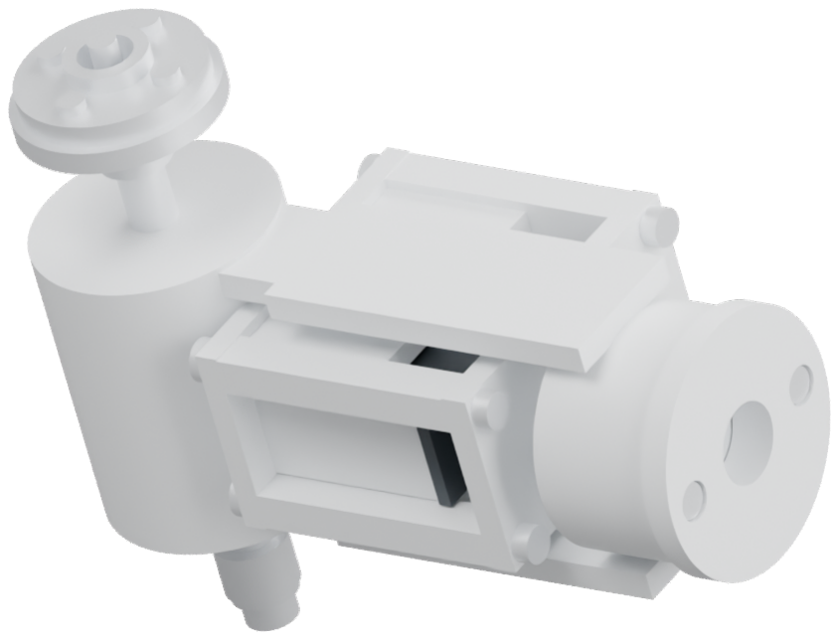
[picture p400: figure]

002 AFR2-P504 | V02 E04 Eje y brida J5
003 COMERCIAL/REFERENCIA | V02 M06 MG90S J6
004 COMERCIAL/REFERENCIA | V02 R06 625 J6
005 COMERCIAL/REFERENCIA | V03 Arandela trasera J5
006 COMERCIAL/REFERENCIA | V03 Inserto M2 J6 -1
007 COMERCIAL/REFERENCIA | V03 Inserto M2 J6 1
008 COMERCIAL/REFERENCIA | V03 R06 625 J6 inferior
009 AFR2-P505 | V03 Separador axial J5
010 AFR2-P506 | V03 Separador trasero J5
011 AFR2-P502 | V03 Tapa 625 J6
012 COMERCIAL/REFERENCIA | V03 Tornillo axial trasero J5
013 COMERCIAL/REFERENCIA | V03 Tornillo original horn V02 M05 MG946 J5
014 COMERCIAL/REFERENCIA | V03 Tornillo tapa J6 -1
015 COMERCIAL/REFERENCIA | V03 Tornillo tapa J6 1
016 AFR2-P340 | V17 Horn STS3250 J3
017 COMERCIAL/REFERENCIA | V17 M2x35 cilindrico J6 0
018 COMERCIAL/REFERENCIA | V17 M2x35 cilindrico J6 1

NOTAS Y ALCANCE

Cada posicion identifica una ocurrencia; los solidos de un mismo comercial se mantienen agrupados. Las placas con hijos Nano/PCA9685/XL4016 se agrupan como unidades comerciales.
Codigo COMERCIAL/REFERENCIA no implica plano de fabricacion propio. Rutas completas en CSV.

### AutoFinalRobo2 | Documentacion mecanica

### Lista de ocurrencias | Inclinacion J5 y soporte J6

AFR2-A500-LP01 | REV D | 09/11/2026

Conjunto mixto

| Vistas -- | 3D sin escala

AFR2-A500-LP02 | Lista de ocurrencias | Inclinacion J5 y soporte J6
019 COMERCIAL/REFERENCIA | V17 M2x35 cilindrico J6 2
020 COMERCIAL/REFERENCIA | V17 M2x35 cilindrico J6 3
021 COMERCIAL/REFERENCIA | V17 M3x6 ISO10642 horn J5 0
022 COMERCIAL/REFERENCIA | V17 M3x6 ISO10642 horn J5 1
023 COMERCIAL/REFERENCIA | V17 M3x6 ISO10642 horn J5 2
024 COMERCIAL/REFERENCIA | V17 M3x6 ISO10642 horn J5 3
025 AFR2-P503 | V17 Tapa STS3032 J6
026 COMERCIAL/REFERENCIA | V17 Tuerca M2 J6 0
027 COMERCIAL/REFERENCIA | V17 Tuerca M2 J6 1
028 COMERCIAL/REFERENCIA | V17 Tuerca M2 J6 2
029 COMERCIAL/REFERENCIA | V17 Tuerca M2 J6 3

NOTAS Y ALCANCE

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

### AutoFinalRobo2 | Documentacion mecanica

### Lista de ocurrencias | Inclinacion J5 y soporte J6

AFR2-A500-LP02 | REV D | 09/11/2026

Conjunto mixto

| Vistas -- | 3D sin escala

AFR2-A500-E1 | Despiece isometrico | Inclinacion J5 y soporte J6

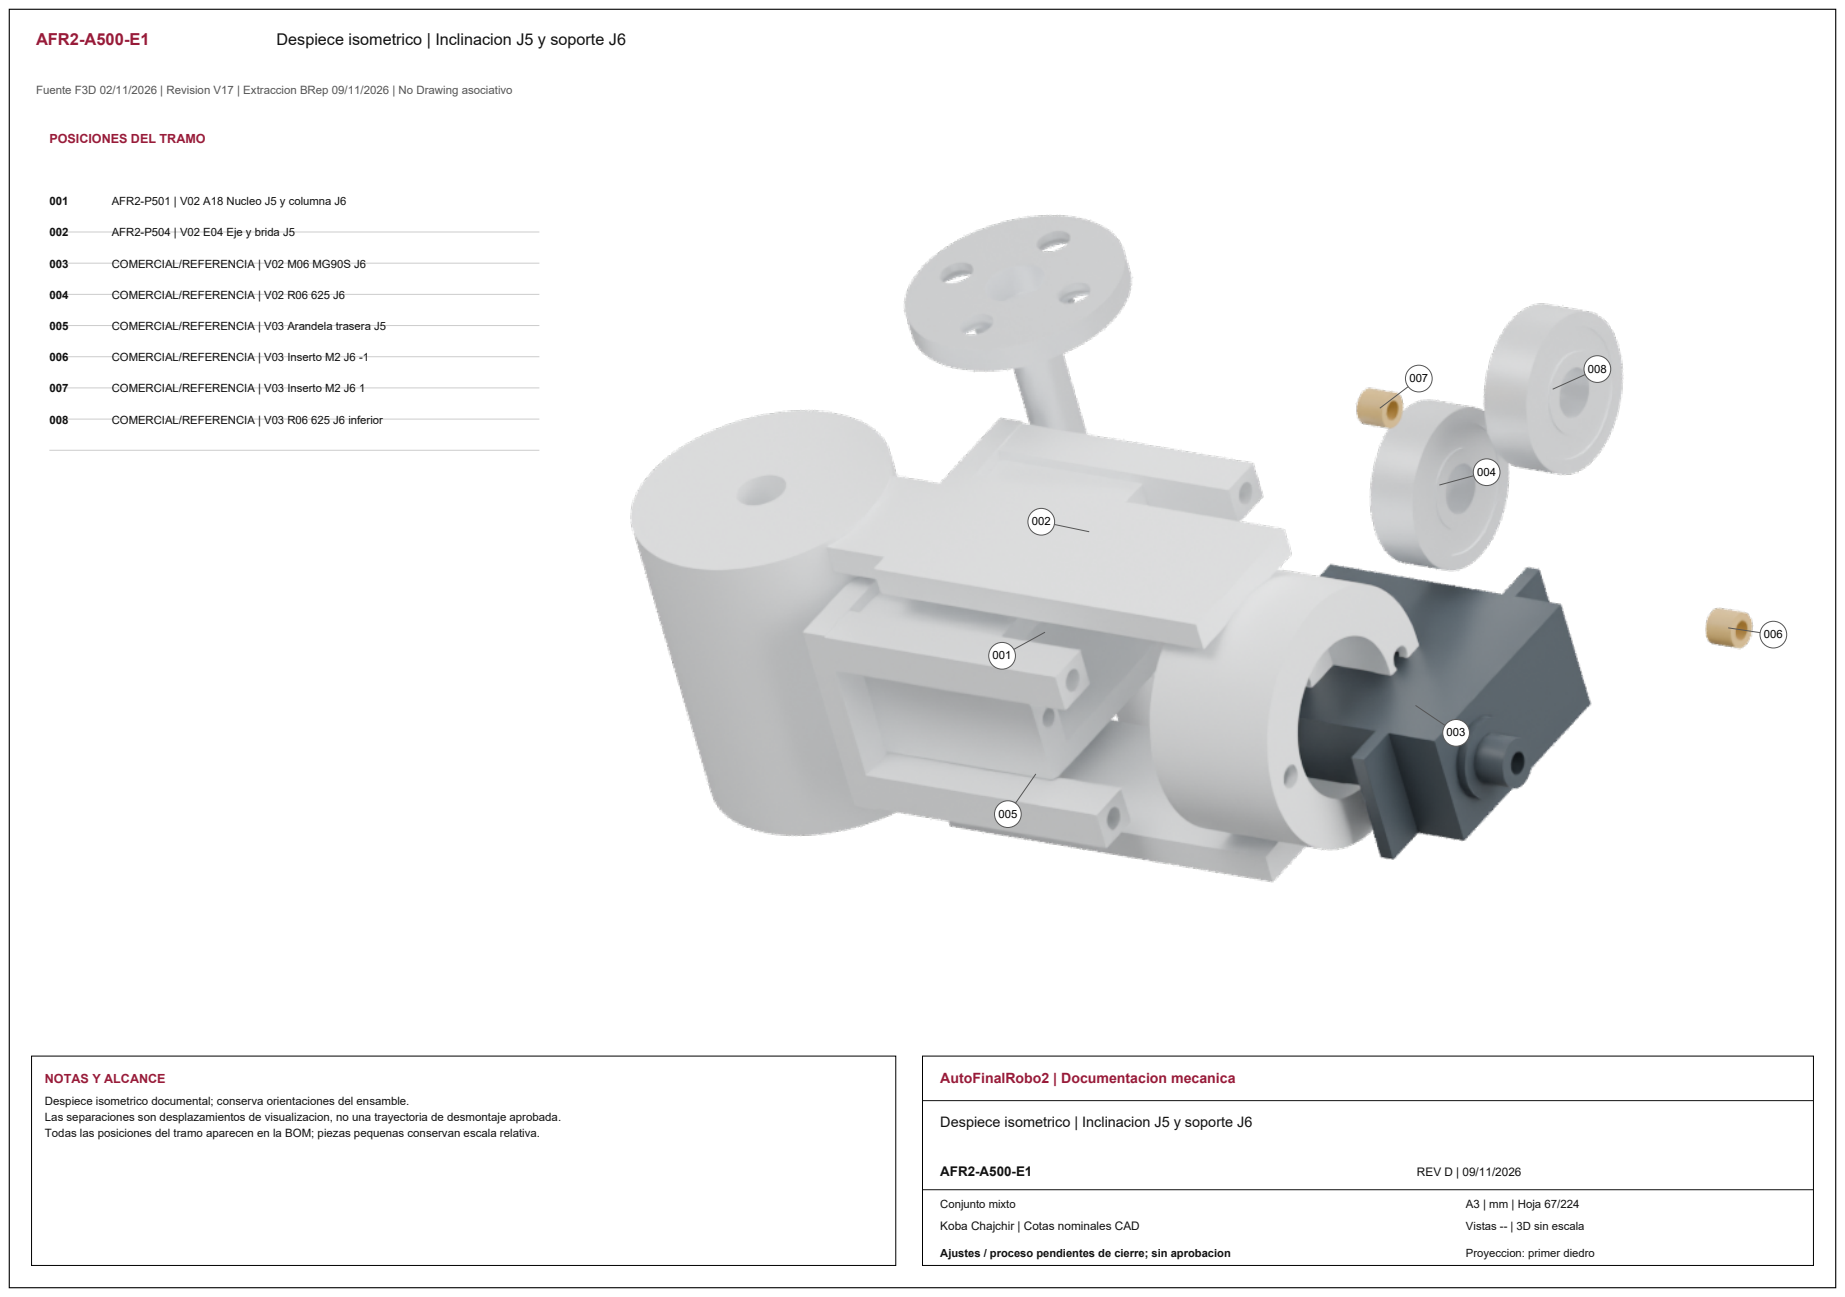
[picture p401: page 4]
001 AFR2-P501 | V02 A18 Nucleo J5 y columna J6; 002 AFR2-P504 | V02 E04 Eje y brida J5; 003 COMERCIAL/REFERENCIA | V02 M06 MG90S J6; 004 COMERCIAL/REFERENCIA | V02 R06 625 J6; NOTAS Y ALCANCE; AutoFinalRobo2 | Documentacion mecanica; AFR2-A500-E1; REV D | 09/11/2026; Conjunto mixto

POSICIONES DEL TRAMO

005 COMERCIAL/REFERENCIA | V03 Arandela trasera J5

006 COMERCIAL/REFERENCIA | V03 Inserto M2 J6 -1

007 COMERCIAL/REFERENCIA | V03 Inserto M2 J6 1

008 COMERCIAL/REFERENCIA | V03 R06 625 J6 inferior

Despiece isometrico documental; conserva orientaciones del ensamble.
Las separaciones son desplazamientos de visualizacion, no una trayectoria de desmontaje aprobada.
Todas las posiciones del tramo aparecen en la BOM; piezas pequenas conservan escala relativa.

Despiece isometrico | Inclinacion J5 y soporte J6

Vistas -- | 3D sin escala

AFR2-A500-E2 | Despiece isometrico | Inclinacion J5 y soporte J6

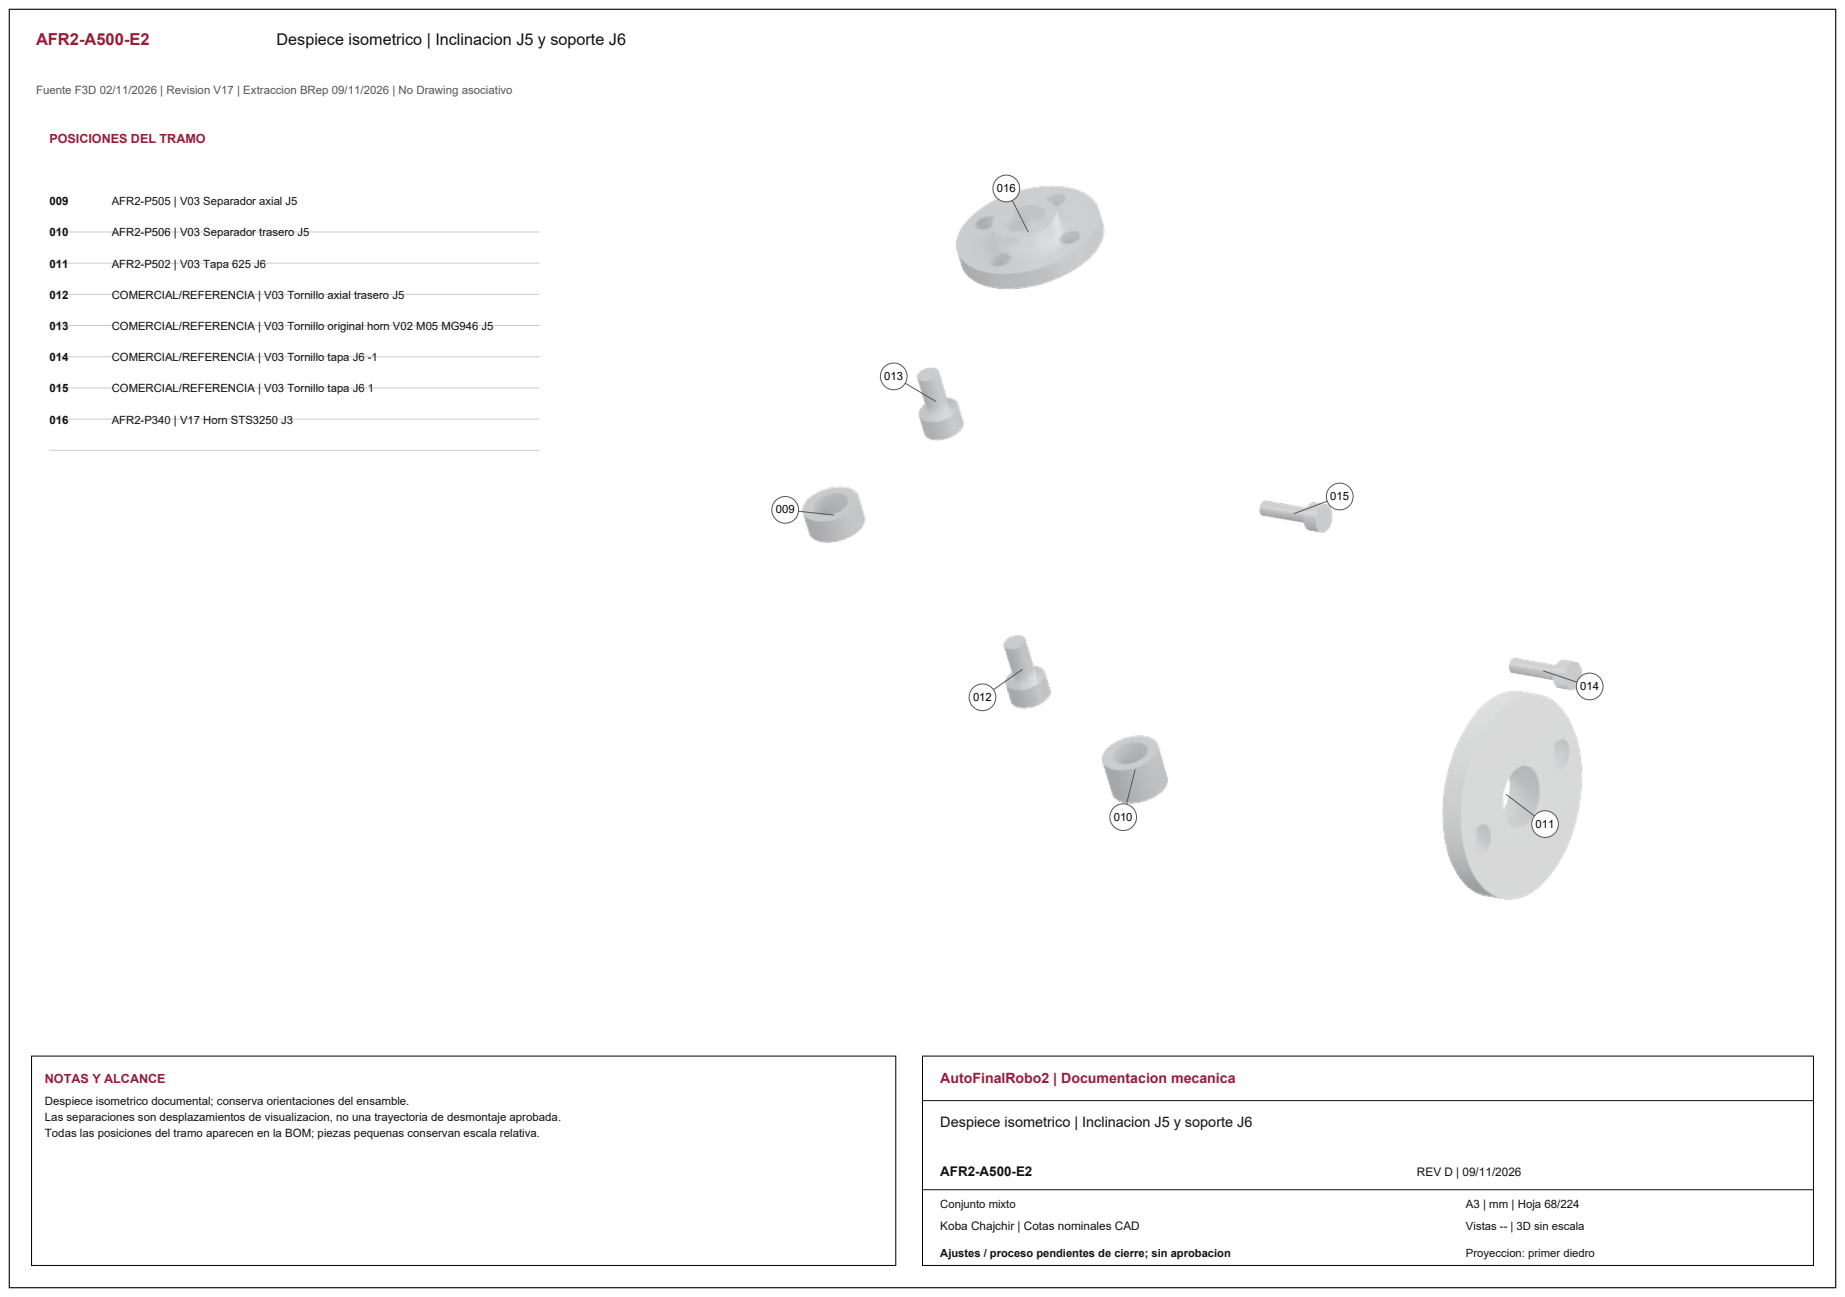
[picture p402: page 5]
009 AFR2-P505 | V03 Separador axial J5; 010 AFR2-P506 | V03 Separador trasero J5; 011 AFR2-P502 | V03 Tapa 625 J6; 016 AFR2-P340 | V17 Horn STS3250 J3; NOTAS Y ALCANCE; AutoFinalRobo2 | Documentacion mecanica; AFR2-A500-E2; REV D | 09/11/2026; Conjunto mixto

POSICIONES DEL TRAMO

012 COMERCIAL/REFERENCIA | V03 Tornillo axial trasero J5

013 COMERCIAL/REFERENCIA | V03 Tornillo original horn V02 M05 MG946 J5

014 COMERCIAL/REFERENCIA | V03 Tornillo tapa J6 -1

015 COMERCIAL/REFERENCIA | V03 Tornillo tapa J6 1

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

Despiece isometrico | Inclinacion J5 y soporte J6

Vistas -- | 3D sin escala

AFR2-A500-E3 | Despiece isometrico | Inclinacion J5 y soporte J6

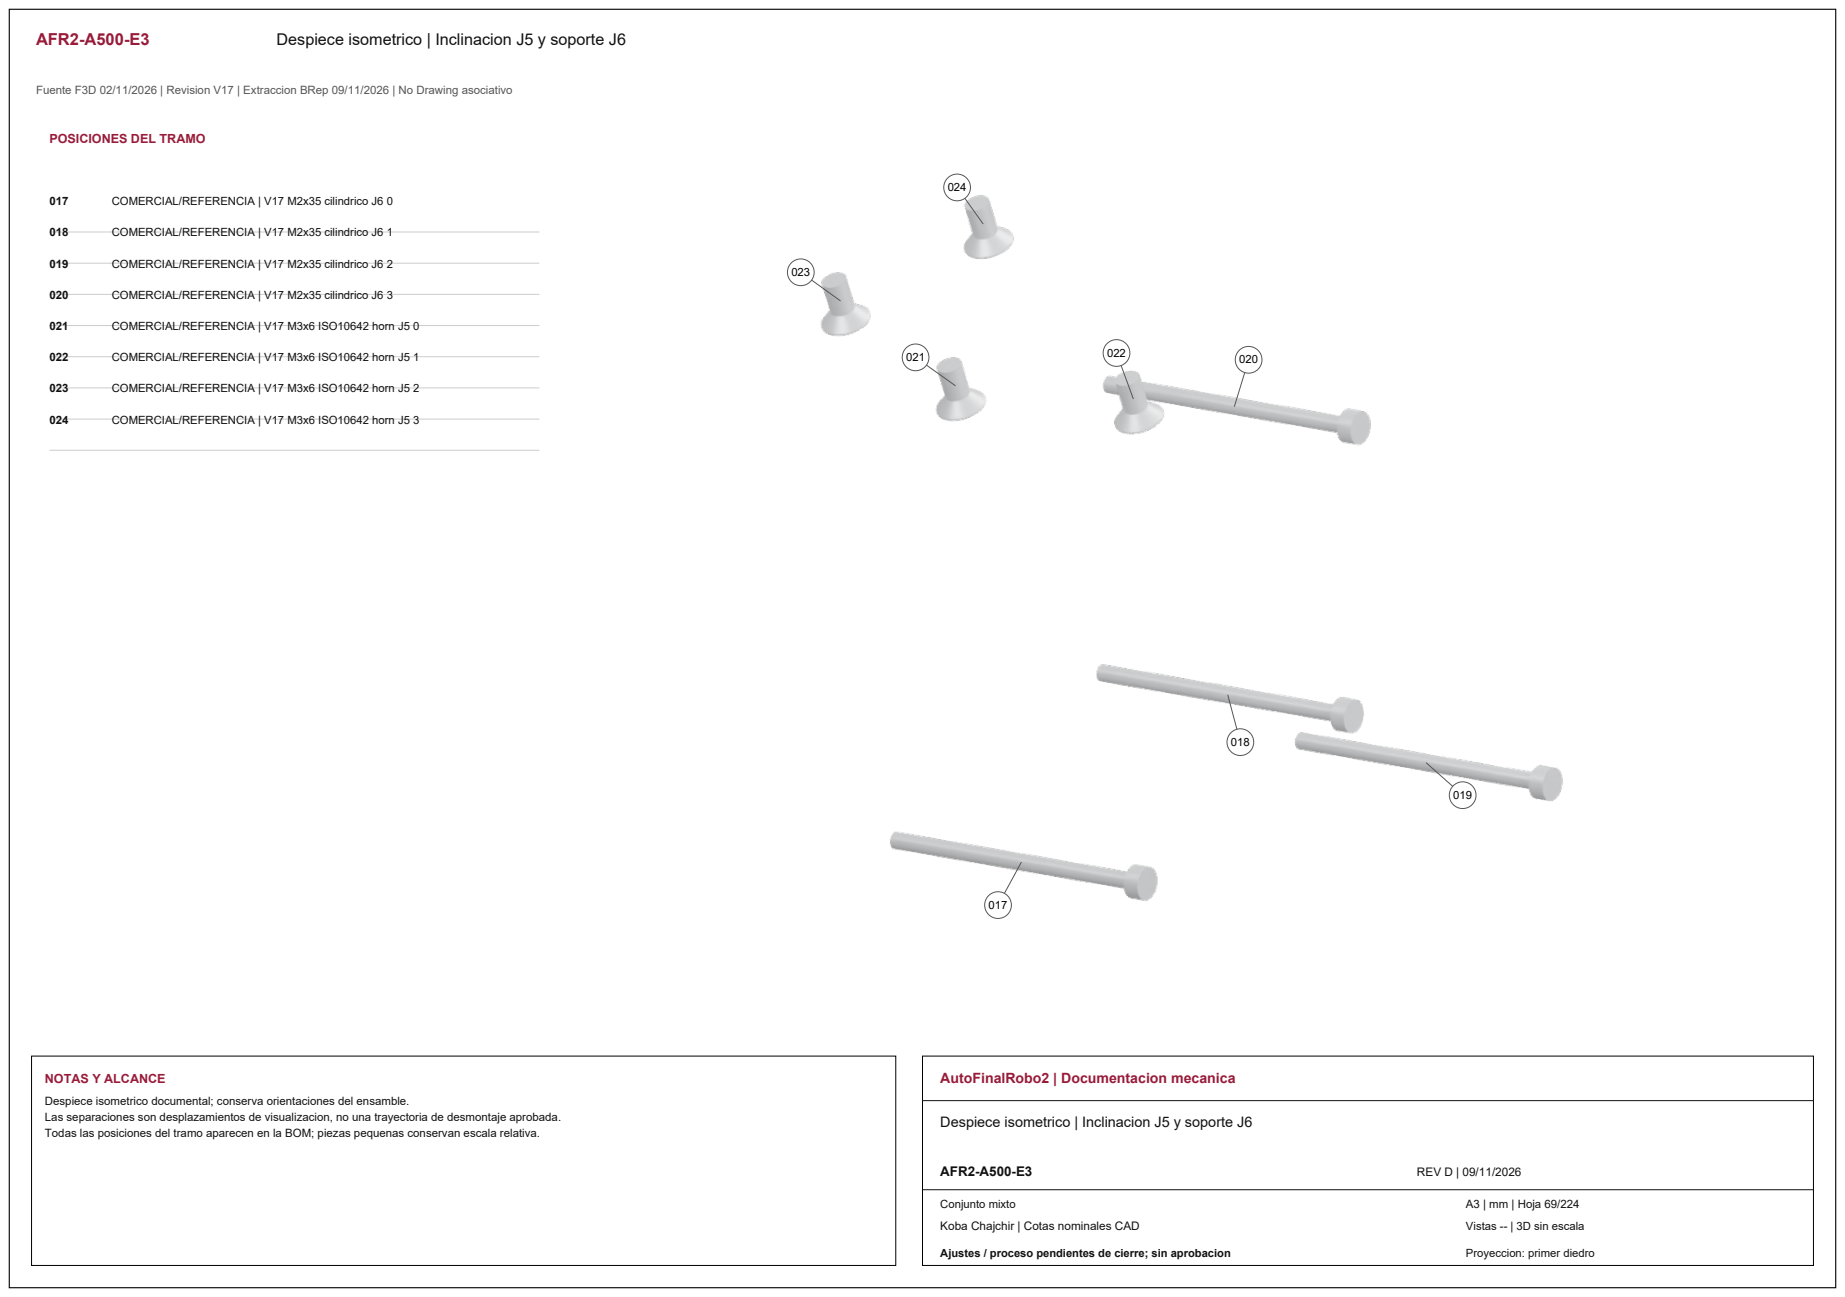
[picture p403: page 6]
NOTAS Y ALCANCE; AutoFinalRobo2 | Documentacion mecanica; AFR2-A500-E3; REV D | 09/11/2026; Conjunto mixto

POSICIONES DEL TRAMO

017 COMERCIAL/REFERENCIA | V17 M2x35 cilindrico J6 0

018 COMERCIAL/REFERENCIA | V17 M2x35 cilindrico J6 1

019 COMERCIAL/REFERENCIA | V17 M2x35 cilindrico J6 2

020 COMERCIAL/REFERENCIA | V17 M2x35 cilindrico J6 3

021 COMERCIAL/REFERENCIA | V17 M3x6 ISO10642 horn J5 0

022 COMERCIAL/REFERENCIA | V17 M3x6 ISO10642 horn J5 1

023 COMERCIAL/REFERENCIA | V17 M3x6 ISO10642 horn J5 2

024 COMERCIAL/REFERENCIA | V17 M3x6 ISO10642 horn J5 3

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

Despiece isometrico | Inclinacion J5 y soporte J6

Vistas -- | 3D sin escala

AFR2-A500-E4 | Despiece isometrico | Inclinacion J5 y soporte J6

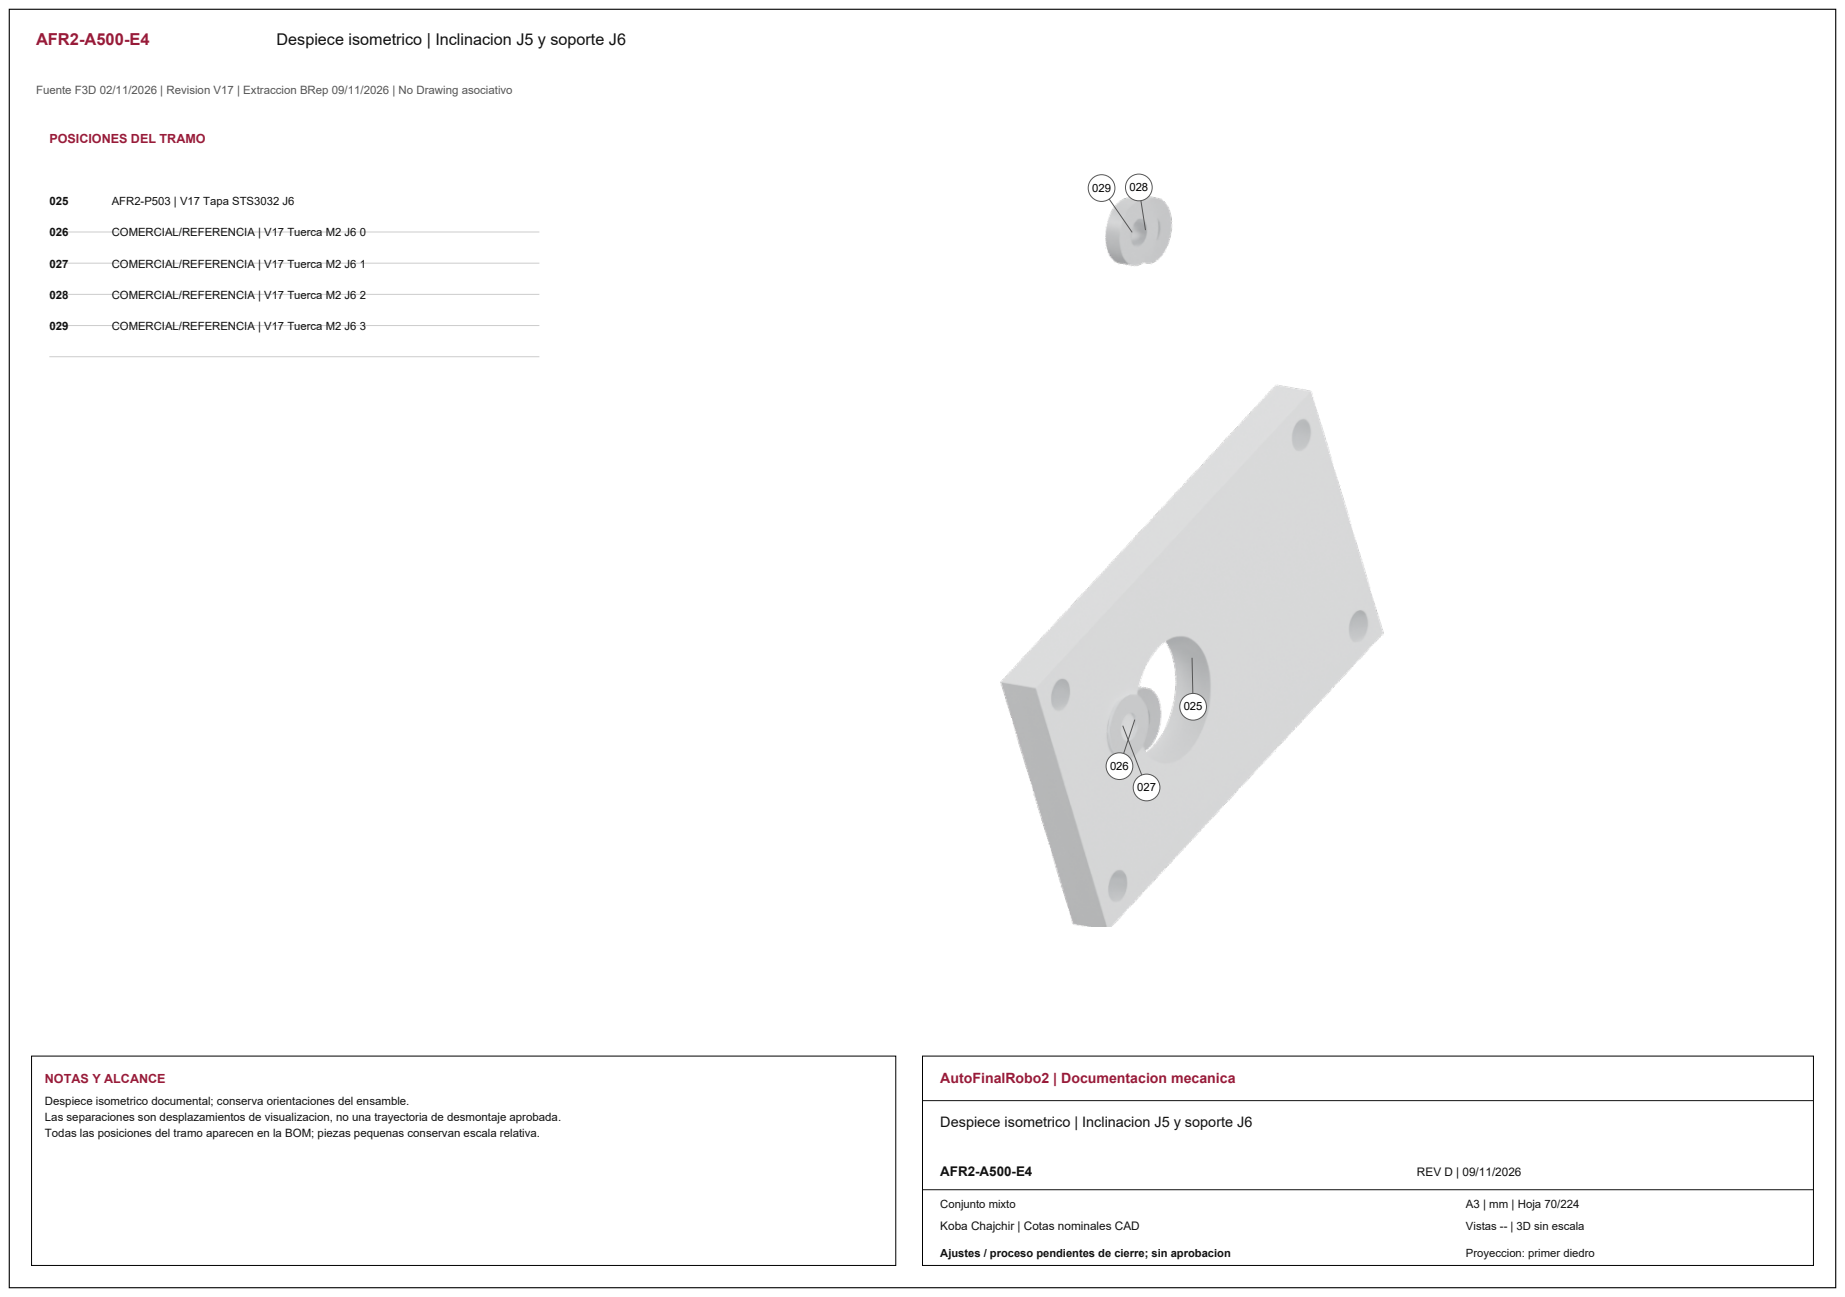
[picture p404: page 7]
025 AFR2-P503 | V17 Tapa STS3032 J6; NOTAS Y ALCANCE; AutoFinalRobo2 | Documentacion mecanica; AFR2-A500-E4; REV D | 09/11/2026; Conjunto mixto

POSICIONES DEL TRAMO

026 COMERCIAL/REFERENCIA | V17 Tuerca M2 J6 0

027 COMERCIAL/REFERENCIA | V17 Tuerca M2 J6 1

028 COMERCIAL/REFERENCIA | V17 Tuerca M2 J6 2

029 COMERCIAL/REFERENCIA | V17 Tuerca M2 J6 3

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

Despiece isometrico | Inclinacion J5 y soporte J6

Vistas -- | 3D sin escala

AFR2-P501 | Núcleo J5 y soporte J6

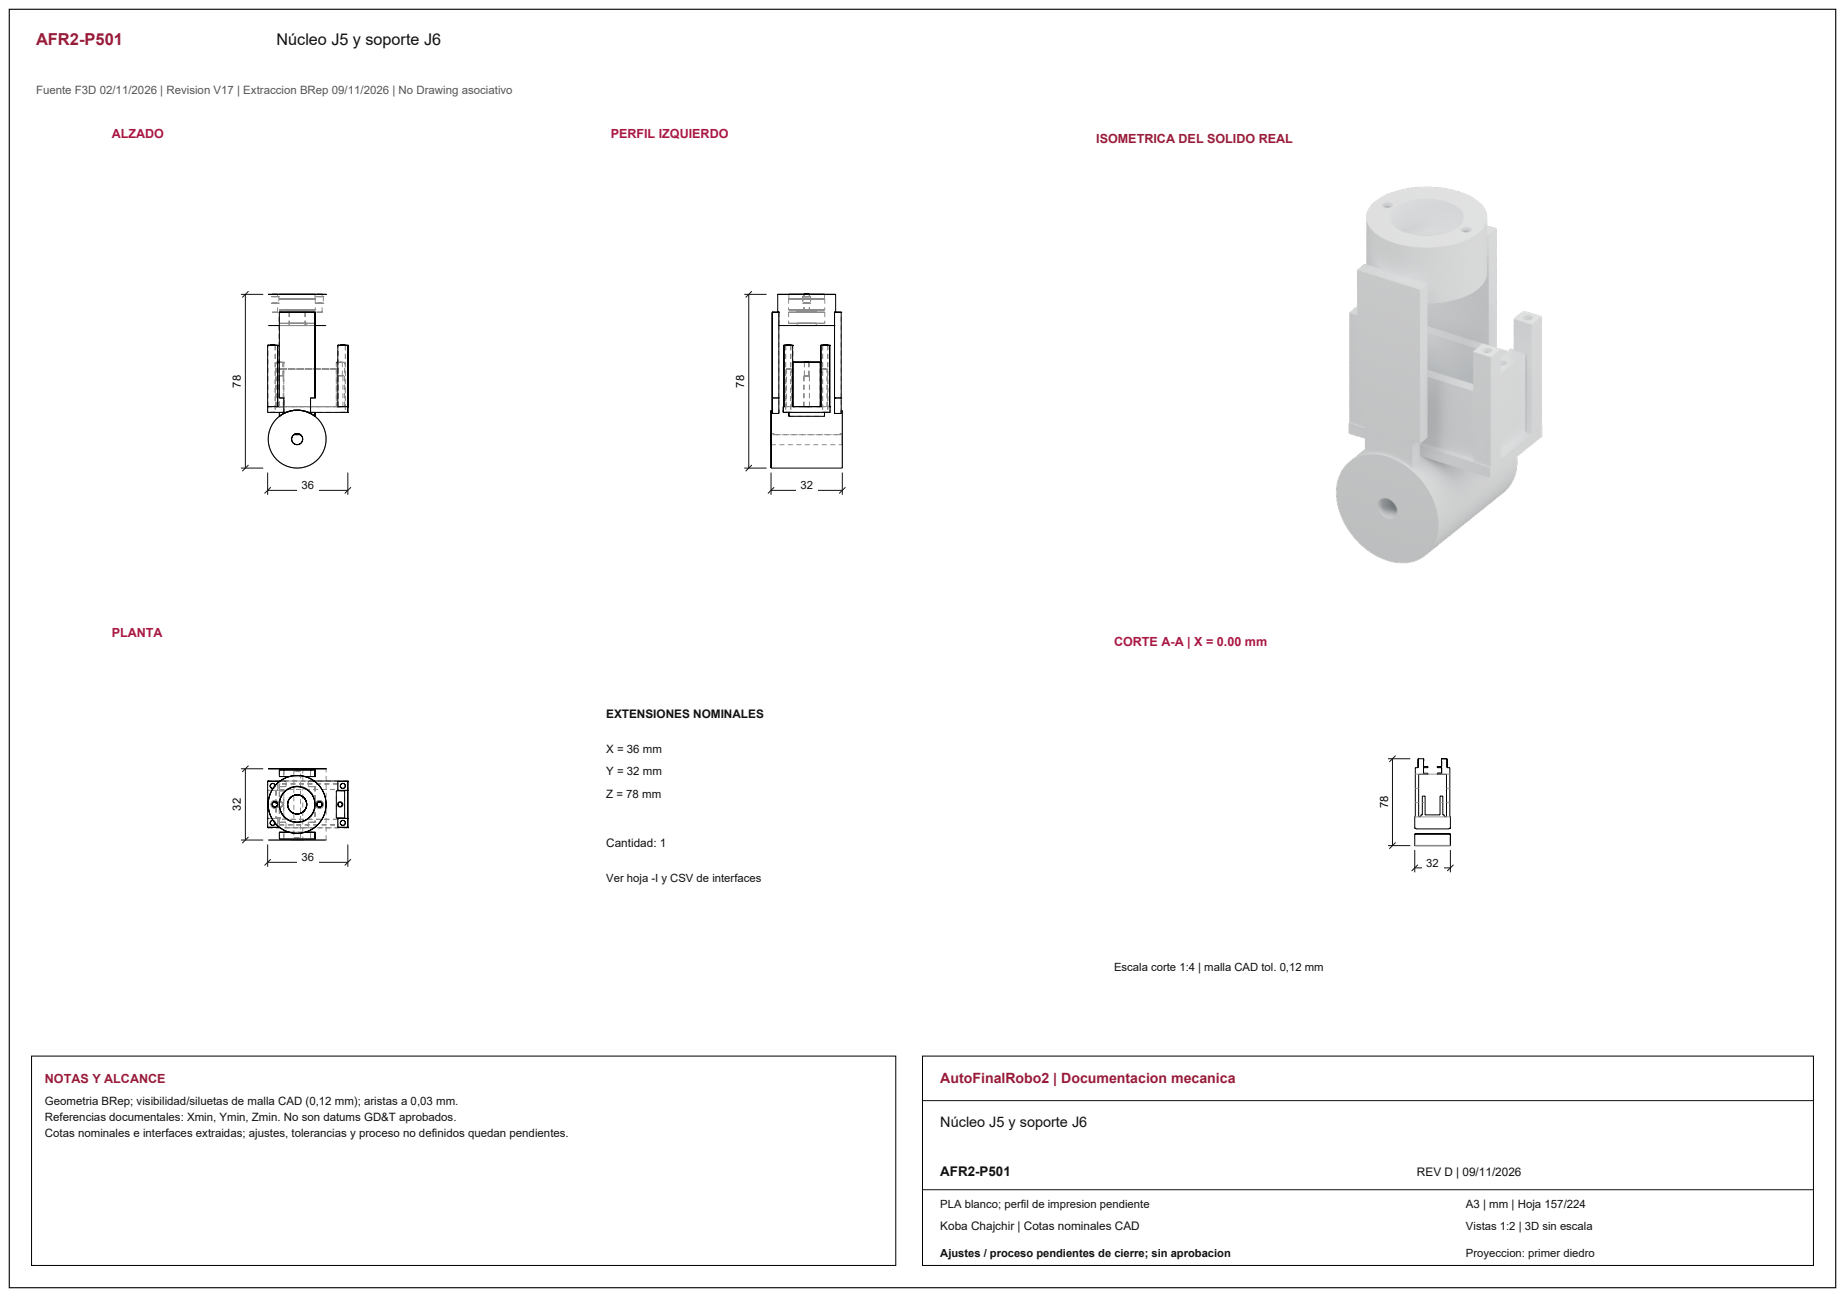
[picture p405: page 8]
ALZADO; PERFIL IZQUIERDO; PLANTA; CORTE A-A | X = 0.00 mm; EXTENSIONES NOMINALES; Cantidad: 1; NOTAS Y ALCANCE; AutoFinalRobo2 | Documentacion mecanica; Núcleo J5 y soporte J6; AFR2-P501; REV D | 09/11/2026

ISOMETRICA DEL SOLIDO REAL

Ver hoja -I y CSV de interfaces

Escala corte 1:4 | malla CAD tol. 0,12 mm

Geometria BRep; visibilidad/siluetas de malla CAD (0,12 mm); aristas a 0,03 mm.
Referencias documentales: Xmin, Ymin, Zmin. No son datums GD&T aprobados.
Cotas nominales e interfaces extraidas; ajustes, tolerancias y proceso no definidos quedan pendientes.

PLA blanco; perfil de impresion pendiente

Vistas 1:2 | 3D sin escala

AFR2-P501-I01 | Interfaces y corte | Núcleo J5 y soporte J6

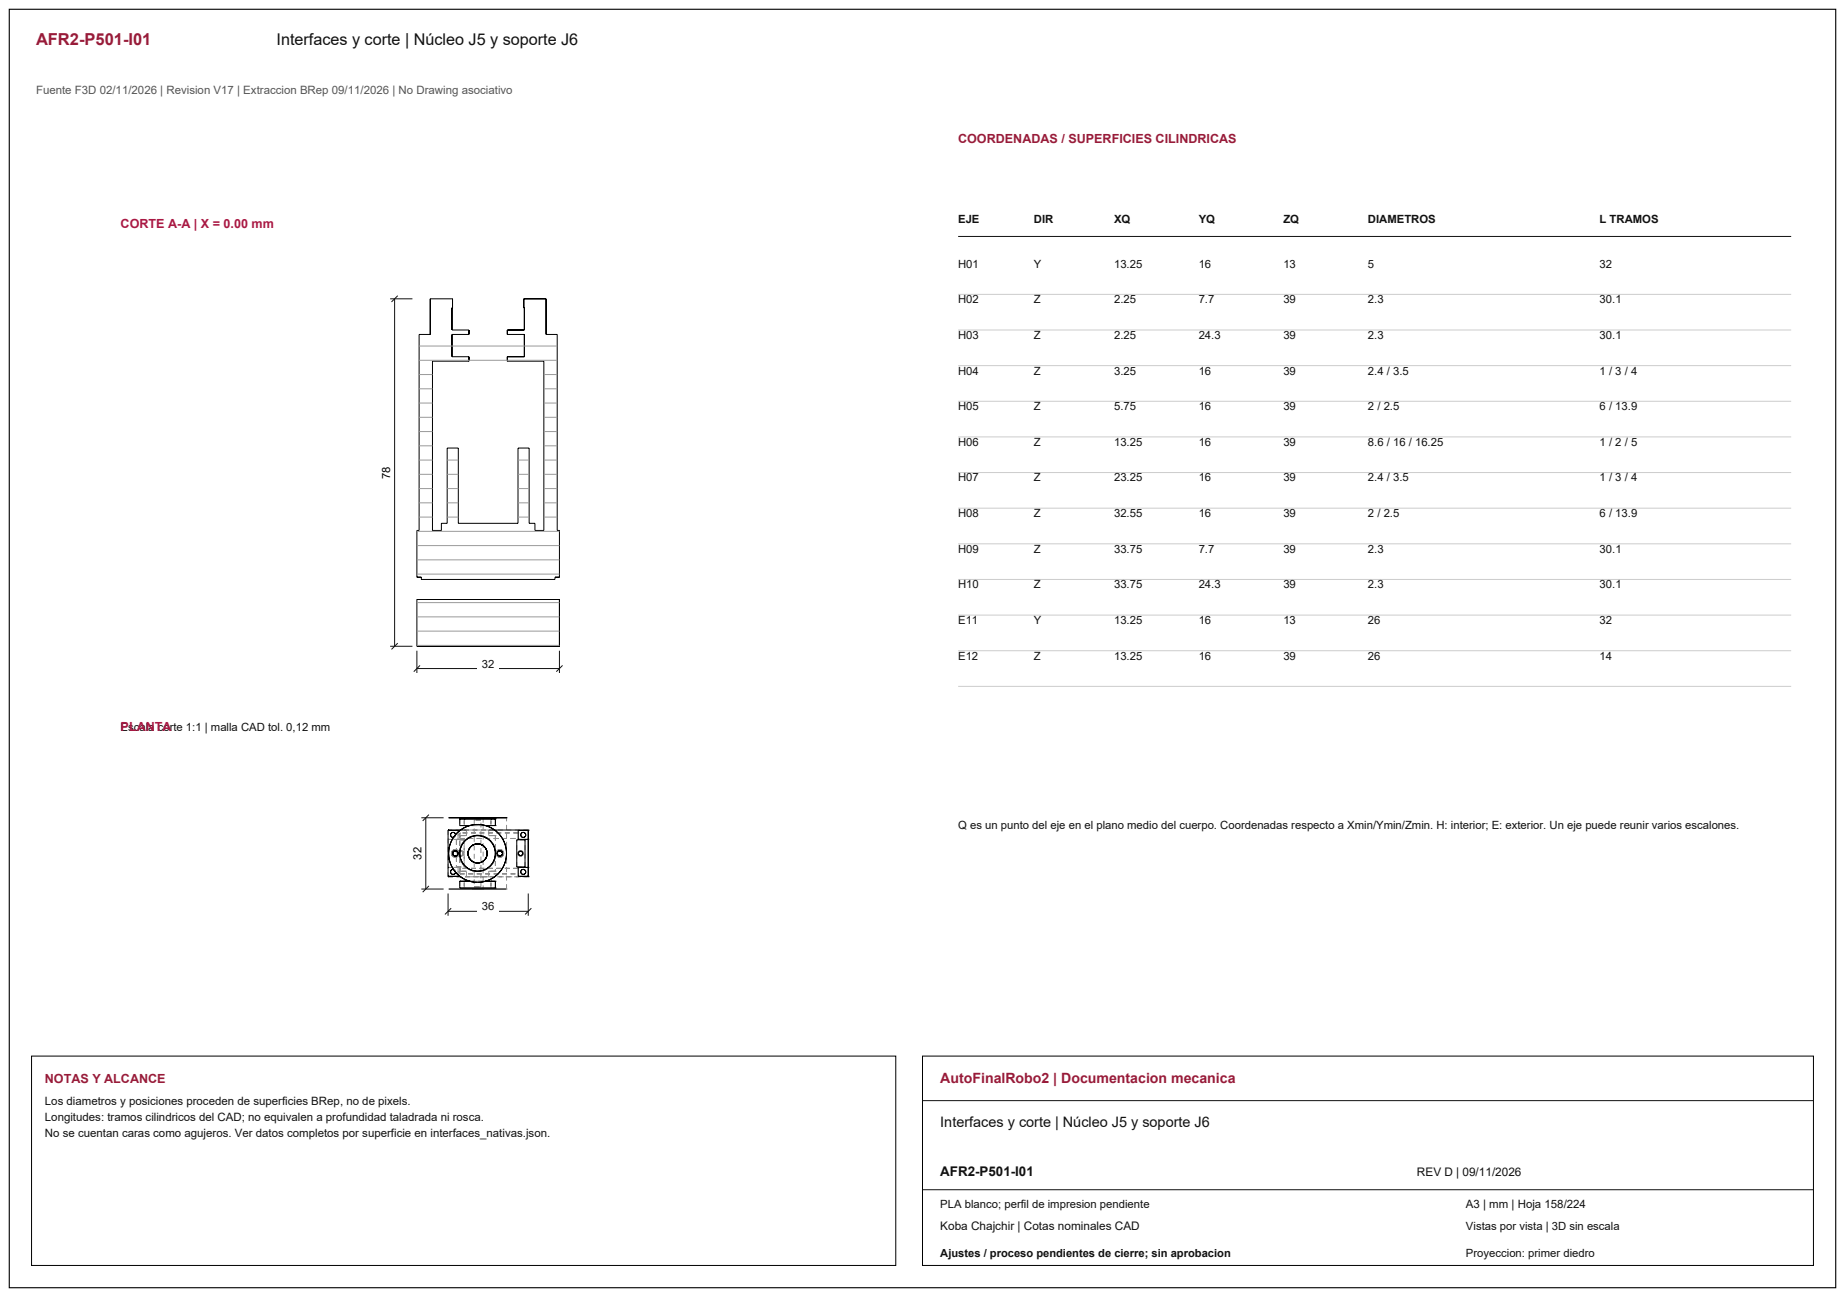
[picture p406: page 9]
CORTE A-A | X = 0.00 mm; EJE; DIR; DIAMETROS; L TRAMOS; NOTAS Y ALCANCE; AutoFinalRobo2 | Documentacion mecanica; AFR2-P501-I01; REV D | 09/11/2026

COORDENADAS / SUPERFICIES CILINDRICAS

Escala corte 1:1 | malla CAD tol. 0,12 mm PLANTA

Q es un punto del eje en el plano medio del cuerpo. Coordenadas respecto a Xmin/Ymin/Zmin. H: interior; E: exterior. Un eje puede reunir varios escalones.

Los diametros y posiciones proceden de superficies BRep, no de pixels.
Longitudes: tramos cilindricos del CAD; no equivalen a profundidad taladrada ni rosca.
No se cuentan caras como agujeros. Ver datos completos por superficie en interfaces_nativas.json.

Interfaces y corte | Núcleo J5 y soporte J6

PLA blanco; perfil de impresion pendiente

Vistas por vista | 3D sin escala

AFR2-P504 | Eje y brida de J5

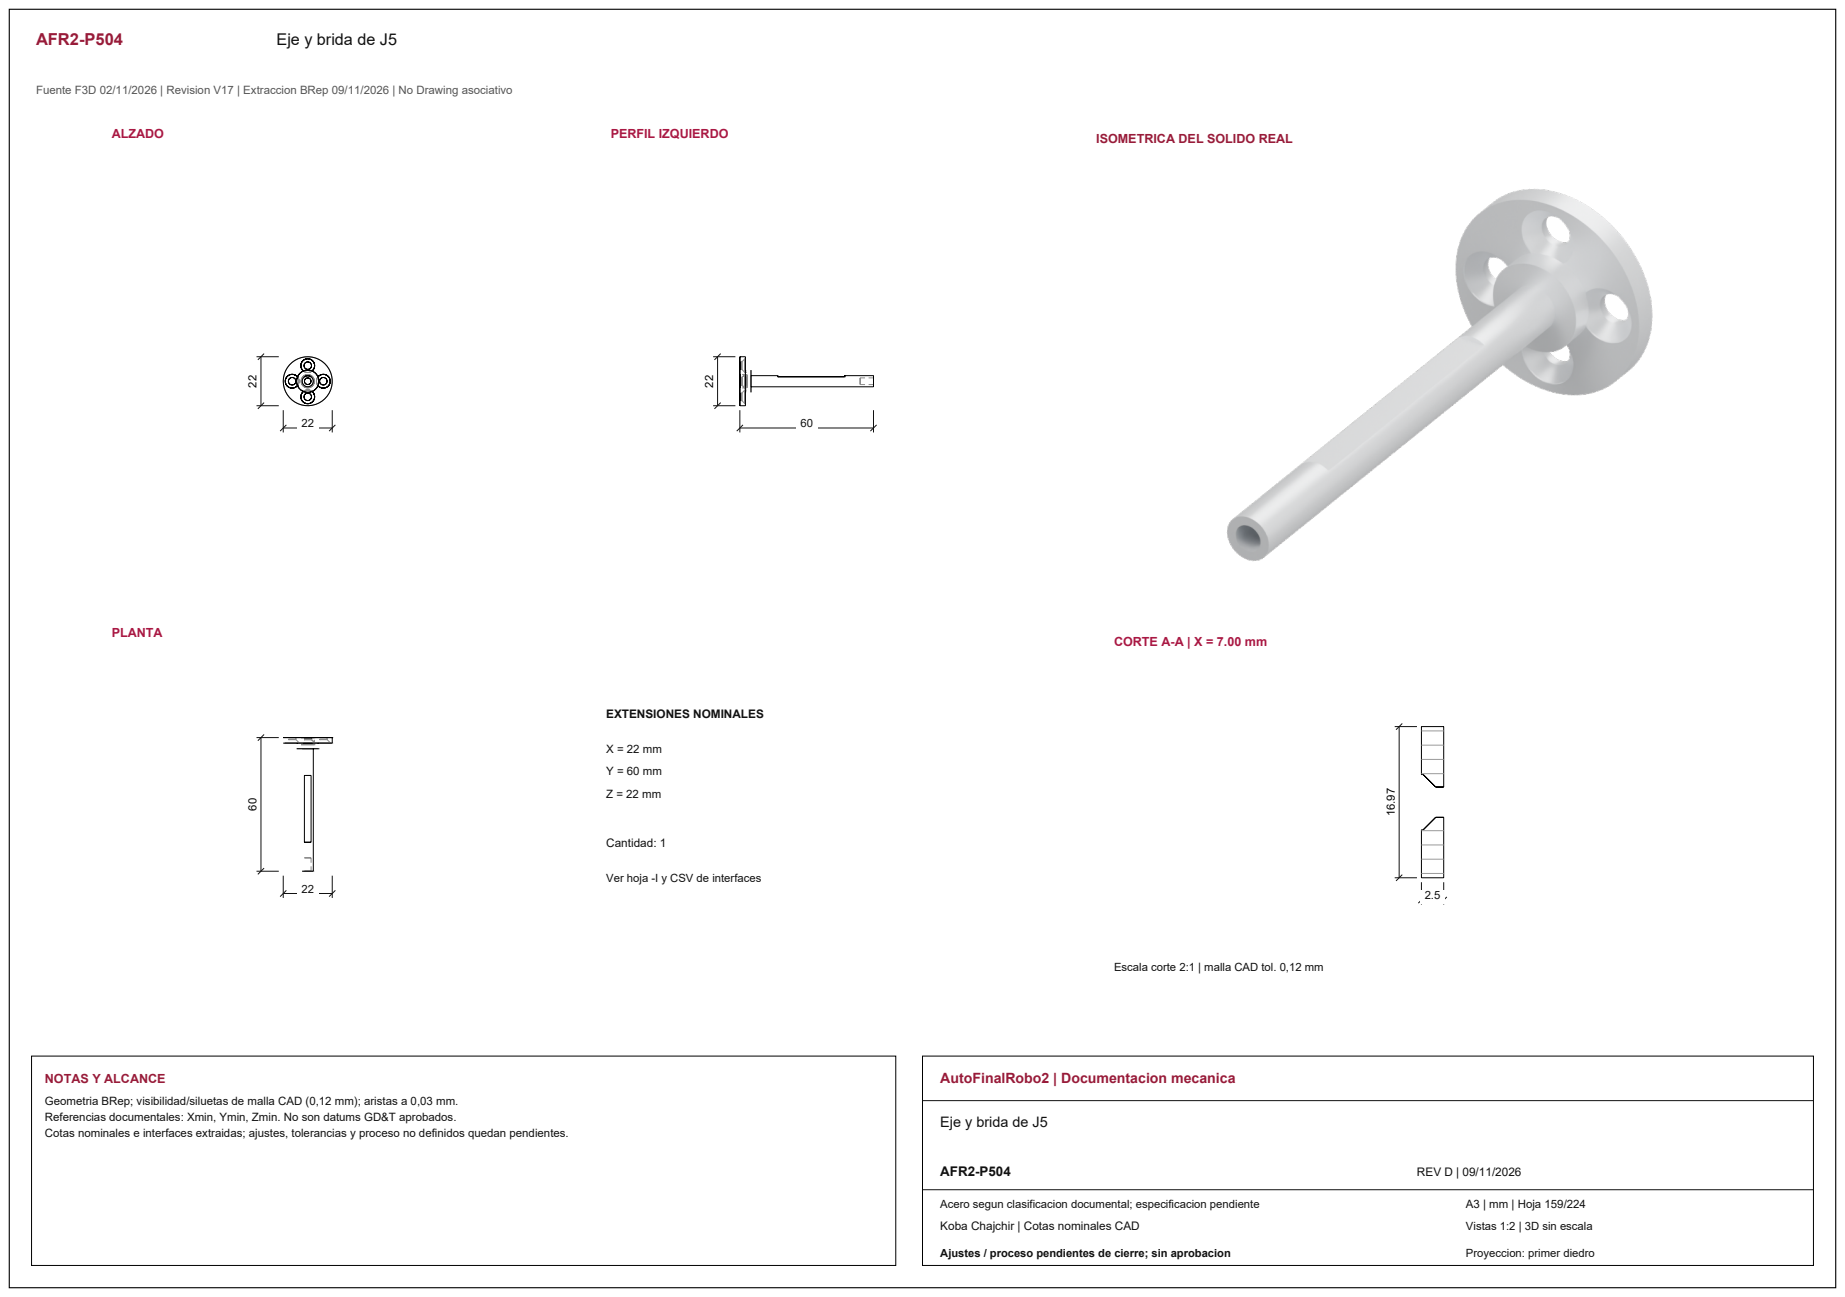
[picture p407: page 10]
ALZADO; PERFIL IZQUIERDO; PLANTA; CORTE A-A | X = 7.00 mm; EXTENSIONES NOMINALES; Cantidad: 1; NOTAS Y ALCANCE; AutoFinalRobo2 | Documentacion mecanica; AFR2-P504; REV D | 09/11/2026

ISOMETRICA DEL SOLIDO REAL

Ver hoja -I y CSV de interfaces

Escala corte 2:1 | malla CAD tol. 0,12 mm

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

Eje y brida de J5

Acero segun clasificacion documental; especificacion pendiente

Vistas 1:2 | 3D sin escala

AFR2-P504-I01 | Interfaces y corte | Eje y brida de J5

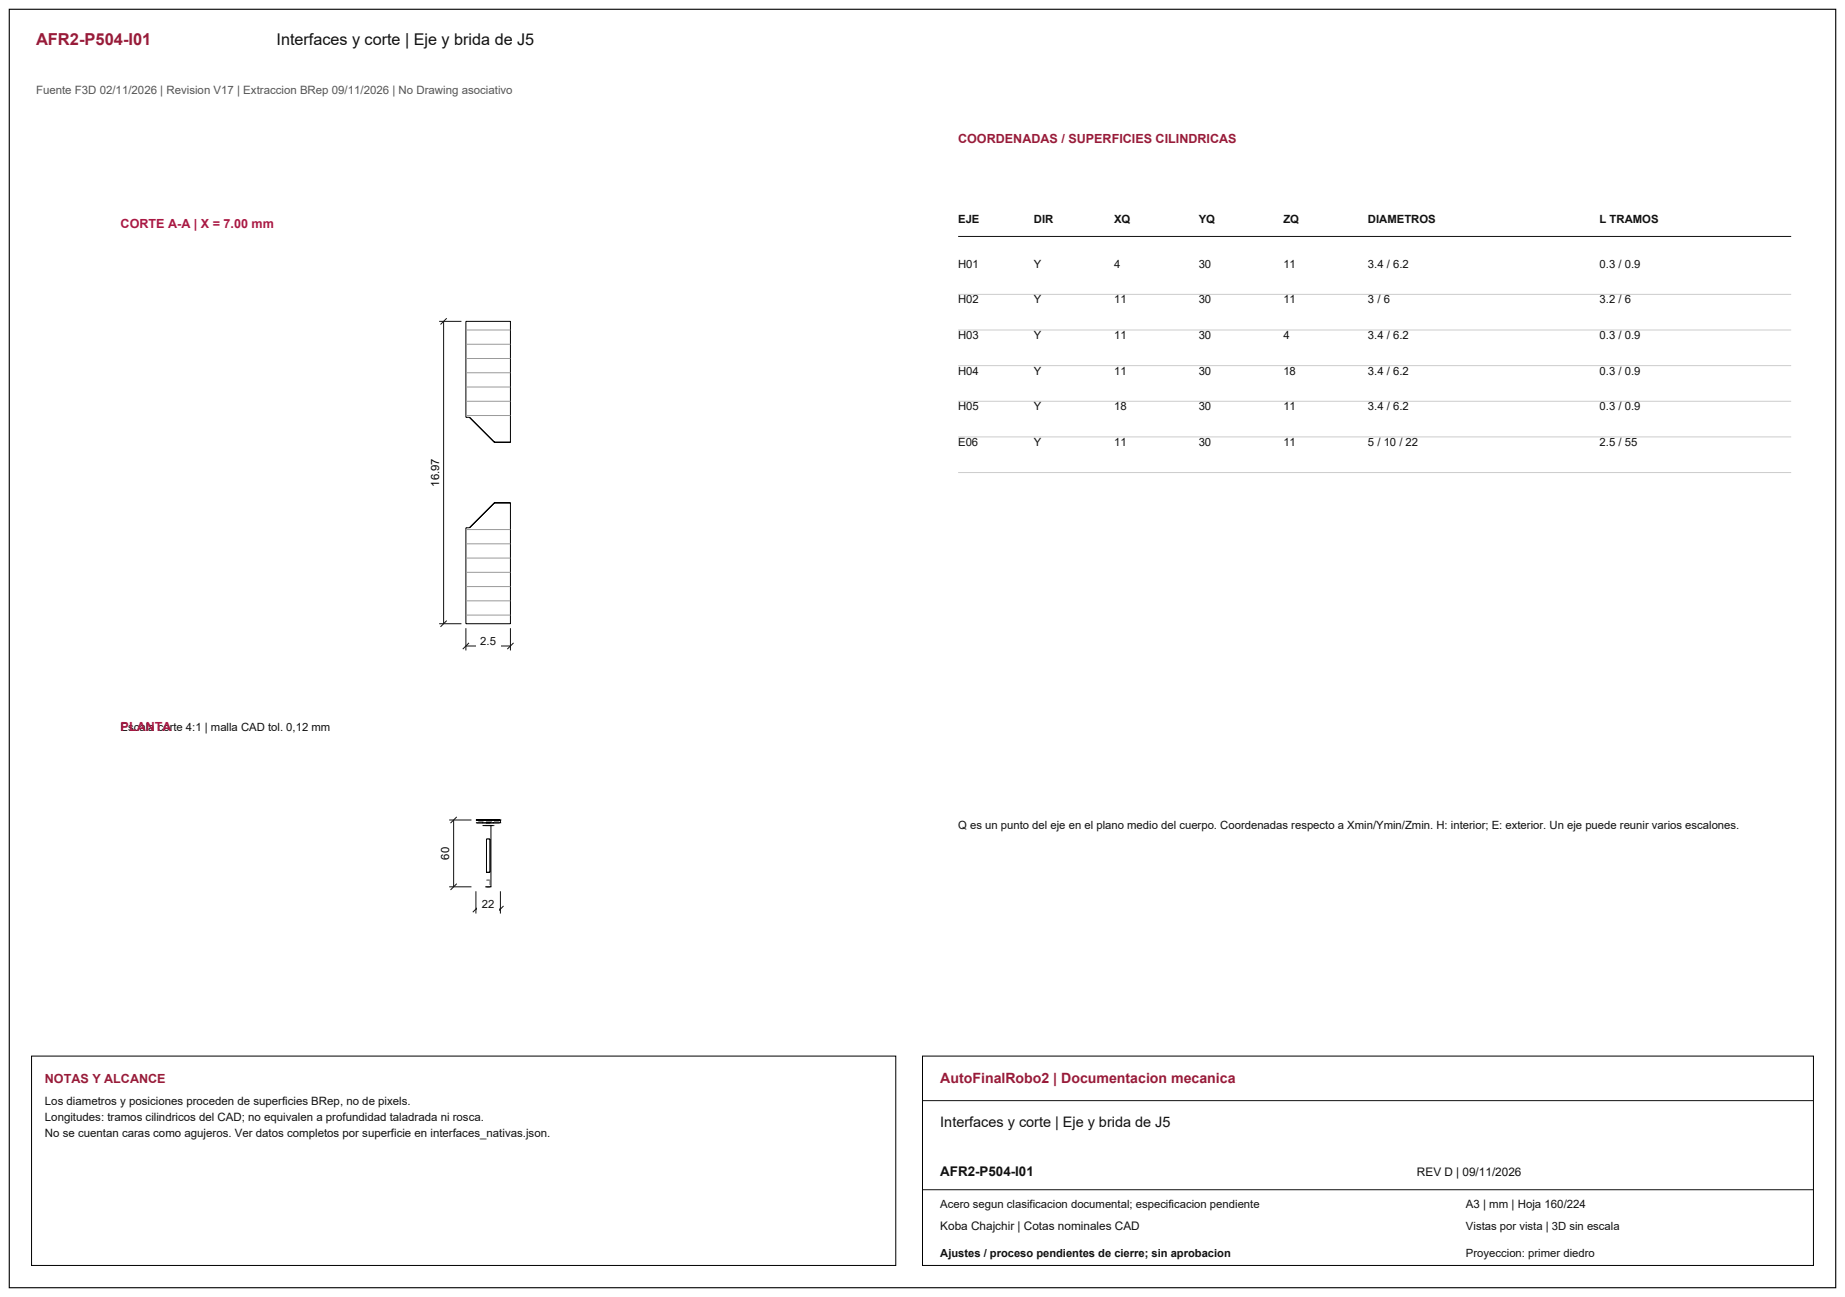
[picture p408: page 11]
CORTE A-A | X = 7.00 mm; EJE; DIR; DIAMETROS; L TRAMOS; NOTAS Y ALCANCE; AutoFinalRobo2 | Documentacion mecanica; AFR2-P504-I01; REV D | 09/11/2026

COORDENADAS / SUPERFICIES CILINDRICAS

Escala corte 4:1 | malla CAD tol. 0,12 mm PLANTA

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

Interfaces y corte | Eje y brida de J5

Acero segun clasificacion documental; especificacion pendiente

Vistas por vista | 3D sin escala

AFR2-P502 | Tapa de retención 625 de J6

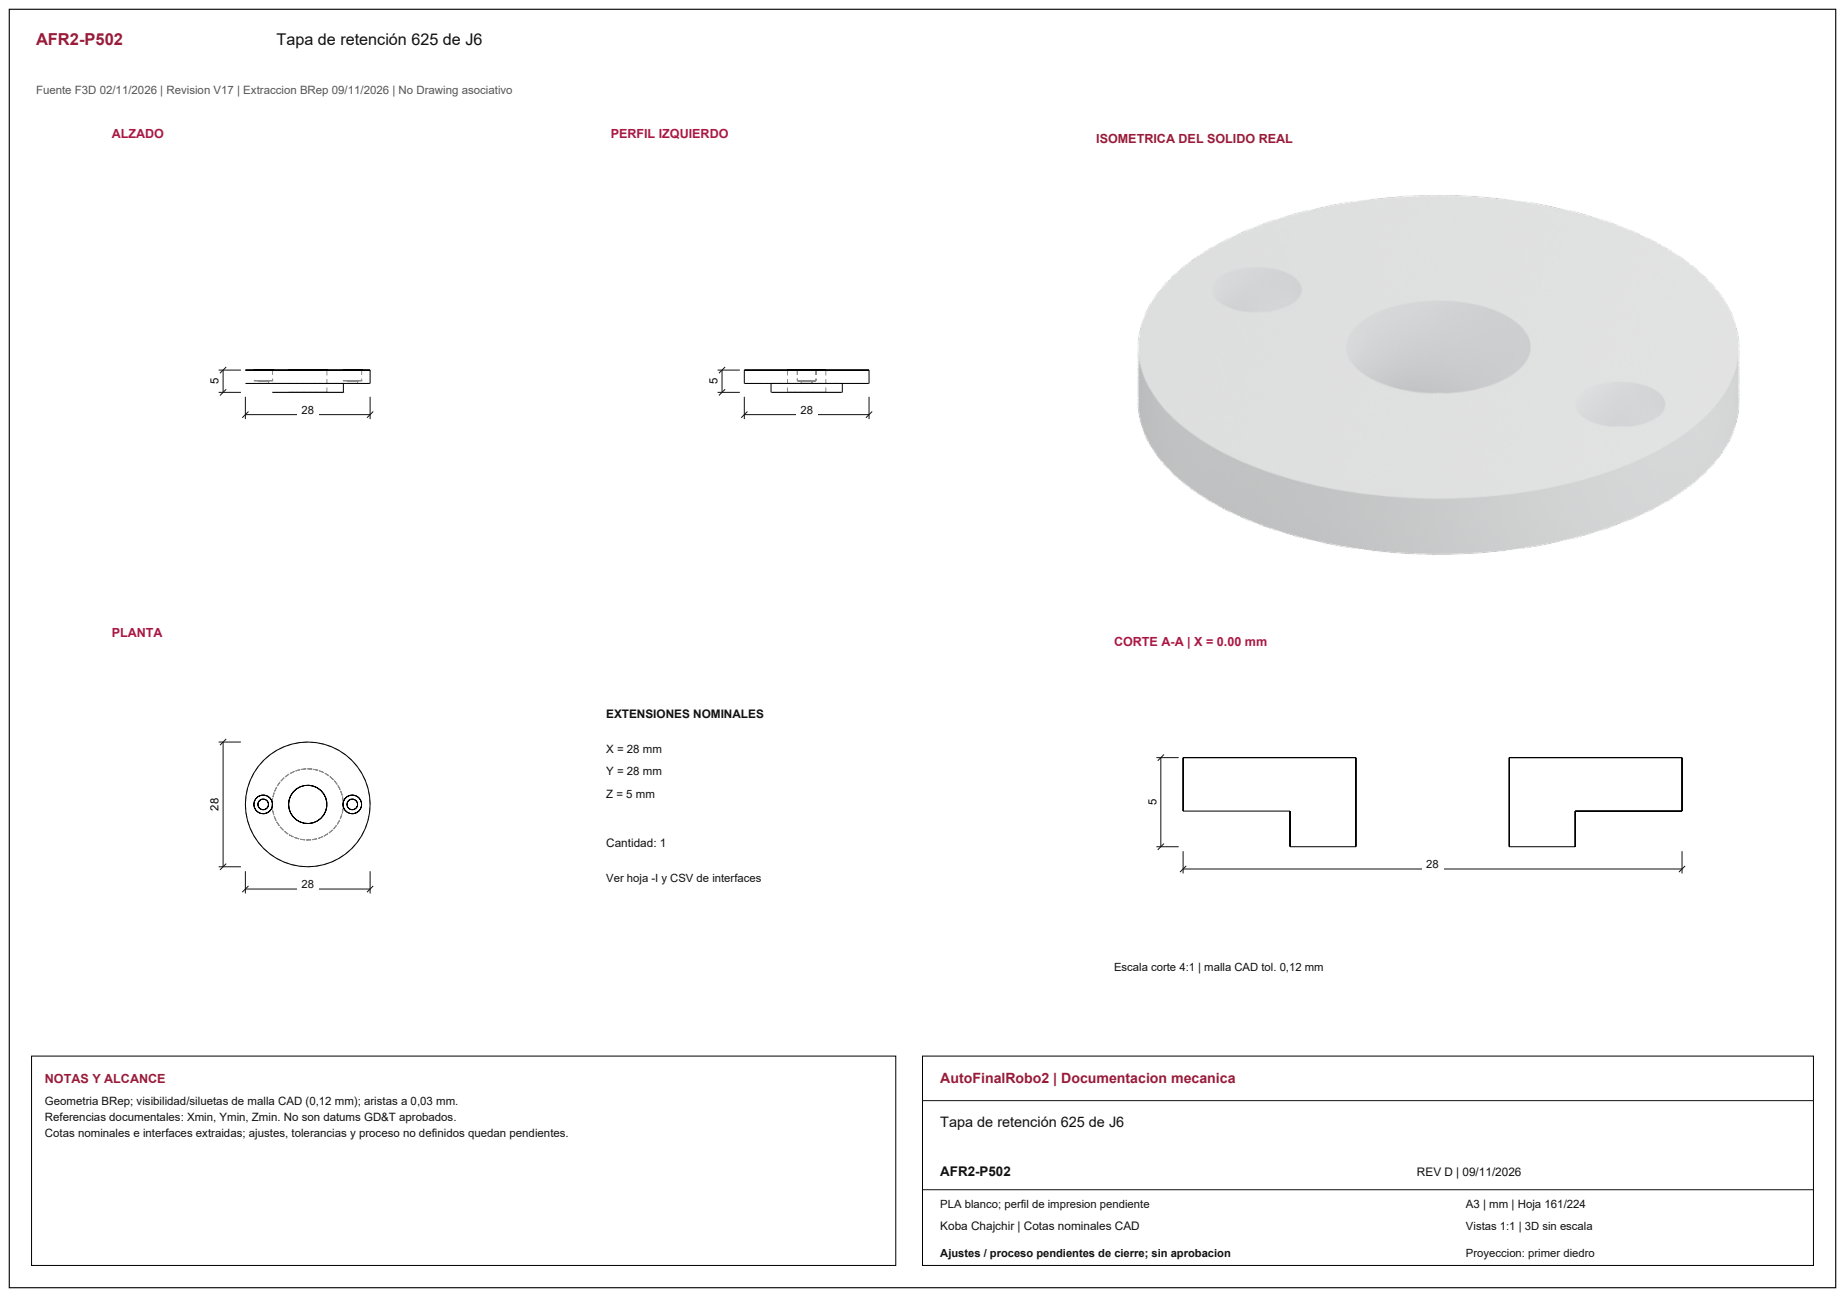
[picture p409: page 12]
ALZADO; PERFIL IZQUIERDO; PLANTA; CORTE A-A | X = 0.00 mm; EXTENSIONES NOMINALES; Cantidad: 1; NOTAS Y ALCANCE; AutoFinalRobo2 | Documentacion mecanica; AFR2-P502; REV D | 09/11/2026

ISOMETRICA DEL SOLIDO REAL

Ver hoja -I y CSV de interfaces

Escala corte 4:1 | malla CAD tol. 0,12 mm

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

Tapa de retención 625 de J6

PLA blanco; perfil de impresion pendiente

Vistas 1:1 | 3D sin escala

AFR2-P502-I01 | Interfaces y corte | Tapa de retención 625 de J6

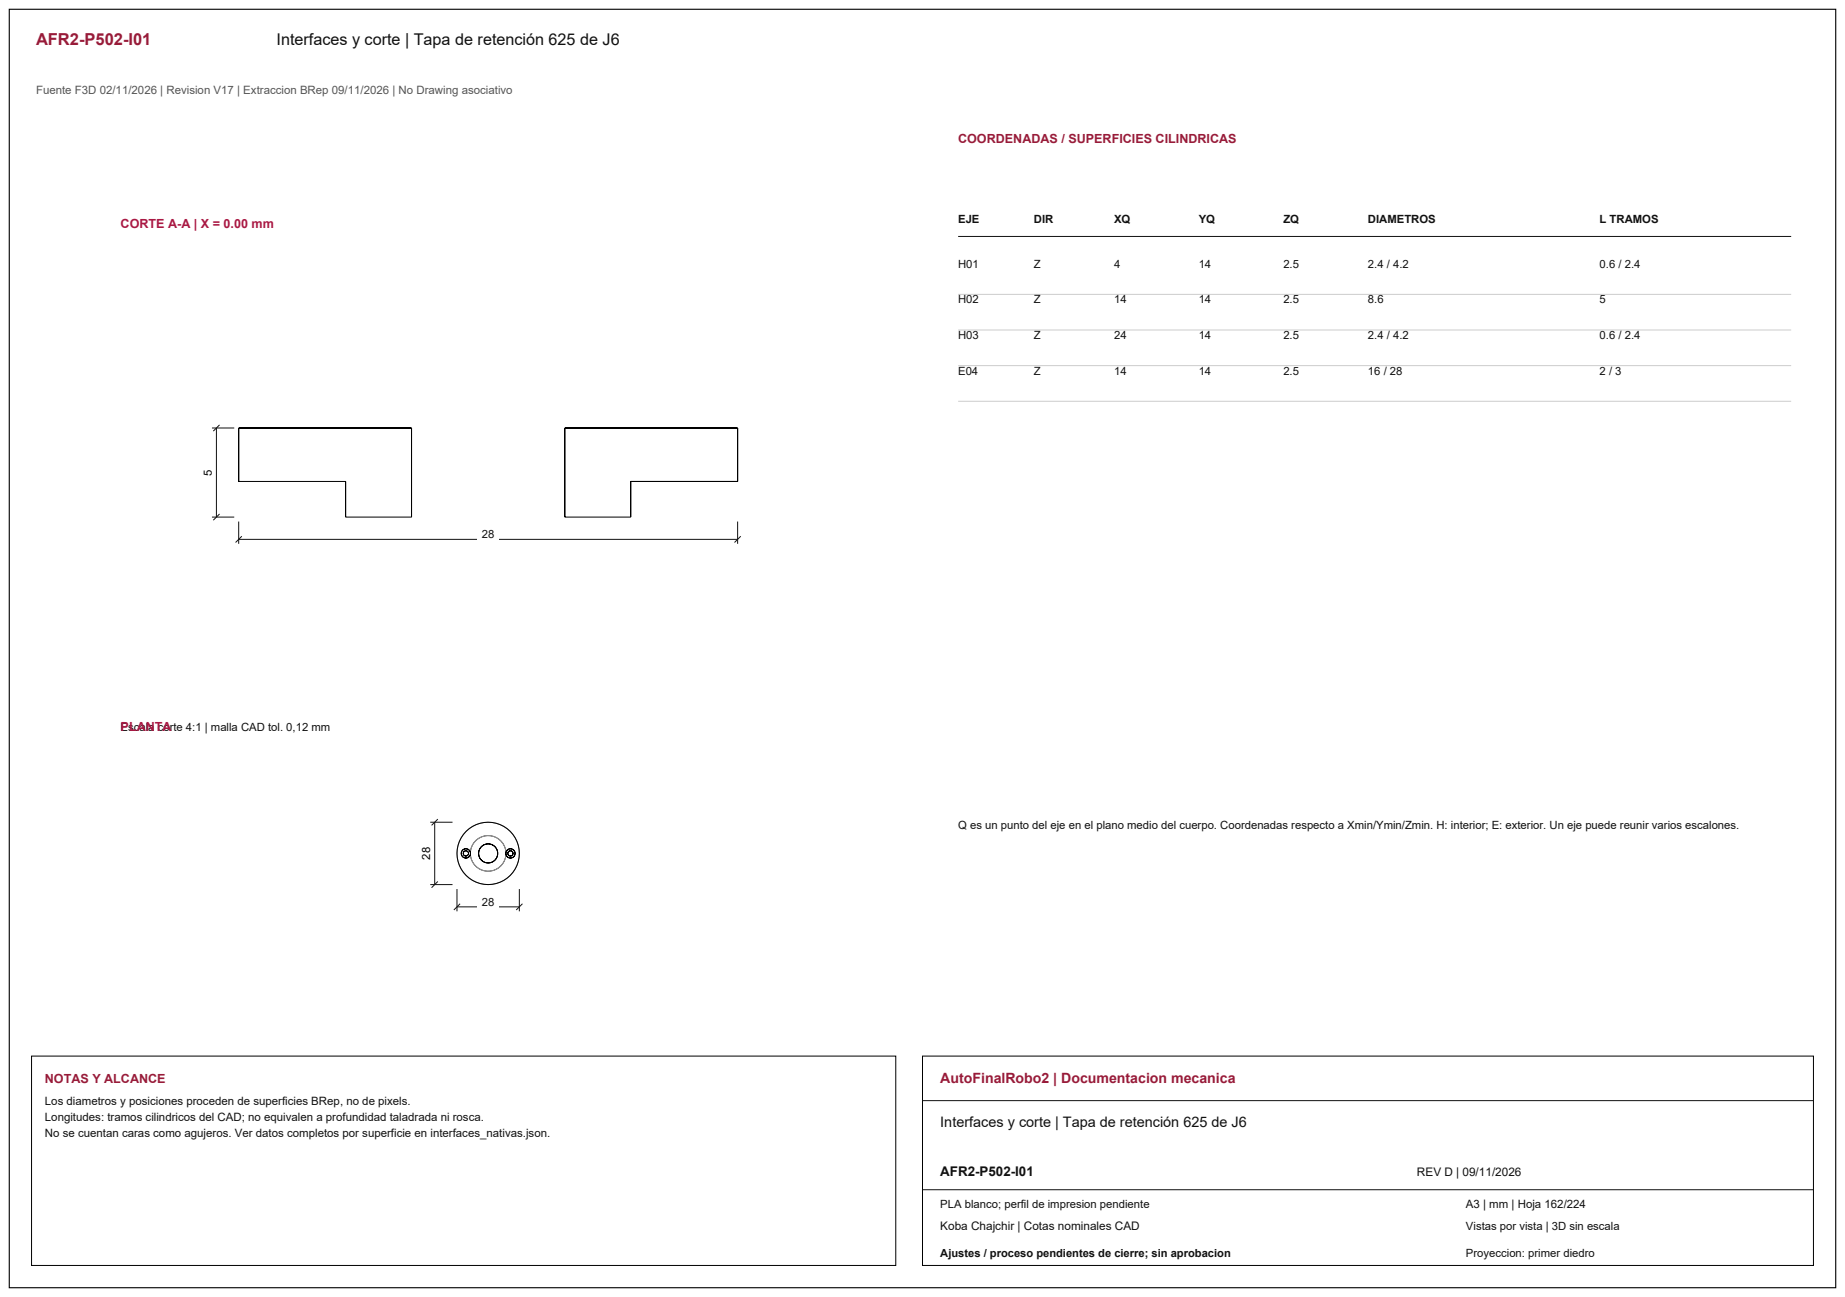
[picture p410: page 13]
CORTE A-A | X = 0.00 mm; EJE; DIR; DIAMETROS; L TRAMOS; NOTAS Y ALCANCE; AutoFinalRobo2 | Documentacion mecanica; AFR2-P502-I01; REV D | 09/11/2026

COORDENADAS / SUPERFICIES CILINDRICAS

Escala corte 4:1 | malla CAD tol. 0,12 mm PLANTA

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

Interfaces y corte | Tapa de retención 625 de J6

PLA blanco; perfil de impresion pendiente

Vistas por vista | 3D sin escala

AFR2-P505 | Separador axial de J5

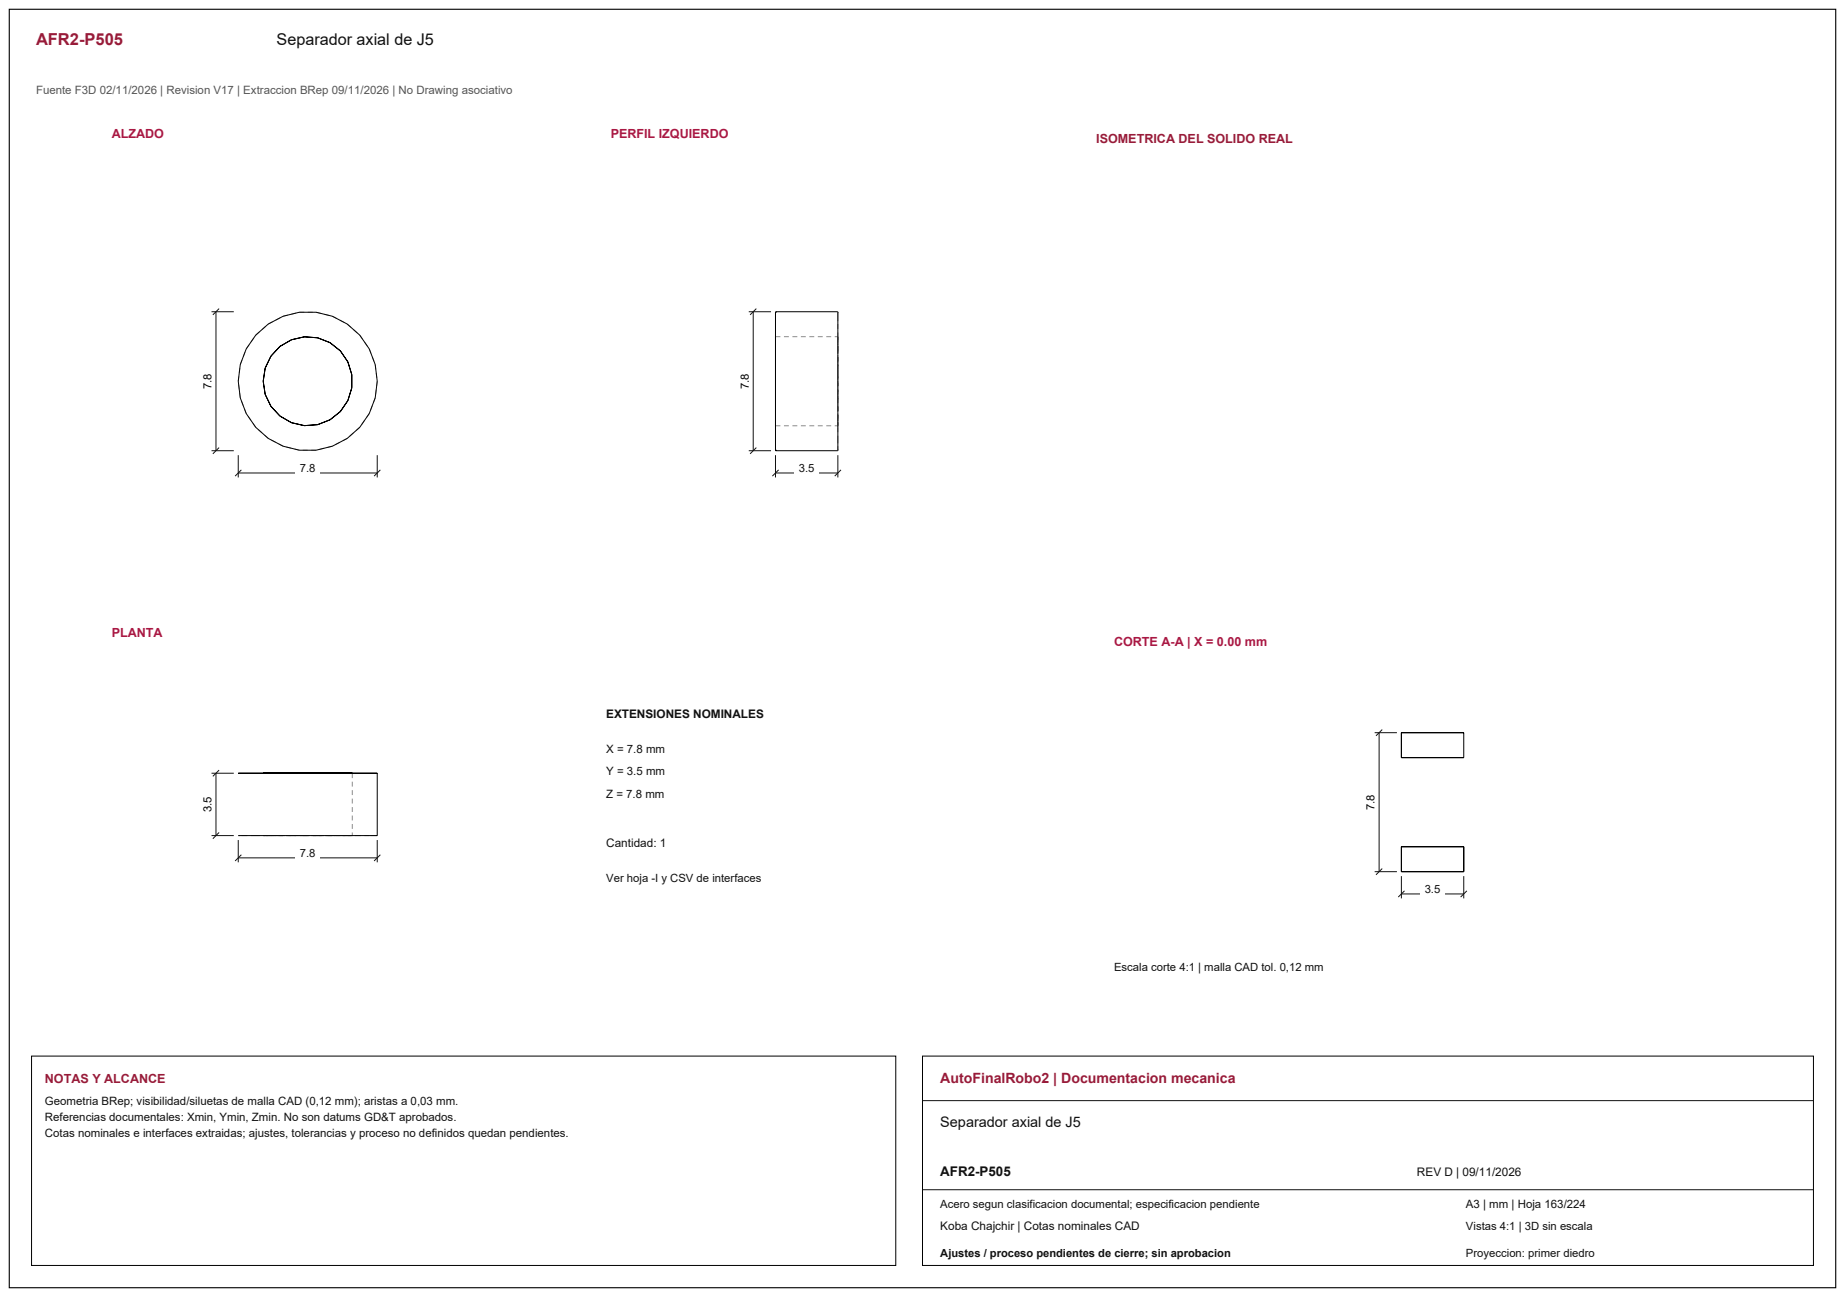
[picture p411: page 14]
ALZADO; PERFIL IZQUIERDO; PLANTA; CORTE A-A | X = 0.00 mm; EXTENSIONES NOMINALES; Cantidad: 1; NOTAS Y ALCANCE; AutoFinalRobo2 | Documentacion mecanica; AFR2-P505; REV D | 09/11/2026

ISOMETRICA DEL SOLIDO REAL

Ver hoja -I y CSV de interfaces

Escala corte 4:1 | malla CAD tol. 0,12 mm

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

Separador axial de J5

Acero segun clasificacion documental; especificacion pendiente

Vistas 4:1 | 3D sin escala

AFR2-P505-I01 | Interfaces y corte | Separador axial de J5

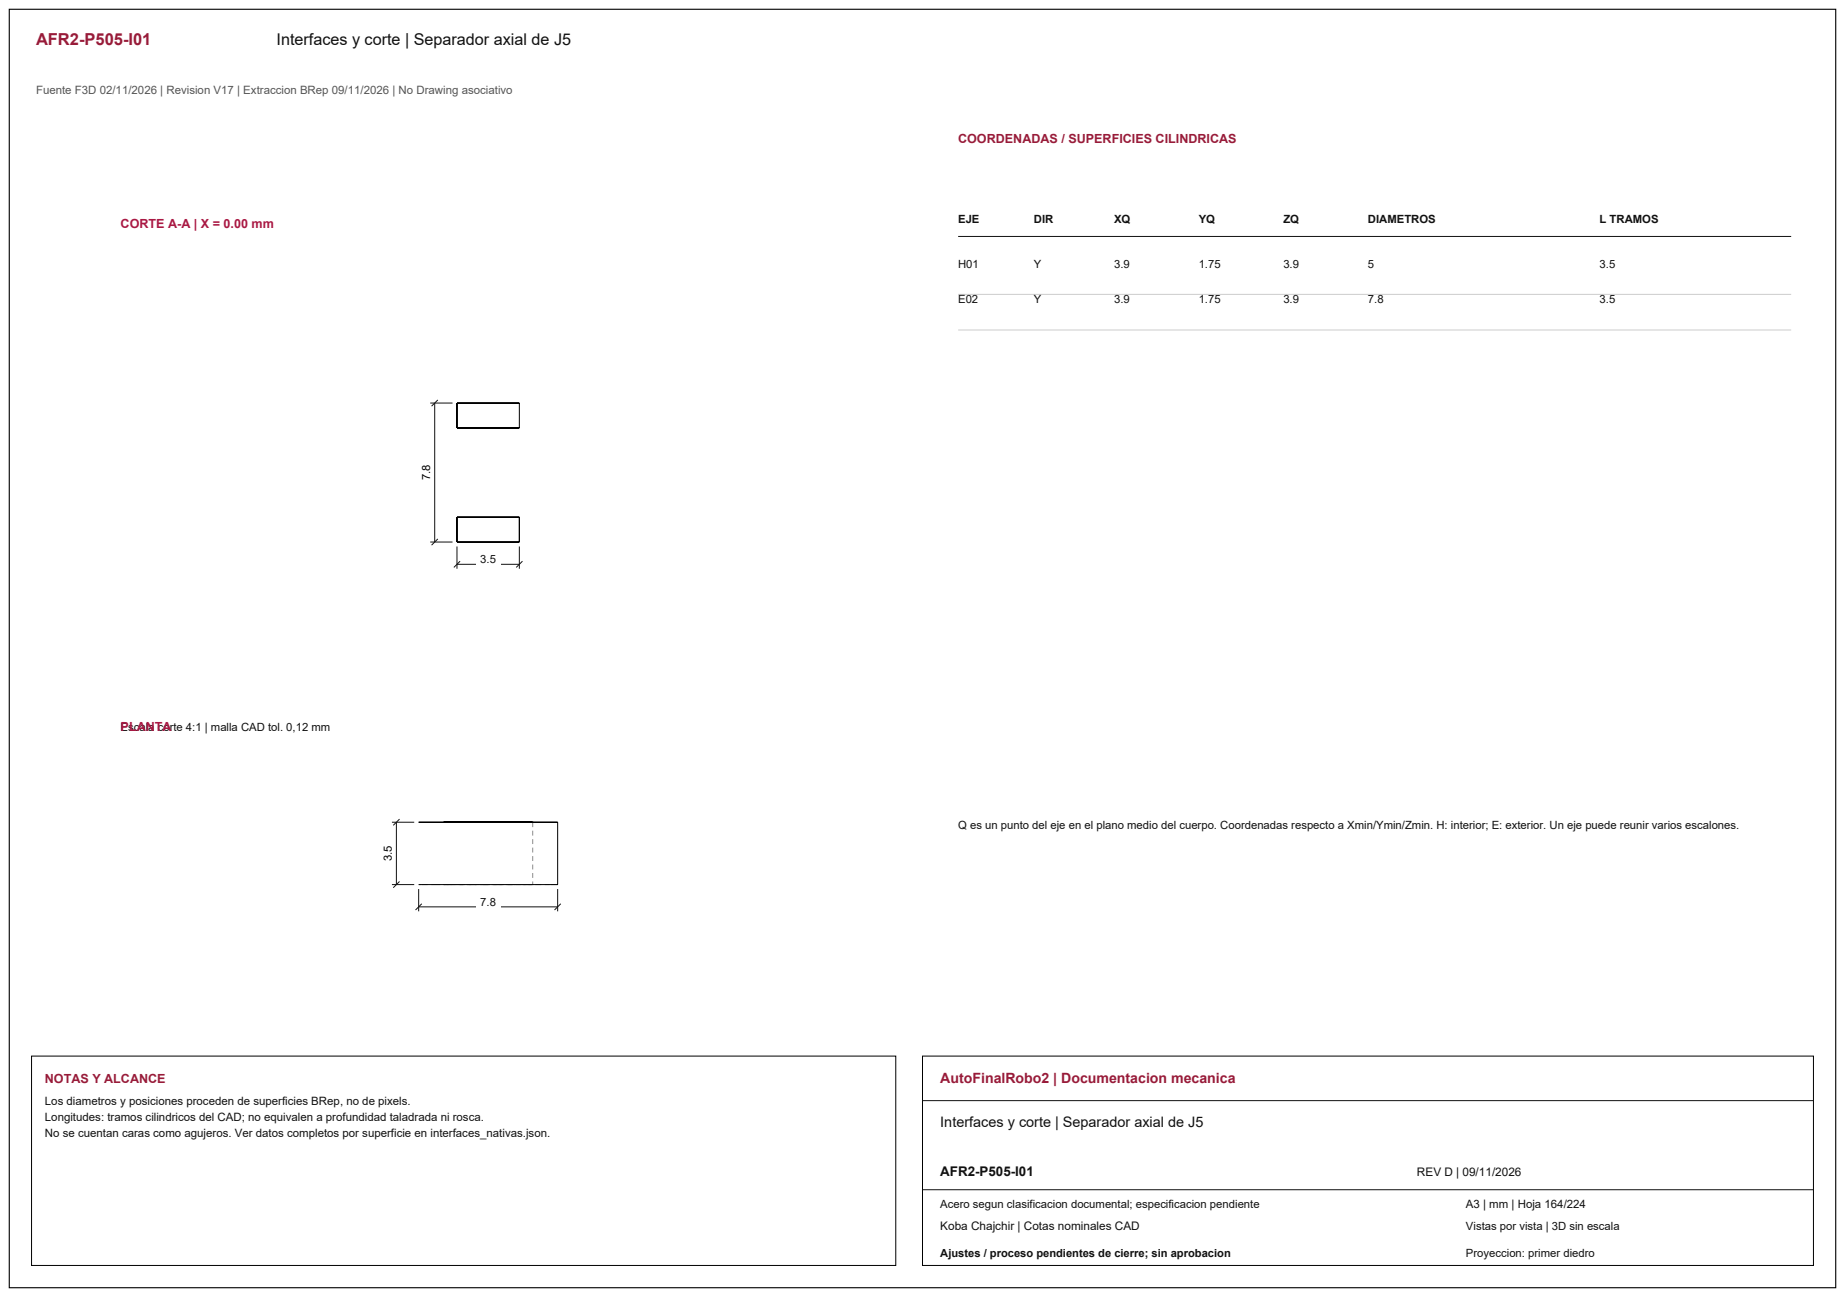
[picture p412: page 15]
CORTE A-A | X = 0.00 mm; EJE; DIR; DIAMETROS; L TRAMOS; NOTAS Y ALCANCE; AutoFinalRobo2 | Documentacion mecanica; AFR2-P505-I01; REV D | 09/11/2026

COORDENADAS / SUPERFICIES CILINDRICAS

Escala corte 4:1 | malla CAD tol. 0,12 mm PLANTA

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

Interfaces y corte | Separador axial de J5

Acero segun clasificacion documental; especificacion pendiente

Vistas por vista | 3D sin escala

AFR2-P506 | Separador trasero de J5

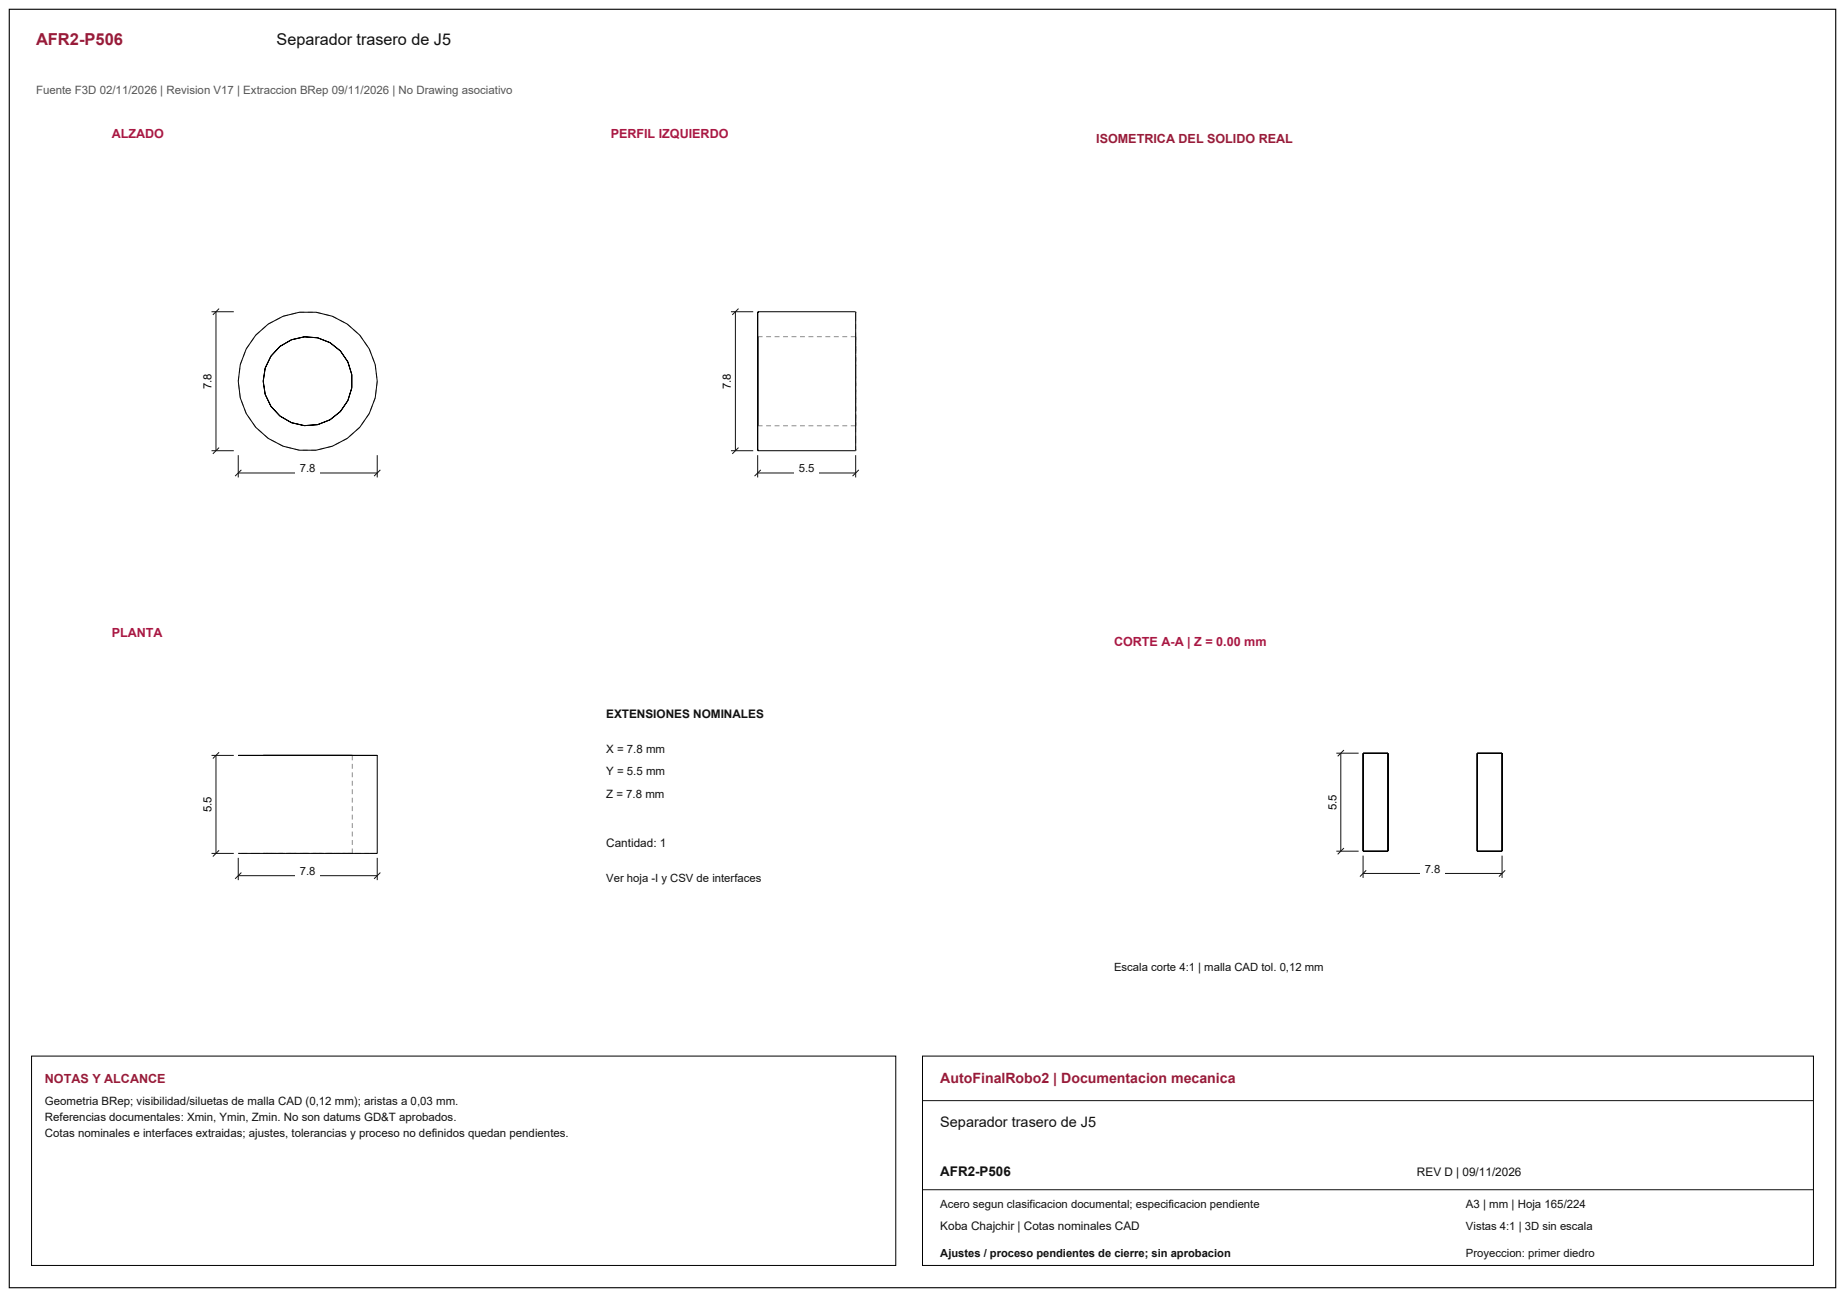
[picture p413: page 16]
ALZADO; PERFIL IZQUIERDO; PLANTA; CORTE A-A | Z = 0.00 mm; EXTENSIONES NOMINALES; Cantidad: 1; NOTAS Y ALCANCE; AutoFinalRobo2 | Documentacion mecanica; AFR2-P506; REV D | 09/11/2026

ISOMETRICA DEL SOLIDO REAL

Ver hoja -I y CSV de interfaces

Escala corte 4:1 | malla CAD tol. 0,12 mm

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

Separador trasero de J5

Acero segun clasificacion documental; especificacion pendiente

Vistas 4:1 | 3D sin escala

AFR2-P506-I01 | Interfaces y corte | Separador trasero de J5

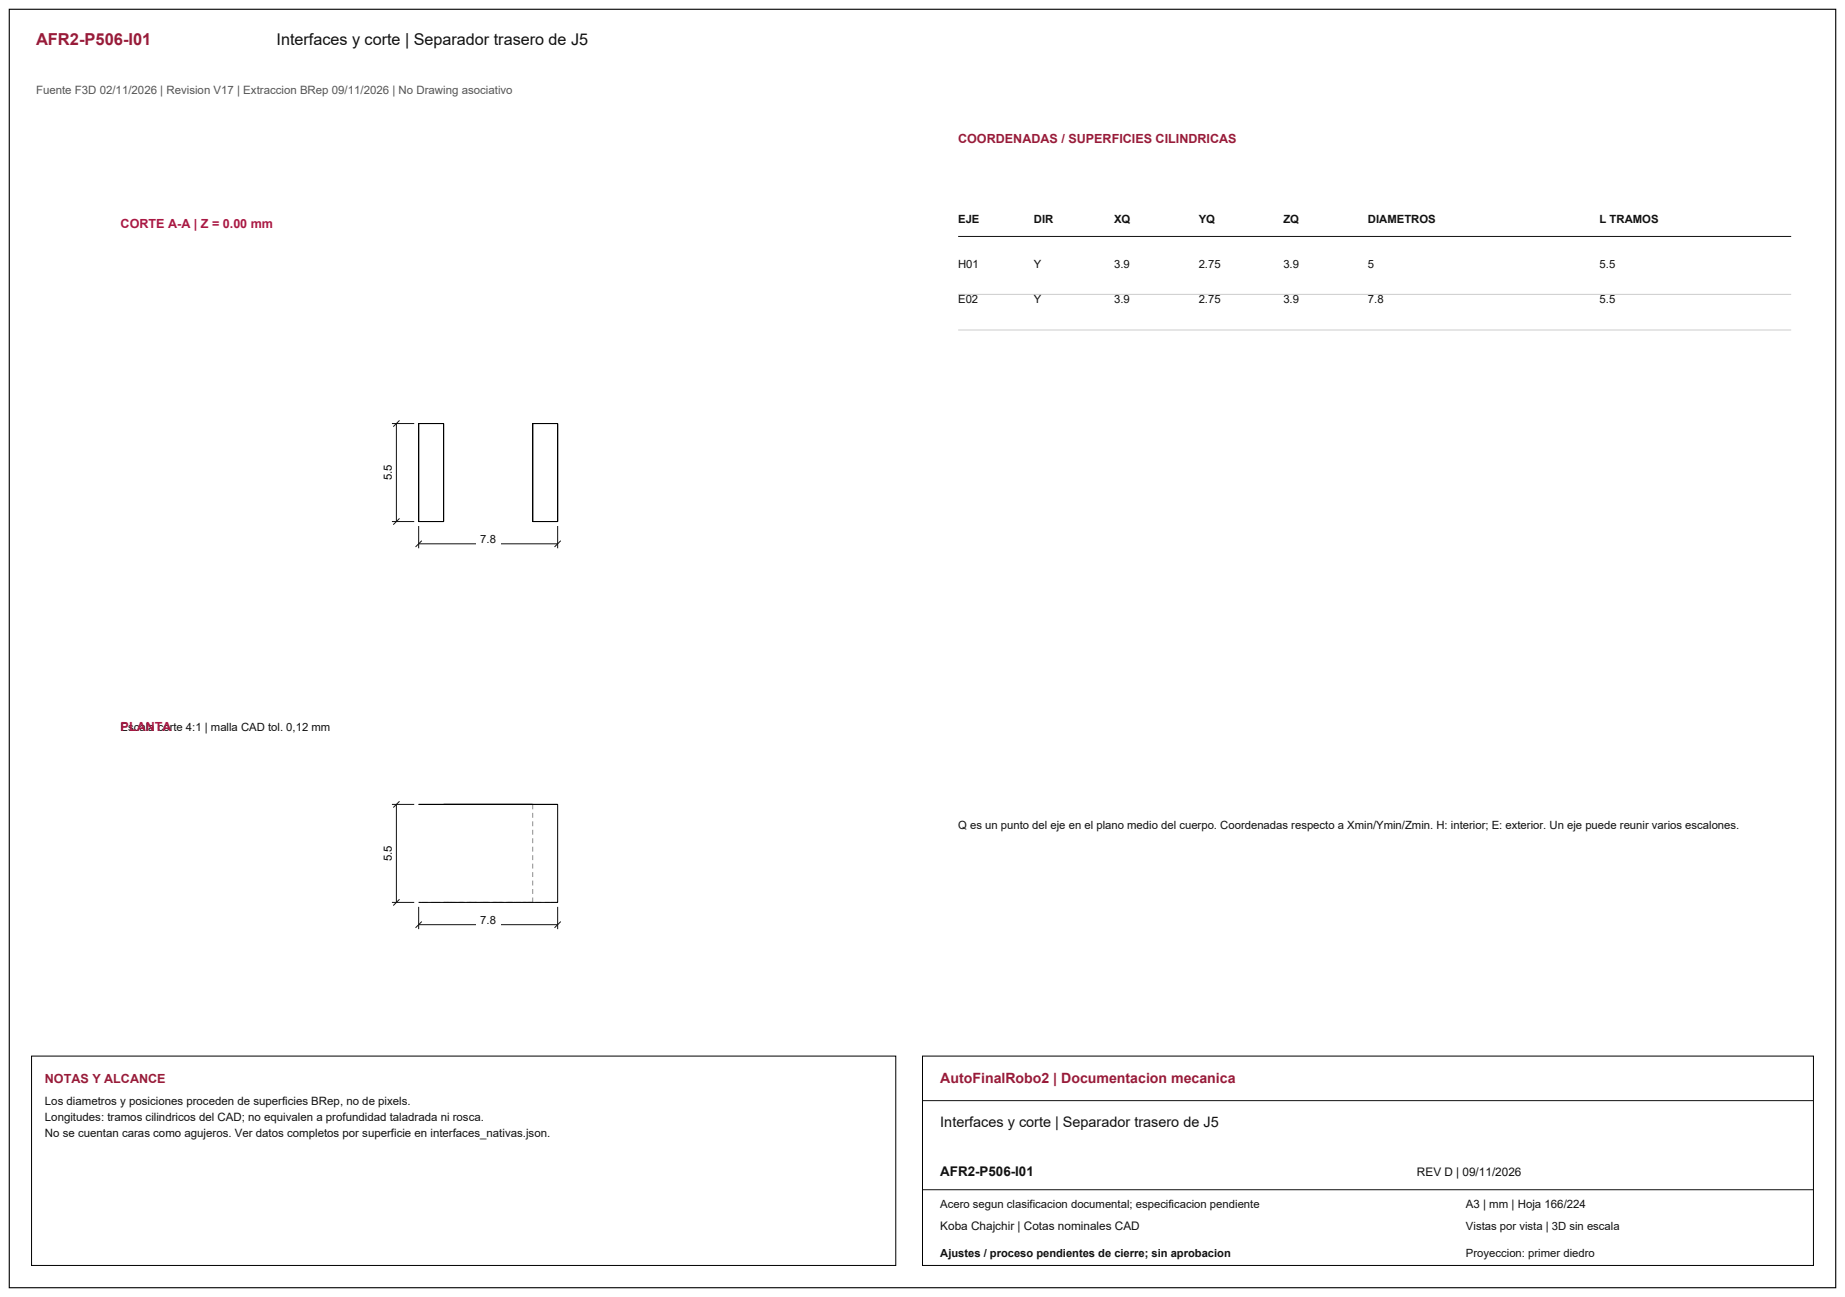
[picture p414: page 17]
CORTE A-A | Z = 0.00 mm; EJE; DIR; DIAMETROS; L TRAMOS; NOTAS Y ALCANCE; AutoFinalRobo2 | Documentacion mecanica; AFR2-P506-I01; REV D | 09/11/2026

COORDENADAS / SUPERFICIES CILINDRICAS

Escala corte 4:1 | malla CAD tol. 0,12 mm PLANTA

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

Interfaces y corte | Separador trasero de J5

Acero segun clasificacion documental; especificacion pendiente

Vistas por vista | 3D sin escala

AFR2-P503 | Tapa del servo STS3032 J6

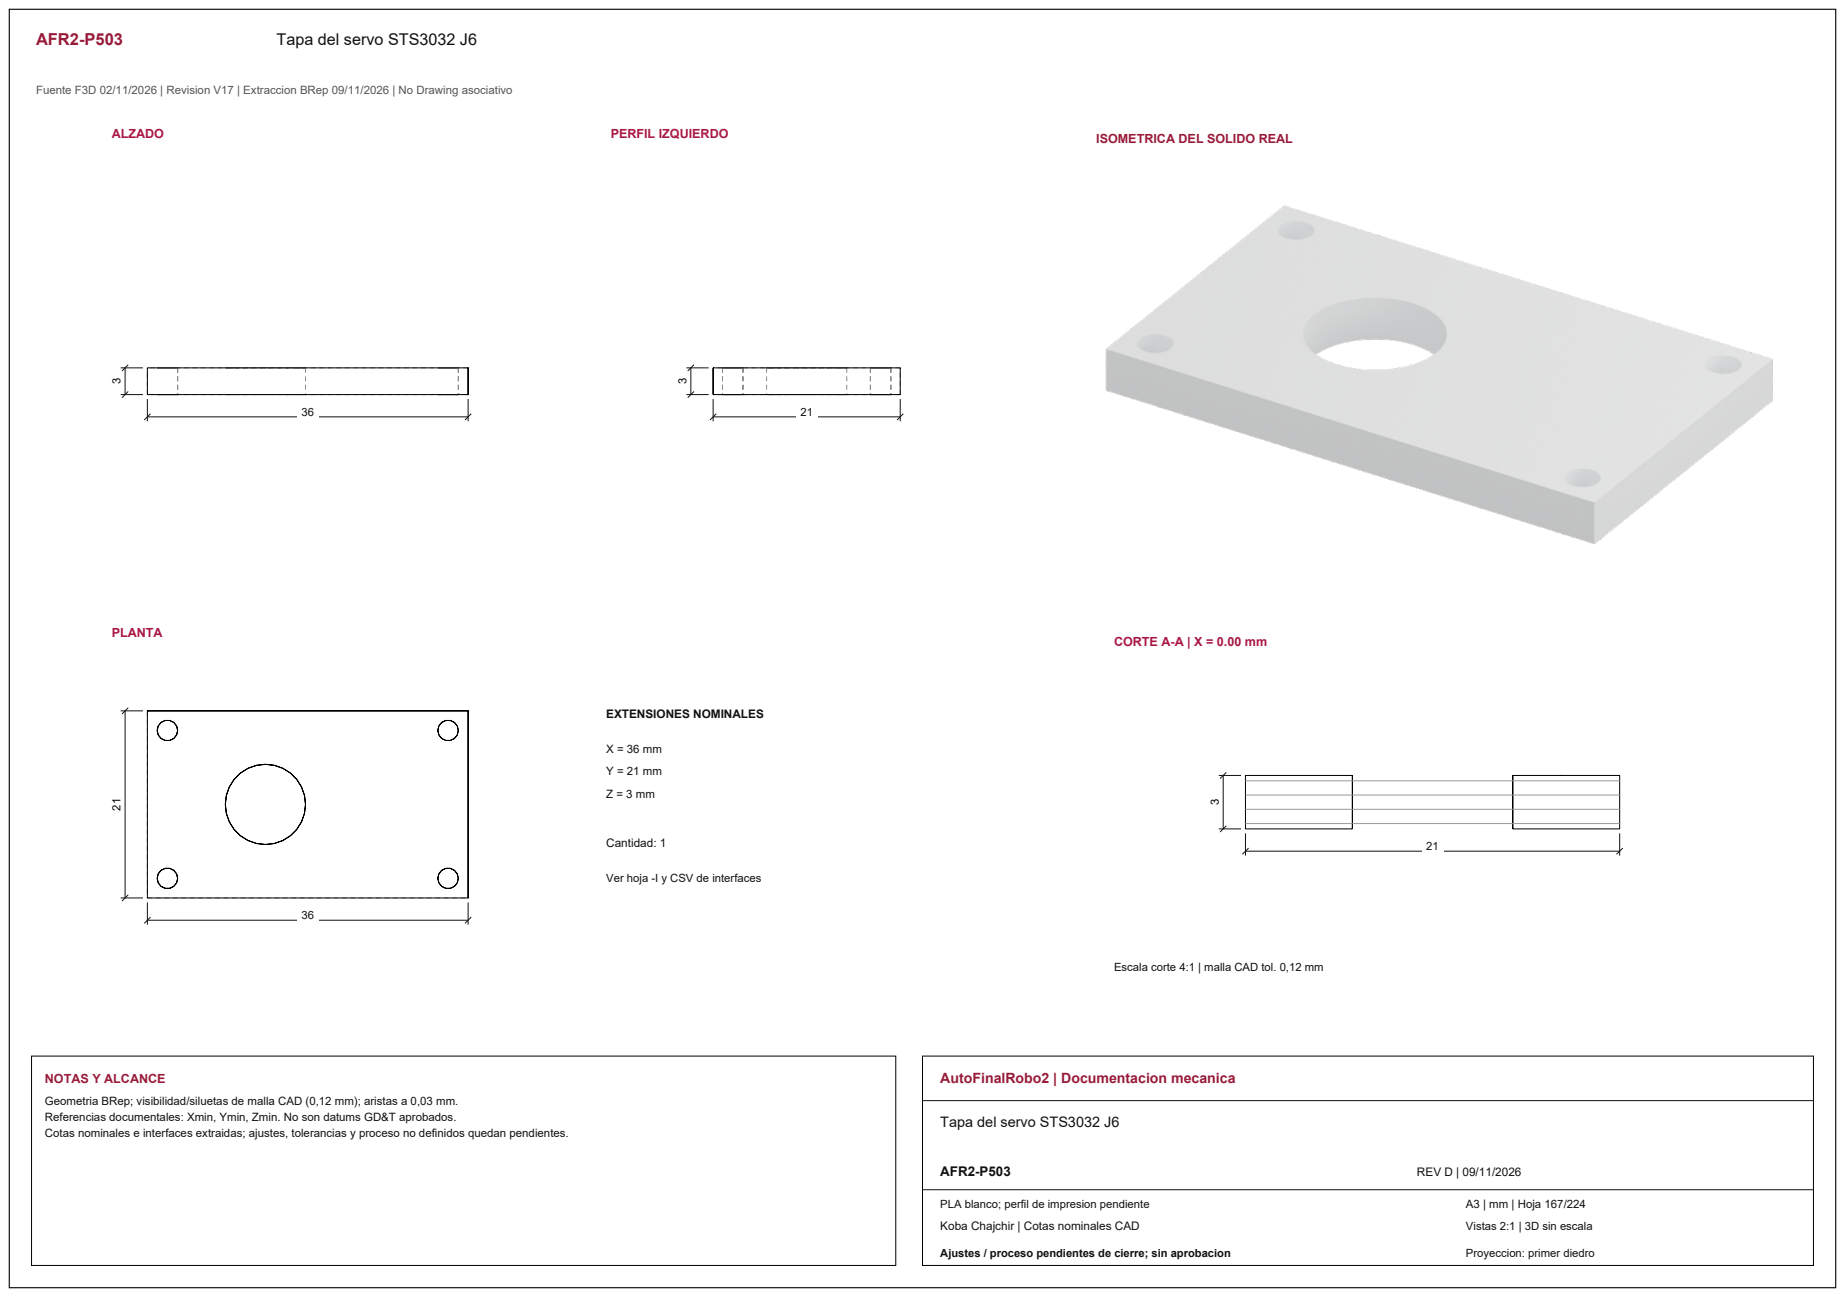
[picture p415: page 18]
ALZADO; PERFIL IZQUIERDO; PLANTA; CORTE A-A | X = 0.00 mm; EXTENSIONES NOMINALES; Cantidad: 1; NOTAS Y ALCANCE; AutoFinalRobo2 | Documentacion mecanica; AFR2-P503; REV D | 09/11/2026

ISOMETRICA DEL SOLIDO REAL

Ver hoja -I y CSV de interfaces

Escala corte 4:1 | malla CAD tol. 0,12 mm

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

Tapa del servo STS3032 J6

PLA blanco; perfil de impresion pendiente

Vistas 2:1 | 3D sin escala

AFR2-P503-I01 | Interfaces y corte | Tapa del servo STS3032 J6

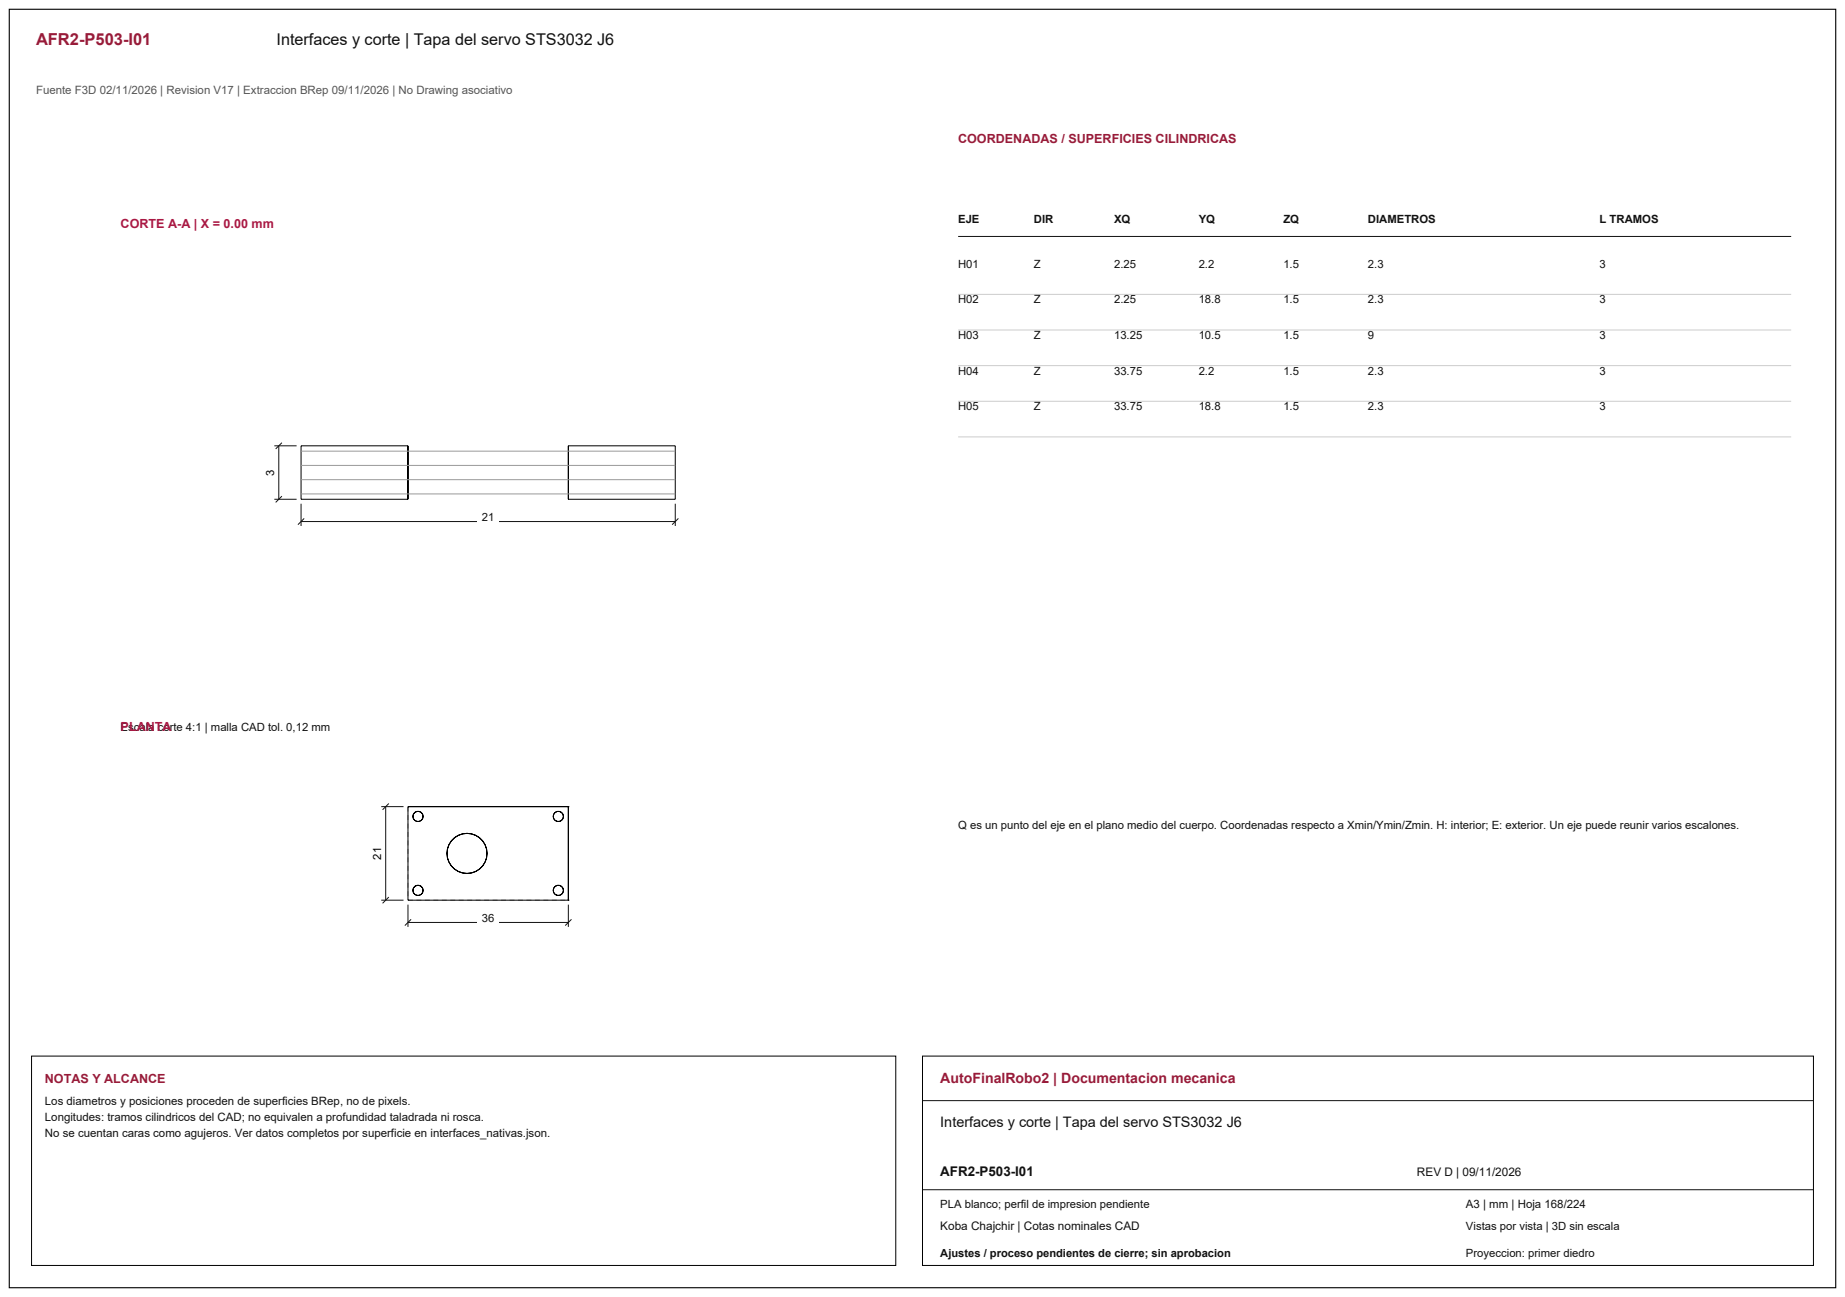
[picture p416: page 19]
CORTE A-A | X = 0.00 mm; EJE; DIR; DIAMETROS; L TRAMOS; NOTAS Y ALCANCE; AutoFinalRobo2 | Documentacion mecanica; AFR2-P503-I01; REV D | 09/11/2026

COORDENADAS / SUPERFICIES CILINDRICAS

Escala corte 4:1 | malla CAD tol. 0,12 mm PLANTA

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

Interfaces y corte | Tapa del servo STS3032 J6

PLA blanco; perfil de impresion pendiente

Vistas por vista | 3D sin escala
