kobachajchir/ProyectoRobotica2/Documentacion/PlacaPCB.pdf

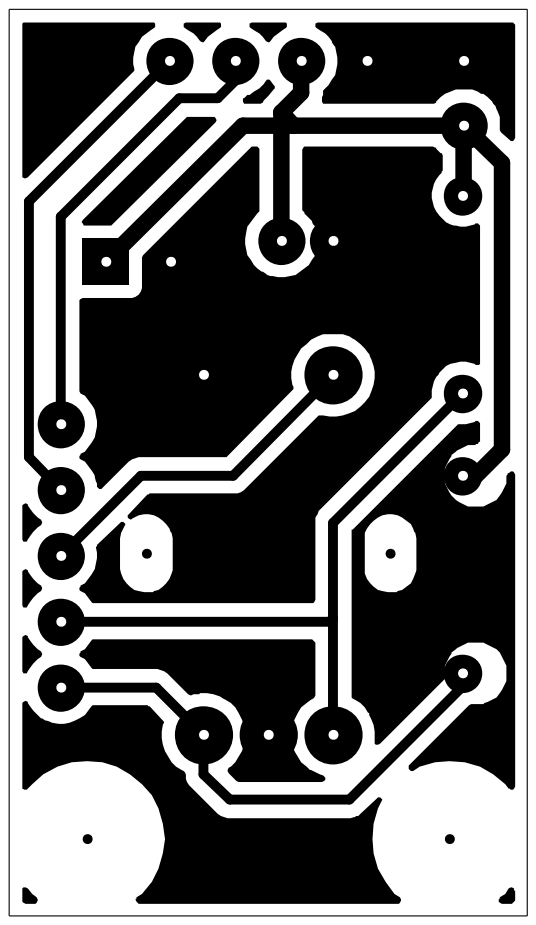
[picture p417: page 1]
