kobachajchir/ProyectoRobotica2/Placa Kicad/PlacaPCB.pdf

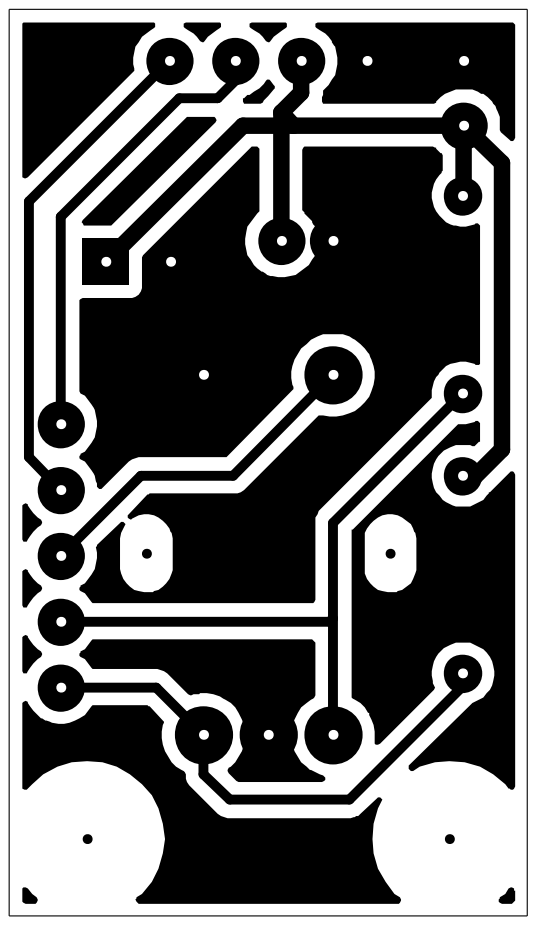
[picture p418: page 1]
