kobachajchir/ProyectoRobotica2/AutoFinalRobo2-CAD/mecanica/brazo-antropomorfo/revision_v17/laminas_20261109/AFR2_Planos_Brazo_V17_Documentacion_Dimensional_A3.pdf

AFR2-A100 | Montura y control fijo
Fuente F3D 02/11/2026 | Revision V17 | Extraccion BRep 09/11/2026 | No Drawing asociativo

NOTAS Y ALCANCE


Conjunto armado desde la captura nativa, con sus orientaciones y ubicaciones guardadas. Lista de ocurrencias en hojas -LP y despieces por tramos -E.
No se modifica la geometria ni se afirma secuencia de montaje/desmontaje comprobada.

### AutoFinalRobo2 | Documentacion mecanica

### Montura y control fijo

AFR2-A100 | REV D | 09/11/2026
Conjunto mixto Koba Chajchir | Cotas nominales CAD Ajustes / proceso pendientes de cierre; sin aprobacion | A3 | mm | Hoja 1/224
| Vistas -- | 3D sin escala
| Proyeccion: primer diedro

AFR2-A100-LP01 | Lista de ocurrencias | Montura y control fijo
001 COMERCIAL/REFERENCIA | V03 Bornera y alimentacion REF
002 COMERCIAL/REFERENCIA | V03 Casquillo central compresion
003 COMERCIAL/REFERENCIA | V03 Nano vertical
004 COMERCIAL/REFERENCIA | V03 PCA9685 vertical
005 AFR2-P101 | V03 Separador M3 A
006 AFR2-P102 | V03 Separador M3 B
007 AFR2-P103 | V03 Separador M3 C
008 AFR2-P104 | V03 Separador M3 D
009 AFR2-P105 | V03 Tapa rodamientos J1
010 COMERCIAL/REFERENCIA | V03 Tuerca arandela M10
011 COMERCIAL/REFERENCIA | V03 Tuerca arandela M3 A
012 COMERCIAL/REFERENCIA | V03 Tuerca arandela M3 B
013 COMERCIAL/REFERENCIA | V03 Tuerca arandela M3 C
014 COMERCIAL/REFERENCIA | V03 Tuerca arandela M3 D
015 COMERCIAL/REFERENCIA | V03 XL4016 vertical 1
016 COMERCIAL/REFERENCIA | V03 XL4016 vertical 2
017 COMERCIAL/REFERENCIA | V03 XL4016 vertical 3
018 AFR2-P106 | V04 Separador M3 E

NOTAS Y ALCANCE

Cada posicion identifica una ocurrencia; los solidos de un mismo comercial se mantienen agrupados. Las placas con hijos Nano/PCA9685/XL4016 se agrupan como unidades comerciales.
Codigo COMERCIAL/REFERENCIA no implica plano de fabricacion propio. Rutas completas en CSV.

### AutoFinalRobo2 | Documentacion mecanica

### Lista de ocurrencias | Montura y control fijo

AFR2-A100-LP01 | REV D | 09/11/2026

Conjunto mixto

| Vistas -- | 3D sin escala

AFR2-A100-LP02 | Lista de ocurrencias | Montura y control fijo
019 AFR2-P107 | V04 Separador M3 F
020 COMERCIAL/REFERENCIA | V04 Tuerca arandela M3 E
021 COMERCIAL/REFERENCIA | V04 Tuerca arandela M3 F
022 COMERCIAL/REFERENCIA | V05 Anclaje M3x25 A
023 COMERCIAL/REFERENCIA | V05 Anclaje M3x25 B
024 COMERCIAL/REFERENCIA | V05 Anclaje M3x25 C
025 COMERCIAL/REFERENCIA | V05 Anclaje M3x25 D
026 COMERCIAL/REFERENCIA | V05 Anclaje M3x25 E
027 COMERCIAL/REFERENCIA | V05 Anclaje M3x25 F
028 COMERCIAL/REFERENCIA | V05 M10x30 DIN7991 REF
029 AFR2-P108 | V05 Montura baja PETG
030 AFR2-P109 | V06 Contraplaca inferior unica PETG
031 COMERCIAL/REFERENCIA | V09 Arandela tirante 0
032 COMERCIAL/REFERENCIA | V09 Arandela tirante 1
033 COMERCIAL/REFERENCIA | V09 Arandela tirante 2
034 COMERCIAL/REFERENCIA | V09 Arandela tirante 3
035 AFR2-P110 | V09 Cartucho6000 desmontable PETG
036 COMERCIAL/REFERENCIA | V09 Inserto tapa -1

NOTAS Y ALCANCE

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

### AutoFinalRobo2 | Documentacion mecanica

### Lista de ocurrencias | Montura y control fijo

AFR2-A100-LP02 | REV D | 09/11/2026

Conjunto mixto

| Vistas -- | 3D sin escala

AFR2-A100-LP03 | Lista de ocurrencias | Montura y control fijo


037 COMERCIAL/REFERENCIA | V09 Inserto tapa 1
038 COMERCIAL/REFERENCIA | V09 Perno tapa -1
039 COMERCIAL/REFERENCIA | V09 Perno tapa 1
040 COMERCIAL/REFERENCIA | V09 R01 6000 J1 inferior
041 COMERCIAL/REFERENCIA | V09 R01 6000 J1 superior
042 COMERCIAL/REFERENCIA | V09 Tirante M3x60 0
043 COMERCIAL/REFERENCIA | V09 Tirante M3x60 1
044 COMERCIAL/REFERENCIA | V09 Tirante M3x60 2
045 COMERCIAL/REFERENCIA | V09 Tirante M3x60 3
046 COMERCIAL/REFERENCIA | V09 Tuerca tirante 0
047 COMERCIAL/REFERENCIA | V09 Tuerca tirante 1
048 COMERCIAL/REFERENCIA | V09 Tuerca tirante 2
049 COMERCIAL/REFERENCIA | V09 Tuerca tirante 3
050 COMERCIAL/REFERENCIA | V17 M03 STS3250 remoto

NOTAS Y ALCANCE

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

### AutoFinalRobo2 | Documentacion mecanica

### Lista de ocurrencias | Montura y control fijo

AFR2-A100-LP03 | REV D | 09/11/2026

Conjunto mixto

| Vistas -- | 3D sin escala

AFR2-A100-E1 | Despiece isometrico | Montura y control fijo

005 AFR2-P101 | V03 Separador M3 A; 006 AFR2-P102 | V03 Separador M3 B; 007 AFR2-P103 | V03 Separador M3 C; 008 AFR2-P104 | V03 Separador M3 D; NOTAS Y ALCANCE; AutoFinalRobo2 | Documentacion mecanica; AFR2-A100-E1; REV D | 09/11/2026; Conjunto mixto

POSICIONES DEL TRAMO

001 COMERCIAL/REFERENCIA | V03 Bornera y alimentacion REF

002 COMERCIAL/REFERENCIA | V03 Casquillo central compresion

003 COMERCIAL/REFERENCIA | V03 Nano vertical

004 COMERCIAL/REFERENCIA | V03 PCA9685 vertical

Despiece isometrico documental; conserva orientaciones del ensamble.
Las separaciones son desplazamientos de visualizacion, no una trayectoria de desmontaje aprobada.
Todas las posiciones del tramo aparecen en la BOM; piezas pequenas conservan escala relativa.

Despiece isometrico | Montura y control fijo

Vistas -- | 3D sin escala

AFR2-A100-E2 | Despiece isometrico | Montura y control fijo

009 AFR2-P105 | V03 Tapa rodamientos J1; COMERCIAL/REFERENCIA | V03 XL4016 vertical 2; NOTAS Y ALCANCE; AutoFinalRobo2 | Documentacion mecanica; AFR2-A100-E2; REV D | 09/11/2026; Conjunto mixto

POSICIONES DEL TRAMO

010 COMERCIAL/REFERENCIA | V03 Tuerca arandela M10

011 COMERCIAL/REFERENCIA | V03 Tuerca arandela M3 A

012 COMERCIAL/REFERENCIA | V03 Tuerca arandela M3 B

013 COMERCIAL/REFERENCIA | V03 Tuerca arandela M3 C

014 COMERCIAL/REFERENCIA | V03 Tuerca arandela M3 D

015 COMERCIAL/REFERENCIA | V03 XL4016 vertical 1

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

Despiece isometrico | Montura y control fijo

Vistas -- | 3D sin escala

AFR2-A100-E3 | Despiece isometrico | Montura y control fijo

018 AFR2-P106 | V04 Separador M3 E; 019 AFR2-P107 | V04 Separador M3 F; NOTAS Y ALCANCE; AutoFinalRobo2 | Documentacion mecanica; AFR2-A100-E3; REV D | 09/11/2026; Conjunto mixto

POSICIONES DEL TRAMO

017 COMERCIAL/REFERENCIA | V03 XL4016 vertical 3

020 COMERCIAL/REFERENCIA | V04 Tuerca arandela M3 E

021 COMERCIAL/REFERENCIA | V04 Tuerca arandela M3 F

022 COMERCIAL/REFERENCIA | V05 Anclaje M3x25 A

023 COMERCIAL/REFERENCIA | V05 Anclaje M3x25 B

024 COMERCIAL/REFERENCIA | V05 Anclaje M3x25 C

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

Despiece isometrico | Montura y control fijo

Vistas -- | 3D sin escala

AFR2-A100-E4 | Despiece isometrico | Montura y control fijo

NOTAS Y ALCANCE; AutoFinalRobo2 | Documentacion mecanica; AFR2-A100-E4; REV D | 09/11/2026; Conjunto mixto

POSICIONES DEL TRAMO

025 COMERCIAL/REFERENCIA | V05 Anclaje M3x25 D

026 COMERCIAL/REFERENCIA | V05 Anclaje M3x25 E

027 COMERCIAL/REFERENCIA | V05 Anclaje M3x25 F

028 COMERCIAL/REFERENCIA | V05 M10x30 DIN7991 REF

029 AFR2-P108 | V05 Montura baja PETG

030 AFR2-P109 | V06 Contraplaca inferior unica PETG

031 COMERCIAL/REFERENCIA | V09 Arandela tirante 0

032 COMERCIAL/REFERENCIA | V09 Arandela tirante 1

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

Despiece isometrico | Montura y control fijo

Vistas -- | 3D sin escala

AFR2-A100-E5 | Despiece isometrico | Montura y control fijo

035 AFR2-P110 | V09 Cartucho6000 desmontable PETG; NOTAS Y ALCANCE; AutoFinalRobo2 | Documentacion mecanica; AFR2-A100-E5; REV D | 09/11/2026; Conjunto mixto

POSICIONES DEL TRAMO

033 COMERCIAL/REFERENCIA | V09 Arandela tirante 2

034 COMERCIAL/REFERENCIA | V09 Arandela tirante 3

036 COMERCIAL/REFERENCIA | V09 Inserto tapa -1

037 COMERCIAL/REFERENCIA | V09 Inserto tapa 1

038 COMERCIAL/REFERENCIA | V09 Perno tapa -1

039 COMERCIAL/REFERENCIA | V09 Perno tapa 1

040 COMERCIAL/REFERENCIA | V09 R01 6000 J1 inferior

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

Despiece isometrico | Montura y control fijo

Vistas -- | 3D sin escala

AFR2-A100-E6 | Despiece isometrico | Montura y control fijo

NOTAS Y ALCANCE; AutoFinalRobo2 | Documentacion mecanica; AFR2-A100-E6; REV D | 09/11/2026; Conjunto mixto

POSICIONES DEL TRAMO

041 COMERCIAL/REFERENCIA | V09 R01 6000 J1 superior

042 COMERCIAL/REFERENCIA | V09 Tirante M3x60 0

043 COMERCIAL/REFERENCIA | V09 Tirante M3x60 1

044 COMERCIAL/REFERENCIA | V09 Tirante M3x60 2

045 COMERCIAL/REFERENCIA | V09 Tirante M3x60 3

046 COMERCIAL/REFERENCIA | V09 Tuerca tirante 0

047 COMERCIAL/REFERENCIA | V09 Tuerca tirante 1

048 COMERCIAL/REFERENCIA | V09 Tuerca tirante 2

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

Despiece isometrico | Montura y control fijo

Vistas -- | 3D sin escala

AFR2-A100-E7 | Despiece isometrico | Montura y control fijo

NOTAS Y ALCANCE; AutoFinalRobo2 | Documentacion mecanica; AFR2-A100-E7; REV D | 09/11/2026; Conjunto mixto

POSICIONES DEL TRAMO

049 COMERCIAL/REFERENCIA | V09 Tuerca tirante 3

050 COMERCIAL/REFERENCIA | V17 M03 STS3250 remoto

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

Despiece isometrico | Montura y control fijo

Vistas -- | 3D sin escala

AFR2-A200 | Base J1 y transmision de hombro

NOTAS Y ALCANCE

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


### AutoFinalRobo2 | Documentacion mecanica

### Base J1 y transmision de hombro

AFR2-A200 | REV D | 09/11/2026

Conjunto mixto

| Vistas -- | 3D sin escala

AFR2-A200-LP01 | Lista de ocurrencias | Base J1 y transmision de hombro


001 AFR2-P201 | A01 Plataforma giratoria PETG
002 COMERCIAL/REFERENCIA | R02 608ZZ Hombro -1
003 COMERCIAL/REFERENCIA | R02 608ZZ Hombro 1
004 COMERCIAL/REFERENCIA | V03 E00 Husillo base completo
005 COMERCIAL/REFERENCIA | V03 Inserto M3 A01 Plataforma giratoria PETG-1-1
006 COMERCIAL/REFERENCIA | V03 Inserto M3 A01 Plataforma giratoria PETG-11
007 COMERCIAL/REFERENCIA | V03 Inserto M3 A01 Plataforma giratoria PETG1-1
008 COMERCIAL/REFERENCIA | V03 Inserto M3 A01 Plataforma giratoria PETG11
009 AFR2-P202 | V03 Tapa 608 A01 Plataforma giratoria PETG -1
010 AFR2-P203 | V03 Tapa 608 A01 Plataforma giratoria PETG 1
011 COMERCIAL/REFERENCIA | V03 Tornillo tapa A01 Plataforma giratoria PETG-1-1
012 COMERCIAL/REFERENCIA | V03 Tornillo tapa A01 Plataforma giratoria PETG-11
013 COMERCIAL/REFERENCIA | V03 Tornillo tapa A01 Plataforma giratoria PETG1-1
014 COMERCIAL/REFERENCIA | V03 Tornillo tapa A01 Plataforma giratoria PETG11
015 COMERCIAL/REFERENCIA | V09 Adaptador dobleD acero
016 COMERCIAL/REFERENCIA | V09 Arandela axial10 REF
017 COMERCIAL/REFERENCIA | V09 Arandela brida 0
018 COMERCIAL/REFERENCIA | V09 Arandela brida 1

NOTAS Y ALCANCE

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

### AutoFinalRobo2 | Documentacion mecanica

### Lista de ocurrencias | Base J1 y transmision de hombro

AFR2-A200-LP01 | REV D | 09/11/2026

Conjunto mixto

| Vistas -- | 3D sin escala

AFR2-A200-LP02 | Lista de ocurrencias | Base J1 y transmision de hombro
019 COMERCIAL/REFERENCIA | V09 Arandela brida 2
020 COMERCIAL/REFERENCIA | V09 Arandela brida 3
021 COMERCIAL/REFERENCIA | V09 Casquillo compresion M4 0
022 COMERCIAL/REFERENCIA | V09 Casquillo compresion M4 1
023 COMERCIAL/REFERENCIA | V09 Casquillo compresion M4 2
024 COMERCIAL/REFERENCIA | V09 Casquillo compresion M4 3
025 COMERCIAL/REFERENCIA | V09 Circlip DIN471 10 REF
026 COMERCIAL/REFERENCIA | V09 M4 brida 0
027 COMERCIAL/REFERENCIA | V09 M4 brida 1
028 COMERCIAL/REFERENCIA | V09 M4 brida 2
029 COMERCIAL/REFERENCIA | V09 M4 brida 3
030 COMERCIAL/REFERENCIA | V09 Tuerca brida 0
031 COMERCIAL/REFERENCIA | V09 Tuerca brida 1
032 COMERCIAL/REFERENCIA | V09 Tuerca brida 2
033 COMERCIAL/REFERENCIA | V09 Tuerca brida 3
034 COMERCIAL/REFERENCIA | V17 625 entrada J3 delantero
035 COMERCIAL/REFERENCIA | V17 625 entrada J3 trasero
036 COMERCIAL/REFERENCIA | V17 Arandela M4 J2 dorso 0

NOTAS Y ALCANCE

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

### AutoFinalRobo2 | Documentacion mecanica

### Lista de ocurrencias | Base J1 y transmision de hombro

AFR2-A200-LP02 | REV D | 09/11/2026

Conjunto mixto

| Vistas -- | 3D sin escala

AFR2-A200-LP03 | Lista de ocurrencias | Base J1 y transmision de hombro
037 COMERCIAL/REFERENCIA | V17 Arandela M4 J2 dorso 0
038 COMERCIAL/REFERENCIA | V17 Arandela M4 J2 dorso 0
039 COMERCIAL/REFERENCIA | V17 Arandela M4 J2 dorso 0
040 COMERCIAL/REFERENCIA | V17 Arandela M4 J2 dorso 1
041 COMERCIAL/REFERENCIA | V17 Arandela M4 J2 dorso 1
042 COMERCIAL/REFERENCIA | V17 Arandela M4 J2 dorso 1
043 COMERCIAL/REFERENCIA | V17 Arandela M4 J2 dorso 1
044 COMERCIAL/REFERENCIA | V17 Arandela M4 J2 dorso 2
045 COMERCIAL/REFERENCIA | V17 Arandela M4 J2 dorso 2
046 COMERCIAL/REFERENCIA | V17 Arandela M4 J2 dorso 2
047 COMERCIAL/REFERENCIA | V17 Arandela M4 J2 dorso 2
048 COMERCIAL/REFERENCIA | V17 Arandela M4 J2 frente
049 COMERCIAL/REFERENCIA | V17 Arandela M4 J2 frente
050 COMERCIAL/REFERENCIA | V17 Arandela M4 J2 frente
051 COMERCIAL/REFERENCIA | V17 Arandela M4 J2 frente
052 AFR2-P205 | V17 Carro motor apoyo Al
053 AFR2-P225 | V17 Horn STS3250 J1 adaptado
054 AFR2-P204 | V17 Housing STS3250 y apoyo625

NOTAS Y ALCANCE

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

### AutoFinalRobo2 | Documentacion mecanica

### Lista de ocurrencias | Base J1 y transmision de hombro

AFR2-A200-LP03 | REV D | 09/11/2026

Conjunto mixto

| Vistas -- | 3D sin escala

AFR2-A200-LP04 | Lista de ocurrencias | Base J1 y transmision de hombro
055 COMERCIAL/REFERENCIA | V17 M03 STS3250 remoto
056 COMERCIAL/REFERENCIA | V17 M2 tapa625 -14
057 COMERCIAL/REFERENCIA | V17 M2 tapa625 14
058 COMERCIAL/REFERENCIA | V17 M3 tapa -37 mm -105 mm
059 COMERCIAL/REFERENCIA | V17 M3 tapa -37 mm -80 mm
060 COMERCIAL/REFERENCIA | V17 M3 tapa 17 mm -105 mm
061 COMERCIAL/REFERENCIA | V17 M3 tapa 17 mm -80 mm
062 COMERCIAL/REFERENCIA | V17 M3x5 horn J1 -1
063 COMERCIAL/REFERENCIA | V17 M3x5 horn J1 -1
064 COMERCIAL/REFERENCIA | V17 M3x6 central J1
065 COMERCIAL/REFERENCIA | V17 M4x25 J2 ISO7380
066 COMERCIAL/REFERENCIA | V17 M4x25 J2 ISO7380
067 COMERCIAL/REFERENCIA | V17 M4x25 J2 ISO7380
068 COMERCIAL/REFERENCIA | V17 M4x25 J2 ISO7380
069 AFR2-P218 | V17 Separador7 J2 Al
070 AFR2-P218 | V17 Separador7 J2 Al
071 AFR2-P218 | V17 Separador7 J2 Al
072 AFR2-P218 | V17 Separador7 J2 Al

NOTAS Y ALCANCE

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

### AutoFinalRobo2 | Documentacion mecanica

### Lista de ocurrencias | Base J1 y transmision de hombro

AFR2-A200-LP04 | REV D | 09/11/2026

Conjunto mixto

| Vistas -- | 3D sin escala

AFR2-A200-LP05 | Lista de ocurrencias | Base J1 y transmision de hombro
073 AFR2-P207 | V17 Tapa625 entrada trasera
074 AFR2-P206 | V17 Tapa housing STS3250
075 COMERCIAL/REFERENCIA | V17 Tuerca M4 J2
076 COMERCIAL/REFERENCIA | V17 Tuerca M4 J2
077 COMERCIAL/REFERENCIA | V17 Tuerca M4 J2
078 COMERCIAL/REFERENCIA | V17 Tuerca M4 J2
079 COMERCIAL/REFERENCIA | V17 Tuerca tapa -37 mm -105 mm
080 COMERCIAL/REFERENCIA | V17 Tuerca tapa -37 mm -80 mm
081 COMERCIAL/REFERENCIA | V17 Tuerca tapa 17 mm -105 mm
082 COMERCIAL/REFERENCIA | V17 Tuerca tapa 17 mm -80 mm
083 COMERCIAL/REFERENCIA | V17 Chaveta entrada 2x2x9
084 COMERCIAL/REFERENCIA | V17 Collar entrada5
085 AFR2-P339 | V17 Eje entrada 5mm
086 AFR2-P340 | V17 Horn STS3250 J3
087 COMERCIAL/REFERENCIA | V17 M3x6 horn J3 0
088 COMERCIAL/REFERENCIA | V17 M3x6 horn J3 1
089 COMERCIAL/REFERENCIA | V17 M3x6 horn J3 2
090 COMERCIAL/REFERENCIA | V17 M3x6 horn J3 3

NOTAS Y ALCANCE

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

### AutoFinalRobo2 | Documentacion mecanica

### Lista de ocurrencias | Base J1 y transmision de hombro

AFR2-A200-LP05 | REV D | 09/11/2026

Conjunto mixto

| Vistas -- | 3D sin escala

AFR2-A200-LP06 | Lista de ocurrencias | Base J1 y transmision de hombro
091 COMERCIAL/REFERENCIA | V17 Pinon18 J2 Al2024
092 COMERCIAL/REFERENCIA | V17 Prisionero M2 J2
093 COMERCIAL/REFERENCIA | V17 Prisionero collar entrada5
094 AFR2-P350 | V17 Separador J2 entrada dorso
095 AFR2-P349 | V17 Separador J2 entrada frente
096 COMERCIAL/REFERENCIA | V17 Tornillo central servo J3

NOTAS Y ALCANCE

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

### AutoFinalRobo2 | Documentacion mecanica

### Lista de ocurrencias | Base J1 y transmision de hombro

AFR2-A200-LP06 | REV D | 09/11/2026

Conjunto mixto

| Vistas -- | 3D sin escala

AFR2-A200-E1 | Despiece isometrico | Base J1 y transmision de hombro

NOTAS Y ALCANCE; AutoFinalRobo2 | Documentacion mecanica; AFR2-A200-E1; REV D | 09/11/2026; Conjunto mixto

POSICIONES DEL TRAMO

001 AFR2-P201 | A01 Plataforma giratoria PETG

002 COMERCIAL/REFERENCIA | R02 608ZZ Hombro -1

003 COMERCIAL/REFERENCIA | R02 608ZZ Hombro 1

004 COMERCIAL/REFERENCIA | V03 E00 Husillo base completo

005 COMERCIAL/REFERENCIA | V03 Inserto M3 A01 Plataforma giratoria PETG-1-1

006 COMERCIAL/REFERENCIA | V03 Inserto M3 A01 Plataforma giratoria PETG-11

007 COMERCIAL/REFERENCIA | V03 Inserto M3 A01 Plataforma giratoria PETG1-1

008 COMERCIAL/REFERENCIA | V03 Inserto M3 A01 Plataforma giratoria PETG11

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

Despiece isometrico | Base J1 y transmision de hombro

Vistas -- | 3D sin escala

AFR2-A200-E2 | Despiece isometrico | Base J1 y transmision de hombro

PETG-1-1; NOTAS Y ALCANCE; AutoFinalRobo2 | Documentacion mecanica; AFR2-A200-E2; REV D | 09/11/2026; Conjunto mixto

POSICIONES DEL TRAMO

009 AFR2-P202 | V03 Tapa 608 A01 Plataforma giratoria PETG -1

010 AFR2-P203 | V03 Tapa 608 A01 Plataforma giratoria PETG 1

011 COMERCIAL/REFERENCIA | V03 Tornillo tapa A01 Plataforma giratoria

012 COMERCIAL/REFERENCIA | V03 Tornillo tapa A01 Plataforma giratoria PETG-11

013 COMERCIAL/REFERENCIA | V03 Tornillo tapa A01 Plataforma giratoria PETG1-1

014 COMERCIAL/REFERENCIA | V03 Tornillo tapa A01 Plataforma giratoria PETG11

015 COMERCIAL/REFERENCIA | V09 Adaptador dobleD acero

016 COMERCIAL/REFERENCIA | V09 Arandela axial10 REF

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

Despiece isometrico | Base J1 y transmision de hombro

Vistas -- | 3D sin escala

AFR2-A200-E3 | Despiece isometrico | Base J1 y transmision de hombro

NOTAS Y ALCANCE; AutoFinalRobo2 | Documentacion mecanica; AFR2-A200-E3; REV D | 09/11/2026; Conjunto mixto

POSICIONES DEL TRAMO

017 COMERCIAL/REFERENCIA | V09 Arandela brida 0

018 COMERCIAL/REFERENCIA | V09 Arandela brida 1

019 COMERCIAL/REFERENCIA | V09 Arandela brida 2

020 COMERCIAL/REFERENCIA | V09 Arandela brida 3

021 COMERCIAL/REFERENCIA | V09 Casquillo compresion M4 0

022 COMERCIAL/REFERENCIA | V09 Casquillo compresion M4 1

023 COMERCIAL/REFERENCIA | V09 Casquillo compresion M4 2

024 COMERCIAL/REFERENCIA | V09 Casquillo compresion M4 3

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

Despiece isometrico | Base J1 y transmision de hombro

Vistas -- | 3D sin escala

AFR2-A200-E4 | Despiece isometrico | Base J1 y transmision de hombro

NOTAS Y ALCANCE; AutoFinalRobo2 | Documentacion mecanica; AFR2-A200-E4; REV D | 09/11/2026; Conjunto mixto

POSICIONES DEL TRAMO

025 COMERCIAL/REFERENCIA | V09 Circlip DIN471 10 REF

026 COMERCIAL/REFERENCIA | V09 M4 brida 0

027 COMERCIAL/REFERENCIA | V09 M4 brida 1

028 COMERCIAL/REFERENCIA | V09 M4 brida 2

029 COMERCIAL/REFERENCIA | V09 M4 brida 3

030 COMERCIAL/REFERENCIA | V09 Tuerca brida 0

031 COMERCIAL/REFERENCIA | V09 Tuerca brida 1

032 COMERCIAL/REFERENCIA | V09 Tuerca brida 2

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

Despiece isometrico | Base J1 y transmision de hombro

Vistas -- | 3D sin escala

AFR2-A200-E5 | Despiece isometrico | Base J1 y transmision de hombro

NOTAS Y ALCANCE; AutoFinalRobo2 | Documentacion mecanica; AFR2-A200-E5; REV D | 09/11/2026; Conjunto mixto

POSICIONES DEL TRAMO

033 COMERCIAL/REFERENCIA | V09 Tuerca brida 3

034 COMERCIAL/REFERENCIA | V17 625 entrada J3 delantero

035 COMERCIAL/REFERENCIA | V17 625 entrada J3 trasero

036 COMERCIAL/REFERENCIA | V17 Arandela M4 J2 dorso 0

037 COMERCIAL/REFERENCIA | V17 Arandela M4 J2 dorso 0

038 COMERCIAL/REFERENCIA | V17 Arandela M4 J2 dorso 0

039 COMERCIAL/REFERENCIA | V17 Arandela M4 J2 dorso 0

040 COMERCIAL/REFERENCIA | V17 Arandela M4 J2 dorso 1

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

Despiece isometrico | Base J1 y transmision de hombro

Vistas -- | 3D sin escala

AFR2-A200-E6 | Despiece isometrico | Base J1 y transmision de hombro

NOTAS Y ALCANCE; AutoFinalRobo2 | Documentacion mecanica; AFR2-A200-E6; REV D | 09/11/2026; Conjunto mixto

POSICIONES DEL TRAMO

041 COMERCIAL/REFERENCIA | V17 Arandela M4 J2 dorso 1

042 COMERCIAL/REFERENCIA | V17 Arandela M4 J2 dorso 1

043 COMERCIAL/REFERENCIA | V17 Arandela M4 J2 dorso 1

044 COMERCIAL/REFERENCIA | V17 Arandela M4 J2 dorso 2

045 COMERCIAL/REFERENCIA | V17 Arandela M4 J2 dorso 2

046 COMERCIAL/REFERENCIA | V17 Arandela M4 J2 dorso 2

047 COMERCIAL/REFERENCIA | V17 Arandela M4 J2 dorso 2

048 COMERCIAL/REFERENCIA | V17 Arandela M4 J2 frente

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

Despiece isometrico | Base J1 y transmision de hombro

Vistas -- | 3D sin escala

AFR2-A200-E7 | Despiece isometrico | Base J1 y transmision de hombro

053 AFR2-P225 | V17 Horn STS3250 J1 adaptado; 054 AFR2-P204 | V17 Housing STS3250 y apoyo625; COMERCIAL/REFERENCIA | V17 M2 tapa625 -14; NOTAS Y ALCANCE; AutoFinalRobo2 | Documentacion mecanica; AFR2-A200-E7; REV D | 09/11/2026; Conjunto mixto

POSICIONES DEL TRAMO

049 COMERCIAL/REFERENCIA | V17 Arandela M4 J2 frente

050 COMERCIAL/REFERENCIA | V17 Arandela M4 J2 frente

051 COMERCIAL/REFERENCIA | V17 Arandela M4 J2 frente

052 AFR2-P205 | V17 Carro motor apoyo Al

055 COMERCIAL/REFERENCIA | V17 M03 STS3250 remoto

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

Despiece isometrico | Base J1 y transmision de hombro

Vistas -- | 3D sin escala

AFR2-A200-E8 | Despiece isometrico | Base J1 y transmision de hombro

057 COMERCIAL/REFERENCIA | V17 M2 tapa625 14; COMERCIAL/REFERENCIA | V17 M3x6 central J1; NOTAS Y ALCANCE; AutoFinalRobo2 | Documentacion mecanica; AFR2-A200-E8; REV D | 09/11/2026; Conjunto mixto

POSICIONES DEL TRAMO

058 COMERCIAL/REFERENCIA | V17 M3 tapa -37 mm -105 mm

059 COMERCIAL/REFERENCIA | V17 M3 tapa -37 mm -80 mm

060 COMERCIAL/REFERENCIA | V17 M3 tapa 17 mm -105 mm

061 COMERCIAL/REFERENCIA | V17 M3 tapa 17 mm -80 mm

062 COMERCIAL/REFERENCIA | V17 M3x5 horn J1 -1

063 COMERCIAL/REFERENCIA | V17 M3x5 horn J1 -1

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

Despiece isometrico | Base J1 y transmision de hombro

Vistas -- | 3D sin escala

AFR2-A200-E9 | Despiece isometrico | Base J1 y transmision de hombro

065 COMERCIAL/REFERENCIA | V17 M4x25 J2 ISO7380; 066 COMERCIAL/REFERENCIA | V17 M4x25 J2 ISO7380; 067 COMERCIAL/REFERENCIA | V17 M4x25 J2 ISO7380; 068 COMERCIAL/REFERENCIA | V17 M4x25 J2 ISO7380; 069 AFR2-P218 | V17 Separador7 J2 Al; 070 AFR2-P218 | V17 Separador7 J2 Al; 071 AFR2-P218 | V17 Separador7 J2 Al; 072 AFR2-P218 | V17 Separador7 J2 Al; NOTAS Y ALCANCE; AutoFinalRobo2 | Documentacion mecanica; AFR2-A200-E9; REV D | 09/11/2026; Conjunto mixto

POSICIONES DEL TRAMO

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

Despiece isometrico | Base J1 y transmision de hombro

Vistas -- | 3D sin escala

AFR2-A200-E10 | Despiece isometrico | Base J1 y transmision de hombro

073 AFR2-P207 | V17 Tapa625 entrada trasera; 074 AFR2-P206 | V17 Tapa housing STS3250; NOTAS Y ALCANCE; AutoFinalRobo2 | Documentacion mecanica; AFR2-A200-E10; REV D | 09/11/2026; Conjunto mixto

POSICIONES DEL TRAMO

075 COMERCIAL/REFERENCIA | V17 Tuerca M4 J2

076 COMERCIAL/REFERENCIA | V17 Tuerca M4 J2

077 COMERCIAL/REFERENCIA | V17 Tuerca M4 J2

078 COMERCIAL/REFERENCIA | V17 Tuerca M4 J2

079 COMERCIAL/REFERENCIA | V17 Tuerca tapa -37 mm -105 mm

080 COMERCIAL/REFERENCIA | V17 Tuerca tapa -37 mm -80 mm

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

Despiece isometrico | Base J1 y transmision de hombro

Vistas -- | 3D sin escala

AFR2-A200-E11 | Despiece isometrico | Base J1 y transmision de hombro

085 AFR2-P339 | V17 Eje entrada 5mm; 086 AFR2-P340 | V17 Horn STS3250 J3; NOTAS Y ALCANCE; AutoFinalRobo2 | Documentacion mecanica; AFR2-A200-E11; REV D | 09/11/2026; Conjunto mixto

POSICIONES DEL TRAMO

081 COMERCIAL/REFERENCIA | V17 Tuerca tapa 17 mm -105 mm

082 COMERCIAL/REFERENCIA | V17 Tuerca tapa 17 mm -80 mm
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
