kobachajchir/ProyectoRobotica2/(list of files, drawings)

Other design files:
AutoFinalRobo2-Contracts/hardware/wifi-shield/OSOYOO-WiFI-shield-V1.3.fzz
