kobachajchir/ProyectoRobotica2/AutoFinalRobo2-CAD/kicad/oled-encoder/PlacaOLED-Encoder-AutoRobo2.kicad_pcb

## KiCad design AutoFinalRobo2-CAD/kicad/oled-encoder/PlacaOLED-Encoder-AutoRobo2.kicad_pcb (2026-11-10)

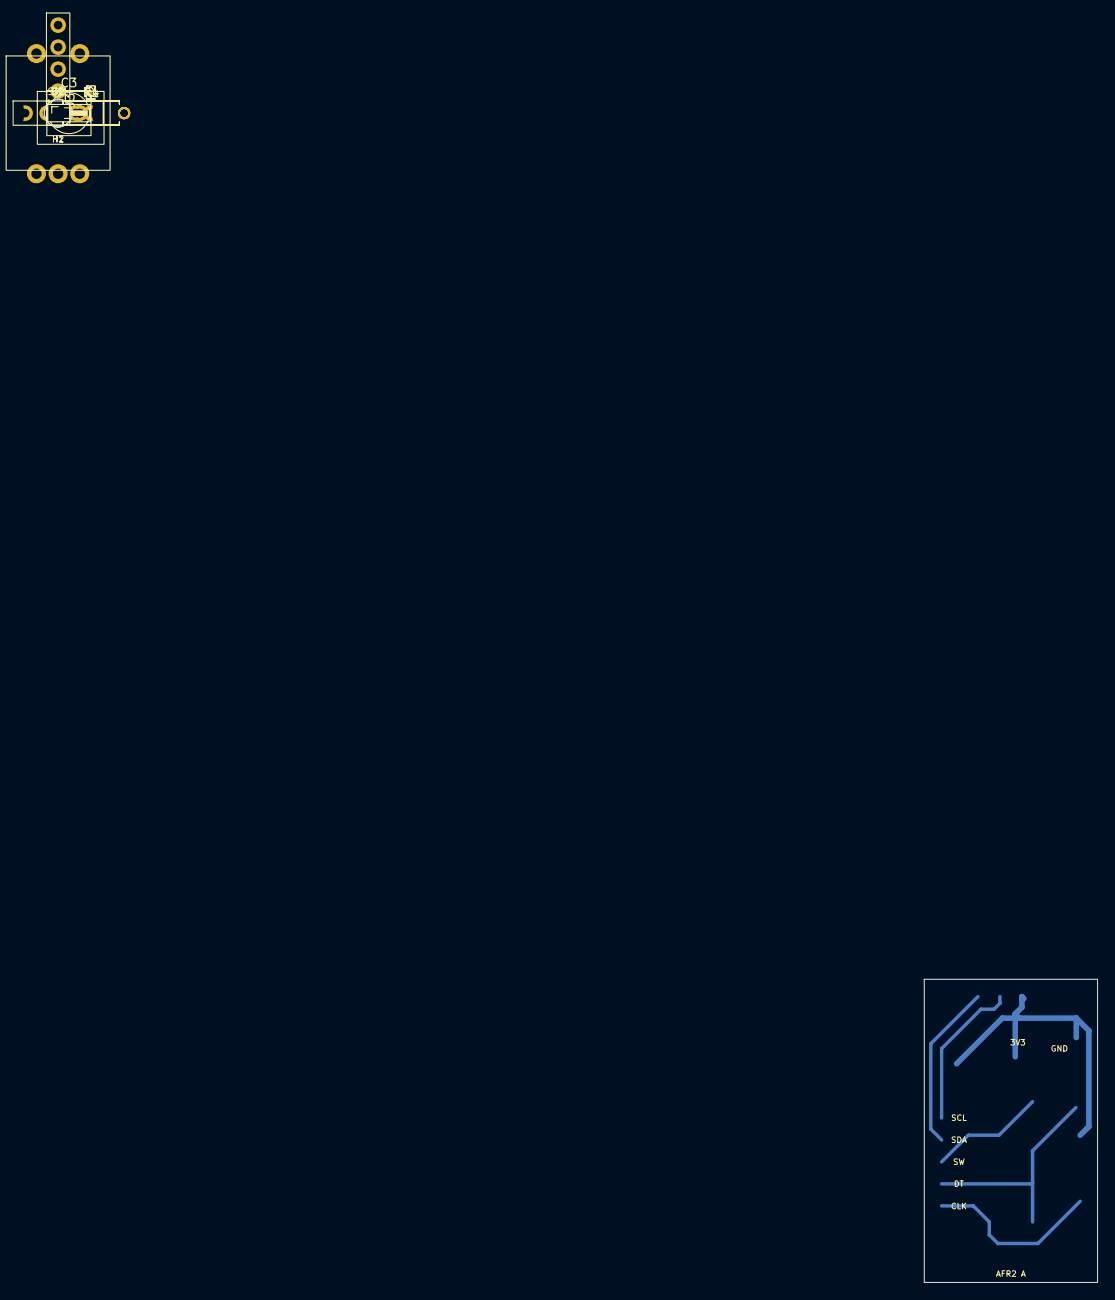
[picture p419: board PlacaOLED-Encoder-AutoRobo2.kicad_pcb from above]

Board: 2 copper layers, 20.0 x 35.0 mm, 14 parts (0 on the bottom side), 8 nets.

Parts:
C1: 100nF 16V; C_Disc_2.5
C2: 4.7uF 10V; CP_D5_P2.5
C3: 104; CP_Radial_Tantal_D4.5mm_P2.50mm
H1, H2: MountingHole_3.2mm_M3
J1: DATOS CLK DT SW SDA SCL; Signals_Socket5
J2: 3V3 / GND; Power_1x02
J3: A5 Battery Sensor; PinHeader_1x01_P1.00mm_Horizontal
R1, R2, R3, R4: 10k; R_Axial_TH_7.62_Lift1.5
SW1: EC11 / KY040 sin breakout; Encoder_KY040_Bare
U1: OLED 0.96 128x64 / SOCKET 1x04; OLED096_Socket4

Connections:
+3V3: C1.1, C2.1, J2.1, R2.2, R3.2, U1.2 (VCC)
ENC_CLK: J1.1, R2.1, SW1.4 (DT)
ENC_DT: J1.2, R3.1, SW1.5 (CLK)
ENC_SW: J1.3, SW1.3 (SW)
GND: C1.2, C2.2, C3.2, J2.2, R4.2, SW1.1 (GND), SW1.2 (+), U1.1 (GND)
unnamed: C3.1, J3.1 (Pin_1_1), R1.2, R4.1
SCL: J1.5, U1.3 (SCL)
SDA: J1.4, U1.4 (SDA)
