kobachajchir/ProyectoRobotica2/AutoFinalRobo2-Atmega/reference/f4/Core/Inc/main.h

#define State_LED_Pin GPIO_PIN_13
#define State_LED_GPIO_Port GPIOC
#define IR_Objects_Pin GPIO_PIN_14
#define IR_Objects_GPIO_Port GPIOC
#define IR_Line_Pin GPIO_PIN_15
#define IR_Line_GPIO_Port GPIOC
#define MotorOut4_Pin GPIO_PIN_3
#define MotorOut4_GPIO_Port GPIOA
#define EncoderSW_Pin GPIO_PIN_0
#define EncoderSW_GPIO_Port GPIOB
#define nRF24_CE_Pin GPIO_PIN_2
#define nRF24_CE_GPIO_Port GPIOB
#define MotorOut3_Pin GPIO_PIN_10
#define MotorOut3_GPIO_Port GPIOB
#define nRF24_CSN_Pin GPIO_PIN_12
#define nRF24_CSN_GPIO_Port GPIOB
#define nRF24_IRQ_Pin GPIO_PIN_8
#define nRF24_IRQ_GPIO_Port GPIOA
#define nRF24_IRQ_EXTI_IRQn EXTI9_5_IRQn
#define MotorOut1_Pin GPIO_PIN_15
#define MotorOut1_GPIO_Port GPIOA
#define MotorOut2_Pin GPIO_PIN_3
#define MotorOut2_GPIO_Port GPIOB
#define Luces_IR_Pin GPIO_PIN_4
#define Luces_IR_GPIO_Port GPIOB
#define User_BTN_Pin GPIO_PIN_5
#define User_BTN_GPIO_Port GPIOB
