kobachajchir/ProyectoRobotica2/AutoFinalRobo2-Atmega/include/afr2_sensor_head.h

/* AFR2-20261029-27: quick controls/radar/PWM/WS integration; prior authors retained. */
#ifndef AFR2_SENSOR_HEAD_H
#define AFR2_SENSOR_HEAD_H
#include "afr2_sensor_wire.h"
typedef struct { uint32_t id,ms; uint16_t distance_mm,ticks,pulse_us; uint8_t angle,error; } Afr2RangeSample;
typedef struct { uint32_t id,ms; uint16_t distance_mm; uint8_t error; } Afr2RadarBin;
typedef struct {
    Afr2RangeSample latest,queue[AFR2_RADAR_QUEUE];
    Afr2RadarBin bins[AFR2_RADAR_BINS];
    uint32_t sequence,servo_sequence,servo_ms,ir_sequence,step_ms;
    uint16_t interval_ms,settle_ms,pulse_us,target_us;
    uint8_t enabled,angle,min_angle,max_angle,speed,inverted,running,phase,index,head,count,ir_valid,scan_revision;
    uint8_t paused; /* pending editor resume; STOP clears it */
    /* AFR2-20261108-10: the HC-SR04 only fires while sampling (Controles rapidos), the radar runs
     * or a distance screen asks for it (view). All off after reset. */
    uint8_t sampling, view;
    /* AFR2-20261108-13: IR line reading published only while enabled or a line screen asks (ir_view);
     * the radar turns the HC-SR04 on and restores it when it stops (sampling_saved). */
    uint8_t ir_enabled, ir_view, sampling_saved;
    int8_t direction;
} Afr2SensorHead;
const Afr2SensorHead *Afr2Head_State(void);
uint8_t Afr2Head_Servo(uint8_t operation,uint8_t angle);
uint8_t Afr2Head_Interval(uint16_t ms);
uint8_t Afr2Head_Configure(uint8_t min,uint8_t max,uint8_t speed,uint16_t settle,uint16_t interval,uint8_t inverted);
uint8_t Afr2Head_Start(void);
void Afr2Head_Stop(void);
void Afr2Head_Pause(void);
void Afr2Head_Resume(void);
void Afr2Head_CancelResume(void);
void Afr2Head_SetSampling(uint8_t on);
void Afr2Head_SetView(uint8_t on);
void Afr2Head_SetIr(uint8_t on);
void Afr2Head_SetIrView(uint8_t on);
void Afr2Head_Record(uint8_t *out,const Afr2RangeSample *s);
uint8_t Afr2Head_Read(uint8_t mode,uint32_t cursor,uint8_t *out,uint32_t now,uint32_t boot);
#endif
