kobachajchir/ProyectoRobotica2/AutoFinalRobo2-Atmega/reference/f4/Core/Inc/screens_internal.h

#ifndef SCREENS_INTERNAL_H
#define SCREENS_INTERNAL_H
#include "screen_context.h"
#define APP_EvaluateRoute (Screens_Context->services->APP_EvaluateRoute)
#define APP_LineCalibrationBusy (Screens_Context->services->APP_LineCalibrationBusy)
#define autoMicroSystem (*Screens_Context->system)
#define GET_CAR_MODE() ((CarMode_t)SYSTEM_CAR_MODE(autoMicroSystem.runtime.carModeFlags))
#define menuSystem (*Screens_Context->menuSystem)
#define encoder (*Screens_Context->encoder)
#define wifiBridge (*Screens_Context->wifiBridge)
#define irSensors (*Screens_Context->irSensors)
#define motorTask (*Screens_Context->motorTask)
#define balanceControl (*Screens_Context->balanceControl)
#define motionControl (*Screens_Context->motionControl)
#define lineFollowControl (*Screens_Context->lineFollowControl)
#define mpuTask (*Screens_Context->mpuTask)
#define mainMenu (*Screens_Context->mainMenu)
#define submenu1 (*Screens_Context->submenu1)
#define submenuESP (*Screens_Context->submenuESP)
#define submenuSensorsDisplay (*Screens_Context->submenuSensorsDisplay)
#define wifiResultsMenu (*Screens_Context->wifiResultsMenu)
#define oledHandle (*Screens_Context->oledHandle)
#define wifiResultsItems (Screens_Context->wifiResultsItems)
#define buildDate (Screens_Context->buildDate)
#define buildTime (Screens_Context->buildTime)
#define oled_font (Screens_Context->state.oled_font)
#define oled_wifi_connected_ssid (Screens_Context->state.oled_wifi_connected_ssid)
#define oled_wifi_credentials_result_status (Screens_Context->state.oled_wifi_credentials_result_status)
#define oled_remote_mode_notification_line (Screens_Context->state.oled_remote_mode_notification_line)
#define oledNotificationsBlocked (Screens_Context->state.oledNotificationsBlocked)
#define menu_scroll_active (Screens_Context->state.menu_scroll_active)
#define menu_scroll_start_tick (Screens_Context->state.menu_scroll_start_tick)
#define menu_scroll_current_item (Screens_Context->state.menu_scroll_current_item)
#define scroll_text_x (Screens_Context->state.scroll_text_x)
#define scroll_text_y (Screens_Context->state.scroll_text_y)
#define scroll_max_chars (Screens_Context->state.scroll_max_chars)
#define scroll_text_ptr (Screens_Context->state.scroll_text_ptr)
#define scroll_text_len (Screens_Context->state.scroll_text_len)
#define scroll_last_offset (Screens_Context->state.scroll_last_offset)
#define dashboardScrollLanes (Screens_Context->state.dashboardScrollLanes)
#define dashboardScrollActive (Screens_Context->state.dashboardScrollActive)
#define appEspNotifWatchdogLimitDraft (Screens_Context->state.appEspNotifWatchdogLimitDraft)
#define AppApConfig_Get (Screens_Context->services->AppApConfig_Get)
#define AppApConfig_ApplyPatch (Screens_Context->services->AppApConfig_ApplyPatch)
#define AppApConfig_ParseIpv4 (Screens_Context->services->AppApConfig_ParseIpv4)
#define AppPreferences_ClampScreenLockTimeoutSec (Screens_Context->services->AppPreferences_ClampScreenLockTimeoutSec)
#define APP_ESPModeChangeCommandAccepted (Screens_Context->services->APP_ESPModeChangeCommandAccepted)
#define APP_ESPStatusRefreshRequested (Screens_Context->services->APP_ESPStatusRefreshRequested)
#define APP_ESPFirmwareRequestRequested (Screens_Context->services->APP_ESPFirmwareRequestRequested)
#define APP_IsIrObjectsEnabled (Screens_Context->services->APP_IsIrObjectsEnabled)
#define APP_IsIrLineEnabled (Screens_Context->services->APP_IsIrLineEnabled)
#define APP_MPU_IsCalibrationPromptActive (Screens_Context->services->APP_MPU_IsCalibrationPromptActive)
#define APP_MPU_IsCalibrationRunning (Screens_Context->services->APP_MPU_IsCalibrationRunning)
#define APP_MPU_GetCalibrationProgressPercent (Screens_Context->services->APP_MPU_GetCalibrationProgressPercent)
#define APP_MPU_IsCalibrationDoneNoticeActive (Screens_Context->services->APP_MPU_IsCalibrationDoneNoticeActive)
#define BalanceControl_GetStatus (Screens_Context->services->BalanceControl_GetStatus)
#define dashboardEventManager (Screens_Context->services->dashboardEventManager)
#define dashboardQuickActionEventManager (Screens_Context->services->dashboardQuickActionEventManager)
#define menuEventManager (Screens_Context->services->menuEventManager)
#define About_UserEventManager (Screens_Context->services->About_UserEventManager)
#define motorTestEventManager (Screens_Context->services->motorTestEventManager)
#define WiFiSearch_UserEventManager (Screens_Context->services->WiFiSearch_UserEventManager)
#define wifiEventManager (Screens_Context->services->wifiEventManager)
#define WiFiDetails_UserEventManager (Screens_Context->services->WiFiDetails_UserEventManager)
#define WiFiAtPassword_UserEventManager (Screens_Context->services->WiFiAtPassword_UserEventManager)
#define WiFiAtPassword_GetLength (Screens_Context->services->WiFiAtPassword_GetLength)
#define WiFiAtPassword_GetSelectedCharacter (Screens_Context->services->WiFiAtPassword_GetSelectedCharacter)
#define ReadOnly_UserEventManager (Screens_Context->services->ReadOnly_UserEventManager)
#define IRValues_UserEventManager (Screens_Context->services->IRValues_UserEventManager)
#define RouteAlignment_UserEventManager (Screens_Context->services->RouteAlignment_UserEventManager)
#define MPUValues_UserEventManager (Screens_Context->services->MPUValues_UserEventManager)
#define UnerRouterTest_UserEventManager (Screens_Context->services->UnerRouterTest_UserEventManager)
#define screenLockedEventManager (Screens_Context->services->screenLockedEventManager)
#define balancePidStatusEventManager (Screens_Context->services->balancePidStatusEventManager)
#define screenLockTimeoutEventManager (Screens_Context->services->screenLockTimeoutEventManager)
#define systemActionTimeoutEventManager (Screens_Context->services->systemActionTimeoutEventManager)
#define usbAlivePeriodEventManager (Screens_Context->services->usbAlivePeriodEventManager)
#define lineBlackWidthEventManager (Screens_Context->services->lineBlackWidthEventManager)
#define motorMinPwmEventManager (Screens_Context->services->motorMinPwmEventManager)
#define oledRotationTestEventManager (Screens_Context->services->oledRotationTestEventManager)
#define oledRotationMpuTestEventManager (Screens_Context->services->oledRotationMpuTestEventManager)
#define oledCanvasEventManager (Screens_Context->services->oledCanvasEventManager)
#define ClickCancelar_UserEventManager (Screens_Context->services->ClickCancelar_UserEventManager)
#define Dashboard_ResetModeConfirmState (Screens_Context->services->Dashboard_ResetModeConfirmState)
#define Dashboard_GetActionTimeoutContext (Screens_Context->services->Dashboard_GetActionTimeoutContext)
#define GenericConfirm_GetLine1 (Screens_Context->services->GenericConfirm_GetLine1)
#define GenericConfirm_GetLine2 (Screens_Context->services->GenericConfirm_GetLine2)
#define GenericConfirm_GetScreenCode (Screens_Context->services->GenericConfirm_GetScreenCode)
#define Preferences_GetSystemActionTimeoutDraft (Screens_Context->services->Preferences_GetSystemActionTimeoutDraft)
#define Preferences_GetUsbAlivePeriodDraftMs (Screens_Context->services->Preferences_GetUsbAlivePeriodDraftMs)
#define Preferences_GetLineBlackWidthDraftMm (Screens_Context->services->Preferences_GetLineBlackWidthDraftMm)
#define Preferences_GetOledRotationDraftDeg (Screens_Context->services->Preferences_GetOledRotationDraftDeg)
#define Preferences_UpdateOledRotationFromMpuTest (Screens_Context->services->Preferences_UpdateOledRotationFromMpuTest)
#define Preferences_GetOledRotationMpuTestDeg (Screens_Context->services->Preferences_GetOledRotationMpuTestDeg)
#define Preferences_GetOledRotationMpuTestYawDeg (Screens_Context->services->Preferences_GetOledRotationMpuTestYawDeg)
#define Preferences_IsOledRotationMpuTestReady (Screens_Context->services->Preferences_IsOledRotationMpuTestReady)
#define Preferences_GetMotorMinPwmDraft (Screens_Context->services->Preferences_GetMotorMinPwmDraft)
#define Preferences_GetMotorMinPwmEditLabel (Screens_Context->services->Preferences_GetMotorMinPwmEditLabel)
#define Preferences_GetMotorMinPwmEditScreenCode (Screens_Context->services->Preferences_GetMotorMinPwmEditScreenCode)
#define mpuCalibrationEventManager (Screens_Context->services->mpuCalibrationEventManager)
#define motorSingleTestEventManager (Screens_Context->services->motorSingleTestEventManager)
#define MotorSingleTest_GetScreenCode (Screens_Context->services->MotorSingleTest_GetScreenCode)
#define MotorSingleTest_GetLabel (Screens_Context->services->MotorSingleTest_GetLabel)
#define MotorSingleTest_GetDirectionLabel (Screens_Context->services->MotorSingleTest_GetDirectionLabel)
#define MotorSingleTest_GetSpeedPercentDisplay (Screens_Context->services->MotorSingleTest_GetSpeedPercentDisplay)
#define MotorSingleTest_GetPwm (Screens_Context->services->MotorSingleTest_GetPwm)
#define MotorSingleTest_GetMinPwm (Screens_Context->services->MotorSingleTest_GetMinPwm)
#define MotorSingleTest_GetMaxPwm (Screens_Context->services->MotorSingleTest_GetMaxPwm)
#define balancePidGainEventManager (Screens_Context->services->balancePidGainEventManager)
#define balancePidLogEventManager (Screens_Context->services->balancePidLogEventManager)
#define BalancePid_GetCurrentGainScreenCode (Screens_Context->services->BalancePid_GetCurrentGainScreenCode)
#define BalancePid_GetCurrentGainLabel (Screens_Context->services->BalancePid_GetCurrentGainLabel)
#define BalancePid_GetCurrentGainDraft (Screens_Context->services->BalancePid_GetCurrentGainDraft)
#define BalancePid_GetLogDurationSec (Screens_Context->services->BalancePid_GetLogDurationSec)
#define BalancePid_GetLogAvailableBytes (Screens_Context->services->BalancePid_GetLogAvailableBytes)
#define BalancePid_GetLogEstimatedBytes (Screens_Context->services->BalancePid_GetLogEstimatedBytes)
#define MenuSys_RenderMenu (Screens_Context->services->MenuSys_RenderMenu)
#define MenuSys_NavigateBack (Screens_Context->services->MenuSys_NavigateBack)
#define MenuSys_SetCurrentScreenCode (Screens_Context->services->MenuSys_SetCurrentScreenCode)
#define MenuSys_SetCurrentMenuScreenCode (Screens_Context->services->MenuSys_SetCurrentMenuScreenCode)
#define MenuSys_GetCurrentScreenCode (Screens_Context->services->MenuSys_GetCurrentScreenCode)
#define MenuSys_GetCurrentScreenSource (Screens_Context->services->MenuSys_GetCurrentScreenSource)
#define MenuSys_IsItemVisible (Screens_Context->services->MenuSys_IsItemVisible)
#define MenuSys_IsFavorite (Screens_Context->services->MenuSys_IsFavorite)
#define MenuSys_IsFavoritesMenu (Screens_Context->services->MenuSys_IsFavoritesMenu)
#define MotionControl_IsArmed (Screens_Context->services->MotionControl_IsArmed)
#define MotionControl_GetStatus (Screens_Context->services->MotionControl_GetStatus)
#define Motor_SpeedPercentToDisplay (Screens_Context->services->Motor_SpeedPercentToDisplay)
#define MPU9250_GetLatest (Screens_Context->services->MPU9250_GetLatest)
#define OSK_Open (Screens_Context->services->OSK_Open)
#define OSK_OnLeft (Screens_Context->services->OSK_OnLeft)
#define OSK_OnRight (Screens_Context->services->OSK_OnRight)
#define OSK_OnSelect (Screens_Context->services->OSK_OnSelect)
#define OSK_OnBack (Screens_Context->services->OSK_OnBack)
#define OSK_Render (Screens_Context->services->OSK_Render)
#define OSK_IsActive (Screens_Context->services->OSK_IsActive)
#define OSK_GetText (Screens_Context->services->OSK_GetText)
#define Permission_Request (Screens_Context->services->Permission_Request)
#define Permission_IsRemoteNodeAuthorizedNow (Screens_Context->services->Permission_IsRemoteNodeAuthorizedNow)
#define TCRT5000_EmittersGroup5On (Screens_Context->services->TCRT5000_EmittersGroup5On)
#define TCRT5000_EmittersGroup5Off (Screens_Context->services->TCRT5000_EmittersGroup5Off)
#define TCRT5000_EmittersGroup5Set (Screens_Context->services->TCRT5000_EmittersGroup5Set)
#define TCRT5000_EmittersGroup3On (Screens_Context->services->TCRT5000_EmittersGroup3On)
#define TCRT5000_EmittersGroup3Off (Screens_Context->services->TCRT5000_EmittersGroup3Off)
#define TCRT5000_EmittersGroup3Set (Screens_Context->services->TCRT5000_EmittersGroup3Set)
#define TCRT5000_EmittersGroup3IsOn (Screens_Context->services->TCRT5000_EmittersGroup3IsOn)
#define TCRT5000_GetLineSensorDef (Screens_Context->services->TCRT5000_GetLineSensorDef)
#define TCRT5000_GetObjectSensorDef (Screens_Context->services->TCRT5000_GetObjectSensorDef)
#define TCRT5000_GetRaw (Screens_Context->services->TCRT5000_GetRaw)
#define TCRT5000_GetRawById (Screens_Context->services->TCRT5000_GetRawById)
#define TCRT5000_NormalizeForDisplay (Screens_Context->services->TCRT5000_NormalizeForDisplay)
#define TCRT5000_ReadRouteSensorsEx (Screens_Context->services->TCRT5000_ReadRouteSensorsEx)
#define TCRT5000_GetRouteAlignmentText (Screens_Context->services->TCRT5000_GetRouteAlignmentText)
#define UNER_App_GetBootloaderVersion (Screens_Context->services->UNER_App_GetBootloaderVersion)
#define UNER_App_ReportNotificationChanged (Screens_Context->services->UNER_App_ReportNotificationChanged)
#define UNER_App_GetRouterPacketSnapshot (Screens_Context->services->UNER_App_GetRouterPacketSnapshot)
#define WifiBridge_StartScan (Screens_Context->services->WifiBridge_StartScan)
#define WifiBridge_GetStatus (Screens_Context->services->WifiBridge_GetStatus)
#define WifiBridge_StartAP (Screens_Context->services->WifiBridge_StartAP)
#define WifiBridge_StopAP (Screens_Context->services->WifiBridge_StopAP)
#define WifiBridge_SendCommand (Screens_Context->services->WifiBridge_SendCommand)
#define WifiBridge_SendEspReboot (Screens_Context->services->WifiBridge_SendEspReboot)
#define WifiBridge_ReportCarModeChanged (Screens_Context->services->WifiBridge_ReportCarModeChanged)
#define WifiBridge_IsWaitingValidation (Screens_Context->services->WifiBridge_IsWaitingValidation)
#define WifiBridge_GetActiveBackend (Screens_Context->services->WifiBridge_GetActiveBackend)
#define WifiBridge_IsConnected (Screens_Context->services->WifiBridge_IsConnected)
#define WifiBridge_GetBackendLabel (Screens_Context->services->WifiBridge_GetBackendLabel)
#define AppPreferences_IsScreenLockEnabled (Screens_Context->services->AppPreferences_IsScreenLockEnabled)
#define AppPreferences_IsWifiApFallbackEnabled (Screens_Context->services->AppPreferences_IsWifiApFallbackEnabled)
#define AppPreferences_GetScreenLockTimeoutSec (Screens_Context->services->AppPreferences_GetScreenLockTimeoutSec)
#define AppPreferences_GetWifiApSsid (Screens_Context->services->AppPreferences_GetWifiApSsid)
#define AppPreferences_GetWifiApPassword (Screens_Context->services->AppPreferences_GetWifiApPassword)
#define AppPreferences_GetEspNotifWatchdogLimit (Screens_Context->services->AppPreferences_GetEspNotifWatchdogLimit)
#define AppPreferences_SetScreenLockTimeoutSec (Screens_Context->services->AppPreferences_SetScreenLockTimeoutSec)
#define ssd1306_SetColor (Screens_Context->services->ssd1306_SetColor)
#define ssd1306_DrawPixel (Screens_Context->services->ssd1306_DrawPixel)
#define ssd1306_DrawBitmap (Screens_Context->services->ssd1306_DrawBitmap)
#define ssd1306_DrawBitmap_MSB (Screens_Context->services->ssd1306_DrawBitmap_MSB)
#define ssd1306_DrawLine (Screens_Context->services->ssd1306_DrawLine)
#define ssd1306_DrawVerticalLine (Screens_Context->services->ssd1306_DrawVerticalLine)
#define ssd1306_DrawHorizontalLine (Screens_Context->services->ssd1306_DrawHorizontalLine)
#define ssd1306_DrawRect (Screens_Context->services->ssd1306_DrawRect)
#define ssd1306_FillRect (Screens_Context->services->ssd1306_FillRect)
#define ssd1306_DrawLinearProgress (Screens_Context->services->ssd1306_DrawLinearProgress)
#define ssd1306_WriteChar (Screens_Context->services->ssd1306_WriteChar)
#define ssd1306_WriteString (Screens_Context->services->ssd1306_WriteString)
#define ssd1306_SetCursor (Screens_Context->services->ssd1306_SetCursor)
#define ssd1306_Clear (Screens_Context->services->ssd1306_Clear)
#define ssd1306_PresentFramebuffer (Screens_Context->services->ssd1306_PresentFramebuffer)
#define ssd1306_GetErrorCount (Screens_Context->services->ssd1306_GetErrorCount)
#define ssd1306_SetContrast (Screens_Context->services->ssd1306_SetContrast)
#define ssd1306_GetDefaultContrast (Screens_Context->services->ssd1306_GetDefaultContrast)
#define ssd1306_SetRotation (Screens_Context->services->ssd1306_SetRotation)
#define ssd1306_RequestPageUpdate (Screens_Context->services->ssd1306_RequestPageUpdate)
#define ssd1306_UpdateScreen (Screens_Context->services->ssd1306_UpdateScreen)
#define ssd1306_UpdateScreenCompleted (Screens_Context->services->ssd1306_UpdateScreenCompleted)
#define WifiBridge_GetRuntimeCredentials (Screens_Context->services->WifiBridge_GetRuntimeCredentials)
#define WIFIDEFAULTSEARCHTIMEOUT 1000u
#define Screens_NowMs() (Screens_Context->services->now_ms())
#define MENU_VISIBLE_ITEMS 3
#define MENU_ITEM_Y0 4
#define MENU_ITEM_SPACING 21
#define WIFI_RESULTS_MENU_MAX_ITEMS (WIFI_SCAN_MAX_NETWORKS + 2u)
#define dashboardModeReportPending (Screens_Context->state.dashboardModeReportPending)
#define dashboardConnectivityDirty (Screens_Context->state.dashboardConnectivityDirty)
#define irValuesRawView (Screens_Context->state.irValuesRawView)
#define irValuesSessionMode (Screens_Context->state.irValuesSessionMode)
#define irValuesSavedGroup5 (Screens_Context->state.irValuesSavedGroup5)
#define irValuesSavedGroup3 (Screens_Context->state.irValuesSavedGroup3)
#define irValuesAmbientMode (Screens_Context->state.irValuesAmbientMode)
#define routeAlignmentDetailView (Screens_Context->state.routeAlignmentDetailView)
#define mpuValuesViewIndex (Screens_Context->state.mpuValuesViewIndex)
#define unerRouterTransportId (Screens_Context->state.unerRouterTransportId)
#define unerRouterTxView (Screens_Context->state.unerRouterTxView)
#define dashboardWebStatusRequestedAt (Screens_Context->state.dashboardWebStatusRequestedAt)
#define espResetModeItems (Screens_Context->state.espResetModeItems)
#define espResetModeMenu (Screens_Context->state.espResetModeMenu)
#define wifiApEnableProtectionAfterPassword (Screens_Context->state.wifiApEnableProtectionAfterPassword)
#define s_oskState (Screens_Context->state.s_oskState)
#define s_savedCtx (Screens_Context->state.s_savedCtx)
#define s_drawHandle (Screens_Context->state.s_drawHandle)
#define s_initialized (Screens_Context->state.s_initialized)
#define s_userOnComplete (Screens_Context->state.s_userOnComplete)
#define s_userOnCancel (Screens_Context->state.s_userOnCancel)
#define s_userCtx (Screens_Context->state.s_userCtx)
#define screenLockLocked (Screens_Context->state.screenLockLocked)
#define screenLockIdleTicks10ms (Screens_Context->state.screenLockIdleTicks10ms)
#define screenLockTimeoutDraftSec (Screens_Context->state.screenLockTimeoutDraftSec)
#define screenLockPreviousRenderFn (Screens_Context->state.screenLockPreviousRenderFn)
#define screenLockPreviousEventManagerFn (Screens_Context->state.screenLockPreviousEventManagerFn)
#define screenLockPreviousAllowPeriodicRefresh (Screens_Context->state.screenLockPreviousAllowPeriodicRefresh)
#define screenLockPreviousInsideMenu (Screens_Context->state.screenLockPreviousInsideMenu)
#define oled_canvas (Screens_Context->state.oled_canvas)
#endif
