kobachajchir/ProyectoRobotica2/AutoFinalRobo2-Atmega/src/services/afr2_app.c

/* AFR2-20261030-01: AutoMicro dashboard adaptation and linked icons; prior authors retained. */
/* AFR2-20261029-27: quick controls/radar/PWM/WS integration; prior authors retained. */
#include "afr2_build_info.h"
/* AFR2-20261023-19. Application wrappers: own AVR services, no F4 globals.
 * Only this wrapper prepares presentation snapshots; renderer stays pure.
 */
#include "afr2_app.h"
#include "afr2_debug.h"
#include <stdio.h>
#include <string.h>
#include <math.h>
#include <avr/pgmspace.h>
static void wipe(void *data,uint16_t n){volatile uint8_t *p=data;while(n--)*p++=0;}
static uint8_t config_dirty(const Afr2Config *a,const Afr2Config *b){
    if(a->line_kind!=b->line_kind || a->line_invert!=b->line_invert || a->line_calibrated!=b->line_calibrated || a->motor_signs!=b->motor_signs || a->motor_ready!=b->motor_ready || a->hall_wired!=b->hall_wired || a->hall_signs!=b->hall_signs || a->hall_cw_mask!=b->hall_cw_mask || a->geometry_ready!=b->geometry_ready || a->encoder_steps!=b->encoder_steps || a->encoder_invert!=b->encoder_invert || a->contrast!=b->contrast || a->rotation!=b->rotation || a->pwm_limit!=b->pwm_limit || a->ramp_step!=b->ramp_step || a->radar_range!=b->radar_range || a->radar_trace!=b->radar_trace || a->long_press_ms!=b->long_press_ms || a->wifi_retry_s!=b->wifi_retry_s || a->servo_inverted!=b->servo_inverted || a->wheel_mm!=b->wheel_mm || a->radius_sum_mm!=b->radius_sum_mm || a->speed_limit!=b->speed_limit || a->test_ms!=b->test_ms || a->kp!=b->kp || a->ki!=b->ki || a->kd!=b->kd || a->line_kp!=b->line_kp || a->line_speed!=b->line_speed)return 1;
    for(uint8_t i=0;i<5;i++)if(a->line_threshold[i]!=b->line_threshold[i])return 1;
    for(uint8_t i=0;i<4;i++)if(a->counts_per_rev[i]!=b->counts_per_rev[i])return 1;
    return 0;
}
static uint8_t available(void *ctx,uint8_t action,int32_t arg);
/* AFR2-20261108-04: arranque comun de la prueba de distancia (menu Iniciar y confirmacion del encoder). */
static uint8_t odom_start(Afr2App *a) {
    Afr2Product *p=a->product;
    int32_t d=(int32_t)a->odom_cm*10,e=d*707/1000,x=0,y=0;
    switch(a->odom_dir){case 0:x=d;break;case 1:x=-d;break;case 2:y=d;break;case 3:y=-d;break;
    case 4:x=e;y=e;break;case 5:x=e;y=-e;break;case 6:x=-e;y=e;break;default:x=-e;y=-e;break;}
    uint8_t rc=AFR2_OK;
    if(Afr2Head_State()->running)rc=AFR2_BUSY;
    else {if(p->origin==AFR2_SOURCE_WEB)Afr2Product_HaltMotion(p);p->origin=AFR2_SOURCE_LOCAL;p->local_timeout_ms=5000;p->local_started_ms=p->now;}
    if(rc)return rc;
    rc=Afr2Product_StartGoto(p,x,y);if(!rc)p->local_timeout_ms=60000;return rc;
}
static int32_t value(void *ctx,uint8_t action) {
    Afr2App *a=ctx;Afr2Product *p=a->product;Afr2Config *c=&p->config;
    const Afr2SensorHead *h=Afr2Head_State();
    switch(action) {
    case AFR2_A_WIFI_FALLBACK:return p->wifi.policy_valid?p->wifi.ask_fallback:2;
    case AFR2_A_WIFI_AP_TOGGLE:return p->wifi.ap_active;
    case AFR2_A_WIFI_CONNECT:return p->wifi.draft_ready;
    case AFR2_A_WIFI_CONNECTED:return p->wifi.available?(p->wifi.sta_connected?1:0):2;
    case AFR2_A_WIFI_COUNT:return p->wifi.pending?0:p->wifi.network_count;
    case AFR2_A_WIFI_PAGE_INDEX:return p->wifi.scan_page;
    case AFR2_A_WIFI_TOTAL:return p->wifi.scan_total;
    case AFR2_A_WIFI_BUSY:return p->wifi.pending;
    case AFR2_A_WIFI_SCAN_STATE:return (p->wifi.op==AFR2_WIFI_SCAN || p->wifi.op==AFR2_WIFI_PAGE) && p->wifi.pending?1:(p->wifi.op==AFR2_WIFI_SCAN || p->wifi.op==AFR2_WIFI_PAGE) && p->wifi.state>=4?3:p->wifi.scan_id?2:0;
    case AFR2_A_WIFI_ROW_AUTH:return p->wifi.network_security[p->wifi.selected_network];
    case AFR2_A_DIRTY:return config_dirty(c,&a->saved_config);
    case AFR2_A_LONG_MS:return c->long_press_ms;
    case AFR2_A_WIFI_RETRY_S:return c->wifi_retry_s; /* AFR2-20261108-06 */
    case AFR2_A_POWER:return a->local_power_percent;
    case AFR2_A_ESP_TIMEOUT:return a->diag_timeout;
    case AFR2_A_WHEEL_TOGGLE:return p->mode==AFR2_WHEEL_TEST && !p->stopped;
    case AFR2_A_GOTO_TOGGLE:case AFR2_A_ODOM_TOGGLE:return p->mode==AFR2_GOTO && !p->stopped;
    case AFR2_A_ODOM_PROPOSE:case AFR2_A_ODOM_STATE:return ((int32_t)a->odom_token<<8)|a->odom_state;
    case AFR2_A_ODOM_DIR:return a->odom_dir;
    case AFR2_A_ODOM_CM:return a->odom_cm;
    case AFR2_A_RADAR_RANGE:return c->radar_range;
    case AFR2_A_RADAR_TRACE:return c->radar_trace;
    case AFR2_A_RADAR_DIRTY:return c->radar_range!=a->saved_config.radar_range || c->radar_trace!=a->saved_config.radar_trace;
    case AFR2_A_RADAR_TOGGLE:return h->running;
    case AFR2_A_US_TOGGLE:return h->sampling;
    case AFR2_A_IR_TOGGLE:return h->ir_enabled;
    case AFR2_A_SERVO_TOGGLE:return h->enabled;
    case AFR2_A_MOTOR_TOGGLE:return c->motor_ready;
    case AFR2_A_LINE_TOGGLE:return p->mode==AFR2_LINE && !p->stopped;
    case AFR2_A_SERVO_ANGLE:return h->target_us?(h->inverted?180-((int32_t)(h->target_us-1000)*180+500)/1000:((int32_t)(h->target_us-1000)*180+500)/1000):h->angle;
    case AFR2_A_RADAR_MIN:return h->min_angle;case AFR2_A_RADAR_MAX:return h->max_angle;case AFR2_A_RADAR_SPEED:return h->speed;
    case AFR2_A_RADAR_SETTLE:return h->settle_ms;case AFR2_A_US_INTERVAL:return h->interval_ms;case AFR2_A_SERVO_INVERT:return c->servo_inverted;
    case AFR2_A_SPEED:return c->speed_limit;case AFR2_A_LINE_SPEED:return c->line_speed;
    case AFR2_A_LINE_KP:return c->line_kp;case AFR2_A_GOTO_X:return p->target_x;case AFR2_A_GOTO_Y:return p->target_y;
    case AFR2_A_WHEEL:return p->selected_wheel;case AFR2_A_TEST_PWM:return a->test_pwm;case AFR2_A_TEST_MS:return c->test_ms;
    case AFR2_A_SERVO_US:return a->servo_us;case AFR2_A_LINE_KIND:return c->line_kind;
    case AFR2_A_LINE_INVERT:return c->line_invert;case AFR2_A_LINE_CHANNEL:return a->line_channel;
    case AFR2_A_LINE_THRESHOLD:return c->line_threshold[a->line_channel];case AFR2_A_MOTOR_SIGNS:return c->motor_signs;
    case AFR2_A_PWM_LIMIT:return c->pwm_limit;case AFR2_A_RAMP:return c->ramp_step;
    case AFR2_A_KP:return c->kp;case AFR2_A_KI:return c->ki;case AFR2_A_KD:return c->kd;
    case AFR2_A_MOTOR_READY:return c->motor_ready;case AFR2_A_WHEEL_MM:return c->wheel_mm;
    case AFR2_A_HALL_SAVE:return a->hall_draft_mask;
    case AFR2_A_HALL_END:return p->hall_delta;
    case AFR2_A_SAVE:return p->prefs_state;
    case AFR2_A_RADIUS_MM:return c->radius_sum_mm;case AFR2_A_HALL_WIRED:return c->hall_wired;
    case AFR2_A_GEOM_READY:return c->geometry_ready;case AFR2_A_ENC_STEPS:return c->encoder_steps;
    case AFR2_A_ENC_INVERT:return c->encoder_invert;case AFR2_A_CONTRAST:return c->contrast;
    case AFR2_A_ROTATION:return c->rotation;case AFR2_A_WIFI_MODE:return p->wifi.mode;
    default:return 0;
    }
}
static uint8_t wifi_request(Afr2Product *p,uint8_t op) {
    Afr2Wifi *w=&p->wifi;
    if(!p->extension_ready || (!w->available && op!=AFR2_WIFI_CANCEL && op!=AFR2_WIFI_STATUS))return AFR2_UNAVAILABLE;
    if(w->pending)return AFR2_BUSY;
    if(op==AFR2_WIFI_SCAN){memset(w->network_security,0,sizeof(w->network_security));w->network_count=0;w->selected_network=0;memset(w->networks,0,sizeof(w->networks));}
    ++w->id;if(!w->id)++w->id;w->op=op;w->pending=1;w->claimed=0;w->job_ms=p->now;
    return AFR2_OK;
}
static uint8_t local_command(Afr2Product *p) {
    if(Afr2Head_State()->running)return AFR2_BUSY;
    if(p->origin==AFR2_SOURCE_WEB)Afr2Product_HaltMotion(p);
    p->origin=AFR2_SOURCE_LOCAL;p->local_timeout_ms=5000;p->local_started_ms=p->now;return AFR2_OK;
}
static uint8_t numeric_range(uint8_t action,int32_t v) {
    Afr2MenuNode node;Afr2MenuItem item;
    for(uint8_t n=0;n<AFR2_N_COUNT;n++){
        Afr2Menu_Node(n,&node);
        for(uint8_t i=0;i<node.count;i++){
            Afr2Menu_Item(n,i,&item);
            if(item.action==action && item.step)return v>=item.min && v<=item.max &&
                ((action!=AFR2_A_ENC_STEPS) || v==2 || v==4);
        }
    }
    return 1;
}
uint8_t Afr2App_RemoteUiAllowed(uint8_t action) {
    switch(action) {
    case AFR2_A_WIFI_FALLBACK:case AFR2_A_WIFI_AP_TOGGLE:case AFR2_A_WIFI_DISCONNECT:case AFR2_A_WIFI_CHANGE_MODE:case AFR2_A_WIFI_SET_MODE:case AFR2_A_ESP_TEST:case AFR2_A_WHEEL_TOGGLE:case AFR2_A_GOTO_TOGGLE:case AFR2_A_ODOM_TOGGLE:case AFR2_A_ODOM_PROPOSE:case AFR2_A_ODOM_ANSWER:case AFR2_A_POWER:case AFR2_A_QUICK_MODE:case AFR2_A_RADAR_TOGGLE:case AFR2_A_US_TOGGLE:case AFR2_A_IR_TOGGLE:case AFR2_A_SERVO_TOGGLE:case AFR2_A_MOTOR_TOGGLE:case AFR2_A_LINE_TOGGLE:
    case AFR2_A_SERVO_EDIT_BEGIN:case AFR2_A_SERVO_EDIT_END:case AFR2_A_RADAR_DISCARD:
    case AFR2_A_MOVE:case AFR2_A_LINE_START:
    case AFR2_A_GOTO_START:case AFR2_A_WHEEL_START:case AFR2_A_SERVO_APPLY:case AFR2_A_SERVO_OFF:
    case AFR2_A_HALL_BEGIN:case AFR2_A_HALL_END:case AFR2_A_HALL_SAVE:case AFR2_A_HALL_CANCEL:
    case AFR2_A_LINE_CONFIRM:case AFR2_A_SAVE:case AFR2_A_DISCARD:case AFR2_A_CLEAR_FAULT:
    case AFR2_A_WIFI_READ_CREDENTIALS:case AFR2_A_WIFI_CONNECT:case AFR2_A_KEYBOARD:return 0;
    case AFR2_A_REBOOT_MEGA:case AFR2_A_REBOOT_ESP:return 0;
    case AFR2_A_SERVO_ANGLE:case AFR2_A_SERVO_CENTER:case AFR2_A_RADAR_START:case AFR2_A_RADAR_STOP:
    case AFR2_A_RADAR_MIN:case AFR2_A_RADAR_MAX:case AFR2_A_RADAR_SPEED:case AFR2_A_RADAR_SETTLE:case AFR2_A_US_INTERVAL:case AFR2_A_SERVO_INVERT:return 0;
    default:return 1;
    }
}
static uint8_t invoke(void *ctx,uint8_t action,int32_t v,const void *data) {
    Afr2App *a=ctx;Afr2Product *p=a->product;Afr2Config old=p->config,*c=&p->config;
    if(!numeric_range(action,v))return AFR2_BAD;
    uint8_t visual_choice=a->ui->node==AFR2_N_SAVE_CONFIRM && a->ui->confirm_save==AFR2_A_SAVE && a->ui->confirm_discard==AFR2_A_RADAR_DISCARD && (action==AFR2_A_SAVE || action==AFR2_A_RADAR_DISCARD);
    if(a->remote_ui && !Afr2App_RemoteUiAllowed(action) && !visual_choice)return AFR2_DENIED;
    /* Configuration/edit changes require stopped outputs and no EEPROM write in flight. */
    uint8_t setting=action==AFR2_A_SPEED || action==AFR2_A_LINE_SPEED || action==AFR2_A_LINE_KP ||
        (action>=AFR2_A_TEST_MS && action<=AFR2_A_TEST_MS) ||
        (action>=AFR2_A_LINE_KIND && action<=AFR2_A_ENC_INVERT) ||
        action==AFR2_A_LONG_MS || action==AFR2_A_WIFI_RETRY_S || action==AFR2_A_CONTRAST || action==AFR2_A_ROTATION || action==AFR2_A_RADAR_RANGE || action==AFR2_A_RADAR_TRACE;
    if(setting && ((!p->stopped && !(action==AFR2_A_MOTOR_READY && !v)) || p->prefs_state==1 || p->hall_measuring))return AFR2_BUSY;
    const Afr2SensorHead *h=Afr2Head_State();
    if(action==AFR2_A_SERVO_INVERT){
        if(v<0 || v>1 || !p->stopped || h->enabled || h->target_us || h->running || p->prefs_state==1)return AFR2_BUSY;
        uint8_t rc=Afr2Head_Configure(h->min_angle,h->max_angle,h->speed,h->settle_ms,h->interval_ms,v);
        if(!rc){c->servo_inverted=v;}return rc;
    }
    if(action>=AFR2_A_SERVO_ANGLE && action<=AFR2_A_SERVO_INVERT){
        if(!p->stopped || p->fault || p->hall_measuring)return AFR2_BUSY;
        switch(action){
        case AFR2_A_SERVO_ANGLE:return Afr2Head_Servo(1,v);case AFR2_A_SERVO_CENTER:return Afr2Head_Servo(2,90);
        case AFR2_A_RADAR_START:if(p->sequence.state>=1 && p->sequence.state<=3)return AFR2_BUSY;return Afr2Head_Start();case AFR2_A_RADAR_STOP:Afr2Head_Stop();return AFR2_OK;
        default:return Afr2Head_Configure(action==AFR2_A_RADAR_MIN?v:h->min_angle,action==AFR2_A_RADAR_MAX?v:h->max_angle,
            action==AFR2_A_RADAR_SPEED?v:h->speed,action==AFR2_A_RADAR_SETTLE?v:h->settle_ms,action==AFR2_A_US_INTERVAL?v:h->interval_ms,action==AFR2_A_SERVO_INVERT?v:h->inverted);
        }
    }
    switch(action) {
    case AFR2_A_LONG_MS:if(v<800 || v>3000 || v%100)return AFR2_BAD;c->long_press_ms=v;break;
    case AFR2_A_WIFI_RETRY_S:if(v<10 || v>300 || v%10)return AFR2_BAD;c->wifi_retry_s=v;break; /* AFR2-20261108-06 */
    case AFR2_A_WIFI_ASK: /* AFR2-20261108-06: 1 Iniciar AP, 2 Seguir esperando (el ESP recibe los segundos de la preferencia) */
        if(v!=1 && v!=2)return AFR2_BAD;
        {uint8_t r=wifi_request(p,v==1?AFR2_WIFI_AP_START:AFR2_WIFI_WAIT);
         if(!r && v==1)Afr2Ui_NotifyFlash(a->ui,0,PSTR("Wi-Fi"),PSTR("Iniciando AP"),2500); /* AFR2-20261109-01 */
         return r;}
    case AFR2_A_POWER:if(v<0 || v>100)return AFR2_BAD;if(!p->stopped)return AFR2_BUSY;a->local_power_percent=v;a->ui->power_percent=v;a->ui->power_known=1;a->ui->power_changed_ms=p->now;return AFR2_OK;
    case AFR2_A_ESP_TIMEOUT:if(v<1000 || v>5000 || v%250)return AFR2_BAD;if(a->diag_state==1)return AFR2_BUSY;a->diag_timeout=v;return AFR2_OK;
    case AFR2_A_ESP_TEST:
        if(a->diag_state==1)return AFR2_BUSY;
        if(!p->extension_ready)return AFR2_UNAVAILABLE;
        if(!++a->diag_job){++a->diag_job;}a->diag_state=1;a->diag_started=p->now;return AFR2_OK;
    case AFR2_A_WHEEL_TOGGLE:
        if(p->mode==AFR2_WHEEL_TEST && !p->stopped)return Afr2Product_Stop(p)?AFR2_OK:AFR2_FAILED;
        {uint8_t rc=local_command(p);if(rc)return rc;return Afr2Product_Wheel(p,p->selected_wheel,a->test_pwm,c->test_ms);}
    case AFR2_A_ODOM_DIR:if(v<0 || v>7)return AFR2_BAD;if(!p->stopped)return AFR2_BUSY;a->odom_dir=v;return AFR2_OK;
    case AFR2_A_ODOM_CM:if(v<5 || v>100 || v%5)return AFR2_BAD;if(!p->stopped)return AFR2_BUSY;a->odom_cm=v;return AFR2_OK;
    case AFR2_A_ODOM_TOGGLE:
        /* AFR2-20261108-03: prueba de distancia por GOTO relativo (ver odom_start). */
        if(p->mode==AFR2_GOTO && !p->stopped)return Afr2Product_Stop(p)?AFR2_OK:AFR2_FAILED;
        return odom_start(a);
    case AFR2_A_ODOM_PROPOSE: {
        /* AFR2-20261108-04: v = (token<<16)|(dir<<8)|cm. Abre la pantalla de confirmacion en el auto. */
        uint16_t token=(uint16_t)((uint32_t)v>>16);uint8_t dir=(uint8_t)(v>>8),cm=(uint8_t)v;
        if(v<0 || !token || dir>7 || cm<5 || cm>100 || cm%5)return AFR2_BAD;
        uint8_t node=a->ui->node;
        if(!p->stopped || p->fault || p->prefs_state==1 || p->hall_measuring || a->ui->touch_active || a->ui->keyboard || a->ui->edit ||
           node==AFR2_N_SAVE_CONFIRM || node==AFR2_N_HALL_PICK || node==AFR2_N_HALL_COUNT || node==AFR2_N_ENCODER_TEST || node==AFR2_N_ODOM_RUN || node==AFR2_N_WIFI_ASK)return AFR2_BUSY;
        {uint8_t rc=available(a,AFR2_A_ODOM_TOGGLE,0);if(rc)return rc;}
        a->odom_dir=dir;a->odom_cm=cm;a->odom_token=token;a->odom_state=1;a->odom_ask_ms=p->now;
        if(node!=AFR2_N_ODOM_ASK)Afr2Ui_Open(a->ui,AFR2_N_ODOM_ASK);else a->ui->redraw=true;
        return AFR2_OK;
    }
    case AFR2_A_ODOM_ANSWER: {
        if(a->odom_state!=1)return AFR2_UNAVAILABLE;
        if(!v){a->odom_state=3;return AFR2_OK;}
        {uint8_t rc=odom_start(a);a->odom_state=rc?4:2;return rc;}
    }
    case AFR2_A_GOTO_TOGGLE:
        if(p->mode==AFR2_GOTO && !p->stopped)return Afr2Product_Stop(p)?AFR2_OK:AFR2_FAILED;
        {uint8_t rc=local_command(p);if(rc)return rc;rc=Afr2Product_StartGoto(p,p->target_x,p->target_y);if(!rc)p->local_timeout_ms=60000;return rc;}
    case AFR2_A_RADAR_RANGE:if(v<0 || v>3)return AFR2_BAD;c->radar_range=v;break;
    case AFR2_A_RADAR_TRACE:if(v<0 || v>1)return AFR2_BAD;c->radar_trace=v;break;
    case AFR2_A_RADAR_DISCARD:
        if(p->prefs_state==1)return AFR2_BUSY;
        c->radar_range=a->saved_config.radar_range;c->radar_trace=a->saved_config.radar_trace;return AFR2_OK;
    case AFR2_A_US_TOGGLE:Afr2Head_SetSampling(!h->sampling);return AFR2_OK; /* AFR2-20261108-10; off also stops the radar (-13) */
    case AFR2_A_IR_TOGGLE: /* AFR2-20261108-13: no motors needed; off stops a running line follow */
        if(h->ir_enabled && p->mode==AFR2_LINE && !p->stopped)Afr2Product_HaltMotion(p);
        Afr2Head_SetIr(!h->ir_enabled);return AFR2_OK;
    case AFR2_A_RADAR_TOGGLE:
        if(h->running){Afr2Head_Stop();return AFR2_OK;}
        if(!p->stopped || p->fault || p->hall_measuring || (p->sequence.state>=1 && p->sequence.state<=3))return AFR2_BUSY;
        return Afr2Head_Start();
    case AFR2_A_SERVO_TOGGLE:
        if(h->enabled || h->target_us){Afr2Head_Stop();return AFR2_OK;}
        if(!p->stopped || p->fault || p->hall_measuring)return AFR2_BUSY;
        return Afr2Head_Servo(1,h->angle);
    case AFR2_A_MOTOR_TOGGLE:
        if(p->prefs_state==1 || p->hall_measuring)return AFR2_BUSY;
        if(c->motor_ready){Afr2Product_HaltMotion(p);c->motor_ready=0;}
        else {if(!p->stopped || p->fault)return AFR2_DENIED;c->motor_ready=1;}
        return AFR2_OK;
    case AFR2_A_LINE_TOGGLE:
        if(p->mode==AFR2_LINE && !p->stopped){Afr2Product_HaltMotion(p);return AFR2_OK;}
        {uint8_t r=local_command(p);if(r)return r;r=Afr2Product_StartLine(p);if(!r)p->local_timeout_ms=30000;return r;}
    case AFR2_A_SERVO_EDIT_BEGIN:
        if(!p->stopped || p->fault || p->hall_measuring || (p->sequence.state>=1 && p->sequence.state<=3))return AFR2_BUSY;
        Afr2Head_Pause();
        if(!h->target_us)return Afr2Head_Servo(1,h->angle);
        return AFR2_OK;
    case AFR2_A_SERVO_EDIT_END:
        if(!p->stopped || p->fault || p->hall_measuring){Afr2Head_CancelResume();return AFR2_OK;}
        Afr2Head_Resume();return AFR2_OK;
    case AFR2_A_QUICK_MODE:
        if(v!=AFR2_IDLE && v!=AFR2_MANUAL)return AFR2_BAD;
        if(p->fault)return AFR2_DENIED;
        if(v==AFR2_IDLE)return Afr2Product_Stop(p) && p->mode==AFR2_IDLE?AFR2_OK:AFR2_FAILED;
        if(!p->stopped || p->hall_measuring || p->prefs_state==1 || p->origin==AFR2_SOURCE_WEB || (p->sequence.state>=1 && p->sequence.state<=3))return AFR2_BUSY;
        p->mode=AFR2_MANUAL;return AFR2_OK;
    case AFR2_A_STOP:return Afr2Product_Stop(p)?AFR2_OK:AFR2_FAILED;
    case AFR2_A_BATTERY_MEASURE:Afr2Battery_Measure(&p->sensors);return AFR2_OK;
    case AFR2_A_SPEED:c->speed_limit=v;if(c->line_speed>v)c->line_speed=v;break;
    case AFR2_A_MOVE: {
        uint8_t permission=Afr2Product_PwmStatus(p);if(permission)return permission;
        uint8_t granted=local_command(p);if(granted)return granted;
        int16_t s=a->local_power_percent,vx=0,vy=0,wz=0;
        switch(v){case 0:vx=s;break;case 1:vx=-s;break;case 2:vy=s;break;case 3:vy=-s;break;
        case 4:vx=s;vy=s;break;case 5:vx=s;vy=-s;break;case 6:vx=-s;vy=s;break;case 7:vx=-s;vy=-s;break;
        case 8:wz=s;break;case 9:wz=-s;break;default:return AFR2_BAD;}
        return Afr2Product_DrivePwm(p,vx,vy,wz,500);
    }
    case AFR2_A_LINE_SPEED:c->line_speed=v;break;case AFR2_A_LINE_KP:c->line_kp=v;break;
    case AFR2_A_LINE_START:{uint8_t r=local_command(p);if(r)return r;
        r=Afr2Product_StartLine(p);if(!r)p->local_timeout_ms=30000;return r;}
    case AFR2_A_GOTO_X:if(!p->stopped)return AFR2_BUSY;p->target_x=v;return AFR2_OK;
    case AFR2_A_GOTO_Y:if(!p->stopped)return AFR2_BUSY;p->target_y=v;return AFR2_OK;
    case AFR2_A_GOTO_START:{uint8_t r=local_command(p);if(r)return r;
        r=Afr2Product_StartGoto(p,p->target_x,p->target_y);if(!r)p->local_timeout_ms=60000;return r;}
    case AFR2_A_WHEEL:
        if(v<0 || v>3 || p->hall_measuring || !p->stopped)return AFR2_BAD;
        if(p->selected_wheel!=v){p->hall_delta=0;p->hall_bad=0;}p->selected_wheel=v;return AFR2_OK;
    case AFR2_A_TEST_PWM:if(v<-255 || v>255 || !p->stopped)return AFR2_BAD;a->test_pwm=v;return AFR2_OK;
    case AFR2_A_TEST_MS:c->test_ms=v;break;
    case AFR2_A_WHEEL_START:{uint8_t r=local_command(p);if(r)return r;return Afr2Product_Wheel(p,p->selected_wheel,a->test_pwm,c->test_ms);}
    case AFR2_A_HALL_BEGIN:
        if(Afr2Head_State()->running || p->prefs_state==1 || a->hall_saving)return AFR2_BUSY;
        Afr2Product_HallBegin(p);if(!p->hall_measuring)return AFR2_UNAVAILABLE;
        /* Invalidate only this wheel, durably. Other wheels retain CPR/sign. */
        c->counts_per_rev[p->selected_wheel]=0;
        if(!Afr2Prefs_Save(c)){*c=old;p->hall_measuring=0;return AFR2_FAILED;}
        p->prefs_state=1;p->pose_valid=p->odom_ready=0;
        a->hall_draft_mask&=(uint8_t)~(1u<<p->selected_wheel);
        a->hall_draft_negative&=(uint8_t)~(1u<<p->selected_wheel);return AFR2_OK;
    case AFR2_A_HALL_END: {
        uint8_t r=Afr2Product_HallEnd(p);if(r)return r;
        uint8_t bit=(uint8_t)(1u<<p->selected_wheel);
        a->hall_draft[p->selected_wheel]=(uint32_t)(p->hall_delta<0?-p->hall_delta:p->hall_delta);
        a->hall_draft_mask|=bit;
        if(p->hall_delta<0)a->hall_draft_negative|=bit;else a->hall_draft_negative&=(uint8_t)~bit;
        return AFR2_OK;
    }
    case AFR2_A_HALL_SAVE:
        if(p->prefs_state==1 || a->hall_saving || !p->stopped)return AFR2_BUSY;
        if(p->hall_measuring || !a->hall_draft_mask)return AFR2_BAD;
        for(uint8_t i=0;i<4;i++)if(a->hall_draft_mask&(1u<<i)) {
            c->counts_per_rev[i]=a->hall_draft[i];c->hall_cw_mask|=(1u<<i);
            if(a->hall_draft_negative&(1u<<i))c->hall_signs^=(1u<<i);
        }
        if(!Afr2Prefs_Save(c)){*c=old;return AFR2_FAILED;}
        a->hall_saving=a->hall_draft_mask;p->prefs_state=1;
        p->pose_valid=0;p->odom_ready=0;p->notice=0;return AFR2_OK;
    case AFR2_A_HALL_CANCEL:
        if(a->hall_saving)return AFR2_BUSY;
        if(!a->remote_ui && p->origin==AFR2_SOURCE_LOCAL && !p->stopped)Afr2Product_Stop(p);
        /* v=1 cancels only the current attempt; completed wheel drafts survive. */
        if(v==2){a->hall_draft_mask&=(uint8_t)~(1u<<p->selected_wheel);a->hall_draft_negative&=(uint8_t)~(1u<<p->selected_wheel);}
        else if(v!=1){a->hall_draft_mask=0;a->hall_draft_negative=0;}
        p->hall_measuring=0;p->hall_delta=0;p->hall_bad=0;return AFR2_OK;
    case AFR2_A_SERVO_US:if(v<1000 || v>2000)return AFR2_BAD;a->servo_us=v;return AFR2_OK;
    case AFR2_A_SERVO_APPLY:if(h->running || !p->stopped)return AFR2_BUSY;Afr2Servo_Set(a->servo_us);return AFR2_OK;
    case AFR2_A_SERVO_OFF:Afr2Head_Stop();return AFR2_OK;
    case AFR2_A_SAVE:if(!p->stopped || p->prefs_state==1)return AFR2_BUSY;Afr2Product_Save(p);return p->prefs_state==1?AFR2_OK:AFR2_FAILED;
    case AFR2_A_DISCARD:if(!p->stopped || p->prefs_state==1 || p->hall_measuring)return AFR2_BUSY;
        if(c->servo_inverted!=a->saved_config.servo_inverted){uint8_t rc=Afr2Head_Configure(h->min_angle,h->max_angle,h->speed,h->settle_ms,h->interval_ms,a->saved_config.servo_inverted);if(rc)return rc;}
        *c=a->saved_config;p->odom_ready=0;p->pose_valid=0;return AFR2_OK;
    case AFR2_A_LINE_KIND:if(v<0 || v>1)return AFR2_BAD;c->line_kind=v;c->line_calibrated=0;a->line_samples=0;break;
    case AFR2_A_LINE_INVERT:c->line_invert=v;c->line_calibrated=0;a->line_samples=0;break;
    case AFR2_A_LINE_CHANNEL:case AFR2_A_LINE_THRESHOLD: {
        if(!c->line_kind || !Afr2Head_State()->ir_valid)return AFR2_UNAVAILABLE;
        uint8_t bits=0;for(uint8_t i=0;i<5;i++)if(p->sensors.line_raw[i])bits|=(1u<<i);
        if(action==AFR2_A_LINE_CHANNEL){a->line_background=bits;a->line_samples=1;}
        else {if(!(a->line_samples&1u))return AFR2_UNAVAILABLE;a->line_foreground=bits;a->line_samples|=2;}
        c->line_calibrated=0;return AFR2_OK;
    }
    case AFR2_A_LINE_CONFIRM:
        /* AFR2-20261107-43: antes exigia que los 5 canales cambiaran entre fondo y linea, imposible
         * con una linea angosta bajo 1-2 sensores. Basta la muestra de fondo (blanco); si hay muestra
         * de linea, al menos un canal debe cambiar. Un canal trabado sobre blanco queda inactivo. */
        if(!c->line_kind || !(a->line_samples&1u) || ((a->line_samples&2u) && !(a->line_background^a->line_foreground)))return AFR2_UNAVAILABLE;
        c->line_invert=a->line_background;c->line_calibrated=1;break;
    case AFR2_A_MOTOR_SIGNS:c->motor_signs=v;break;case AFR2_A_PWM_LIMIT:c->pwm_limit=v;break;
    case AFR2_A_RAMP:c->ramp_step=v;break;case AFR2_A_KP:c->kp=v;break;case AFR2_A_KI:c->ki=v;break;case AFR2_A_KD:c->kd=v;break;
    case AFR2_A_MOTOR_READY:if(!v)Afr2Product_HaltMotion(p);c->motor_ready=v;break;case AFR2_A_WHEEL_MM:return AFR2_DENIED;
    case AFR2_A_RADIUS_MM:return AFR2_DENIED;
    case AFR2_A_HALL_WIRED:case AFR2_A_GEOM_READY:return AFR2_DENIED;
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
