kobachajchir/ProyectoRobotica2/(commit log)

2026-10-23 AFR2-20261023-02 Document interface board and planned single-encoder navigation
2026-10-23 AFR2-20261023-03 Document OSOYOO UART shield evidence and update project prompt
2026-10-23 AFR2-20261023-05 Save Fusion assembly plan and private origin handoff
    Document the agreed vehicle assembly workflow using the existing Fusion MCP,
    component inventory, sourced CAD and explicit editable inferences. Omit cables;
    reserve the new interface support/PCB and prepare OLED 0.96 and bare encoder refs.
    Link project entry points and record the private ProyectoRobotica2 origin and
    main branch handoff. No model implementation, CAD downloads, firmware/Web
    changes, tests, builds, validators or hardware operations.
2026-10-24 AFR2-20261024-01 Completar ensamble CAD y entregar modelo Blender ligero
    Conserva el chasis y ensambla los componentes aportados en Fusion v16, incluidas cuatro ruedas Mecanum con manos opuestas, prisioneros alineados y casquillos reductores 6 a 4 mm de referencia autorizados.
    Incluye maestros editables F3D y Blender, scripts y poses de exportacion por piezas, vistas Fusion y renders frontal/trasero. Entrega GLB de 827232 bytes con materiales PBR y compresion Draco; conserva la copia detallada y documenta inferencias y limites.
    Registra busqueda y procedencia CAD, manual de armado y estados reales en Contracts. Sin cambios en Atmega, ESP o Web; sin tests, compilaciones ni validacion mecani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
2026-10-25 Integrar firmware, Web 3D y contratos de AutoFinalRobo2
    Alinear ATmega y ESP, control directo y secuencias, pantallas OLED y su biblioteca Web, red y reinicios. Incorporar interfaz React/Vite, modelo final optimizado, simuladores y control tactil con giro local de dos dedos. Conservar contratos AFR2, procedencia, planes y evidencia de compilaciones; excluir temporales locales.
2026-10-25 Integrar modelo final del auto con PCB y soporte en Web y ESP
    Conserva los ajustes y materiales del usuario en los maestros Fusion y Blender; guarda KiCad, bibliotecas y referencias del panel OLED/encoder TH. Sustituye el modelo Web por el GLB Draco final de 871.756 bytes, conservando ruedas, escala y rig.
    Documenta importacion CAD, render y reimportacion Draco, correspondencia SHA-256 entre CAD/Web/dist/ESP y paquete de 1.505.042 bytes gzip. Estabiliza los hashes de recursos OLED frente a CRLF para permitir compilar en Windows, sin cambiar renderer ni firmware.
    npm run build:esp completado y activos promovidos localmente. Sin tests, ERC/DRC, compilacion de firmware ni flasheo. Chrome info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
2026-10-26 Integrar sensores, radar, referencias 3D y textos Web sin tildes
    Guardar todos los cambios pendientes del proyecto AutoFinalRobo2 en su Git
    global, incluidos firmware, interfaz, contratos, modelos e insumos aportados.
    - ATmega/ESP: integrar HC-SR04, control del SG90, radar autonomo e IR;
    ampliar EX01v8, comandos, capacidades y pantallas OLED vinculadas.
    - Web: separar sensores, mejorar composicion y controles del radar,
    animar el servo desde PWM aplicado y mostrar el estado de red STA/AP.
    - Modelo 3D: identificar componentes con fichas fijas y accesos a sus
    controles; alternar referencias visibles/ocultas y representar las
    cuatro ruedas mediante un unico punto FL.
    - Textos: eliminar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
2026-10-27 Integrar brazo PVC32, analisis de cargas, Web y cargador Windows
    Guardar las revisiones editables del brazo hasta v06, el montaje bajo bilateral y la contraplaca unica. Incorporar fuentes, parametros, revisiones geometricas ya documentadas y el plan de laminas tecnicas.
    Agregar el estudio analitico de masas, centros de gravedad y cargas estaticas para 200 g con el brazo extendido, su copia Fusion y las reacciones para el analisis posterior. Documentar las limitaciones del codo, los apoyos y el agarre: estos calculos no certifican capacidad fisica ni sustituyen FEA.
    Integrar los cambios pendientes de control, calibracion, simulacion del recolector y puntos cartesianos en Web; conservar la d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
2026-10-27 Documentar esfuerzos y motivos de iteracion del brazo PVC32
    Integrar en un indice navegable el presupuesto de masas, la estatica de 200 g y los nuevos capitulos sobre correcciones v01-v06, frenada de emergencia y plan de rediseño v07. Vincular cada problema con su razon mecanica, la correccion y los limites de la evidencia disponible.
    Definir el metodo para estudiar paradas finitas y las seis componentes de carga por seccion, priorizando base, hombro, primer eslabon y anclajes al acrilico. Registrar candidatos de actuadores argentinos sin presentar una seleccion ni un montaje nuevos como terminados.
    Conservar resultados, modelos Fusion y fuentes de calculo existentes. Actualizar enlaces d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
2026-10-27 Integrar monitor serie y diagnostico de fallos del Loader
    Guardar todos los cambios pendientes del repositorio: Loader 0.3.0 incorpora apertura y cierre de COM, baudios configurables, consola RX y capturas de texto, bytes y eventos. Agregar observacion incremental de arranque, detalles de errores y consulta de capturas por MCP.
    Documentar la liberacion del puerto antes de diagnostico o carga y distinguir mensajes UART de escritura/verificacion acreditadas. Actualizar manual, instrucciones, indices y estado del proyecto.
    Asignar AFR2-20261027-19 al Loader para evitar duplicar el identificador del informe de iteracion del brazo, conservado como AFR2-20261027-18.
    Publicacion de fuentes y doc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
2026-10-27 Implementar brazo v07 con GX3270BLS y refuerzos locales
    Sustituir el DS3218 del codo por una referencia parametrica GX3270BLS
    con cotas y oferta argentina trazables. Integrar cuna, horquilla y
    manguito con cuatro fijaciones M3, adaptar el acople y ampliar solapes
    a 27 mm. Agregar nervios locales sin elevar la montura del AGV.
    Conservar F3D anteriores y entregar ensamble/motor editables, parametros,
    masas, centroides, inercias y calculos de estatica/frenada bajo hipotesis.
    Documentar el limite de J1, los apoyos y la alimentacion pendientes,
    sin afirmar capacidad fisica de 200 g ni frenada de emergencia aprobada.
    Registrar AFR2-20261027-20 en Contracts y enlazar el informe integrado.
    Sin tes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
2026-10-27 Completar housing GX3270BLS y recomprobar brazo v08
    Integrar paredes ventiladas de 3 mm, reserva de cable y radios al housing
    del codo. Corregir las reservas de tapa 608, insertos, pestanas del servo,
    tornillo central, abrazadera proximal y refuerzo frente al XL4016.
    Conservar el montaje bajo, longitudes y maestros anteriores.
    Entregar F3D del ensamble, housing y motor con 163 parametros editables.
    Repetir por pedido humano 3141 configuraciones CAD sin penetraciones
    reportables, continuidad de seis ejes y doce rodamientos, apertura de
    pinza y extremos nativos. Conservar evidencia y limites del muestreo.
    Actualizar masas, CG, estatica y escenarios de frenada bajo hipotesis.
    Documentar que J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
2026-10-28 Ampliar Loader 0.7, proxy LAN y evidencia ESP USB-TTL
    Integrar flujo guiado, perfiles, historial, autoaceptacion MCP y prueba de conexion por sesion. Agregar modos ESP Web/AT por USB con reglas de memoria y paquete AT.
    Incluir proxy LAN de desarrollo Web, contratos, procedencia y diagnostico de flash ESP de 4 MiB aportado por el usuario. Sin tests, compilaciones, validadores, apertura COM ni flasheos en esta entrega.
2026-10-28 Documentar esfuerzos de J1, uniones y redisenio necesario
    Incorpora 35 secciones CAD y 7075 estados de carga, reacciones de rodamientos, tensiones nominales de eje y bastidor, contacto D y reparto de anclajes. Propone brida, eje y apoyos separados sin elevar el brazo, con estudio parcial de espacio. Conserva v08 sin editar y deja explicitamente pendientes material FDM, contactos y aprobacion fisica.
2026-10-28 Redisenar J1 con GX3270BLS, apoyos 6000 y housing bajo en PLA
    Implementar v09 editable con eje/brida metalicos, adaptador dobleD,
    cartucho desmontable y refuerzos de cuna sin elevar la montura.
    Corregir bornera, paso del horn y choque de la brida con el rack.
    Guardar maestro Fusion, componentes independientes y 177 parametros.
    Recalcular masas con PLA PrintaLot y cargas para 200 g, incluyendo
    64 sentidos combinados de seis ejes y frenadas finitas. Conservar
    3087 configuraciones CAD sin penetraciones reportables y 79651
    estados de predimensionado, con scripts y evidencia reproducible.
    Documentar AFR2-20261028-04: J1 mejorado bajo hipotesis, sin FEA
    ni ensayo fisico. FDM, estabilidad y marge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
2026-10-28 Comparar motores y masas antes de redisenar el brazo
    Evaluar las piezas actuales con 25 combinaciones de motores, CG e inercias,
    reservas de housings y cables. Ampliar las frenadas a distintas orientaciones
    de muneca y herramienta, propagando cargas a J1, uniones, tubos y pinza.
    Documentar que el cambio pesado en J5 penaliza J2, J3 y J4. La opcion
    ligera suma 16 g de motores y 80 g de reservas: no satisface el objetivo
    preliminar x2 en 50 ms, aunque pasa la comparacion nominal en 100 ms.
    Registrar recorridos, agarre, alimentacion y estabilidad aun pendientes;
    no convertir picos de catalogo en capacidad de frenado fisica aprobada.
    Conservar Fusion v09 sin modelado nuevo. Publicar fuentes, J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
2026-10-28 Integrar flasheo ESP por Mega, backups opcionales y preferencias del Loader
    Agregar servicio AVR USART0-USART1 con baud fijo y selector de transporte: D18/D19 con RESET libre o puente USB D0/D1 con RESET a GND. Guiar cableado y KEY/RST, consultar ROM y conservar la verificacion de carga y los errores originales.
    Incorporar backup opcional de flash ATmega mediante dos lecturas contrastadas, aviso de omision configurable y preferencias locales. Reemplazar Restaurar por Flashear Firmware ATmega con menu Flashear ultimo backup, hashes, control de hfuse y lectura posterior de la aplicacion.
    Actualizar integracion MCP, manual y plan A/B; registrar AFR2-20261028-02, 03 y 05. Loader 0.9.0 entregad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
2026-10-28 Comparar actuadores, reductores y masas para la frenada del brazo
    Documentar AFR2-20261028-07 con DS51150 y STS3215, recalculo de fuerzas, pares, centros de masa y uniones J1. Descartar DS51150 para frenada desde velocidades de catalogo y presupuestar reducciones multivuelta con margen nominal condicionado. Conservar Fusion v09 y dejar explicitas las incertidumbres de variante, transmision, PLA, alimentacion y estabilidad. Sin tests de software, builds ni validacion fisica; calculos mecanicos solicitados.
2026-10-28 Cuantificar par nominal, inercia y estabilidad del brazo a 30 grados por segundo
    Registrar AFR2-20261028-08 con doce presupuestos STS3250/STS3215, optimizacion de reduccion y ocho alternativas RS01 con disipacion e inercia equivalente. Mantener 200g y frenada 50ms; mostrar que pasar el par puede aumentar masa, exigencia FDM y riesgo de vuelco. Incorporar fuentes oficiales vigentes, reservas e incertidumbres sin aprobar compras ni modificar Fusion v09. Calculos mecanicos solicitados; sin tests de software, builds, FEA ni ensayos fisicos.
2026-10-29 Predimensiona brazo liviano con aluminio, reducciones y apoyo del AGV
    AFR2-20261028-09: compara masas, centros de masa, frenadas de 200 g y secciones antes de crear nuevos housings. Propone eslabones 90/75 mm, actuadores PWM y apoyos desplegables; documenta el alcance reducido y los limites de par continuo, agarre y estabilidad. Incluye sensibilidad de traccion GM25 con auto de 1.5 kg. Conserva Fusion v09. Calculos mecanicos solicitados; sin tests de software, compilaciones, FEA ni ensayos fisicos.
2026-10-29 docs(cad): reducir presupuesto de masa y alcance del brazo sobre ruedas
    Registra AFR2-20261029-01: compara estructuras compactas, actuadores nominales y resultantes dinamicas para 200 g y frenada de 50 ms. Conserva los calculos previos como antecedentes, descarta pies y voladizo, y documenta los limites de estabilidad, resistencia e inercia interna sin modificar Fusion v09 ni firmware.
2026-10-29 cad: concretar banco compacto v15 y corregir pinza
    Modela eslabones de aluminio55/50mm y montajes nativos independientes del maestro v09. Sustituye la pinza simetrica pesada por paralelogramo con pernos escalonados, retenciones DIN6799, pads centrados y tope ajustable. Dimensiona eje6 por flexion/torsion y conserva revision CAD local de cinco aperturas sin interferencias reportables.
    Incluye F3D recuperado/exportado, masas por geometria y catalogo, fuentes y ficha AFR2-20261029-02. Documenta que J2 modulo0.8 no se acepta para PLA, que modulo1.25 sigue analitico y que faltan integracion, resistencia global, estabilidad y seleccion comercial final. Sin pruebas de software, compilaciones ni en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
2026-10-30 cad: retomar V7 e integrar J2 y codo remoto v17
    Conserva la pinza V7 y la montura baja; descarta las alternativas v15/v16.
    Aplica PVC25/20, ejes70/60 y J3 remoto por correa20/50 con tensor oblongo.
    Integra STS3250 en J2, engranajes18/72Al, dos625, ejes, chavetas y fijaciones.
    Corrige carcasas/horns comerciales, holguras, apoyos y montajes STS3032 de pinza/J6.
    Documenta37muestras CAD, contactos clasificados y cargas con pieza200g:
    2352g CAD,2495g presupuesto restante y margen externo minimo1.272.
    No aprueba resistencia FDM ni frenada fisica. J1/J4/J5 quedan preparados
    como fuentes no aplicadas. Sincroniza305componentes con densidadesPLA/Al/PVC
    y masas equivalentes comerciales; suma nativa255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
2026-10-30 cad: completar montajes 3D de J1, J4 y J5 en brazo v17
    Integra los STS3250 con sus cunas, tapas, horns y fijaciones. J1 conserva la montura baja y el cartucho6000; J4 mantiene24/24 con motor tangencial; J5 incorpora avellanados y tope posterior solidario a la tapa desmontable. Retira fijaciones antiguas de J4 y comparte tornilleria repetida.
    Conserva pinza V7, PVC25/20 y J3 remoto por correa. Registra47uniones y5vinculos nativos, mantiene limites articulares y elimina el tope auxiliar de J3 que Fusion normalizaba a135..225grados. Guarda F3D editable, fuentes, journal y estado de entrega3D.
    Por pedido del usuario se difieren nuevos calculos, comprobaciones globales y aligerado. Informes ant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
2026-10-31 cad(web): integrar brazo blanco articulado de menos de 600 kB
    Exporta solo las piezas del brazo Fusion abierto y cambia las apariencias rojas a PLA blanco. Conserva392piezas originales en Blender y genera13grupos moviles con9materiales para Web, excluyendo auto, pan y referencias.
    Reduce el GLB a596484bytes con simplificacion editable y Draco. Incorpora descriptorv17 como modelo inicial del simulador, limites, postura de exportacion y seguidores para engranajes, polea y pinza. Mantiene v03 opcional y separa modelo, movimiento e interfaz.
    Guarda fuentes, Blend por LFS, activo publico y procedencia AFR2-20261031-02. GLB final reimportado y mostrado en Blender. Sin tests, compilacion, navegad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
2026-10-31 cad: medir el ahorro de PLA de las optimizaciones del brazo
    Suma los volumenes BRep de32impresos del modelo abierto y aplica densidad PrintALot1.24g/cm3:788.9g macizos. Compara con879.7g de la ultima medicion guardada y906.8g del3D terminado6041204, leido en copia temporal sin modificar el documento actual.
    Distingue ahorro neto90.8g(10.3%) frente a ultima medicion de117.9g(13.0%) frente al montaje terminado equivalente. Guarda desglose por pieza, CSV, JSON, fuentes y fichaAFR2-20261031-03. No es consumo laminado: faltan perfil, relleno y soportes. Sin nuevos esfuerzos, vuelco, tests, builds ni cambios de producto.
2026-10-31 cad(web): incorporar cubo de Fusion como modelo auxiliar del simulador
    Exporta solo el cubo50mm en coordenadas locales centradas, con apariencia original, sin brazo ni auto. Conserva fuentes y bibliotecaBlender independiente; GLB de1784bytes,12triangulos y1material.
    Agrega registro de modelos auxiliares y componente que comparte geometria/material con transformaciones por instancia. Sustituye la caja procedural de los objetos del simulador y conserva su logica de posicion, agarre, deposito, seleccion y etiquetas. No agrega el cubo al selector de brazos ni cambia el GLB del brazo.
    Documenta procedencia y estado AFR2-20261031-04. Sin tests, compilacion, navegador, calculos de carga, firmware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
2026-10-31 cad(web): reexportar brazo completo y preparar los tres modelos para carga
    Retira los filtros de visibilidad de Fusion y recupera33solidos omitidos. Repite exportacion, importacion Blender, agrupacion, materiales y compresion:425instancias originales,13grupos,9materiales y GLB780972bytes, dentro800k. Conserva la version anterior y guarda una escena Blender independiente por LFS.
    Regenera el descriptor desde la postura actual y normaliza nombres del rig. Incorpora visor y referencias para brazo y cubo junto al auto, rutas compartidas y claves de revision para evitar mallas antiguas en cache. Publica catalogo con rutas, tamanos y hashes.
    Copia los tres modelos, catalogo y Draco a dist y como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
2026-10-31 fix(web): reorganizar simuladores y alinear brazo y servo con el CAD
    Da prioridad a la escena con cielo celeste y suelo crema, controles por tarea y matematica opcional. Corrige el marco de montaje v17 considerando el centrado del GLB del auto y comparte el pivote real del SG90 entre Control y Simulacion.
    Separa la salida, horn y tornillo del SG90 de su carcasa en Blender, conserva materiales y publica el auto GLB y su fuente editable. Documenta VIS-045 y AFR2-20261031-06. Sin tests, build, validadores, navegador ni flasheo; los paquetes existentes no se promueven.
2026-10-31 fix(web): corregir conversion de ejes del pivote axial SG90
    Convierte el punto del eje desde Blender Z-up al marco glTF Y-up de CapaSuperior. Separa el marco fijo del eje y su hijo rotativo para que el angulo no reemplace la orientacion axial. Control y Simulacion comparten la correccion; carcasa fija y conjunto movil solidario.
    Documenta AFR2-20261031-07 y corrige la procedencia de coordenadas. Sin cambiar GLB, sin tests, build, validadores, navegador ni flasheo.
2026-11-01 feat(cad): preparar render frontal 4K desde la vista actual de Fusion
    Agrega una escena de estudio independiente con brazo completo, auto detallado y cubo, conservando postura y materiales. El script reproduce la camara frontal ortografica capturada, las luces de area, el fondo y la salida Cycles 4096x3072 con denoising.
    Los renders y la escena generada permanecen fuera de Git como artefactos regenerables. CAD original y firmware/Web sin modificaciones. El pedido autoriza el render y su revision visual, sin tests, builds ni controles mecanicos.
2026-11-01 feat(web): adoptar el nuevo logo oficial del robot neon
    Reemplaza el emblema compartido en navegacion, Inicio, Desarrollador y bienvenida. Genera WebP proporcionales con transparencia, favicon y touch-icon iOS; renueva los nombres de activos para evitar cache del logo anterior y ajusta su inclusion en Vite.
    Preserva el PNG original y referencias historicas; documenta VIS-046 y AFR2-20261031-09. Fuente y activos publicos actualizados, sin tests, build, validadores, navegador ni promocion al ESP.
2026-11-01 feat(web): mostrar Final Robotica 2 en la animacion de inicio
    Agrega el titulo solicitado debajo del logo y lo anima junto a el, con tipografia adaptable y espacio para Omitir. Conserva los tiempos, STOP y reduced motion. Solo fuente; sin tests, build ni validadores.
2026-11-01 fix(web): centrar el titulo de bienvenida bajo el auto del logo
    Ancla el titulo y la composicion al centro entre las ruedas, ubicado al 63.5% del PNG. Conserva ese origen durante la animacion y ajusta el ancho en pantallas bajas para mantener alineacion con la imagen visible. Solo fuente CSS; sin tests, build ni validadores.
2026-11-01 feat(web): integrar y mejorar el laboratorio del Simulador UI
    Da prioridad al simulador en Desarrollador y organiza pantalla OLED y encoder junto a una guia contextual. Agrega barra de equipo y reinicio, busqueda por nombre o codigo y seguimiento local de la opcion seleccionada. Conserva los tres controles, pulsacion larga, raster y estados ficticios.
    Incluye la base local AFR2-20261031-01 que estaba pendiente de versionar y sus integraciones/documentos, preservando el reducer. Registra VIS-047 y AFR2-20261031-12. Sin tests, builds, validadores, navegador, cambios de firmware ni promocion ESP.
2026-11-01 chore(repo): conservar referencia pendiente y cerrar cambios actuales
    Archiva sin modificaciones el adjunto de referencia Arduino UNO/ESP-01 en Contracts y excluye la carpeta temporal de adjuntos de Codex. Todos los cambios funcionales, logos y simuladores ya estan incluidos en los commits anteriores. No adopta el cableado de la imagen ni modifica firmware; sin tests, builds ni validaciones.
2026-11-02 Plan visual Web, simuladores, Infraestructura, OLED y láminas CAD
    Web (plan visual 01-11, fases 1 a 5 y revisión):
    - AFR2-20261101-07..12: tokens, íconos Lucide + propios, SegmentedControl,
    encabezados, tildes recuperadas y navegación por tareas (mobile-first).
    - AFR2-20261102-01/02: Modelos con banners de render, inspección 3D con
    «Ir a simulación», hero de Inicio, árbol de pantallas y Ayuda → OLED.
    - AFR2-20261102-03: simuladores con controles a la derecha, barra en una
    fila, zoom flotante con porcentaje, cámara inicial de los banners y
    banners re-renderizados en Blender.
    - AFR2-20261102-04/07: página Infraestructura y su reforma visual (mapa de
    flujo animado, línea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
2026-11-02 Infraestructura en claro/oscuro, LittleFS desde la placa y avances paralelos
    Esta sesión (AFR2-20261102-10):
    - Infraestructura: la simulación conjunta suma auto + brazo + cubo; la
    ocupación de LittleFS se toma de /api/health o de la respuesta de la placa a
    system.info, con «Consultar a la placa»; sin «Fuente en el proyecto» en las
    etapas; el paso de Blender explica cómo se aligera el modelo.
    - Portada con tokens --infra-hero-*: variante clara con la misma identidad y
    contraste AA; el modo oscuro queda igual.
    Incluye además el trabajo en curso de otras sesiones (AFR2-20261102-08/09 y
    11 a 20): fichas y despieces CAD, dashboard y estados OLED, lenguaje visual
    de Infraestructu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
2026-11-02 Radar de la Web rediseñado como instrumento (AFR2-20261102-21)
    - Etiquetas HTML proyectadas desde la escena: distancias por escala (cm/m),
    ángulos 0–180° y «90° · frente», nítidas y con tokens del manual.
    - Plato con brillo radial, anillos y marcas con jerarquía, sector de escaneo
    marcado y haz con caída angular y punta luminosa.
    - Ecos con halo, pulso del último eco y contorno entre ecos vecinos; tamaños
    proporcionales al alcance (25 cm a 2 m) y encuadre que prioriza el plato.
    - Chip de sector único, leyenda con muestras y visor compacto en celular.
    Verificado en navegador local con ecos de muestra temporales (retirados);
    sin robot, compilación ni build:esp.
    Co-Autho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
2026-11-03 Pantalla en vivo, Ayuda técnica y página del Loader (AFR2-20261102-22..24)
    - 22: manual revisado en todas las rutas; título de Inicio visible otra vez,
    cabeceras en la familia clara/oscura de Infraestructura. Pantalla en vivo
    con actualización Periódica / Al cambiar, lienzo que no desaparece al
    adquirir, barra superior fija, encoder al lado en PC y debajo en celular,
    leyenda corta del SW con íconos.
    - 23: Ayuda en orden ATmega, ESP, Web, OLED, con subsecciones, tablas de
    datos tomados del código y fuente de cada tema.
    - 24: tarjeta técnica por módulo en Ayuda; Explorar suma /loader con
    recorridos de carga del ATmega y del ESP, cifras y herramientas, con las
    primitivas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
2026-11-03 Loader directo, Ayuda reescrita, teclado en pantalla en vivo y banco OLED único (AFR2-20261103-25..30)
    - 25: Loader en viñetas, operaciones desplegables, banner de IA, sin carteles
    de fuente; sin borde desfasado en la barra lateral.
    - 26: Ayuda con una idea por viñeta, código en celeste y cuarto de pinout;
    enlaces de retorno de cabeceras con la forma del botón vecino.
    - 27: Pantalla en vivo captura el teclado: ← → giran y Espacio es el SW,
    todo al soltar; Escape cierra con animación.
    - 28: Estado de red «Sin datos» en todo el panel.
    - 29: banner de Inicio sin recortes en anchos chicos.
    - 30: OledWorkbench compartido por Pantalla en vivo y Ayuda → OLED;
    modal de Configur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
2026-11-03 La Web compila: tipos de ícono, QR vendido y variables sin uso (AFR2-20261103-31)
    tsc -b y vite build --mode esp sin errores. Peso medido: 17 archivos,
    4,44 MiB -> 2,36 MiB con gzip. El paquete ESP no se genera: el firmware
    admite 16 archivos y la Web tiene 17 (ver la ficha).
2026-11-05 Amplía a 24 los activos Web del ESP y a 12 KiB el manifiesto
    Centraliza el límite en Storage::kMaxAssets y alinea el empaquetador con la capacidad del firmware. El empaquetador también rechaza manifiestos mayores de 12288 bytes antes de publicarlos.
    Actualiza el contrato HTTP/LittleFS y registra alcance, paquete preparado y costo de RAM estimado en AFR2-20261104-32. Firmware sin nueva compilación ni carga; no se ejecutaron tests, builds ni validadores durante este commit.
2026-11-06 El ESP admite 24 activos Web y manifiesto de 12 KiB (AFR2-20261104-32)
    Tabla assets_ del firmware, empaquetador de la Web y PROTOCOL.md pasan de 16 a 24
    activos y de 8 a 12 KiB de manifiesto. Sin compilar ni flashear.
2026-11-07 Loader 2.0.0, lote de 15 cambios y correcciones del 06/11 (AFR2-20261106-01..36)
    - Loader 2.0.0: reintento de SYNC por el puente Mega, tarjeta lateral
    Preparación·FileSystem condicional, Compilar-Loader-2.cmd.
    - ATmega: calibración de pulsos sin aborto por detenciones de enlace, OLED
    reinicia con la orientación configurada y refresco máximo de 40 ms, sentido
    del servo con el encoder invertido.
    - Web: paneles colapsables y modelo fijo con giro animado en el control táctil,
    rumbo estimado por Hall, gracia ante pointercancel y dedo restante tras giro,
    estados de la orden de servo, estela de barrido del radar y panel de muestreo
    HC-SR04.
    - Contracts: fichas, CHANGELOG y trabajo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
2026-11-07 ESP prueba la última red Wi-Fi que funcionó antes de abrir el AP (AFR2-20261107-37)
    Si la red STA configurada no conecta en 15 s, intenta la anterior guardada
    (staPrevious, solo si alguna vez conectó); los reintentos alternan entre ambas.
    Estado staNetwork/previousAvailable en robot.wifi.status y aviso en la Web.
    ESP y Web compilados; sin flashear.
2026-11-07 Red Wi-Fi por defecto local, Hall listo para go-to y secuencias habilitadas (AFR2-20261107-38..40)
    - ESP: red STA por defecto desde wifi_defaults.local.h (ignorado por Git;
    plantilla wifi_defaults.example.h), usada sin configuración y como respaldo.
    - ATmega: concordancia PWM/Hall por rueda con fallo 4 en lazo cerrado,
    diagnóstico HP: en la pantalla Motores y velocidad mínima en el go-to.
    - ATmega: secuencias de 32 pasos habilitadas (+656 B SRAM, 77,1 %).
    - Web: texto de los códigos de fallo en la barra operativa.
    ATmega, ESP y Web compilados; sin carga al auto ni prueba física.
2026-11-07 Lateral corregido, control táctil, IR digitales, OLED y Loader portable (AFR2-20261107-41..51)
    - ATmega: signo lateral de la mezcla mecanum, IR OSOYOO digitales con IR1 a
    la izquierda, refresco liviano de la OLED con repaso a 250 ms, pantalla
    inicializada al final y clic sobre avisos de red que cierra toda la cola.
    - Web: cinemática con el mismo signo, control táctil con paneles cerrados y
    animaciones nuevas, pinout de la Ayuda y hashes del renderer actualizados.
    - Loader: distribución 2.0.0 portable, sin rutas absolutas de esta PC.
    - Contracts: informe de pinout con batería y AutoKEY/AutoRESET, compilación
    y carga del firmware y de la prueba OLED/I2C (la falla era un conector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
2026-11-07 Hall tolerante a la holgura, prueba de encoder, árbol con zoom y captura del Loader (AFR2-20261107-52)
2026-11-08 ESP: no reiniciar al servir el modelo 3D por acceso continuo a LittleFS desde el loop (AFR2-20261107-53)
2026-11-08 Librería afr2_usart y log de depuración del ATmega por USART0 (AFR2-20261108-01) - ATmega: librería lib/afr2_usart (API portable y puerto AVR USART0..3) y log de depuración por USART0 a 115200 (AFR2_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
    Sin compilar ni cargar al auto en esta entrega.
2026-11-08 Estado previo al intérprete del Loader: odometría, Wi-Fi sin red, pantalla de inicio y plan del depurador USB (AFR2-20261108-02..08)
    - Trabajo en curso de AFR2-20261108-02/03/04/06/07 (ATmega, ESP, Web, Contracts), sin compilar ni probar.
    - Plan del Loader como depurador USB: docs/PLAN_LOADER_INTERPRETE_Y_TAP.md (AFR2-20261108-08).
2026-11-09 Integrar producto 1.9.1: Wi-Fi AP, OLED, PWM y diagnosticos del Loader
2026-11-10 docs: reunir informe, planos y pinout en la revision R01
    Documenta el brazo v17 en 224 laminas A3 y seis tomos para 66 definiciones
    fabricadas/adaptadas, con cortes, interfaces, BOM y despieces. Incorpora el
    primer borrador D1 del informe, en PDF y Word, con modelos matematicos del
    brazo y la plataforma Mecanum, fuentes editables y pendientes explicitos.
    Reune la entrega en Revision/R01_20261110 junto con el pinout actualizado,
    antecedentes y la fuente F3D. Agrega indices, procedencia, observaciones e
    historial para continuar con nuevas revisiones hasta el informe final.
    Conserva los originales y los cambios concurrentes ajenos a esta entrega.
    Guarda la copia F3D mediante Git LFS y trata P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
2026-11-10 feat(web): agregar QR del repositorio en Desarrollador
    Incorpora una tarjeta con QR SVG local, URL visible y acceso directo al
    repositorio de AutoFinalRobo2. Reutiliza el generador Nayuki existente,
    con correccion MEDIUM y zona libre de cuatro modulos, sin dependencias
    nuevas ni servicios externos.
    Conserva las tarjetas, tokens y temas compartidos, adapta la disposicion
    a movil e incluye foco y nombres accesibles en los enlaces.
    Registra AFR2-20261110-08 y sincroniza la version de producto 1.16.0 en
    Contracts y Web. ATmega/ESP solo reciben la version compartida, sin
    cambios de logica. Mantiene fuera los cambios concurrentes ajenos.
    Sin tests, compilaciones, validaciones ni cargas por inst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
2026-11-10 Producto 1.23.2: F1 no enclavante, envío GOTO, control táctil y paquete ESP (AFR2-20261109-04..20261110-18)
    - ATmega: guarda de tormentas de IRQ Hall/encoder, F1 aislado corta sin enclavar
    (3 en 2 s enclavan), FAULT/LOOP/NOISE visibles en TAP, limpieza de fallo
    por CMD 0x56 y tiempos por etapa.
    - Web: envío del recorrido GOTO completo, giros de 90° en CW/CCW y en el control
    táctil, barra lateral táctil con paneles flotantes, joystick solo sobre el
    modelo, modales con blur, pill de modo con selector, Armado simplificado,
    logo de bienvenida a 768 px para el presupuesto LittleFS.
    - ESP, CAD y Contracts: cambios acumulados de las fichas AFR2-20261109-04 a
    AFR2-20261110-18; hash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
